Alksndr55/mesh-repeater-2.0/v2/design/MeshRepeater2_Shield/README_RU.md

# Mesh Repeater v2.08 — средний экран

Локальная редакция от 30.10.2026; выпуск v2.08 ещё не опубликован на GitHub.

Текущее исполнение описано в [механике](../../docs/MECHANICS_RU.md) и [инструкции сборки](../../docs/ASSEMBLY_RU.md).

Проект KiCad: `MeshRepeater2_Shield.kicad_pro`; плата:
`MeshRepeater2_Shield.kicad_pcb`. Размер 90 × 60 мм. Экран устанавливается
медью к нижней плате POWER; верхняя плата LOGIC находится компонентами вниз.
Стойки и четыре крепления M3 сохранены.

На обеих сторонах находится краткая русская памятка: состав узла,
характеристики, распиновки, варианты комплектации и предупреждение J11.
Обратная памятка ориентирована для чтения сверху после сборочного
переворота X180. Читаемый вид собранного экрана:
`../../output/current/SHIELD/SHIELD_front.svg`.

## Проход разъёма

В A3 двенадцать отдельных отверстий заменены одним физическим
фрезерованным окном **17,2 × 6,8 мм, углы R0,6**. Через него при сборке
проходит общая пластиковая планка длинного штекера J101. Окно выполнено
линиями и дугами `Edge.Cuts` в локальной механической посадке HS1
`Shield_Interconnect_Window17p2x6p8_R0p6`; HS1 не является закупаемой деталью.

Координаты окна SHIELD: X 61,90…79,10; Y 46,87…53,67 мм.
Физический центр после X180: X 70,50; Y 9,73 мм.
Положение J101/J201 и высоты стоек не меняются. Номинальные штыри L35
и розетка H8,5 дают вхождение 4,48 мм при расстоянии рабочих поверхностей
POWER–LOGIC 36,02 мм. В собранном узле верхний пластик находится на
3,48 мм выше экрана; расширенное окно требуется для надевания экрана
через этот пластик.

Универсальный штекер не имеет документированного максимального габарита
пластика и полного допуска сопряжения. Окно рассчитано с запасом относительно
имеющейся модели 15,64 × 5 мм. До изготовления проверить выбранный образец:
пластик должен проходить свободно при штатном совмещении плат.

## Медь и крепления

Изготовление одностороннее: **только F.Cu**. В файле KiCad сохранён
минимальный двухслойный контейнер; B.Cu не содержит изготавливаемой меди.
Физический стек: маска 0,010 мм, медь 0,035 мм, FR4 1,475 мм;
общая номинальная толщина 1,52 мм. STEP содержит сердцевину и фольгу
толщиной 1,51 мм; маска не представлена отдельным твёрдым телом.

Фольга GND остаётся одной связной областью. Отступ от окна не менее
0,50 мм; от наружного края и стенок крепёжных отверстий — 0,30 мм.
Четыре NPTH Ø3,20 мм имеют открытые контактные области маски Ø6 мм
для металлических шайб. Центры: (3,5;3,5), (86,5;3,5), (3,5;56,5),
(86,5;56,5) мм. Скрытый GF1 — технический якорь присвоения GND,
не электронный компонент. Межплатные контакты не касаются фольги.

## Межплатная распиновка

| Контакты J101/J201 | Назначение |
|---|---|
| 1, 3 | SYS_3V3 — Nice!Nano и периферия |
| 5, 7 | RADIO_3V3 — модем |
| 2, 4, 6 | GND |
| 8 | NC |
| 9 | BAT — линия измерения батареи |
| 10 | SDA |
| 11 | MODE |
| 12 | SCL |

Для Na-ion 1S используется J8; блок COLD — опция. Для LTO 2S используется
J12 и устанавливаются BAL1/BAL2. J8 и J12 одновременно не подключать.
**До подключения USB снять перемычку J11 на POWER; вернуть только после
отключения USB.**

## Проверки и экспорт

Свежая проверка: `../../audit/current/SHIELD/drc.json`.
Виды: `../../output/current/SHIELD/SHIELD_front.svg` и `SHIELD_back.svg`.
Экран проверяется без сопоставления с электросхемой, поскольку электронных
компонентов у него нет. Процесс выпуска описан в корневом `docs/WORKFLOW_RU.md`.
Схема и платы остаются нативными исходниками; исторические генераторы не используются.
