Alksndr55/mesh-repeater-2.0/v2/docs/MECHANICS_RU.md

# Механика v2.08

Локальная редакция от 30.10.2026.

POWER/LOGIC/SHIELD: 90×60 мм; толщина в CAD 1,52 мм. SHIELD имеет только
медь F.Cu к POWER, B.Cu пустой. Двухслойный контейнер KiCad не означает
второй изготавливаемый слой экрана.

J101 — E-SIMPO L35mm A3C6 2×6P; J201 — MTJ H8.5 2×6P, шаг 2,54 мм.
Штырь 35 мм, хвост пайки 3 мм, кончик над POWER 32 мм. Между рабочими
поверхностями номинально 36,02 мм, ввод в розетку 4,48 мм. Проверить купленную пару.

Стойки 18/15 мм с металлическими шайбами. Внутренние промежутки 18,5/16,0 мм.
Окно SHIELD под пластиковую планку 17,2×6,8 мм, радиусы 0,6 мм.
Отверстия и контактные кольца GND заданы текущим CAD.

EEEFK1E471P: номинальная высота 10,2 мм; с допуском и местом над клапаном
требуется 12,8 мм от PCB. До SHIELD предусмотрено 18,5 мм, запас 5,7 мм.
Актуальные модели компонентов доступны в KiCad. Прежние сборочные экспорты A3/A4
не являются геометрией текущего фильтра.
