Alksndr55/mesh-repeater-2.0/audit/V2_ENGINEERING_AUDIT_A3_2026_10_13/MECHANICAL_RF_REPORT_RU.md

# Независимая механическая и RF-проверка V2.0-A3

Проверено 13 октября 2026, только текущий `v2`. Это приложение к основному аудиту; ID M/R ниже предварительные и предназначены для включения в общий реестр. Исходные CAD, библиотеки, правила, BOM и производственные файлы не изменялись.

Наиболее существенный пробел — выбранная универсальная пара J101/J201 ещё не имеет подтверждённого окна сопряжения, гарантированных максимальных габаритов пластика и полного расчёта допусков. Номинальная сборка соответствует геометрии A3, но этим нельзя разрешить изготовление комплектов без проверки приобретаемой пары. Также остаются реальные глубины резьбы и габариты NiceNano/USB, RF-параметры и действие экрана на BLE. Подтверждённых ошибок зеркальности, номинальных межплатных столкновений или разрывов земли в проверенном участке не обнаружено.

## Объект и независимые проверки

Путь: `C:/Users/Alksndr/Desktop/codex/Meshcore/v2`, `main`, HEAD `d1206d1cf134ac7ee1fb50b80c9488904241908c` с локальными изменениями A3, включёнными в общий снимок `source_state_before.json`. Прочитаны `AGENTS.md`, исходное ТЗ, актуальные A3-инструкция/ограничения, mechanical/vertical selection, реальные PCB/footprints/3D, BOM. Позднее согласованное требование родительского задания: один J11 на POWER; SYS/RADIO через NT2, 2+2 питающих и 3 GND контакта; pin8 NC; все компоненты POWER на F; окно SHIELD 17,2×6,8/R0,6; J10 обслуживается после разборки. Старые IDC/12 отдельных отверстий не применялись к A3.

| Текущая PCB | SHA-256 |
|---|---|
| POWER | `be0c865aff7f217989bab9ab264dd0a0c2cda1ecd81906dd05bbb1ab731a2f44` |
| LOGIC | `ea936c8edc2d1d19b65868ca1c8f1fd98aeee777667ff6ef7b1d5d688f4b944b` |
| SHIELD | `fd02b80ebdb509977bdfcd35df0430205db56f994914720b82cdbae6d73e3bec` |

Выполнено заново, без refill/SaveBoard: `MECHANICAL_RF_native.py` и `MECHANICAL_RF_checks.py`, Python KiCad 10.0.6 `C:/Program Files/KiCad/10.0/bin/python.exe -B`, с `configure_headless()` до pcbnew; `via.GetWidth(F_Cu)` задан явно. Прочитаны сохранённые наполнения, площадки, дорожки и переходы. Получено POWER 123 footprints/1367 tracks+vias; LOGIC 56/1135; SHIELD 6/0. Исходные хеши после native чтения те же.

Независимый FreeCAD BRep `MECHANICAL_RF_brep.py` прочитал текущие сжатые STEP, вычислил преобразования POWER F вверх, LOGIC/SHIELD X180 и временно распаковал только внутри текущей папки аудита, удалив временные STEP. Объём пересечений POWER–SHIELD/SHIELD–LOGIC/POWER–LOGIC: **0/0/0 мм³**; рассмотрено 24/0/12 потенциально пересекающихся пар тел. Число тел 832/2/947. Это новая проверка сохранённой номинальной геометрии, не использование старого PASS как заключения.

## M01 — высокая; непроверенный вопрос: гарантированное сопряжение J101/J201 и допуски окна

**Где:** POWER J101 (64,15;11,00), 90°; LOGIC J201 (64,15;49,00), 90°; SHIELD окно X61,90…79,10/Y46,87…53,67. Точный выбор: E-SIMPO L35mm A3C6/2x6P, товар `1005011978353933`, SKU `12000057202232448`; MTJ/JinSheng H8.5/2X6P, товар `1005008954873458`, SKU `12000047353417475`.

**Факт:** документации изготовителя этой точной пары с допустимым сечением ответного штыря, минимальным/максимальным вводом, допусками высоты и прямолинейности нет. Сохранённый проект прямо имеет `SAMPLE_MATING_UNQUALIFIED`. Модель вилки использует условные 0,64×0,64 мм и 15,64×5,00 мм пластика, а максимальный размер верхней пластиковой планки выбранной вилки не нормирован. Карточки продавцов подтверждают идентификацию, но не квалифицируют сопряжение двух брендов.

**Расчёт номинала:** рабочий промежуток G = 18+15+1,52+3×0,50 = 36,02 мм; конец штыря L−PC = 35−3 = 32 мм; вход розетки G−Hf = 36,02−8,50 = 27,52 мм; ввод D = L−PC−G+Hf = **4,48 мм**. До верхней планки розетки 1,52 мм; от дальней поверхности SHIELD до верхней планки 3,48 мм. Номинальный проход 17,2−15,64 = 1,56 мм и 6,8−5,0 = 1,80 мм, то есть 0,78/0,90 мм с каждой стороны. Это только номинал. Даже ±0,30 мм длины корпуса розетки оставляет 0,63 мм на сторону при идеальном совмещении; этот допуск нельзя переносить на неизвестный корпус вилки.

**Границы расчёта:** для независимых допусков худшее отклонение ввода `TD = TL + TPC + T18 + T15 + Tshield + 3×Twasher + THf`. Их чисел для всего приобретённого комплекта нет. Требуемое отверстие для квадратного штыря должно учитывать его диагональ и позиционные допуски: `d_finished_min ≥ sqrt(ax_max²+ay_max²) + allowance`. Если условно a=0,64 мм, диагональ 0,905 мм против native drill 1,02 мм; 0,115 мм диаметрального запаса — не гарантированная посадка при неизвестных допусках.

**Условия/последствия:** неполный контакт при полном затягивании плат, изгиб длинных штырей, невозможность надеть экран через пластик, касание фольги, нестабильное питание. Тяжесть потенциально высокая, но наличие этих отказов в образце не установлено. Два силовых контакта не дают права считать ток автоматически разделённым пополам; каждый контакт проверяется на полный ток соответствующей ветви и на случай неравного сопротивления.

**Доказательства:** native JSON; `docs/vertical_interconnect_selection.json` (male/female/decision/limits), `docs/mechanical_selection.json` (точные SKU и sample qualification), текущие STEP `MECHANICAL_RF_brep.json`. Идентификация продавцов: [вилка](https://aliexpress.ru/item/1005011978353933.html?sku_id=12000057202232448), [розетка](https://aliexpress.ru/item/1005008954873458.html?sku_id=12000047353417475). Размеры карточки не приняты за паспорт изготовителя.

**Минимальное предложение без изменения:** до выпуска заказа проверить приобретённую пару в размерном макете/купонном окне, зафиксировать измеренные предельные размеры и окно гарантированного контакта; затем подтвердить либо скорректировать только длину/высоту, drill и окно. Если изготовитель не гарантирует совместимость, признать квалификацию относящейся к конкретной проверенной партии.

**Приёмка:** экран надевается и снимается через верхнюю планку без усилия и контакта с медью; LOGIC садится на крепёж без притягивания несовпавших контактов винтами; измеренный ввод во всех углах допусков внутри окна изготовителя либо установленного испытанием партии. До подачи питания — все 12 контактов 1:1, pin8 не соединён с GND/соседними цепями; затем испытать SYS и RADIO при полном токе каждой ветви с максимальным переходным током, измерить падение на каждой паре контактов и сопротивление GND после повторных циклов разборки. Численную норму контакта и число циклов должен дать паспорт/протокол квалификации; 3 А и ≤20 мОм из карточки розетки не являются подтверждённой нормой всей пары.

## M02 — средняя; непроверенный вопрос: реальное резьбовое зацепление

**Где:** четыре RUICHI PCHSN-18; четыре Connfly H-L1500-2100-5-03-1N1W; пять DIN433 шайб 0,5 мм на угол; верхние M3×6 и нижние DIN934 M3. Nominal stack в `docs/mechanical_selection.json:871…910`.

Номинальный ввод верхней шпильки и верхнего винта: `6−1,52−2×0,50 = 3,48 мм`; доступная нижней гайке резьба: `5−1,52−0,50 = 2,98 мм`. Принятый проектом критерий верхних соединений ≥3,0 мм имеет запас всего 0,48 мм. У верхней шпильки указан допуск 6±0,2 мм; после него остаётся **0,28 мм** на суммарное увеличение толщины PCB/двух шайб и потерю длины полных витков. Полезная глубина верхней внутренней резьбы не задана; длина нижней шпильки/глубина нижней резьбы приближённые. Полный worst-case вычислить нельзя. Номинального доказанного упора/срыва нет.

Результат возможного отклонения — недожатая плата/экран, недостаточное зацепление, потеря экранного контакта. Не доказано повреждение или невозможность сборки; это пробел допуска/входного контроля. Первичный чертёж семейства: сохранённые `docs/mechanical_sources/188548.pdf` и `110251.pdf`; зеркала [Connfly](https://www.danomsk.ru/upload/iblock/1b1/188548_e44317379783c17effab280d052a68cb.pdf), [RUICHI](https://www.danomsk.ru/upload/iblock/a02/110251_1e32ecf705accb191cd05713b8059f9d.pdf). Карточка ДАН использована только для точного артикула, не доказательства недостающей глубины.

Минимальное предложение — измерить полезные глубины до последнего полного витка, длины шпилек/винтов, фактические PCB/шайбы и зафиксировать расчёт зажима. Изменение длины крепежа требуется только если расчёт не проходит. Приёмка: ≥3,0 мм полного зацепления верхних соединений, полное зацепление нижней гайки, отсутствие упора до зажима; после заданного для выбранного крепежа момента платы и шайбы прижаты без прогиба. Значение момента пока не документировано.

## R01 — средняя; обоснованный риск: RF/BLE и экранирование не квалифицированы

**Где:** LOGIC M2 (48;18), M2.1 ANT (40;11), FL1/NT1 (40,7;4,25), J13 (34,5;4,25); M1 NiceNano и BLE keepout X12…24/Y30,5…45,5; сплошной SHIELD на 16 мм от рабочей поверхности LOGIC.

Свежий copper union показал один физически связанный GND компонент на каждой плате. На основных RF-отрезках шириной 1,3/0,8 мм расстояние до F.Cu GND в середине **0,250499 мм**, противоположная B.Cu GND есть под всеми серединами. На ANT_RF цифрового разреза противоположной земли при шаге 0,05 мм не обнаружено; у собственного SMA сигнального THT-launch есть около 1,25 мм, где осевая точка занимает сигнальную площадку/её clearance. Это не подтверждённый разрыв возврата: вокруг launch есть GND и четыре платированных SMA анкера. C24.1 в (37,6;15) находится в 2,4 мм от M2.3 (40;15), C24.2 и M2.2 связаны с общей землёй; FB1/C23/C24 обслуживают локальную RADIO ветвь.

Такая топология не доказывает ровно 50 Ом: изменяются ширина, площадки и NT1/FL1 launch, не квалифицированы диэлектрическая проницаемость, технологические допуски и RF-модель трассы. Официальная reference design Heltec и Abracon matching circuit используют 50-омные источник/нагрузку; это основание проверить согласование, но не объявить ошибкой произвольную ширину. В проекте M2 `band variant TBD`; для 868/869 МГц нужна именно HF, LF нельзя считать взаимозаменяемой. Документированы модульные R1/ANT и R2/IPEX; их фактическая комплектация входным контролем не подтверждена.

Средний экран без вертикальных стенок — открытая пластина, не закрытый кожух. Нижняя зарядная импульсная цепь имеет длинный switching путь D1/D2→L1 (13,76 мм медных сегментов net D1-K); U2→L2 короче, LX1/LX2 по 2,18 мм, включая по 1,066 мм шириной 0,20 мм. Это фактическая геометрия, не расчёт перегрева и не доказанный EMI-отказ. TI TPS63802 §12.1 p28 требует коротких широких цепей конденсаторов и размещения FB вдали от LX; местная разводка имеет соседние C12/C14 и непрерывную B.GND. Сплошная медь экрана под BLE-антенной конкретного клона может изменить согласование/диаграмму, хотя CAD-keepout LOGIC пуст. На образце ни помехи, ни чувствительность, ни нагрев не измерялись.

Источники: `MECHANICAL_RF_checks.json`, `MECHANICAL_RF_native.json` и построенные из них `MECHANICAL_RF_Logic_copper.png`, `MECHANICAL_RF_Power_copper.png`; [Heltec HT-RA62 Rev1.1 p4–9](https://resource.heltec.cn/download/HT-RA62/HT-RA62%28Rev1.1%29.pdf), [официальная reference design p1](https://resource.heltec.cn/download/HT-RA62/HT-RA62_Reference_design.pdf), [внутренняя схема модуля p1](https://resource.heltec.cn/download/HT-RA62/HT-RA62_Schematic_diagram.pdf), [TI TPS63802 RevD §12 p28](https://www.ti.com/lit/ds/symlink/tps63802.pdf). Не использованы правила другой RF-платы как обязательные требования этого модуля.

Минимальное предложение — выбрать/записать точную HF-ревизию M2 и фактический M1; получить stackup выбранного изготовителя и проверить RF-модель/купон. Корректировать RF или экран только по установленному отклонению. Приёмка на первом образце: 50-омная нагрузка на SMA, измеренная мощность и спектр на всех назначенных каналах; приёмная чувствительность при одинаковой LoRa BW/SF/PER с TPS в PFM/PWM, зарядкой off/max, экраном fitted/removed; BLE RSSI/PER на фиксированной дистанции/ориентациях. Паспорт Heltec p7 задаёт чувствительность -139/-130/-124 dBm для BW125/SF12/10/7, но условий PER там недостаточно для строгой производственной нормы — сначала определить протокол и допустимый бюджет ухудшения. Проектного численного критерия EMI/BLE/return loss нет, произвольный порог PASS не назначен.

## R02 — средняя только для устанавливаемой опции; непроверенный вопрос/подтверждённые паспортные ограничения FL1

FL1 штатно DNP и NT1 замкнут: базовая сборка не нарушает ограничения неустановленного фильтра. При fitting S869M000S003 официальный Abracon RevA printed p2 (PDF page1) ограничивает Source Power 13 dBm и рабочую температуру **−10…+65°C**, характеристику IL задаёт в 868…870 МГц. Документация проекта предупреждает о 13 dBm, но полный температурный предел опции не приведён. Хранение −40…+85°C не является рабочим диапазоном. HT-RA62 способен дать до22 dBm, поэтому мощность должна ограничиваться до fitting, а фактическая конфигурация и холодная эксплуатация этой опции должны быть отдельно утверждены.

Printed p3 (PDF page2) имеет противоречивый чертёж рекомендованных lands: у верхнего ряда указано 0,4 мм, у среднего 0,8 мм, общая высота 3,2 мм и пропорции не согласуются с верхней цифрой. Локальный footprint прямо документирует выбор 0,8 мм. Нельзя выдавать этот инженерный выбор за однозначный паспортный land pattern; нумерация 2=input,5=output,1/3/4/6=GND и корпус3×3×1,3 совпадают. Actual local STEP имеет те же внешние размеры.

Источник [Abracon S869M000S003 RevA printed p2–3](https://abracon.com/datasheets/AEL-Crystals/PN/S869M000S003.pdf), сохранённый PDF и размерная PNG; local SAW footprint descr и native FL1. Минимальное предложение — записать ограничения частоты/температуры/мощности именно опции, согласовать неоднозначный land pattern с изготовителем либо квалифицировать партию/монтаж. Приёмка: после резки NT1 сопротивление ANT_RF–ANT_SMA при снятом FL1 показывает разрыв; после монтажа VNA в50Ω измеряет IL≤2,5 dB/амплитудную неравномерность≤1 dB в868…870MHz при допустимой температуре и мощности; пайка всех шести lands осмотрена. Это не тест всей антенны или устройства на морозе.

## Что фактически прошло и что осталось ограничением

| Область | Проверено / метод | Результат | Ограничение |
|---|---|---|---|
| Размеры и этажи | Реальные PCB edges, толщины, текущие STEP BRep | Три платы 90×60 мм; native толщина 1,52 мм; POWER все F; LOGIC все F, затем X180; номинальных столкновений нет | Производственный допуск PCB, фактическая высота модулей |
| J101↔J201 | Все 12 native pads после physical Y=60−nativeY | Координаты и сети совпадают 1:1; 1/3 SYS, 5/7 RADIO, 2/4/6 GND, 8 NC, 9 BAT, 10 SDA, 11 MODE, 12 SCL | Реальное сопряжение M01 |
| Монтаж M3 | Центры PCB, окно Edge.Cuts, маска и GND | Четыре центра X3,5/86,5 и Y3,5/56,5; drill 3,2; плоскости совпадают после поворота | Резьбовая цепочка M02; реальная затяжка/момент |
| Экран | Saved copper union / native stackup / STEP | F.Cu один связный GND полигон; B.Cu пусто; STEP core 1,475 + foil 0,035; окно 17,2×6,8/R0,6 вместо 12 drill; буквы не вырезают медь | Сопротивление контакта/EMI не измерены; маска 0,01 не включена в STEP |
| Земля без проводимости стоек | F/B copper union; связь через платированные pads/vias | На каждой плате одна физическая GND группа; J101/J201 2/4/6 и потребители в ней; металлических стоек в модели связности нет | Реальное сопротивление межплатных контактов неизвестно |
| Производитель SMA | KLS exact drawing V0 2025-07-28 p1 ↔ native ↔ fresh STEP | Квадрат анкеров 5,08 мм, 4×drill 1,70, RF drill 1,30 совпадают; STEP над PCB 9,5 + хвост 3,5 = 13,0 мм; горизонтальная длина 14,46 соответствует чертежу | Представительный корпус и антенный SMA plug не доказывают фактическую посадку |
| HT-RA62 land/model | Heltec Rev1.1, visual p9 / native / STEP | Корпус 16×17 мм, сетка 2 мм; 16 площадок и назначения верны; высота модели 2,7 мм | Таблица p6 противоречиво пишет 1,27 spacing; 0,8 мм — толщина PCB, не высота собранного модуля; ревизия/частота TBD |
| Кнопки | TE mechanical selection и native; fresh STEP | Шаг контактов 4,50 мм, креплений 7,01 мм; STEP полная скоба 8,41 мм; прежняя укороченная модель 7,66 мм исправлена | Физическое нажатие и USB кабель не проверены |
| NTC | Native TH1 и fresh formed STEP | Формованная модель 12,5 мм против промежутка 18,5 мм: номинальный запас 6,0 мм | Гибка/реальный образец; местная температура POWER отличается от температуры ячейки |
| USB/кнопки/GPS/I²C/UART/SMA/J11 | Native координаты/направления и текущий STEP | J11 POWER (86;23) вправо; SW (29;58,2)/(41;58,2) на общий край; J3 X86 вправо, J5 X2,5 влево; GPS/SMA к краю | Реальный NiceNano, Type-C plug и оболочки доступа отсутствуют; снятие шунта не квалифицировано |
| J10 ISP / CR2032 | Native J10 и инструкция с разборкой; BT1 native/MPN | J10 сохранён (35,7;31,3), 0°; снятие R37 для ISP предусмотрено; BT1 Keystone 1060 SMT, шаг площадок 29,3 мм; батарею заменяют после открытия этажей | Пайка/программатор/извлечение ячейки не выполнялись |
| D3/D4 | Native POWER и боковая геометрия | Обычные 0805 на общем крае (67;2,4)/(73;2,4), цепи POWER; header дальше от края | Световая диаграмма и яркость сбоку после сборки не измерены |
| Кабельные ответные части | Текущий BOM | J3/J5 имеют Connfly SCB01x4 + 8 SC600 контактов; J11 shunt, J7/J8 XHP2, J12 KLS 4 pole + 3 contacts и крепёж перечислены | Старое замечание об отсутствии J3/J5 mates к текущей A3 неприменимо; сопряжение разных брендов не квалифицировалось |

По держателю CR2032 первичный [Keystone catalog M55 p3](https://www.keyelco.com/pdfs/M55-prod03.pdf) задаёт SMT 1060 и рекомендуемый шаг площадок 29,3 мм; native 29,30 совпадает. Быстрая смена без разборки не требуется актуальным порядком обслуживания. Геометрия контакта экрана допускает металлическую шайбу OD6; это проектный путь заземления экрана через крепёж, тогда как рабочий возврат питания существует по отдельным трём GND контактам. При испытании с электрически изолированными стойками требуется отдельно подключить экран к GND для сравнения EMI; основной возврат должен оставаться работоспособен независимо от этого.

## Приоритет и готовность данного участка

1. До заказа комплекта плат: M01 — образцы точной пары, окно и допуски сопряжения; уточнить изготовление PCB, сверловку и окно. Связность/номинальная геометрия уже проверены и не требуют повторения без изменений.
2. До сборки: M02; реальная высота M1/M2 и полные USB/SMA/cable/shunt оболочки; контакт экрана и видимость LED. Подбор другой детали без установленной причины не предлагается.
3. До оценки устойчивой работы: R01 — точный HF модем и путь ANT, RF/BLE/помехи/тепловое испытание в крайних рабочих режимах. R02 обязателен только если устанавливают FL1.

**К изготовлению:** топология и номинальная геометрия данного участка согласованы; полный производственный выпуск нельзя подтвердить из-за M01 и отсутствующего гарантированного tolerance stack. Для ограниченного опытного изготовления решение принимает владелец после квалификации пары/купонного прохода и согласования правил выбранного производства.

**К сборке:** номинальная последовательность осуществима: POWER → нижние стойки → экран через окно → верхние стойки → перевёрнутая LOGIC на J201 → винты; разборка обратная. Реальную сборку не подтверждаю до закрытия M01/M02 и проверки реального модуля с кабелями.

**К первому включению:** механика и полная GND связность не выявили самостоятельного доказанного препятствия в CAD; подтверждать безопасное первое включение всей электроники этим приложением нельзя. До подачи питания требуются прозвонка купленных разъёмов, отсутствие контакта с фольгой, правильный аккумуляторный вариант/J11 и разрешение электрических замечаний основного аудита. RF/EMI/BLE/нагрев не выдаются за выполненные измерения.

Фактические результаты находятся в flat attachments `MECHANICAL_RF_native.json`, `MECHANICAL_RF_checks.json`, `MECHANICAL_RF_brep.json`, source PDF/PNG/hash manifest. Основные исходные PCB после чтения сохранили хеши; общую проверку исходников/индекса выполняет основной аудитор.
