Alksndr55/mesh-repeater-2.0/v2/THIRD_PARTY_NOTICES.md

# Mesh Repeater 2.0 — уведомления о происхождении материалов

Обновлено 22.10.2026. Исторические описания Mesh Repeater ver 1.0 и S4.16
ниже сохранены как сведения о происхождении унаследованных материалов.

Собственные оригинальные материалы Mesh Repeater и принадлежащие автору
оригинальные дополнения распространяются под CC BY-NC-SA 4.0 в пределах
прав Alksndr55 / @Alksndritm. Область лицензии и дополнительное разрешение
на заказ изготовления плат для личных некоммерческих нужд приведены в
`LICENSE.md` и `docs/LICENSING_RU_EN.md`; полный текст CC находится в
`LICENSES/CC-BY-NC-SA-4.0.txt`. Коммерческое использование собственных
материалов требует отдельного письменного разрешения правообладателя.

Эти условия не заменяют сторонние лицензии, не ограничивают права,
предоставленные сторонними правообладателями, и не отзывают ранее выданные
разрешения. В частности, коллекция библиотек KiCad и её производные
сохраняют CC-BY-SA-4.0 с исключением KiCad. Указанные ниже условия относятся
к соответствующим сторонним материалам и их производным.

FakeTec V6
В качестве исходного примера и основы совместимости использован FakeTec V6
Rev C. Автор V6 — shimonomihs (ShimonHoranek); исходный проект FakeTec связан
с gargomoma и участниками проекта. Автор V6 прямо указывает CERN-OHL-P-2.0
для своих исходных файлов в описании issue #26:
https://github.com/gargomoma/fakeTec_pcb/issues/26
Общий проект: https://github.com/gargomoma/fakeTec_pcb

Заимствованные материалы V6 сохраняют уведомление CERN-OHL-P-2.0.
Изменено в Mesh Repeater, 11.10.2026: самостоятельная двухслойная плата
90 x 100 мм, зарядник CN3722, TPS63802, двухкаскадный LC-фильтр,
RTC/CR2032, внешний watchdog ATtiny13A, GPS-интерфейс, опциональный
балансир LTO, SMA с опциональным SAW, узел снижения тока COLD и новые
трассировка, размещение и маркировка. GPIO и интерфейс
FakeTec / ProMicro сохранены. Эта работа не является официальным релизом
FakeTec; упоминание авторов не означает их участия или одобрения.

В пакет включён полный неизменённый текст:
LICENSES/CERN-OHL-P-2.0.txt
Первичный текст лицензии, ссылка с официальной страницы OHWR:
https://gitlab.com/ohwr/project/cernohl/-/wikis/uploads/3eff4154d05e7a0459f3ddbf0674cae4/cern_ohl_p_v2.txt
Страница лицензий: https://ohwr.org/licences/
Сохранить имеющиеся авторские уведомления и описание изменений.
Отказ от гарантий и ответственность определены полным текстом лицензии.

Библиотеки KiCad
Часть локальной библиотеки Meshcore.pretty скопирована или адаптирована из
официальных библиотек KiCad. Авторы — участники проекта KiCad Libraries.
Эти библиотечные материалы распространяются под CC-BY-SA-4.0 с исключением
KiCad для электронных проектов и полученных из них файлов. Исключение не
отменяет условия при распространении библиотеки или её частей как коллекции.
Исторический список конкретных файлов и изменений относится к S4.16,
а не к текущим хешам версии 2.0. Он сохранён в теге v2.0-a3:
https://github.com/Alksndr55/mesh-repeater-2.0/blob/v2.0-a3/archive/v1_S4_16/design/Meshcore_NaIon/asset_manifest.json
Старого пути `design/Meshcore_NaIon/asset_manifest.json` в текущем срезе нет.
Текущие используемые локальные библиотеки размещены в
`design/MeshRepeater2_Power/Meshcore.pretty/` и
`design/MeshRepeater2_Logic/Meshcore.pretty/`; связанные модели — в соседних
каталогах `3dmodels/`. Связь конкретной платы с посадочным местом и моделью
определяется её сохранённым `.kicad_pcb` и `fp-lib-table`, а не старым manifest.

FB1_BLM21_0805.step — копия стандартной модели KiCad
Inductor_SMD.3dshapes/L_0805_2012Metric.step, переименованная для FB1.
Это типовой корпус 0805, а не точная заводская модель Murata BLM21PG.
TI_DCT0008A.kicad_mod создан адаптацией стандартного SOT-23-8 KiCad:
изменены медные площадки и контуры по чертежу TI DCT0008A.
CP_Elec_Panasonic_FK_D_6.3x5.8.kicad_mod — адаптация стандартного
CP_Elec_6.3x5.8 KiCad с изменёнными размерами и положением площадок.
В стандартных локальных footprints могут быть изменены ссылки на 3D-модели
и отображение полей; они не объявляются оригинальными работами Mesh Repeater.

В пакет включены:
LICENSES/CC-BY-SA-4.0.txt — полный неизменённый текст CC;
LICENSES/KiCad-Libraries-LICENSE.md — исходное уведомление KiCad вместе
с полным текстом исключения; сохранить ссылки и авторство в manifest.
Первичные источники:
https://creativecommons.org/licenses/by-sa/4.0/legalcode.txt
https://raw.githubusercontent.com/KiCad/kicad-footprints/master/LICENSE.md
https://www.kicad.org/libraries/license/
https://github.com/KiCad/kicad-footprints
https://gitlab.com/kicad/libraries/kicad-packages3D
Остальные стандартные 3D-модели, на которые ссылается проект через
KICAD10_3DMODEL_DIR, берутся из установленной библиотеки KiCad 10.

Модели, созданные для проекта — унаследованный перечень S4.16
16 из 17 используемых локальных STEP созданы для этого проекта как
упрощённая геометрия по чертежам деталей и инженерным допущениям.
Они не являются скачанными STEP производителей. Источники геометрии,
хеши и ограничения указаны отдельно для каждого файла в manifest.
Модели Nice!Nano-клона и HT-RA62 приблизительные; мелкие детали и высоты
не заменяют проверку реальных модулей. Рама и крышка экрана — проектная
геометрия, не подтверждённая модель доступного изделия поставщика.
Модель CR2032 — типовой габарит. Чертежи производителей использовались
как источники размеров; их PDF и изображения не включаются в публикацию.
Названия и марки деталей принадлежат соответствующим правообладателям.

Добавления S4.13–S4.16
SMA_KLS1_SMA002_B_Horizontal.kicad_mod и SMA_KLS1_SMA002_B_Approx.step
созданы для проекта по официальному чертежу KLS L-KLS1-SMA002-B V0,
28.07.2025. Размеры площадок и технологические допуски — решения проекта:
https://img.klsele.com/admin/product_upload/20250828165703L-KLS1-SMA002-B%26KLS1-SMA002-B-1.27.pdf
SAW_AEL_DCC6C_S869M000S003.kicad_mod и S869M000S003_Approx.step
созданы по чертежу Abracon/AEL S869M000S003, DCC6C. Разрешение неоднозначного
размера посадочного рисунка отмечено в описании footprint:
https://abracon.com/datasheets/AEL-Crystals/PN/S869M000S003.pdf
NTC_TDK_B57861S_Onboard_or_Remote_P2.54mm.kicad_mod и
TDK_B57861S_Vertical_Approx.step — проектная посадка и упрощённый габарит
TDK B57861S; шаг формованных выводов является выбором сборки:
https://www.tdk-electronics.tdk.com/inf/50/db/ntc/NTC_Mini_sensors_S861.pdf
RF_Cut_Link_0p6.kicad_mod — проектная медная перемычка, не покупной компонент.
TO-92_Inline.kicad_mod происходит из библиотеки KiCad; к нему применяются
те же условия KiCad Libraries и исключение, что к остальным её производным.
Стандартная модель TO-92 берётся из установленной коллекции KiCad 10.
Графика локального SOT-23-5 в S4.16 адаптирована для маркировки pin1;
контактные площадки и геометрия корпуса сохранены.

Эти сведения сохраняют исходные лицензии и авторство сторонних материалов.
Условия собственных оригинальных дополнений указаны в `LICENSE.md` и
`docs/LICENSING_RU_EN.md`; они не распространяют ограничение NC на материалы,
для которых действуют сторонние лицензии.
Сторонние PDF/изображения не включаются; ссылки указывают происхождение.
Исторические хеши находятся в manifest тега v2.0-a3, указанного выше;
они не выдаются за проверку текущих файлов. Для механических дополнений
версии 2.0 имеются отдельные записи `docs/mechanical_library_checks.json`
и `docs/mechanical_model_checks.json` с датами соответствующих проверок.

Эти уведомления не меняют схему, плату, прошивку или выбранные номиналы.
