Alksndr55/mesh-repeater-2.0/docs/V2_A5_RELEASE_RU.md

# Mesh Repeater 2.0 A5

22.10.2026 · Designed by @Alksndritm

Этот выпуск объединяет актуальные проекты POWER, LOGIC и SHIELD, правки
маркировки под Резонит, исправления трассировки и новую лицензию собственных
материалов. Электрическая схема, номиналы, GPIO, размещение компонентов и
механика сохранены. Обозначение FAB2 в полях исходных CAD — базовая ревизия;
состав A5 однозначно задают Git-тег и SHA256 в манифесте архива.

## Изменения трассировки

- Устранены 13 частичных перекрытий и 25 лишних земляных связей поверх заливки.
- Перенесён 21 мешавший переход GND, удалены два избыточных.
- POWER: 803→757 сегментов; LOGIC: 603→575.
- Дорожки без GND сокращены суммарно на 25,58 мм.
- Сохранены подвод питания через C33, Kelvin-подключения INA219, RF-участок
  и возвратная земля. Ширины дорожек не уменьшены.

Повторные native DRC трёх плат: 0 нарушений и 0 неразведённых цепей;
ERC POWER/LOGIC: 0; расхождения со схемой: 0. Исправления отдельно приняты
независимым проверяющим и проверены визуально по экспортам KiCad.

[Виды и сравнение](../output/V2_OVERVIEW_RU.html) ·
[протокол](../audit/routing_cleanup_2026_10_22/FINAL_AUDIT.json).

## Лицензия

Оригинальные материалы и собственные вклады автора, в пределах его прав, —
**CC BY-NC-SA 4.0**. Личный некоммерческий заказ изготовления и монтажа плат,
включая оплату услуги изготовителя, разрешён отдельным дополнительным
разрешением. Коммерческий выпуск и продажа требуют предварительного
письменного разрешения автора. Сторонние материалы сохраняют свои лицензии.

[Условия RU/EN](LICENSING_RU_EN.md) · [область лицензии](../LICENSE.md) ·
[уведомления о происхождении](../THIRD_PARTY_NOTICES.md).

## Состав архива

Только три актуальных проекта KiCad с необходимыми локальными библиотеками
и моделями, актуальные электрические схемы PDF, BOM, инструкции, проверки,
лицензии и манифест. Исторические CAD, промежуточные кандидаты, резервные
копии, RAR и прежние производственные ZIP исключены. Сборочные STEP с прежней
медью не выдаются за текущую трассировку; текущий 3D получают из проектов KiCad.

Производственный пакет A5 не переиздан. Перед заказом необходимо создать
новые Gerber/Excellon из текущих плат. Прежние локальные FAB2-пакеты относятся
к геометрии от 16.10.2026.

Релиз остаётся инженерным прототипом: стендовые EMI/RF, нагрев, устойчивость
LC, реальные межплатные разъёмы и доработка Nice!Nano требуют проверки образца.
Согласованные ограничения LTO и снятие J11 перед USB сохраняются;
см. [ограничения](V2_LIMITATIONS_RU.md).
