Alksndr55/mesh-repeater-2.0/docs/V2_A4_RELEASE_RU.md

# Mesh Repeater 2.0 — V2.0-A4

Выпуск от 14 октября 2026 года: текущий инженерный прототип в самостоятельном
репозитории `Alksndr55/mesh-repeater-2.0`, ветка `main`, тег `v2.0-a4`.
[Страница выпуска](https://github.com/Alksndr55/mesh-repeater-2.0/releases/tag/v2.0-a4)
и [архив проекта](https://github.com/Alksndr55/mesh-repeater-2.0/releases/download/v2.0-a4/Mesh-Repeater-2.0-A4-project.zip).
Предыдущие A2 и A3 сохранены как отдельные релизы.

## Изменения A4

- POWER и LOGIC приведены к общему стилю маркировки. Дубли удалены;
  подписи следуют ориентации корпусов, крупные детали подписаны под корпусами.
- Подписи разъёмов выровнены в одном стиле, распиновки сохранены.
  Надпись U2 TPS63802 на POWER размещена в одну строку.
- Двадцать конденсаторов фильтра на POWER подписаны двумя группами
  по 10×100 мкФ: C15, C34–C42 и C16, C43–C51. R56 использует обозначения
  N1R8 / L0R; исключение R56=0 Ом без COLD описано на плате и в инструкции.
- Контуры BAL1/BAL2/COLD на POWER и RF-опции на LOGIC усилены до 0,30 мм
  с обеих сторон. Положение опциональных узлов читается в масштабе 1:1.
- Обновлены изображения обеих сторон, обзор и инструкция по маркировке.

Электрическая схема, номиналы, GPIO, медь, защитная маска, посадочные места
и положения компонентов не менялись. SHIELD сохранён. Рамки опций являются
шелкографией; открытая медь и окно разрезания NT1 не изменялись.

## Состав архива

`Mesh-Repeater-2.0-A4-project.zip` содержит только текущие редактируемые проекты
POWER, LOGIC и SHIELD с локальными библиотеками и моделями, необходимые
исходники watchdog, актуальные документы, спецификации, схемы и виды плат.
Исторические исходники, прежние схемы и платы, резервные копии, старые
экспорты и временные рабочие каталоги исключены. История остаётся в Git
и отдельных релизах A2/A3.

Старые CAD исключены и из Git-среза A4: автоматические архивы GitHub
**Source code** содержат только актуальные схемы и платы. Локальные базы
сравнения сохранены; для воспроизведения исторических аудитов из нового
клона получите отдельную копию тега `v2.0-a3`.

В репозитории текущие PDF схем `MeshRepeater2_Power_A3_schematic.pdf` и
`MeshRepeater2_Logic_A3_schematic.pdf`, а также `V2_A3_COMPONENT_BOM.csv`
сохраняют свои имена: их электрическое содержание актуально для A4.
В ZIP эти же файлы представлены один раз с суффиксом A4; исходные пути
и хеши указаны в манифесте. Это переименование для архива,
электрические изменения не вносились.

Сборочные STEP и изображения сборки сохраняют геометрию A3, которая
не менялась в A4. Актуальную шелкографию A4 показывают новые SVG/PNG POWER
и LOGIC в обзоре плат.

После распаковки откройте `.kicad_pro` нужной платы. Используется KiCad 10.0.6
с обычными библиотеками KiCad; нестандартные зависимости включены.
`RELEASE_MANIFEST.json` фиксирует состав архива и SHA256 файлов,
отдельный файл `.sha256.txt` — контрольную сумму ZIP.

## Проверки текущих плат

Свежий native DRC от 14.10.2026 для POWER, LOGIC и SHIELD: 0 нарушений,
0 неразведённых цепей, 0 исключённых проверок. POWER и LOGIC также имеют
0 расхождений со схемой; для механического SHIELD эта проверка неприменима.
[Проверки выпуска A4](../audit/a4_2026_10_14/A4_RELEASE_CHECKS.json)
фиксируют сохранённые файлы и результаты повторного DRC всех трёх плат.
Сравнение с опубликованной A3 подтверждает сохранность всех структур
за пределами F.SilkS/B.SilkS. Текущие экспорты связаны с хешами плат.

Маркировка покрывает все 179 позиций: 103 индивидуальные подписи POWER,
20 конденсаторов в двух группах и 56 индивидуальных подписей LOGIC.
Дубли владельцев отсутствуют.

| Текущая плата | SHA256 |
|---|---|
| POWER | `9a93c96d54e5286c47f6bac69b689c5958cd51ad0548119f8fd24ae560e4ffc7` |
| LOGIC | `12e74df30e5508e47b3c43e9dec60c0b6ef69deecccf31e52be580582903b156` |
| SHIELD, без изменений | `fd02b80ebdb509977bdfcd35df0430205db56f994914720b82cdbae6d73e3bec` |

Доказательства: [POWER](../audit/a3_2026_10_13/marking_cleanup/POWER_marking_cleanup.json),
[LOGIC](../audit/a3_2026_10_13/marking_cleanup/LOGIC_marking_cleanup.json).
Полный [инженерный аудит A3 от 13.10.2026](https://github.com/Alksndr55/mesh-repeater-2.0/blob/v2.0-a3/docs/V2_ENGINEERING_AUDIT_A3_2026_10_13_RU.html)
и его прежние ERC, проверки схемного графа и механики относятся к своим
сохранённым снимкам. Их повторное выполнение для A4 не заявляется.

## Сборка и ограничения

Перед подключением USB снять J11 на POWER; вернуть после отключения USB.
Перемычка, две ветви SYS_3V3/RADIO_3V3, межплатная распиновка, питание
Nice!Nano-клона и его необходимая доработка сохраняются.
[Инструкция сборки](V2_ASSEMBLY_INSTRUCTIONS_RU.md) описывает маркировку N/L,
группы конденсаторов и выбор опциональных блоков.

Это инженерный прототип. Аппаратные проверки питания, LC, USB, разъёмов,
GPS и RF/EMI по прежним критериям остаются необходимыми. Сохранены принятые
ограничения LTO: резисторы балансира 2 Ом не гарантируют допустимый ток LMV431,
а при снятой батарее зарядник может вывести вход TPS63802 за рабочие 5,5 В.
[Остальные ограничения](V2_LIMITATIONS_RU.md) остаются в силе.
Производственный пакет ранее отложен владельцем; готовность к изготовлению
комплектов и эксплуатации этим выпуском не подтверждается.

Воспроизводимая упаковка: `tools/build_v2_a4_release.py --commit <SHA> --out <папка>`.
