Alksndr55/mesh-repeater-2.0/docs/cad_workflow_RU.md

# Mesh Repeater 2.0 — CAD-процесс A3

Рабочая редакция — V2.0-A3, KiCad 10.0.6. Изменения выполняют внутри самостоятельного репозитория `Meshcore/v2`. Версия 1.0 и опубликованный архив A2 сохраняют свою историю. Производственный пакет и публикация A3 в этой задаче не выполняются.

## Исходники и контракты

Редактируемые проекты находятся в `design/MeshRepeater2_Power`, `design/MeshRepeater2_Logic` и `design/MeshRepeater2_Shield`. Для каждого проекта сохраняют `.kicad_pro`, `.kicad_sch`, `.kicad_pcb`, `model.json`, локальные библиотеки и 3D-модели вместе. Точка входа — [обзор A3](../output/V2_OVERVIEW_RU.html).

Неизменная база S4.16 — `baseline/S4_16` и `audit/source_s4_16`. Её контракт: [v2_electrical_contract.json](../design/v2_electrical_contract.json), исходный опубликованный коммит `cf54f9970e716272d477afdb252b4e195d595cb6`. Добавление INA219 описано [feature_ina219_vertical.json](../design/feature_ina219_vertical.json); разрешённые изменения A3 — [feature_a3_single_face_split_power.json](../design/feature_a3_single_face_split_power.json). Эти записи дополняют базу и не заменяют её.

В A3 все 123 позиции POWER расположены на F.Cu. На LOGIC — 56 позиций; её целиком поворачивают на 180° вокруг X при сборке. J10/ISP сохраняет прежнюю посадку и доступ после разборки. J11 находится на POWER: одна съёмная перемычка, затем медная звезда NT2 и две отдельные ветви SYS_3V3/RADIO_3V3. **J11 снимают до подключения USB.**

Для R1/R40/R41/R55 выбраны 2512 Vishay WSL с площадками 1,65×3,68 мм и межцентровым расстоянием 5,71 мм по [рекомендации производителя, стр. 2](https://www.vishay.com/docs/30100/wsl.pdf). R56/R71 используют свои стандартные посадки 2512 Yageo. Package и MPN хранятся отдельными полями модели и не выводятся из имени графического варианта библиотеки.

## Изменение схем

Схемы A3 формирует `tools/cad/build_v2_a3_schematics.py`. Команды находятся в [инструкции проверок](NATIVE_BOARD_CHECK_RU.md). При работе одновременно с владельцем размещения используют `--preserve-model`: экспорт схем не должен перезаписывать координаты и углы деталей в `model.json`. После изменения состава/листов владелец модели объединяет актуальные `schematic_uuid` и `sheet_path`.

После генерации настоящий KiCad CLI обновляет синтаксис листов и библиотеки. Затем получают PDF, native XML и ERC окончательно сохранённых схем. Номера формата вручную не подменяют. Native XML/ERC A3 находятся в `audit/a3_2026_10_13/schematic/POWER` и `LOGIC`; PDF — в `output/pdf` с суффиксом `A3`.

Схемные графы сопоставляют и с текущими моделями, и с базой S4.16. Только в копии графа сравнения объединяют измерительный R71 и физическую медную звезду NT2; перенос J11 учитывают явно. В сохранённом CAD сети BAT/BAT_SYS и SYS/RADIO различаются. GPIO FakeTec, RTC/GPS/watchdog, специально неподключённые выводы и варианты монтажа проверяют отдельно.

## Изменение плат и маркировки

Перед правкой сохраняют исходный PCB и отчёт, затем назначают одного владельца каждого файла. Не запускают старые генераторы S4/A1/A2 поверх A3: они содержат прежние размеры, размещение, межплатные цепи и оформление. Одноразовые скрипты в каталоге аудита документируют выполненные шаги, а не заменяют текущую редактируемую плату.

В pcbnew предварительно вызывают `kicad_headless.configure_headless()`. Ширину via читают с явным слоем, например `PCB_VIA.GetWidth(pcbnew.F_Cu)`, чтобы избежать предупреждения wxWidgets KiCad 10. После изменения меди заново заполняют зоны и выполняют native DRC с парностью схемы.

Силовые пути и Kelvin-отводы проверяют по фактической меди. SYS и RADIO разделены трассировкой после NT2; FB1 и локальные C23/C24 остаются у модема на RADIO_LOCAL_3V3. Межплатная карта J101/J201 содержит два SYS, два RADIO, три GND, BAT/SDA/MODE/SCL и один NC. TP6/TP9/TP1 находятся в верхнем ряду с шагом 11 мм в свободных промежутках между разъёмами.

Подпись каждой детали ориентируют по её корпусу. На F.SilkS её ставят рядом, на B.SilkS — под собственным корпусом в тех же native XY, с зеркальным отображением обратной стороны. Шрифт номиналов/позиций — не менее 0,8 мм. Масштабированные группы Gxx удалены. Обводки BAL1/BAL2/COLD на POWER имеют одинаковые координаты на обеих сторонах. Разрывы линий обводок допускаются ради зазора до окна маски; это изменение шелкографии.

После оформления точный экземпляр каждой посадки сохраняют в местной библиотеке; текущий ID должен совпадать в PCB, модели и скрытом поле Footprint схемы. Нормализованная проверка сравнивает площадки, Fab, courtyard, silk и 3D-ссылки. `source_footprint_before_v2_graphic_variant` сохраняет выбранное физическое посадочное место. Расхождения не скрывают отключением правил или DRC-исключениями.

## Экран, экспорт и сборка

SHIELD имеет одну связную плоскость F.Cu, обращённую к POWER, четыре крепёжных отверстия и единое фрезерованное окно 17,2×6,8 мм, R0,6 для общей пластиковой планки J101. Двенадцати отдельных проходных отверстий для пинов нет. У окна предусмотрен отступ меди не менее 0,50 мм. Памятка на экране содержит состав, характеристики, распиновки, опции и предупреждение J11/USB.

Редактируемый KiCad-контейнер SHIELD двухслойный с пустым B.Cu; физически изготавливают только F.Cu. Подробности — в [README экрана](../design/MeshRepeater2_Shield/README_RU.md). Старый `build_v2_shield.py` относится к прежнему экрану и не воспроизводит геометрию A3.

`tools/cad/export_v2_board.py` экспортирует сохранённый PCB в native SVG, DRC и STEP; `render_native_svg_png.cjs` растеризует именно этот SVG. Пример из каталога v2:

```powershell
& 'C:/Program Files/KiCad/10.0/bin/python.exe' tools/cad/export_v2_board.py --pcb design/MeshRepeater2_Power/MeshRepeater2_Power.kicad_pcb --out output/POWER --drc --step
```

Свежий экспорт выполняют для всех изменённых плат. Манифест связывает SHA256 исходного PCB и каждого результата. Верхний вид LOGIC после сборочного поворота — `output/LOGIC/MeshRepeater2_Logic_operator_top.png`: зеркальный native B-вид с дополнительным поворотом изображения на 180°. Нумерация электрических контактов не меняется.

Сборку создают из этих STEP и текущего `docs/mechanical_selection.json` через `tools/cad/build_v2_assembly.py` под Python FreeCAD. Отчёт [assembly_geometry_report.json](mechanics/assembly_geometry_report.json) фиксирует входные хеши, номинальную геометрию и исключённые из модели условия. Модели разъёмов и крепежа не подтверждают реальные допуски, глубину контакта или резьбы; их проверяют на приобретённом образце. STEP для хранения передают с помощью `tools/prepare_v2_step_transport.py`, см. [STEP_TRANSPORT_RU.md](STEP_TRANSPORT_RU.md).

## Финальный контроль

Для сохранённой A3 получены 81/81 схемных проверок, 57/57 проверок PCB/model/XML и 110/110 независимого аудита. Native DRC трёх плат и ERC двух схем — 0. Итоговая приёмка сверила хеши отчётов, BOM, STEP/gzip, сборочной геометрии и изображений. Эти результаты не распространяются на последующие изменения файлов.

После фиксации CAD заново получают native XML/ERC, DRC, схемный граф, парность PCB/model/XML и BOM. Независимый аудит читает эти окончательные файлы и проверяет собственные хеши до/после; он не правит платы. Итоговая сводка — [A3_FINAL_CHECKS.json](../audit/a3_2026_10_13/A3_FINAL_CHECKS.json), независимый отчёт — [independent_final.json](../audit/a3_2026_10_13/independent/independent_final.json).

`tools/build_v2_a3_overview.py` обновляет обзор только после успешных проверок и совпадения хешей. После любой последующей правки CAD прежний результат недействителен до нового прогона. Старые проверки A2 и число 499/499 относятся к снимку A2.

CAD-контроль не заменяет испытания EMI, устойчивости LC, импульсной нагрузки, температурных режимов, USB клона и принятых ограничений LTO. Их перечень сохранён в [V2_LIMITATIONS_RU.md](V2_LIMITATIONS_RU.md).
