Alksndr55/mesh-repeater-2.0/docs/ELECTRICAL_PARTITION_RU.md

# Mesh Repeater 2.0: разделение электрической схемы

> Исторический материал исходного разбиения A1. Текущая A3, перенос J11 на POWER, карта SYS/RADIO и окно экрана описаны в [инструкции A3](V2_ASSEMBLY_INSTRUCTIONS_RU.md) и [проверках A3](NATIVE_BOARD_CHECK_RU.md). Старые кабельные/питающие решения ниже не являются инструкцией для новой платы.

Основа — опубликованная S4.16 изделия Mesh Repeater 1.0, коммит `cf54f9970e716272d477afdb252b4e195d595cb6`. Контрольная сумма исходной платы: `742ae27bb1d13893f6dc368e5c67f5c41b35a3e6765331fc7e9871297d23dec6`.

Это контракт для последующей разработки двух плат. Он фиксирует исходные компоненты, связи и варианты сборки. Проверка новых сохранённых плат и их электрической эквивалентности выполняется после трассировки.

## Распределение

Все 167 исходных позиций учтены однократно. Исходное распределение в `component_partition.csv` содержит 115 позиций POWER и 52 LOGIC с точными выводами, сетями и вариантами. После независимой размерной проверки единственная механическая позиция SH1 удалена явным решением C из `audit/v2_frame_mount_review.json`: в текущей POWER сохранены 114 исходных позиций, в LOGIC — 52. Исходная таблица остаётся доказательством первоначального распределения, актуальный учёт — `bom/V2_COMPONENT_BOM.csv` и `audit/v2_component_bom.json`. Новые межплатные разъёмы и крепёжные контакты добавляются отдельно; функциональные номиналы и связи не меняются.

POWER содержит CN3722 и его цепи, TPS63802 и его цепи, оба LC-каскада с банками ёмкости и резисторами демпфирования, балансиры LTO, весь опциональный узел снижения тока на холоде, разъёмы солнца и аккумулятора. D3/D4 вместе с R10/R11 остаются здесь; управляющие сети CHRG/DONE через кабель не проходят.

LOGIC содержит Nice!Nano, HT-RA62, антенный тракт, RTC и CR2032, watchdog, GPS, I²C/UART/ISP, кнопки и J11. FB1, C23 и C24 остаются рядом с модемом. C21/C22, C27 и C33 остаются у соответствующих потребителей. R21 переносится к модему на верхнюю плату; R17 остаётся у TPS63802 снизу.

Исходные H1–H4 закреплены за POWER. Верхняя плата и экран получают дополнительный согласованный комплект отверстий. Рамка SH1 и прежняя крышка в 2.0 отсутствуют. Средний непрерывный экран, GND-контакты крепления и полноценный кабельный возврат сохранены. Удаление вертикальных стенок не является доказательством прежнего уровня EMI; требуется измерение собранного образца.

## Межплатные связи

Реальные исходные связи дают ровно четыре пересекающие сети: FILTER_OUT, GND, BAT и MODE. Актуальные разъёмы — J101 на POWER, J201 на LOGIC, поляризованный кабель на 12 контактов из `design/interboard_cable.json`. Он заменяет раннее десятиконтактное предложение J14/J15:

| Контакт J101 → контакт J201 | Сеть | Назначение |
|---|---|---|
| 1 → 1, 3 → 3, 5 → 5, 7 → 7 | FILTER_OUT | 3,3 В после обоих LC-каскадов, к J11.1 |
| 2 → 2, 4 → 4, 6 → 6, 8 → 8 | GND | Основной возврат питания |
| 9 → 9 | BAT | Отдельный провод измерения батареи к R27.1 |
| 10 → 10 | GND | Земля рядом с BAT |
| 11 → 11 | MODE | Сигнал управления TPS63802 после R21 |
| 12 → 12 | GND | Земля рядом с MODE |

Номера сверяются по выбранным чертежам, ориентации половин и готовому кабелю. Механический выбор записан в `docs/mechanical_selection.json`; таблица не заменяет физическую проверку. Полные исходные точки обеих плат указаны в `design/v2_electrical_contract.json`. `interboard_nets_proposal.csv` хранит раннее предложение, которое заменено актуальным 12-контактным JSON.

Расчётная непрерывная нагрузка FILTER_OUT — 0,5 А из бюджета S4.16; это проектный предел, а не результат измерения. Каждый отдельный питающий контакт и каждый основной контакт GND выбираются на полный этот ток. Четыре параллельных питающих контакта уменьшают сопротивление соединения и дают резерв; автоматическое учетверение допустимого тока не принимается. Старт, пиковые токи и падение на готовом кабеле проверяются отдельно.

Рабочий ток и его возврат идут через кабель. Экран и металлические стойки соединяются с GND для экранирования, но не являются обязательными проводниками питания. Функции устройства должны сохраняться при отсутствии проводимости крепежа.

## J11 и USB

J11 полностью находится на верхней плате. Контакт 1 получает FILTER_OUT по кабелю. Контакт 2 создаёт локальную сеть SYS_3V3 для всех верхних потребителей. SYS_3V3 в межплатный кабель не выводится; нижняя плата не имеет её нагрузки. Такое разделение сохраняет исходную функцию единственного съёмного соединения.

При работе от аккумулятора или солнца шунт установлен. Перед USB его снимают и устанавливают обратно после отключения USB. Не допускаются медь, второй контакт разъёма или иной добавленный путь, соединяющие FILTER_OUT и SYS_3V3 в обход J11. Унаследованная проверка питания конкретного Nice!Nano-клона от USB и отключения его штатной зарядки остаётся обязательной проверкой образца.

## Измерение батареи

R27/R28 по 2,2 МОм и C25=100 нФ остаются на верхней плате возле M1.8. Сохраняются отношение 1:2 и постоянная времени 0,11 с. По кабелю передаётся BAT до делителя, а короткая высокоомная сеть BAT_ADC остаётся рядом с MCU. Это уменьшает восприимчивость высокоомного узла к наводкам по сравнению с передачей BAT_ADC между этажами.

На нижней плате отдельная измерительная дорожка BAT начинается непосредственно у J8.1 либо J12.1; она не должна использовать падение напряжения силового участка BAT. Измерительный провод не питает нагрузку верхней платы. Ток делителя при 5,5 В составляет 1,25 мкА. Общая GND по кабелю остаётся источником погрешности от падения напряжения возвратного тока, поэтому размещение точек земли и калибровка проверяются на образце.

## Управление TPS и watchdog

Реальный источник RADIO_TXEN — выводы 5 и 7 M2, соединённые в S4.16. Через существующий R21=1 кОм сигнал формирует MODE. R21 размещается у источника сверху; кабель передаёт MODE. R17=100 кОм остаётся снизу возле U2.2 и задаёт LOW при разъединённых платах. Полярность и номиналы не меняются.

Watchdog получает RADIO_TXEN через R38=1 кОм на U6.2. Эта цепь полностью остаётся на LOGIC, как и reset/ISP. Передача MODE между этажами не меняет цепь контроля модема.

## Варианты и источники номиналов

Сохранены три варианта S4.16: Na-ion с холодным режимом, Na-ion без холодного режима и LTO 2S. В контракте каждой позиции сохранена полная неизменённая строка `assembly_variants_S4_16.csv`, включая Fit и MPN для всех вариантов. Нативное DNP не является источником выбора монтажа: в S4.16 зачёркивания убраны по указанию пользователя.

В исходном `model.json` есть старые сводные поля `assembly_variants` с прежними делителями. Они не совпадают с актуальными позициями, схемой и CSV и не используются при переносе. Актуальные R3/R4: Na-ion 61,9 кОм / 100 кОм; LTO 121 кОм / 100 кОм. R15: Na-ion 40,2 кОм, LTO 130 кОм; R16 для обоих 49,9 кОм. C30: Na-ion 12 пФ, LTO 6,8 пФ. R56: Na-ion cold 1,8 Ом, Na-ion no cold и LTO — перемычка 0 Ом. Номиналы самих узлов не изменяются.

## Проверенная основа и оставшиеся проверки

Проверены совпадение 167 позиций модели, исходного XML-netlist и CSV, 86 функциональных сетей по точному составу выводов и 16 специально неподключённых выводов. Номиналы по умолчанию в нативной схеме совпадают с позициями модели и CSV. Проверена контрольная сумма принятой платы S4.16.

Окончательные ERC/DRC, соответствие схем новым платам, электрическая эквивалентность через разъёмы, корректность кабеля и механическая совместимость относятся к следующим стадиям. Старые результаты S4.16 не являются подтверждением новых плат 2.0.

Унаследованы ограничения S4.16:

- 2 Ом в балансире не гарантируют рекомендованные/предельные токи LMV431A во всех допусках.
- Независимая защита перенапряжения не установлена по согласованному решению; переходные процессы при снятии аккумулятора не гарантированы ниже 5,5 В.
- Порог EN по общему напряжению LTO не является независимой защитой каждой ячейки.
- Эффективная ёмкость каждого LC-банка ≥330 мкФ при 3,3 В, переходные процессы нагрузки и запуск требуют квалификации образца.
- Питание конкретного Nice!Nano-клона от USB с вынутым J11 и отключённой зарядкой требует проверки образца.
- Точные данные панели, аккумуляторов, часть MPN прецизионных деталей и совместимость кабеля GPS ещё требуют подтверждения.
- CAD-аудит не подтверждает фактический уровень излучаемых и проводимых помех; нужны измерения.

Проверка разбиения не разрешает эти ограничения и сохраняет их статус.
