Alksndr55/mesh-repeater-2.0/docs/INITIAL_CAD_WORKFLOW_RU.md

# Mesh Repeater 2.0: начальные модели и ориентация CAD

> Исторический материал исходного разбиения A1. Текущая A3, перенос J11 на POWER, карта SYS/RADIO и окно экрана описаны в [инструкции A3](V2_ASSEMBLY_INSTRUCTIONS_RU.md) и [проверках A3](NATIVE_BOARD_CHECK_RU.md). Старые кабельные/питающие решения ниже не являются инструкцией для новой платы.

Созданы независимые каталоги `design/MeshRepeater2_Power` и `design/MeshRepeater2_Logic`. Их `model.json` получены из замороженного `baseline/S4_16/model.json` с разбиением по электрическому контракту. После независимой размерной проверки POWER содержит 114 исходных позиций и J101; LOGIC — 52 исходные позиции, J201 и четыре новых крепёжных контакта H201–H204. Единственная удалённая исходная позиция — механическая рамка SH1. Исходные функциональные номиналы и выводы не изменены.

Это начальные модели для компоновки. Они не являются окончательной разводкой. Генераторы схем, платы, её локальная корректировка и последующие проверки работают только внутри каталога версии 2.0.

## Ориентация

В нативной плате KiCad основные компоненты ОБЕИХ рабочих плат остаются на F.Cu. Нижняя POWER устанавливается компонентами вверх. Верхняя LOGIC поворачивается целиком на 180° вокруг оси X при построении сборки; её компоненты оказываются направлены вниз к экрану. Наружные операторские подписи верхней платы располагаются на B.SilkS.

Переворачивать одновременно отдельные footprints на B.Cu и всю верхнюю плату при сборке нельзя: такой двойной переворот направит компоненты в неверную сторону. Для платы 90×60 мм поворот верхнего этажа относительно центра означает физическое соответствие `X = native X`, `Y = 60 − native Y`. Разъёмы и кнопки проверяются в собранном виде, а не только по плоскому изображению отдельных плат.

По уточнению пользователя J10 ISP сохраняет исходные координаты `(35,7; 31,3)` мм, поворот 0° и первоначальное посадочное место S4.16. Доступ к ISP предусмотрен после разборки; это выбранный порядок обслуживания.

## Межплатное соединение

Актуальная электрическая карта: `design/interboard_cable.json`. Она заменяет раннее предложение десятиконтактных J14/J15 из первой версии контракта.

J101 на POWER и J201 на LOGIC соединяются кабелем 1:1 на 12 контактов. Контакты 1/3/5/7 — FILTER_OUT; все чётные — GND; контакт 9 — BAT sense, контакт 11 — MODE. SYS_3V3 в кабеле отсутствует. Это сохраняет четыре исходные пересекающие сети; число параллельных силовых контактов меняется только по механическому выбору соединителя.

Каждый питающий контакт должен самостоятельно выдерживать полный проектный непрерывный ток 0,5 А. Четыре параллельных контакта не используются как основание автоматически увеличить паспортный допустимый ток. Ориентация ключей, маркировка первого контакта, номера обоих концов и способ обжима кабеля проверяются по выбранным реальным деталям.

## Начальные механические замены

- J7/J8 — горизонтальное двухконтактное исполнение XH; исходный порядок 1/2 сохраняется.
- J12 — отдельный четырёхконтактный корпус XH. Контакты 1 BAT, 2 LTO_MID, 3 GND сохраняются; новый контакт 4 намеренно не подключён.
- J11 — угловая гребёнка 1×2 со съёмным шунтом, исходные FILTER_OUT/SYS_3V3.
- SW1/SW2 — TE 1825027-2 с боковым нажатием и той же электрической парой нормально разомкнутого контакта.
- H1–H4 на POWER и H201–H204 на LOGIC — открытые контактные площадки GND с отверстиями M3, согласованные XY `(3,5;3,5)`, `(86,5;3,5)`, `(3,5;56,5)`, `(86,5;56,5)` мм.
- SH1 — рамка и прежняя крышка удалены явным механическим решением C из `audit/v2_frame_mount_review.json`. Оставлены непрерывный средний экран и соединённые с GND крепления. Контуры courtyard не сужаются для обхода проверок; измеренная эквивалентность EMI без боковых стенок не заявляется.

Стартовые generic footprints XH/IDC/J11 заменены локальными посадочными местами выбранных деталей; карточки ДАН, артикулы и первичные размерные источники записаны в `docs/mechanical_selection.json`. Фактическое сопряжение заказанных деталей и сборки остаётся проверкой образца. Монтажные отверстия TE имеют шаг 7,01 мм, а электрическая пара — 4,50 мм; ширина корпуса 7,11 мм не является шагом отверстий.

Ранний исходный `model.json` содержит старые сводки, поэтому текущие варианты в начальных моделях явно синхронизированы с CSV S4.16. Полные исходные строки сохранены в `assembly_variants_authoritative`, а прежняя сводка — в `assembly_variants_original_summary` только как история.

Повторный запуск `tools/seed_two_models.py` отказывается перезаписывать уже созданные `model.json`, чтобы сохранить последующие изменения компоновки и схем.
