Alksndr55/mesh-repeater-2.0/docs/V2_A3_RELEASE_RU.md

# Mesh Repeater 2.0 — V2.0-A3

Публикация 13 октября 2026 года: текущий инженерный прототип в самостоятельном
репозитории `Alksndr55/mesh-repeater-2.0`, ветка `main`, тег `v2.0-a3`.
Архив A2 и его тег сохраняются как предыдущая редакция.

## Что входит в выпуск

- Редактируемые KiCad-проекты POWER, LOGIC и SHIELD, локальные символы,
  посадочные места и 3D-модели; исходники watchdog.
- Две рабочие платы 90×60 мм и промежуточный экран того же размера.
- POWER: все компоненты на стороне F, INA219 с R71=0,1 Ом, J11 у края,
  две ветви питания SYS_3V3/RADIO_3V3 после одного съёмного шунта,
  шесть согласованных силовых резисторов в корпусах 2512.
- Вертикальные J101/J201 и окно экрана 17,2×6,8 мм, R0,6.
- PDF схем A3, BOM трёх вариантов, распиновки, инструкция, виды плат,
  сборочные модели и материалы проверок.
- [Независимый инженерный аудит](V2_ENGINEERING_AUDIT_A3_2026_10_13_RU.html)
  с расчётами, источниками и критериями испытаний.

Полный архив `Mesh-Repeater-2.0-A3-project.zip` содержит точный Git-снимок
тега, четыре восстановленных из `.step.gz` сборочных STEP и
`RELEASE_MANIFEST.json` с SHA-256 файлов. Отдельный checksum прилагается к релизу.
После распаковки откройте `.kicad_pro` нужной платы. Требуются KiCad 10
и его обычные библиотеки; нестандартные библиотеки и модели включены.

## Проверки и открытые ограничения

Свежие ERC обеих схем и DRC трёх плат на копиях, включая новые заливки,
не обнаружили нарушений. Проверены сохранение функциональных связей и GPIO,
отсутствие силового обхода снятой J11, межплатная распиновка 1:1 и связность GND
без зависимости рабочего возврата от проводимости стоек.
Номинальные попарные пересечения трёх этажей в STEP — 0 мм³.

Это результаты CAD. Реальные разъёмы, допуски сборки, питание, USB,
LC и восстановление после разряда, GPS, температура и RF/EMI требуют
испытаний. Watchdog пересобран с совпадением HEX. Сборка основного MeshCore
выполнялась, но остановилась на ограничении длинных путей Windows;
успешный MCU-бинарник этим выпуском не заявляется.

Сохранены прежние риски LTO:

- Балансиры с резисторами 2 Ом не гарантируют допустимый ток LMV431.
- При снятой батарее зарядник может вывести вход TPS63802 за рабочие 5,5 В.

Принятие этих ограничений не означает устранение рисков. Перед USB снимите
J11 на POWER; верните шунт после отключения USB. Подключение конкретного
GPS требует проверки питания контактов 6/7. SAW-опция FL1 имеет собственные
ограничения мощности и температуры; по умолчанию она не устанавливается.

Производственный пакет ранее отложен владельцем. Это выпуск для изучения
и подготовки контролируемого прототипа; готовность к изготовлению комплектов
и эксплуатации не подтверждена.

## Что изменено именно при публикации

Схемы, PCB, корпуса, номиналы, библиотеки и разводка не менялись.
Обновлены ссылки README/BOM и обозначено историческое содержание прежнего
описания изменений. Заголовки A2 внутри двух PCB и остальные замечания
аудита остаются открытыми; переименование native файлов ради выпуска не выполнялось.

Отчёт аудита фиксирует состояние до публикационного коммита: прежний HEAD
`d1206d1cf134ac7ee1fb50b80c9488904241908c` и локальную A3, описанную контрольными
суммами. Его доказательство сохранности относится к завершённому аудиту,
а не к последующим разрешённым изменениям документации и Git при публикации.
Содержательные выводы отчёта сохранены; ссылка на большой worktree diff
переведена на его точную gzip-копию. Временные CAD_CHECK и среды PlatformIO/SDK
остались локальными; небольшие логи сборки включены как доказательства.

Воспроизводимая упаковка: `tools/build_v2_a3_release.py --commit <SHA> --out <папка>`.
