Alksndr55/mesh-repeater-2.0/v2/docs/LICENSING_RU_EN.md

# Использование материалов / Use of project materials

22.10.2026 · Mesh Repeater 2.0

Copyright © 2026 Alksndritm (GitHub: [Alksndr55](https://github.com/Alksndr55)).
Designed by @Alksndritm.

## Русский

### Лицензия и её область

Собственные материалы [Mesh Repeater 2.0](https://github.com/Alksndr55/mesh-repeater-2.0)
распространяются по **Creative Commons Attribution–NonCommercial–ShareAlike
4.0 International (CC BY-NC-SA 4.0)**, в пределах принадлежащих автору прав
и если для конкретного материала прямо не указана другая лицензия.

Это относится к собственным вкладам автора в схемы и печатные платы,
документации, иллюстрациям, созданным для проекта моделям, собственному коду
и исходным материалам. Наличие файла в репозитории само по себе не означает,
что автору принадлежат все права на него. Заимствованные материалы и их
производные сохраняют условия, указанные в
[THIRD_PARTY_NOTICES.md](../THIRD_PARTY_NOTICES.md), соответствующих файлах
и [LICENSES/](../LICENSES/).

Официальный полный текст CC BY-NC-SA 4.0 хранится без изменений в
[LICENSE](../LICENSE) и [LICENSES/CC-BY-NC-SA-4.0.txt](../LICENSES/CC-BY-NC-SA-4.0.txt).
Это пояснение не заменяет и не дополняет ограничениями стандартную лицензию.

### Распространение и переработки

При распространении материалов и переработок выполняйте условия CC BY-NC-SA
4.0: указывайте **@Alksndritm / Mesh Repeater**, сохраняйте применимые
уведомления, давайте ссылку на
[проект](https://github.com/Alksndr55/mesh-repeater-2.0) и
[лицензию](https://creativecommons.org/licenses/by-nc-sa/4.0/), отмечайте
внесённые изменения. Переработки распространяйте под той же лицензией
CC BY-NC-SA 4.0 в соответствии с её условиями. Упоминание автора не означает
его одобрения переработки или участия в ней.

### Дополнительное разрешение на личный заказ плат

В дополнение к стандартной лицензии автор разрешает физическому лицу
передать необходимые производственные файлы изготовителю и заказать
изготовление и, при необходимости, монтаж плат исключительно для
собственного личного некоммерческого использования.

Изготовителю разрешено использовать наши материалы в объёме, необходимом
для выполнения такого заказа, изготовить, смонтировать и передать платы
этому заказчику и получить оплату за соответствующую услугу. Отдельное
письменное разрешение автора для такого личного заказа не требуется.

Это дополнительное разрешение не даёт изготовителю или заказчику права
выпускать платы или устройства на склад, предлагать их как самостоятельный
товар, организовывать розничную продажу или перепродажу. Оно относится только
к правам автора на собственные материалы; сторонние лицензии продолжают
действовать.

### Коммерческое использование

За исключением описанного дополнительного разрешения на личный заказ,
коммерческое использование наших материалов, в том числе коммерческий
выпуск и продажа плат, комплектов, собранных устройств и использование
материалов в коммерческих или монетизируемых проектах, допускается только
по **предварительному письменному разрешению Alksndritm**.

Для согласования обратитесь к автору через профиль
[Alksndr55](https://github.com/Alksndr55). Публичная доступность файлов,
скачивание архива или указание авторства не заменяют такого разрешения.

### Сторонние права и прежние разрешения

Материалы FakeTec V6 сохраняют CERN-OHL-P-2.0, авторство и уведомления об
изменениях. Материалы библиотек KiCad, включая их модификации, распространяемые
в составе коллекции библиотек, сохраняют CC-BY-SA-4.0 и исключение KiCad.
Исключение KiCad позволяет выбирать лицензию электронного проекта и
полученных из него файлов; оно не отменяет лицензию самой библиотеки.

Ни CC BY-NC-SA 4.0, ни дополнительное разрешение не заменяют эти сторонние
лицензии, не ограничивают отдельно предоставленные сторонними авторами права
и не заявляют права на чужие патенты, товарные знаки или независимые разработки.
Законные исключения и ограничения авторского права сохраняются. Ранее
действительно предоставленные права по иной лицензии не отзываются.

## English

### License and scope

Original materials of [Mesh Repeater 2.0](https://github.com/Alksndr55/mesh-repeater-2.0)
are licensed under **Creative Commons Attribution–NonCommercial–ShareAlike
4.0 International (CC BY-NC-SA 4.0)**, to the extent of the author's rights
and unless a particular material expressly states another license.

This covers the author's original contributions to schematics and PCB
designs, documentation, illustrations, project-created models, original
code and source materials. Inclusion in this repository does not by itself
mean that the author owns all rights in a file. Third-party materials and
their derivatives retain the terms identified in
[THIRD_PARTY_NOTICES.md](../THIRD_PARTY_NOTICES.md), the relevant files and
[LICENSES/](../LICENSES/).

The unmodified official CC BY-NC-SA 4.0 legal code is provided in
[LICENSE](../LICENSE) and [LICENSES/CC-BY-NC-SA-4.0.txt](../LICENSES/CC-BY-NC-SA-4.0.txt).
This explanation does not replace the standard license or add restrictions
to it.

### Sharing and adaptations

When sharing the materials or adaptations, follow CC BY-NC-SA 4.0: credit
**@Alksndritm / Mesh Repeater**, retain applicable notices, link to the
[project](https://github.com/Alksndr55/mesh-repeater-2.0) and
[license](https://creativecommons.org/licenses/by-nc-sa/4.0/), and indicate
your changes. Share adaptations under the same CC BY-NC-SA 4.0 license in
accordance with its terms. Attribution does not imply the author's
endorsement of or participation in an adaptation.

### Additional permission for personal PCB orders

In addition to the standard license, the author permits an individual to
provide necessary production files to a manufacturer and order PCB
fabrication and, if needed, assembly solely for that individual's own
personal, noncommercial use.

The manufacturer may use the author's materials to the extent necessary
to fulfil that order, fabricate, assemble and deliver the PCBs to that
customer, and charge for the corresponding service. No separate written
permission from the author is needed for such a personal order.

This additional permission does not authorize either the manufacturer or
the customer to manufacture PCBs or devices for stock, offer them as
standalone products, organize retail sale or resale. It covers only the
author's rights in the original materials; third-party licenses continue
to apply.

### Commercial use

Except for the additional personal-order permission above, commercial use
of the author's materials, including commercial manufacture and sale of
PCBs, kits or assembled devices and use of the materials in commercial or
monetized projects, requires **prior written permission from Alksndritm**.

Contact the author through [Alksndr55](https://github.com/Alksndr55) to agree
on permission. Public availability, downloading an archive or providing
attribution does not replace that permission.

### Third-party rights and earlier permissions

FakeTec V6 materials retain CERN-OHL-P-2.0, attribution and modification
notices. KiCad library materials, including modifications distributed as
a library collection, retain CC-BY-SA-4.0 and the KiCad exception. The
exception permits choosing a license for an electronic design and its
generated files; it does not remove the library's own license.

Neither CC BY-NC-SA 4.0 nor the additional permission replaces these
third-party licenses, restricts rights granted separately by third-party
authors, or claims rights in their patents, trademarks or independent
implementations. Statutory exceptions and limitations remain unaffected.
Rights validly granted earlier under another license are not revoked.
