Alksndr55/mesh-repeater-2.0/audit/V2_ENGINEERING_AUDIT_A3_2026_10_13/ELECTRICAL_FINDINGS_RU.md

# POWER / межплатное питание: независимый аудит A3

Проверены актуальные `design/MeshRepeater2_Power` и `design/MeshRepeater2_Logic` в рабочей v2 на HEAD d1206d1cf134ac7ee1fb50b80c9488904241908c с локальными A3. Входы — реальные `.kicad_sch`, `.kicad_pcb`, `model.json` и свежие native XML, экспортированные родительским аудитором на проверочной копии. Старые отчёты не использованы как доказательство исправности. Ничего в исходниках не менялось. Идентификаторы E01…E05 предварительные; окончательные V2-AUD назначает основной отчёт.

Полные позиции, номера строк схем, координаты и нативные сети площадок находятся в `ELECTRICAL_native_evidence.json`. В `ELECTRICAL_calculations.json` — воспроизводимые DC-расчёты. Отдельный `ELECTRICAL_LC_PASSIVE.json` содержит линейный частотный расчёт пассивного фильтра. Измерений на образце, SPICE-моделирования зарядника, TPS63802 или батареи не было.

## E01 — LMV431 нельзя считать защищённым балансиром LTO

**Критичность: критическая по возможному повреждению; статус: обоснованный риск, с подтверждённым отсутствием гарантии допустимого тока.** Унаследовано, явно оставлено пользователем 12.10.2026; это история решения, а не доказательство безопасности.

Схема `LTO_Balancer.kicad_sch`: U8 строка10043 / (96,52;96,52), U9 строка10540 / (259,08;96,52); R47 строка11041 / R51 строка10295 — **2Ω±1%**. На PCB U8 (30,5;15,6), U9 (12,8;49), R47 (18,2;15), R51 (12,8;45). R48+R49 и R52+R53: 122,49kΩ сверху; R50/R54: 100kΩ снизу. Нативные площадки: U8.3=K, U8.4=REF, U8.2/.5=LTO_MID; U9.3=K, U9.4=REF, U9.2/.5=GND. Это прямая шунтирующая схема без отдельного силового ключа или ограничителя тока.

Для выбранного **TI LMV431AIM5/NOPB**, [SNVS041G](https://www.ti.com/lit/ds/symlink/lmv431.pdf), p4 §7.1/7.3: рекомендуемый Ik≤15mA, абсолютный непрерывный Ik≤30mA; p8 §7.8 задаёт Vref=1,24V, полный температурный минимум1,215V, Iref тип0,15µA / максимум0,5µA. Формула `Vz=Vref×(1+Rt/Rb)+Iref×Rt` даёт **2,77725V типично**, а не 2,75888V при отброшенном Iref. Следовательно, значение 2,759V не является точным гарантированным порогом такого высокоомного делителя.

Иллюстративный угол с Vcell=2,75V, Vref=1,215V, Rt−0,1%, Rb+0,1%, Iref=0 (минимум не нормирован), Rs−1% даёт Vz≈2,70028V и `Ik≈(2,75−2,70028)/1,98−Idivider≈25,10mA`: рекомендованный предел превышен. При Vcell=2,85V и типичных параметрах расчёт36,36mA превышает30mA. **2,85V не объявляется допустимым режимом неизвестной LTO-ячейки**: этот пример показывает отсутствие самостоятельной токовой защиты. При дисбалансе двух ячеек верхняя ячейка может иметь больше половины общего напряжения; измерение только пакета не исключает этого.

C58/C59=47nF не признаны отдельным дефектом: визуально проверенная Figure19, p14 помещает47nF справа от типичной неустойчивой области для2/3V. График25°C с другой внешней обвязкой не квалифицирует все углы фактического узла.

**Минимальное предложение:** после выбора ячеек рассчитать безопасный балласт/ограничение Ik≤15mA на всех допустимых углах; если требуемый ток балансировки выше, добавить внешний силовой шунт либо независимую защиту отдельных ячеек. Увеличение только балласта меняет эффективность балансировки и требует нового расчёта. **Приёмка:** сначала два изолированных эмулятора ячеек; раздельные напряжения и токи R47/R51, холод/тепло и разброс деталей; Ik≤15mA, соблюдение паспортных пределов обеих ячеек и отсутствие генерации; оценить балансировку при максимальном токе зарядника. Проверку разрушительных углов выполнять ограниченным током, не настоящим аккумулятором.

## E02 — режим LTO без батареи не ограничивает вход TPS63802 до5,5V

**Критичность: критическая по возможному повреждению; статус: обоснованный риск, подтверждена несовместимость гарантированных диапазонов.** Независимая OVP отсутствует; сохранение ограничения ранее принято пользователем.

`MeshRepeater2_Power.kicad_sch`: U1 строка16811, R3 строка13233, R4 строка14692. `Converter.kicad_sch`: U2 строка21620. Нативная общая сеть **BAT_SYS** содержит U1.14, R3.1, C4.1, C12/C52.1, U2.10 и R71.1. R3_LTO=121kΩ / R4=100kΩ, оба0,1% и≤25ppm/°C. `BatteryMonitor.kicad_sch` R71 строка10681 связывает BAT_SYS с BAT через0,1Ω. Снятие J11 разрывает выход питания LOGIC, **но не отсоединяет U2.10 от зарядника**.

Официальный [CN3722 Rev1.2](https://consonance-elec.com/static/upload/file/20231218/1702867496726953.pdf), p4 электрические характеристики / p5 описание / p6 установка CV: FB2,392…2,44V, IFB≤300nA; внутренний порог OVP1,06…1,10×Vreg. Изготовитель прямо допускает достижение этого порога при отсутствии/внезапном снятии батареи. Формула `Vreg=VFB×(1+R3/R4)+IFB×R3`; сопротивление ошибается на `0,1%+25ppm×65°C=0,2625%` при−40…85°C относительно25°C. Расчёт LTO: тип5,34541V, верхний CV5,44434V; внутренний OVP тип5,77304V и верхний5,98877V. Это **расчёт диапазона, не измеренный выброс**. У TPS63802DLAR [SLVSEU9D](https://www.ti.com/lit/ds/symlink/tps63802.pdf), p5 §8.3 рекомендован VIN≤5,5V; абсолютные6V не заменяют рабочий предел.

**Балансиры учтены:** без батареи остаётся серия BAT_SYS→R71→BAT→R47→U8→MID→R51→U9→GND. Типовая сумма напряжений включения двух LMV≈5,5545V уже выше5,5V. При5,773V простая статическая оценка `I≈(5,773−5,5545)/(2+2+0,1)≈53mA` для каждого LMV превышает абсолютный предел. Она не предсказывает реальный переходный процесс или предел после отказа. Нельзя объявлять эти LMV идеальным безопасным ограничителем входа TPS.

**Минимальное предложение:** независимая отсечка/ограничитель, гарантированно удерживающая U2.10≤5,5V с допусками и выбросами, либо преобразователь с достаточным входным рабочим диапазоном; пересчитать балансир вместе с E01. **Приёмка:** эмулятор LTO-пакета, SOLAR7,5…подтверждённый холодный Voc, лёгкая/максимальная нагрузка, подключение и отключение батареи; осциллограф непосредственно U2.10–U2.8 и раздельно токи балансира. У2.10≤5,5V во всех заявленных режимах. Пока этот режим не квалифицирован, ограниченное лабораторное питание допустимо лишь с отдельным контролем BAT_SYS, а солнечное включение без LTO-батареи не подтверждено безопасным.

## E03 — паспорт ячеек и батарейные ограничения ещё не определены

**Критичность: высокая; статус: непроверенный вопрос из-за отсутствия данных.** Не утверждается, что выбранная химия сама по себе запрещена. На схеме предусмотрены Na-ion1S, Na-ion без COLD и LTO2S, но точных ячеек/пакета, защиты, разрешённых токов и температур нет.

Фактический зарядный путь: U1.13 CS_P→R56 (1,8Ω в COLD или0Ω без COLD/LTO) и его байпас Q4/Q6/Q7→R1=0,28Ω→BAT_SYS; U2 и аккумулятор черезR71 являются общей нагрузкой зарядника. Расчёт без COLD `I=0,200/0,28=714mA`, край по VCS215mV и R1−1% **775,6mA** без добавления неподтверждённого ТКС. Холодный ток тип`0,2/(1,8+0,28)=96,15mA`; верхний угол VCS/R±1% **104,4mA**. Указанные токи относятся к выходу зарядника: часть потребляет устройство, это не всегда ток в ячейку. При недостаточной инсоляции он ниже.

Na CV: тип3,91460V, верхний3,97693V по указанным выше допускам — ниже согласованного4,0V в установившемся режиме. Это не подтверждает токи, температурный режим или допустимость длительного CV конкретной Na-ячейки. EN R15/R16=40,2k/49,9k: тип OFF1,80561V; на порогах TI и допусках R0,1% расчёт OFF1,74988…1,86949V. История требования: пользователь согласовал приблизительно1,74V; диапазон **не объявляется нарушением прежнего1,8V**. LTO130k/49,9k: OFF3,4920…3,7448V для всего пакета; защиты каждой ячейки здесь нет. Полный температурный угол LTO_EN не завершён: точный MPN130k не выбран.

TEMP U1.6 связан с R9=10kΩ наGND, поэтому собственный температурный контроль зарядника отключён. В `Thermal.kicad_sch` TH1 строка10970 (PCB45;53) чувствует местную температуру платы; удалённый датчик допускается вместо него. U10 (LM393XK) имеет два согласованно соединённых открытых выхода, U11.2 является катодом LM285Z-2.5G, U11.3 анодомGND — распиновки производителей совпадают с CAD. NTCopen и NTCshort направляют схему к ограниченному току; **COLD уменьшает заряд, а не полностью отключает его**, и не задаёт верхнюю температуру ячейки. В тёплом подэкранном пространстве холодная внешняя ячейка может получать тёплый ток.

**Минимальное предложение:** выбрать точные аккумуляторы/защищённый пакет и датчик на ячейке, зафиксировать их разрешённые CV, токи, разряд и температуру; по необходимости изменить защиту/токи, отдельно согласовав изменение сохранённой схемы. **Приёмка:** эмулятор батареи, контроль каждой ячейки, токи и OFF/ON, температурные переходы настоящего датчика относительно ячейки, его обрыв/КЗ, одновременная TX/GPS-нагрузка; все критерии по выбранному паспорту. До его появления безопасное первое включение с настоящей батареей нельзя подтвердить.

## E04 — J11 электрически разделяет LC, но USB-источник клона не квалифицирован

**Критичность: высокая; статус: непроверенный вопрос / обоснованный риск.** Прямого медного обхода J11 не найдено. `Interconnect.kicad_sch` POWER J11 строка11035 (PCB86;23): FILTER_OUT→SYS_3V3; NT2 строка10129 (82,5;25,54) соединяет SYS и RADIO после шунта. J101/J201:1/3 SYS,5/7 RADIO,2/4/6 GND,8NC,9BAT,10SDA,11MODE,12SCL. SYS_3V3 отсутствует до J11 на POWER.

USB M1 (LOGIC строка17305 / PCB18;18,5) питает SYS→межплатные1/3→NT2→межплатные5/7→FB1→M2, а также INA219 U12.5, RTC, watchdog и GPS. Следовательно, источник USB на модифицированном клоне должен питать **полную нагрузку**, включая модем. Точная плата клона, LDO, проверка отключённой штатной зарядки и допустимая мощность неизвестны; надпись NiceNano_CLONE_MODIFIED не подтверждает это. Установка J11 при USB соединяет два источника и допускает обратный поток через TPS — порядок снятия шунта обязателен.

Сигналы тоже учтены: RADIO_TXEN M2.5/.7→R21=1kΩ (LOGIC строка12487)→MODE→U2.2, R17=100kΩ кGND. У TI предел MODE6V относительноGND не зависит в таблице отVIN, поэтому USB3,3V приBAT0 **не признаны доказанным превышением absolute rating**. Явной гарантии Ioff для отключённого MODE не найдено: остаточную инжекцию следует измерить. BAT→R27=2,2MΩ→BAT_ADC→M1.8 также остаётся приSYSoff; верхняя оценка ограниченного входного тока отBAT4V менее1,82µA. Это не силовой медный обход LC, но нулевое обратное питание всей системы не доказано.

**Минимальное предложение:** идентифицировать и квалифицировать реальный модифицированный клон/USB-LDO; если бюджет не проходит, отдельный рассчитанный USB-источник/разделение источников. **Приёмка:** J11open, USB приBAT/solar present/absent; VCC M1.9 и M2.3 под TX+GPS, ток USB, температура LDO; BAT_SYS/FILTER_OUT и MODE при выключенном BAT; обратный ток вUSB при батарейном питании. Приёмочные пределы по выбранному LDO/модулям, не по неизвестному аналогу NiceNano.

## E05 — переходные процессы и эффективная ёмкость фильтра не квалифицированы

**Критичность: высокая по возможному сбою основной функции; статус: обоснованный риск, не доказанная неустойчивость TPS.** `Converter.kicad_sch`: U2.6 SYS_PRE, C14 строка19830 до фильтра, R55=47mΩ→L3 строка13362→FILTER_MID→L4 строка21887→FILTER_OUT. Каждая банка десять TDK100µF; ветви R40/R41=22mΩ последовательно с банками, а не со всей нагрузкой. FB U2.4 снимается с SYS_PRE: удалённая просадка LC/разъёмов не компенсируется обратной связью.

Для [TDK C4532X5R1A107M280KC](https://product.tdk.com/en/search/capacitor/ceramic/mlcc/info?part_no=C4532X5R1A107M280KC) подтверждены100µF±20%,10V,X5R,−55…85°C; производитель помечает характеристические кривые как справочные. CAD-требование≥330µF эффективной ёмкости банка при3,3V не подтверждается одним номиналом1000µF. При Ceff330…1000µF и L2,4µH одиночная частота `1/(2π√LC)` ≈5,66…3,25kHz. Для C14 нужно≥7µF, для локальных C12+C52≥4µF по TI; C52 реально установлен, это не DNP-резерв. Резервные C53/54/55 ничего не гарантируют до подбора MPN и монтажа.

Выполнен **линейный пассивный AC-расчёт**, 18 углов L3/L4±30%, C каждого банка330/1000µF, R55=47mΩ,R40/R41=22mΩ,DCR L=10,5mΩ,2001 частота10Hz…100kHz. Идеальный источник SYS_PRE; исключены TPS-loop, контакты/возврат, ESR/ESL и профиль нагрузки. На рассмотренных углах максимальный коэффициент передачи1,392 около2,606kHz и |Zout|0,150Ω около2,897kHz. Это показывает остаточный резонанс; не является предсказанием самовозбуждения преобразователя. DC-падение только заданных R55+двухDCR при0,5A —34mV; остальные проводники добавляются отдельно.

Рейтинги не выявили очевидного недопустимого номинального тока: [Coilcraft XGL4020-471MEC](https://www.coilcraft.com/getmedia/76c9c081-4945-4c85-9129-9356e1ad6734/xgl4020.pdf) имеет DCRmax5,1mΩ и10%-Isat6,1A; [Sumida CDRH127/LD](https://products.sumida.com/products/pdf/CDRH127LD_Ver2.0_E.pdf) уL3/L4 допускает2,4µH±30%, DCRmax10,5mΩ, уL1=100µH DCRmax151mΩ/Isat2,1A. При зарядном максимуме775,6mA, VIN24V, Vout≈4V, L1−20%,f240kHz грубая buck-оценка пульсаций174mApp даёт peak≈0,863A, ниже указанного Isat. Неизвестные Voc панели/выбросы и нагрев ограничивают итог: Q1 AOS AO3401A имеет |VDS|30V/|VGS|12V, CN вход≤28V, C8=35V; условие Voc≤24V вCAD не заменяет паспорт панели. X5R-банки нельзя эксплуатировать выше85°C температуры детали.

**Минимальное предложение:** подтвердить Ceff и реальный бюджет источника/модема; при провале подобрать ёмкости/демпфирование либо сократить импеданс, с повторной проверкой. **Приёмка:** BAT min/max каждого варианта, SOLAR off/on, MODE PFM/PWM, TX+GPS и ступени0…0,5A; одновременные осциллограммы SYS_PRE, FILTER_OUT, M1.9, M2.3 относительно местногоGND; запуск, снятие нагрузки, восстановление разряда; Ceff банка≥330µF при3,3V с требуемыми температурой/старением; Cin≥4µF,Cout≥7µF. Напряжения потребителей остаются в рекомендованных диапазонах, отсутствует устойчивое колебание/reset, температуры деталей в их пределах.

**Дополнение E05: восстановление после разряда и R71.** Нативный XML и площадки повторно проверены: R15.1 видит **BAT до R71**, а U2.10 получает **BAT_SYS после R71**. Поэтому шунт не создаёт прямой положительной обратной связи через EN. Его падение снижает VIN и увеличивает ток батареи; ESR ячейки/проводов до BAT непосредственно влияет на EN. Сам по себе R71 не доказывает циклический запуск.

В TI SLVSEU9D p6 §8.5 нет отдельной строки гарантированного EN-hysteresis: есть rising1,07/1,10/1,13V и falling0,97/1,00/1,03V. Номинальная разница0,10V даёт на BAT180,56mV дляNa и360,52mV дляLTO. Консервативная арифметика независимых границ `(1,07−1,03)×(1+Rt/Rb)` даёт72,16mV/144,00mV приR±0,1%; это производный диапазон, с одинаковой утечкой EN в обеих точках, без температурного рассогласования. Он не является отдельной строкой измеренного/нормированного TI-гистерезиса. При изменении входного тока EN добавляется `ΔI_EN×Rt` (до8mVNa/26mVLTO для изменения0,2µA).

При SYS-нагрузке0,5A выходная мощность1,65W. **Допущение**, не измеренный КПД:η=0,90. Простая оценка приBAT1,8V: `I≈1,65/(0,90×1,8)=1,0185A`, падениеR71≈102mV. Самосогласованный расчёт `I×(VBAT−I×0,1)=1,65/η` даёт1,0838A иVIN1,6916V; это относится к уже запущенному устройству с достаточно низким фактическим OFF, а не к обещанию запуска от1,8V. ПоTI p5 VIN должен быть **выше1,8V доPG**; p6 внутренние UVLO falling1,20…1,29V действуют после запуска приVOUT≥1,8V. Следовательно, штатное установившееся падениеR71 в этой оценке не достигает внутреннегоUVLO, но уменьшает пусковой запас.

Обоснованный сценарий повторного запуска: открытое напряжение Na-ячейки2,0V выше типовогоON1,9862V, её **условный** ESR0,2Ω, R71=0,1Ω, нагрузка1,65W/η. Из `I×[2,0−I×(0,2+0,1)]=1,8333W` получаетсяI1,0973A; BAT1,7805V ниже типовогоOFF1,8056V, VIN1,6708V. После выключения ток исчезает иBAT возвращается вышеON. Эти входы образуют возможный цикл EN; ESR0,2Ω не выдан за измерение или паспорт неизвестной ячейки. Для LTO приON≈3,9657V инулевомESR расчёт0,4678A/46,8mV падения шунта оставляет значительно больший запас; влияние разбаланса и холодногоESR остаётся отдельным условием.

Две банки суммарно≥660µF при3,3V требуют минимум `Q=CV=2,178mC`, `E=CV²/2=3,594mJ`, плюс локальные ёмкости. Например, попытка зарядить только эти банки за2ms приBAT≈1,986V/η0,9 требует около **1,01A дополнительного среднего** входного тока. Это условная энергетическая оценка, не фактический inrush: TI soft-start и LC могут удлинить заряд, а224µs изTI получены при другомVIN/нагрузке и не перенесены на эту схему. Колебательный запуск требует подтверждения настоящим профилем нагрузки и сопротивлением батареи.

Дополнить минимальное предложение E05: задать максимальный ESR ячейки/проводов и пусковой ток; если восстановление не проходит, уменьшить сопротивление входа/изменить шунт с новой калибровкой INA либо увеличить запас стартового порога/гистерезиса или вводить нагрузку позже. **Дополнительная приёмка:** эмулятор батареи с паспортным максимальнымESR, заряженными и разряженнымиLC-банками, J11 установлен; медленный подъём послеOFF, горячее подключение иTX/GPS-нагрузка. Одновременно измерять BAT наR15.1, BAT_SYS наU2.10, EN_UV наU2.1 иSYS_PRE. При квалифицированном напряжении восстановления устройство однократно запускается, VIN>1,8V доPG, затем удерживает напряжения модулей и не повторяет циклыEN/UVLO/reset; после выхода изразряда восстанавливается безUSB или ручной перестановкиJ11. До определения допустимогоESR и реального профиля это риск, а не подтверждённый hiccup. Полные входы/результаты: `ELECTRICAL_RECOVERY.json`.

## Проверенное без отдельного замечания

INA219AIDR соответствует SOIC-8 распиновке:1/2 адресGND(0x40),3SDA,4SCL,5SYS,6GND,7IN−(BAT),8IN+(BAT_SYS); R72/R73=10Ω иC64=100nF дифференциально. Заряд положительный, разряд отрицательный; токи балансира проходят **мимо** R71. [TI INA219 SBOS448G](https://www.ti.com/lit/ds/symlink/ina219.pdf), p3/5/17–18 подтверждает распиновку, диапазоны и необходимость калибровки после старта. R71 [RL2512FK-070R1L](https://www.yageogroup.com/component-documentation/download/specsheet/RL2512FK-070R1L) —0,1Ω±1%,1W,±600ppm/°C: при1,25A125mV/156mW; при4A1,6W уже выше1W. Без собственной температурной калибровки вклад шунта в ошибку до~4,9% приΔT65°C, без ошибки INA/пайки. Поэтому2% точности нельзя предполагать; требования точности вТЗ нет.

BAT_ADC R27/R28 по2,2MΩ, C25=100nF: Rth=1,1MΩ,τ110ms, установление1%≈507ms,0,1%≈760ms. Статическая ошибка от утечки `ΔVADC=Ileak×1,1MΩ`, на пересчитанномBAT вдвое больше. C25 помогает выборке ADC, но не устраняет DC-утечку. Конкретный клон/ADC/калибровка не проверены; это включить в программно-аппаратную квалификацию, не объявлять доказанным отказом ADC.

Только CR2032 сохраняетRTC; при отсутствии USB и основного источника SYS не питается от неё. Главный ток питания иGND проходят электрические межплатные контакты, стойки не обязательны для замыкания цепи.

## Статус готовности в пределах этого участка

Внутренняя нативная связность и критические распиновки подтверждены; явного медного обходаJ11 нет. Электрически пригодность **к изготовлению опытных плат** не равна готовности изделия: необходимо закрыть выбранные ячейки/панель и ограниченияE01/E02, либо явно ограничить лабораторную программу. Сборку с реальными батареями и неизвестным модифицированным клоном безE03/E04 нельзя подтвердить безопасной. Для первого включения пригоден поэтапный стенд с ограниченным источником/эмулятором батареи и предварительным контролем полярности; безусловная готовность к первому включению от LTO/солнца не подтверждена.

Источник истории принятого ограничения: `audit/fixes_2026_10_12/user_decision.json`. Сам факт ограничения заново проверен по нынешним CAD и первичным данным выше.
