Alksndr55/mesh-repeater-2.0/audit/a3_2026_10_13/independent/INDEPENDENT_PLAN_RU.md

# Независимая проверка A3

Проверка проводится после сообщения ALL_CAD_FROZEN. Черновые отчёты авторов разводки не являются основанием для PASS.

- Нативные POWER / LOGIC / SHIELD, схемы, модели и проектные правила фиксируются SHA-256 до и после проверки.
- Свежие KiCad DRC со всеми предупреждениями, исключениями, refill и schematic parity; без сохранения платы. Свежие ERC и XML netlist обеих схем.
- Сопоставление групп соединённых выводов XML с фактическими net codes площадок. Отдельно проверяются J11, NT2, ветви SYS/RADIO, два контакта каждой линии питания, три GND, NC8 и питание только модема за FB1.
- Исходный электрический контракт S4.16 и разрешённая вставка INA219 сохраняют GPIO Nice!Nano, ISP J10, номиналы и варианты сборки; шесть силовых резисторов действительно имеют площадки 2512.
- Все компоненты POWER находятся на F.Cu, LED расположены между краем и J101, TP1 / TP6 / TP9 находятся в одном ряду у края. Длины их медных подключений измеряются по реальной трассе.
- Фактическая маркировка рядом со своим компонентом / точно в центре его корпуса на обратной стороне; ось текста совпадает с осью корпуса, отсутствуют Gxx x1.5. Геометрия рамок опций одинакова на F/B.
- Окно экрана проверяется непосредственно по Edge.Cuts футпринта, отверстия для 12 отдельных штырей отсутствуют; реальные центры и пластмассовый габарит разъёма проходят через окно. Единственная область фольги не разрывается.
- Размеры экрана, материал, предупреждение J11/USB и распиновки читаются непосредственно из нативной шелкографии; документированная высота стоек не меняется.

Вывод касается согласованных изменений A3 и нативной конструкции. Проверка номинального габарита пластика не подменяет примерку конкретных разъёмов; измерение EMI/просадки питания и принятые ограничения LTO остаются отдельными условиями проекта.
