Alksndr55/mesh-repeater-2.0/output/V2_OVERVIEW_RU.html

# Mesh Repeater 2.0 A5 · исправление трассировки

22 октября 2026 · основные проекты POWER и LOGIC · платы 90×60 мм

Исправления внесены в исходные файлы KiCad. Убраны перекрывающиеся сегменты и лишние земляные связи поверх заливки; мешавшие трассам переходы GND перенесены или удалены. Маршруты выпрямлены. Схема, номиналы, положения компонентов, GPIO, межплатные соединения и ISP J10 сохранены.

Повторные native DRC после перезаливки: 0 нарушений, 0 неразведённых цепей, 0 расхождений со схемой. ERC обеих схем: 0 нарушений. Независимая геометрическая проверка не нашла дублирующихся и частично перекрывающихся сегментов. Земля каждой платы остаётся единой связной сетью через оба слоя; ширины дорожек не уменьшены.

Производственные архивы A4-FAB2 от 16.10.2026 относятся к прежней разводке. После этих изменений их нужно пересоздать перед новым заказом. Они сохранены как предыдущий снимок. Перед USB по-прежнему необходимо снять J11 на POWER.

## Измеренное сравнение

Плата | Параметр | До | После
POWER | Сегменты дорожек | 803 | 757
POWER | Длина дорожек без GND, мм | 1487.52 | 1464.28
POWER | Длина явных дорожек GND, мм | 209.95 | 144.36
POWER | Все переходные отверстия | 508 | 506
POWER | Перекрывающиеся пары сегментов | 9 | 0
POWER | Повороты 90° без GND (узлы с двумя сегментами) | 15 | 11
LOGIC | Сегменты дорожек | 603 | 575
LOGIC | Длина дорожек без GND, мм | 1804.19 | 1801.86
LOGIC | Длина явных дорожек GND, мм | 43.91 | 30.36
LOGIC | Все переходные отверстия | 520 | 520
LOGIC | Перекрывающиеся пары сегментов | 4 | 0
LOGIC | Повороты 90° без GND (узлы с двумя сегментами) | 21 | 19

Длина без GND приведена отдельно: удаление дорожек поверх земляной заливки не выдается за сокращение сигнальных маршрутов. Повороты подсчитаны в узлах с двумя сегментами одной цепи и слоя; площадки и ответвления не входят в этот счёт.

## Дорожки до и после

Переключатели показывают экспорт KiCad из копий с отключённой заливкой, чтобы были видны сами дорожки и переходы. Эти иллюстрации не предназначены для изготовления. По ссылке под каждым видом доступна фактическая медь с заливкой.

POWER — лицевая сторона

ДоПослеПосле

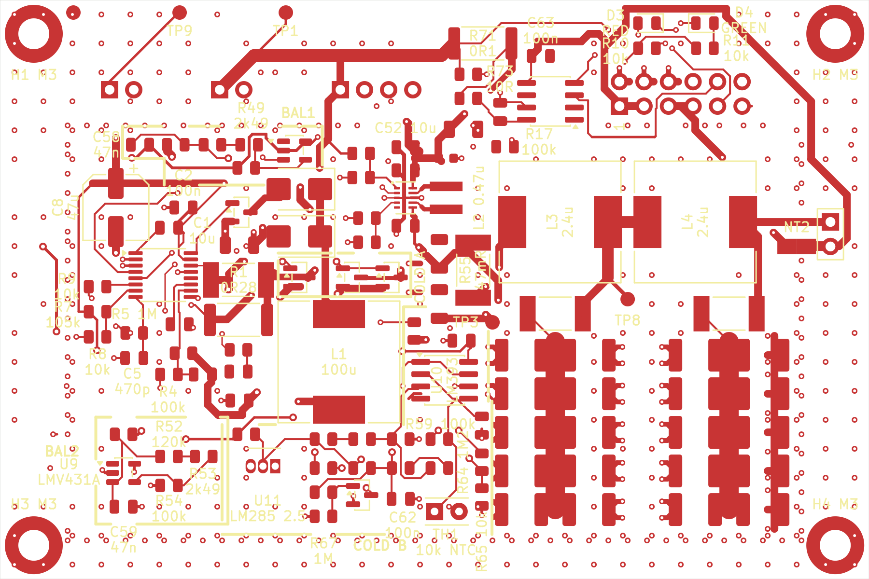
[picture p7: audit/routing_cleanup_2026_10_22/views/after/POWER/POWER_routes_front.png]
POWER: дорожки лицевая сторона


Фактическая медь с заливкой

POWER — обратная сторона

ДоПослеПосле

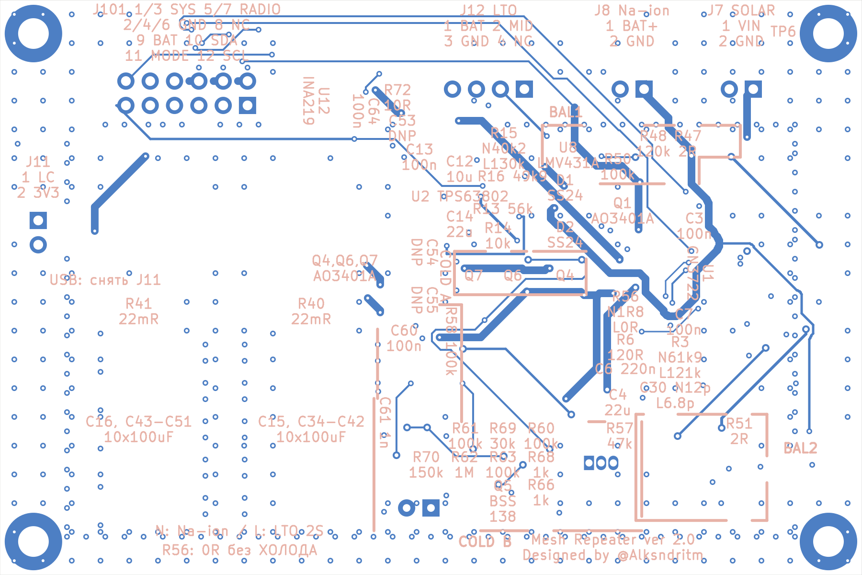
[picture p8: audit/routing_cleanup_2026_10_22/views/after/POWER/POWER_routes_back.png]
POWER: дорожки обратная сторона


Фактическая медь с заливкой

LOGIC — лицевая сторона

ДоПослеПосле

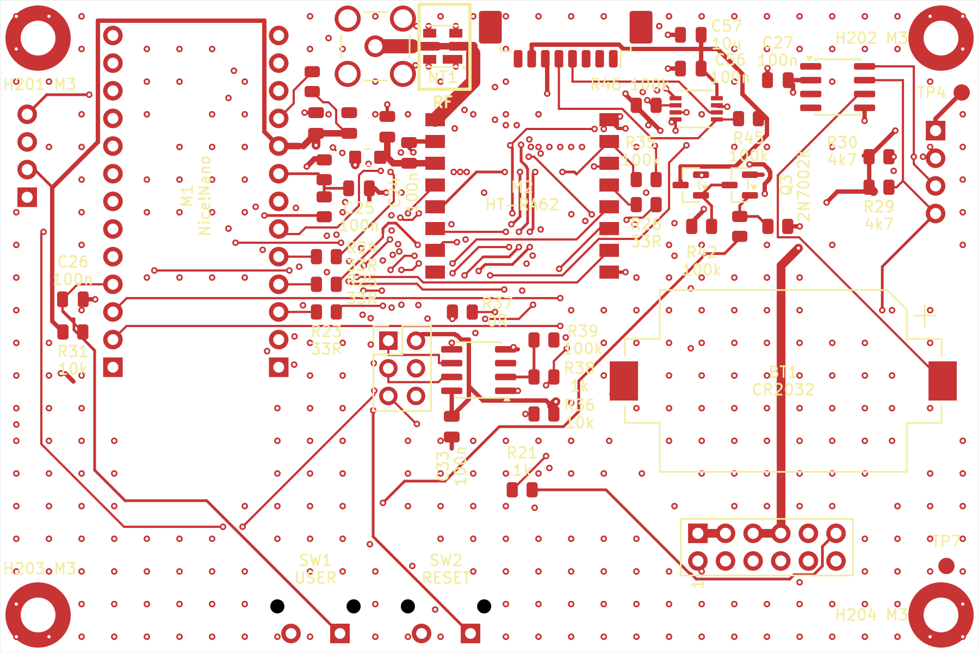
[picture p9: audit/routing_cleanup_2026_10_22/views/after/LOGIC/LOGIC_routes_front.png]
LOGIC: дорожки лицевая сторона


Фактическая медь с заливкой

LOGIC — обратная сторона

ДоПослеПосле

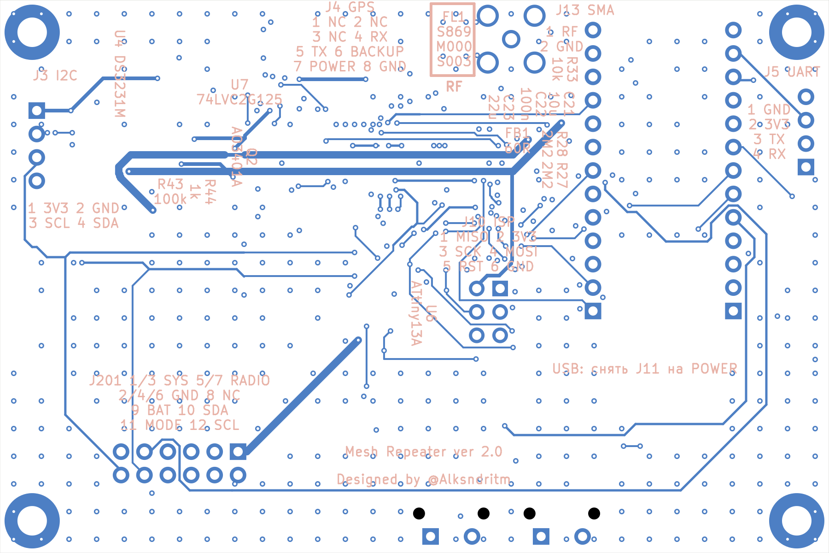
[picture p10: audit/routing_cleanup_2026_10_22/views/after/LOGIC/LOGIC_routes_back.png]
LOGIC: дорожки обратная сторона


Фактическая медь с заливкой

## Границы проверки

Проверена геометрия сохранённых файлов, электрическая связность и соответствие схеме. Короткие локальные земляные возвраты у преобразователей и развязывающих конденсаторов, Kelvin-подводы INA219 и RF-участок сохранены. Измерение помех, нагрева и стабильности на собранной плате в эту проверку не входит.

SHA256 текущих плат

POWER
458a411eb25d42cc0b6395fb01c80aefa79b1fcdedcfea174da56f8f893665a2

LOGIC
c3cea91efff79b5f737a00ea3b0976ceff944b20178516770259ff7276353d8a

Designed by @Alksndritm. Собственные материалы — CC BY-NC-SA 4.0. Личный заказ плат у изготовителя разрешён; коммерческий выпуск и продажа требуют письменного разрешения автора. Сторонние лицензии сохранены.
