Alksndr55/mesh-repeater-2.0/design/MeshRepeater2_Power/3dmodels/README_RU.txt

Mesh Repeater 2.0 — локальные 3D-модели

Модели подключены относительными путями из сохранённой платы KiCad.
Стандартные модели используют KICAD10_3DMODEL_DIR. Источники унаследованных
моделей: ../../../THIRD_PARTY_NOTICES.md; прежний asset_manifest относится
к историческому снимку, ссылка на него приведена в этих уведомлениях.
Собственные модели — CC BY-NC-SA 4.0 в пределах прав автора;
модели KiCad и другие сторонние материалы сохраняют свои лицензии.
Полные условия: ../../../LICENSE.md и ../../../docs/LICENSING_RU_EN.md.
Документированные новые разъёмы и кнопки проверены в
 docs/mechanical_library_checks.json и docs/mechanical_model_checks.json.

NiceNano_Clone_Approx, Heltec_HT_RA62_Approx, SMA и некоторые другие
унаследованные модели приближённые. Они показывают компоновку; точную
посадку конкретных закупленных модулей проверяют по образцу.

POWER обращена компонентами вверх. LOGIC повёрнута на 180 градусов
вокруг X, компонентами вниз. Средний экран отдельный, 90×60 мм.
Рамка SH1 и старая крышка сняты. Унаследованные Shield_Frame и Shield_Lid
STEP могут оставаться в каталоге, но не установлены в V2 и не закупаются.
TH1 формуют по текущей инструкции, без привязки к прежней крышке.

C12/C52 устанавливаются; C53/C54/C55 — резерв, штатно пустой.
Видимость в 3D не определяет комплектность. Используйте Fit_NaIon,
Fit_NaIon_NoCold или Fit_LTO_2S и Value_*/MPN_* в таблице вариантов.
FL1 штатно не устанавливается; перед монтажом SAW разрезать NT1.
J11 показан для батареи/солнца; снять ДО USB.

Актуальные сборочные виды: docs/mechanics. Размеры и ограничения:
docs/mechanical_selection.json, docs/V2_LIMITATIONS_RU.md.
Модели не являются заводскими чертежами для заказа или результатом
механической, тепловой либо электрической квалификации.
