Alksndr55/mesh-repeater-2.0/docs/mechanics_findings_RU.md

# Механика и новые детали Mesh Repeater 2.0

> Исторический материал исходного разбиения A1. Текущая A3, перенос J11 на POWER, карта SYS/RADIO и окно экрана описаны в [инструкции A3](V2_ASSEMBLY_INSTRUCTIONS_RU.md) и [проверках A3](NATIVE_BOARD_CHECK_RU.md). Старые кабельные/питающие решения ниже не являются инструкцией для новой платы.

Основной подбор выполнен 11 октября 2026 года. После независимого аудита 12 октября добавлены кабельные части J3/J5 и исправлен наружный размер скобы SW1/SW2. Это перечень выбранных деталей и размерная основа для компоновки. Посадочные места проверены загрузкой в KiCad 10, STEP — FreeCAD. Проверка посадки реальных закупленных деталей пока не выполнена.

Размер всех трёх плат — 90×60 мм. Функциональные платы двухслойные, номинальная толщина FR4 — 1,5 мм; расчёт сборки использует текущую толщину модели 1,52 мм. Нижняя POWER обращена компонентами вверх. Верхняя LOGIC при сборке поворачивается на 180° вокруг оси X и обращена компонентами вниз. Внешняя сторона LOGIC соответствует её B.SilkS. Медь промежуточного экрана направлена вниз. Фольга остаётся сплошной, надписи выполняются краской/шелкографией.

Для экрана согласован явный стек: F.Mask 0,010 мм, F.Cu 0,035 мм, FR4 core 1,475 мм, B.Cu и B.Mask 0 мм. На обороте памятка печатается по стеклотекстолиту. KiCad сохраняет контейнер двух медных слоёв, однако физическое производство экрана одностороннее. Номинальный итог 1,52 мм; STEP не содержит маску и показывает core+foil 1,51 мм. В сборочной геометрии нижний контакт экрана привязан к наружной F.Cu. Отсутствующие в STEP 0,01 мм маски и реальные толщины в местах зажима учитываются входным контролем, а номинальная размерная цепочка не выдается за измерение реального зажима.

## Выбранные детали из ДАН

Остатки ниже получены из прямых карточек магазина. Они не резервируют товар и могут измениться. Полный список с URL, количеством на одну сборку, документацией и деталями для другого магазина находится в [DAN_NEW_PARTS.csv](../bom/DAN_NEW_PARTS.csv).

| Узел | Деталь | Код ДАН | Остаток при проверке | Основание посадки |
|---|---|---:|---:|---|
| J7 SOLAR, J8 BAT | JST S2B-XH-A(LF)(SN), угловой 2-контактный | 167075 | 47 шт. | Чертёж JST, шаг 2,50 мм |
| J12 LTO | KLS L-KLS1-2.50-04-R, угловой 4-контактный | 38160 | 70 шт. | Чертёж KLS, страница 6 |
| J101/J201 между платами | Connfly DS1013-12RSIB-B-0, угловой IDC 2×6 | 134861 | 21 шт. | Чертёж Connfly DS1013 |
| Два конца кабеля | Connfly DS1016-12MA2BB, IDC с ключом и фиксацией шлейфа | 195394 | 230 шт. | Чертёж Connfly DS1016 |
| Шлейф | Connfly DS1057-16A282R-30.5, 16 жил, AWG28 | 200351 | 72 м | Чертёж Connfly DS1057; отделить 12 жил |
| J11, J3, J5 | Connfly DS1022-1x40RUF11-B | 202688 | 470 шт. | Один ряд разрезать на 2+4+4 контакта |
| Кабельные корпуса J3/J5, 2 шт. | Connfly I-DS1071-SCB01x4, без контактов | 208362 | 170 шт., 12.10.2026 | Официальный DS1071 указывает совместимые вилки DS1021/DS1022 |
| Гнездовые контакты J3/J5, 8 шт. | Connfly T-DS1071-SC600 | 201995 | 6746 шт., 12.10.2026 | Родные контакты DS1071; AWG28–22, изоляция Ø1,2–1,6 мм |
| Съёмная перемычка J11 | Connfly DS1027-2BBN1, 6,5 мм | 128935 | 724 шт. | Семейство DS1027, шаг 2,54 мм |
| SW1/SW2 | TE 1825027-2 / FSMRA1JH04 | 199312 | 127 шт. | Чертёж TE и карточка производителя |
| Нижние стойки | RUICHI PCHSN-18, M3, латунь | 206757 | 52 шт. | Семейный чертёж с отдельной строкой PCHSN-18 |
| Верхние стойки | Connfly H-L1500-2100-5-03-1N1W, M3, 15 мм | 188548 | 168 шт. | Чертёж Connfly: медный сплав, никелевое покрытие |
| Корпус штекера J12 | KLS L-KLS1-2.50-04-H | 205451 | 413 шт. | Та же серия KLS |
| Контакты J12 | KLS KLS1-2.50-T | 203367 | 5490 шт. | Та же серия KLS |
| Контакты J7/J8 | JST SXH-001T-P0.6 | 204874 | 150 шт. | Родные контакты JST, AWG28…22 |

J12 становится четырёхконтактным: позиции 1…3 сохраняют прежние PACK+, MID, GND, позиция 4 остаётся NC и не заполняется в кабеле. Это механическая замена корпуса с соответствующим новым кабельным штекером. Существующий трёхконтактный штекер нельзя считать правильной ответной частью.

Для SW нужно заказывать именно TE 1825027-2. В карточке магазина приведены также альтернативные наименования KAN; одинаковое название функции не доказывает совпадение всех размеров.

После M-02 обе локальные модели кнопки имеют наружную ширину скобы **8,41 мм** по TE, вместо 7,66 мм. Courtyard, электрические и крепёжные отверстия сохранены. Свежие отчёты моделей и посадок включают пути, SHA256 и дату проверки; прежние отчёты сохранены в `audit/fixes_2026_10_12/`.

Корпуса J3/J5 применяются ко всем трём вариантам. Разъёмы без ключа и имеют различный порядок питания: J3 — 3V3, GND, SCL, SDA; J5 — GND, 3V3, TX, RX. Для каждого кабеля первый контакт помечают и проверяют по плате. Размерная оценка корпуса с допусками и зазорами до стоек находится в `audit/fixes_2026_10_12/mechanics.models.json`; глубину реального сопряжения и удержание кабеля проверяют на образце.

## Что покупать в другом месте

Родные корпуса JST XHP-2 для J7/J8 найдены у [TMElectronics](https://tmelectronics.ru/product/XHP-2/) и [LCSC, C144401](https://lcsc.com/product-detail/Rectangular-Connectors-Housings_JST-Sales-America_XHP-2_JST-Sales-America-XHP-2_C144401.html). Доступность по поисковому индексу есть, но прямую карточку TMElectronics прочитать не удалось из-за 403. Поэтому живой остаток в BOM не заявлен. ДАН продаёт двухконтактные корпуса Connfly, но межфирменное сопряжение с JST не подтверждено производителем; такой вариант потребует проверки образца.

Необходимы 20 металлических уменьшенных шайб DIN433 3,2×6×0,5 мм. Их [карточка производителя — Завод Купцова](https://www.kuptsov-zavod.ru/catalog/shayby-umenshennye/shayba-umenshennaya-otsinkovannaya-m3-din-433/) подтверждает эти размеры и показывает наличие. ДАН предлагает металлические DIN125A M3 с наружным диаметром 7 мм; замена выбранных Ø6-мм шайб требует новой проверки места крепежа и резьбовой размерной цепочки. Пластиковые шайбы в цепи подключения экрана не используются.

Нужны четыре нижние [гайки M3 DIN934](https://darxton.ru/catalog_item/gayka-m3-a2-din-934/) и четыре верхние [стальные винта M3×6 DIN7985](https://www.vseinstrumenti.ru/product/vint-strojmetiz-m3h6-din-7985-polukruglaya-golovka-tsink-up-40-sht-3100821-1527042/). Верхний винт выбирается по фактической доступной глубине внутренней резьбы стойки. Длинный M3×25 из ДАН вместо него ставить нельзя.

## Монтажная цепочка и высота

Отверстия на всех платах: (3,5;3,5), (86,5;3,5), (3,5;56,5), (86,5;56,5), диаметр 3,2 мм. Открытая контактная площадка GND вокруг отверстия — Ø6 мм с обеих сторон функциональных плат и на медной стороне экрана. Другие сети в области металлического крепежа недопустимы.

На каждом углу сборка снизу вверх:

1. Гайка M3, металлическая шайба 0,5 мм, POWER 1,52 мм.
2. Нижняя стойка 18 мм непосредственно на открытой GND-площадке POWER. Дополнительная шайба здесь не ставится: нижняя шпилька RUICHI имеет в семейном чертеже приблизительно 5 мм длины.
3. Металлическая шайба 0,5 мм, экран 1,52 мм, металлическая шайба 0,5 мм.
4. Верхняя стойка 15 мм. Её шпилька 6 мм проходит сквозь экран и входит во внутреннюю резьбу нижней стойки.
5. Металлическая шайба 0,5 мм, LOGIC 1,52 мм, металлическая шайба 0,5 мм, винт M3×6.

Получаются **номинальные зазоры 18,5 мм POWER–экран и 16 мм экран–LOGIC**. Расстояние между внешними поверхностями самих PCB — **39,06 мм**. Цепочка от нижней поверхности гайки 2,4 мм до верха головки винта 2,52 мм равна 44,98 мм. Полный габарит текущей STEP-сборки — **45,56 мм по высоте**: нижняя шпилька выступает ещё на 0,58 мм ниже гайки. Эти числа относятся к номинальной CAD-геометрии, а не к измеренному собранному устройству.

Номинальное зацепление верхней шпильки и верхнего винта — 3,48 мм; под нижнюю гайку остаётся 2,98 мм резьбы. По фактическим размерам необходимо подтвердить зацепление не менее 3 мм в верхних резьбовых соединениях, полное зацепление нижней гайки и отсутствие упора винта/шпильки в дно отверстия. Глубина пригодной внутренней резьбы верхней Connfly в чертеже не указана. У RUICHI размеры шпильки, отверстия и шестигранника отмечены знаком ≈. Эти поля честно остаются входным контролем; готовность резьбового соединения не доказана.

У ДАН обнаружены неправильные вложения: карточки стоек 18 мм Connfly **211930 и 209575** названы M3, но их приложенные PDF показывают M4. Эти PDF не использовались как доказательство геометрии M3.

Рамка SH1 удалена по результатам независимого аудита крепежа. Сохраняется непрерывный средний экран 90×60 мм, стойки 18/15 мм и металлические контакты его заземления. Это устраняет конфликт старой рамки с механическими местами стоек. Шестигранники имеют размер 5,5 мм между гранями и окружность по углам около 6,35 мм; четыре отверстия и места контакта остаются без изменений.

## Межплатный кабель

| Контакты | Сеть |
|---|---|
| 1, 3, 5, 7 | FILTER_OUT |
| 2, 4, 6, 8, 10, 12 | GND |
| 9 | BAT, только измерительный вход верхнего делителя |
| 11 | MODE от верхней части к TPS63802 |

SYS_3V3 в кабель не выводится: её перенос обошёл бы съёмную перемычку J11.

Оба разъёма в физической сборке смотрят наружу к северной стороне. После переворота LOGIC контакт 1 оказывается на противоположной стороне ряда по X. Для кабеля с одинаковой нумерацией **1→1…12→12** нужен правильный поворот ответных частей и полуоборот ленты либо отдельная сборка проводов. Совпадение ключей само по себе не доказывает правильность распиновки. Перед первым включением прозванивается каждая жила и отсутствие замыкания BAT с FILTER_OUT/MODE/GND.

После проверки крепежа IDC смещены влево: первый контакт J101 POWER — (64,15;11,00), угол 90°; J201 LOGIC — (76,85;49,00), угол 270° в native KiCad. Физический центр обоих корпусов по X — 70,50 мм, границы корпуса в собранном виде X=59,08…81,92, Y=−2,80…6,00 мм. До ближайшей Ø6-мм шайбы получается 1,58 мм по X; до окружности углов M3 шестигранника — около 1,405 мм. Поэтому сборка больше не зависит от выставления определённого угла стойки.

Шлейф проходит за северной кромкой экрана, проектная внешняя петля — ориентировочно Y≤−23 мм, с запасом длины около 120 мм и целевым радиусом изгиба не менее 5 мм. Радиус и длина — проектные параметры обслуживания, а не гарантированный производителем минимальный радиус. Размер 13,3 мм в чертеже DS1016 относится к отдельной детали Top cover; окончательный размер собранной ответной розетки и глубина её вставки не обозначены. Поэтому ни наружный габарит кабеля, ни отсутствие натяжения не выдаются за законченную механическую проверку.

Полный габарит текущих плат и крепежа в STEP **без кабеля — 98,00×70,01×45,56 мм**. Он больше PCB 90×60 мм из-за выступающих боковых разъёмов и нижней шпильки. Проектная петля Y≤−23 мм вместе с южным разъёмом до physical Y=67,21 мм увеличивает предполагаемый размер вдоль Y минимум примерно до **90,21 мм**. Оценка 83 мм учитывала бы только длину самой PCB и скрыла выступ южного разъёма. Это оценка для предварительного размещения, без гарантии габарита ответных IDC, полуоборота, запаса и фиксации настоящего кабеля.

У выбранного [Connfly DS1057](https://en.connfly.com/static/upload/file/pdf/DS1057.pdf) AWG28, 7×0,127 мм, максимальное сопротивление жилы 0,237 Ом/м при 20°C. Для 120 мм и равномерного распределения 0,5 А между четырьмя питающими и шестью возвратными жилами падение только в проводах составляет около 5,9 мВ. Контактное сопротивление, неравномерность распределения и пусковые импульсы в этот расчёт не входят. ДАН указывает для выбранных IDC 1 А на контакт; количество параллельных контактов не является самостоятельным доказательством тока всей сборки.

Паспортный диапазон шлейфа — **−20…+70°C**. Эксплуатация ниже −20°C требует другого кабеля с подтверждённым температурным диапазоном. Наличие опции снижения зарядного тока на морозе не расширяет паспорт самого кабеля.

## Что остаётся проверить

Окончательная механическая проверка использует реальные STEP экспортированных PCB и фактические закупленные детали. Размеры Nice!Nano-клона и его Type-C по ссылке не документированы: иллюстративная прежняя модель не подтверждает посадку настоящего модуля. Нужно измерить его ножки, высоту корпуса, Type-C и доступ для кабеля. Отдельно проверяются антенная зона, промежуточный экран, доступ к J11 и всем боковым разъёмам. ISP остаётся в исходном месте и обслуживается после разборки.

Размерная основа выше перенесена в [mechanical_selection.json](mechanical_selection.json). Скрипт [build_v2_mechanical_library.py](../tools/cad/build_v2_mechanical_library.py) воспроизводит новые посадки и упрощённые размерные модели; старые платы и схемы он не изменяет. Проверки библиотеки сохранены в mechanical_library_checks.json и mechanical_model_checks.json. [Размерный сборочный чертёж](mechanics/MeshRepeater2_stack_dimensions.svg) показывает номинальную цепочку крепежа и ориентацию всех трёх плат.

## Проверка окончательной CAD-сборки

В [assembly_geometry_report.json](mechanics/assembly_geometry_report.json) записаны SHA исходных STEP и соответствующих native PCB. Экспортные manifests сверены с файлами платы. После привязки к наружным плоскостям платы и фольге экрана измеренные по моделям минимальные вертикальные зазоры составляют **5,960 мм POWER–экран** и **5,270 мм LOGIC–экран**. Взаимных пересечений трёх плат нет. До описанной окружности M3 шестигранника в худшей ориентации от корпуса IDC остаётся не менее **1,4046 мм**. Это проверка номинальных моделей; контактные плоскости и внутренняя резьба в этот тест не входят.

Сохранены [собранный STEP в gzip](mechanics/MeshRepeater2_assembly.step.gz), [разнесённый STEP в gzip](mechanics/MeshRepeater2_exploded.step.gz), [собранный вид](mechanics/MeshRepeater2_assembly_native_3D.png), [разнесённый вид](mechanics/MeshRepeater2_exploded_native_3D.png) и [вид снизу](mechanics/MeshRepeater2_exploded_below_native_3D.png). STEP.gz распаковывается в исходный STEP; оригиналы оставлены локально. PNG построены из тесселяции этих CAD-моделей, цвета условные. STEP не содержит маску и шелкографию; наружные подписи проверяются по отдельным operator-view проекциям native PCB. Ответные IDC, внешний кабель и профиль резьбы намеренно не выданы за точную модель. Размерный PDF находится в [output/pdf/MeshRepeater2_assembly_dimensions.pdf](../output/pdf/MeshRepeater2_assembly_dimensions.pdf).
