Alksndr55/mesh-repeater-2.0/audit/a3_2026_10_13/mechanics/RESEARCH_RU.md

# Экран A3: проход межплатного разъёма

Проверено 13 октября 2026. На этом этапе изменения CAD не вносились.

У выбранных штырей E-SIMPO L35/A3C6 общая верхняя пластиковая планка находится на высоте 23,5–26 мм над лицевой поверхностью POWER. Экран расположен на 18,5–20,02 мм. В окончательно собранном узле пластик и экран не пересекаются: номинальный осевой зазор 3,48 мм. Проблема возникает именно при сборке: экран, опускаемый сверху, должен пройти через общую пластиковую планку, а двенадцать отдельных отверстий позволяют пройти лишь отдельным штырям.

Предложение — одно замкнутое фрезерованное окно с углами R0,6. Не требуется менять высоту стоек, розетку или положение ISP.

| Величина | Значение, мм |
|---|---:|
| Центр окна SHIELD, native | X 70,50; Y 50,27 |
| Центр в физических координатах POWER | X 70,50; Y 9,73 |
| Размер окна | 17,20 × 6,80 |
| Границы SHIELD, native | X 61,90…79,10; Y 46,87…53,67 |
| Углы | R 0,60 |
| Минимальный отступ меди от стенки | 0,50 |
| Номинальный существующий корпус | 15,64 × 5,00 |
| Номинальный запас по ширине/высоте | 0,78 / 0,90 на сторону |

Фрезерованное окно сохраняет непрерывную область фольги вокруг разъёма и не затрагивает четыре крепления M3. Отдельные NPTH и прежние перемычки FR4 между ними удаляются.

Размер 15,64 × 5,00 мм взят из имеющейся модели разъёма и номинального габарита розетки. На чертеже выбранного универсального штекера максимальные размеры пластикового корпуса не нормированы. Поэтому окно рассчитано с запасом, но до изготовления необходима проверка фактического образца: пластиковая планка должна свободно проходить через окно при штатном совмещении плат. Допуск фрезеровки и совмещения плат не является известным паспортным допуском разъёма.

Нативные исходники и предыдущие размеры зафиксированы в `prechange_geometry.json`. Рекомендуемые координаты сохраняются, если POWER J101 не переносится. Если он будет сдвинут при компоновке, центр окна определяется по среднему центру двенадцати площадок J101 и преобразованию Yshield = 60 − Ypower.

Исходники: `docs/vertical_interconnect_selection.json`, `docs/mechanics/assembly_geometry_report.json`, `audit/vertical_interconnect_2026_10_12/ali_pair_geometry.json`, сохранённые изображения чертежей продавцов и локальные STEP-модели.
