Alksndr55/mesh-repeater-2.0/docs/V2_LIMITATIONS_RU.md

# Mesh Repeater 2.0 — ограничения и статус проверки

Редакция документа: **V2.0-A5, 22 октября 2026 года**. Исправления трассировки POWER/LOGIC внесены в основной CAD после независимого аудита; схема и принятые аппаратные ограничения сохранены. Свежие [проверки основных файлов](../audit/routing_cleanup_2026_10_22/after/native_summary.json): DRC всех трёх плат — 0 нарушений/неразведённых/исключённых; ERC обеих схем — 0; POWER/LOGIC — 0 расхождений со схемой. [Отчёт трассировки](../output/V2_ROUTING_CLEANUP_2026_10_22_RU.html) отделяет исправленные геометрические недостатки от будущих испытаний образца. [Условия использования материалов](LICENSING_RU_EN.md).

Сохранённые результаты снимка A3: схемный граф 81/81, парность PCB/model/XML 57/57, независимый аудит 110/110, ERC обеих схем — 0. Эти прежние результаты и геометрия сборки относятся к входным SHA256 A3 и не заменяют новые проверки A5, перечисленные выше. База — опубликованная S4.16: SHA `cf54f9970e716272d477afdb252b4e195d595cb6`, [тег v1.0](https://github.com/Alksndr55/mesh-repeater/tree/v1.0), [релиз v1.0](https://github.com/Alksndr55/mesh-repeater/releases/tag/v1.0). Версия 2.0 находится в самостоятельном репозитории `Alksndr55/mesh-repeater-2.0`, ветка `main`.

Этот документ сохраняет ограничения исходного устройства и отделяет их от новых CAD-проверок. Сохранение схемотехники при разделении на два этажа не подтверждает автоматически сопряжение новых разъёмов, зазоры, нагрев, EMI или работу конкретных модулей.

## Проверенная исходная основа

Контракт исходного разбиения сопоставлен с S4.16: 167 позиций модели/нативной схемы/CSV, 86 функциональных сетей, 16 намеренно неподключённых выводов. По принятой исходной плате проверены 443 физических площадки, включая 439 уникальных пар reference/pin. Расхождений не выявлено. Источник этих чисел — `audit/v2_electrical_contract_baseline.json`; это проверка базы и предлагаемого распределения, не финальная проверка разводки 2.0.

Исходная плата имеет SHA256 `742ae27bb1d13893f6dc368e5c67f5c41b35a3e6765331fc7e9871297d23dec6`. Замороженные файлы сохранены локально в `baseline/S4_16` и в теге Git `v2.0-a3`; их старые ERC/DRC и изображения подтверждают только 1.0/S4.16. Результаты новых схем и плат должны ссылаться на собственные сохранённые файлы и контрольные суммы.

Одна исходная механическая позиция SH1 намеренно удалена в 2.0 по независимой размерной проверке. Поэтому итоговый состав должен учитывать 166 сохранённых исходных позиций и отдельно одну документированную удалённую рамку. Это не основание менять функциональные сети или номиналы; эквивалентность функциональных выводов проверяют отдельно. Решение C и отклонённые варианты описаны в `audit/v2_frame_mount_review.json`.

## Принятые условия, которые сохраняются

- Nice!Nano остаётся выбранным клоном с аппаратной доработкой для прямого питания 3V3/VCC и отключения штатной USB-зарядки. Автоматическое переключение источников не добавлено.
- J11 — единственное съёмное соединение FILTER_OUT–SYS_3V3. Шунт снимают до USB и возвращают после его отключения. В A3 J11 находится на POWER; SYS возвращается при USB по контактам 1/3 к INA219/C63 и звезде NT2, которая также питает RADIO по контактам 5/7. Обхода J11 или питания TPS63802 этой сетью нет.
- По уточнению пользователя J10 сохраняет исходную посадку S4.16. Доступ к ISP — после разборки; это выбранный порядок обслуживания.
- R47/R51 балансира остаются 2 Ом. Независимая защита перенапряжения или отдельных LTO-ячеек в сохранённую схему не добавляется.
- Контакт с экраном и стойками используется для GND/экранирования. Рабочие токи питания и возврата имеют полноценные контакты J101/J201.
- Медь среднего экрана остаётся одной связной GND-плоскостью вокруг единого фрезерованного окна 17,2×6,8 мм / R0,6 для пластиковой планки J101. Двенадцать отдельных NPTH удалены по заданию A3. Надписи выполняются поверхностью/маской; буквы в стеклотекстолите не вырезаются.
- Рамка SH1 и прежняя крышка отсутствуют. Средний сплошной экран сохраняется; измеренная эквивалентность EMI после удаления вертикальных стенок не заявляется.

## Унаследованные ограничения электроники

| Вопрос | Сохранённое состояние | Что требуется для фактического подтверждения |
|---|---|---|
| Балансир LTO, R47/R51=2 Ом | Рекомендованный и абсолютный ток LMV431A не гарантирован при всех углах допусков; исходный номинал оставлен пользователем | Токи, мощности и температуры при крайних напряжениях двух ячеек и допусках деталей |
| LTO и верхний предел 5,5 В | Делитель FB рассчитан с запасом по допускам; независимой OVP нет | Переходные процессы запуска, снятие нагрузки/аккумулятора; расчёт делителя не заменяет эти измерения |
| LTO без батареи | Не квалифицировано; внутренний режим CN3722 может превышать рабочие 5,5 В TPS63802 | Отдельная проверка; не заявлять гарантированную работу без аккумулятора или при его горячем отключении |
| Разряд LTO | EN измеряет напряжение всего пакета, типовое отключение около 3,605 В | Проверка каждой ячейки; общий порог не является независимой защитой двух ячеек |
| EN Na-ion/LTO | Типовые пороги перенесены; учитываются допуски EN, резисторов и входного тока | Измерение включения/отключения и гистерезиса на конкретной сборке |
| LC-банки | По десять TDK 100 мкФ на каскад; требование ≥330 мкФ эффективной ёмкости при 3,3 В ещё не подтверждено гарантированным пределом DC bias | Ёмкость при рабочем напряжении, температуре, допусках и старении; пуск и нагрузочные ступени |
| USB конкретного Nice!Nano-клона | Ручное разделение J11; прямое питание 3V3 принято как исходная конструкция | Отключённая штатная зарядка, обратные токи, нагрев и способность штатного LDO питать все верхние потребители |
| BAT_ADC | R27/R28=2,2 МОм, C25=100 нФ, отношение 1:2, τ≈0,11 с | Время установления, утечки/погрешность ADC конкретного клона, калибровка; влияние падения GND межплатных контактов |
| Модем и MCU | SYS_3V3 и RADIO_3V3 расходятся от NT2 после J11; FB1 и C23/C24 находятся у модема на RADIO_LOCAL_3V3, земля общая | Одновременные осциллограммы VCC модема и MCU при передаче, GPS и USB; раздельные ветви и феррит не гарантируют отсутствие общей просадки |
| COLD | Номиналы, схема и алгоритм снижения тока сохранены; NTC на плате измеряет местную температуру | Реальные температурные пороги, токи, разрешённые аккумулятором условия заряда и отличие температуры датчика от ячейки |
| Watchdog | Сохранён ATtiny13A, TXEN и исходный код; номинально около 3 ч молчания и 1 с reset | Реальные короткие TXEN, интервал WDT, штатные периоды молчания, восстановление MCU/модема, запуск и ток сна |
| Самовосстановление U6 | WDT используется в режиме прерываний; восстановление зависшего ATtiny не гарантируется | Проверка отказных сценариев; новый алгоритм не добавлен |
| Солнечная панель и ячейки | Панель класса 12 В; конкретные Vmp/Voc и паспорта ячеек не выбраны окончательно | Холодный Voc и рабочий диапазон панели, пределы заряда/разряда и температуры аккумуляторов |
| Прецизионные детали | Часть MPN вариантов LTO и отдельных деталей помечена невыбранной в исходной CSV | Точные поставочные MPN с заданными сопротивлением, допуском, ТКС и мощностью |
| GPS | Электрический порядок Heltec T114 V2.1 сохранён; PicoBlade горизонтальный | Реальная нумерация кабеля, корпус ответной части, питание и запуск выбранного GPS |
| FL1 | Опциональный S869M000S003; штатно NT1 не разрезан | Покупка, установка, полоса 868–870 МГц, мощность ≤+13 dBm и фактические потери антенного тракта |
| EMI/EMC | Сохранение GND, коротких силовых петель и экран — проектные меры | Проводимые/излучаемые помехи и устойчивость на собранном устройстве; CAD-аудит не является сертификацией |

## Особенности конструкции A3

Текущая карта A3 J101/J201: SYS_3V3 (1/3), RADIO_3V3 (5/7), три GND (2/4/6), NC (8), BAT sense (9), SDA (10), MODE (11), SCL (12). J11 находится на POWER и остаётся единственной съёмной связью FILTER_OUT с выходной медной звездой NT2. SYS питает Nice!Nano, всю периферию и INA219; RADIO через FB1 питает только модем и C23/C24. При USB со снятой J11 питание возвращается по SYS к NT2 и далее по RADIO к модему; выход TPS63802 изолирован. SDA/SCL используют прежние M1.15/M1.16, GPIO модема и watchdog сохраняются. BAT_ADC измеряет BAT до R71.

Все 123 позиции POWER находятся на F.Cu. R1/R40/R41/R55 используют площадки производителя Vishay WSL2512 (1,65×3,68 мм, шаг 5,71 мм); R56/R71 — стандартные посадки 2512 выбранных Yageo. Для новых MPN 2512 текущие цены и наличие не подтверждены. D3/D4 размещены за J101; верхний ряд TP6/TP9/TP1 имеет шаг 11 мм. Эти компоновочные изменения не заменяют измерений помех или квалификацию закупленных деталей.

Выбрана прямостоящая пара Ali: E-SIMPO L35mm A3C6 / 2x6P и MTJ H8.5 / 2X6P, шаг 2,54 мм. Бюджет источника 0,5 А является расчётным, а не измеренным профилем. Каждый отдельный основной питающий контакт должен выдерживать этот ток; параллельные контакты не доказывают увеличенную допустимую нагрузку. Указанный в чертеже розетки рейтинг 3 А не квалифицирует неизвестное сечение/покрытие вилки и соединение целиком. Требуются образцы, проверка контакта, пиков и падения напряжения.

Два рабочих этажа и экран имеют 90×60 мм. В сохранённом `docs/mechanical_selection.json` выбраны тела стоек 18 мм и 15 мм, медная сторона экрана направлена вниз и задан стек металлических шайб DIN 433 размером 3,2×6×0,5 мм: 20 штук. Номинальные внутренние промежутки составляют 18,5 мм и 16,0 мм; сформованный TH1 высотой не более 12,5 мм оставляет нижний запас 6,0 мм. Между наружными поверхностями рабочих плат номинально 39,06 мм без головки винта и нижней гайки.

Новую сборку с длинными штырями, двумя пластиковыми разделителями и единым окном экрана оценивают по окончательному STEP текущей редакции; прежние экспорты IDC/A2 и их SHA не подтверждают геометрию A3. Номинальная межплатная размерная цепочка сохраняется; полный габарит, зазоры и входные хеши находятся в [assembly_geometry_report.json](mechanics/assembly_geometry_report.json).

Сборочный отчёт A3 использует текущие STEP POWER, LOGIC и SHIELD: три проверки попарных пересечений дали объём 0 мм³, проверки восьми зазоров до крепежа пройдены. Эти результаты относятся к сохранённым размерным моделям. Они не квалифицируют реальные допуски Али-разъёмов, зацепление пружинных контактов, резьбу или изготовленный комплект.

Наружная петля шлейфа отсутствует; прежняя оценка габарита Y≥90,21 мм к текущему варианту не относится. При расстоянии рабочих поверхностей 36,02 мм, кончике штыря на 32 мм над POWER и розетке высотой 8,5 мм номинальный ввод составляет 4,48 мм. Допуски высоты розетки, допустимое сечение ответного штыря и окно глубины сопряжения этой общей серии не опубликованы. Поэтому размерная проверка CAD остаётся номинальной, требуется входной контроль приобретённой пары.

Эти размеры рассчитаны по номиналам, физическая сборка ещё не подтверждена. Глубина используемой внутренней резьбы верхней Connfly не задана производителем, часть размеров нижней RUICHI приблизительная — необходим входной контроль. Проверьте фактическое зацепление верхних соединений ≥3 мм, полное зацепление нижней гайки и отсутствие упора крепежа в дно резьбы. Удаление SH1 не подтверждает само по себе доступ к межплатной паре, охлаждение или запас EMI.

После поворота LOGIC на 180° вокруг X зеркальная локальная сетка J201 обеспечивает физическое совпадение 1:1 с J101. Обычная незеркальная посадка розетки не взаимозаменяема с ней. Экран A3 надевается через единое окно 17,2×6,8 мм, углы R0,6: в него проходит общий пластик J101 вместе со штырями. Минимальный отступ меди от окна — 0,50 мм. Максимальный габарит реального пластика универсального штекера не документирован; свободный проход проверяют до заказа изготовления. Сечение и прямолинейность штырей, совмещение плат и действительный зазор до фольги проверяют на образце; плату не притягивают винтами при несовпадении контактов.

Ширина компонента, его 3D-модель и шаг отверстий — разные исходные данные. Размерные приближённые модели модулей и новых деталей нужны для предварительного CAD, но реальная посадка Nice!Nano-клона, HT-RA62, ответных разъёмов и держателя CR2032 требует проверки по чертежам и образцу.

STEP-экспорт KiCad сообщает о self-interference медной геометрии: одно предупреждение POWER и четыре LOGIC. Они сохранены в логах, см. [STEP_TRANSPORT_RU.md](STEP_TRANSPORT_RU.md). Нулевой DRC native-плат не означает отсутствие этих особенностей STEP; экспорт не используют как самостоятельное доказательство корректности электрических соединений или всех 3D-пересечений.

## Ограничения добавленного INA219

U12 — INA219AIDR SOIC-8, адрес 0x40. Питание приходит от SYS_3V3 после POWER J11; при USB возвращается по контактам 1/3 с LOGIC; во время USB-обслуживания со снятой перемычкой J11 этот измеритель остаётся питаемым. При отключённых обоих основных источниках и без USB резервная CR2032 питает только RTC.

В сохранённом непрерывном режиме INA219 потребляет около **0,7 мА типично, до 1 мА** по паспорту. Это дополнительная постоянная нагрузка, а не ток сна. Программное выключение измерений и управление питанием INA219 в данной редакции не добавлены. Потребление конкретной сборки и коэффициент пересчёта со стороны аккумулятора зависят от КПД TPS63802 и напряжения батареи.

**R71=0,1 Ом ±1%, 1 Вт, 2512** выбран для штатной калибровки MeshCore. При 0,8 А расчётное падение составляет **80 мВ**, мощность — **64 мВт**; при принятом расчётном токе батарейной линии 1,25 А — **125 мВ и 156 мВт**. Допуск сопротивления, ТКС выбранного Yageo **±600 ppm/°C**, пайка и Kelvin-отводы влияют на точность. При диапазоне INA219 ±320 мВ предел тока приблизительно ±3,2 А; длительные 4 А означали бы 1,6 Вт и не квалифицированы для установленного 1-ваттного шунта.

IN+ подключён через R72 к BAT_SYS, IN− через R73 к BAT. Поэтому заряд имеет положительный знак, разряд — отрицательный. Показания регистра мощности не являются подписанной мощностью заряда/разряда; отображение и калибровку штатной прошивки проверяют на образце.

**Токи балансиров LTO обходят главный шунт** через батарейные и среднюю точки J12. Делитель EN и отвод BAT_ADC также остаются до R71. INA219 измеряет основной обмен между зарядником/преобразователем и аккумулятором, а не полный расход отдельных ячеек и не все малые утечки. Балансир с R47/R51=2 Ом и ранее принятые ограничения LMV431/отсутствия независимой OVP сохраняются без изменения.

## Проверки окончательных файлов A3

Окончательные статусы и входные хеши находятся в [A3_FINAL_CHECKS.json](../audit/a3_2026_10_13/A3_FINAL_CHECKS.json) и [независимом аудите](../audit/a3_2026_10_13/independent/independent_final.json). Проверка охватывает:

1. ERC обеих схем и соответствие схем своим платам. Унаследованные исключения перечисляются отдельно; исходное предупреждение о четырёхстороннем соединении FB не приравнивается к новому успешному ERC.
2. Электрическая эквивалентность исходных выводов после прямого межплатного соединения; для сравнения с S4.16 в отдельном графе виртуально объединяются измерительный R71 и реальная медная звезда NT2; J11 сопоставляется с исходной идентичностью после переноса на POWER. Физические BAT и BAT_SYS обязаны оставаться раздельными; прочие Fit/Value/MPN сохраняются, шесть согласованных 2512 и новые позиции сверяются с явным allowlist A3. R56 имеет прежний номинал 1,8 Ом / 0 Ом; отображение мощности соответствует выбранному 2512 / 1 Вт.
3. Отсутствие обхода J11, сохранение GPIO, RTC/GPS/watchdog и специально неподключённых выводов.
4. DRC обеих рабочих плат и экрана, отсутствие неразведённых цепей, проверка реального состава слоёв и габаритов.
5. Совпадение крепёжных центров, контакт экрана с GND, токовые пути без необходимости проводимости крепежа.
6. Геометрия окончательной сборки: зазоры, резьбовое зацепление, сопряжение соединителей, штыри и изоляция экрана, USB, кнопки, шунт J11, антенна, RTC и видимость D3/D4.
7. Читаемость маркировки с обеих сторон, верхних проекций и кратких инструкций экрана при сохранении сплошной меди.

Только отчёты с хешами соответствующих окончательных файлов являются результатами CAD 2.0. Все перечисленные электрические измерения, температурные проверки и проверка доступа на физическом образце остаются предстоящими, пока для них не сохранён отдельный протокол измерений.
