Alksndr55/mesh-repeater-2.0/audit/a3_2026_10_13/independent/WSL_2512_DFM_REVIEW_RU.md

# Посадочное место WSL2512

Проверен первичный источник Vishay 30100, страница 2: https://www.vishay.com/docs/30100/wsl.pdf .

Для WSL2512 с сопротивлением не менее 7 мОм рекомендованный land pattern: длина каждой площадки 1,65 мм, ширина 3,68 мм, зазор между площадками 4,06 мм (межцентровое расстояние 5,71 мм).

Исходная применённая библиотечная посадка KiCad R_2512_6332Metric имеет площадки 1,225 × 3,35 мм с шагом 5,925 мм. Номинальные выводы WSL перекрываются, поэтому отличие само по себе не означает обрыв или невозможность пайки. Рекомендованный производителем профиль отличается; при сохранении типовой посадки необходима оценка совместимости выбранных компонентов и сборки. По этому наблюдению платы не изменялись.

Это предварительное DFM наблюдение для владельца проекта, а не итоговый PASS/FAIL A3. Решение об изменении посадки фиксирует владелец CAD; конечный независимый отчёт относится к реально сохранённым файлам.
