Alksndr55/mesh-repeater-2.0/audit/a3_2026_10_13/power/routing_owner/HANDOFF_RU.md

# POWER A3: завершение меди

Финальный снимок меди перед возвратом маркировщику: `handoff_wide_snapshot.kicad_pcb`.
SHA256: `4fde0d03000f7ec29ba5448b2247fd4e963a3a7771d993e50405e9e2583bce19`.
Модель: `handoff_wide_model.json`. Позиции сохранены; в последнем проходе изменялась только медь.

Проверка KiCad 10, все severity и schematic parity: `final_wide_pickups_drc.json`.
Функциональных нарушений 0; неподключённых элементов 0; расхождений со схемой 0.
В момент передачи остаются 10 предупреждений silk_overlap между новыми компонентными подписями и прежними рамками опций: маркировщик завершает рамки и легенды после передачи. Они не исключались из DRC.

`handoff_wide_copper_proof.json`: все 123 посадочных места на F.Cu; дорожек с углами, отличными от 45/90 градусов, нет. Медные участки LX1/LX2 TPS63802 побайтно по геометрии совпадают с исходным снимком: каждый 2,184 мм, без переходных отверстий. Зарядный переключаемый узел D1–D2–L1 имеет 4 прямых/диагональных сегмента, 13,758 мм, ширину 0,8 мм и 0 переходных отверстий.

`handoff_wide_path_proof.json` подтверждает 11 непрерывных силовых путей шириной не менее 0,8 мм. В частности, устранён узкий участок подключения BAT-площадки R1: добавлен собственный горизонтальный мост 0,8 мм. Участок BAT_SYS у входного конденсатора преобразователя расширен с 0,5 до 0,8 мм. Пин RADIO_3V3 №7 межплатного разъёма получил прямое подключение к центру площадки. Ствол J11–NT2 имеет ширину 1,0 мм; после NT2 обе ветви к межплатному разъёму имеют ширину 0,8 мм.

Отдельные Kelvin-подключения R71 к R72/R73 сняты непосредственно с соответствующих площадок шунта, имеют ширину 0,2 мм и идут по F.Cu без переходных отверстий. Геометрические пути с учётом захода внутрь площадок составляют около 9,05 и 3,43 мм; равенство их длин не заявляется.

`handoff_wide_filter_proof.json` подтверждает силовые пути R55–L3 (0,8 мм), L3–L4 (1,2 мм), L4–J11 (0,8 мм). Существующие короткие участки у выводов TPS63802 и ближайших конденсаторов остаются уже общего ствола: на выходном пути 0,25×0,80 мм; 0,60×0,90 мм; 0,30×1,85 мм; 0,30×0,566 мм. Их суммарное геометрическое сопротивление при номинальных 35 мкм меди и 20 °C около 6,28 мОм, то есть 6,28 мВ/А. На входном пути узкие участки суммарно дают около 4,30 мОм. Это расчёт падения на меди, без переходов, температурного роста, допусков травления и без заявления о сертифицированной токовой нагрузке.

Графовые проверки являются свидетельствами выбранных физических путей. Полная связность, зазоры, сверловка, courtyard и соответствие схеме проверены штатным DRC. Они не подменяют испытания собранной платы на пульсации, температуру и радиопомехи.

После `LABELS_RESUME` владелец этой области POWER больше не изменяет native PCB, модель или библиотеку.
