Alksndr55/mesh-repeater-2.0/audit/a3_2026_10_13/logic/views/LOGIC_back_labels_projected.png

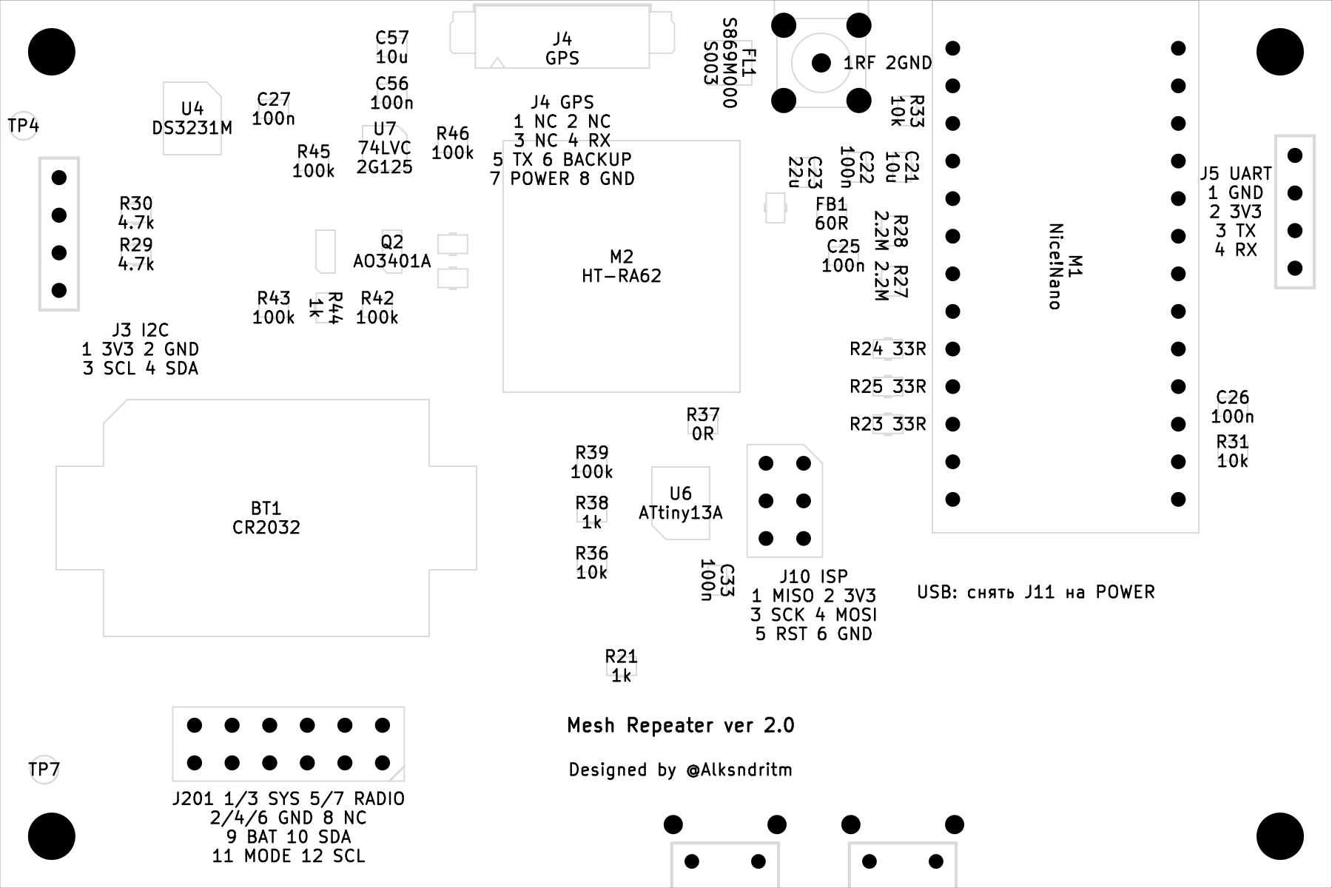
audit/a3_2026_10_13/logic/views/LOGIC_back_labels_projected.png
