Alksndr55/mesh-repeater-2.0/audit/a3_2026_10_13/logic/views/MeshRepeater2_Logic_back.png

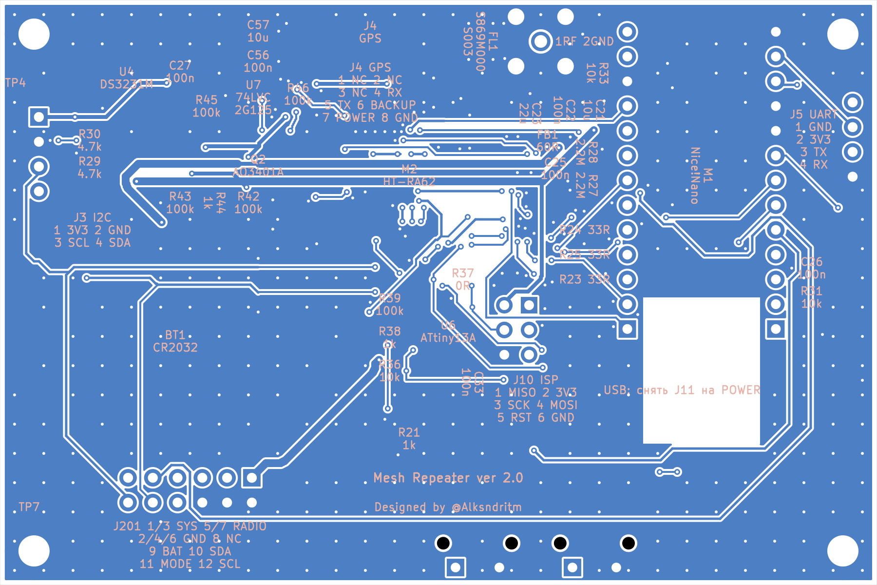
audit/a3_2026_10_13/logic/views/MeshRepeater2_Logic_back.png
