Alksndr55/mesh-repeater-2.0/audit/a3_2026_10_13/power/routing_owner/POWER_copper_before_labels.png

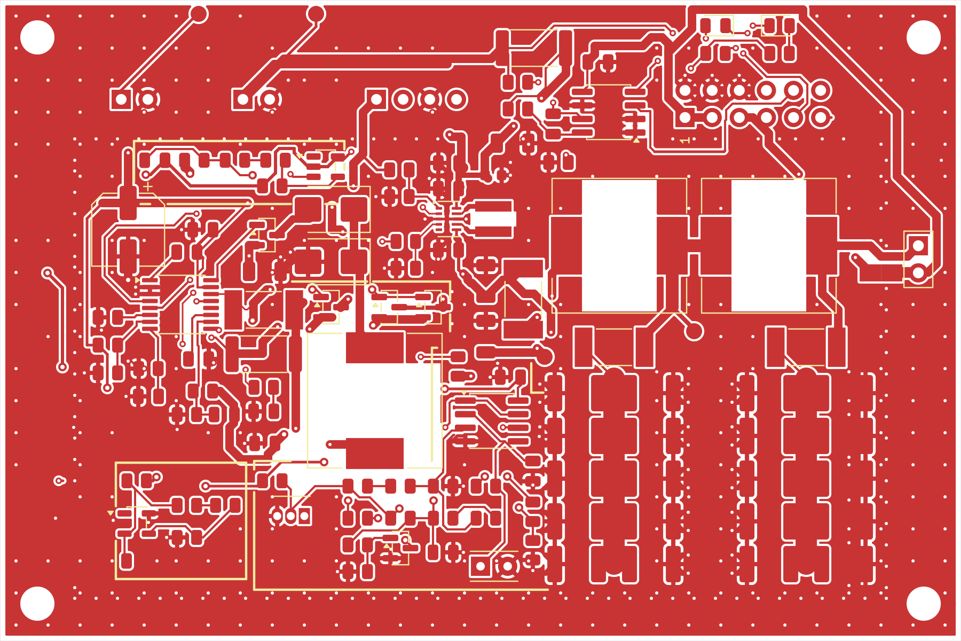
audit/a3_2026_10_13/power/routing_owner/POWER_copper_before_labels.png
