Alksndr55/mesh-repeater-2.0/audit/a3_2026_10_13/power_labels/views/POWER_back_labels_projected.png

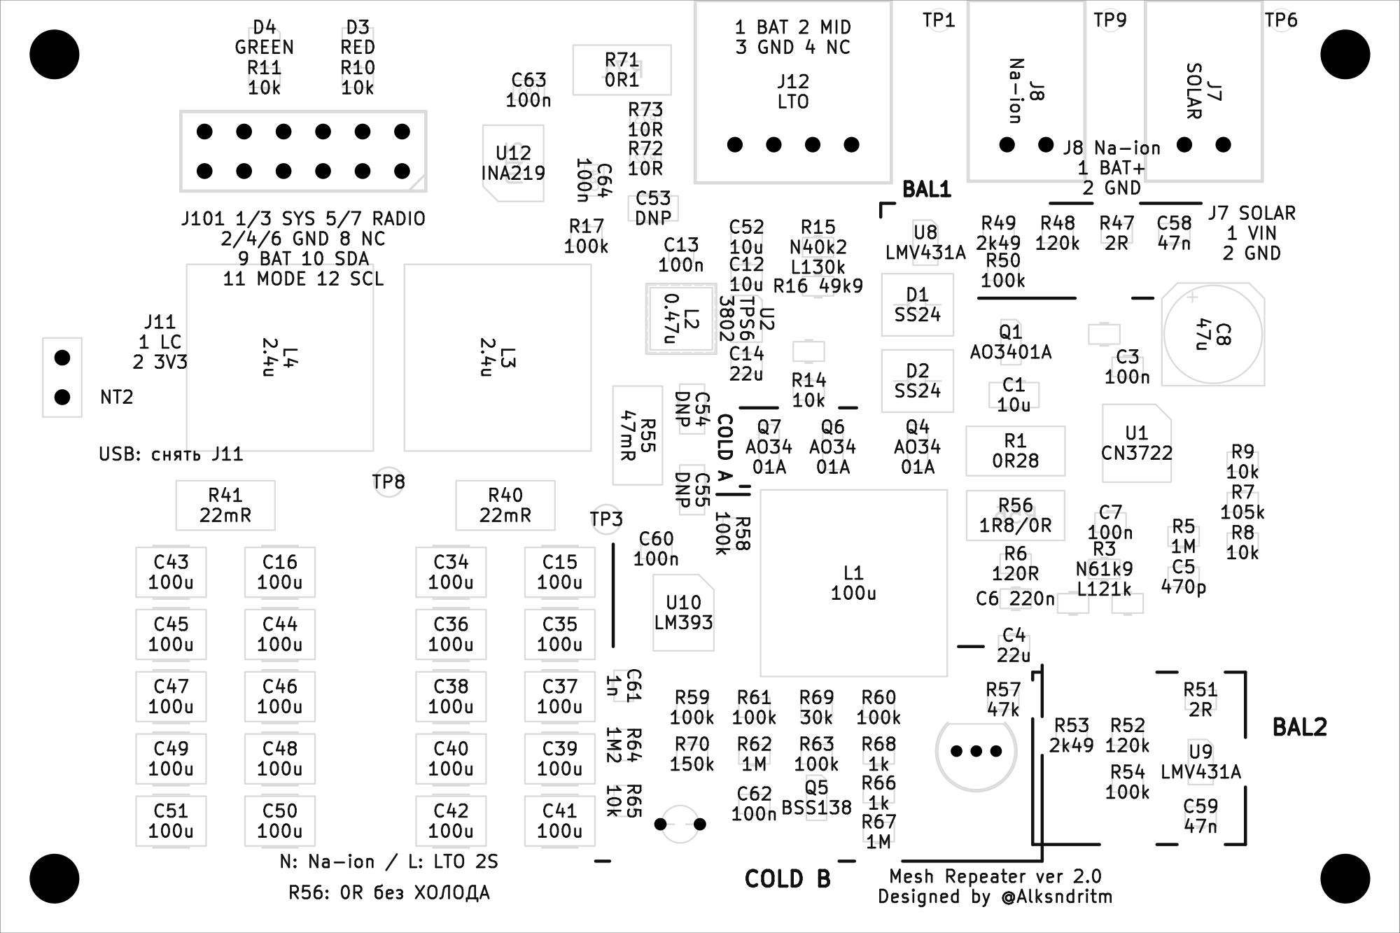
audit/a3_2026_10_13/power_labels/views/POWER_back_labels_projected.png
