Alksndr55/mesh-repeater-2.0/audit/a3_2026_10_13/schematic/LOGIC/visual-2.png

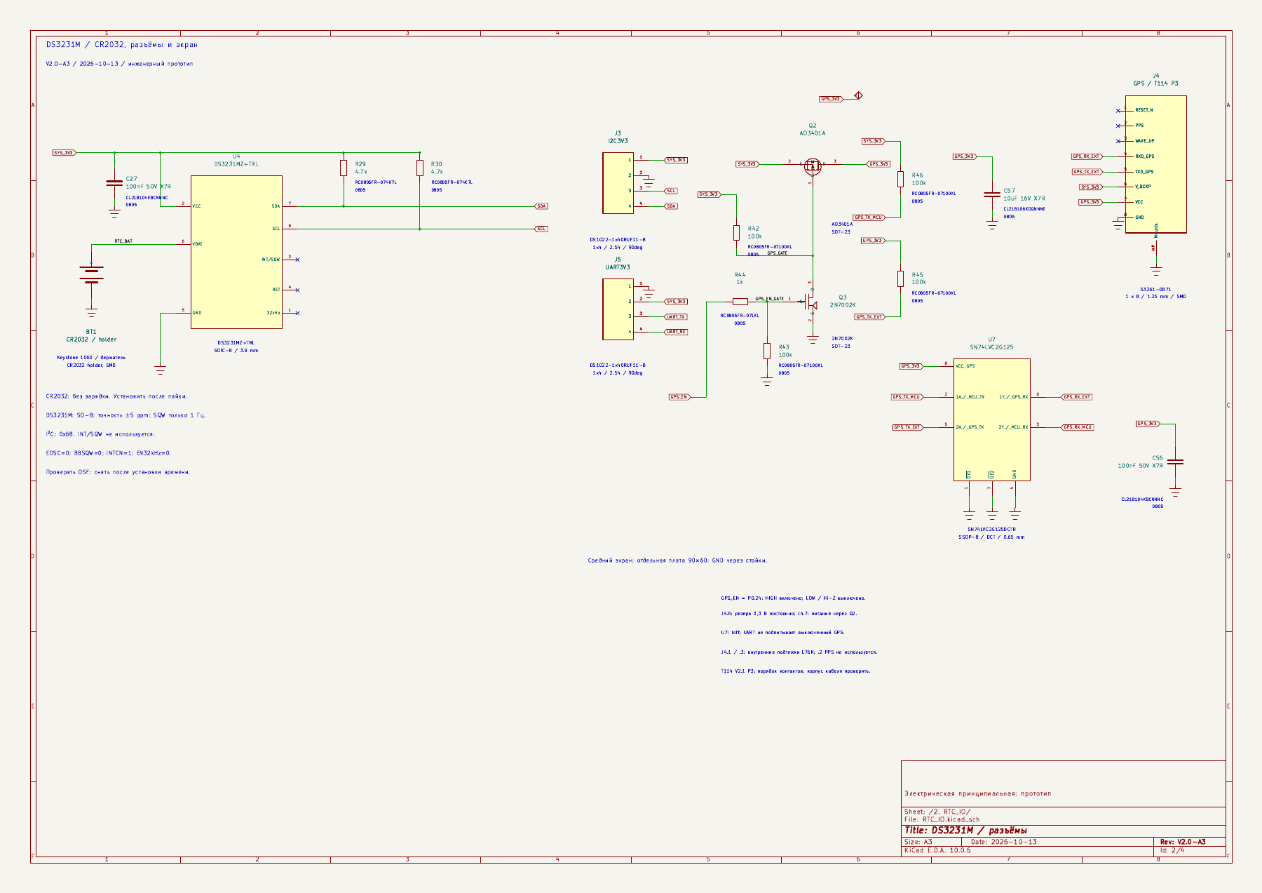
audit/a3_2026_10_13/schematic/LOGIC/visual-2.png
