Alksndr55/mesh-repeater-2.0/audit/routing_cleanup_2026_10_22/views/after/POWER/POWER_copper_back.png

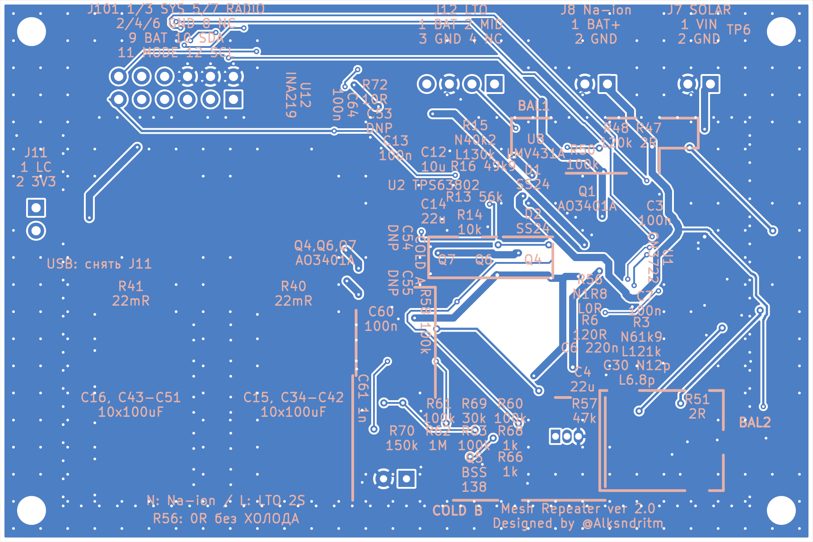
audit/routing_cleanup_2026_10_22/views/after/POWER/POWER_copper_back.png
