Alksndr55/mesh-repeater-2.0/audit/routing_cleanup_2026_10_22/views/before/POWER/POWER_routes_back.png

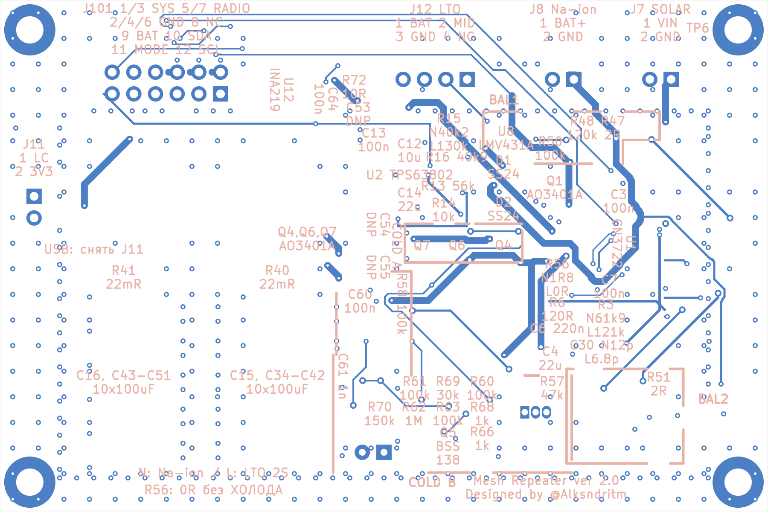
audit/routing_cleanup_2026_10_22/views/before/POWER/POWER_routes_back.png
