Alksndr55/mesh-repeater-2.0/audit/V2_ENGINEERING_AUDIT_A3_2026_10_13/ELECTRICAL_LMV431_P14.png

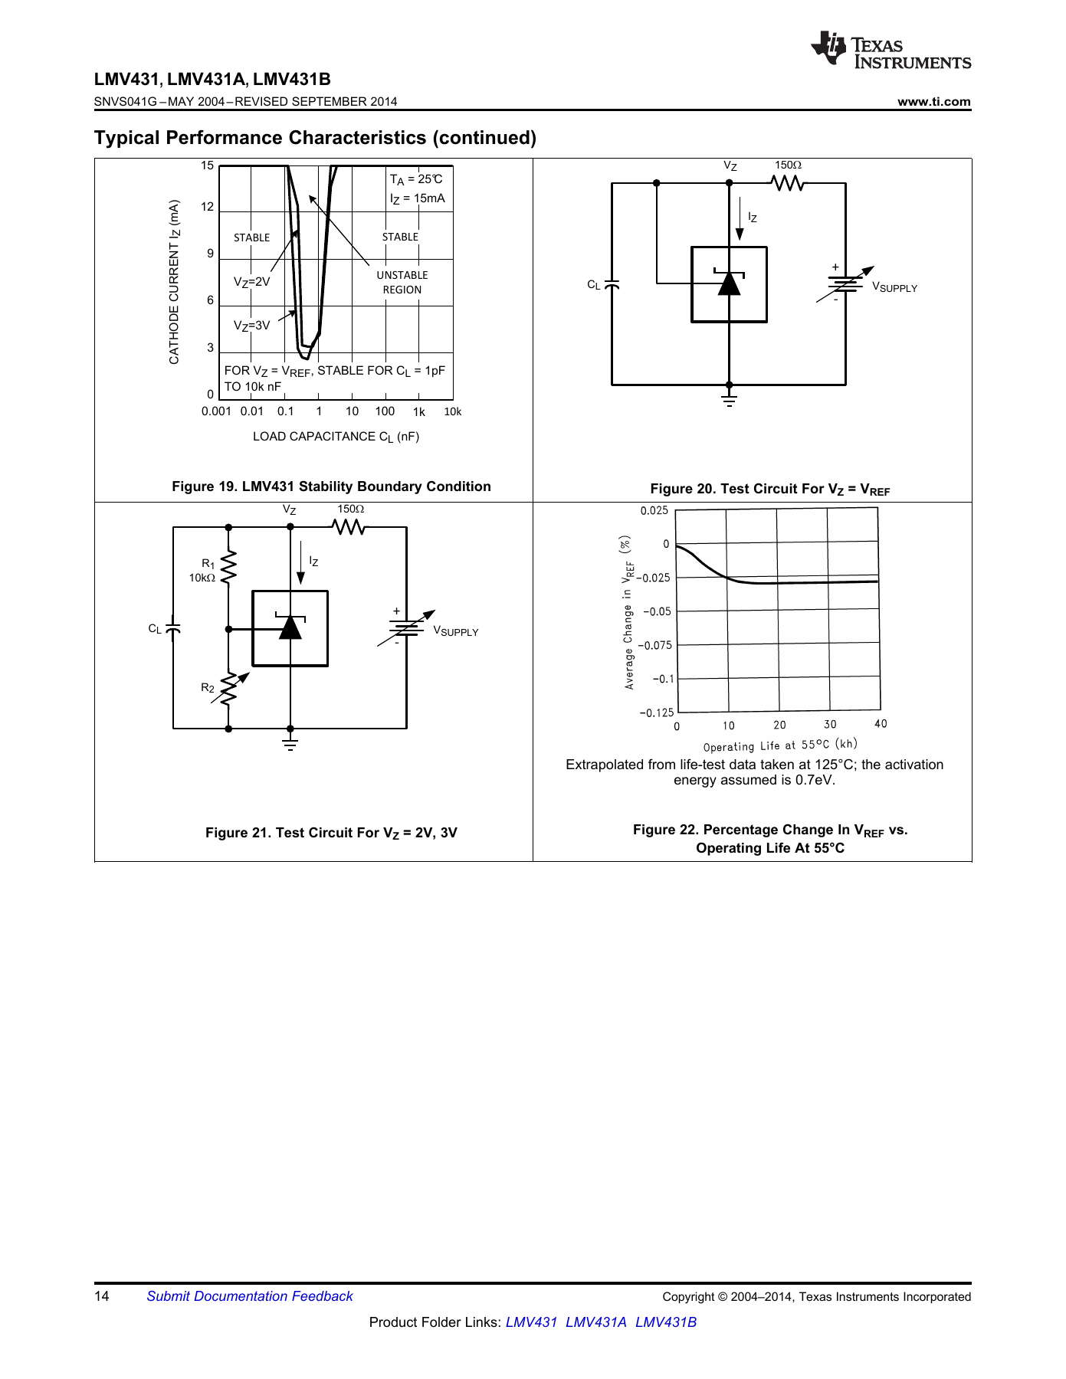
audit/V2_ENGINEERING_AUDIT_A3_2026_10_13/ELECTRICAL_LMV431_P14.png
