Alksndr55/mesh-repeater-2.0/audit/V2_ENGINEERING_AUDIT_A3_2026_10_13/MECHANICAL_RF_Heltec_RA62_dimensions.png

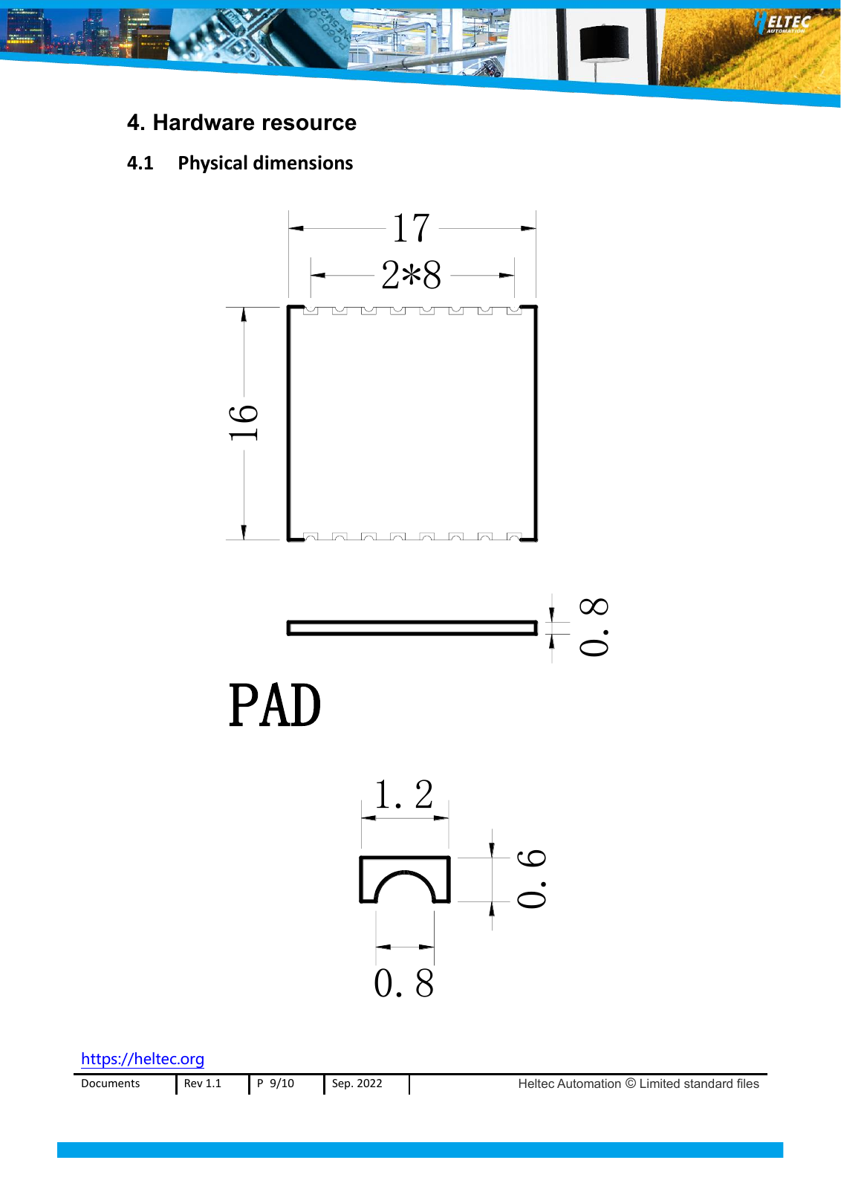
audit/V2_ENGINEERING_AUDIT_A3_2026_10_13/MECHANICAL_RF_Heltec_RA62_dimensions.png
