Alksndr55/mesh-repeater-2.0/docs/mechanics/MeshRepeater2_exploded_below_native_3D.png

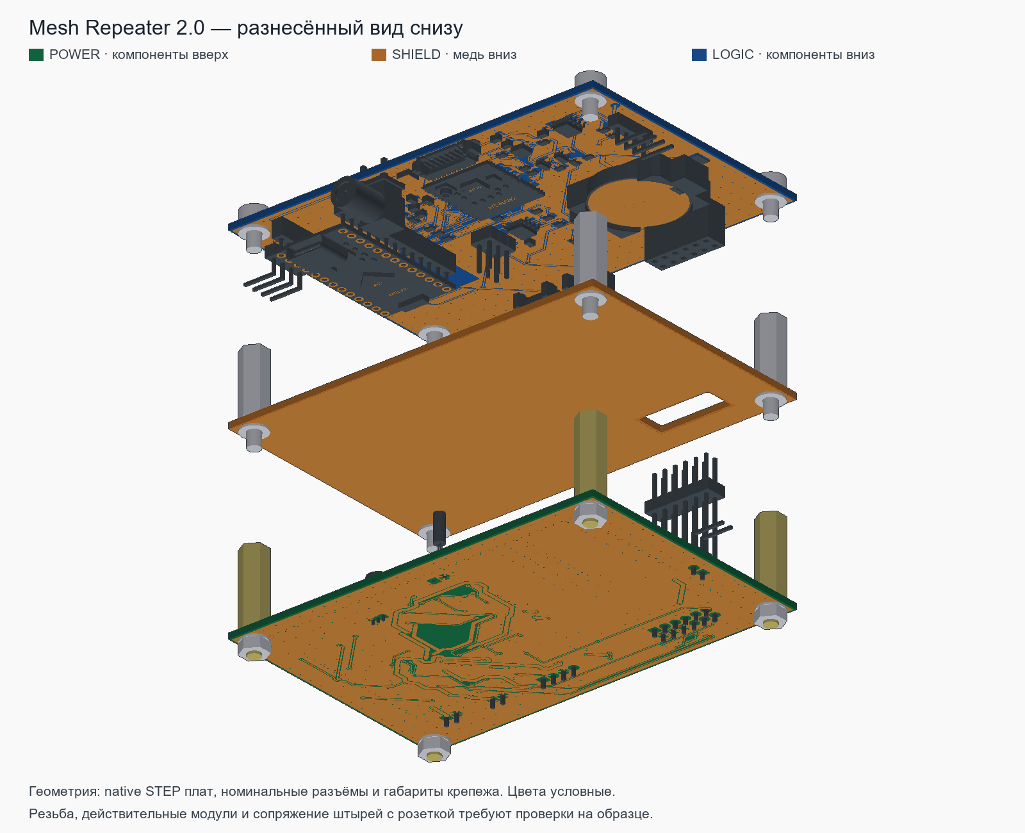
docs/mechanics/MeshRepeater2_exploded_below_native_3D.png
