Alksndr55/mesh-repeater-2.0/output/LOGIC_MARKING/MeshRepeater2_Logic_back_labels.png

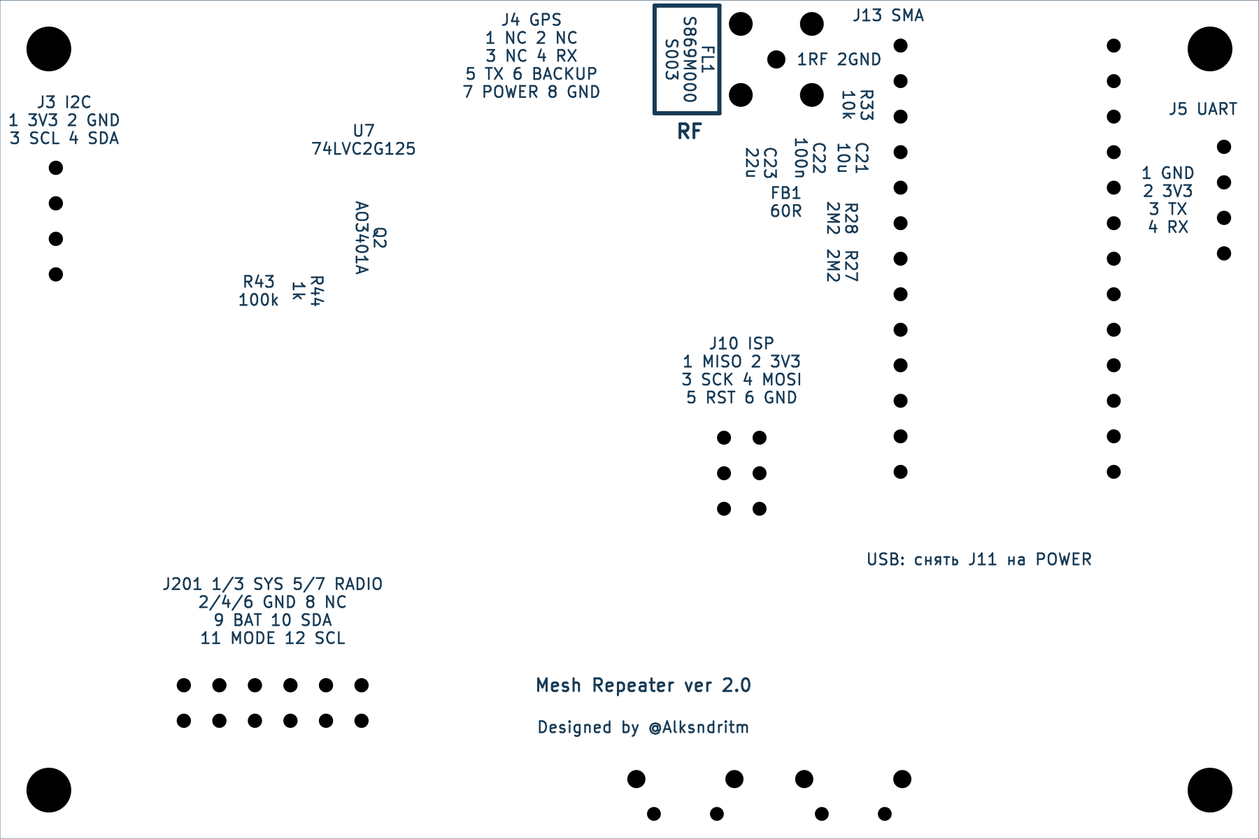
output/LOGIC_MARKING/MeshRepeater2_Logic_back_labels.png
