Alksndr55/mesh-repeater-2.0/output/POWER_MARKING/MeshRepeater2_Power_back_labels.png

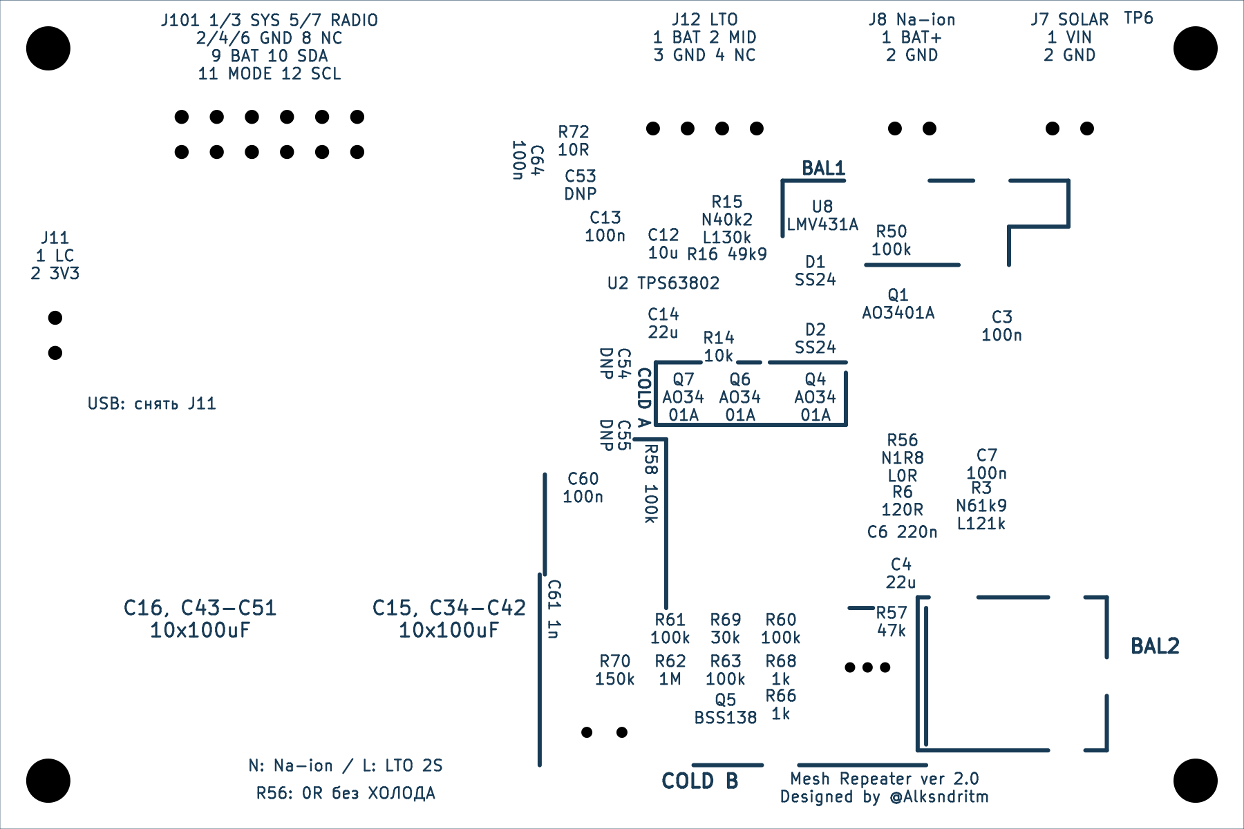
output/POWER_MARKING/MeshRepeater2_Power_back_labels.png
