Alksndr55/mesh-repeater-2.0/output/SHIELD/MeshRepeater2_Shield_back.png

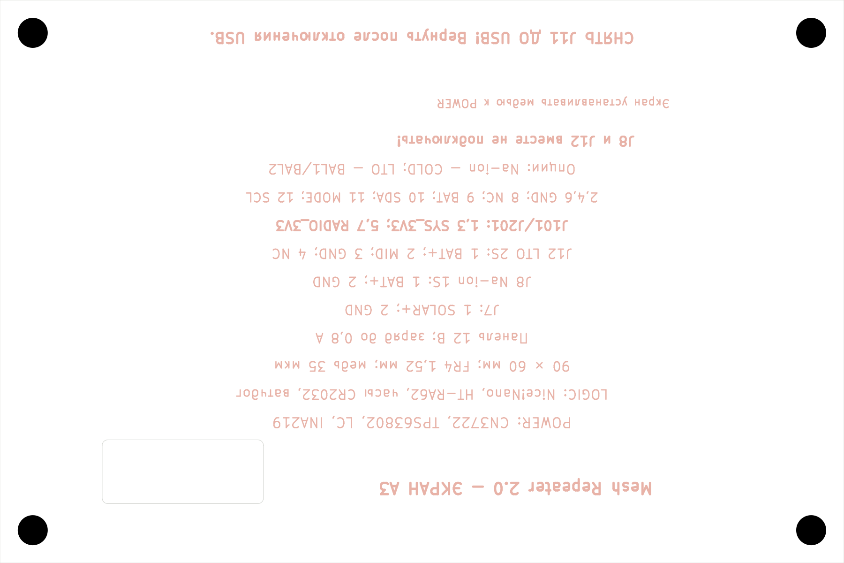
output/SHIELD/MeshRepeater2_Shield_back.png
