Alksndr55/mesh-repeater-2.0/audit/V2_ENGINEERING_AUDIT_A3_2026_10_13/SOFTWARE_BOM_BUILD_COMMAND.txt

Experimental audit build only; no flash and no assertion that this is the user-selected release binary.

Host: Windows, PowerShell. Bundled Python 3.12 executable:
C:/Users/Alksndr/.cache/codex-runtimes/codex-primary-runtime/dependencies/python/python.exe

Install isolated PlatformIO:
python -m pip install --disable-pip-version-check --target <audit>/SOFTWARE_BOM_BUILD_TMP/pydeps platformio
Result: PlatformIO Core 6.2.0.

Extract the exact source archive SOFTWARE_BOM_MeshCore_source.zip to SOFTWARE_BOM_BUILD_TMP.
Archive/source SHA: MeshCore a366955cb2f67b8e6842d4f00d2b6a554dddd88a, source version v1.17.1.
All archive destinations were checked to remain inside this audit temporary directory.

Process-only environment:
GIT_OPTIONAL_LOCKS=0
PYTHONIOENCODING=utf-8
PYTHONPATH=<audit>/SOFTWARE_BOM_BUILD_TMP/pydeps
PLATFORMIO_CORE_DIR=<audit>/SOFTWARE_BOM_BUILD_TMP/core
PIP_CACHE_DIR=<audit>/SOFTWARE_BOM_BUILD_TMP/pipcache

Actual build command:
python -m platformio run -d <audit>/SOFTWARE_BOM_BUILD_TMP/MeshCore-a366955cb2f67b8e6842d4f00d2b6a554dddd88a -e ProMicro_repeater -v

Full stdout/stderr: SOFTWARE_BOM_BUILD_TMP/platformio_build.log
Actual exit code: SOFTWARE_BOM_BUILD_TMP/platformio_build_exit.txt (only after command completion)

Unedited upstream board definition: boards/promicro_nrf52840.json.
MCU nRF52840, 64 MHz, Arduino nRF5, S140 6.1.1, FWID0x00B6, softdevice SD flags S140.
Linker script nrf52840_s140_v6.ld, flash maximum815104, RAM maximum235520.
Framework dependency explicitly pinned by upstream to meshcore-dev/Adafruit_nRF52_Arduino#d541301.
RadioLib dependency explicitly pinned by upstream to6d8934836678d8894e3d556550475b37dce3e2b6.
Full resolved build flags are printed at the start of the verbose log.

No edits to current v2 source, firmware, BOM, rules, or binary; no programmer connected.

Actual environment remedies, without any global configuration:
1. SDK checkout retry: GIT_CONFIG_COUNT=1, GIT_CONFIG_KEY_0=core.longpaths, GIT_CONFIG_VALUE_0=true.
   Log platformio_build_longpaths.log. Exit1: bits/c++config.h not found by GCC's noncanonical multilib path.
2. Canonical header probe: set process-only CPLUS_INCLUDE_PATH to
   <audit>/SOFTWARE_BOM_BUILD_TMP/core/packages/toolchain-gccarmnoneeabi/arm-none-eabi/include/c++/7.2.1/arm-none-eabi/thumb/v7e-m/fpv4-sp/hard.
   Pipe '#include <cstdlib>' to arm-none-eabi-g++ -mcpu=cortex-m4 -mthumb -mfloat-abi=hard -mfpu=fpv4-sp-d16 -E -x c++ -v -.
   Probe passed exit0. The same original PlatformIO command with this process variable ran again.
   Log platformio_build_canonical.log. Exit1 after12.993s: ARM assembler cannot create TinyUSB ports/*.cpp.o
   (absolute object paths262-268characters, all parent directories exist).
No short-path mapping was created. No successful firmware binary produced. Stopped at this new blocker.
