Alksndr55/mesh-repeater-2.0/audit/V2_ENGINEERING_AUDIT_A3_2026_10_13/SOFTWARE_BOM_Heltec_T114_V2_1.txt

PAGE 1
1
1
2
2
3
3
4
4
5
5
6
6
7
7
8
8
D D
C C
B B
A A
R13 22R/5%
R6 22R/5%
D_N
D_P
GND
GND
VUSB
GND
GND
A_DP
A_DN
R11 5.1K/5%
R7 5.1K/5%
VUSB
GND 1
VBUS 2
SBU2 3
CC1 4
DN2 5
DP1 6
DN1 7
DP2 8
SBU1 9
CC2 10
VBUS 11
GND 12
USB1Type-C USB-16Pin
DEC1C1
VDDW1
VSS_PA F23ANT H23DEC6 E24DEC3 D23XC1 B24XC2 A23
VDD A22P1.10 A20
P0.00/XL1D2
P0.01/XL2F2
P0.28/AIN4 B11
DEC4 B5
VSS B7
VDD B1
DCC B3
SWDCLK AA24SWDIO AC24P1.01 Y23
D-AD4
P0.19AC15
nRF52840
VDDHY2 DCCHAB2
VBUSAD2
DECUSBAC5
D+AD6
P0.20AD16
P0.21AC17
P0.22AD18
P0.23AC19
P0.24AD20
VDD AD23
P0.09/NFC1 L24
P1.09R1
P0.25AC21
P1.00AD22
P0.26G1
P0.27H2
P0.04/AIN2J1
P0.05/AIN3K2
P0.06L1
P0.07M2
P0.08N1
P1.08P2
P0.13AD8
P0.14AC9
P0.15AD10
P0.16AC11
P0.11T2
P0.12U1
P0.17AD12
P0.18/RESETAC13
DEC5 N24
P0.10/NFC2 J24
P0.03/AIN1 B13P0.02/AIN0 A12
P0.29/AIN5 A10P0.30/AIN6 B9P0.31/AIN7 A8
VDDAD14
P1.02 W24P1.03 V23P1.04 U24P1.05 T23P1.06 R24P1.07 P23
P1.11 B19
P1.12 B17P1.13 A16P1.14 B15P1.15 A14
DEC2 A18
GND 74
U7
nRF52840-QIAA
DEC1
C12
0.1uF/10V
GND
1 2
X132.768KHz
C13 15pF/10V
C19 15pF/10V
GND
GND
I2C_SDA
I2C_SCL
BAT_ADC
P0.05_HOLD
P0.07_WP
P0.08
L4
600R@500mA
L5 10uH
VDD_3V3
VDD_nRF
C23
4.7uF/10V
GND
C21
4.7uF/10V
C22
4.7uF/10V
GNDGND
C24
4.7uF/10V
GND
GND
P0.13
P0.14
LORA_BUSY
REST
VDD_nRF C27 0.1uF/10V GND
LOAR_SCK
DIO1
LOAR_MOSI
LOAR_MISO
LOAR_NSS
LOAR_NRSET
SWO
VDD_nRF
C25
0.1uF/10V
GND
SWDCLK
SWDIO
P1.01
P1.03_Green
C20
820pF/10V
P0.09
P0.10
C17
0.8pF/10V
GND L3
3.3nHC18
0.5pF/10V
GND
C15 0.1uF/10V
L1
15nH
C1
1uF/10V
C2
47nF/10V
GND
VDD_nRF
C48
0.1uF/10V
GND
TFT_EN
F_SPI_CS
F_SPI_CLK
F_SPI_MISO
F_SPI_MOSI
C3 NC
GND
Button
VDD_nRF
C10
0.1uF/10V
GND
1 3 4
2
U1
32MHz
C14 22pF/10V
C11 22pF/10V GND
D_N
D_P
VUSB
E1
RFANT3216120A5T
TFT_RST
TFT_LED_EN
P0.16
ADC_Ctrl
P0.28
P0.29
P0.30
P0.31
P1.11
TFT_SCL
TFT_SDA
TFT_CS
TFT_RS
PPS
Vext_Ctrl
RST_GPS
WAKE_UP
RX_GPS
TX_GPS
D1
RSB6.8S
GND
R4
10K/5%
GND
R5
1K/5%
3
1
2
Q2 AO3401
D
G
S
D2
1N5817WS
GND
1
2
JP1
1.25X2P-LiPo
VBAT
C5
10uF/10V
C6
10uF/10V
GND
VDD_3V3
C7
1uF/10V
GND
VUSB
Vext_Ctrl
R12
100K/5%
IN1
GND2
EN3
NC 4
OUT 5
U5
CE6260B33M
C32
10uF/10V
GND
C33
1uF/10V
GND
GND
IN1
GND2
EN3
NC 4
OUT 5
U2
CE6260B33M
R8
100K/5%
C59
1uF/10V
GND
F1
6V 2A
VDD_5V
TEMP 1
CE 8
DONE 6
CHRG 7GND3
PROG2
BAT5
VCC4
GND9
U3 LGS4056H
3
1
2
Q4AO3400D
G
S
GND
R24
1K/5%
GND
CHRG
VDD_5V
C9
10uF/10VGND
C8
1uF/10V
GND
GND
LED3
Orange
R26
1K/5%
D3
1N5817WS
Solar
1
2
JP2
1.25X2P-Solar
GND
R31
1K/5%
ADC_Ctrl
R30
10M/5%
3
1
2
Q8
S9013
VBAT
GND
VBAT
GND
R32
390K/1%
R33
100K/1% 3
1
2
Q7
AO3401
D
G
S
BAT_ADC
LEDA1
GND2
RESET3
RS4
SDA5
SCL6
VDD7
CS8
U4
1.14TFT
C4
0.1uF/10V
GND
GND
TFT_RST
TFT_RS
TFT_SDA
TFT_SCL
TFT_CS
R15
1K/5%
3
1
2
Q1
AO3401
D
G
SR17
10K/5%
VDD_3V3
TFT_EN
R28
1K/5%
3
1
2
Q3
AO3401G
SR27
10K/5%
VDD_3V3
D
TFT_LED_EN
1
2
3
4
5
6
7
8
9
10
11
12
13
P1
Header 13
1
2
3
4
5
6
7
8
9
10
11
12
13
P2
Header 13
P0.28
P0.29
P0.30
P0.31
P0.09
P0.10
P0.05_HOLD
P0.07_WP
P0.08 GND
Ve_3V3
F_SPI_CS
F_SPI_CLK
F_SPI_MISO
F_SPI_MOSI
VDD_3V3VDD_5V
GND
GND
SWO
SWDCLK
SWDIO
P1.01
P0.16
P0.13
S1
RESET_SW
R1
10K/5%
C16
0.1uF/10V
GND
GND REST
S2
USER_SW
R2
10K/5%
C29
0.1uF/10V
GND
GND Button
VDD_3V3 VDD_3V3
VDD_IN 1GND 2XTA 3XTB 4GND 5DIO3 6
VREG7
GND8
DCC_SW9
VBAT10
VBAT_IO11
DIO212
DIO113
BUSY14
NRESET15
MISO16
MOSI17
SCK18
NSS 19GND 20RFI_P 21RFI_N 22RFO 23VR_PA 24
U6
SX1262
VDD_3V3
VDD_3V3
GND
L7
10R@100MHz
C28 0.1uF/10VGND
C46
0.1uF/10V
C47
0.1uF/10V
GNDL11
15uH
GND
R22 10K/5%VDD_3V3
C45
C42
C44
OUT11
GND2
OUT23 Vcont2 4IN 5Vcont1 6
U8
UPG2179
L12
C37
L9
C49 C50
GND
C36
L8
C34
GND
GND
C35
1nF/10V
GND
GND
GND
3
1
2
Q5
2SC3356
R18 100R/5%
R21
1K/5%
ANT_SW_CTRL
R19 1M/5%
GND
C30
47nF/10V
C31
82pF/10V
L6
E3
IPEX
GND
C43
1nF/10V
Vcont1
GNDGND
GND
GND
C39
470nF/10V
GND
GND1 GND 2OUT 3VDD4
X2 32MHz
R20
10K/5%
VDD_3V3
LORA_BUSY
LOAR_SCKDIO1
LOAR_MOSI
LOAR_MISO
LOAR_NSS
LOAR_NRSET
DIO3
ANT_SW_CTRL
Vcont1
D5
1N5817WS
DOUT 1
VSS 2DIN3
VDD4
LED1
SK6812
GND
DOUT 1
VSS 2DIN3
VDD4
LED2
SK6812
Ve_3V3
Ve_3V3
C51
0.1uF/10V
GND
GND
P0.14
R3
4.7K/5%
R14
330R/5%
LED4
Green
P1.03_Green
1
2
3
P4
Shield_Clip
GND
1
2
3
P5
Shield_Clip
GND
1
2
3
P6
Shield_Clip
GND
C52
0.1uF/10V
GND
Ve_3V3
VDD_3V3
L2
10uH
R9
10M/5%
R23
56R/5%
R25
10M/5%
Ve_3V3
PPS
WAKE_UP
GND
RST_GPS
RX_GPS
TX_GPS
1
2
3
4
5
6
7
8
P3
Header 8
C26
4.7uF/10V
REST
RLF
NC
RHF
0R/5%
C38
NC
L13
0R/5%C53
NC
GND
Solar
VDD_nRF
GND
C61
0.1uF/10V
C62
0.1uF/10V
VDD_3V3
R34
220R/5%
C63 10pF/10V L14
10R@100MHz
GND
GND
C41
L10
C40
C64 100pF/10V
VDD_nRF
GND GND
C60
0.1uF/10V
GND
R10
1K/5%
T1
TestPad
T2
TestPad
CS1
SO(D1)2
WP(D2)3
GND4 SI(D0) 5SCK 6HOLD(D3) 7VCC 8
U9
MX25R1635FZUIL0
VDD_3V3
F_SPI_CS
F_SPI_MISO
P0.07_WP
GND
P0.05_HOLD
F_SPI_CLK
F_SPI_MOSI
C54
0.1uF/10V
GND
OSCI1
OSCO2
INT3
VSS4 SDA 5
SCL 6
CLKOUT 7
VDD 8
U10
PCF8563TS
I2C_SDA
I2C_SCL
0.08F
C56
D4
SS14
VDD_3V3
GND
C55
0.1uF/10V
1 2
X3
32.768KHz
C57
22pF
C58
22pF
GND
R29
100K/5%
VDD_3V3
P0.08
GND
Optional
Optional
