Alksndr55/mesh-repeater-2.0/audit/V2_ENGINEERING_AUDIT_A3_2026_10_13/SOFTWARE_BOM_Microchip_ATtiny13A.txt

PAGE 1
 2021 Microchip Technology Inc.                     Data Sheet Complete DS40002307A-page 1
Features
• High Performance, Low Power AVR® 8-Bit Microcontroller
• Advanced RISC Architecture
– 120 Powerful Instructions – Most Single Clock Cycle Execution
– 32 x 8 General Purpose Working Registers
– Fully Static Operation
– Up to 20 MIPS Througput at 20 MHz
• High Endurance Non-volatile Memory segments
– 1K Bytes of In-System Self-programmable Flash program memory
– 64 Bytes EEPROM
– 64 Bytes Internal SRAM
– Write/Erase Cycles: 10,000 Flash/100,000 EEPROM
– Data retention: 20 Years at 85C/100 Years at 25C (see page 12)
– Programming Lock for Self-Programming Flash & EEPROM Data Security
• Peripheral Features
– One 8-bit Timer/Counter with Prescaler and Two PWM Channels
– 4-channel, 10-bit ADC with Internal Voltage Reference
– Programmable Watchdog Timer with Separate On-chip Oscillator
– On-chip Analog Comparator
• Special Microcontroller Features
– debugWIRE On-chip Debug System
– In-System Programmable via SPI Port
– External and Internal Interrupt Sources
– Low Power Idle, ADC Noise Reduction, and Power-down Modes
– Enhanced Power-on Reset Circuit
– Programmable Brown-out Detection Circuit with Software Disable Function
ATtiny13A
tinyA VR® Data Sheet
Introduction
The ATtiny13A is a low-power CMOS 8-bit microcontroller based on the AVR ® enhanced RISC architec-
ture. By executing powerful instructions in a si ngle clock cycle, the ATti ny13A achieves throughputs
approaching 1 MIPS per MHz allowing the system des igner to optimize power consumption versus pro-
cessing speed.
PAGE 2
 2021 Microchip Technology Inc.                                                  Data Sheet Complete DS40002307A-page 2
ATtiny13A
– Internal Calibrated Oscillator
• I/O and Packages
– 8-pin PDIP/SOIC/SOIJ: Six Programmable I/O Lines
– 10-pad VDFN: Six Programmable I/O Lines
– 20-pad WQFN: Six Programmable I/O Lines
• Operating Voltage:
– 1.8 – 5.5V
• Speed Grade:
– 0 – 4 MHz @ 1.8 – 5.5V
– 0 – 10 MHz @ 2.7 – 5.5V
– 0 – 20 MHz @ 4.5 – 5.5V
• Industrial Temperature Range
• Low Power Consumption
– Active Mode:
• 190 µA at 1.8 V and 1 MHz
– Idle Mode:
•2 4  µA at 1.8 V and 1 MHz
PAGE 3
ATtiny13A
 2021 Microchip Technology Inc.       Data Sheet Complete       DS40002307A-page 3 
Table of Contents
1 Pin Configurations ............ ....................................................................... 1
1.1 Pin Description .................................................................................................. 2
2 Overview ............ ....................................................................................... 3
2.1 Block Diagram ................................................................................................... 3
3 About ............... .......................................................................................... 5
3.1 Resources ......................................................................................................... 5
3.2 Code Examples ................................................................................................. 5
3.3 Data Retention................................................................................................... 5
4 CPU Core ............... ................................................................................... 6
4.1 Architectural Overview....................................................................................... 6
4.2 ALU – Arithmetic Logic Unit............................................................................... 7
4.3 Status Register .................................................................................................. 7
4.4 General Purpose Register File .......................................................................... 9
4.5 Stack Pointer ................................................................................................... 10
4.6 Instruction Execution Timing ........................................................................... 11
4.7 Reset and Interrupt Handling........................................................................... 11
5 Memories ............... ................................................................................. 14
5.1 In-System Reprogrammable Flash Program Memory ..................................... 14
5.2 SRAM Data Memory........................................................................................ 14
5.3 EEPROM Data Memo ry .................................................................................. 15
5.4 I/O Memory...................................................................................................... 19
5.5 Register Description ........................................................................................ 19
6 System Clock and Clock Opti ons ......................................................... 22
6.1 Clock Systems and their Distribution...... ......................................................... 22
6.2 Clock Sources ................................................................................................. 23
6.3 System Clock Prescaler .................................................................................. 25
6.4 Register Description ........................................................................................ 26
7 Power Management and Sleep Modes ...... ........................................... 29
7.1 Sleep Modes.................................................................................................... 29
7.2 Software BOD Disable..................................................................................... 30
7.3 Power Reduction Register............................................................................... 30
7.4 Minimizing Power Consumption ...................................................................... 31
PAGE 4
ATtiny13A
 2021 Microchip Technology Inc.       Data Sheet Complete       DS40002307A-page 4 
7.5 Register Description ........................................................................................ 32
8 System Control and Reset .... ................................................................ 34
8.1 Resetting the AVR ........................................................................................... 34
8.2 Reset Sources ................................................................................................. 35
8.3 Internal Voltage Reference.............................................................................. 37
8.4 Watchdog Timer .............................................................................................. 37
8.5 Register Description ........................................................................................ 41
9 Interrupts ........ ........................................................................................ 44
9.1 Interrupt Vectors .............................................................................................. 44
9.2 External Interrupts ........ ................................................................................... 45
9.3 Register Description ........................................................................................ 46
10 I/O Ports ............... ................................................................................... 48
10.1 Overview.......................................................................................................... 48
10.2 Ports as General Digital I/O............................................................................. 49
10.3 Alternate Port Functions .................................................................................. 53
10.4 Register Description ........................................................................................ 56
11 8-bit Timer/Counter0 with PW M ............................................................ 58
11.1 Features .......................................................................................................... 58
11.2 Overview.......................................................................................................... 58
11.3 Timer/Counter Clock Sour ces ......................................................................... 59
11.4 Counter Unit ................. ................................................................................... 59
11.5 Output Compare Unit....................................................................................... 60
11.6 Compare Match Output Unit............................................................................ 62
11.7 Modes of Operation ......................................................................................... 63
11.8 Timer/Counter Timing Dia grams ..................................................................... 67
11.9 Register Description ........................................................................................ 69
12 Timer/Counter Prescaler ....... ................................................................ 76
12.1 Overview.......................................................................................................... 76
12.2 Prescaler Reset ............................................................................................... 76
12.3 External Clock Source ..................................................................................... 76
12.4 Register Description. ....................................................................................... 77
13 Analog Comparator ............. ................................................................... 78
13.1 Analog Comparator Mult iplexed Input ............................................................. 78
13.2 Register Description ........................................................................................ 79
PAGE 5
ATtiny13A
 2021 Microchip Technology Inc.       Data Sheet Complete       DS40002307A-page 5 
14 Analog to Digital Converter ................................................................... 81
14.1 Features .......................................................................................................... 81
14.2 Overview.......................................................................................................... 81
14.3 Operation......................................................................................................... 82
14.4 Starting a Conversion ...................................................................................... 82
14.5 Prescaling and Conversion Timing......... ......................................................... 83
14.6 Changing Channel or Reference Select ion ..................................................... 86
14.7 ADC Noise Canceler ....................................................................................... 87
14.8 Analog Input Circuitry ... ................................................................................... 87
14.9 Analog Noise Canceling Techniques............................................................... 88
14.10 ADC Accuracy Definitions ................... ............................................................ 88
14.11 ADC Conversion Result................................................................................... 91
14.12 Register Description ........................................................................................ 91
15 debugWIRE On-chip Debug Syst em ........... ......................................... 95
15.1 Features .......................................................................................................... 95
15.2 Overview.......................................................................................................... 95
15.3 Physical Interface ............................................................................................ 95
15.4 Software Break Points ..................................................................................... 96
15.5 Limitations of debugWIRE ............................................................................... 96
15.6 Register Description ........................................................................................ 96
16 Self-Programming the Flash ................................................................. 97
16.1 Performing Page Erase by SPM...................................................................... 97
16.2 Filling the Temporary Buff er (Page Loading)................................................... 97
16.3 Performing a Page Write ................................................................................. 98
16.4 Addressing the Flash During Self-Pro gramming ............................................. 98
16.5 EEPROM Write Prevents Writing to SP MCSR................................................ 99
16.6 Reading Fuse and Lock Bi ts from Firmware ................................................... 99
16.7 Preventing Flash Corruption.......................................................................... 100
16.8 Programming Time for Flash when Using SPM ............................................ 100
16.9 Register Description ...................................................................................... 101
17 Memory Programming ........... .............................................................. 102
17.1 Program And Data Memory Lock Bits ........................................................... 102
17.2 Fuse Bytes..................................................................................................... 103
17.3 Calibration Bytes ........................................................................................... 104
17.4 Signature Bytes ............................................................................................. 104
PAGE 6
ATtiny13A
 2021 Microchip Technology Inc.       Data Sheet Complete       DS40002307A-page 6 
17.5 Page Size ...................................................................................................... 104
17.6 Serial Programming....................................................................................... 105
17.7 High-Voltage Serial Prog ramming ................................................................. 108
17.8 Considerations for Effi cient Programming ..................................................... 112
18 Electrical Characteristics .. .................................................................. 116
18.1 Absolute Maximum Rating s* ......................................................................... 116
18.2 DC Characteristics............................... .......................................................... 116
18.3 Speed ............................................................................................................ 117
18.4 Clock Characteristics..................................................................................... 118
18.5 System and Reset Characteristics ...... .......................................................... 119
18.6 Analog Comparator Characteristics............................................................... 120
18.7 ADC Characteristics ............................ .......................................................... 120
18.8 Serial Programming Characteristics ....... ....................................................... 121
18.9 High-voltage Serial Prog ramming Characteristics......................................... 122
19 Typical Characteristics ..... ................................................................... 123
19.1 Supply Current of I/O Modules ...................................................................... 123
19.2 Current Consumption in Active Mode............................................................ 124
19.3 Current Consumption in Idle Mode................................................................ 127
19.4 Current Consumption in Power-down Mode.................................................. 130
19.5 Current Consumption in Reset ...................................................................... 131
19.6 Current Consumption of Pe ripheral Units...................................................... 132
19.7 Pull-up Resistors ........................................................................................... 134
19.8 Output Driver Strength (Low Power Pi ns) ..................................................... 137
19.9 Output Driver Strength (Regular Pins)........................................................... 140
19.10 Input Thresholds and Hysteresis (for I/O Ports) ............................................ 146
19.11 BOD, Bandgap and Reset ...................... ....................................................... 149
19.12 Internal Oscillator Speed ............................................................................... 153
20 Register Summary ............ ................................................................... 157
21 Instruction Set Summary .... ................................................................. 159
22 Ordering Information ........ ................................................................... 161
23 Packaging Information ....... ................................................................. 162
23.1 8P3 ................................................................................................................ 162
23.2 8S2 ................................................................................................................ 163
23.3 8S1 ................................................................................................................ 164
PAGE 7
ATtiny13A
 2021 Microchip Technology Inc.       Data Sheet Complete       DS40002307A-page 7 
23.4 20M1.............................................................................................................. 165
23.5 10M1.............................................................................................................. 166
24 Errata ........... .......................................................................................... 167
24.1 ATtiny13A Rev. G – H ................................................................................... 167
24.2 ATtiny13A Rev. E – F .................................................................................... 167
24.3 ATtiny13 Rev. A – D ...................................................................................... 167
25 Datasheet Revision History ... .............................................................. 168
25.1 Rev. 8126F – 05/12 ....................................................................................... 168
25.2 Rev. 8126E – 07/10....................................................................................... 168
25.3 Rev. 8126D – 11/0 9....................................................................................... 168
25.4 Rev. 8126C – 09/0 9....................................................................................... 168
25.5 Rev. 8126B – 11/08....................................................................................... 168
25.6 Rev. 8126A – 05/08....................................................................................... 168
PAGE 8
ATtiny13A
 2021 Microchip Technology Inc.       Data Sheet Complete       DS40002307A-page 8 
1. Pin Configurations
Figure 1-1. Pinout of ATtiny13A
1
2
3
4
8
7
6
5
(PCINT5/RESET/ADC0/dW) PB5
(PCINT3/CLKI/ADC3) PB3
(PCINT4/ADC2) PB4
GND
VCC
PB2 (SCK/ADC1/T0/PCINT2)
PB1 (MISO/AIN1/OC0B/INT0/PCINT1)
PB0 (MOSI/AIN0/OC0A/PCINT0)
8-PDIP/SOIJ/SOIC
1
2
3
4
5
20-WQFN
15
14
13
12
11
20
19
18
17
16
6
7
8
9
10
(PCINT5/RESET/ADC0/dW) PB5
(PCINT3/CLKI/ADC3) PB3
DNC
DNC
(PCINT4/ADC2) PB4
DNC
DNC
GND
DNC
DNC
VCC
PB2 (SCK/ADC1/T0/PCINT2)
DNC
PB1 (MISO/AIN1/OC0B/INT0/PCINT1)
PB0 (MOSI/AIN0/OC0A/PCINT0)
DNC
DNC
DNC
DNC
DNC
NOTE: Bottom pad should be soldered to ground.
DNC: Do Not Connect
1
2
3
4
5
10-VDFN
10
  9
  8
  7
  6
(PCINT5/RESET/ADC0/dW) PB5
(PCINT3/CLKI/ADC3) PB3
DNC
(PCINT4/ADC2) PB4
GND
VCC
PB2 (SCK/ADC1/T0/PCINT2)
DNC
PB1 (MISO/AIN1/OC0B/INT0/PCINT1)
PB0 (MOSI/AIN0/OC0A/PCINT0)
NOTE: Bottom pad should be soldered to ground.
DNC: Do Not Connect
PAGE 9
ATtiny13A
 2021 Microchip Technology Inc.       Data Sheet Complete       DS40002307A-page 9 
1.1 Pin Description
1.1.1 VCC
Supply voltage.
1.1.2 GND
Ground.
1.1.3 Port B (PB5:PB0)
Port B is a 6-bit bi-directional I/O port with inter nal pull-up resistors (selected for each bit). The
Port B output buffers have symmetrical drive c haracteristics with both high sink and source
capability. As inputs, Port B pins  that are externally pulled low will source current if the pull-up
resistors are activated. The Port B pins are tri-stated when a reset condition becomes active,
even if the clock is not running.
Port B also serves the functions of various special features of the ATtiny13A as listed on page
61.
1.1.4 RESET
Reset input. A low level on this pin for longer than the minimum pulse length will generate a
reset, even if the clock is not running and provided the reset pin has not been disabled. The min-
imum pulse length is given in Table 18-4 on page 126 . Shorter pulses are not ensured to
generate a reset.
The reset pin can also be used as a (weak) I/O pin.
PAGE 10
ATtiny13A
 2021 Microchip Technology Inc.       Data Sheet Complete       DS40002307A-page 10 
2. Overview
The ATtiny13A is a low-power CMOS 8-bit microcontroller based on the AVR enhanced RISC
architecture. By executing powerful instructions in a single clock cycle,  the ATtiny13A achieves
throughputs approaching 1 MIPS per MHz allowing  the system designer to optimize power con-
sumption versus processing speed.
2.1 Block Diagram
Figure 2-1. Block Diagram
PROGRAM
COUNTER
INTERNAL
OSCILLATOR
WATCHDOG
TIMER
STACK
POINTER
PROGRAM
FLASH
SRAM
MCU CONTROL
REGISTER
GENERAL
PURPOSE
REGISTERS
INSTRUCTION
REGISTER
TIMER/
COUNTER0
INSTRUCTION
DECODER
DATA DIR.
REG.PORT B
DATA REGISTER
PORT B
PROGRAMMING
LOGIC
TIMING AND
CONTROL
MCU STATUS
REGISTER
STATUS
REGISTER
ALU
PORT B DRIVERS
PB[0:5]
VCC
GND
CONTROL
LINES
8-BIT DATABUS
Z
              ADC / 
ANALOG COMPARATOR
INTERRUPT
UNIT
CALIBRATED
Y
X
RESET
CLKI
WATCHDOG
OSCILLATOR
DATA
EEPROM
PAGE 11
ATtiny13A
 2021 Microchip Technology Inc.       Data Sheet Complete       DS40002307A-page 11 
The AVR core combines a rich instruction set with 32 general purpose working registers. All 32
registers are directly connected to the Arit hmetic Logic Unit (ALU), allowing two independent
registers to be accessed in one single instruction executed in one clock cycle. The resulting
architecture is more code effici ent while achieving throughputs up to ten times faster than con-
ventional CISC microcontrollers.
The ATtiny13A provides the following features: 1K byte of In-System Programmable Flash, 64
bytes EEPROM, 64 bytes SRAM, 6 general purpose I/O lines, 32 general purpose working reg-
isters, one 8-bit Timer/Counter with compare modes, Internal and External Interrupts, a 4-
channel, 10-bit ADC, a programmable Watchdog Ti mer with internal Oscillator, and three soft-
ware selectable power saving modes. The Idle mode stops the CPU while allowing the SRAM,
Timer/Counter, ADC, Analog Comparator, and Interrupt system to cont inue functioning. The
Power-down mode saves the register  contents, disabling all chip functions until the next Inter-
rupt or Hardware Reset. The ADC Noise Reduction mode stops the CPU and all I/O modules
except ADC, to minimize switching noise during ADC conversions.
The device is manufactured using Microchip’s high density non-volatile memory technology. The
On-chip ISP Flash allows the Program memory to be re-programmed In-System through an SPI
serial interface, by a conventional non-volatile memory programmer or by an On-chip boot code
running on the AVR core.
The ATtiny13A AVR is supported with a full su ite of program and syst em development tools
including: C Compilers, Macro Assemblers, Program Debugger/Simulators, and Evaluation kits.
PAGE 12
ATtiny13A
 2021 Microchip Technology Inc.       Data Sheet Complete       DS40002307A-page 12 
3. About
3.1 Resources
A comprehensive set of drivers, application notes, data sheets and descriptions on development
tools are available for download at http://www.microchip.com.
3.2 Code Examples 
This documentation contains simple code examples that briefly show how to use various parts of
the device. These code examples assume that the part specific header file is included before
compilation. Be aware that not all C compiler vendors include bit definitions in the header files
and interrupt handling in C is compiler dependent. Please confirm with the C compiler documen-
tation for more details.
3.3 Data Retention
Reliability Qualification results show that the projected data retention failure rate is much less
than 1 PPM over 20 years at 85C or 100 years at 25C.
PAGE 13
ATtiny13A
 2021 Microchip Technology Inc.       Data Sheet Complete       DS40002307A-page 13 
4. CPU Core
This section discusses the AVR core architecture in general. The main function of the CPU core
is to ensure correct program execution. The CPU must therefore be able to access memories,
perform calculations, control peripherals, and handle interrupts.
4.1 Architectural Overview
Figure 4-1. Block Diagram of the AVR® Architecture 
In order to maximize performance and parallelism,  the AVR uses a Harvard architecture – with
separate memories and buses for program and data. Instructions in the Program memory are
executed with a single level pipelining. While one instruction is being executed, the next instruc-
tion is pre-fetched from the Program memory. Th is concept enables instructions to be executed
in every clock cycle. The Program memory is In-System Reprogrammable Flash memory.
Flash
Program
Memory
Instruction
Register
Instruction
Decoder
Program
Counter
Control Lines
32 x 8
General
Purpose
Registrers
ALU
Status
and Control
I/O Lines
EEPROM
Data Bus 8-bit
 
Data
SRAM
Direct AddressingIndirect Addressing
Interrupt
Unit
Watchdog
Timer
Analog
Comparator
I/O Module 2

I/O Module1
I/O Module n

PAGE 14
ATtiny13A
 2021 Microchip Technology Inc.       Data Sheet Complete       DS40002307A-page 14 
The fast-access Register File contains 32 x 8-bit general purpose working registers with a single
clock cycle access time. This allows single-cycle Arithmetic Logic Unit (ALU) operation. In a typ-
ical ALU operation, two operands are output from  the Register File, the operation is executed,
and the result is stored back in the Register File – in one clock cycle.
Six of the 32 registers can be used as three 16 -bit indirect address register pointers for Data
Space addressing – enabling efficient address calculations. One of the these address pointers
can also be used as an address pointer for look up tables in Flash Program memory. These
added function registers are the 16-bit X-, Y-, and Z-register, described later in this section.
The ALU supports arithmetic and logic operations  between registers or between a constant and
a register. Single register operations can also be executed in the ALU. After an arithmetic opera-
tion, the Status Register is updated to reflect information about the result of the operation.
Program flow is provided by c onditional and unconditional jump and call instructions, able to
directly address the whole address space. Most AVR  instructions have a si ngle 16-bit word for-
mat. Every Program memory address contains a 16- or 32-bit instruction.
During interrupts and subroutine calls, the return address Program Counter (PC) is stored on the
Stack. The Stack is effectively allocated in the general data SRAM, and consequently the Stack
size is only limited by the total SRAM size an d the usage of the SRAM. All user programs must
initialize the SP in the Reset routine (before subroutines or interrupts are executed). The Stack
Pointer (SP) is read/write accessible in the I/O space. The data SRAM can easily be accessed
through the five different addressing modes supported in the AVR architecture.
The memory spaces in the AVR architecture are all linear and regular memory maps.
A flexible interrupt module has its control r egisters in the I/O space with an additional Global
Interrupt Enable bit in the Status  Register. All interrupts have a s eparate Interrupt Vector in the
Interrupt Vector table. The interrupts have priority in accordance with their Interrupt Vector posi-
tion. The lower the Interrupt Vector address, the higher the priority.
The I/O memory space c ontains 64 addresses for CPU peri pheral functions as Control Regis-
ters, SPI, and other I/O functions. The I/O memo ry can be accessed directly, or as the Data
Space locations following those of the Register File, 0x20 - 0x5F.
4.2 ALU – Arithmetic Logic Unit
The high-performance AVR ALU operates in dire ct connection with all the 32 general purpose
working registers. Within a single clock cycle, arithmetic operations between general purpose
registers or between a register and an immediate are executed. The ALU operations are divided
into three main categories – arithmetic, logica l, and bit-functions. Some implementations of the
architecture also provide a powerful multip lier supporting both sig ned/unsigned multiplication
and fractional format. See the “Instruction Set” section for a detailed description.
4.3 Status Register
The Status Register contains information about the result of the most recently executed arithme-
tic instruction. This information can be used for altering program flow in order to perform
conditional operations. Note that the Status Re gister is updated after all ALU operations, as
specified in the Instruction Set Reference. This will in many cases remove the need for using the
dedicated compare instructions, resulting in faster and more compact code.
The Status Register is not aut omatically stored when entering an interrupt routine and restored
when returning from an interrupt. This must be handled by software.
PAGE 15
ATtiny13A
 2021 Microchip Technology Inc.       Data Sheet Complete       DS40002307A-page 15 
4.3.1 SREG – Status Register
• Bit 7 – I: Global Interrupt Enable
The Global Interrupt Enable bit must be set for the interrupts to be enabled. The individual inter-
rupt enable control is then performed in separate control registers. If the Global Interrupt Enable
Register is cleared, none of the interrupts are enabled independent of t he individual interrupt
enable settings. The I-bit is cleared by hardware after an interrupt has occurred, and is set by
the RETI instruction to enable subsequent interr upts. The I-bit can also be set and cleared by
the application with the SEI and CLI instructions, as described in the instruction set reference.
• Bit 6 – T: Bit Copy Storage
The Bit Copy instructions BLD (B it LoaD) and BST (Bit STore) use the T-bit as source or desti-
nation for the operated bit. A bit from a register in the Regist er File can be copied into T by the
BST instruction, and a bit in T can be copied into a bit in a register in the Register File by the
BLD instruction.
• Bit 5 – H: Half Carry Flag 
The Half Carry Flag H indicates a Half Carry in some arithmetic operations. Half Carry is useful
in BCD arithmetic. See the “Instruction Set Description” for detailed information.
• Bit 4 – S: Sign Bit, S = N  V
The S-bit is always an exclusive or between the Negative Flag N and the Two’s Complement
Overflow Flag V. See the “Instruction Set Description” for detailed information.
• Bit 3 – V: Two’s Complement Overflow Flag
The Two’s Complement Overflow Flag V suppor ts two’s complement arithmetics. See the
“Instruction Set Description” for detailed information.
• Bit 2 – N: Negative Flag
The Negative Flag N indicates a negative result in an arithmetic or logic operation. See the
“Instruction Set Description” for detailed information.
• Bit 1 – Z: Zero Flag
The Zero Flag Z indicates a zero result in an arithmetic or logic operation. See the “Instruction
Set Description” for detailed information.
• Bit 0 – C: Carry Flag
The Carry Flag C indicates a carry in an arithmetic  or logic operation. See the “Instruction Set
Description” for detailed information.
B i t 76543210
0x3F I T H S V N Z C SREG
Read/Write R/W R/W R/W R/W R/W R/W R/W R/W
Initial Value 0 0 0 0 0 0 0 0
PAGE 16
ATtiny13A
 2021 Microchip Technology Inc.       Data Sheet Complete       DS40002307A-page 16 
4.4 General Purpose Register File
The Register File is optimized for the AVR Enhan ced RISC instruction set. In order to achieve
the required performance and flexibility, the following input/output schemes are supported by the
Register File:
• One 8-bit output operand and one 8-bit result input
• Two 8-bit output operands and one 8-bit result input
• Two 8-bit output operands and one 16-bit result input
• One 16-bit output operand and one 16-bit result input
Figure 4-2 shows the structure of the 32 general purpose working registers in the CPU.
Figure 4-2. AVR
® CPU General Purpose Working Registers
Most of the instructions operating on the Register  File have direct access to all registers, and
most of them are single cycle instructions.
As shown in Figure 4-2 on page 16 , each register is also assigned a Data memory address,
mapping them directly into t he first 32 locations of the user  Data Space. Although not being
physically implemented as SRAM locations, this memory organization provides great flexibility in
access of the registers, as t he X-, Y- and Z-pointer registers c an be set to index any register in
the file.
4.4.1 The X-register, Y-register, and Z-register
The registers R26..R31 have some added functi ons to their general purpose usage. These reg-
isters are 16-bit address pointers for indirect addressing of the data space. The three indirect
address registers X, Y, and Z are defined as described in Figure 4-3 on page 17.
70 A d d r .
R0 0x00
R1 0x01
R2 0x02
…
R13 0x0D
General R14 0x0E
Purpose R15 0x0F
Working R16 0x10
Registers R17 0x11
…
R26 0x1A X-register Low Byte
R27 0x1B X-register High Byte
R28 0x1C Y-register Low Byte
R29 0x1D Y-register High Byte
R30 0x1E Z-register Low Byte
R31 0x1F Z-register High Byte
PAGE 17
ATtiny13A
 2021 Microchip Technology Inc.       Data Sheet Complete       DS40002307A-page 17 
Figure 4-3. The X-, Y-, and Z-registers
In the different addressing modes these address registers have functions as fixed displacement,
automatic increment, and automatic decrement (see the instruction set reference for details).
4.5 Stack Pointer
The Stack is mainly used for storing temporary data, for storing local variables and for storing
return addresses after interrupts and subroutine calls. The Stack Pointer Register always points
to the top of the Stack. Note that the Stack is implemented as growing from higher memory loca-
tions to lower memory locations. This implies that a Stack PUSH command decreases the Stack
Pointer.
The Stack Pointer points to the data SRAM Stack area where the Subroutine and Interrupt
Stacks are located. This Stack space in the data SRAM is aut omaticall defined to the last
address in SRAM during power on reset. The Stack Pointer must be set to point above 0x60.
The Stack Pointer is decremented by one when data is pushed onto the Stack with the PUSH
instruction, and it is decremented by two when the return address is pushed onto the Stack with
subroutine call or interrupt. The Stack Pointer is incremented by one when data is popped from
the Stack with the POP instruction, and it is incremented by two when data is popped from the
Stack with return from subroutine RET or return from interrupt RETI.
The AVR Stack Pointer is implemented as two 8- bit registers in the I/O space. The number of
bits actually used is implementation dependent. No te that the data space in some implementa-
tions of the AVR architecture is so small that only SPL is needed. In this case, the SPH Register
will not be present.
4.5.1 SPL – Stack Pointer Low
15 XH XL 0
X-register 70 7 0
R27 (0x1B) R26 (0x1A)
15 YH YL 0
Y-register 70 7 0
R29 (0x1D) R28 (0x1C)
15 ZH ZL 0
Z-register 7 070
R31 (0x1F) R30 (0x1E)
B i t 76543210
0x3D SP7 SP6 SP5 SP4 SP3 SP2 SP1 SP0 SPL
Read/Write R/W R/W R/W R/W R/W R/W R/W R/W
I n i t i a l  V a l u e 10011111
PAGE 18
ATtiny13A
 2021 Microchip Technology Inc.       Data Sheet Complete       DS40002307A-page 18 
4.6 Instruction Execution Timing
This section describes the general access timing concepts for instruction execution. The AVR
CPU is driven by the CPU clock clkCPU, directly generated from the selected clock source for the
chip. No internal clock division is used.
Figure 4-4 on page 18 shows the parallel instruction fetches and instruction executions enabled
by the Harvard architecture and the fast access Regi ster File concept. This is the basic pipelin-
ing concept to obtain up to 1 MIPS per MHz with the corresponding unique results for functions
per cost, functions per clocks, and functions per power-unit.
Figure 4-4. The Parallel Instruction Fetches and Instruction Executions
Figure 4-5 on page 18  shows the internal timing concept fo r the Register File. In a single clock
cycle an ALU operation using two register operands is executed, and the result is stored back to
the destination register.
Figure 4-5. Single Cycle ALU Operation
4.7 Reset and Interrupt Handling
The AVR provides several different interrupt sources. These interrupts and the separate Reset
Vector each have a separate Program Vector in the Program memory space. All interrupts are
assigned individual enable bits which must be written logic one together with the Global Interrupt
Enable bit in the Status Register in order to enable the interrupt.
The lowest addresses in the Program memory space are by default defined as the Reset and
Interrupt Vectors. The complete list of vectors is shown in “Interrupts” on page 51 . The list also
determines the priority levels of the different interrupts. The lower the address the higher is the
clk
1st Instruction Fetch
1st Instruction Execute
2nd Instruction Fetch
2nd Instruction Execute
3rd Instruction Fetch
3rd Instruction Execute
4th Instruction Fetch
T1 T2 T3 T4
CPU
Total Execution Time
Register Operands Fetch
ALU Operation Execute
Result Write Back
T1 T2 T3 T4
clkCPU
PAGE 19
ATtiny13A
 2021 Microchip Technology Inc.       Data Sheet Complete       DS40002307A-page 19 
priority level. RESET has the highest priority, and next is INT0 – the External Interrupt Request
0.
When an interrupt occurs, the Global Interrupt Enable I-bit is cleared and all interrupts are dis-
abled. The user software can write logic one to the I-bit to enable nested interrupts. All enabled
interrupts can then interrupt the current interrupt  routine. The I-bit is automatically set when a
Return from Interrupt instruction – RETI – is executed. 
There are basically two types of interrupts. The fi rst type is triggered by an event that sets the
Interrupt Flag. For these interrupts, the Program Counter is vectored to the actual Interrupt Vec-
tor in order to execute the interrupt handli ng routine, and hardware clears the corresponding
Interrupt Flag. Interrupt Flags can also be cleared by writing a logic one to the flag bit position(s)
to be cleared. If an interrupt  condition occurs while the co rresponding interrupt enable bit is
cleared, the Interrupt Flag will be set and remembered until the interrupt is enabled, or the flag is
cleared by software. Similarly, if one or more interrupt conditions occur while the Global Interrupt
Enable bit is cleared, the corresponding Interr upt Flag(s) will be set and remembered until the
Global Interrupt Enable bit is set, and will then be executed by order of priority. 
The second type of interrupts will  trigger as long as the interru pt condition is present. These
interrupts do not necessarily have Interrupt Flags. If the interrupt condition disappears before the
interrupt is enabled, the interrupt will not be triggered.
When the AVR exits from an interrupt, it will always return to the main program and execute one
more instruction before any pending interrupt is served.
Note that the Status R egister is not automatically stored when entering an interrupt routine, nor
restored when returning from an interrupt routine. This must be handled by software.
When using the CLI instruction to disable interr upts, the interrupts will be immediately disabled.
No interrupt will be executed after the CLI instruction, even if it occurs simultaneously with the
CLI instruction. The following example shows how this can be used to avoid interrupts during the
timed EEPROM write sequence.
Note: See “Code Examples” on page 12.
Assembly Code Example
in r16, SREG ; store SREG value
cli ; disable interrupts during timed sequence
sbiEECR, EEMPE ; start EEPROM write
sbiEECR, EEPE
outSREG, r16 ; restore SREG value (I-bit)
C Code Example
char cSREG;
cSREG = SREG;/* store SREG value */
/* disable interrupts during timed sequence */
__disable_interrupt(); 
EECR |= (1<<EEMPE); /* start EEPROM write */
EECR |= (1<<EEPE);
SREG = cSREG; /* restore SREG value (I-bit) */
PAGE 20
ATtiny13A
 2021 Microchip Technology Inc.       Data Sheet Complete       DS40002307A-page 20 
When using the SEI instruction to enable interrupt s, the instruction following SEI will be exe-
cuted before any pending interrupts, as shown in this example.
Note: See “Code Examples” on page 12.
4.7.1 Interrupt Response Time
The interrupt execution response for all the enabled AVR interrupts is four clock cycles mini-
mum. After four clock cycles the Program Vector address for the actual interrupt handling routine
is executed. During this four clock cycle period,  the Program Counter is pushed onto the Stack.
The vector is normally a jump to the interrupt routine, and this jump takes three clock cycles. If
an interrupt occurs during execution of a multi- cycle instruction, this instruction is completed
before the interrupt is served. If an interrupt occurs when the MCU is in sleep mode, the interrupt
execution response time is increased by four clock cycles. This increase comes in addition to the
start-up time from the selected sleep mode.
A return from an interrupt handling routine take s four clock cycles. Du ring these four clock
cycles, the Program Counter (two bytes) is p opped back from the Stack, the Stack Pointer is
incremented by two, and the I-bit in SREG is set.
Assembly Code Example
sei ; set Global Interrupt Enable
sleep; enter sleep, waiting for interrupt
; note: will enter sleep before any pending 
; interrupt(s)
C Code Example
__enable_interrupt(); /* set Global Interrupt Enable */
__sleep(); /* enter sleep, waiting for interrupt */
/* note: will enter sleep before any pending interrupt(s) */
PAGE 21
ATtiny13A
 2021 Microchip Technology Inc.       Data Sheet Complete       DS40002307A-page 21 
5. Memories
This section describes the different memories in the ATtiny13A. The AVR architecture has two
main memory spaces, the Data memory and th e Program memory space. In addition, the
ATtiny13A features an EEPROM Memory for data storage. All three memory spaces are linear
and regular.
5.1 In-System Reprogrammabl e Flash Program Memory 
The ATtiny13A contains 1K byte On-chip In -System Reprogrammable Flash memory for pro-
gram storage. Since all AVR instructions are 16 or 32 bits wide, the Flash is organized as 512 x
16.
The Flash memory has an endurance of at leas t 10,000 write/erase cycles. The ATtiny13A Pro-
gram Counter (PC) is nine bits wide, thus addressing the 512 Program memory locations.
“Memory Programming” on page 109 contains a detailed description on Flash data serial down-
loading using the SPI pins.
Constant tables can be allocated within the entire Program memory address space (see the
LPM – Load Program memory instruction description).
Timing diagrams for instruction fetch and execution are presented in “Instruction Execution Tim-
ing” on page 18.
Figure 5-1. Program Memory Map
5.2 SRAM Data Memory
Figure 5-2 on page 22 shows how the ATtiny13A SRAM Memory is organized.
The lower 160 Data memo ry locations address bot h the Register File, the I/O memory and the
internal data SRAM. The first 32 locations address  the Register File, t he next 64 locations the
standard I/O memory, and the last 64 locations address the internal data SRAM.
The five different addressing modes for the Data  memory cover: Direct, Indirect with Displace-
ment, Indirect, Indirect with Pre-decrement, and Indirect with Post-increment. In the Register
File, registers R26 to R31 feature the indirect addressing pointer registers.
The direct addressing reaches the entire data space.
The Indirect with Displacement mode reaches 63 address locations from the base address given
by the Y- or Z-register.
0x0000
0x01FF
Program Memory
PAGE 22
ATtiny13A
 2021 Microchip Technology Inc.       Data Sheet Complete       DS40002307A-page 22 
When using register indirect addressing modes with automatic pre-decrement and post-incre-
ment, the address registers X, Y, and Z are decremented or incremented.
The 32 general purpose working registers, 64 I/O R egisters, and the 64 bytes of internal data
SRAM in the ATtiny13A are all accessible through all these addressing modes. The Register
File is described in “General Purpose Register File” on page 16.
Figure 5-2. Data Memory Map
5.2.1 Data Memory Access Times
This section describes the general access timi ng concepts for internal memory access. The
internal data SRAM access is performed in two clkCPU cycles as described in Figure 5-3.
Figure 5-3. On-chip Data SRAM Access Cycles
5.3 EEPROM Data Memory
The ATtiny13A contains 64 byte s of data EEPROM memory. It is  organized as a separate data
space, in which single bytes can be read and written. The EEPROM has an endurance of at
least 100,000 write/erase cycles. The acce ss between the EEPROM and the CPU is described
in the following, specifying the EEPROM Address Registers, the EEPROM Data Register, and
the EEPROM Control Register. For a detailed description of Serial data downloading to the
EEPROM, see page 112.
32 Registers
64 I/O Registers
Internal SRAM
(64 x 8)
0x0000 - 0x001F
0x0020 - 0x005F
0x009F
0x0060
Data Memory
clk
WR
RD
Data
Data
Address Address valid
T1 T2 T3
Compute Address
Read
Write
CPU
Memory Access Instruction

Next Instruction
PAGE 23
ATtiny13A
 2021 Microchip Technology Inc.       Data Sheet Complete       DS40002307A-page 23 
5.3.1 EEPROM Read/Write Access
The EEPROM Access Registers are accessible in the I/O space.
The write access times for the EEPROM are given in Table 5-1 on page 27 . A self-timing func-
tion, however, lets the user software detect w hen the next byte can be written. If the user code
contains instructions that write the EEPROM, so me precautions must be taken. In heavily fil-
tered power supplies, V CC is likely to rise or fall slowly on Power-up/down. This causes the
device for some period of time to run at a volt age lower than specified as minimum for the clock
frequency used. See “Preventing EEPROM Corruption” on page 25  for details on how to avoid
problems in these situations. 
In order to prevent unintentional EEPROM writes , a specific write procedure must be followed.
Refer to “Atomic Byte Programming” on page 23  and “Split Byte Programming” on page 23  for
details on this. 
When the EEPROM is read, the CPU is halted for four clock cycles before the next instruction is
executed. When the EEPROM is written, the CPU is halted fo r two clock cycles before the next
instruction is executed.
5.3.2 Atomic Byte Programming
Using Atomic Byte Programming is the simplest mode. When writing a byte to the EEPROM, the
user must write the address into the EEARL Register and data into EEDR Register. If the
EEPMn bits are zero, writing EEPE (within four cycles after EEMPE is wr itten) will trigger the
erase/write operation. Both the erase and writ e cycle are done in one operation and the total
programming time is given in Table 5-1 on page 27 . The EEPE bit remains set until the erase
and write operations are completed. While the devi ce is busy with programming, it is not possi-
ble to do any other EEPROM operations.
5.3.3 Split Byte Programming
It is possible to split the erase and write cycle in two different operations. This may be useful if
the system requires short access time for some limited period of time (typically if the power sup-
ply voltage falls). In order to take advantage of this method, it is required that the locations to be
written have been erased before the write operat ion. But since the er ase and write operations
are split, it is possible to do  the erase operations when the system allows doing time-critical
operations (typically after Power-up).
5.3.4 Erase
To erase a byte, the address must be written to EEARL. If the EEPMn bits are 0b01, writing the
EEPE (within four cycles after EEMPE is written) will trigger the er ase operation only (program-
ming time is given in Table 5-1 on page 27). The EEPE bit remains set until the erase operation
completes. While the device is busy programming , it is not possible to do any other EEPROM
operations.
5.3.5 Write
To write a location, the user must write the address into EEARL and the data into EEDR. If the
EEPMn bits are 0b10, writing the EE PE (within four cycles after EEMPE is written) will trigger
the write operation only (programming time is given in Table 5-1 on page 27 ). The EEPE bit
remains set until the write operation completes. If the location to be written has not been erased
before write, the data that is stored must be considered as lost. While the device is busy with
programming, it is not possible to do any other EEPROM operations.
PAGE 24
ATtiny13A
 2021 Microchip Technology Inc.       Data Sheet Complete       DS40002307A-page 24 
The calibrated Oscillator is used to time the EEPROM accesses. Make sure the Oscillator fre-
quency is within the requirements described in “OSCCAL – Oscillator Calibration Register” on
page 33. 
The following code examples show one assembly an d one C function for erase, write, or atomic
write of the EEPROM. The examples assume that interrupts are controlled  (e.g., by disabling
interrupts globally) so that no interrupts will occur during execution of these functions.
Note: See “Code Examples” on page 12.
Assembly Code Example
EEPROM_write:
; Wait for completion of previous write
sbic EECR,EEPE
rjmp EEPROM_write 
; Set Programming mode
ldi r16, (0<<EEPM1)|(0<<EEPM0)
out EECR, r16
; Set up address (r17) in address register
out EEARL, r17
; Write data (r16) to data register
out EEDR,r16
; Write logical one to EEMPE
sbi EECR,EEMPE
; Start eeprom write by setting EEPE
sbi EECR,EEPE
ret
C Code Example
void EEPROM_write(unsigned char ucAddress, unsigned char ucData)
{
/* Wait for completion of previous write */
while(EECR & (1<<EEPE))
;
/* Set Programming mode */
EECR = (0<<EEPM1)|(0>>EEPM0)
/* Set up address and data registers */
EEARL = ucAddress;
EEDR = ucData;
/* Write logical one to EEMPE */
EECR |= (1<<EEMPE);
/* Start eeprom write by setting EEPE */
EECR |= (1<<EEPE);
}
PAGE 25
ATtiny13A
 2021 Microchip Technology Inc.       Data Sheet Complete       DS40002307A-page 25 
The next code examples show assembly and C functions for reading the EEPROM. The exam-
ples assume that interrupts are controlled so that no interrupts will occur during execution of
these functions.
Note: See “Code Examples” on page 12.
5.3.6 Preventing EEPROM Corruption
During periods of low V CC, the EEPROM data can be corrupted because the supply voltage is
too low for the CPU and the EEPROM to operate properly. These issues are the same as for
board level systems using EEPROM, and the same design solutions should be applied.
An EEPROM data corruption can be caused by two situations when the voltage is too low. First,
a regular write sequence to the EEPROM requires a minimum voltage to operate correctly. Sec-
ondly, the CPU itself can execute instructions incorrectly, if the supply voltage is too low.
EEPROM data corruption can easily be avoided by following this design recommendation:
Keep the AVR RESET active (low) during periods of  insufficient power supply voltage. This can
be done by enabling the internal Brown-out Detect or (BOD). If the detection level of the internal
BOD does not match the needed detection level, an external low VCC reset protection circuit can
be used. If a reset occurs while a write operation is in progress, the write operation will be com-
pleted provided that the power supply voltage is sufficient.
Assembly Code Example
EEPROM_read:
; Wait for completion of previous write
sbic EECR,EEPE
rjmp EEPROM_read
; Set up address (r17) in address register
out EEARL, r17
; Start eeprom read by writing EERE
sbi EECR,EERE
; Read data from data register
in  r16,EEDR
ret
C Code Example
unsigned char EEPROM_read(unsigned char ucAddress)
{
/* Wait for completion of previous write */
while(EECR & (1<<EEPE))
;
/* Set up address register */
EEARL = ucAddress;
/* Start eeprom read by writing EERE */
EECR |= (1<<EERE);
/* Return data from data register */
return EEDR;
}
PAGE 26
ATtiny13A
 2021 Microchip Technology Inc.       Data Sheet Complete       DS40002307A-page 26 
5.4 I/O Memory
The I/O space definition of the ATtiny13A is shown in “Register Summary” on page 164.
All ATtiny13A I/Os and peripheral s are placed in the I/O spac e. All I/O locations may be
accessed by the LD/LDS/LDD and ST/STS/STD in structions, transferring data between the 32
general purpose working registers and the I/O space. I/O Registers wit hin the address range
0x00 - 0x1F are directly bit-accessible using the SBI and CBI instructions. In these registers, the
value of single bits can be checked by using the SBIS and SBIC instructions. Refer to the
instruction set section for more details. When using the I/O specific commands IN and OUT, the
I/O addresses 0x00 - 0x3F must be used. When ad dressing I/O Registers as data space using
LD and ST instructions, 0x20 must be added to these addresses. 
For compatibility with future devices, reserved bits should be written to zero if accessed.
Reserved I/O memory addresses should never be written.
Some of the Status Flags are cleared by writing a logical one to them. Note that, unlike most
other AVRs, the CBI and SBI instructions will only operate on the specified bit, and can therefore
be used on registers containing such Status Flags. The CBI and SBI instructions work with reg-
isters 0x00 to 0x1F only.
The I/O and Peripherals Control Registers are explained in later sections.
5.5 Register Description
5.5.1 EEARL – EEPROM  Address Register
• Bits 7:6 – Res: Reserved Bits
These bits are reserved bits in the ATtiny13A and will always read as zero.
• Bits 5:0 – EEAR[5: 0]: EEPROM Address
The EEPROM Address Register – EEARL – spec ifies the EEPROM address in the 64 bytes
EEPROM space. The EEPROM data bytes are addressed linearly between 0 and 63. The initial
value of EEARL is undefined. A proper val ue must be written before the EEPROM may be
accessed.
5.5.2 EEDR – EEPROM Data Register
• Bits 7:0 – EEDR[7:0]: EEPROM Data
For the EEPROM write operation the EEDR Regist er contains the data to be written to the
EEPROM in the address given by the EEARL Register. For the EEPROM read operation, the
EEDR contains the data read out from the EEPROM at the address given by EEARL.
B i t 76543210
0x1E – – EEAR5 EEAR4 EEAR3 EEAR2 EEAR1 EEAR0 EEARL
Read/Write R R R/W R/W R/W R/W R/W R/W
Initial Value 0 0 X X X X X X
B i t 76543210
0x1D EEDR7 EEDR6 EEDR5 EEDR4 EEDR3 EEDR2 EEDR1 EEDR0 EEDR
Read/Write R/W R/W R/W R/W R/W R/W R/W R/W
Initial Value X X X X X X X X
PAGE 27
ATtiny13A
 2021 Microchip Technology Inc.       Data Sheet Complete       DS40002307A-page 27 
5.5.3 EECR – EEPROM Control Register
• Bit 7 – Res: Reserved Bit
This bit is reserved for future use and will always  read as 0 in ATtiny13A. For compatibility with
future AVR devices, always write this bit to zero. After reading, mask out this bit.
• Bit 6 – Res: Reserved Bit
This bit is reserved in the ATtiny13A and will always read as zero.
• Bits 5:4 – EEPM[1:0]: EEPROM Programming Mode Bits
The EEPROM Programming mode bits setting def ines which programming action that will be
triggered when writing EEPE. It is possible to program data in one atomic operation (erase the
old value and program the new value) or to split the Erase and Write operations in two different
operations. The Programming times for the different modes are shown in Table 5-1 on page 27.
While EEPE is set, any write to EEPMn will be ignored. During reset, the EEPMn bits will be
reset to 0b00 unless the EEPROM is busy programming.
• Bit 3 – EERIE: EEPROM Ready Interrupt Enable
Writing EERIE to one enables the EEPROM Ready In terrupt if the I-bit in SREG is set. Writing
EERIE to zero disables the interrupt. The EEPROM Ready Interrupt generates a constant inter-
rupt when Non-volatile memory is ready for programming.
• Bit 2 – EEMPE: EEPROM Host Program Enable
The EEMPE bit determines whether writing EEPE to one will have effect or not.
When EEMPE is set, sett ing EEPE within four clock cycles will program the EEPROM at the
selected address. If EEMPE is zero, setti ng EEPE will have no effect. When EEMPE has been
written to one by software, hardware clears the bit to zero after four clock cycles.
• Bit 1 – EEPE: EEPROM Program Enable
The EEPROM Program Enable Signal EEPE is the programming enable signal to the EEPROM.
When EEPE is written, the EEPR OM will be programmed accordi ng to the EEPMn bits setting.
The EEMPE bit must be written to one before a logical one is written to EEPE, otherwise no
EEPROM write takes place. When the write access time has elapsed, the EEPE bit is cleared by
hardware. When EEPE has been set, the CPU is halted for two cycles before the next instruction
is executed.
B i t 7 6 5 4 321 0
0x1C – – EEPM1 EEPM0 EERIE EEMPE EEPE EERE EECR
Read/Write R R R/W R/W R/W R/W R/W R/W
Initial Value 0 0 X X 0 0 X 0
Table 5-1. EEPROM Mode Bits
EEPM1 EEPM0
Programming 
Time Operation
0 0 3.4 ms Erase and Write in one operation (Atomic Operation)
0 1 1.8 ms Erase Only
1 0 1.8 ms Write Only
1 1 – Reserved for future use
PAGE 28
ATtiny13A
 2021 Microchip Technology Inc.       Data Sheet Complete       DS40002307A-page 28 
• Bit 0 – EERE: EEPROM Read Enable
The EEPROM Read Enable Signal – EERE – is the read strobe to the EEPROM. When the cor-
rect address is set up in the EEARL Register, t he EERE bit must be written to one to trigger the
EEPROM read. The EEPROM read access takes one instruction,  and the requested data is
available immediately. When the EEPROM is read , the CPU is halted fo r four cycles before the
next instruction is executed. Th e user should poll the EEPE bit be fore starting the read opera-
tion. If a write operation is in progress, it is neither possible to read the EEPROM, nor to change
the EEARL Register.
PAGE 29
ATtiny13A
 2021 Microchip Technology Inc.       Data Sheet Complete       DS40002307A-page 29 
6. System Clock and Clock Options
6.1 Clock Systems and their Distribution
Figure 6-1 presents the principal clock systems in the AVR and their distribution. All of the clocks
need not be active at a given time. In order to reduce power consumption, the clocks to modules
not being used can be halted by using different sleep modes, as described in “Power Manage-
ment and Sleep Modes” on page 36. The clock systems are detailed below.
Figure 6-1. Clock Distribution
6.1.1 CPU Clock – clk CPU
The CPU clock is routed to part s of the system concerned with  operation of the AVR core.
Examples of such modules are the General Pur pose Register File, the Status Register and the
Data memory holding the Stack Pointer. Halting the CPU clock inhibits the core from performing
general operations and calculations.
6.1.2 I/O Clock – clk I/O
The I/O clock is used by the majority of the I/O modules, like Timer/Counter. The I/O clock is
also used by the External Interrupt module, but  note that some external interrupts are detected
by asynchronous logic, allowing such interrupts to be detected even if the I/O clock is halted.
6.1.3 Flash Clock – clk FLASH
The Flash clock controls operation of the Flash interface. The Flash clock is usually active simul-
taneously with the CPU clock.
General I/O
Modules CPU Core RAM
clkI/O AVR® Clock
Control Unit
clkCPU
Flash and
EEPROM
clkFLASH
Source clock
Watchdog Timer
Watchdog
Oscillator
Reset Logic
Clock
Multiplexer
Watchdog clock
Calibrated RC
OscillatorExternal Clock
ADC
clkADC
PAGE 30
ATtiny13A
 2021 Microchip Technology Inc.       Data Sheet Complete       DS40002307A-page 30 
6.1.4 ADC Clock – clk ADC
The ADC is provided with a dedicated clock domain. This allows halting the CPU and I/O clocks
in order to reduce noise generated by digital circuitry. This gives more accurate ADC conversion
results.
6.2 Clock Sources
The device has the following clock source optio ns, selectable by Flash fuse bits as shown
below. The clock from the selected source is input to the AVR clock generator, and routed to the
appropriate modules.
Note: 1. For all fuses “1” means unpr ogrammed while “0” means programmed.
The various choices for each clocking option is given in the following sections. When the CPU
wakes up from Power-down or Power-save, the sele cted clock source is us ed to time the start-
up, ensuring stable Oscillator operation before instruction execution starts. When the CPU starts
from reset, there is an additional  delay allowing the power to reach a stable level before com-
mencing normal operation. The Watchdog Oscillator is used for timing this real-time part of the
start-up time. The number of WDT Oscillator cycl es used for each time-out is shown in Table 6-
2.
6.2.1 External Clock
To drive the device from an external clock source, CLKI should be driven as shown in Figure 6-
2. To run the device on an external clock, the CKSEL fuses must be programmed to “00”.
Figure 6-2. External Clock Drive Configuration
Table 6-1. Device Clocking Options Select
Device Clocking Option  CKSEL[1:0] (1)
External Clock (see page 30)0 0
Calibrated Internal 4.8/9.6 MHz Oscillator (see page 31)0 1 ,  1 0
Internal 128 kHz Oscillator (see page 32)1 1
Table 6-2. Number of Watchdog Oscillator Cycles
Typ Time-out Number of Cycles
4 ms 512
64 ms 8K (8,192)
EXTERNAL
CLOCK
SIGNAL
CLKI
GND
PAGE 31
ATtiny13A
 2021 Microchip Technology Inc.       Data Sheet Complete       DS40002307A-page 31 
When this clock source is selected, start-up times are determined by the SUT fuses as shown in
Table 6-3.
When applying an external clock, it is required to avoid sudden changes in the applied clock fre-
quency to ensure stable operation  of the MCU. A variation in frequency of more than 2% from
one clock cycle to the next can le ad to unpredictable be havior. It is required to ensure that the
MCU is kept in Reset during such changes in the clock frequency.
Note that the System Clock Prescaler can be used to implement run-time changes of the internal
clock frequency while still ensuring stable operation. Refer to “System Clock Prescaler” on page
32 for details.
6.2.2 Calibrated Internal 4.8/9.6 MHz Oscillator
The calibrated internal oscillator provides a 4.8 or 9.6 MHz clock source. The frequency is nomi-
nal at 3V and 25 C. If the frequency exceeds the spec ification of the device (depends on V CC),
the CKDIV8 fuse must be programmed so that the in ternal clock is divided by 8 during start-up.
See “System Clock Prescaler” on page 32. for more details.
The internal oscillator is selected as the sy stem clock by programming the CKSEL fuses as
shown in Table 6-4. If selected, it will operate with no external components. 
Note: 1. The device is shipped with this option selected.
During reset, hardware loads the calibration data into the OSCCAL r egister and thereby auto-
matically calibrates the oscillator. There are separate calibration bytes for 4.8 and 9.6 MHz
operation but only one is automatically loaded during reset (see section “Calibration Bytes” on
page 111). This is because the only difference between 4.8 MHz and 9.6 MHz mode is an inter-
nal clock divider.
By changing the OSCCAL register from SW, see “OSCCAL – Oscillator Calibration Register” on
page 33, it is possible to get a higher calibration ac curacy than by using t he factory calibration.
See “Calibrated Internal RC Oscillator Accuracy” on page 125. 
When this oscillator is used as the chip clock, the Wa tchdog Oscillator will still be used for the
Watchdog Timer and for the Reset Time-out. For more information on the pre-programmed cali-
bration value, see the section “Calibration Bytes” on page 111.
Table 6-3. Start-up Times for the External Clock Selection
SUT[1:0]
Start-up Time from
Power-down and Power-save
Additional Delay
from Reset
Recommended
Usage
00 6 CK 14CK BOD enabled
01 6 CK 14CK + 4 ms Fast rising power
10 6 CK 14CK + 64 ms Slowly rising power
11 Reserved
Table 6-4. Internal Calibrated RC Oscillator Operating Modes
CKSEL[1:0]  Nominal Frequency
10(1) 9.6 MHz
01 4.8 MHz
PAGE 32
ATtiny13A
 2021 Microchip Technology Inc.       Data Sheet Complete       DS40002307A-page 32 
When this Oscillator is selected, start-up times are determined by the SUT fuses as shown in
Table 6-5.
Notes: 1. The device is shipped with this option selected.
2. If the RSTDISBL fuse is programmed, this start- up time will be increased to 14CK + 4 ms to 
ensure programming mode can be entered.
6.2.3 Internal 128 kHz Oscillator
The 128 kHz internal Oscillator is a low power O scillator providing a clock of 128 kHz. The fre-
quency depends on supply voltage, temperature and batch variations. This clock may be select
as the system clock by programming the CKSEL fuses to “11”.
When this clock source is selected, start-up times are determined by the SUT fuses as shown in
Table 6-6.
Note: 1. If the RSTDISBL fuse is programmed, this st art-up time will be increased to 14CK + 4 ms to 
ensure programming mode can be entered.
6.2.4 Default Clock Source
The device is shipped with CKSEL = “10”, SU T = “10”, and CKDIV8 programmed. The default
clock source setting is therefore the Internal RC Oscillator running at 9.6 MHz with longest start-
up time and an initial system clock prescaling of 8. This default setting ensures that all users can
make their desired clock source setting using an In-System or High-voltage Programmer.
6.3 System Clock Prescaler
The ATtiny13A system clock can be divided by setting the “CLKPR – Clock Prescale Register”
on page 34. This feature can be used to decrease power consumption when the requirement for
processing power is low. This can be used with all clock source options, and it will affect the
clock frequency of the CPU and al l synchronous peripherals. clk I/O, clkADC, clkCPU, and clkFLASH
are divided by a factor as shown in Table 6-8 on page 34.
Table 6-5. Start-up Times for the Internal Calibrated RC Oscillator Clock Selection
SUT[1:0]
Start-up Time 
from Power-down
Additional Delay from 
Reset (VCC = 5.0V) Recommended Usage
00 6 CK 14CK (2) BOD enabled
01 6 CK 14CK + 4 ms Fast rising power
10(1) 6 CK 14CK + 64 ms Slowly rising power
11 Reserved
Table 6-6. Start-up Times for the 128 kHz Internal Oscillator
SUT[1:0]
Start-up Time from
Power-down and Power-save
Additional Delay
from Reset
Recommended
Usage
00 6 CK 14CK (1) BOD enabled
01 6 CK 14CK + 4 ms Fast rising power
10 6 CK 14CK + 64 ms Slowly rising power
11 Reserved
PAGE 33
ATtiny13A
 2021 Microchip Technology Inc.       Data Sheet Complete       DS40002307A-page 33 
6.3.1 Switching Time
When switching between prescaler settings, the System Clock Prescaler ensures that no
glitches occur in the clock syst em and that no intermediate freque ncy is higher than neither the
clock frequency corresponding to the previous setting, nor the clock frequency corresponding to
the new setting.
The ripple counter that implem ents the prescaler runs at th e frequency of the undivided clock,
which may be faster than the CPU’s clock frequency.  Hence, it is not pos sible to determine the
state of the prescaler – even if it were readable, and the exact time it takes to switch from one
clock division to another cannot be exactly predicted.
From the time the CLKPS values are written, it takes between T1 + T2 and T1 + 2*T2 before the
new clock frequency is active. In this interval, 2 active clock edges are produced. Here, T1 is the
previous clock period, and T2 is the period corresponding to the new prescaler setting.
6.4 Register Description
6.4.1 OSCCAL – Oscillato r Calibration Register
• Bit 7 – Res: Reserved Bit
This bit is reserved bit in ATtiny13A and it will always read zero.
• Bits 6:0 – CAL[6:0]: Oscillator Calibration Value
Writing the calibration byte to this address will trim the internal Oscillator to remove process vari-
ations from the Oscillator frequency. This is done automatically during Chip Reset. When
OSCCAL is zero, the lowest available frequency is chosen. Writing non-zero values to this regis-
ter will increase the frequency of the internal Oscillator. Writing 0x7F to the register gives the
highest available frequency.
The calibrated Oscillator is used to time EEPR OM and Flash access. If EEPROM or Flash is
written, do not calibrate to more than 10%  above the nominal frequency. Otherwise, the
EEPROM or Flash write may fail. Note that the Oscillator is intended for calibration to 9.6 MHz or
4.8 MHz. Tuning to other values is not ensured, as indicated in Table 6-7 below.
To ensure stable operation of the MCU the calibration value should be changed in small steps. A
variation in frequency of more than 2% from one cycle to the next ca n lead to unpredicatble
behavior. Changes in OSCCAL should not exceed 0x20 for each calibration. It is required to
ensure that the MCU is kept in Reset during such changes in the clock frequency
B i t 76543210
0x31 – CAL6 CAL5 CAL4 CAL3 CAL2 CAL1 CAL0 OSCCAL
Read/Write R R/W R/W R/W R/W R/W R/W R/W
Initial Value 0 Device Specific Calibration Value
Table 6-7. Internal RC Oscillator Frequency Range
OSCCAL Value
Typical Lowest Frequency
with Respect to Nominal Frequency
Typical Highest Frequency
with Respect to Nominal Frequency
0x00 50% 100%
0x3F 75% 150%
0x7F 100% 200%
PAGE 34
ATtiny13A
 2021 Microchip Technology Inc.       Data Sheet Complete       DS40002307A-page 34 
6.4.2 CLKPR – Clock Prescale Register
• Bit 7 – CLKPCE: Clock Prescaler Change Enable
The CLKPCE bit must be written to logic one to enable change of the CLKPS bits. The CLKPCE
bit is only updated when the other bits in CLKP R are simultaneously written to zero. CLKPCE is
cleared by hardware four cycles af ter it is written or when the CL KPS bits are written. Rewriting
the CLKPCE bit within this time-out period does neither extend the time-out period, nor clear the
CLKPCE bit.
• Bits 6:4 – Res: Reserved Bits
These bits are reserved bits in the ATtiny13A and will always read as zero.
• Bits 3:0 – CLKPS[3:0]: Clock Prescaler Select Bits 3 - 0
These bits define the division fa ctor between the selected clock source and the internal system
clock. These bits can be written run-time to va ry the clock frequency to suit the application
requirements. As the divider divides the host clock input to the MCU, the speed of all synchro-
nous peripherals is reduced when a division fact or is used. The division factors are given in
Table 6-8 on page 34.
To avoid unintentional changes of clock frequency,  a special write procedure must be followed
to change the CLKPS bits:
1. Write the Clock Prescaler Change Enable (CLKPCE) bit to one and all other bits in 
CLKPR to zero.
2. Within four cycles , write the desired value to CLKPS while writing a zero to CLKPCE. 
Interrupts must be disabled when changing prescaler setting to make sure the write procedure is
not interrupted.
The CKDIV8 Fuse determines the initial value of the CLKPS bits. If CKDIV8 is unprogrammed,
the CLKPS bits will be reset to “0000”. If CK DIV8 is programmed, CL KPS bits are reset to
“0011”, giving a division factor of eight at start up. This feature should be used if the selected
clock source has a higher frequency than the maximum frequency of the device at the present
operating conditions. Note that any value can be written to the CLKPS bits regardless of the
CKDIV8 Fuse setting. The Application software must ensure that a sufficient division factor is
chosen if the selcted clock source has a higher frequency than the maximum frequency of the
device at the present operating conditions . The device is shipped with the CKDIV8 Fuse
programmed.
B i t 76543210
0x26 CLKPCE – – – CLKPS3 CLKPS2 CLKPS1 CLKPS0 CLKPR
Read/Write R/W R R R R/W R/W R/W R/W
Initial Value 0 0 0 0 See Bit Description
Table 6-8. Clock Prescaler Select
CLKPS3 CLKPS2 CLKPS1 CLKPS0 Clock Division Factor
0000 1
0001 2
0010 4
0011 8
PAGE 35
ATtiny13A
 2021 Microchip Technology Inc.       Data Sheet Complete       DS40002307A-page 35 
0100 1 6
0101 3 2
0110 6 4
0111 1 2 8
1000 2 5 6
1001 R e s e r v e d
1010 R e s e r v e d
1011 R e s e r v e d
1100 R e s e r v e d
1101 R e s e r v e d
1110 R e s e r v e d
1111 R e s e r v e d
Table 6-8. Clock Prescaler Select (Continued)
CLKPS3 CLKPS2 CLKPS1 CLKPS0 Clock Division Factor
PAGE 36
ATtiny13A
 2021 Microchip Technology Inc.       Data Sheet Complete       DS40002307A-page 36 
7. Power Management and Sleep Modes
The high performance and industry leading code ef ficiency makes the AV R microcontrollers an
ideal choise for low power app lications. In addition, sleep modes  enable the application to shut
down unused modules in the MCU, thereby sa ving power. The AVR provides various sleep
modes allowing the user to tailor the power consumption to the application’s requirements.
7.1 Sleep Modes
Figure 6-1 on page 29  presents the different clock systems in the ATtiny13A, and their distribu-
tion. The figure is helpful in selecting an appropriate sleep mode. Table 7-1 shows the different
sleep modes and their wake up sources.
Note: 1. For INT0, only level interrupt.
To enter any of the three sleep modes, the SE bit in MCUCR must be written to logic one and a
SLEEP instruction must be exec uted. The SM[1:0] bits in th e MCUCR Register select which
sleep mode (Idle, ADC Noise Reduction, or Power-down) will be activated by the SLEEP instruc-
tion. See Table 7-2 on page 40 for a summary. 
If an enabled interrupt occurs while the MCU is in a sleep mode, the MCU wakes up. The MCU
is then halted for four cycles in addition to the st art-up time, executes the interrupt routine, and
resumes execution from the instru ction following SLEEP. The contents of the Register File and
SRAM are unaltered when the device wakes up from sleep. If a reset occurs during sleep mode,
the MCU wakes up and executes from the Reset Vector.
Note that if a level triggered interrupt is used for wake-up from Power-down mode, the changed
level must be held for some time to wake up the MCU. Refer to “External Interrupts” on page 52
for details.
7.1.1 Idle Mode
When the SM[1:0] bits are written to 00, the SLEEP instruction makes the MCU enter Idle mode,
stopping the CPU but allowing Analog Comparator , ADC, Timer/Counter, Watchdog, and the
interrupt system to continue operating. This sleep mode basically halts clkCPU and clkFLASH, while
allowing the other clocks to run.
Idle mode enables the MCU to wake up from external triggered interrupts as well as internal
ones like the Timer Overflow. If wake-up from the Analog Comparator interrupt is not required,
the Analog Comparator can be powered down by setting the ACD bit in the Analog Comparator
Table 7-1. Active Clock Domains and Wake-up Sources in the Different Sleep Modes
Active Clock Domains Osci llators Wake-up Sources
Sleep Mode
clkCPU
clkFLASH
clkIO
clkADC
Main Clock 
Source Enabled
INT0 and 
Pin Change
SPM/
EEPROM
Ready
ADC
Other I/O
Watchdog 
Interrupt
Idle X X X X X X X X
ADC Noise
Reduction XX X (1) XX X
Power-down X (1) X
PAGE 37
ATtiny13A
 2021 Microchip Technology Inc.       Data Sheet Complete       DS40002307A-page 37 
Control and Status Register – ACSR. This will reduce power consumption in Idle mode. If the
ADC is enabled, a conversion starts automatically when this mode is entered.
7.1.2 ADC Noise Reduction Mode
When the SM[1:0] bits are written to 01, the SLEEP instruction ma kes the MCU enter ADC
Noise Reduction mode, stopping the CPU but allowing the ADC, the external interrupts, and the
Watchdog to continue operating (if enabled). This sleep mode halts clk I/O, clkCPU, and clkFLASH,
while allowing the other clocks to run.
This improves the noise envir onment for the ADC, enabling higher resolution measurements. If
the ADC is enabled, a conversion starts automatically when this mode is entered. Apart form the
ADC Conversion Complete interrupt, only an External Reset, a Watchdog Reset, a Brown-out
Reset, an SPM/EEPROM ready interrupt, an external level interrupt on INT0 or a pin change
interrupt can wake up the MCU from ADC Noise Reduction mode.
7.1.3 Power-down Mode
When the SM[1:0] bits are written to 10, th e SLEEP instruction make s the MCU enter Power-
down mode. In this mode, the Oscillator is stopped, while the external interrupts, and the Watch-
dog continue operating (if enabled). Only an External Reset, a Watchdog Reset, a Brown-out
Reset, an external level interrupt on INT0, or a pin change interrupt can wake up the MCU. This
sleep mode halts all generated clocks, allowing operation of asynchronous modules only.
7.2 Software BOD Disable
When the Brown-out Detector (BOD) is enabled by BODLEVEL fuses (see Table 17-3 on page
110), the BOD is actively moni toring the supply voltage during a sleep period. It is possible to
save power by disabling the BOD by software in Power-Down sleep mode. The sleep mode
power consumption will then be at the same level as when BOD is globally disabled by fuses.
If BOD is disabled by software, the BOD functi on is turned off immediately after entering the
sleep mode. Upon wake-up from sleep, BOD is automatically enabled again. This ensures safe
operation in case the VCC level has dropped during the sleep period.
When the BOD has been disabled, the wake-up time from sleep mode will be approximately
60µs to ensure that the BOD is working correctly before the MCU continues executing code.
BOD disable is controlled by the BODS (BOD  Sleep) bit of BOD Control Register, see “BODCR
– Brown-Out Detector Control Register” on page 39 . Writing this bit to one turns off BOD in
Power-Down and Stand-By, while writing a zero keeps the BOD active. The default setting is
zero, i.e. BOD active.
Writing to the BODS bit is controlled by a timed sequence and an enable bit, see “BODCR –
Brown-Out Detector Control Register” on page 39.
7.3 Power Reduction Register
The Power Reduction Register (see “PRR – Power Reduction Register” on page 40 ) provides a
method to reduce power consumption by stopping  the clock to individual peripherals. The cur-
rent state of the peripheral is frozen and the I/O registers can not be read or written. When
stopping the clock resources used by the peripheral will remain occupied, hence the peripheral
should in most cases be disabl ed before stopping the cl ock. Waking up a module (by clearing
the bit in PRR) puts the module in the same state as before shutdown.
PAGE 38
ATtiny13A
 2021 Microchip Technology Inc.       Data Sheet Complete       DS40002307A-page 38 
Modules can be shut down in Idle and Active modes , significantly helping to reduce the overall
power consumption. In all other sleep modes, the clock is already stopped. See “Supply Current
of I/O Modules” on page 130 for examples.
7.4 Minimizing Power Consumption
There are several issues to consider when trying to minimize the power consumption in an AVR
controlled system. In general, sleep modes shoul d be used as much as possible, and the sleep
mode should be selected so that as few as possib le of the device’s functions are operating. All
functions not needed should be disabled. In part icular, the following modules may need special
consideration when trying to achieve the lowest possible power consumption.
7.4.1 Analog to Digital Converter
If enabled, the ADC will be enabled in all sleep modes. To save power, the ADC should be dis-
abled before entering any sleep mode. When the ADC is turned off and on again, the next
conversion will be an extended conversion. Refer to “Analog to Digital Converter” on page 88 for
details on ADC operation.
7.4.2 Analog Comparator
When entering Idle mode, the Analog Comparator should be disabled if not used. When entering
ADC Noise Reduction mode, the Analog Comparat or should be disabled. In the other sleep
modes, the Analog Comparator is automatically di sabled. However, if the Analog Comparator is
set up to use the Internal Voltage Reference as input, the Analog Comparator should be dis-
abled in all sleep modes. Otherwise, the Internal Voltage Refe rence will be enabled,
independent of sleep mode. Refer to “Analog Comparator” on page 85 for details on how to con-
figure the Analog Comparator.
7.4.3 Brown-out Detector
If the Brown-out Detector is not needed in the application, this module should be turned off. If the
Brown-out Detector is enabled by the BODLEVEL fuses, it will be enabled in all sleep modes,
and hence, always consume power.  In the deeper sleep  modes, this will contribute significantly
to the total current consumption. See “Brown-out Detection” on page 43 and “Software BOD Dis-
able” on page 37 for details on how to configure the Brown-out Detector.
7.4.4 Internal Voltage Reference
The Internal Voltage Referenc e will be enabled when needed by the Brown- out Detection, the
Analog Comparator or the ADC. If these modul es are disabled as described in the sections
above, the internal voltage reference will be di sabled and it will not be consuming power. When
turned on again, the user must allow the referenc e to start up before the output is used. If the
reference is kept on in sleep mode, the output can be used immediately. Refer to “Internal Volt-
age Reference” on page 44 for details on the start-up time.
7.4.5 Watchdog Timer
If the Watchdog Timer is not needed in the application, this module should be turned off. If the
Watchdog Timer is enabled, it will be enabled in all sleep modes, and hence, always consume
power. In the deeper sleep modes,  this will contribute significantly to the total current consump-
tion. Refer to “Interrupts” on page 51 for details on how to configure the Watchdog Timer.
PAGE 39
ATtiny13A
 2021 Microchip Technology Inc.       Data Sheet Complete       DS40002307A-page 39 
7.4.6 Port Pins
When entering a sleep mode, all port pins shoul d be configured to use minimum power. The
most important thing is then to ensure that no pins drive resistive loads. In sleep modes where
both the I/O clock (clkI/O) and the ADC clock (clkADC) are stopped, the input buffers of the device
will be disabled. This ensures that no power is consumed by the input logic when not needed. In
some cases, the input logic is needed for detec ting wake-up conditions, and it will then be
enabled. Refer to the section “Digital Input Enable and Sleep Modes” on page 59  for details on
which pins are enabled. If the input buffer is enabled and the input signal is left floating or has an
analog signal level close to VCC/2, the input buffer will use excessive power. 
For analog input pins, the digita l input buffer should be disabled at all times. An analog signal
level close to V CC/2 on an input pin can cause significant current even in active mode. Digital
input buffers can be disabled by writing to the Digital Input Disable Register (DIDR0). Refer to
“DIDR0 – Digital Input Disable Register 0” on page 87 for details.
7.5 Register Description
7.5.1 BODCR – Brown-Out De tector Control Register
The BOD Control Register contains control bits for disabling the BOD by software.
• Bit 1 – BODS: BOD Sleep
In order to disable BOD during sleep the BODS bit must be written to logic one. This is controlled
by a timed sequence and the enable bit, BODSE.  First, both BODS and BODSE must be set to
one. Second, within four clock cycles, BODS must be set to one and BODSE must be set to
zero. The BODS bit is active three clock cycles after it is set. A slee p instruction must be exe-
cuted while BODS is active in order to turn off the BOD for the actual sleep mode. The BODS bit
is automatically cleared after three clock cycles.
• Bit 0 – BODSE: BOD Sleep Enable
The BODSE bit enables setting of BODS control bit, as explained on BODS bit description. BOD
disable is controlled by a timed sequence.
7.5.2 MCUCR – MCU Control Register
The MCU Control Register contains control bits for power management.
• Bit 5 – SE: Sleep Enable
The SE bit must be written to logic one to make the MCU enter the sleep mode when the SLEEP
instruction is executed. To avoid the MCU entering the sleep mode unless it is the programmer’s
purpose, it is recommended to write the Sleep Enable (SE) bit to one just before the execution of
the SLEEP instruction and to clear it immediately after waking up.
B i t 76543210
0x30 – – – – – – BODS BODSE BODCR
R e a d / W r i t eRRRRRR R / W R / W
Initial Value 0 0 0 0 0 0 0 0
B i t 76543210
0x35
– PUD SE SM1 SM0 – ISC01 ISC00 MCUCR
Read/Write R R/W R/W R/W R/W R R/W R/W
Initial Value 0 0 0 0 0 0 0 0
PAGE 40
ATtiny13A
 2021 Microchip Technology Inc.       Data Sheet Complete       DS40002307A-page 40 
• Bits 4:3 – SM[1:0]: Sleep Mode Select Bits 1:0
These bits select between the three available sleep modes as shown in Table 7-2 on page 40.
7.5.3 PRR – Power Reduction Register
The Power Reduction Register provides a met hod to reduce power consumption by allowing
peripheral clock signals to be disabled.
• Bits 7:2 – Res: Reserved Bits
These bits are reserved and will always read as zero.
• Bit 1 – PRTIM0: Power Reduction Timer/Counter0
Writing a logic one to this bit shuts down the Timer/Counter0 module. When the Timer/Counter0
is enabled, operation will continue like before the shutdown.
• Bit 0 – PRADC: Power Reduction ADC
Writing a logic one to this bit shuts down the ADC. The ADC must be disabled before shut down.
The analog comparator cannot be used when the ADC is shut down.
Table 7-2. Sleep Mode Select
SM1 SM0 Sleep Mode
00 I d l e
0 1 ADC Noise Reduction
1 0 Power-down
11 R e s e r v e d
B i t 76543 2 10
0x25 – – – – – – PRTIM0 PRADC PRR
R e a d / W r i t eRRRRR R R / W R / W
Initial Value 0 0 0 0 0 0 0 0
PAGE 41
ATtiny13A
 2021 Microchip Technology Inc.       Data Sheet Complete       DS40002307A-page 41 
8. System Control and Reset
8.1 Resetting the AVR ®
During reset, all I/O Registers are set to their initial values, and the pr ogram starts execution
from the Reset Vector. The instruction placed at  the Reset Vector must be a RJMP – Relative
Jump – instruction to the reset handling routine. If the program never enables an interrupt
source, the Interrupt Vectors are not used, and regular program code can be placed at these
locations. The circuit diagram in Figure 8-1 on page 41  shows the reset logic. “System and
Reset Characteristics” on page 126 defines the electrical parameters of the reset circuitry.
Figure 8-1. Reset Logic
The I/O ports of the AVR are immediately reset to their initial state when a reset source goes
active. This does not require any clock source to be running.
After all reset sources have gone inactive, a delay counter is invoked, stretching the internal
reset. This allows the power to reach a stable level before normal operation starts. The time-out
period of the delay counter is defined by the user through the SUT and CKSEL fuses. The differ-
ent selections for the delay period are presented in “Clock Sources” on page 30. 
MCU Status
Register (MCUSR)
Brown-out
Reset CircuitBODLEVEL[1:0]
Delay Counters
CKSEL[1:0]
CK
TIMEOUT
WDRF
BORF
EXTRF
PORF
DATA BUS
Clock
Generator
SPIKE
FILTER
Pull-up Resistor
Watchdog
Oscillator
SUT[1:0]
Power-on Reset
Circuit
PAGE 42
ATtiny13A
 2021 Microchip Technology Inc.       Data Sheet Complete       DS40002307A-page 42 
8.2 Reset Sources
The ATtiny13A has four sources of reset:
• Power-on Reset. The MCU is reset when the s upply voltage is below the Power-on Reset 
threshold (VPOT).
• External Reset. The MCU is reset when  a low level is present on the RESET pin for longer 
than the minimum pulse length.
• Watchdog Reset. The MCU is reset when the Watchdog Timer period expires and the 
Watchdog is enabled.
• Brown-out Reset. The MCU is reset when the supply voltage V CC is below the Brown-out 
Reset threshold (VBOT) and the Brown-out Detector is enabled.
8.2.1 Power-on Reset
A Power-on Reset (POR) pulse is generated by an On-chip detection circuit. The detection level
is defined in “System and Reset Characteristics” on page 126 . The POR is activated whenever
VCC is below the detection level. The POR circuit can be used to trigger the Start-up Reset, as
well as to detect a failure in supply voltage.
A Power-on Reset (POR) circuit ensures that the device is reset from Power-on. Reaching the
Power-on Reset threshold voltage invokes the delay counter, which determines how long the
device is kept in RESET after V
CC rise. The RESET signal is activated again, without any delay,
when VCC decreases below the detection level.
Figure 8-2. MCU Start-up, RESET Tied to VCC
Figure 8-3. MCU Start-up, RESET Extended Externally
V
RESET
TIME-OUT
INTERNAL
RESET
tTOUT
VPOT
VRST
CC
RESET
TIME-OUT
INTERNAL
RESET
tTOUT
VPOT
VRST
VCC
PAGE 43
ATtiny13A
 2021 Microchip Technology Inc.       Data Sheet Complete       DS40002307A-page 43 
8.2.2 External Reset
An External Reset is generated by a low level on the RESET pin if enabled. Reset pulses longer
than the minimum pulse width ( See “System and Reset Characteristics” on page 126. ) will gen-
erate a reset, even if the clock is not runni ng. Shorter pulses are not ensured to generate a
reset. When the applied signal reaches the Reset Threshold Voltage – V RST – on its positive
edge, the delay counter starts the MCU after the Time-out period – tTOUT – has expired.
Figure 8-4. External Reset During Operation
8.2.3 Brown-out Detection
ATtiny13A has an On-chip Brown-out Detection (BOD) circuit for monitoring the VCC level during
operation by comparing it to a fixed trigger level. The trigger level for the BOD can be selected
by the BODLEVEL fuses. The trigger level has a hysteresis to ensure spike free Brown-out
Detection. The hysteresis on the detection level should be interpreted as V
BOT+ = VBOT + VHYST/2
and VBOT- = VBOT - VHYST/2.
When the BOD is enabled, and VCC decreases to a value below the trigger level (VBOT- in Figure
8-5 on page 43), the Brown-out Reset is immediately activated. When V CC increases above the
trigger level (VBOT+ in Figure 8-5 on page 43 ), the delay counter starts  the MCU after the Time-
out period tTOUT has expired.
The BOD circuit will only detect a drop in V CC if the voltage stays below the trigger level for lon-
ger than tBOD given in “System and Reset Characteristics” on page 126.
Figure 8-5. Brown-out Reset During Operation
CC
VCC
RESET
TIME-OUT
INTERNAL
RESET
VBOT -
VBOT+
tTOUT
PAGE 44
ATtiny13A
 2021 Microchip Technology Inc.       Data Sheet Complete       DS40002307A-page 44 
8.2.4 Watchdog Reset
When the Watchdog times out, it will generate a short reset puls e of one CK cycle duration. On
the falling edge of this pulse, the delay ti mer starts counting the Time-out period tTOUT. Refer to
“Interrupts” on page 51 for details on operation of the Watchdog Timer.
Figure 8-6. Watchdog Reset During Operation
8.3 Internal Voltage Reference
ATtiny13A features an internal bandgap reference. This reference is used for Brown-out Detec-
tion, and it can be used as an input to the Analog Comparator or the ADC.
8.3.1 Voltage Reference Enable Signals and Start-up Time
The voltage reference has a start-up time that may influence the way it should be used. The
start-up time is given in “System and Reset Characteristics” on page 126 . To save power, the
reference is not always turned on. The reference is on during the following situations:
• When the BOD is enabled (by pr ogramming the BODLEVEL[1:0] fuse).
• When the bandgap reference is connected to the Analog Comparator (by setting the ACBG 
bit in ACSR).
• When the ADC is enabled.
Thus, when the BOD is not enabled, after settin g the ACBG bit or enabling the ADC, the user
must always allow the reference to start up before the output from the Analog Comparator or
ADC is used. To reduce power consumption in Power-down mode, the user can avoid the three
conditions above to ensure that the reference is turned off before entering Power-down mode.
8.4 Watchdog Timer
ATtiny13A has an Enhanced Watchdog Timer (WDT). The WDT is a timer counting cycles of a
separate on-chip 128 kHz oscillator. The WDT gives an interr upt or a system reset when the
counter reaches a given time-out value. In normal operation mode, it is required that the system
uses the WDR - Watchdog Timer Reset - instructi on to restart the counter before the time-out
CK
CC
PAGE 45
ATtiny13A
 2021 Microchip Technology Inc.       Data Sheet Complete       DS40002307A-page 45 
value is reached. If the system doesn't restart th e counter, an interrupt or  system reset will be
issued.
Figure 8-7. Watchdog Timer
In Interrupt mode, the WDT gives an interrupt when the timer expires. This interrupt can be used
to wake the device from sleep-modes, and also as a general system timer. One example is to
limit the maximum time allowed for certain oper ations, giving an interrupt when the operation
has run longer than expected. In System Rese t mode, the WDT gives a reset when the timer
expires. This is typically used to prevent sy stem hang-up in case of runaway code. The third
mode, Interrupt and System Reset mode, combines the other two modes by first giving an inter-
rupt and then switch to System  Reset mode. This mode will for instance allow a safe shutdown
by saving critical parameters before a system reset. 
The Watchdog always on (WDTON) fuse, if programmed, will force the Watchdog Timer to Sys-
tem Reset mode. With the fuse programmed the System Reset mode bit (WDE) and Interrupt
mode bit (WDTIE) are locked to 1 and 0 respectively. To further ensure program security, alter-
ations to the Watchdog set-up must follow timed sequences. The sequence for clearing WDE
and changing time-out configuration is as follows:
1. In the same operation, write a logic one to the Watchdog change enable bit (WDCE) 
and WDE. A logic one must be written to WDE regardless of the previous value of the 
WDE bit.
2. Within the next four clock cycles, write th e WDE and Watchdog prescaler bits (WDP) as 
desired, but with the WDCE bit cleared. This must be done in one operation.
128kHz
OSCILLATOR
OSC/2K
OSC/4K
OSC/8K
OSC/16K
OSC/32K
OSC/64K
OSC/128K
OSC/256K
OSC/512K
OSC/1024K
WDP0 
WDP1
WDP2
WDP3
WATCHDOG
RESET
WDE
WDTIF
WDTIE
MCU RESET
INTERRUPT
PAGE 46
ATtiny13A
 2021 Microchip Technology Inc.       Data Sheet Complete       DS40002307A-page 46 
The following code example shows one assembly  and one C function for turning off the Watch-
dog Timer. The example assumes that interrupts  are controlled (e.g. by disabling interrupts
globally) so that no interrupts will occur during the execution of these functions.
Note: See “Code Examples” on page 12.
If the Watchdog is accidentally enabled, for example by a runaway pointer or brown-out condi-
tion, the device will be reset an d the Watchdog Timer will stay enab led. If the code is not set up
to handle the Watchdog, this might lead to an eternal loop of time-out resets. To avoid this situa-
Assembly Code Example
WDT_off:
; Turn off global interrupt
cli
; Reset Watchdog Timer
wdr
; Clear WDRF in MCUSR
in    r16, MCUSR
andi  r16, (0xff - (1<<WDRF))
out   MCUSR, r16
; Write logical one to WDCE and WDE
; Keep old prescaler setting to prevent unintentional time-out
in    r16, WDTCR
ori   r16, (1<<WDCE) | (1<<WDE)
out   WDTCR, r16
; Turn off WDT
ldi   r16, (0<<WDE)
out   WDTCR, r16
; Turn on global interrupt
sei
ret
C Code Example
void WDT_off(void)
{
__disable_interrupt();
__watchdog_reset();
/* Clear WDRF in MCUSR */
MCUSR &= ~(1<<WDRF);
/* Write logical one to WDCE and WDE */
/* Keep old prescaler setting to prevent unintentional time-out */
WDTCR |= (1<<WDCE) | (1<<WDE);
/* Turn off WDT */
WDTCR = 0x00;
__enable_interrupt();
}
PAGE 47
ATtiny13A
 2021 Microchip Technology Inc.       Data Sheet Complete       DS40002307A-page 47 
tion, the application software should always clear the Watchdog System Reset Flag (WDRF)
and the WDE control bit in the initialisation routine, even if the Watchdog is not in use.
The following code example shows one assembly and one C function for changing the time-out
value of the Watchdog Timer.
Note: See “Code Examples” on page 12.
The Watchdog Timer should be reset before any change of the WDP bits, since a change in the
WDP bits can result in a time-out when switching to a shorter time-out period.
Assembly Code Example
WDT_Prescaler_Change:
; Turn off global interrupt
cli
; Reset Watchdog Timer
wdr
; Start timed sequence
in    r16, WDTCR
ori   r16, (1<<WDCE) | (1<<WDE)
out   WDTCR, r16
; --  Got four cycles to set the new values from here -
; Set new prescaler(time-out) value = 64K cycles (~0.5 s)
ldi   r16, (1<<WDE) | (1<<WDP2) | (1<<WDP0)
out   WDTCR, r16
; --  Finished setting new values, used 2 cycles -
; Turn on global interrupt
sei
ret
C Code Example
void WDT_Prescaler_Change(void)
{
__disable_interrupt();
__watchdog_reset();
/* Start timed sequence */
WDTCR |= (1<<WDCE) | (1<<WDE);
/* Set new prescaler(time-out) value = 64K cycles (~0.5 s) */
WDTCR = (1<<WDE) | (1<<WDP2) | (1<<WDP0);
__enable_interrupt();
}
PAGE 48
ATtiny13A
 2021 Microchip Technology Inc.       Data Sheet Complete       DS40002307A-page 48 
8.5 Register Description
8.5.1 MCUSR – MCU Status Register
The MCU Status Register provides information on which reset source caused an MCU Reset.
• Bits 7:4 – Res: Reserved Bits
These bits are reserved bits in the ATtiny13A and will always read as zero.
• Bit 3 – WDRF: Watchdog Reset Flag
This bit is set if a Watchdog Reset occurs. The bit is reset by a Power- on Reset, or by writing a
logic zero to the flag.
• Bit 2 – BORF: Brown-out Reset Flag
This bit is set if a Brown-out Reset occurs. The bi t is reset by a Power-on Reset, or by writing a
logic zero to the flag.
• Bit 1 – EXTRF: External Reset Flag
This bit is set if an External Reset occurs. The bi t is reset by a Power-on Reset, or by writing a
logic zero to the flag.
• Bit 0 – PORF: Power-on Reset Flag
This bit is set if a Power-on Reset occurs. The bit is reset only by writing a logic zero to the flag.
To make use of the Reset Flags to identify a reset condition, the user should read and then reset
the MCUSR as early as possible in the program. If the register is cleared before another reset
occurs, the source of the reset can be found by examining the Reset Flags.
8.5.2 WDTCR – Watchdog Timer Control Register
• Bit 7 – WDTIF: Watchdog Timer Interrupt Flag
This bit is set when a time-out occurs in the Watchdog Timer and the Watchdog Timer is config-
ured for interrupt. WDTIF is cleared by hardwa re when executing the corresponding interrupt
handling vector. Alternatively, WDTIF is cleared by writing a logic one to the flag. When the I-bit
in SREG and WDTIE are set, the Watchdog Time-out Interrupt is executed.
• Bit 6 – WDTIE: Watchdog Timer Interrupt Enable
When this bit is written to one and the I-bit in the Status Register is set, the Watchdog Interrupt is
enabled. If WDE is cleared in combination with th is setting, the Watchdog Timer is in Interrupt
Mode, and the corresponding interrupt is executed if time-out in the Watchdog Timer occurs.
If WDE is set, the Watchdog Timer is in Interrupt  and System Reset Mode.  The first time-out in
the Watchdog Timer will set WDTIF. Executing the corresponding interrupt vector will clear
WDTIE and WDTIF automatically by hardware (the Watchdog goes to System Reset Mode).
B i t 76543210
0 x 3 4 –––– W D R F B O R F E X T R F P O R F M C U S R
R e a d / W r i t e RRRR R / W R / W R / W R / W
I n i t i a l  V a l u e 0000 S e e  B i t  D escription
B i t 76543210
0x21 WDTIF WDTIE WDP3 WDCE WDE WDP2 WDP1 WDP0 WDTCR
Read/Write R/W R/W R/W R/W R/W R/W R/W R/W
Initial Value 0 0 0 0 X 0 0 0
PAGE 49
ATtiny13A
 2021 Microchip Technology Inc.       Data Sheet Complete       DS40002307A-page 49 
This is useful for keeping the Watchdog Timer security while using the interrupt. To stay in Inter-
rupt and System Reset Mode, WDTIE must be set after each interrupt. This should however not
be done within the interrupt service routine itself, as this might compromise the safety-function of
the Watchdog System Reset mode. If the interrupt is not exec uted before the next time-out, a
System Reset will be applied.
Note: 1. WDTON fuse set to “0“ means programmed and “1“ means unprogrammed.
• Bit 4 – WDCE: Watchdog Change Enable
This bit is used in timed sequences for changing WDE and prescaler bits. To clear the WDE bit,
and/or change the prescaler bits, WDCE must be set.
Once written to one, hardware will clear WDCE after four clock cycles.
• Bit 3 – WDE: Watchdog System Reset Enable
WDE is overridden by WDRF in MCUSR. This means that WDE is always set when WDRF is
set. To clear WDE, WDRF must be cleared first. This feature ensures multiple resets during con-
ditions causing failure, and a safe start-up after the failure.
• Bit 5, 2:0 – WDP[3:0]: Watchdog Timer Prescaler 3, 2, 1 and 0
The WDP[3:0] bits determine the Watchdog Timer prescaling when the Watchdog Timer is run-
ning. The different pr escaling values and their correspondi ng time-out periods are shown in
Table 8-2 on page 49.
Table 8-1. Watchdog Timer Configuration
WDTON(1) WDE WDTIE Mode Action on Time-out
1 0 0 Stopped None
1 0 1 Interrupt Mode Interrupt
1 1 0 System Reset Mode Reset
111 Interrupt and System Reset 
Mode
Interrupt, then go to System 
Reset Mode
0 x x System Reset Mode Reset
Table 8-2. Watchdog Timer Prescale Select
WDP3 WDP2 WDP1 WDP0
Number of WDT Oscillator 
Cycles
Typical Time-out at 
VCC = 5.0V
0000 2 K  ( 2 0 4 8 )  c y c l e s 1 6  m s
0001 4 K  ( 4 0 9 6 )  c y c l e s 3 2  m s
0010 8 K  ( 8 1 9 2 )  c y c l e s 6 4  m s
0011 1 6 K  ( 1 6 384) cycles 0.125 s
0100 3 2 K  ( 3 2 768) cycles 0.25 s
0101 6 4 K  ( 6 5 536) cycles 0.5 s
0110 1 2 8 K  ( 1 3 1072) cycles 1.0 s
0111 2 5 6 K  ( 2 6 2144) cycles 2.0 s
1000 5 1 2 K  ( 5 2 4288) cycles 4.0 s
10011 0 2 4 K  ( 1 0 48576) cycles 8.0 s
PAGE 50
ATtiny13A
 2021 Microchip Technology Inc.       Data Sheet Complete       DS40002307A-page 50 
1010
Reserved
1011
1100
1101
1110
1111
Table 8-2. Watchdog Timer Prescale Select (Continued)
WDP3 WDP2 WDP1 WDP0
Number of WDT Oscillator 
Cycles
Typical Time-out at 
VCC = 5.0V
PAGE 51
ATtiny13A
 2021 Microchip Technology Inc.       Data Sheet Complete       DS40002307A-page 51 
9. Interrupts
This section describes the specifics of the interrupt handling as performed in ATtiny13A. For a
general explanation of the AVR in terrupt handling, refer to “Reset and Interrupt Handling” on
page 18.
9.1 Interrupt Vectors
The interrupt vectors of ATtiny13A are described in Table 9-1 below.
If the program never enables an interrupt source, the Interrupt Vectors are not used, and regular
program code can be placed at these locations.
The most typical and general program setup for the Reset and Interrupt Vector Addresses in
ATtiny13A is:
Address Labels Code Comments
0x0000 rjmp RESET ; Reset Handler
0x0001 rjmp EXT_INT0 ; IRQ0 Handler
0x0002 rjmp PCINT0 ; PCINT0 Handler
0x0003 rjmp TIM0_OVF ; Timer0 Overflow Handler
0x0004 rjmp EE_RDY ; EEPROM Ready Handler
0x0005 rjmp ANA_COMP ; Analog Comparator Handler
0x0006 rjmp TIM0_COMPA ; Timer0 CompareA Handler
0x0007 rjmp TIM0_COMPB ; Timer0 CompareB Handler
0x0008 rjmp WATCHDOG ; Watchdog Interrupt Handler
0x0009 rjmp ADC ; ADC Conversion Handler
;
0x000A RESET: ldi r16, low(RAMEND); Main program start
0x000B out SPL,r16 ; Set Stack Pointer to top of RAM
0x000C sei ; Enable interrupts
0x000D <instr>  xxx
  ...  ...    ...  ... 
Table 9-1. Reset and Interrupt Vectors
Vector No. Program Address Source Interrupt Definition
1 0x0000 RESET External Pin, Power-on Reset,
Brown-out Reset, Watchdog Reset
2 0x0001 INT0 External Interrupt Request 0
3 0x0002 PCINT0 Pin Change Interrupt Request 0
4 0x0003 TIM0_OVF Timer/Counter Overflow
5 0x0004 EE_RDY EEPROM Ready
6 0x0005 ANA_COMP Analog Comparator
7 0x0006 TIM0_COMPA Timer/Counter Compare Match A
8 0x0007 TIM0_COMPB Timer/Counter Compare Match B
9 0x0008 WDT Watchdog Time-out
10 0x0009 ADC ADC Conversion Complete
PAGE 52
ATtiny13A
 2021 Microchip Technology Inc.       Data Sheet Complete       DS40002307A-page 52 
9.2 External Interrupts
The External Interrupts are triggered by the INT0  pin or any of the PC INT[5:0] pins. Observe
that, if enabled, the interrupts will trigger even if  the INT0 or PCINT[5:0] pins are configured as
outputs. This feature provides a way of generating a software interrupt. Pin change interrupts
PCI will trigger if any enabled PCINT[5:0] pin t oggles. The PCMSK Register control which pins
contribute to the pin change interrupts. Pin cha nge interrupts on PCINT[5:0] are detected asyn-
chronously. This implies that these interrupts can be used for waking the part also from sleep
modes other than Idle mode.
The INT0 interrupts can be triggered by a falling or rising edge or a low level. This is set up as
indicated in the specification for the MCU Control Register – MCUCR. When the INT0 interrupt is
enabled and is configured as leve l triggered, the interr upt will trigger as long as the pin is held
low. Note that recognition of falling or rising edge interrupts on INT0 requires the presence of an
I/O clock, described in “Clock Systems and their Distribution” on page 29.
9.2.1 Low Level Interrupt
A low level interrupt on INT0 is detected asynchr onously. This implies that this interrupt can be
used for waking the part also from sleep modes other than Idle mode. The I/O clock is halted in
all sleep modes except Idle mode.
Note that if a level triggered interrupt is used for wake-up from Power-do wn, the required level
must be held long enough for the MCU to complete the wake-up to trigger the level interrupt. If
the level disappears before the end of the Start-up Time, the MCU will still wake up, but no inter-
rupt will be generated. The start-up time is defined by the SUT and CKSEL fuses as described in
“System Clock and Clock Options” on page 29.
If the low level on the interrupt pin is removed before the device has woken up then program
execution will not be diverted to the interrupt service routine but continue from the instruction fol-
lowing the SLEEP command.
9.2.2 Pin Change Interrupt Timing
An example of timing of a pin change interrupt is shown in Figure 9-1 below.
Figure 9-1. Timing of pin change interrupts
clk
PCINT(n)
pin_lat
pin_sync
pcint_in_(n)
pcint_syn
pcint_setflag
PCIF
PCINT(0)
pin_sync
pcint_syn
pin_lat
D     Q
LE
pcint_setflag
PCIF
clk
clk
PCINT(0) in PCMSK(x)
pcint_in_(0) 0
x
PAGE 53
ATtiny13A
 2021 Microchip Technology Inc.       Data Sheet Complete       DS40002307A-page 53 
9.3 Register Description
9.3.1 MCUCR – MCU Control Register
The External Interrupt Control Register A contains control bits for interrupt sense control.
• Bits 1:0 – ISC0[1:0]: Interrupt Sense Control 0 Bit 1 and Bit 0
The External Interrupt 0 is activated by the exte rnal pin INT0 if the SREG I-flag and the corre-
sponding interrupt mask are set. The level and ed ges on the external INT0  pin that activate the
interrupt are defined in Table 9-2 on page 53 . The value on the INT0 pin is sampled before
detecting edges. If edge or toggle  interrupt is selected, pulses that last longer than one clock
period will generate an interrupt. Shorter pulses are not ensured to generat e an interrupt. If low
level interrupt is selected, the low level must be held until the completion of the currently execut-
ing instruction to generate an interrupt.
9.3.2 GIMSK – General Interrupt Mask Register
• Bits 7, 4:0 – Res: Reserved Bits
These bits are reserved bits in the ATtiny13A and will always read as zero.
• Bit 6 – INT0: External Interrupt Request 0 Enable
When the INT0 bit is set (one) and the I-bit in the Status Register (SREG) is set (one), the exter-
nal pin interrupt is enabled. The Interrupt Sense Control0 bits 1/0 (ISC01 and ISC00) in the MCU
Control Register (MCUCR) define whether the external interrupt is activated on rising and/or fall-
ing edge of the INT0 pin or le vel sensed. Activity on the pin will cause an interrupt request even
if INT0 is configured as an output. The corresponding interrupt of External Interrupt Request 0 is
executed from the INT0 Interrupt Vector.
• Bit 5 – PCIE: Pin Change Interrupt Enable
When the PCIE bit is set (one) and the I-bit in the Status Register (SREG) is set (one), pin
change interrupt is enabled. Any change on any enabled PCINT[ 5:0] pin will cause an interrupt.
The corresponding interrupt of Pin Change Interr upt Request is executed from the PCI Interrupt
Vector. PCINT[5:0] pins are enabled individually by the PCMSK Register.
B i t 76543210
0x35 – PUD SE SM1 SM0 – ISC01 ISC00 MCUCR
Read/Write R R/W R/W R/W R/W R R/W R/W
I n i t i a l  V a l u e 00000000
Table 9-2. Interrupt 0 Sense Control
ISC01 ISC00 Description
0 0 The low level of INT0 generates an interrupt request.
0 1 Any logical change on INT0 generates an interrupt request.
1 0 The falling edge of INT0 generates an interrupt request.
1 1 The rising edge of INT0 generates an interrupt request.
B i t 76543210
0x3B – INT0 PCIE – – – – – GIMSK
R e a d / W r i t eR R / W R / W RRRRR
I n i t i a l  V a l u e 00000000
PAGE 54
ATtiny13A
 2021 Microchip Technology Inc.       Data Sheet Complete       DS40002307A-page 54 
9.3.3 GIFR – General Interrupt Flag Register
• Bits 7, 4:0 – Res: Reserved Bits
These bits are reserved bits in the ATtiny13A and will always read as zero.
• Bit 6 – INTF0: External Interrupt Flag 0
When an edge or logic change on the INT0 pin triggers an interrupt request, INTF0 becomes set
(one). If the I-bit in SREG and the INT0 bit in GIMSK are set (one), the MCU will jump to the cor-
responding Interrupt Vector. The flag is cleared when the interrupt routine is executed.
Alternatively, the flag can be cleared by writing a logical one to it. This flag is always cleared
when INT0 is configured as a level interrupt.
• Bit 5 – PCIF: Pin Change Interrupt Flag
When a logic change on any PCINT[ 5:0] pin triggers an interrupt request, PCIF becomes set
(one). If the I-bit in SREG and the PCIE bit in GIMSK are set (one), the MCU will jump to the cor-
responding Interrupt Vector. The flag is cleared when the interrupt routine is executed.
Alternatively, the flag can be cleared by writing a logical one to it.
9.3.4 PCMSK – Pin Change Mask Register
• Bits 7:6 – Res: Reserved Bits
These bits are reserved bits in the ATtiny13A and will always read as zero.
• Bits 5:0 – PCINT[5:0]: Pin Change Enable Mask 5:0
Each PCINT[5:0] bit selects whether pin c hange interrupt is enabled on the corresponding I/O
pin. If PCINT[5:0] is set and the PCIE bit in GIMSK is set, pin change interrupt is enabled on the
corresponding I/O pin. If PCINT[5:0] is cleared, pin change interrupt on the corresponding I/O
pin is disabled.
B i t 76543210
0 x 3 A – I N T F 0 P C I F ––––– G I F R
R e a d / W r i t eR R / W R / W RRRRR
I n i t i a l  V a l u e 00000000
B i t 76543210
0x15 – – PCINT5 PCINT4 PCINT3 PCINT2 PCINT1 PCINT0 PCMSK
Read/Write R R R/W R/W R/W R/W R/W R/W
I n i t i a l  V a l u e 00000000
PAGE 55
ATtiny13A
 2021 Microchip Technology Inc.       Data Sheet Complete       DS40002307A-page 55 
10. I/O Ports
10.1 Overview
All AVR ports have true Read-Modify-Write functi onality when used as general digital I/O ports.
This means that the direction of one port pin can be changed without unintentionally changing
the direction of any other pin with the SBI and CBI instructions. The same applies when chang-
ing drive value (if configured as output) or enabling/disabling of pull-up resistors (if configured as
input). Each output buffer has symmetrical drive characteristics with both high sink and source
capability. The pin driver is stro ng enough to drive LED displays di rectly. All port pins have indi-
vidually selectable pull-up resistors with a supply-voltage invariant resistance. All I/O pins have
protection diodes to both V
CC and Ground as indicated in Figure 10-1. Refer to “Electrical Char-
acteristics” on page 123 for a complete list of parameters.
Figure 10-1. I/O Pin Equivalent Schematic
All registers and bit references in this section are written in general form. A lower case “x” rep-
resents the numbering letter for the port, and a lower case “n” represents the bit number.
However, when using the register or bit defines in a program, the precise form must be used. For
example, PORTB3 for bit no. 3 in Port B, here documented generally as PORTxn. The physical
I/O Registers and bit locations are listed in “Register Description” on page 63.
Three I/O memory address locations are allocated for each port, one each for the Data Register
– PORTx, Data Direction Register  – DDRx, and the Port Input Pins – PINx. The Port Input Pins
I/O location is read only, while the Data Register and the Data Direction Register are read/write.
However, writing a logic one to a bit in the PINx Register, will result in a toggle in the correspond-
ing bit in the Data Regi ster. In addition, the Pull-up Disabl e – PUD bit in MCUCR disables the
pull-up function for all pins in all ports when set.
Using the I/O port as General Digital I/O is described in “Ports as General Digital I/O” on page
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
