Alksndr55/mesh-repeater-2.0/audit/V2_ENGINEERING_AUDIT_A3_2026_10_13/SOFTWARE_BOM_pdf_MeshRepeater2_assembly_dimensions.txt

PAGE 1
Сборка - настоящая геометрия экспортов KiCad
Mesh Repeater 2.0 | native STEP + номинальная цепочка крепежа | 12.10.2026
1/4
Габариты и зазоры модели
POWER над платой
12.540 мм
POWER до экрана
5.960 мм
LOGIC под платой
10.740 мм
LOGIC до экрана
5.270 мм
Стойка до компонентов, ≥
1.405 мм
Полная высота модели
45.560 мм
Номинальная размерная цепь
Зазор POWER - экран
18.500 мм
Зазор экран - LOGIC
16.000 мм
Внешние поверхности PCB
39.060 мм
Все три PCB: 90 × 60 мм.
Полный CAD: 98,00 × 70,01 × 45,56 мм.
Размеры выше не включают внешний кабель.
С петлёй Y≤−23: по Y ориентировочно
не менее 90,21 мм; проверить на образце.
Стойки M3: 18 мм снизу, 15 мм сверху.
Отверстия Ø3,2; контакты GND Ø6 мм.
Центры: (3,5;3,5), (86,5;3,5),
(3,5;56,5), (86,5;56,5) мм.
Маска отсутствует в STEP.
Экран: 1,475 FR4 + 0,035 Cu = 1,510 мм.
Зазоры вычислены из native STEP. Модели Nice!Nano, модема и SMA остаются приближенными.
Нулевые пересечения плат подтверждены геометрией моделей; реальные модули и сопряжения требуют образца.
В STEP LOGIC возможен пропуск двух мелких контуров меди; нативная плата проходит DRC. См. отчёт экспорта.

PAGE 2
Размерная цепь крепежа - номинальные значения
Mesh Repeater 2.0 | native STEP + номинальная цепочка крепежа | 12.10.2026
2/4

PAGE 3
Разнесённая сборка - вид со стороны компонентов LOGIC
Mesh Repeater 2.0 | native STEP + номинальная цепочка крепежа | 12.10.2026
3/4
Состояние проверки
POWER, SHIELD, LOGIC: объём
взаимных пересечений равен нулю.
Стойки проверены окружностью
описанного шестигранника 5,5 мм.
Это исключает зависимость от угла
его поворота около оси винта.
Сопряжение резьбы не моделируется.
Кабель и ответные IDC не показаны.
J10 / ISP обслуживается при разборке.
Исходные STEP, SHA-256
POWER
2d9c918ee043136dfaef1e14b60d5290a0680b530e72f640735c68fcc2529180
SHIELD
8c23e9ee3fb08ea45e552653249f9a4261b22061e22852d5904f20af8a7991f3
LOGIC
ef4dcec5bde1ae790ecb1ea946c77f794a2e094711ad20e696f5d3c87b4663c3
Полные native PCB SHA и результаты
зазоров: assembly_geometry_report.json.
PDF и PNG связаны с теми же исходниками.
Замена этих исходников требует
повторного экспорта и пересборки.
Физический контроль: размеры Type-C/модулей, глубина резьбы, зацепление,
зажим металлических шайб, посадка IDC и свободная прокладка кабеля.

PAGE 4
Межплатный кабель - размерное предложение
Mesh Repeater 2.0 | native STEP + номинальная цепочка крепежа | 12.10.2026
4/4
