Alksndr55/mesh-repeater-2.0/audit/V2_ENGINEERING_AUDIT_A3_2026_10_13/SOFTWARE_BOM_pdf_MeshRepeater2_Logic_A3_schematic.txt

PAGE 1
1
2 3 4 5 6 7 8 1
2 3 4 5 6 7 8 A
BCDEFA
BCDEFDate: 2026-10-13KiCad E.D.A. 10.0.6Rev: V2.0-A3Size: A3Id: 1/4Title: Nice!Nano / HT-RA62File: MeshRepeater2_Logic.kicad_schSheet: /Электрическая принципиальная; прототип2. RTC_IOФайл: RTC_IO.kicad_sch3. WatchdogФайл: Watchdog.kicad_sch4. InterconnectФайл: Interconnect.kicad_schC2110uF 16V X7RC24100nF 50V X7RR3110kSW1USERANT 1GND23V33RST4TXEN_=_DIO25DIO16DIO2_=_TXEN7DIO38GND9BUSY10RXEN11SCK12MISO13MOSI14NSS15GND16M2HT-RA62C22100nF 50V X7R1 2NT1Cu link / cut for FL1FB160R@100MHz / 3AGND1IN2GND3GND4OUT5GND6FL1S869M000S003RF1SHIELD2J13SMA 50OhmR2433RR2333RP0.09_/_RADIO_RST1 P0.10_/_DIO12 P1.11_/_SCK3P1.13_/_NSS4P1.15_/_MOSI5 P0.02_/_MISO6 P0.29_/_BUSY7 P0.31_/_BAT_ADC8VCC_/_MOD_3V39RESET10GND11RAW_-_NC12BAT_-_NC13P1.06_/_spare 14 P1.04_/_SDA15P0.11_/_SCL16P1.00_/_USER_BTN17P0.24_/_GPS_EN_/_DIGITAL_OUT18P0.22_/_GPS_RX19P0.20_/_GPS_TX20P0.17_/_RXEN 21 GND22GND23P0.08_/_UART_RX24P0.06_/_UART_TX25GND26M1NiceNano_CLONE_MODIFIEDC25100nF 50V X7RC23 22uF 25V X5RR272.2M 0.1%SW2RESETR282.2M 0.1%R25 33RR35100kC26100nF 50V X7RR2633RUART_TXMCU_RESETUSER_BTN RADIO_3V3
BAT_ADCSYS_3V3 BAT_ADCSYS_3V3USER_BTNUART_RXSYS_3V3GPS_RX_MCUMCU_RESETSYS_3V3 GPS_TX_MCURADIO_TXEN GPS_ENSCLSDABATUSER_BTNRADIO_BUSY
RADIO_RSTRADIO_DIO1ANT_RF ANT_SMARADIO_LOCAL_3V3RADIO_RXEN0805 3V3 через J11 на POWER; RAW/BAT: NC. USB-зарядник отключить.Снять шунт J11 ДО подключения USB.Вернуть J11 только после отключения USB.BLM21PG600SN1D
POWER: 
J11 → NT2-звезда → две ветви. Модем: RADIO_3V3 → FB1 → RADIO_LOCAL_3V3.0805RG2012P-225-B-T5FB1: DCR ≤20 мОм; около 3 мВ при 150 мА. Проверить броски питания при TX осциллографом.SPI: 33 Ом у драйверов.ANT: J13 / SMA, 50 Ом.TXEN → MODE и watchdog.P1.06 свободен.BUSY=P0.29; GPS_EN=P0.24.GPS_EN=HIGH: питание GPS включено.Nice!Nano, HT-RA62, управление и измерение батареиL-KLS1-SMA002-B
S869M000S003 / опция0805RC0805FR-0733RL / 0805CL21B104KBCNNNC module16x17 mm, P2.0HT-RA62 / диапазон выбратьRC0805FR-0733RL / 0805CL21B104KBCNNNC 0805RC0805FR-07100KLCL21A226MAQNNNE THT 
7.11x7.01 / side0805
RC0805FR-0710KLTHT 7.11x7.01 / sideDCC6C / 3 x 3 x 1.3 mm08050805CL21B104KBCNNNCV2.0-A3 / 2026-10-13 / инженерный прототипFL1 
— опция 868–870 МГц, TX ≤ +13 dBm.До установки разрезать медь NT1 под FL1.Без FL1 оставить NT1 целой.SMA / угловой / PTH1825027-2 / FSMRA1JH04ADC: BAT/2; τ ≈ 110 мс. Калибровка ADC.08050805 RC0805FR-0733RL / 0805RC0805FR-0733RL / 0805ProMicro / доработкаNice!Nano / клонHT-RA62: R1 = 0 Ом (ANT); R2 снять (IPEX).R1/R2 здесь — резисторы внутри модуля.Подключать антенну только к J13.CL21B104KBCNNNC0805 
/ 2 x 1.25 mmRG2012P-225-B-T50805 CL21B106KOQNNNE1825027-2 / FSMRA1JH04FL1 S869M000S003GND1IN2GND3GND4OUT5GND6NT1Cu link / cut for FL112
PAGE 2
1
2 3 4 5 6 7 8 1
2 3 4 5 6 7 8 A
BCDEFA
BCDEFDate: 2026-10-13KiCad E.D.A. 10.0.6Rev: V2.0-A3Size: A3Id: 2/4Title: DS3231M / разъёмыFile: RTC_IO.kicad_schSheet: /2. RTC_IO/Электрическая принципиальная; прототипR30
4.7k32kHz1VCC2INT/SQW3RST4GND5VBAT6SDA7SCL8U4DS3231MZ+TRLG
1S2D3Q2AO3401A11223344J5UART3V3R42100kR441k+
-BT1CR2032 / holderR46 100kG1S2D3Q32N7002KC27100nF 50V X7RR43 100kR294.7kOE1
11A_/_MCU_TX22Y_/_MCU_RX3 GND42A_/_GPS_TX51Y_/_GPS_RX6OE27VCC_GPS8U7SN74LVC2G125RESET_N1PPS2WAKE_UP3RXD_GPS4TXD_GPS5V_BCKP6VCC7GND8MountsMPJ4GPS / T114 P3R45100kC56 100nF 50V X7R1 C5710uF 16V X7R11223344J3I2C3V3SCLSYS_3V3 GPS_3V3GPS_3V3SYS_3V3UART_TXUART_RXGPS_3V3 SYS_3V3SDAGPS_ENGPS_3V3 SYS_3V3GPS_3V3GPS_3V3GPS_3V3 GPS_TX_MCUGPS_TX_EXT GPS_RX_EXTGPS_TX_MCUGPS_TX_EXTGPS_RX_EXTSYS_3V3SCLSDAGPS_TX_EXT SYS_3V3SYS_3V3GPS_RX_MCU GPS_GATERTC_BATGPS_EN_GATE V2.0-A3 / 2026-10-13 / инженерный прототипDS3231M / CR2032, разъёмы и экранJ4.1 
/ .3: внутренние подтяжки L76K; .2 PPS не используется.0805
CL21B106KOQNNNE J4.6: 
резерв 3,3 В постоянно; J4.7: питание через Q2.SN74LVC2G125DCTRRC0805FR-07100KLCL21B104KBCNNNC 0805SOT-230805RC0805FR-074K7LCL21B104KBCNNNC0805 2N7002K 08050805RC0805FR-07100KL 08051 x 8 / 1.25 mm / SMD08050805RC0805FR-074K7LDS3231M: SO-8; точность ±5 ppm; SQW только 1 Гц.1x4 / 2.54 / 90degRC0805FR-07100KL 0805I²C: 0x68. INT/SQW не используется.CR2032: без зарядки. Установить после пайки.SOIC-8 / 3.9 mmDS3231MZ+TRLAO3401A SOT-23RC0805FR-071KLGPS_EN = P0.24: HIGH включено; LOW / Hi-Z выключено.DS1022-1x40RUF11-B
DS1022-1x40RUF11-BKeystone 1060 / держательCR2032 holder, SMDRC0805FR-07100KL 1x4 / 2.54 / 90degСредний экран: отдельная плата 90×60; GND через стойки.T114 V2.1 P3: порядок контактов; корпус кабеля проверить.53261-0871
SSOP-8 / DCT / 0.65 mmU7: Ioff; UART не подпитывает выключенный GPS.EOSC=0; BBSQW=0; INTCN=1; EN32kHz=0.Проверять OSF; снять после установки времени.J4 GPS / T114 P3RESET_N1PPS2WAKE_UP3RXD_GPS4TXD_GPS5V_BCKP6VCC7GND8MountsMPBT1CR2032 / holder+-J5 UART3V311223344J3I2C3V311223344
PAGE 3
1
2 3 4 5 6 7 8 1
2 3 4 5 6 7 8 A
BCDEFA
BCDEFDate: 2026-10-13KiCad E.D.A. 10.0.6Rev: V2.0-A3Size: A3Id: 3/4Title: ATtiny13A / watchdogFile: Watchdog.kicad_schSheet: /3. Watchdog/Электрическая принципиальная; прототипR37
0RR3610kR39100k1 12233445566J10AVR ISP 3V3PB5_/_RESET1PB3_/_TXEN_IN2PB43GND4PB0_/_RESET_OD_/_MOSI5 PB1_/_MISO6PB2_/_SCK7VCC8U6ATtiny13A-SSUR381kR33 10kC33100nF 50V X7RRADIO_TXENWDT_RESETWDT_MOSI_RESET WDT_MOSI_RESET WDT_SCKWDT_MISOWDT_RESETMCU_RESETSYS_3V3WDT_MISOSYS_3V3SYS_3V3 WDT_SCKTXEN HT-RA62 → R38 → PB3 (вывод 2). Контроль появления передач.Плата питается сама: питание цели от программатора отключить. Для ISP снять R37.0805RC0805FR-071KL0805J10: стандартный AVR ISP, уровни 3,3 В; SCK ≤ 10 кГц после установки fuse.CL21B104KBCNNNCATtiny13A — внешний watchdog из пользовательского проекта2 x 3 / 2.54 mm0805RC0805FR-07100KLRC0805FR-0710KL 0805DS1021-2X5SF11-B0805Нет импульсов TXEN: 1350 тактов WDT по 8 с ≈ 3 ч; затем RESET ≈ 1 с.V2.0-A3 / 2026-10-13 / инженерный прототипПрошивка: 
watchdog/main.c. Штатное молчание радио более ≈3 ч также вызовет сброс.BOD следит за SYS_3V3; порог EN батареи не меняется. Проверить восстановление и ток сна.PB0 (вывод 5): только LOW или Hi-Z. RESET ATtiny (вывод 1) — отдельная цепь.ATTINY13A-SSUSOIC-8 / 3.9 mmСначала FLASH, затем LFUSE=0x7B / HFUSE=0xFB: 128 кГц, SUT ≈64 мс, BOD 2,7 В.RC0805FR-0710KL0805 RC0805FR-070RLJ10 AVR ISP 3V3112233445566
PAGE 4
1
2 3 4 5 6 7 8 1
2 3 4 5 6 7 8 A
BCDEFA
BCDEFDate: 2026-10-13KiCad E.D.A. 10.0.6Rev: V2.0-A3Size: A3Id: 4/4Title: Межплатное соединение / POWER ↔ LOGICFile: Interconnect.kicad_schSheet: /4. Interconnect/Электрическая принципиальная; прототипGND
1H201M3 GND contactTP4R211kGND
1H202M3 GND contactTP711GND
1H204M3 GND contactGND1H203M3 GND contactSYS_3V3
1GND2SYS_3V33GND4RADIO_3V35GND6RADIO_3V37NC8BAT9SDA10MODE11SCL12J201INTERBOARD 2x6 VERTICALRADIO_TXENSCL RADIO_3V3RADIO_3V3BATSYS_3V3MODESYS_3V3SYS_3V3SYS_3V3 SDAMODEMTJ H8.5 2X6P 10PCS0805J11 перенесена на POWER: один съёмный шунт для АКБ/солнца.R21 оставлен 1 кОм: RADIO_TXEN → R21 → MODE через штыри.Mesh Repeater 2.0 — LOGIC / межплатные соединенияРаспиновка 
прямого соединения — interboard_connections.csv.V2.0-A3 
/ 2026-10-13 / инженерный прототипДо USB снять J11; вернуть только после отключения USB.RC0805FR-071KLЭкран/стойки: только GND/EMI; не обязательный силовой возврат.THT 2x6 / 2.54 / verticalJ201INTERBOARD 2x6 VERTICALSYS_3V31GND2SYS_3V33GND4RADIO_3V35GND6RADIO_3V37NC8BAT9SDA10MODE11SCL12
