Alksndr55/mesh-repeater-2.0/audit/V2_ENGINEERING_AUDIT_A3_2026_10_13/SOFTWARE_BOM_pdf_MeshRepeater2_Logic_schematic.txt

PAGE 1
1
2 3 4 5 6 7 8 1
2 3 4 5 6 7 8 A
BCDEFA
BCDEFDate: 2026-10-11KiCad E.D.A. 10.0.6Rev: V2.0-A1Size: A3Id: 1/4Title: Nice!Nano / HT-RA62File: MeshRepeater2_Logic.kicad_schSheet: /Электрическая принципиальная; прототип4. InterconnectФайл: Interconnect.kicad_sch2. RTC_IOФайл: RTC_IO.kicad_sch3. WatchdogФайл: Watchdog.kicad_schSW1USERR35 100kP0.09_/_RADIO_RST1 P0.10_/_DIO12 P1.11_/_SCK3P1.13_/_NSS4P1.15_/_MOSI5 P0.02_/_MISO6 P0.29_/_BUSY7 P0.31_/_BAT_ADC8VCC_/_MOD_3V39RESET10GND11RAW_-_NC12BAT_-_NC13P1.06_/_spare 14 P1.04_/_SDA15P0.11_/_SCL16P1.00_/_USER_BTN17P0.24_/_GPS_EN_/_DIGITAL_OUT18P0.22_/_GPS_RX19P0.20_/_GPS_TX20P0.17_/_RXEN 21 GND22GND23P0.08_/_UART_RX24P0.06_/_UART_TX25GND26M1NiceNano_CLONE_MODIFIEDR23 33RR2533RGND
1IN2GND3GND4OUT5GND6FL1S869M000S003R2433RFB1 60R@100MHz / 3AR282.2M 0.1%SW2RESET1 2NT1Cu link / cut for FL1C26100nF 50V X7RC23 22uF 25V X5RRF1SHIELD2J13SMA 50OhmC2110uF 16V X7RANT1GND23V33RST4TXEN_=_DIO25DIO16DIO2_=_TXEN7DIO38GND9BUSY10RXEN11SCK12MISO13MOSI14NSS15GND16M2HT-RA62R272.2M 0.1%C25100nF 50V X7RC22 100nF 50V X7RC24100nF 50V X7RR3110kR26 33RSYS_3V3SCLUSER_BTNSDARADIO_TXEN SYS_3V3BATSYS_3V3 MCU_RESETUSER_BTNBAT_ADCGPS_TX_MCUMCU_RESETUSER_BTN SYS_3V3UART_TXUART_RXGPS_RX_MCUBAT_ADCGPS_ENSYS_3V3 ANT_RFANT_SMARADIO_RXENRADIO_3V3 RADIO_RSTRADIO_DIO1RADIO_BUSY1825027-2 
/ FSMRA1JH04ADC: BAT/2; τ ≈ 110 мс. Калибровка ADC.Nice!Nano, HT-RA62, управление и измерение батареиV2.0-A1 / 2026-10-11 / инженерный прототипRG2012P-225-B-T5
0805Nice!Nano / клонProMicro / доработка1825027-2 / FSMRA1JH04L-KLS1-SMA002-B HT-RA62: R1 = 0 Ом (ANT); R2 снять (IPEX).R1/R2 здесь — резисторы внутри модуля.Подключать антенну только к J13.SMA / угловой / PTHFL1 — опция 868–870 МГц, TX ≤ +13 dBm.До установки разрезать медь NT1 под FL1.Без FL1 оставить NT1 целой.0805DCC6C / 3 x 3 x 1.3 mmCL21B104KBCNNNC0805RC0805FR-0710KLCL21B104KBCNNNC SPI: 33 Ом у драйверов.ANT: J13 / SMA, 50 Ом.TXEN → MODE и watchdog.P1.06 свободен.BUSY=P0.29; GPS_EN=P0.24.GPS_EN=HIGH: питание GPS включено.S869M000S003 / опция08050805 
/ 2 x 1.25 mmBLM21PG600SN1D0805CL21B106KOQNNNE CL21B104KBCNNNC0805RG2012P-225-B-T53V3 через J11; RAW/BAT: NC. USB-зарядник отключить.Снять шунт J11 ДО подключения USB.Вернуть J11 только после отключения USB.Модем: отдельная ветвь J11 → FB1 → RADIO_3V3. GPS/RTC питаются до FB1.CL21B104KBCNNNCFB1: DCR ≤20 мОм; около 3 мВ при 150 мА. Проверить броски питания при TX осциллографом.module16x17 mm, P2.008050805 CL21A226MAQNNNEHT-RA62 / диапазон выбрать0805RC0805FR-0733RL / 0805RC0805FR-0733RL / 0805RC0805FR-0733RL / 0805RC0805FR-0733RL / 0805RC0805FR-07100KLTHT 7.11x7.01 / side0805 THT 7.11x7.01 / sideFL1 S869M000S003GND1IN2GND3GND4OUT5GND6NT1Cu link / cut for FL112
PAGE 2
1
2 3 4 5 6 7 8 1
2 3 4 5 6 7 8 A
BCDEFA
BCDEFDate: 2026-10-11KiCad E.D.A. 10.0.6Rev: V2.0-A1Size: A3Id: 2/4Title: DS3231M / разъёмыFile: RTC_IO.kicad_schSheet: /2. RTC_IO/Электрическая принципиальная; прототипR46
100kR45100kRESET_N 1PPS2WAKE_UP3RXD_GPS4TXD_GPS5V_BCKP6VCC7GND8MountsMPJ4GPS / T114 P332kHz1VCC2INT/SQW3RST4GND5VBAT6SDA7SCL8U4DS3231MZ+TRLR29 4.7kR304.7kR43 100kC56 100nF 50V X7RR42100k11223344J5UART3V3G1S2D3Q2AO3401AR441k11223344J3I2C3V3+
-BT1CR2032 / holderC57 10uF 16V X7ROE111A_/_MCU_TX22Y_/_MCU_RX3 GND42A_/_GPS_TX51Y_/_GPS_RX6OE27VCC_GPS8U7SN74LVC2G125G1S2D3Q32N7002KC27100nF 50V X7R1
SYS_3V3SYS_3V3SCLSYS_3V3UART_TXUART_RXGPS_3V3 SYS_3V3SDASCLGPS_ENSDAGPS_3V3 GPS_3V3GPS_TX_MCUGPS_3V3GPS_3V3GPS_TX_EXTGPS_TX_MCUGPS_3V3GPS_3V3SYS_3V3SYS_3V3 GPS_RX_MCU GPS_RX_EXTGPS_TX_EXTGPS_RX_EXTGPS_TX_EXTSYS_3V3 GPS_GATEGPS_EN_GATERTC_BAT0805 SOT-230805RC0805FR-07100KL2N7002KEOSC=0; BBSQW=0; INTCN=1; EN32kHz=0.I²C: 0x68. INT/SQW не используется.Проверять OSF; снять после установки времени.CR2032: без зарядки. Установить после пайки.DS3231M: SO-8; точность ±5 ppm; SQW только 1 Гц.CR2032 holder, SMDKeystone 1060 / держательCL21B106KOQNNNE DS3231M / CR2032, разъёмы и экранV2.0-A1 / 2026-10-11 / инженерный прототипCL21B104KBCNNNC0805J4.1 
/ .3: внутренние подтяжки L76K; .2 PPS не используется.DS1022-1x40RUF11-BU7: Ioff; UART не подпитывает выключенный GPS.0805
T114 
V2.1 P3: порядок контактов; корпус кабеля проверить.Средний экран: отдельная плата 90×60; GND через стойки.1 x 8 / 1.25 mm / SMDAO3401ASSOP-8 / DCT / 0.65 mmDS1022-1x40RUF11-BRC0805FR-07100KL1x4 / 2.54 / 90degRC0805FR-071KLSN74LVC2G125DCTR SOT-230805GPS_EN = P0.24: HIGH включено; LOW / Hi-Z выключено.RC0805FR-07100KL0805SOIC-8 / 3.9 mmDS3231MZ+TRL0805 53261-0871CL21B104KBCNNNCJ4.6: резерв 3,3 В постоянно; J4.7: питание через Q2.RC0805FR-074K7L
08051x4 / 2.54 / 90degRC0805FR-074K7L0805RC0805FR-07100KL 0805BT1CR2032 / holder+-J5 UART3V311223344J4 GPS / T114 P3RESET_N1PPS2WAKE_UP3RXD_GPS4TXD_GPS5V_BCKP6VCC7GND8MountsMPJ3I2C3V311223344
PAGE 3
1
2 3 4 5 6 7 8 1
2 3 4 5 6 7 8 A
BCDEFA
BCDEFDate: 2026-10-11KiCad E.D.A. 10.0.6Rev: V2.0-A1Size: A3Id: 3/4Title: ATtiny13A / watchdogFile: Watchdog.kicad_schSheet: /3. Watchdog/Электрическая принципиальная; прототипR38
1kC33100nF 50V X7RR39100kR37 0RR3310kPB5_/_RESET1PB3_/_TXEN_IN2PB43GND4PB0_/_RESET_OD_/_MOSI5 PB1_/_MISO6PB2_/_SCK7VCC8U6ATtiny13A-SSU1 12233445566J10AVR ISP 3V3R3610kWDT_MISO WDT_RESETWDT_SCK WDT_MISOWDT_MOSI_RESETWDT_MOSI_RESETSYS_3V3 WDT_RESETMCU_RESETSYS_3V3SYS_3V3WDT_SCK RADIO_TXEN0805RC0805FR-07100KLCL21B104KBCNNNCRC0805FR-0710KLRC0805FR-071KL08050805DS1021-2X5SF11-B V2.0-A1 / 2026-10-11 / инженерный прототипATtiny13A — внешний watchdog из пользовательского проекта0805 RC0805FR-0710KL2 x 3 / 2.54 mmTXEN HT-RA62 → R38 → PB3 (вывод 2). Контроль появления передач.SOIC-8 / 3.9 mmATTINY13A-SSUПлата питается сама: питание цели от программатора отключить. Для ISP снять R37.Сначала FLASH, затем LFUSE=0x7B / HFUSE=0xFB: 128 кГц, SUT ≈64 мс, BOD 2,7 В.Нет импульсов TXEN: 1350 тактов WDT по 8 с ≈ 3 ч; затем RESET ≈ 1 с.PB0 (вывод 5): только LOW или Hi-Z. RESET ATtiny (вывод 1) — отдельная цепь.BOD следит за SYS_3V3; порог EN батареи не меняется. Проверить восстановление и ток сна.J10: стандартный AVR ISP, уровни 3,3 В; SCK ≤ 10 кГц после установки fuse.Прошивка: watchdog/main.c. Штатное молчание радио более ≈3 ч также вызовет сброс.0805
RC0805FR-070RL 0805J10 AVR ISP 3V3112233445566
PAGE 4
1
2 3 4 5 6 7 8 1
2 3 4 5 6 7 8 A
BCDEFA
BCDEFDate: 2026-10-11KiCad E.D.A. 10.0.6Rev: V2.0-A1Size: A3Id: 4/4Title: Межплатное соединение / POWER ↔ LOGICFile: Interconnect.kicad_schSheet: /4. Interconnect/Электрическая принципиальная; прототип1
2J11LC OUT - SYS 3V3GND1H201M3 GND contact1 1GND1H202M3 GND contactR211kTP7TP4GND
1H204M3 GND contactGND1H203M3 GND contactFILTER_OUT
1GND2FILTER_OUT3GND4FILTER_OUT5GND6FILTER_OUT7GND8BAT9GND10MODE11GND12J201INTERBOARD 12PSYS_3V3FILTER_OUT FILTER_OUTBATFILTER_OUTMODEFILTER_OUT RADIO_TXENSYS_3V3SYS_3V3MODE FILTER_OUTЭкран/стойки: 
только GND/EMI; не обязательный силовой возврат.V2.0-A1 
/ 2026-10-11 / инженерный прототипMesh Repeater 2.0 — LOGIC / межплатные соединенияДо USB снять J11; вернуть только после отключения USB.Полная распиновка и маршрут кабеля — interboard_connections.csv.DS1022-1x40RUF11-B
IDC 2x6 / 2.54 / 90degR21 оставлен 1 кОм: RADIO_TXEN → R21 → MODE через кабель.J11: шунт установлен для АКБ/солнца.0805DS1013-12RSIB-B-0 RC0805FR-071KL1x2 / 2.54 / 90degJ201 INTERBOARD 12PFILTER_OUT1GND2FILTER_OUT3GND4FILTER_OUT5GND6FILTER_OUT7GND8BAT9GND10MODE11GND12
