Alksndr55/mesh-repeater-2.0/audit/V2_ENGINEERING_AUDIT_A3_2026_10_13/SOFTWARE_BOM_pdf_MeshRepeater2_Logic_V2_A2_schematic.txt

PAGE 1
1
2 3 4 5 6 7 8 1
2 3 4 5 6 7 8 A
BCDEFA
BCDEFDate: 2026-10-12KiCad E.D.A. 10.0.6Rev: V2.0-A2Size: A3Id: 1/4Title: Nice!Nano / HT-RA62File: MeshRepeater2_Logic.kicad_schSheet: /Электрическая принципиальная; прототип4. InterconnectФайл: Interconnect.kicad_sch2. RTC_IOФайл: RTC_IO.kicad_sch3. WatchdogФайл: Watchdog.kicad_schR282.2M 0.1%C21 10uF 16V X7RSW1USERRF 1SHIELD2J13SMA 50OhmP0.09_/_RADIO_RST1 P0.10_/_DIO12 P1.11_/_SCK3P1.13_/_NSS4P1.15_/_MOSI5 P0.02_/_MISO6 P0.29_/_BUSY7 P0.31_/_BAT_ADC8VCC_/_MOD_3V39RESET10GND11RAW_-_NC12BAT_-_NC13P1.06_/_spare14 P1.04_/_SDA15P0.11_/_SCL16P1.00_/_USER_BTN17P0.24_/_GPS_EN_/_DIGITAL_OUT18P0.22_/_GPS_RX19P0.20_/_GPS_TX20P0.17_/_RXEN21 GND22GND23P0.08_/_UART_RX24P0.06_/_UART_TX25GND26M1NiceNano_CLONE_MODIFIEDR26 33RR2533RR2433RR3110kANT 1GND23V33RST4TXEN_=_DIO25DIO16DIO2_=_TXEN7DIO38GND9BUSY10RXEN11SCK12MISO13MOSI14NSS15GND16M2HT-RA62R2333RR35100k1 2NT1Cu link / cut for FL1GND1IN2GND3GND4OUT5GND6FL1S869M000S003C26100nF 50V X7RSW2RESETC24 100nF 50V X7RR272.2M 0.1%FB1 60R@100MHz / 3AC2322uF 25V X5RC25100nF 50V X7RC22 100nF 50V X7RSYS_3V3
SYS_3V3USER_BTNGPS_TX_MCUGPS_RX_MCUGPS_ENSYS_3V3 SDABAT_ADCMCU_RESETBATSCLUSER_BTN SYS_3V3UART_TXUART_RXUSER_BTNBAT_ADCSYS_3V3 RADIO_TXENMCU_RESETANT_SMA ANT_RFRADIO_DIO1RADIO_BUSYRADIO_RSTRADIO_RXENRADIO_3V3 module16x17 mm, P2.0CL21B106KOQNNNENice!Nano, HT-RA62, управление и измерение батареиRG2012P-225-B-T5
0805HT-RA62: R1 = 0 Ом (ANT); R2 снять (IPEX).R1/R2 здесь — резисторы внутри модуля.Подключать антенну только к J13.SMA / угловой / PTHFL1 — опция 868–870 МГц, TX ≤ +13 dBm.До установки разрезать медь NT1 под FL1.Без FL1 оставить NT1 целой.L-KLS1-SMA002-BV2.0-A2 / 2026-10-12 / инженерный прототипRC0805FR-0733RL / 08050805 S869M000S003 / опция08051825027-2 / FSMRA1JH04THT 7.11x7.01 / sideCL21B104KBCNNNCProMicro / доработкаNice!Nano / клон1825027-2 / FSMRA1JH040805 0805CL21A226MAQNNNE CL21B104KBCNNNCADC: BAT/2; τ ≈ 110 мс. Калибровка ADC.RG2012P-225-B-T5CL21B104KBCNNNC RC0805FR-0733RL / 0805DCC6C / 3 x 3 x 1.3 mmSPI: 33 Ом у драйверов.ANT: J13 / SMA, 50 Ом.TXEN → MODE и watchdog.P1.06 свободен.BUSY=P0.29; GPS_EN=P0.24.GPS_EN=HIGH: питание GPS включено.HT-RA62 / диапазон выбрать08050805Модем: отдельная ветвь J11 → FB1 → RADIO_3V3. GPS/RTC питаются до FB1.3V3 через J11; RAW/BAT: NC. USB-зарядник отключить.Снять шунт J11 ДО подключения USB.Вернуть J11 только после отключения USB.RC0805FR-0733RL 
/ 0805RC0805FR-0733RL / 08050805 / 2 x 1.25 mmBLM21PG600SN1DFB1: 
DCR ≤20 мОм; около 3 мВ при 150 мА. Проверить броски питания при TX осциллографом.RC0805FR-0710KLCL21B104KBCNNNC0805THT 7.11x7.01 / side0805
0805RC0805FR-07100KLFL1 S869M000S003GND1IN2GND3GND4OUT5GND6NT1Cu link / cut for FL112
PAGE 2
1
2 3 4 5 6 7 8 1
2 3 4 5 6 7 8 A
BCDEFA
BCDEFDate: 2026-10-12KiCad E.D.A. 10.0.6Rev: V2.0-A2Size: A3Id: 2/4Title: DS3231M / разъёмыFile: RTC_IO.kicad_schSheet: /2. RTC_IO/Электрическая принципиальная; прототип+
-BT1CR2032 / holderR42 100kR45100kR441kR294.7kC57 10uF 16V X7R1 G1S2D3Q2AO3401A32kHz1VCC2INT/SQW3RST4GND5VBAT6SDA7SCL8U4DS3231MZ+TRL1 1223344J5UART3V3G1S2D3Q32N7002K11223344J3I2C3V3R304.7kC56 100nF 50V X7RR43100kR46100kC27100nF 50V X7RRESET_N 1PPS2WAKE_UP3RXD_GPS4TXD_GPS5V_BCKP6VCC7GND8MountsMPJ4GPS / T114 P3OE111A_/_MCU_TX22Y_/_MCU_RX3 GND42A_/_GPS_TX51Y_/_GPS_RX6OE27VCC_GPS8U7SN74LVC2G125GPS_3V3GPS_TX_EXTSYS_3V3GPS_EN GPS_RX_EXT GPS_3V3GPS_3V3UART_RXSYS_3V3SCLGPS_3V3 GPS_TX_MCUSDAGPS_RX_EXT GPS_RX_MCUSYS_3V3GPS_3V3GPS_3V3SDASCLSYS_3V3 GPS_TX_EXTGPS_TX_MCUSYS_3V3SYS_3V3 GPS_TX_EXTGPS_3V3SYS_3V3UART_TXRTC_BATGPS_EN_GATE GPS_GATE2N7002KSOT-23RC0805FR-07100KLCR2032 holder, SMDСредний экран: отдельная плата 90×60; GND через стойки.0805T114 V2.1 P3: порядок контактов; корпус кабеля проверить.J4.6: резерв 3,3 В постоянно; J4.7: питание через Q2.RC0805FR-07100KL
0805RC0805FR-071KLU7: Ioff; UART не подпитывает выключенный GPS.0805
J4.1 
/ .3: внутренние подтяжки L76K; .2 PPS не используется.GPS_EN = P0.24: HIGH включено; LOW / Hi-Z выключено.0805
0805CL21B104KBCNNNCSOIC-8 / 3.9 mmDS3231MZ+TRL0805RC0805FR-07100KL 0805DS3231M: SO-8; точность ±5 ppm; SQW только 1 Гц.Проверять OSF; снять после установки времени.DS3231M / CR2032, разъёмы и экранRC0805FR-074K7LSOT-23 AO3401A0805 CL21B104KBCNNNC0805RC0805FR-074K7L53261-0871 1 x 8 / 1.25 mm / SMDRC0805FR-07100KLCL21B106KOQNNNECR2032: без зарядки. Установить после пайки.EOSC=0; BBSQW=0; INTCN=1; EN32kHz=0.DS1022-1x40RUF11-B 1x4 / 2.54 / 90degDS1022-1x40RUF11-BI²C: 0x68. INT/SQW не используется.V2.0-A2 / 2026-10-12 / инженерный прототипKeystone 1060 / держатель1x4 / 2.54 / 90degSN74LVC2G125DCTR SSOP-8 / DCT / 0.65 mm0805
J3 I2C3V311223344J5UART3V311223344BT1CR2032 / holder+-J4 GPS / T114 P3RESET_N1PPS2WAKE_UP3RXD_GPS4TXD_GPS5V_BCKP6VCC7GND8MountsMP
PAGE 3
1
2 3 4 5 6 7 8 1
2 3 4 5 6 7 8 A
BCDEFA
BCDEFDate: 2026-10-12KiCad E.D.A. 10.0.6Rev: V2.0-A2Size: A3Id: 3/4Title: ATtiny13A / watchdogFile: Watchdog.kicad_schSheet: /3. Watchdog/Электрическая принципиальная; прототипR33
10k112233445566J10AVR ISP 3V3PB5_/_RESET1PB3_/_TXEN_IN2PB43GND4PB0_/_RESET_OD_/_MOSI5 PB1_/_MISO6PB2_/_SCK7VCC8U6ATtiny13A-SSUR370RR39100kR3610kR381kC33100nF 50V X7RSYS_3V3RADIO_TXENWDT_MOSI_RESET WDT_MOSI_RESETSYS_3V3WDT_SCKWDT_MISOMCU_RESETWDT_RESETWDT_SCKWDT_RESETWDT_MISO SYS_3V3J10: стандартный AVR ISP, уровни 3,3 В; SCK ≤ 10 кГц после установки fuse.ATTINY13A-SSUSOIC-8 / 3.9 mmRC0805FR-0710KLCL21B104KBCNNNC0805RC0805FR-071KL0805Прошивка: watchdog/main.c. Штатное молчание радио более ≈3 ч также вызовет сброс.BOD следит за SYS_3V3; порог EN батареи не меняется. Проверить восстановление и ток сна.0805
RC0805FR-070RLСначала FLASH, затем LFUSE=0x7B / HFUSE=0xFB: 128 кГц, SUT ≈64 мс, BOD 2,7 В.TXEN HT-RA62 → R38 → PB3 (вывод 2). Контроль появления передач.Нет импульсов TXEN: 1350 тактов WDT по 8 с ≈ 3 ч; затем RESET ≈ 1 с.RC0805FR-0710KL 2 x 3 / 2.54 mmПлата питается сама: питание цели от программатора отключить. Для ISP снять R37.PB0 (вывод 5): только LOW или Hi-Z. RESET ATtiny (вывод 1) — отдельная цепь.RC0805FR-07100KL080508050805V2.0-A2 / 2026-10-12 / инженерный прототипATtiny13A — внешний watchdog из пользовательского проектаDS1021-2X5SF11-B J10AVR ISP 3V3112233445566
PAGE 4
1
2 3 4 5 6 7 8 1
2 3 4 5 6 7 8 A
BCDEFA
BCDEFDate: 2026-10-12KiCad E.D.A. 10.0.6Rev: V2.0-A2Size: A3Id: 4/4Title: Межплатное соединение / POWER ↔ LOGICFile: Interconnect.kicad_schSheet: /4. Interconnect/Электрическая принципиальная; прототип1
2J11LC OUT - SYS 3V3GND
1H202M3 GND contactTP7FILTER_OUT 1GND2FILTER_OUT3GND4FILTER_OUT5GND6SYS_3V37GND8BAT9SDA10MODE11SCL12J201INTERBOARD 2x6 VERTICALGND1H203M3 GND contactTP4GND1H201M3 GND contactGND1H204M3 GND contact1
R211k1BAT SYS_3V3SDA FILTER_OUTFILTER_OUT SYS_3V3SCLSYS_3V3MODEFILTER_OUT FILTER_OUTMODESYS_3V3RADIO_TXENRC0805FR-071KLРаспиновка прямого соединения — interboard_connections.csv.DS1022-1x40RUF11-B
THT 2x6 / 2.54 / verticalЭкран/стойки: только GND/EMI; не обязательный силовой возврат.J11: шунт установлен для АКБ/солнца.R21 оставлен 1 кОм: RADIO_TXEN → R21 → MODE через штыри.До USB снять J11; вернуть только после отключения USB.0805Mesh Repeater 2.0 — LOGIC / межплатные соединенияV2.0-A2 / 2026-10-12 / инженерный прототип1x2 / 2.54 / 90degMTJ H8.5 2X6P 10PCSJ201INTERBOARD 2x6 VERTICALFILTER_OUT1GND2FILTER_OUT3GND4FILTER_OUT5GND6SYS_3V37GND8BAT9SDA10MODE11SCL12
