Alksndr55/mesh-repeater-2.0/audit/V2_ENGINEERING_AUDIT_A3_2026_10_13/SOFTWARE_BOM_pdf_MeshRepeater2_Power_A3_schematic.txt

PAGE 1
1
23456781
2345678A
BCDEFA
BCDEFDate: 2026-10-13KiCad E.D.A. 10.0.6Rev: V2.0-A3Size: A3Id: 1/6Title: CN3722 / зарядка Na-ion и LTOFile: MeshRepeater2_Power.kicad_schSheet: /Электрическая принципиальная; прототип5. BatteryMonitorФайл: BatteryMonitor.kicad_sch2. ConverterФайл: Converter.kicad_sch4. ThermalФайл: Thermal.kicad_sch3. LTO_BalancerФайл: LTO_Balancer.kicad_sch6. InterconnectФайл: Interconnect.kicad_schR3
61.9k 0.1%R1110kC6220nF 50V X7R1R10 10kK
AD2SS24L1100uHC110uF 50V X7RR4 100k 0.1%R10.28R 1%C4 22uF 25V X5RVG1PGND2GND3CHRG4DONE5TEMP6MPPT7COM18COM29FB10COM311NC12CSP13BAT14VCC15DRV16U1CN37221
R6 120RK
AD3REDC7100nF 50V X7RR910kKAD1SS24K
AD4GREENR7105k 0.1%C847uF 35VC3100nF 50V X7RC2100nF 50VX7RR810k 0.1%C30 12pF 50V C0G1122J7SOLAR 12VTP9R51M 0.1%1C5470pF 50VC0GG 1S2D3Q1AO3401AR56 1.8R 1% 1WBAT_SYS SOLAR CHRGDONECS_PSOLARCHRG DONESOLARBAT_SYSCHG_CS_M
SOLARSOLAR SOLARGATE CDRH127/LDNP-101MC SMB / DO-214AA2512 / 6.3 x 3.2 mmWSL2512R2800FEAKelvin:CSP до R56;BAT после R1SMB / DO-214AASS24SOLARAO3401A SOT-231206CL31B106KBHNNNES2B-XH-A(LF)(SN)XH 1x2 / 2.50 / 90degAT0805BRD07105KLRT0805BRE0710KL0805BAT senseV2.0-A3 / 2026-10-13 / инженерный прототип0805 CL21B104KBCNNNCNa-ion: R3 61,9k / R4 100k; C30 12pF; CV ≈ 3,915 ВLTO 2S: R3 121k / R4 100k; C30 6,8pF; CV ≈ 5,345 ВДелитель: 0,1%; ТКС ≤25 ppm/°C. LTO: запаять балансир.CL21A226MAQNNNE01. Солнечная зарядка CN3722 / аккумулятор Na-ion 1S0805CC0805JRNPO9BN120 EEEFK1V470PПанель 12 В.Холодный Voc ≤ 24 В.CL21B104KBCNNNC CL21B104KBCNNNC0805 (2012)FYLS-0805BUGCRC0805FR-0710KLTSSOP-16, 4.4x5 mmTEMP: защитаотключена по заданию.FYLS-0805BURC MPPT: Vmp ≈ 11,96 В.R7/R8 = 105/10 кОм.Vmp ≈ 18 В: изменить R7.0805RC0805FR-0710KL 0805 (2012)0805CC0805JRNPO908050805BN4710805 RT0805BRD07100KL0805Na-ion / опция: R56 = 1,8 Ом; холод ≈ 96 мА; тепло ≈ 665 мА. Управление: лист 4.LTO / без опции: R56 = 0 Ом; узел Thermal не ставить. R1 = 0,28 Ом: ток ≈ 714 мА, максимум ≈ 784 мА.CC0805KKX7R9BB2240805 0805080508050805RT0805BRD071MLRC0805FR-0710KL 0805SS24
CN37222512 / 6.3 x 3.2 mmSMD / D6.3 x 5.8 mmRC2512FK-071R8L 0805
RC0805FR-07120RL RT0805BRD0761K9L 12.3 x 12.3 x 8 mmU1CN3722VG1PGND2GND3CHRG4DONE5TEMP6MPPT7COM18COM29FB10COM311NC12CSP13BAT14VCC15DRV16
PAGE 2
1
23456781
2345678A
BCDEFA
BCDEFDate: 2026-10-13KiCad E.D.A. 10.0.6Rev: V2.0-A3Size: A3Id: 2/6Title: TPS63802 / питание и фильтрFile: Converter.kicad_schSheet: /2. Converter/Электрическая принципиальная; прототипR40
22mR 1%C34100uFC40100uFR1356k 0.1%L32.4uHC1422uF 25VX5RC35 100uFTP8C39100uFC38100uFC36100uFC43 100uFC44100uFC45100uFC16100uFC37100uFC15100uFTP6C51 100uFC13100nF 50V X7RC49 100uFC46100uFC50100uFR4122mR 1%R1410k 0.1%EN1MODE2AGND3FB4PG5VOUT6L27PGND8L1 9VIN10U2TPS63802DLARR1649.9k 0.1%R1540.2k 0.1%C55 DNPC42 100uF1R17100kC47 100uFC48100uFR5547mR 1%C54DNPC1210uF 16V X7RTP3 TP1L20.47uHC41 100uFL42.4uHC53DNPC5210uF 16V X7RFILTER_OUT MODEBATBAT_SYSFILTER_OUT
BATFILTER_MID SYS_PREFB_SYSSYS_LC_IN LX1LX2EN_UV1A107M280KC C4532X5RC4532X5R1812C4532X5RC4532X5RC4532X5R1A107M280KC18121A107M280KC C4532X5R18121812C4532X5R1A107M280KC1A107M280KC1812Каскад 2: Cэфф ≥ 330 мкФ при 3,3 В18121A107M280KC1812 C4532X5R1812CL21B106KOQNNNERT0805BRD0740K2L0805C4532X5R EN / Na: R15=40,2 кОм; R16=49,9 кОм; выкл.≈1,806 В; вкл.≈1,986 В.1A107M280KC C4532X5RCL10B104KB8NNNCSYS_PRE: 3,300 В; FB до L3. C14 — локальная ёмкость TPS63802.TXEN=0: PFM; TXEN=1: forced PWM.1A107M280KC C4532X5REN / LTO: R15=130 кОм; R16=49,9 кОм; выкл.≈3,605 В; вкл.≈3,966 В (тип.).0805RT0805BRD0749K9L1812 CDRH127/LDNP-2R4NC12.3 x 12.3 x 8 mmWSL2512R0470FEA2512 / 6.3 x 3.2 mm1812 RNCF0805BKE56K008051A107M280KC C4532X5R 1812 1A107M280KCVSON-HR-10 / DLA, 2x3 mmTPS63802DLAR1A107M280KC C4532X5R1A107M280KC06031A107M280KC FILTER_MID1A107M280KC WSL2512R0220FEA2512 / 6.3 x 3.2 mmRT0805BRE0710KL0805WSL2512R0220FEA 0805RC0805FR-07100KL1812 1812 2512 / 6.3 x 3.2 mm1A107M280KCDNP; MPN не выбранCL21B106KOQNNNE1A107M280KC
C4532X5R 1812FILTER_OUT → J11 → NT2-звезда на листе Interconnect (POWER).H max 2.1 mm1812 08051812 C4532X5R 12.3 x 12.3 x 8 mmTPS63802 — питание и двухкаскадный LC-фильтрV2.0-A3 / 2026-10-13 / инженерный прототипПроверить 
минимумы/максимумы 3V3 при подключении USB, PFM/PWM и скачке нагрузки.CDRH127/LDNP-2R4NC
4 x 4 mm1A107M280KC
R55: 47 мОм последовательно перед L3; падение 47 мВ/А. FB и C14 до R55.1812 1A107M280KC1206L3, 
L4: CDRH127/LDNP-2R4NC, 2,4 мкГн каждый. R40/R41: 22 мОм только в ветвях C.C4532X5R C4532X5RDNP; 
MPN не выбран1206C12 
+ C52: два локальных 10 мкФ / 16 В / 0805. C53, C54, C55: резерв 1206 / DNP.J11 соединяет выход LC с SYS_3V3 всех нагрузок. Снять ДО USB; вернуть после отключения USB.Каскад 1: Cэфф ≥ 330 мкФ при 3,3 ВC4532X5R 1812 0805Cэфф ≥330 мкФ — требование приёмки; типовые кривые не дают гарантии. Проверить банк и запуск.Каждый банк: 10 × 100 мкФ TDK C4532X5R1A107M280KC / 10 В / X5R / 1812. Номинально 1000 мкФ.1A107M280KC 1812 C4532X5RCL21A22608051812 C4532X5R 1A107M280KCDNP; MPN не выбранMAQNNNE1206XGL4020-471MECC13100nF 50V X7RU2TPS63802DLAREN1MODE2AGND3FB4PG5VOUT6L27PGND8L1 9VIN10
PAGE 3
1
23456781
2345678A
BCDEFA
BCDEFDate: 2026-10-13KiCad E.D.A. 10.0.6Rev: V2.0-A3Size: A3Id: 3/6Title: LMV431A / LTO 2S опцияFile: LTO_Balancer.kicad_schSheet: /3. LTO_Balancer/Электрическая принципиальная; прототипR54
100k 0.1%R472R 1%R52 120k 0.1%C59 47nF 16V X7RR532.49k 0.1%R492.49k 0.1%NC 1A2K3REF4A5U8LMV431AR50100k 0.1%NC 1A2K3REF4A5U9LMV431AC5847nF 16V X7RR51 2R 1%R48120k 0.1%PACK+1MID2PACK-3NC4J12LTOBAT
LTO_MID LTO_MID
BATLTO_MID Нижняя ячейка0805LMV431AIM5/NOPB SOT-23-50805MPN TBD / 120k 0.1% / LTO onlyMPN TBD / 47nF X7R 16V / LTO onlyRC0805FR-072RL / LTO only0805POWER: 
балансир под средним экраном. J12: 1 PACK+ / 2 MID / 3 PACK-.MPN 
TBD / 47nF X7R 16V / LTO onlyL-KLS1-2.50-04-R / LTO onlyXH 1x4 / 2.50 / 90deg08050805 MPN TBD / 100k 0.1% / LTO only08050805 SOT-23-5MPN TBD / 100k 0.1% / LTO only0805Балансир: 2R, 120k+2,49k / 100k (0,1%), LMV431A, 47nF.0805
RC0805FR-072RL / LTO onlyMPN TBD / 2.49k 0.1% / LTO onlyMPN TBD / 2.49k 0.1% / LTO onlyV2.0-A3: отдельной защиты ячеек и защиты от перенапряжения нет.Na-ion: R3=61,9k / R4=100k / C30=12pF. LTO: 121k / 100k / 6,8pF. Допуск R: 0,1%.Верхняя ячейкаБалансир 2S LTO / опциональная сборка POWERV2.0-A3 / 2026-10-13 / инженерный прототипNa-ion: 
этот лист не запаивать. LTO 2S: запаять все компоненты этого листа.MPN TBD / 120k 0.1% / LTO onlyLTO: номинал 5,345 В; максимум 5,445 В при ТКС ≤25 ppm/°C, -40…85°C. Выбросы не учтены.Балласт R47/R51 = 2R по выбору пользователя; ток LMV431 на углах допусков не ограничен до 15 мА.LMV431AIM5/NOPB0805J12LTOPACK+1MID2PACK-3NC4
PAGE 4
1
23456781
2345678A
BCDEFA
BCDEFDate: 2026-10-13KiCad E.D.A. 10.0.6Rev: V2.0-A3Size: A3Id: 4/6Title: LM393XK / холодный заряд Na-ionFile: Thermal.kicad_schSheet: /4. Thermal/Электрическая принципиальная; прототипC62100nF 100V X7RR6510k 1%OUT_A 1-_A2+_A3GND4+_B5-_B6OUT_B 7VCC 8U10LM393XKR6930k 1%R67 1M 1%G1S2D3Q5BSS138R59100k 1%12TH110k NTC 1% B3988R68 1k 1%C60100nF 100V X7RR661k 1%G
1S2D3Q7AO3401AG1S2D3Q4AO3401AR63 100k 1%R621M 1%R70150k 1%R641.2M 1%G1S2D3Q6AO3401AR60 100k 1%R58
100k 1%NC
1K2A3U11LM285Z-2.5GR61 100k 1%R5747k 1% 0.125WC61 1nF 100V C0GSOLAR CHG_G_SHUNTCS_P
CS_P CHG_G_SHUNTCHG_G_SHUNTCHG_CS_MSOLAR
CHG_VTH CHG_PULLDOWN CHG_HYST_MIDCHG_VREFCHG_VTH_UP CHG_TSENSECHG_WARM CHG_VSHORTCHG_G_ENABLE RC0805FR-0730KLRC0805FR-07100KLRC0805FR-07100KL CC0805JRNPO0BN102RC0805FR-071KL Q4 
/ Q6 / Q7: S = до R56; D = после R56.R58 закрывает ключи при выключенном управлении.0805 CC0805KKX7R0BB104LM393XKAO3401A0805 SOT-23AO3401ARC0805FR-07100KL R60 + R69 = 130k; R62 + R70 = 1,15M.Номинальные пороги: холод −17,4 °C; тепло −14,5 °C.OUT A и OUT B — соединённые открытые коллекторы.CHG_WARM высокий: Q5 включён, R56 обойдён.CHG_WARM низкий: Q5 выключен, R58 закрывает Q4/Q6/Q7.TH1: B57861S0103F040; 10k, B25/100 = 3988 K, R/T 8016.Один NTC: на плате либо на проводах у аккумулятора.На плате измеряется температура под экраном.Обрыв или КЗ NTC → холодный ток.Снижение тока на холоде / Na-ion / опция POWERV2.0-A3 / 2026-10-13 / инженерный прототипRC0805FR-0747KLRC0805FR-071ML BSS138SOIC-8 / 3.9 mmNa-ion с опцией: установить весь узел, R56 = 1,8 Ом.LTO / без опции: R56 = 0 Ом, остальные 24 позиции не ставить.Основной R1 = 0,28 Ом остаётся во всех вариантах.Холод ≈ 96 мА; тепло ≈ 665 мА (зависит от RDS(on)).0805
0805 0805AO3401ASOT-23 TO-92 / шаг 1.27 mmLM285Z-2.5G0805 RC0805FR-07150KLB57861S0103F0400805 RC0805FR-07100KL08050805 0805 CC0805KKX7R0BB104RC0805FR-071KL08050805RC0805FR-0710KLRC0805FR-071M2L0805NTC ø2.41 / P2.54RC0805FR-07100KL -t°SOT-230805
SOT-23
0805
RC0805FR-071ML08050805
PAGE 5
1
23456781
2345678A
BCDEFA
BCDEFDate: 2026-10-13KiCad E.D.A. 10.0.6Rev: V2.0-A3Size: A3Id: 5/6Title: INA219 / батарея и токFile: BatteryMonitor.kicad_schSheet: /5. BatteryMonitor/Электрическая принципиальная; прототипR71
0.1R 1% 1W1
C63100nF 50V X7RC64100nF 50V X7R1
A1
1A02SDA3SCL4VS5GND6IN-7IN+8U12INA219AIDR+ 1GND2J8Na-ionR7210R 1%R7310R 1%SYS_3V3 BAT SYS_3V3SCLSDABATBAT_SYSBATCN3722 FB/BAT sense остаются до R71 на BAT_SYS; EN и BAT_ADC — от BAT.0805S2B-XH-A(LF)(SN) Батарея Na-ion 1S; LTO — J12RL2512FK-070R1L0805CC0805KRX7R9BB104От зарядника / к TPS638022512 / 6.3 x 3.2 mmINA219AIDRINA219 — напряжение и основной ток батареиV2.0-A3 / 2026-10-13 / инженерный прототип0805 CC0805KRX7R9BB104SOIC-8 / 3.9x4.9 / P1.27R71=0,1 Ом: штатная калибровка MeshCore. Ток заряда +, разряда −.RC0805FR-0710RLKelvin от внутренних краёв площадок R710805RC0805FR-0710RLПитание VS: SYS_3V3 после J11 на POWER; USB через J101.1/3 при снятой J11.A1=A0=GND: адрес 0x40. SDA/SCL — существующий I2C NiceNano.Балансиры подключены к ячейкам напрямую: их токи не входят в основной ток INA219.XH 
1x2 / 2.50 / 90degU12INA219AIDRA11A02SDA3SCL4VS5GND6IN-7IN+8C64100nF 50V X7R
PAGE 6
1
23456781
2345678A
BCDEFA
BCDEFDate: 2026-10-13KiCad E.D.A. 10.0.6Rev: V2.0-A3Size: A3Id: 6/6Title: Межплатное соединение / POWER ↔ LOGICFile: Interconnect.kicad_schSheet: /6. Interconnect/Электрическая принципиальная; прототипGND 1H4M3 GND contactSYS_3V3
1GND2SYS_3V33GND4RADIO_3V35GND6RADIO_3V37NC8BAT9SDA10MODE11SCL12J101INTERBOARD 2x6 VERTICALGND1H3M3 GND contactGND1H1M3 GND contactGND1H2M3 GND contact1
2NT23V3 STAR12J11LC OUT - 3V3SYS_3V3 FILTER_OUTSYS_3V3SDA MODESCLBATSYS_3V3RADIO_3V3RADIO_3V3RADIO_3V3INA219 питается от SYS_3V3; при снятой J11 его питает USB через штыри.D3 CHARGE / D4 DONE находятся только на POWER.Экран/стойки: только GND/EMI; не обязательный силовой возврат.MODE: R21 на LOGIC у источника; R17 pull-down на POWER.Распиновка прямого соединения — interboard_connections.csv.SYS_3V3 → NiceNano и периферия; RADIO_3V3 → только модем через FB1.DS1022-1x40RUF11-BV2.0-A3 / 2026-10-13 / инженерный прототипTHT 2x6 / 2.54 / verticalОдин шунт J11: снять ДО USB; вернуть после отключения USB.NT2 — медная звезда, не устанавливаемая деталь. Не разрезать.E-SIMPO L35mm A3C6 2x6P1x2 / 2.54 / 90degMesh Repeater 2.0 — POWER / межплатные соединенияBAT: отвод измерения прямо от разъёма батареи, до R71.J101 INTERBOARD 2x6 VERTICALSYS_3V31GND2SYS_3V33GND4RADIO_3V35GND6RADIO_3V37NC8BAT9SDA10MODE11SCL12
