Alksndr55/mesh-repeater-2.0/audit/V2_ENGINEERING_AUDIT_A3_2026_10_13/SOFTWARE_BOM_pdf_MeshRepeater2_Power_schematic.txt

PAGE 1
1
23456781
2345678A
BCDEFA
BCDEFDate: 2026-10-11KiCad E.D.A. 10.0.6Rev: V2.0-A1Size: A3Id: 1/5Title: CN3722 / зарядка Na-ion и LTOFile: MeshRepeater2_Power.kicad_schSheet: /Электрическая принципиальная; прототип5. InterconnectФайл: Interconnect.kicad_sch3. LTO_BalancerФайл: LTO_Balancer.kicad_sch2. ConverterФайл: Converter.kicad_sch4. ThermalФайл: Thermal.kicad_schK
AD4GREENR10.28R 1%R1110kR51M 0.1%VG1PGND2GND3CHRG4DONE5TEMP6MPPT7COM18COM29FB10COM311NC12CSP13BAT14VCC15DRV16U1CN3722C110uF 50V X7RL1 100uHR3 61.9k 0.1%1
G 1S2D3Q1AO3401AKAD1SS24C5470pF 50VC0GR4 100k 0.1%C7100nF 50V X7RC30 12pF 50V C0G1
1K AD2SS24R7105k 0.1%R810k 0.1%C847uF 35VC3100nF 50V X7RTP9R10 10kKAD3REDR910kC4 22uF 25V X5R1122J8Na-ion 1SC6220nF 50V X7R1
122J7SOLAR 12VR56 1.8 ohm 1% 0.125WC2100nF 50VX7RR6120RSOLARCHG_CS_M SOLARSOLARCHRG SOLARSOLAR DONEBATCHRG SOLAR
CS_P DONEBAT GATERT0805BRD071MLCN3722TSSOP-16, 4.4x5 mm1206 08050805Na-ion / опция: R56 = 1,8 Ом; холод ≈ 96 мА; тепло ≈ 665 мА. Управление: лист 4.LTO / без опции: R56 = 0 Ом; узел Thermal не ставить. R1 = 0,28 Ом: ток ≈ 714 мА, максимум ≈ 784 мА.CC0805JRNPO9RC0805FR-0710KL 08050805 RC0805FR-0710KL CL31B106KBHNNNEBN471 PT1206FR-
Na-ion: R3 61,9k / R4 100k; C30 12pF; CV ≈ 3,915 ВLTO 2S: R3 121k / R4 100k; C30 6,8pF; CV ≈ 5,345 ВДелитель: 0,1%; ТКС ≤25 ppm/°C. LTO: запаять балансир.0805RT0805BRD0761K9L0805XH 1x2 / 2.50 / 90degS2B-XH-A(LF)(SN)SMB / DO-214AA12.3 x 12.3 x 8 mm0805 FYLS-0805BUGCSOLAR
0805
CC0805KKX7R9BB224RC0805FR-07120RLCL21B104KBCNNNC0805CL21A226MAQNNNE RC0805FR-0710KL080501. Солнечная зарядка CN3722 / аккумулятор Na-ion 1SCDRH127/LDNP-101MC 0805
0805 (2012)V2.0-A1 
/ 2026-10-11 / инженерный прототипKelvin: CSP до R56;BAT после R10805FYLS-0805BURC 08050805 (2012)RT0805BRD07100KLCL21B104KBCNNNCRT0805BRE0710KLSMB / DO-214AASS24TEMP: защитаотключена по заданию.CL21B104KBCNNNC0805SMD / D6.3 x 5.8 mmAT0805BRD07105KL0805 XH 1x2 / 2.50 / 90degMPPT: Vmp ≈ 11,96 В.R7/R8 = 105/10 кОм.Vmp ≈ 18 В: изменить R7.SOT-23 AO3401ABAT senseRC0805FR-071R8LEEEFK1V470PS2B-XH-A(LF)(SN) Панель 12 В.Холодный Voc ≤ 24 В.CC0805JRNPO9BN120 080508057W0R28L
SS241206U1 CN3722VG1PGND2GND3CHRG4DONE5TEMP6MPPT7COM18COM29FB10COM311NC12CSP13BAT14VCC15DRV16
PAGE 2
1
23456781
2345678A
BCDEFA
BCDEFDate: 2026-10-11KiCad E.D.A. 10.0.6Rev: V2.0-A1Size: A3Id: 2/5Title: TPS63802 / питание и фильтрFile: Converter.kicad_schSheet: /2. Converter/Электрическая принципиальная; прототипC15
100uFC16 100uFC35100uFC34100uFC41100uFC50 100uFC51100uFC43100uFC37100uFC36100uFC47100uFC44100uFC42100uFC45 100uFC49100uFC48100uFL42.4uHC39100uFC38100uFC46 100uF1R4022mR 1%C40100uFC54DNPR41 22mR 1%TP1C1422uF 25VX5RR1356k 0.1%TP3C55DNPEN1MODE2AGND3FB4PG5VOUT6L27PGND8L19VIN10U2TPS63802DLARR1410k 0.1%R1649.9k 0.1%R17100kR55 47mR 1%TP6L32.4uHTP8C1210uF 16V X7RC13100nF 50V X7RR1540.2k 0.1%L20.47uHC53DNPC5210uF 16V X7RFILTER_OUT BATMODE
FILTER_OUT FB_SYSLX2LX1FILTER_MID EN_UVSYS_PRE SYS_LC_IN 1A107M280KC
WSL1206, 1206 (3216)FILTER_OUT → межплатный кабель → J11.1 (LOGIC).4 x 4 mmCDRH127/LDNP-2R4NC C4532X5R1A107M280KCКаскад 1: Cэфф ≥ 330 мкФ при 3,3 В1812C4532X5RC4532X5R1A107M280KC1812EN / LTO: R15=130 кОм; R16=49,9 кОм; выкл.≈3,605 В; вкл.≈3,966 В (тип.).TXEN=0: PFM; TXEN=1: forced PWM.EN / Na: R15=40,2 кОм; R16=49,9 кОм; выкл.≈1,806 В; вкл.≈1,986 В.SYS_PRE: 3,300 В; FB до L3. C14 — локальная ёмкость TPS63802.0805TPS63802DLAR0805RC0805FR-07100KLRT0805BRD0749K9LVSON-HR-10 / DLA, 2x3 mm1A107M280KC Каждый банк: 10 × 100 мкФ TDK C4532X5R1A107M280KC / 10 В / X5R / 1812. Номинально 1000 мкФ.L3, L4: CDRH127/LDNP-2R4NC, 2,4 мкГн каждый. R40/R41: 22 мОм только в ветвях C.Cэфф ≥330 мкФ — требование приёмки; типовые кривые не дают гарантии. Проверить банк и запуск.J11 соединяет выход LC с SYS_3V3 всех нагрузок. Снять ДО USB; вернуть после отключения USB.C12 + C52: два локальных 10 мкФ / 16 В / 0805. C53, C54, C55: резерв 1206 / DNP.Проверить минимумы/максимумы 3V3 при подключении USB, PFM/PWM и скачке нагрузки.1A107M280KC 1812R55: 47 мОм последовательно перед L3; падение 47 мВ/А. FB и C14 до R55.1A107M280KC1812C4532X5R1A107M280KCC4532X5RC4532X5R18121206 / 0.25 WR0470FEAWSL1206DNP; MPN не выбран1812
0805RT0805BRE0710KL08051A107M280KC C4532X5R1A107M280KCC4532X5R12.3 x 12.3 x 8 mmRNCF0805BKE56K01A107M280KC CL21A226C4532X5R C4532X5R CDRH127/LDNP-2R4NC1812 181218121A107M280KC1812FILTER_MIDC4532X5R 18121A107M280KC0805
1206Каскад 
2: Cэфф ≥ 330 мкФ при 3,3 В1A107M280KC1812 CL10B104KB8NNNC0603C4532X5R C4532X5R181218121812 C4532X5R1A107M280KC18121812WSL1206R0220FEAWSL1206, 1206 (3216)V2.0-A1 / 2026-10-11 / инженерный прототип1812
DNP; MPN не выбранTPS63802 — питание и двухкаскадный LC-фильтрCL21B106KOQNNNE1A107M280KC 1812C4532X5R12.3 x 12.3 x 8 mm1A107M280KCC4532X5RRT0805BRD0740K2L08051812 1A107M280KC C4532X5RXGL4020-471MECDNP; MPN не выбранCL21B106KOQNNNEH max 2.1 mm120612061A107M280KC C4532X5RC4532X5RC4532X5R1A107M280KCMAQNNNE080508051A107M280KC WSL1206R0220FEAU2TPS63802DLAREN1MODE2AGND3FB4PG5VOUT6L27PGND8L19VIN10C13100nF 50V X7R
PAGE 3
1
23456781
2345678A
BCDEFA
BCDEFDate: 2026-10-11KiCad E.D.A. 10.0.6Rev: V2.0-A1Size: A3Id: 3/5Title: LMV431A / LTO 2S опцияFile: LTO_Balancer.kicad_schSheet: /3. LTO_Balancer/Электрическая принципиальная; прототипR50
100k 0.1%NC1A2K3REF4A5U8LMV431ANC 1A2K3REF4A5U9LMV431AC5947nF 16V X7RC5847nF 16V X7RR472R 1%R48120k 0.1%R54 100k 0.1%R492.49k 0.1%R52 120k 0.1%PACK+1MID2PACK-3NC4J12LTO 2S + MID -R51 2R 1%R532.49k 0.1%BATLTO_MID
BATLTO_MID LTO_MID Балласт 
R47/R51 = 2R по выбору пользователя; ток LMV431 на углах допусков не ограничен до 15 мА.LMV431AIM5/NOPBSOT-23-5Верхняя ячейкаV2.0-A1 / 2026-10-11 / инженерный прототипБалансир 2S LTO / опциональная сборка POWERMPN TBD / 47nF X7R 16V / LTO only0805SOT-23-5LMV431AIM5/NOPB0805XH 1x4 / 2.50 / 90degMPN TBD / 100k 0.1% / LTO only0805MPN TBD / 47nF X7R 16V / LTO onlyMPN TBD / 2.49k 0.1% / LTO only08050805 MPN TBD / 120k 0.1% / LTO only08050805MPN TBD / 2.49k 0.1% / LTO only0805RC0805FR-072RL / LTO onlyMPN TBD / 100k 0.1% / LTO onlyБалансир: 2R, 120k+2,49k / 100k (0,1%), LMV431A, 47nF.V2.0-A1: отдельной защиты ячеек и защиты от перенапряжения нет.Нижняя 
ячейкаRC0805FR-072RL / LTO only0805POWER: 
балансир под средним экраном. J12: 1 PACK+ / 2 MID / 3 PACK-.MPN 
TBD / 120k 0.1% / LTO only0805Na-ion: R3=61,9k / R4=100k / C30=12pF. LTO: 121k / 100k / 6,8pF. Допуск R: 0,1%.Na-ion: этот лист не запаивать. LTO 2S: запаять все компоненты этого листа.LTO: номинал 5,345 В; максимум 5,445 В при ТКС ≤25 ppm/°C, -40…85°C. Выбросы не учтены.L-KLS1-2.50-04-R / LTO onlyJ12LTO 2S + MID -PACK+1MID2PACK-3NC4
PAGE 4
1
23456781
2345678A
BCDEFA
BCDEFDate: 2026-10-11KiCad E.D.A. 10.0.6Rev: V2.0-A1Size: A3Id: 4/5Title: LM393XK / холодный заряд Na-ionFile: Thermal.kicad_schSheet: /4. Thermal/Электрическая принципиальная; прототипR60
100k 1%R6930k 1%R6510k 1%R63 100k 1%R5747k 1% 0.125WG 1S2D3Q5BSS138C62100nF 100V X7RR661k 1%NC1K2A3U11LM285Z-2.5GR70 150k 1%R621M 1%C611nF 100V C0GC60 100nF 100V X7RR59100k 1%R68 1k 1%G
1S2D3Q6AO3401AG1S2D3Q4AO3401AOUT_A 1-_A2+_A3GND4+_B5-_B6OUT_B7VCC8U10LM393XK1
2TH110k NTC 1% B3988R61100k 1%R641.2M 1%R58 100k 1%R67 1M 1%G
1S2D3Q7AO3401ASOLAR
CHG_G_SHUNT
CHG_CS_MSOLAR
CS_P
CHG_G_SHUNT CHG_G_SHUNT
CS_P
CHG_G_ENABLE
CHG_VREFCHG_VTH_UP CHG_WARM CHG_HYST_MIDCHG_VTHCHG_TSENSECHG_VSHORTCHG_PULLDOWN Снижение тока на холоде / Na-ion / опция POWERV2.0-A1 / 2026-10-11 / инженерный прототипLM285Z-2.5GTO-92 / шаг 1.27 mmRC0805FR-071KL 080508050805RC0805FR-0710KLAO3401ARC0805FR-07100KL
SOT-23
CC0805JRNPO0BN1020805 0805RC0805FR-071ML 08050805 RC0805FR-071KLNTC ø2.41 / P2.54RC0805FR-071ML CC0805KKX7R0BB104080508050805 RC0805FR-0730KLRC0805FR-07150KLBSS138 SOT-23AO3401A0805
0805 RC0805FR-0747KL
Q4 
/ Q6 / Q7: S = до R56; D = после R56.R58 закрывает ключи при выключенном управлении.SOT-23RC0805FR-07100KL B57861S0103F0400805 CC0805KKX7R0BB104
-t°TH1: B57861S0103F040; 10k, B25/100 = 3988 K, R/T 8016.Один NTC: на плате либо на проводах у аккумулятора.На плате измеряется температура под экраном.Обрыв или КЗ NTC → холодный ток.RC0805FR-071M2LR60 + R69 = 130k; R62 + R70 = 1,15M.Номинальные пороги: холод −17,4 °C; тепло −14,5 °C.OUT A и OUT B — соединённые открытые коллекторы.CHG_WARM высокий: Q5 включён, R56 обойдён.CHG_WARM низкий: Q5 выключен, R58 закрывает Q4/Q6/Q7.0805
RC0805FR-07100KLNa-ion 
с опцией: установить весь узел, R56 = 1,8 Ом.LTO / без опции: R56 = 0 Ом, остальные 24 позиции не ставить.Основной R1 = 0,28 Ом остаётся во всех вариантах.Холод ≈ 96 мА; тепло ≈ 665 мА (зависит от RDS(on)).SOIC-8 / 3.9 mm0805LM393XK RC0805FR-07100KLRC0805FR-07100KLSOT-23
0805
0805AO3401A

PAGE 5
1
23456781
2345678A
BCDEFA
BCDEFDate: 2026-10-11KiCad E.D.A. 10.0.6Rev: V2.0-A1Size: A3Id: 5/5Title: Межплатное соединение / POWER ↔ LOGICFile: Interconnect.kicad_schSheet: /5. Interconnect/Электрическая принципиальная; прототипGND 1H3M3 GND contactGND1H2M3 GND contactGND1H1M3 GND contactGND1H4M3 GND contactFILTER_OUT
1GND2FILTER_OUT3GND4FILTER_OUT5GND6FILTER_OUT7GND8BAT9GND10MODE11GND12J101INTERBOARD 12PMODEFILTER_OUTFILTER_OUTFILTER_OUTFILTER_OUTBATЭкран/стойки: только GND/EMI; не обязательный силовой возврат.Полная распиновка и маршрут кабеля — interboard_connections.csv.DS1013-12RSIB-B-0 Основные токи FILTER_OUT и GND идут по кабелю.BAT: отдельный отвод измерения прямо от разъёма батареи.Mesh Repeater 2.0 — POWER / межплатные соединенияMODE: R21 на LOGIC у источника; R17 pull-down на POWER.IDC 2x6 / 2.54 / 90degV2.0-A1 / 2026-10-11 / инженерный прототипD3 CHARGE / D4 DONE находятся только на POWER.J101 INTERBOARD 12PFILTER_OUT1GND2FILTER_OUT3GND4FILTER_OUT5GND6FILTER_OUT7GND8BAT9GND10MODE11GND12
