Alksndr55/mesh-repeater-2.0/audit/V2_ENGINEERING_AUDIT_A3_2026_10_13/SOFTWARE_BOM_pdf_MeshRepeater2_Power_V2_A2_INA219_schematic.txt

PAGE 1
1
23456781
2345678A
BCDEFA
BCDEFDate: 2026-10-12KiCad E.D.A. 10.0.6Rev: V2.0-A2Size: A3Id: 1/6Title: CN3722 / зарядка Na-ion и LTOFile: MeshRepeater2_Power.kicad_schSheet: /Электрическая принципиальная; прототип6. InterconnectФайл: Interconnect.kicad_sch3. LTO_BalancerФайл: LTO_Balancer.kicad_sch4. ThermalФайл: Thermal.kicad_sch2. ConverterФайл: Converter.kicad_sch5. BatteryMonitorФайл: BatteryMonitor.kicad_schR51M 0.1%C6220nF 50V X7RR1 0.28R 1%1122J7SOLAR 12VR810k 0.1%R9 10kTP9K
AD3REDR1010kC7100nF 50V X7RC5470pF 50VC0GR561.8 ohm 1% 0.125WC110uF 50V X7RC2100nF 50VX7RC847uF 35VR7105k 0.1%K
AD4GREENR1110k1
1R6 120RVG1PGND2GND3CHRG4DONE5TEMP6MPPT7COM18COM29FB10COM311NC12CSP13BAT14VCC15DRV16U1CN3722R4 100k 0.1%L1100uHKAD2SS24C4 22uF 25V X5RKAD1SS24C30 12pF 50V C0G1
R3 61.9k 0.1%C3100nF 50V X7RG1S2D3Q1AO3401ACHRG
SOLAR
CS_P SOLARCHG_CS_M CHRGBAT_SYS SOLARDONESOLARBAT_SYSSOLARDONE SOLARGATE
SMB / DO-214AACC0805KKX7R9BB224
AO3401A
0805
CC0805JRNPO90805RC0805FR-071R8L Na-ion 
/ опция: R56 = 1,8 Ом; холод ≈ 96 мА; тепло ≈ 665 мА. Управление: лист 4.LTO / без опции: R56 = 0 Ом; узел Thermal не ставить. R1 = 0,28 Ом: ток ≈ 714 мА, максимум ≈ 784 мА.0805TEMP: защитаотключена по заданию.CL21B104KBCNNNC08050805AT0805BRD07105KLCL21B104KBCNNNCTSSOP-16, 4.4x5 mmKelvin:CSP до R56;BAT после R1RT0805BRE0710KLBN471 1206CL31B106KBHNNNE12.3 x 12.3 x 8 mm1206 BAT senseMPPT: Vmp ≈ 11,96 В.R7/R8 = 105/10 кОм.Vmp ≈ 18 В: изменить R7.Панель 12 В.Холодный Voc ≤ 24 В.SOT-23
0805080508050805 RT0805BRD071MLCL21B104KBCNNNC0805 RC0805FR-0710KL0805 7W0R28LCN3722RT0805BRD0761K9L EEEFK1V470P0805 RT0805BRD07100KLCL21A226MAQNNNERC0805FR-0710KLPT1206FR-0805CC0805JRNPO9BN120 0805Na-ion: R3 61,9k / R4 100k; C30 12pF; CV ≈ 3,915 ВLTO 2S: R3 121k / R4 100k; C30 6,8pF; CV ≈ 5,345 ВДелитель: 0,1%; ТКС ≤25 ppm/°C. LTO: запаять балансир.FYLS-0805BURCCDRH127/LDNP-101MC
SMB / DO-214AAS2B-XH-A(LF)(SN)XH 1x2 / 2.50 / 90degRC0805FR-0710KL 0805SS240805
V2.0-A2 / 2026-10-12 / инженерный прототип0805 
(2012)RC0805FR-07120RLSS2401. Солнечная зарядка CN3722 / аккумулятор Na-ion 1SSOLAR0805 
(2012)FYLS-0805BUGC0805SMD / D6.3 x 5.8 mmU1CN3722VG1PGND2GND3CHRG4DONE5TEMP6MPPT7COM18COM29FB10COM311NC12CSP13BAT14VCC15DRV16
PAGE 2
1
23456781
2345678A
BCDEFA
BCDEFDate: 2026-10-12KiCad E.D.A. 10.0.6Rev: V2.0-A2Size: A3Id: 2/6Title: TPS63802 / питание и фильтрFile: Converter.kicad_schSheet: /2. Converter/Электрическая принципиальная; прототипC14
22uF 25VX5RC41 100uFC40100uFC53DNPC51 100uFC15100uFC35100uFC38100uFC50 100uFC49100uFR4122mR 1%C47100uFC43100uFC48100uFR1540.2k 0.1%C42 100uFR17100kL20.47uHC1210uF 16V X7RC37 100uFC16100uFR1649.9k 0.1%C5210uF 16V X7RTP8 C46 100uFC45100uFR1356k 0.1%C54DNPC55DNPC36100uFTP6TP3R1410k 0.1%L32.4uHL4 2.4uHC13100nF 50V X7RR40 22mR 1%R5547mR 1%C44 100uF1C34100uFEN1MODE2AGND3FB4PG5VOUT6L27PGND8L19VIN10U2TPS63802DLARC39 100uFTP1BATBATMODEFILTER_OUT BAT_SYSFILTER_OUT
LX1
SYS_PREFILTER_MID LX2FB_SYSSYS_LC_INEN_UVJ11 соединяет выход LC с SYS_3V3 всех нагрузок. Снять ДО USB; вернуть после отключения USB.Каждый банк: 10 × 100 мкФ TDK C4532X5R1A107M280KC / 10 В / X5R / 1812. Номинально 1000 мкФ.L3, L4: CDRH127/LDNP-2R4NC, 2,4 мкГн каждый. R40/R41: 22 мОм только в ветвях C.Cэфф ≥330 мкФ — требование приёмки; типовые кривые не дают гарантии. Проверить банк и запуск.RC0805FR-07100KLTPS63802DLARVSON-HR-10 / DLA, 2x3 mmEN / LTO: R15=130 кОм; R16=49,9 кОм; выкл.≈3,605 В; вкл.≈3,966 В (тип.).SYS_PRE: 3,300 В; FB до L3. C14 — локальная ёмкость TPS63802.TXEN=0: PFM; TXEN=1: forced PWM.EN / Na: R15=40,2 кОм; R16=49,9 кОм; выкл.≈1,806 В; вкл.≈1,986 В.08050805RT0805BRD0749K9LFILTER_MID R0470FEARNCF0805BKE56K0WSL12061206 / 0.25 W1A107M280KCC4532X5R12.3 x 12.3 x 8 mmCDRH127/LDNP-2R4NC1A107M280KC C4532X5R1A107M280KC0805CL21A226CL21B106KOQNNNERT0805BRD0740K2L0805060308051A107M280KC C4532X5R18121812Каскад 2: Cэфф ≥ 330 мкФ при 3,3 В1812CL10B104KB8NNNC1A107M280KC 1A107M280KCC4532X5R1812C4532X5R1A107M280KC18121A107M280KCC4532X5R1812R55: 47 мОм последовательно перед L3; падение 47 мВ/А. FB и C14 до R55.Каскад 1: Cэфф ≥ 330 мкФ при 3,3 В18121206
4 x 4 mmH max 2.1 mmXGL4020-471MEC1A107M280KC
C4532X5R181208051812 18121A107M280KC18121A107M280KC12061A107M280KC
1812C4532X5RC4532X5RDNP; MPN не выбранC4532X5R
WSL1206R0220FEART0805BRE0710KL1812 1812 C4532X5RC12 + C52: два локальных 10 мкФ / 16 В / 0805. C53, C54, C55: резерв 1206 / DNP.1A107M280KC 0805MAQNNNEDNP; MPN не выбран1A107M280KC 1812C4532X5RC4532X5R1812CL21B106KOQNNNE08051812
1A107M280KC18121206V2.0-A2 / 2026-10-12 / инженерный прототип1A107M280KC
C4532X5R1A107M280KCTPS63802 — питание и двухкаскадный LC-фильтрC4532X5R
1A107M280KC12.3 x 12.3 x 8 mmCDRH127/LDNP-2R4NCFILTER_OUT → межплатные штыри → J11.1 (LOGIC).1812WSL1206, 1206 (3216)1A107M280KCC4532X5RWSL1206R0220FEAWSL1206, 1206 (3216)C4532X5R C4532X5RDNP; MPN не выбранC4532X5R 1A107M280KC1812Проверить минимумы/максимумы 3V3 при подключении USB, PFM/PWM и скачке нагрузки.C4532X5R C13100nF 50V X7RU2TPS63802DLAREN1MODE2AGND3FB4PG5VOUT6L27PGND8L19VIN10
PAGE 3
1
23456781
2345678A
BCDEFA
BCDEFDate: 2026-10-12KiCad E.D.A. 10.0.6Rev: V2.0-A2Size: A3Id: 3/6Title: LMV431A / LTO 2S опцияFile: LTO_Balancer.kicad_schSheet: /3. LTO_Balancer/Электрическая принципиальная; прототипPACK+1MID2PACK-3NC4J12LTO 2S + MID -C5847nF 16V X7RR532.49k 0.1%NC1A2K3REF4A5U9LMV431AR52120k 0.1%R492.49k 0.1%R48120k 0.1%C59 47nF 16V X7RR512R 1%R472R 1%R50100k 0.1%NC1A2K3REF4A5U8LMV431AR54 100k 0.1%BATLTO_MID
LTO_MID
LTO_MIDBAT0805 MPN TBD / 47nF X7R 16V / LTO onlyLMV431AIM5/NOPBSOT-23-50805MPN TBD / 100k 0.1% / LTO onlyRC0805FR-072RL / LTO onlyLMV431AIM5/NOPB0805LTO: номинал 5,345 В; максимум 5,445 В при ТКС ≤25 ppm/°C, -40…85°C. Выбросы не учтены.Балансир: 2R, 120k+2,49k / 100k (0,1%), LMV431A, 47nF.Балансир 2S LTO / опциональная сборка POWERВерхняя ячейкаV2.0-A2 / 2026-10-12 / инженерный прототипMPN TBD / 120k 0.1% / LTO onlyPOWER: 
балансир под средним экраном. J12: 1 PACK+ / 2 MID / 3 PACK-.SOT-23-5XH 1x4 / 2.50 / 90deg0805RC0805FR-072RL / LTO only0805L-KLS1-2.50-04-R 
/ LTO only0805 0805 Нижняя ячейкаMPN TBD / 2.49k 0.1% / LTO onlyMPN TBD / 2.49k 0.1% / LTO onlyNa-ion: R3=61,9k / R4=100k / C30=12pF. LTO: 121k / 100k / 6,8pF. Допуск R: 0,1%.MPN TBD / 120k 0.1% / LTO onlyMPN TBD / 47nF X7R 16V / LTO onlyБалласт R47/R51 = 2R по выбору пользователя; ток LMV431 на углах допусков не ограничен до 15 мА.0805
0805MPN TBD / 100k 0.1% / LTO onlyV2.0-A2: отдельной защиты ячеек и защиты от перенапряжения нет.Na-ion: этот лист не запаивать. LTO 2S: запаять все компоненты этого листа.0805J12LTO 2S + MID -PACK+1MID2PACK-3NC4
PAGE 4
1
23456781
2345678A
BCDEFA
BCDEFDate: 2026-10-12KiCad E.D.A. 10.0.6Rev: V2.0-A2Size: A3Id: 4/6Title: LM393XK / холодный заряд Na-ionFile: Thermal.kicad_schSheet: /4. Thermal/Электрическая принципиальная; прототипG
1S2D3Q4AO3401AR62
1M 1%R61100k 1%OUT_A 1-_A2+_A3GND4+_B5-_B6OUT_B7VCC8U10LM393XKR6930k 1%R66 1k 1%G1S2D3Q5BSS138G
1S2D3Q6AO3401AR57
47k 1% 0.125WR6510k 1%R60 100k 1%R641.2M 1%R58 100k 1%R63
100k 1%NC1K2A3U11LM285Z-2.5GC60 100nF 100V X7RR671M 1%R70150k 1%C62100nF 100V X7R1
2TH110k NTC 1% B3988C611nF 100V C0GR68 1k 1%R59100k 1%G1S2D3Q7AO3401ACHG_G_SHUNTSOLAR
CS_P
CS_P CHG_G_SHUNTCHG_G_SHUNT
SOLARCHG_CS_M
CHG_HYST_MID
CHG_VREFCHG_VTH CHG_WARM CHG_VTH_UPCHG_TSENSECHG_PULLDOWN CHG_VSHORTCHG_G_ENABLE RC0805FR-07100KLAO3401A
AO3401ALM393XK RC0805FR-071KL RC0805FR-0747KLСнижение тока на холоде / Na-ion / опция POWER0805 SOIC-8 / 3.9 mmV2.0-A2 
/ 2026-10-12 / инженерный прототип0805 0805
RC0805FR-07100KL
RC0805FR-07100KL
0805RC0805FR-071M2LRC0805FR-071KL 0805RC0805FR-07100KL0805TH1: B57861S0103F040; 10k, B25/100 = 3988 K, R/T 8016.Один NTC: на плате либо на проводах у аккумулятора.На плате измеряется температура под экраном.Обрыв или КЗ NTC → холодный ток.Na-ion с опцией: установить весь узел, R56 = 1,8 Ом.LTO / без опции: R56 = 0 Ом, остальные 24 позиции не ставить.Основной R1 = 0,28 Ом остаётся во всех вариантах.Холод ≈ 96 мА; тепло ≈ 665 мА (зависит от RDS(on)).CC0805JRNPO0BN102NTC ø2.41 / P2.54-t°SOT-230805
RC0805FR-0710KL08050805 RC0805FR-071MLSOT-230805AO3401A
R60 + R69 = 130k; R62 + R70 = 1,15M.Номинальные пороги: холод −17,4 °C; тепло −14,5 °C.OUT A и OUT B — соединённые открытые коллекторы.CHG_WARM высокий: Q5 включён, R56 обойдён.CHG_WARM низкий: Q5 выключен, R58 закрывает Q4/Q6/Q7.B57861S0103F040RC0805FR-07100KL CC0805KKX7R0BB104 CC0805KKX7R0BB104BSS13808050805LM285Z-2.5G0805 RC0805FR-071ML 0805RC0805FR-0730KLTO-92 / шаг 1.27 mmRC0805FR-07150KL 0805SOT-23
SOT-230805
0805Q4 
/ Q6 / Q7: S = до R56; D = после R56.R58 закрывает ключи при выключенном управлении.
PAGE 5
1
23456781
2345678A
BCDEFA
BCDEFDate: 2026-10-12KiCad E.D.A. 10.0.6Rev: V2.0-A2Size: A3Id: 5/6Title: INA219 / батарея и токFile: BatteryMonitor.kicad_schSheet: /5. BatteryMonitor/Электрическая принципиальная; прототипC64
100nF 50V X7RA11A02SDA3SCL4VS5GND6IN-7IN+8U12INA219AIDR1
1C63100nF 50V X7RR7210R 1%+ 1GND2J8Na-ion 1SR710.1R 1% 1WR7310R 1%SDA SYS_3V3 BATBATBAT_SYSBAT SCLSYS_3V3INA219 — напряжение и основной ток батареиV2.0-A2 / 2026-10-12 / инженерный прототипINA219AIDR
SOIC-8 / 3.9x4.9 / P1.27От зарядника / к TPS638022512 / 1W0805CC0805KRX7R9BB104RL2512FK-070R1L0805RC0805FR-0710RLБалансиры подключены к ячейкам напрямую: их токи не входят в основной ток INA219.CN3722 FB/BAT sense остаются до R71 на BAT_SYS; EN и BAT_ADC — от BAT.Питание VS: SYS_3V3 с LOGIC через J101.7; работает при USB и снятой J11.A1=A0=GND: адрес 0x40. SDA/SCL — существующий I2C NiceNano.Kelvin от внутренних краёв площадок R71XH 1x2 / 2.50 / 90degS2B-XH-A(LF)(SN)R71=0,1 Ом: штатная калибровка MeshCore. Ток заряда +, разряда −.RC0805FR-0710RL0805CC0805KRX7R9BB104 0805Батарея Na-ion 1S; LTO — J12C64100nF 50V X7RU12INA219AIDRA11A02SDA3SCL4VS5GND6IN-7IN+8
PAGE 6
1
23456781
2345678A
BCDEFA
BCDEFDate: 2026-10-12KiCad E.D.A. 10.0.6Rev: V2.0-A2Size: A3Id: 6/6Title: Межплатное соединение / POWER ↔ LOGICFile: Interconnect.kicad_schSheet: /6. Interconnect/Электрическая принципиальная; прототипGND
1H2M3 GND contactGND1H4M3 GND contactGND1H3M3 GND contactGND1H1M3 GND contactFILTER_OUT
1GND2FILTER_OUT3GND4FILTER_OUT5GND6SYS_3V37GND8BAT9SDA10MODE11SCL12J101INTERBOARD 2x6 VERTICALFILTER_OUTFILTER_OUTSCLBATMODESDASYS_3V3FILTER_OUTMesh Repeater 2.0 — POWER / межплатные соединенияBAT: отдельный отвод измерения прямо от разъёма батареи.Основные токи FILTER_OUT и GND идут через вертикальные штыри.SYS_3V3 возвращается с LOGIC только для питания INA219.E-SIMPO L35mm A3C6 2x6PMODE: R21 на LOGIC у источника; R17 pull-down на POWER.Экран/стойки: 
только GND/EMI; не обязательный силовой возврат.V2.0-A2 
/ 2026-10-12 / инженерный прототипD3 CHARGE / D4 DONE находятся только на POWER.THT 2x6 / 2.54 / verticalРаспиновка прямого соединения — interboard_connections.csv.J101
INTERBOARD 2x6 VERTICALFILTER_OUT1GND2FILTER_OUT3GND4FILTER_OUT5GND6SYS_3V37GND8BAT9SDA10MODE11SCL12
