Alksndr55/mesh-repeater-2.0/audit/V2_ENGINEERING_AUDIT_A3_2026_10_13/SOFTWARE_BOM_REPORT_RU.md

# Независимый участок аудита A3: прошивка, BOM, интерфейсы и выпуск

Дата: 13.10.2026. Объект: `C:/Users/Alksndr/Desktop/codex/Meshcore/v2`, `main`, исходный HEAD `d1206d1cf134ac7ee1fb50b80c9488904241908c` с текущими локальными изменениями A3. Изменения источников не вносились. Этот файл — приложение к основному отчёту; предварительные номера F01–F07 назначены только для объединения root-агентом.

## Существенные результаты

1. Совместимость питания GPS с точно указанным Heltec T114 V2.1 не доказана: два первичных документа Heltec расходятся по контактам 6/7. Это обоснованный риск, а не доказанный неверный проводник A3.
2. В A3-инструкции описания направлений UART J4.4/J4.5 перевёрнуты. Электрическая схема и проверенная прошивка по направлению UART совпадают.
3. `bom/NOTES_RU.txt` объявляет актуальной прежнюю BOM A2; она заказывает старые корпуса силовых резисторов. Сама `V2_A3_COMPONENT_BOM.csv` согласуется с моделями и свежими native XML по всем 179 позициям.
4. Watchdog реально пересобран: 406 байт Flash / 4 байта RAM, сохранённый HEX побайтно совпал. Полная изолированная попытка сборки MeshCore выполнена с подготовленными зависимостями. После обхода поиска системного C++ header она остановилась на создании длинных object-paths ассемблером Windows при компиляции SDK; firmware не получен. Дефект исходников A3 этим не доказан.
5. На 13.10.2026 кабельного корпуса ДАН 205451 для J12 нет в наличии. Незаполненные MPN LTO и неизвестные модуль/ответная часть GPS сохраняют незавершённость закупочного комплекта.

## Замечания

### F01 — несовместимые первичные сведения о питании GPS, высокая / обоснованный риск и недостающие данные

**Места:** LOGIC J4.6, J4.7; Q2/Q3/U7; `design/MeshRepeater2_Logic/model.json:821`; `docs/V2_ASSEMBLY_INSTRUCTIONS_RU.md:156`; `design/MeshRepeater2_Logic/RTC_IO.kicad_sch`; свежий `LOGIC_netlist.xml`, сети GPS_3V3 и SYS_3V3.

**Факт:** A3 подаёт постоянное SYS_3V3 на J4.6, переключаемое GPS_3V3 на J4.7. Однако [официальная схема MeshNode-T114_V2.1.pdf](https://resource.heltec.cn/download/Mesh_Node_T114/schematic/MeshNode-T114_V2.1.pdf), единственная страница, P3, показывает 6=Ve_3V3 от включаемого U5, 7=VDD_nRF. [Официальная карта аксессуара L76K](https://heltec.org/wp-content/uploads/2025/07/L76K-Pin-map-1024x733.png) показывает для восьмиконтактного разъёма 6=VDD_3V3, 7=Ve_3V3. Последняя совпадает с назначением A3. [Карта самого L76K](https://heltec.org/wp-content/uploads/2025/07/L76K_pinmap.png) различает вывод 6 V_BCKP и 8 VCC.

**Условия/последствия:** при кабеле, передающем несоответствующую карту питания, отключение GPS_EN может снять резервное питание при сохранённом основном либо основной GPS останется включённым. U7 тогда отключается независимо от реально питаемого GPS. Возможны отсутствие UART, потеря горячего старта и лишний ток. Повреждение от этих двух 3,3-В цепей не доказано. Нельзя уверенно назвать A3 неверной без выбранной аппаратной ревизии аксессуара и карты обоих концов кабеля.

**Минимальное предложение:** до включения аксессуара зафиксировать точный GPS-модуль/ревизию и прозвонку реального кабеля; выбрать правильную карту, затем по необходимости исправить J4.6/J4.7 или явно документировать перекрёстный кабель. Не менять расположение питания только по одному из противоречивых документов.

**Проверка:** без питания прозвонить J4.6 до L76K.6 V_BCKP, J4.7 до L76K.8 VCC и землю. При GPS_EN=LOW основной VCC выбранного GPS должен быть отключён, резервный должен сохраняться; при HIGH основной должен соответствовать рабочему диапазону изготовителя. Подтвердить NMEA 9600 бод и повторный запуск после LOW/HIGH. Критерий распиновки — фактический выбранный аксессуар, а не цвет провода. Документы и PNG сохранены с префиксом `SOFTWARE_BOM_Heltec_`.

### F02 — направления J4 UART перепутаны в инструкции, средняя / подтверждённый дефект документации

**Место:** `docs/V2_ASSEMBLY_INSTRUCTIONS_RU.md:154` и `:155`. J4.4 описан как «линия приёма MCU», J4.5 как «линия передачи MCU».

**Доказательство:** свежий XML: M1.20/P0.20 → U7.2 (1A) → U7.6 (1Y) → J4.4 RXD_GPS; J4.5 TXD_GPS → U7.5 (2A) → U7.3 (2Y) → M1.19/P0.22. Следовательно J4.4 передаёт **от MCU к GPS**, J4.5 **от GPS к MCU**. Это также соответствует именам GPS_RX_EXT/GPS_TX_EXT, заданным со стороны GPS. Нумерация и входы/выходы U7 подтверждаются [TI SN74LVC2G125, Rev. Q](https://www.ti.com/lit/ds/symlink/sn74lvc2g125.pdf), p.4 и pin-function table. Питание аксессуара — отдельный F01.

**Последствие:** изготовление собственного кабеля или проверка UART по одной таблице может перевернуть TX/RX и дать неработающий GPS; при прямом подключении без U7 возможно соединение выходов. С текущим штатным кабелем само описание не меняет проводников.

**Минимальное предложение:** заменить два описания на «вход RX GPS / выход TX MCU» и «выход TX GPS / вход RX MCU»; согласовать обозначения схемы, таблицы и тестового кабеля.

**Проверка:** снова сравнить таблицу с полной цепью обоих буферов, затем зарегистрировать NMEA на M1.19 и передачу команды на J4.4.

### F03 — текущие указатели и метаданные расходятся по редакции, средняя / подтверждённый дефект прослеживаемости

**Места:** `bom/NOTES_RU.txt:4`; POWER и LOGIC native PCB `title_block`, строки12/13; `output/pdf/SCHEMATIC_MANIFEST.json:2`; `docs/V2_CHANGES_FROM_S4_16_RU.md:5,7,13`. В списке «Актуальные файлы» памятки указан `V2_COMPONENT_BOM.csv`, а не `V2_A3_COMPONENT_BOM.csv`.

**Доказательство:** в прежней CSV R1 — PT1206FR-7W0R28L / 1206 (стр.7), R40/R41 — WSL1206R0220FEA (63/64), R55 — WSL1206R0470FEA (90), R56 — RC0805FR-071R8L / 0805 (91), J11 расположен на LOGIC (123). Текущая CSV даёт R1/R40/R41/R55/R56 в 2512 и J11 на POWER. Источники текущих плат используют эти A3-посадки; заказ по объявленной в памятке «актуальной» CSV закупит несколько физически неподходящих деталей. Памятка также говорит о межплатном кабеле и IDC.

В обоих текущих PCB POWER/LOGIC `title_block` сохраняет дату2026-10-12 и revV2.0-A2, хотя native компоненты/проводники соответствуютA3, title-block схем и SHIELD — A3. Общий PDF-manifest также обозначенA2 и указываетA2-netlist/PDF; он не доказывает соответствиеA3. ОсновнойREADME корректно указываетA3, поэтому это несогласованность нескольких входов, а не неопределённость выбранного объекта аудита. ИсторическиеPDF, которые README явно называет прежними, отдельно дефектом не считаются.

Ещё один текущий документ `V2_CHANGES_FROM_S4_16_RU.md` в начале, без пометки этих абзацев как архивных, описывает 12-контактный межплатный кабель и J11 на LOGIC (строка5), шесть земляных жил (7) и проверку IDC-розеток (13). Фактическая A3 использует прямую вертикальную пару, J11 на POWER и три GND-контакта. Этот документ нельзя использовать как актуальное описание подключения; он входит в ту же общую причину несогласованного обновления указателей/описаний редакции, отдельного дублирующего замечания не создаётся.

**Минимальное предложение:** исправить указатель памятки на A3, обновить rev/date настоящих PCB, а A2 CSV/PDF-manifest явно обозначить как исторические или сформировать новый manifestA3. Обновить вводные текущие абзацы `V2_CHANGES_FROM_S4_16_RU.md` до A3 либо явно назвать их историческим состоянием и дать рядом действующий A3-контракт. Сохранённые старые данные не удалять; не направлять к ним новый заказ.

**Проверка:** проверить все пользовательские ссылки на текущую BOM и сформировать контрольный заказ выбранного варианта с шестью согласованными позициями 2512 и J11 POWER.

### F04 — BAT_ADC имеет неподтверждённую калибровку штатного коэффициента, средняя / обоснованный риск, унаследован

**Места:** LOGIC R27/R28=2,2 МОм ±0,1%, C25=100 нФ, M1.8/P0.31; внешний `variants/promicro/PromicroBoard.h:8,18–29` (закреплённый SHA); `docs/V2_LIMITATIONS_RU.md:28`.

**Факт/расчёт:** штатный `ADC_MULTIPLIER=1.815f`, 12-битный ADC, восемь чтений. Ядро, указанное MeshCore как d541301, `cores/nRF5/wiring_analog_nRF52.c:31–33,62–100` по умолчанию использует внутренние 0,6 В с gain 1/6, диапазон 3,6 В. В полном архиве MeshCore не найдено `analogReference`/`analogSampleTime` для общего кода или ProMicro. Идеальный коэффициент для делителя 1:2: 3600 мВ × 2 / 4096 = **1,7578125 мВ/count**. Отношение 1,815/1,7578125 − 1 = **+3,2533%**; идеальные 3,915 В показались бы около **4,0424 В**. Это модель идеального SAADC: реальный клон, утечки, опорное напряжение и существующая пользовательская калибровка неизвестны, поэтому дефект фактического экземпляра не доказан. τ=(2,2 МОм || 2,2 МОм)×100 нФ=0,11 с.

**Последствия:** возможная систематическая ошибка телеметрии аккумулятора. Зарядный CV и аппаратный EN не зависят от этого программного коэффициента, поэтому электрическую опасность из данного расчёта не выводить.

**Минимальное предложение:** сохранить GPIO и отношение делителя, измерить реальную передаточную характеристику и записать поддерживаемый `setAdcMultiplier`; установить допустимую ошибку по требованию проекта. Снижение импеданса/изменение схемы не требуется без измерений.

**Проверка:** для Na-ion и LTO подать минимум, середину и максимум рабочих напряжений через ограниченный источник, выдержать ≥5τ=0,55 с, сравнить BAT у J8/J12 и M1.8 с эталонным DMM и телеметрией. Отдельно сравнить режимы без TX, с TX и USB; подтвердить ошибку в пределах согласованного бюджета SAADC/резисторов/утечек. Само испытание не выполнено.

### F05 — комплект закупки не закрыт для выбранного LTO и GPS, средняя / недостающие данные и риск закупки

**Места:** BOM A3 R15/C30 LTO, R48/R49/R50/R52/R53/R54/C58/C59, M2; `bom/DAN_NEW_PARTS.csv:8` (J12_HARNESS); J4 и M1.

**Факт:** десять устанавливаемых LTO-позиций имеют MPN `not selected`/`TBD`. M2 имеет `HT-RA62 band variant TBD`, хотя рассмотренная прошивка задаёт 869,618 МГц и +22 dBm. Для J4 не указаны точные GPS-модуль/ревизия, кабельный корпус/контакты и карта кабеля; для двух рядов сокетов M1 предусмотренная высота/точный комплект не выделены закупочными позициями. Собственная доработка и пользовательская проверка клона приняты как исходный контекст; отсутствие документации конкретного клона не объявляется автоматическим дефектом.

**ДАН 13.10:** основной товар [205451, KLS L-KLS1-2.50-04-H](https://www.danomsk.ru/shop/7-kommutatsiya/121-razemy/306-soediniteli-pryamougolnye/205451-chu-4-xh-04f-l-kls1-2-50-04-h-rozetka-kabelnaya-bez-kontaktov-kontakty-203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) отображает отсутствие товара. Исторический остаток 413 на 11.10 не является свежим наличием; число 413 в новой странице относится к рекомендованному товару и не использовано для вывода. Остальные 13 новых карточек ДАН прочитаны по основному товару; точные результаты и HTML находятся в `SOFTWARE_BOM_checks.json`/`SOFTWARE_BOM_DAN_*.html`. Верхние стойки 188548 теперь 166 шт.; остальные прочитанные остатки совпали с прежними. Карточка 199312 содержит несколько имён кнопки, поэтому комплектовать нужно именно TE 1825027-2, как уже требует текущий BOM.

**Минимальное предложение:** выбрать MPN LTO с соответствующими номиналами/допусками/ТКС/корпусами; закрепить диапазон HT-RA62, GPS-комплект и сокеты M1; найти тот же корпус J12 у другого поставщика либо квалифицировать согласованную замену. Наличие деталей проверять перед заказом, а не считать старые остатки ошибкой схемы.

**Проверка:** закупочный dry-run одного полного выбранного варианта, сопоставление маркировки упаковок, обжимных контактов и сопряжения с чертежами/образцом; последующие варианты квалифицировать отдельно.

### F06 — основной firmware release не определён достаточно для воспроизводимого включения, средняя / непроверенный вопрос

**Места:** `docs/V2_ASSEMBLY_INSTRUCTIONS_RU.md:178`, `design/MeshRepeater2_Logic/model.json:2462`, внешние `platformio.ini` и `variants/promicro/platformio.ini`.

**Факт:** аппаратный контракт закрепляет MeshCore SHA `a366955cb2f67b8e6842d4f00d2b6a554dddd88a` (30.09.2026), версия source `v1.17.1`. Для анализа выбран `ProMicro_repeater`, но проект A3 не хранит фактический собранный UF2/HEX MCU, его checksum, окончательные радио/ADC/админ-настройки и lock точных зависимостей. Внешний platform `nordicnrf52` и несколько библиотек имеют плавающие версии; framework закреплён d541301 и RadioLib закреплён SHA. Наличие согласованных назначений GPIO не подтверждает прошивку конкретного клона.

**Реальная сборка:** PlatformIO 6.2.0 установлен только в `SOFTWARE_BOM_BUILD_TMP/pydeps`; официальный неизменённый source SHA извлечён в этот разрешённый временный каталог, core/packages/cache также там. Первый этап SDK checkout остановился из-за Windows Filename-too-long; для Git только этого процесса включён core.longpaths через переменные окружения, без глобальной конфигурации. После этого platform 11.0.0, toolchain GCC 7.2.1 и SDK 1.10701.0+sha.d5413016 установились, реально началась компиляция. Build завершился exit 1 через 224,151 с на SDK TinyUSB: `fatal error: bits/c++config.h: No such file or directory`. Файл физически есть; отдельный preprocessing `#include <cstdlib>` с теми же cortex-m4/hard-float flags воспроизводит ошибку **без MeshCore**. GCC считает неканонический внутренний multilib-путь с `../` несуществующим, хотя canonical directory доступна. Это ограничение Windows/toolchain среды; ошибка исходников A3/MeshCore им не доказана. Полный firmware HEX/ELF не создан.

По дополнительному разрешению выполнен один ограниченный обход: canonical `CPLUS_INCLUDE_PATH` только в процессе. Независимый probe стал PASS exit0. Повтор полного environment после этого дошёл дальше и завершился exit1 через 12,993 с на новом блокере: ARM assembler `Fatal error: can't create .../arduino/ports/{ch32,esp32,rp2040,samd,nrf}/Adafruit_TinyUSB_*.cpp.o: No such file or directory`. Все пять родительских каталогов физически существуют; абсолютные пути файлов имеют 262–268 символов. Короткий SUBST/alias не создавался, глобальные настройки не изменялись. По условию остановки при новом блокере следующие попытки не выполнялись. Полный успешный build остаётся недоступен в данном временном Windows-пути, но проектный программный дефект этим не установлен.

Результат, 20 разрешённых версий библиотек, команда и полные журналы: `SOFTWARE_BOM_MAIN_BUILD_RESULT.json`, `SOFTWARE_BOM_BUILD_COMMAND.txt`, `SOFTWARE_BOM_BUILD_TMP/platformio_build.log`, `platformio_build_longpaths.log`, `platformio_build_canonical.log`; probes: `SOFTWARE_BOM_toolchain_header_probe.log` (FAIL), `SOFTWARE_BOM_toolchain_canonical_probe.log` (PASS). SDK board S140 6.1.1 и реальные flags записаны в log. Разрешённые версии библиотек, например RTClib 2.1.4 и SSD1306 2.5.17, отличаются от нижних границ `^`, что подтверждает необходимость lock. Минимальное продолжение в отдельной задаче — подготовленная среда с короткими путями для исходников, toolchain и build.

**Минимальное предложение:** зафиксировать выбранный environment, реальные версии toolchain/platform/libraries и файл прошивки с SHA256, записать радио-профиль, настройку ADC и способ первой настройки RTC; выполнить чистую сборку в подготовленной среде и тест на изделии.

**Проверка:** собрать именно указанный SHA/environment, сохранить build log и бинарный SHA; проверить загрузку, radio_init, RTC 0x68, INA219 0x40, GPS и питание/сброс на установленном модуле. Порт J5 в `ProMicro_repeater` не активируется как отдельный UART: Serial1 переназначается GPS. Для `ProMicro_repeater_bridge_rs232_serial1` GPS отключён; поэтому назначение J5 зависит от environment, одновременный GPS/J5 сервисный UART не доказан.

### F07 — ещё не квалифицированы реальные отказные сценарии watchdog, средняя / обоснованный риск, явно унаследован

**Факт:** собственная программа U6 отслеживает только TXEN, а не исполнение MCU; штатное молчание около трёх часов тоже приводит к сбросу. WDT в interrupt-only режиме не перезапускает зависший ATtiny. Это соответствует сохранённому заданию, не является доказательством ошибки A3 и уже открыто указано в ограничениях. Источник `main.c:90–106`; [Microchip ATtiny13A DS40002307A](https://ww1.microchip.com/downloads/aemDocuments/documents/MCU08/ProductDocuments/DataSheets/ATtiny13A-Data-Sheet-DS40002307A.pdf), §8.4/8.5; схема U6.2 ← R38 ← RADIO_TXEN, U6.5 → R37 → MCU_RESET. MODE и watchdog получают один сигнал TXEN через разные резисторы; независимого GPIO не появилось.

**Минимальное предложение:** сначала квалифицировать выбранный режим молчания и реальные импульсы; изменение алгоритма делать только отдельным согласованным изменением, если требования не выполняются.

**Проверка:** временная метка реального начала/конца RADIO_TXEN на M2.5/7 и WDT_INPUT U6.2; при штатных TX каждый импульс должен сбрасывать ожидание. При полном отсутствии TXEN измерить timeout и LOW длительность MCU_RESET, после него подтвердить старт MCU/радио. Провести питание, BOD-провал и намеренный отказ MCU; отдельный отказ U6 не объявлять покрытым. Без измеренной частоты WDT нельзя установить точное трёхчасовое время: 1350×8 с=10800 с только номинально.

## Выполненные положительные проверки

| Область | Метод и результат | Ограничение |
|---|---|---|
| BOM A3 | 179 уникальных позиций = 179 в моделях; Value/MPN/Footprint/Fit всех трёх вариантов без расхождений; свежий XML Value/Footprint также без расхождений | Совпадение выбранных записей не заменяет паспорт каждого из 179 компонентов |
| Варианты | Na-ion COLD: 162 fit / 145 закупаемых; NoCOLD: 138 / 121; LTO: 151 / 134 | Тестовые площадки/неттай/монтажные площадки не закупаются, количества не являются сборочной квалификацией |
| GPIO радио | NSS P1.13, SCK P1.11, MOSI P1.15, MISO P0.02, DIO1 P0.10, reset P0.09, BUSY P0.29, RXEN P0.17 соответствуют native XML и закреплённому variant map | Физическая распиновка именно поставленного клона/диапазон модема требуют входного контроля |
| I²C | SDA=Arduino8=P1.04, SCL=7=P0.11, RTC 0x68, INA219 0x40; RTC раздельные VCC/VBAT, alarm/RST/32kHz не используются | Скорость/ёмкость межплатной шины и реальные ACK ещё не измерены |
| GPS UART | `PIN_GPS_RX=3`, `PIN_GPS_TX=4`, но фактический `Serial1.setPins(PIN_GPS_TX,PIN_GPS_RX)` и ядро `setPins(rx,tx)` дают RX=P0.22/TX=P0.20 — правильно для CAD | Имена macros не интерпретировать без реального вызова; GPS питание/кабель — F01 |
| GPS buffer | DCT pinout U7 согласуется с native XML; локальная посадка: pads1,1×0,4 мм, span3,8 мм, pitch0,65 мм совпадает с TI p.22 land pattern | U7 Ioff относится к буферу; питание и собственная UART защита аксессуара должны быть проверены |
| Watchdog | Реальная AVR GCC 7.3.0 сборка, 406/1024 байт Flash, 4/64 байт RAM; HEX совпадает SHA256 `8d38a4213ea91b9ad8d99638ac21ccfd80c2d75d24d1545856dba421195e5790` | Запись U6 и стендовые интервалы не выполнялись |
| Дизассемблер U6 | WDTCR out0x21 на 0x3a, затем ori и out0x21 на0x3e: запись укладывается в 4 CPU cycles; reset только PORTB0=0 и DDRB0 output/input; периоды 0x21 и0x06 | Проверка полученной программы, не испытание brownout/прерываний на образце |
| ISP | J10:1 MISO,2 3V3,3 SCK,4 MOSI,5 RESET,6 GND; U6 PB0 общий MOSI/reset, R37 снятие явно документировано. Fuses LF7B/HFFB задают reset/ISP сохранены, 128kHz, BOD2,7V. -B100 даёт SCK≈10kHz <128kHz/4=32kHz | Реальные программатор/уровни3,3V и readback отсутствуют; не писать5V |
| RTC | [DS3231M](https://www.analog.com/media/en/technical-documentation/data-sheets/DS3231M.pdf) p.7: SO8 1=32k,2VCC,3INT,4RST,5GND,6VBAT,7SDA,8SCL; совпадает. RTClib DS3231 read/adjust использует общие календарные регистры | Начальная установка времени/OSF и резервное сохранение подлежат стендовой проверке |
| INA219 | source init вызывает Adafruit_INA219.begin, адрес0x40; штатная библиотечная калибровка32V2A ожидает0,1Ω, согласовано сR71. Заряд+,разряд− по IN+/IN−. LTO балансирные токи вне шунта явно документированы | Точность, signed current/unsigned power, потреблениеcontinuous и полный баланс ячеек не доказаны измерением |
| Дан новые части | 14 реальных главных карточек считаны13.10; совпадают артикулы/исполнения, исключениепоstock205451 | HTML/название магазина не паспорт и не квалификация полученной партии |
| Экспорты | POWER14,LOGIC17,SHIELD13 artifacts SHA совпадают, native PCB hashes совпадают с соответствующими manifests | Это binding сохранённых выгрузок; новый экспорт геометрии выполняет root, данные не дают утвержденияEMI |

Точные исходные данные/результаты: `SOFTWARE_BOM_checks.py`, `SOFTWARE_BOM_checks.json`, сохранённые pinned sources, firmware ZIP, disassembly/map/ELF/HEX и карточки ДАН. Проверка HEX выполняет сравнение байтов, а не заявления README.

## Точный объект внешней прошивки

Репозиторий [MeshCore](https://github.com/meshcore-dev/MeshCore/tree/a366955cb2f67b8e6842d4f00d2b6a554dddd88a), environment `ProMicro_repeater`, source version v1.17.1. [ProMicro config](https://raw.githubusercontent.com/meshcore-dev/MeshCore/a366955cb2f67b8e6842d4f00d2b6a554dddd88a/variants/promicro/platformio.ini) содержит GPS, INA219, SX1262. Карта физических nRF GPIO — `variants/promicro/variant.cpp`; init — `PromicroBoard.cpp`, `CustomSX1262.h`, `EnvironmentSensorManager.cpp`, `AutoDiscoverRTCClock.cpp`. Ядро d541301 [Uart.h](https://raw.githubusercontent.com/meshcore-dev/Adafruit_nRF52_Arduino/d541301/cores/nRF5/Uart.h):37 подтверждает порядок аргументов RX/TX. Эти файлы скачаны и hashed; полный build реально попытан, но остановился на отказе Windows/toolchain при компиляции SDK без получения firmware. Результат относится к официальному экспериментальному environment, не к выбранному пользователем бинарнику.

Команды watchdog выполнены на `SOFTWARE_BOM_watchdog_main.c`, копии оригинала: `avr-gcc -std=gnu11 -mmcu=attiny13a -DF_CPU=128000UL -Os -Wall -Wextra -ffunction-sections -fdata-sections -c`; link `-mmcu=attiny13a -Wl,--gc-sections -Wl,-Map=...`; `avr-objcopy -O ihex -R .eeprom`; `avr-size -C --mcu=attiny13a`; `avr-objdump -d -S`. Исполняемые файлы из `C:/Users/Alksndr/AppData/Local/Arduino15/packages/arduino/tools/avr-gcc/7.3.0-atmel3.6.1-arduino7/bin`. Оригинальный HEX не перезаписывался.

## Производственный статус и исторические материалы

В рабочей v2 до добавления приложений аудита не найдено Gerber/.drl/.gbrjob/.pos/.zip вне `archive`/`baseline`; это согласуется с явным отложенным владельцем производственным пакетом. Отсутствие release-пакета — незавершённый этап, не техническая ошибка схемы. Заказ по A2 release недопустим для A3.

A3 схемные PDF имеют RevV2.0-A3, соответствующий J11POWER и текущую карту SYS1/3,RADIO5/7,GND2/4/6,NC8. Их binding нужно брать из A3 audit manifests/свежего экспорта root. `output/pdf/SCHEMATIC_MANIFEST.json` относится кA2. Сборочные `MeshRepeater2_assembly_manual_RU.pdf` (9 страниц) и `assembly_dimensions.pdf` (4 страницы) содержат старыеIDC/кабельные сведения. README явно обозначает их историческими; само хранение не является дефектом. В существующем `tools/cad/render_v2_manual.py:53` footer всё ещё hardcoded V2.0-A2, а относительные hyperlinks:26 ведут к прежнему repo/branch. При будущем выпуске этот генератор требует обновления, иначе новый текст A3 получит неверное обозначение/ссылки. Старый генератор в аудите не запускался.

Из проверенного участка: **изготовление плат** требует отдельного нового производственного пакета и ограничений выбранного производства; **сборка** Na-ion условно возможна после закрытия комплектности/сокетов/ответных частей, LTO дополнительно требует выбранныхMPN и корпусаJ12; **первое включение безGPS** нельзя объявить полностью квалифицированным без полного firmware build и измерений питания root; **подключениеGPS** отложить до разрешенияF01. Эти выводы не заменяют аппаратные/механические замечания других участков аудита.

## Приоритет проверки образца

Сначала подтвердить точные компоненты и проводники GPS/cable, полярности/USB J11 и ограничения питания из общего отчёта. Затем загрузить MCU бинарник с сохранённым SHA и проверить I²C0x68/0x40; измерить ток при UART GPS on/off и реальные напряжения на J4.6/7 и U7.8. После этого сверить BAT_ADC с DMM, INA219 с контрольным током (заряд/разряд), длительное молчание/TXEN/U6RESET и повторный запуск модема. Испытания при реальнойTX нагрузке, одновременномGPS иUSB, а также LC/EMI/температурные режимы остаются обязательными по общему отчёту, но не выдаются здесь за выполненные.
