Alksndr55/mesh-repeater-2.0/audit/V2_ENGINEERING_AUDIT_A3_2026_10_13/SOFTWARE_BOM_TI_SN74LVC2G125.txt

PAGE 1
1A 1Y
1
2A
2
2Y
OE
OE
Copyright © 2017, Texas Instruments Incorporated
Product
Folder
Order
Now
T echnical
Documents
Tools &
Software
Support &
Community
An IMPORTANT NOTICE at the end of this data sheet addresses availability, warranty, changes, use in safety-critical applications,
intellectual property matters and other important disclaimers. PRODUCTION DATA.
SN74LVC2G125
SCES204Q – APRIL 1999 – REVISED MARCH 2017
SN74LVC2G125DualBusBufferGateWith3-StateOutputs
1
1 Features
1• ESD Protection Exceeds JESD 22
– 2000-V Human-Body Model
– 1000-V Charged-Device Model
• Available in the Texas Instruments
NanoFree™ Package
• Supports 5-V VCC Operation
• Inputs Accept Voltages to 5.5 V
• Max tpd of 4.3 ns at 3.3 V
• Low Power Consumption, 10-µA Max ICC
• ±24-mA Output Drive at 3.3 V
• Typical VOLP (Output Ground Bounce)
< 0.8 V at VCC = 3.3 V, TA = 25°C
• Typical VOHV (Output VOH Undershoot)
> 2 V at VCC = 3.3 V, TA = 25°C
• Ioff Supports Live Insertion, Partial-Power-Down
Mode, and Back-Drive Protection
• Can Be Used as a Down Translator to Translate
Inputs From a Max of 5.5 V Down
to the VCC Level
• Latch-Up Performance Exceeds 100 mA Per
JESD 78, Class II
2 Applications
• Cable Modem Termination Systems
• High-Speed Data Acquisition and Generation
• Military: Radars and Sonars
• Motor Controls: High-Voltage
• Power Line Communication Modems
• SSDs: Internal or External
• Video Broadcasting and Infrastructure: Scalable
Platforms
• Video Broadcasting: IP-Based Multi-Format
Transcoders
• Video Communications Systems
3 Description
The SN74LVC2G125 device is a dual bus buffer
gate, designed for 1.65-V to 5.5-V VCC operation.
This device features dual line drivers with 3-state
outputs. The outputs are disabled when the
associated output-enable (OE) input is high.
NanoFree™ package technology is a major
breakthrough in IC packaging concepts, using the die
as the package.
To ensure the high-impedance state during power up
or power down, OE should be tied to VCC through a
pullup resistor; the minimum value of the resistor is
determined by the current-sinking capability of the
driver.
This device is fully specified for partial-power-down
applications using Ioff. The Ioff circuitry disables the
outputs, preventing damaging current backflow
through the device when it is powered down.
Device Information(1)
PART NUMBER PACKAGE BODY SIZE
SN74LVC2G125DCTR SM8 (8) 2.95 mm × 2.80 mm
SN74LVC2G125DCUR VSSOP (8) 2.30 mm × 2.00 mm
SN74LVC2G125YZPR DSBGA (8) 1.91 mm × 0.91 mm
(1) For all available packages, see the orderable addendum at
the end of the data sheet.
Simplified Schematic
PAGE 2
2
SN74LVC2G125
SCES204Q – APRIL 1999 – REVISED MARCH 2017 www.ti.com
Product Folder Links: SN74LVC2G125
Submit Documentation Feedback Copyright © 1999–2017, Texas Instruments Incorporated
Table of Contents
1 Features .................................................................. 1
2 Applications ........................................................... 1
3 Description ............................................................. 1
4 Revision History..................................................... 2
5 Pin Configuration and Functions ......................... 4
6 Specifications......................................................... 5
6.1 Absolute Maximum Ratings ..................................... 5
6.2 ESD Ratings.............................................................. 5
6.3 Recommended Operating Conditions ...................... 6
6.4 Thermal Information .................................................. 6
6.5 Electrical Characteristics........................................... 7
6.6 Switching Characteristics: TA = –40°C to +85°C ...... 7
6.7 Switching Characteristics: TA = –40°C to +125°C .... 7
6.8 Operating Characteristics.......................................... 8
6.9 Typical Characteristics .............................................. 8
7 Parameter Measurement Information .................. 9
8 Detailed Description ............................................ 10
8.1 Overview ................................................................. 10
8.2 Functional Block Diagram ....................................... 10
8.3 Feature Description................................................. 10
8.4 Device Functional Modes........................................ 11
9 Application and Implementation ........................ 12
9.1 Application Information............................................ 12
9.2 Typical Application ................................................. 12
10 Power Supply Recommendations ..................... 13
11 Layout................................................................... 13
11.1 Layout Guidelines ................................................. 13
11.2 Layout Example .................................................... 14
12 Device and Documentation Support ................. 15
12.1 Documentation Support ........................................ 15
12.2 Receiving Notification of Documentation Updates 15
12.3 Community Resources.......................................... 15
12.4 Trademarks ........................................................... 15
12.5 Electrostatic Discharge Caution ............................ 15
12.6 Glossary ................................................................ 15
13 Mechanical, Packaging, and Orderable
Information ........................................................... 15
4 Revision History
NOTE: Page numbers for previous revisions may differ from page numbers in the current version.
Changes from Revision P (January 2016) to Revision Q Page
• Removed '200-V Machine Model' from Features for consistency with ESD ratings table. ................................................... 1
• Added orderable part numbers associated with each package. Changed US8 to VSSOP. .................................................. 1
• Updated YZP package drawing to match mechanical drawing pinout. ................................................................................. 4
• Added YZP pin identifiers to Pin Function table. Added 'buffer #' to Description for pins 2, 3, 5, and 6. Changed
'Power pin' to 'Positive supply'................................................................................................................................................ 4
• Added updated package thermal values based on new models. Changes: RθJA DCT 220 -> 199.0, DCU 227 ->
217.8, YZP 102 -> 99.8. Added: RθJCtop, RθJB, ψJT, ψJB........................................................................................................... 6
• Added 'Balanced Push-Pull Outputs,' 'CMOS Inputs,' 'Clamp Diodes,' 'Partial Power Down, 'Over-voltage Tolerant
Inputs.' Removed bullet list................................................................................................................................................... 10
• Added improved layout guidelines and trace example image. ............................................................................................ 13
• Added Documentation Support section, Receiving Notification of Documentation Updates section, and Community
Resources section ................................................................................................................................................................ 15
Changes from Revision O (January 2015) to Revision P Page
• Added overbar for active low to 1OE and 2OE to the Simplified Schematic.......................................................................... 1
• Added TJ Junction temperature to the Absolute Maximum Ratings ...................................................................................... 5
• Added overbar for active low to 1OE and 2OE to the Functional Block Diagram................................................................ 10
Changes from Revision N (November 2013) to Revision O Page
• Added Applications, Device Information table, Pin Functions table, ESD Ratings table, Thermal Information table,
Typical Characteristics, Feature Description section, Device Functional Modes, Application and Implementation
section, Power Supply Recommendations section, Layout section, Device and Documentation Support section, and
Mechanical, Packaging, and Orderable Information section. ................................................................................................. 1
PAGE 3
3
SN74LVC2G125
www.ti.com SCES204Q – APRIL 1999 – REVISED MARCH 2017
Product Folder Links: SN74LVC2G125
Submit Documentation FeedbackCopyright © 1999–2017, Texas Instruments Incorporated
Changes from Revision M (January 2007) to Revision N Page
• Updated Features. .................................................................................................................................................................. 1
• Updated document to new TI data sheet format. ................................................................................................................... 1
• Removed Ordering Information table. .................................................................................................................................... 1
• Changed MAX operating temperature to 125°C in Recommended Operating Conditions table. ......................................... 6
PAGE 4
1  2  
D  
C  
B  
A  
Not to scale
GND 2A
2Y 1Y
1A 2OE
1OE VCC 
See mechanical drawings for dimensions.
DCT PACKAGE
(TOP VIEW)
DCU PACKAGE
(TOP VIEW)
1 VCC81OE
2 71A 2OE
3 62Y 1Y
4 5GND 2A
3 6 1Y2Y
81 VCC1OE
5GND 4 2A
2 7 2OE1A
4
SN74LVC2G125
SCES204Q – APRIL 1999 – REVISED MARCH 2017 www.ti.com
Product Folder Links: SN74LVC2G125
Submit Documentation Feedback Copyright © 1999–2017, Texas Instruments Incorporated
5 Pin Configuration and Functions
YZP Package
8-Pin DSBGA
Bottom View
See mechanical drawings for dimensions.
Pin Functions
PIN
TYPE DESCRIPTION
NAME DCT, DCU YZP
1A 2 B1 I Input of buffer 1
2A 5 D2 I Input of buffer 2
1OE 1 A1 I Output Enable for buffer 1
2OE 7 B2 I Output Enable for buffer 2
1Y 6 C2 O Output of buffer 1
2Y 3 C1 O Output of buffer 2
GND 4 D1 — Ground
VCC 8 A2 — Positive supply
PAGE 5
5
SN74LVC2G125
www.ti.com SCES204Q – APRIL 1999 – REVISED MARCH 2017
Product Folder Links: SN74LVC2G125
Submit Documentation FeedbackCopyright © 1999–2017, Texas Instruments Incorporated
(1) Stresses beyond those listed under Absolute Maximum Ratings may cause permanent damage to the device. These are stress ratings
only, and functional operation of the device at these or any other conditions beyond those indicated under Recommended Operating
Conditions is not implied. Exposure to absolute-maximum-rated conditions for extended periods may affect device reliability.
(2) The input negative-voltage and output voltage ratings may be exceeded if the input and output clamp-current ratings are observed.
(3) The value of VCC is provided in the Recommended Operating Conditions table.
6 Specifications
6.1 Absolute Maximum Ratings
See (1)
MIN MAX UNIT
VCC Supply voltage –0.5 6.5 V
VI Input voltage (2) –0.5 6.5 V
VO Voltage range applied to any output in the high-impedance or power-off state (2) –0.5 6.5 V
VO Voltage range applied to any output in the high or low state (2) (3) –0.5 VCC + 0.5 V
IIK Input clamp current VI < 0 –50 mA
IOK Output clamp current VO < 0 –50 mA
IO Continuous output current ±50 mA
Continuous current through VCC or GND ±100 mA
TJ Junction temperature 150 °C
Tstg Storage temperature –65 150 °C
(1) JEDEC document JEP155 states that 500-V HBM allows safe manufacturing with a standard ESD control process.
(2) JEDEC document JEP157 states that 250-V CDM allows safe manufacturing with a standard ESD control process.
6.2 ESD Ratings
VALUE UNIT
V(ESD)
Electrostatic
discharge
Human body model (HBM), per ANSI/ESDA/JEDEC JS-001 (1) 2000
V
Charged device model (CDM), per JEDEC specification JESD22-C101 (2) 1000
PAGE 6
6
SN74LVC2G125
SCES204Q – APRIL 1999 – REVISED MARCH 2017 www.ti.com
Product Folder Links: SN74LVC2G125
Submit Documentation Feedback Copyright © 1999–2017, Texas Instruments Incorporated
(1) All unused inputs of the device must be held at VCC or GND to ensure proper device operation. See Implications of Slow or Floating
CMOS Inputs, SCBA004.
6.3 Recommended Operating Conditions
over recommended operating free-air temperature range (unless otherwise noted) (1)
MIN MAX UNIT
VCC Supply voltage
Operating 1.65 5.5
V
Data retention only 1.5
VIH High-level input voltage
VCC = 1.65 V to 1.95 V 0.65 × VCC
V
VCC = 2.3 V to 2.7 V 1.7
VCC = 3 V to 3.6 V 2
VCC = 4.5 V to 5.5 V 0.7 × VCC
VIL Low-level input voltage
VCC = 1.65 V to 1.95 V 0.35 × VCC
V
VCC = 2.3 V to 2.7 V 0.7
VCC = 3 V to 3.6 V 0.8
VCC = 4.5 V to 5.5 V 0.3 × VCC
VI Input voltage 0 5.5 V
VO Output voltage
High or low state 0 VCC
V
3-state 0 5.5
IOH High-level output current
VCC = 1.65 V –4
mA
VCC = 2.3 V –8
VCC = 3 V
–16
–24
VCC = 4.5 V –32
IOL Low-level output current
VCC = 1.65 V 4
mA
VCC = 2.3 V 8
VCC = 3 V
16
24
VCC = 4.5 V 32
Δt/Δv Input transition rise or fall rate
VCC = 1.8 V ± 0.15 V, 2.5 V ± 0.2 V 20
ns/VVCC = 3.3 V ± 0.3 V 10
VCC = 5 V ± 0.5 V 5
TA Operating free-air temperature –40 125 °C
(1) For more information about traditional and new thermal metrics, see the Semiconductor and IC Package Thermal Metrics application
report.
6.4 Thermal Information
THERMAL METRIC (1)
SN74LVC2G125
UNITDCT (SM8) DCU (VSSOP) YZP (DSBGA)
8 PINS 8 PINS 8 PINS
RθJA Junction-to-ambient thermal resistance 199.0 217.8 99.8 °C/W
RθJCtop Junction-to-case (top) thermal resistance 89.5 98.3 1.0 °C/W
RθJB Junction-to-board thermal resistance 118.7 138.7 29.6 °C/W
ψJT Junction-to-top characterization parameter 14.3 34.6 0.5 °C/W
ψJB Junction-to-board characterization parameter 117.4 138.2 29.8 °C/W
PAGE 7
7
SN74LVC2G125
www.ti.com SCES204Q – APRIL 1999 – REVISED MARCH 2017
Product Folder Links: SN74LVC2G125
Submit Documentation FeedbackCopyright © 1999–2017, Texas Instruments Incorporated
(1) All typical values are at VCC = 3.3 V, TA = 25°C.
6.5 Electrical Characteristics
over recommended operating free-air temperature range (unless otherwise noted)
PARAMETER TEST CONDITIONS VCC
TA = –40°C to +85°C TA = –40°C to +125°C
UNIT
MIN TYP (1) MAX MIN TYP (1) MAX
VOH
IOH = –100 µA 1.65 V to 5.5 V VCC – 0.1 VCC – 0.1
V
IOH = –4 mA 1.65 V 1.2 1.2
IOH = –8 mA
1.8 V 1.4
2.3 V 1.9 1.9
IOH = –16 mA
3 V
2.4 2.4
IOH = –24 mA 2.3 2.3
IOH = –32 mA 4.5 V 3.8 3.8
VOL
IOL = 100 µA 1.65 V to 5.5 V 0.1 0.1
V
IOL = 4 mA 1.65 V 0.45 0.45
IOL = 8 mA
1.8 V 0.45
2.3 V 0.3 0.3
IOL = 16 mA
3 V
0.4 0.4
IOL = 24 mA 0.55 0.55
IOL = 32 mA 4.5 V 0.55 0.75
II
A or OE
inputs VI = 5.5 V or GND 0 to 5.5 V ±5 ±5 µA
Ioff VI or VO = 5.5 V 0 ±10 ±10 µA
IOZ VO = 0 to 5.5 V 3.6 V 10 10 µA
ICC VI = 5.5 V or GND, IO = 0 1.65 V to 5.5 V 10 10 µA
ΔICC
One input at VCC – 0.6 V,
Other inputs at VCC or GND 3 V to 5.5 V 500 500 µA
Ci
Data inputs
VI = VCC or GND 3.3 V
3.5 3.5
pF
Control inputs 4 4
Co VO = VCC or GND 3.3 V 6.5 6.5 pF
6.6 Switching Characteristics: TA = –40°C to +85°C
over recommended operating free-air temperature range (unless otherwise noted) (see Figure 3)
PARAMETER FROM
(INPUT)
TO
(OUTPUT)
TA = –40°C to +85°C
UNITVCC = 1.8 V
± 0.15 V
VCC = 2.5 V
± 0.2 V
VCC = 3.3 V
± 0.3 V
VCC = 5 V
± 0.5 V
MIN MAX MIN MAX MIN MAX MIN MAX
tpd A Y 3.3 9.1 1.5 4.8 1.4 4.3 1 3.7 ns
ten OE Y 4 9.9 1.9 5.6 1.2 4.7 1.2 3.8 ns
tdis OE Y 1.5 11.6 1 5.8 1.4 4.6 1 3.4 ns
6.7 Switching Characteristics: TA = –40°C to +125°C
over recommended operating free-air temperature range (unless otherwise noted) (see Figure 3)
PARAMETER FROM
(INPUT)
TO
(OUTPUT)
TA = –40°C to +125°C
UNITVCC = 1.8 V
± 0.15 V
VCC = 2.5 V
± 0.2 V
VCC = 3.3 V
± 0.3 V
VCC = 5 V
± 0.5 V
MIN MAX MIN MAX MIN MAX MIN MAX
tpd A Y 3.3 10.1 1.5 5.8 1.4 5.3 1 4.2 ns
ten OE Y 4 10.9 1.9 6.6 1.2 5.7 1.2 4.3 ns
tdis OE Y 1.5 12.6 1 6.8 1.4 5.6 1 3.9 ns
PAGE 8
Temperature - ° C
TPD - ns
-100 -50 0 50 100 150
0
0.5
1
1.5
2
2.5
D001
TPD
Vcc - V
TPD - ns
0 1 2 3 4 5 6
0
1
2
3
4
5
D002
TPD
8
SN74LVC2G125
SCES204Q – APRIL 1999 – REVISED MARCH 2017 www.ti.com
Product Folder Links: SN74LVC2G125
Submit Documentation Feedback Copyright © 1999–2017, Texas Instruments Incorporated
6.8 Operating Characteristics
TA = 25°
PARAMETER TEST
CONDITIONS
VCC = 1.8 V VCC = 2.5 V VCC = 3.3 V VCC = 5 V
UNIT
TYP TYP TYP TYP
Cpd
Power dissipation
capacitance
Outputs enabled
f = 10 MHz
19 19 20 22
pF
Outputs disabled 2 2 2 3
6.9 Typical Characteristics
Figure 1. TPD Across Temperature at 3.3 V VCC Figure 2. TPD Across VCC at 25°C
PAGE 9
thtsu
From□Output
Under□Test
C
(see□Note A)
L
LOAD□CIRCUIT
S1
VLOAD
Open
GND
RL
Data□Input
Timing□Input
0□V
0□V
0□V
tW
Input
0□V
Input
Output
Waveform□1
S1□at□V
(see□Note□B)
LOAD
Output
Waveform□2
S1□at□GND
(see□Note□B)
VOL
VOH
0□V
/c1870□V
Output
Output
TEST S1
t /tPLH PHL Open
Output
Control
VM
VM VM
VM
VM
1.8□V 0.15□V/c177
2.5□V 0.2□V/c177
3.3□V 0.3□V/c177
5□V 0.5□V/c177
1□k/c87
500 /c87
500 /c87
500 /c87
VCC RL
2□× V CC
2□× V CC
6□V
2□× V CC
VLOAD CL
30□pF
30□pF
50□pF
50□pF
0.15□V
0.15□V
0.3□V
0.3□V
V/c68
3□V
VI
VCC/2
VCC/2
1.5□V
VCC/2
VM
/c1632□ns
/c1632□ns
/c1632.5□ns
/c1632.5□ns
INPUTS
RL
t /tr f
VCC
VCC
VCC
VLOADt /tPLZ PZL
GNDt /tPHZ PZH
VOLTAGE□WAVEFORMS
ENABLE AND□DISABLE□TIMES
LOW- AND□HIGH-LEVEL ENABLING
VOLTAGE□WAVEFORMS
PROPAGATION□DELAY TIMES
INVERTING AND□NONINVERTING□OUTPUTS
NOTES: A. C includes□probe□and□jig□capacitance.
B. Waveform□1□is□for□an□output□with□internal□conditions□such□that□the□output□is□low,□except□when□disabled□by□the□output□control.
Waveform□2□is□for□an□output□with□internal□conditions□such□that□the□output□is□high,□except□when□disabled□by□the□output□control.
C. All□input□pulses□are□supplied□by□generators□having□the□following□characteristics:□PRR 10□MHz,□Z =□50 .
D. The□outputs□are□measured□one□at□a□time,□with□one□transition□per□measurement.
E. t and□t are□the□same□as□t .
F . t and□t are□the□same□as□t .
G. t and□t are□the□same□as□t .
H. All□parameters□and□waveforms□are□not□applicable□to□all□devices.
L
O
PLZ PHZ dis
PZL PZH en
PLH PHL pd
/c163 /c87
VOLTAGE□WAVEFORMS
PULSE□DURATION
VOLTAGE□WAVEFORMS
SETUP AND□HOLD□TIMES
VI
VI
VI
VM
VM
V /2LOAD
tPZL tPLZ
tPHZtPZH
V – VOH /c68
V +□VOL /c68
VM
VM VM
VM
VOL
VOH
VI
VI
VOH
VOL
VM
VM
VM
VM
tPLH tPHL
tPLHtPHL
9
SN74LVC2G125
www.ti.com SCES204Q – APRIL 1999 – REVISED MARCH 2017
Product Folder Links: SN74LVC2G125
Submit Documentation FeedbackCopyright © 1999–2017, Texas Instruments Incorporated
7 Parameter Measurement Information
Figure 3. Load Circuit and Voltage Waveforms
PAGE 10
1A 1Y
1
2A
2
2Y
OE
OE
Copyright © 2017, Texas Instruments Incorporated
10
SN74LVC2G125
SCES204Q – APRIL 1999 – REVISED MARCH 2017 www.ti.com
Product Folder Links: SN74LVC2G125
Submit Documentation Feedback Copyright © 1999–2017, Texas Instruments Incorporated
8 Detailed Description
8.1 Overview
The SN74LVC2G125 device contains dual buffer gate device with output enable control and performs the
Boolean function Y = A. This device is fully specified for partial-power-down applications using Ioff. The Ioff
circuitry disables the outputs, preventing damaging current backflow through the device when it is powered
down. To ensure the high-impedance state during power up or power down, OE should be tied to VCC through a
pull-up resistor; the minimum value of the resistor is determined by the current-sinking capability of the driver.
8.2 Functional Block Diagram
8.3 Feature Description
8.3.1 Balanced High-Drive CMOS Push-Pull Outputs
A balanced output allows the device to sink and source similar currents. The high drive capability of this device
creates fast edges into light loads so routing and load conditions should be considered to prevent ringing.
Additionally, the outputs of this device are capable of driving larger currents than the device can sustain without
being damaged. It is important for the power output of the device to be limited to avoid thermal runaway and
damage due to over-current. The electrical and thermal limits defined the in the Absolute Maximum Ratings must
be followed at all times.
8.3.2 Standard CMOS Inputs
Standard CMOS inputs are high impedance and are typically modelled as a resistor in parallel with the input
capacitance given in the Electrical Characteristics. The worst case resistance is calculated with the maximum
input voltage, given in the Absolute Maximum Ratings , and the maximum input leakage current, given in the
Electrical Characteristics, using ohm's law (R = V ÷ I).
Signals applied to the inputs need to have fast edge rates, as defined by Δt/Δv in Recommended Operating
Conditions to avoid excessive currents and oscillations. If a slow or noisy input signal is required, a device with a
Schmitt-trigger input should be utilized to condition the input signal prior to the standard CMOS input.
8.3.3 Clamp Diodes
The inputs and outputs to this device have negative clamping diodes.
CAUTION
Voltages beyond the values specified in the Absolute Maximum Ratings table can
cause damage to the device. The input negative-voltage and output voltage ratings
may be exceeded if the input and output clamp-current ratings are observed.
PAGE 11
GND 
LogicInput Output
VCCDevice
-IIK -IOK
11
SN74LVC2G125
www.ti.com SCES204Q – APRIL 1999 – REVISED MARCH 2017
Product Folder Links: SN74LVC2G125
Submit Documentation FeedbackCopyright © 1999–2017, Texas Instruments Incorporated
Feature Description (continued)
Figure 4. Electrical Placement of Clamping Diodes for Each Input and Output
8.3.4 Partial Power Down (Ioff)
The inputs and outputs for this device enter a high impedance state when the supply voltage is 0 V. The
maximum leakage into or out of any input or output pin on the device is specified by Ioff in the Electrical
Characteristics.
8.3.5 Over-voltage Tolerant Inputs
Input signals to this device can be driven above the supply voltage so long as they remain below the maximum
input voltage value specified in the Absolute Maximum Ratings .
8.4 Device Functional Modes
Table 1 lists the functional modes of the SN74LVC2G125.
Table 1. Function Table
INPUTS OUTPUT
YOE A
L H H
L L L
H X Z
PAGE 12
1OE
1A
2Y
GND
VCC
2OE
1Y
2A
SN74LVC2G125
Input signal 1
from system
Output 2 to long
PCB trace or
high-Z logic input
Output 1 to long
PCB trace or
high-Z logic inputInput signal 2
from system
0.1 Fμ
1.65 V to 5 V
Copyright © 2017, Texas Instruments Incorporated
12
SN74LVC2G125
SCES204Q – APRIL 1999 – REVISED MARCH 2017 www.ti.com
Product Folder Links: SN74LVC2G125
Submit Documentation Feedback Copyright © 1999–2017, Texas Instruments Incorporated
9 Application and Implementation
NOTE
Information in the following applications sections is not part of the TI component
specification, and TI does not warrant its accuracy or completeness. TI’s customers are
responsible for determining suitability of components for their purposes. Customers should
validate and test their design implementation to confirm system functionality.
9.1 Application Information
The SN74LVC2G125 device is a high drive CMOS device that can be used as a output enabled buffer with a
high output drive, such as an LED application. It can produce 24 mA of drive current at 3.3 V making it Ideal for
driving multiple outputs and good for high speed applications up to 100 MHz. The inputs are 5.5-V tolerant
allowing it to translate down to VCC.
9.2 Typical Application
Figure 5. Typical Application Schematic
9.2.1 Design Requirements
This device uses CMOS technology and has balanced output drive. Take care to avoid bus contention because it
can drive currents that would exceed maximum limits. The high drive also creates fast edges into light loads so
routing and load conditions should be considered to prevent ringing.
9.2.2 Detailed Design Procedure
1. Recommended Input Conditions:
– For rise time and fall time specifications, see (Δt/ΔV) in the Recommended Operating Conditions table.
– For specified high and low levels, see (VIH and VIL) in the Recommended Operating Conditions table.
– Inputs are overvoltage tolerant allowing them to go as high as (VI max) in the Recommended Operating
Conditions table at any valid VCC.
2. Recommended Output Conditions:
– Load currents should not exceed (IO max) per output and should not exceed (Continuous current through
VCC or GND) total current for the part. These limits are located in the Absolute Maximum Ratings table.
– Outputs should not be pulled above VCC.
PAGE 13
Frequency (MHz)
I (mA)CC
0 20 40 60 80
0
1
2
3
4
5
6
7
8
9
10
D003
V 1.8 VCC
VCC 2.5 V
VCC 3.3 V
VCC 5 V
13
SN74LVC2G125
www.ti.com SCES204Q – APRIL 1999 – REVISED MARCH 2017
Product Folder Links: SN74LVC2G125
Submit Documentation FeedbackCopyright © 1999–2017, Texas Instruments Incorporated
Typical Application (continued)
9.2.3 Application Curve
Figure 6. ICC vs Frequency
10 Power Supply Recommendations
The power supply can be any voltage between the min and max supply voltage rating located in the
Recommended Operating Conditions table.
Each VCC pin should have a good bypass capacitor to prevent power disturbance. For devices with a single
supply a 0.1-μF capacitor is recommended and if there are multiple VCC pins then a 0.01-μF or 0.022-μF
capacitor is recommended for each power pin. It is ok to parallel multiple bypass caps to reject different
frequencies of noise. 0.1-μF and 1-μF capacitors are commonly used in parallel. The bypass capacitor should be
installed as close to the power pin as possible for best results.
11 Layout
11.1 Layout Guidelines
When using multiple bit logic devices, inputs should not float. In many cases, functions or parts of functions of
digital logic devices are unused. Some examples are when only two inputs of a triple-input AND gate are used,
or when only 3 of the 4-buffer gates are used. Such input pins should not be left unconnected because the
undefined voltages at the outside connections result in undefined operational states.
Specified in Figure 7 are rules that must be observed under all circumstances. All unused inputs of digital logic
devices must be connected to a high or low bias to prevent them from floating. The logic level that should be
applied to any particular unused input depends on the function of the device. Generally they will be tied to GND
or VCC, whichever makes more sense or is more convenient.
Even low data rate digital signals can have high frequency signal components due to fast edge rates. When a
PCB trace turns a corner at a 90° angle, a reflection can occur. A reflection occurs primarily because of the
change of width of the trace. At the apex of the turn, the trace width increases to 1.414 times the width. This
increase upsets the transmission-line characteristics, especially the distributed capacitance and self–inductance
of the trace which results in the reflection. Not all PCB traces can be straight and therefore some traces must
turn corners. Figure 8 shows progressively better techniques of rounding corners. Only the last example (BEST)
maintains constant trace width and minimizes reflections.
PAGE 14
WORST BETTER BEST
1W min.
W
2W
VCC
Unused Input
Input
Output Output
Input
Unused Input
14
SN74LVC2G125
SCES204Q – APRIL 1999 – REVISED MARCH 2017 www.ti.com
Product Folder Links: SN74LVC2G125
Submit Documentation Feedback Copyright © 1999–2017, Texas Instruments Incorporated
11.2 Layout Example
Figure 7. Proper multi-gate input termination diagram
Figure 8. Trace Example
PAGE 15
15
SN74LVC2G125
www.ti.com SCES204Q – APRIL 1999 – REVISED MARCH 2017
Product Folder Links: SN74LVC2G125
Submit Documentation FeedbackCopyright © 1999–2017, Texas Instruments Incorporated
12 Device and Documentation Support
12.1 Documentation Support
12.1.1 Related Documentation
For related documentation see the following:
Implications of Slow or Floating CMOS Inputs, SCBA004.
12.2 Receiving Notification of Documentation Updates
To receive notification of documentation updates, navigate to the device product folder on ti.com. In the upper
right corner, click on Alert me to register and receive a weekly digest of any product information that has
changed. For change details, review the revision history included in any revised document.
12.3 Community Resources
The following links connect to TI community resources. Linked contents are provided "AS IS" by the respective
contributors. They do not constitute TI specifications and do not necessarily reflect TI's views; see TI's Terms of
Use.
TI E2E™ Online Community TI's Engineer-to-Engineer (E2E) Community. Created to foster collaboration
among engineers. At e2e.ti.com, you can ask questions, share knowledge, explore ideas and help
solve problems with fellow engineers.
Design Support TI's Design Support Quickly find helpful E2E forums along with design support tools and
contact information for technical support.
12.4 Trademarks
NanoFree, E2E are trademarks of Texas Instruments.
12.5 Electrostatic Discharge Caution
This integrated circuit can be damaged by ESD. Texas Instruments recommends that all integrated circuits be handled with
appropriate precautions. Failure to observe proper handling and installation procedures can cause damage.
ESD damage can range from subtle performance degradation to complete device failure. Precision integrated circuits may be more
susceptible to damage because very small parametric changes could cause the device not to meet its published specifications.
12.6 Glossary
SLYZ022 — TI Glossary.
This glossary lists and explains terms, acronyms, and definitions.
13 Mechanical, Packaging, and Orderable Information
The following pages include mechanical, packaging, and orderable information. This information is the most
current data available for the designated devices. This data is subject to change without notice and revision of
this document. For browser-based versions of this data sheet, refer to the left-hand navigation.
PAGE 16
PACKAGE OPTION ADDENDUM
www.ti.com 28-Sep-2026
PACKAGING INFORMATION
Orderable part number Status
(1)
Material type
(2)
Package | Pins Package qty | Carrier RoHS
(3)
Lead finish/
Ball material
(4)
MSL rating/
Peak reflow
(5)
Op temp (°C) Part marking
(6)
74LVC2G125DCTRE4 Active Production SSOP (DCT) | 8 3000 | null Yes NIPDAU Level-1-260C-UNLIM -40 to 125 C25
(R, Z)
74LVC2G125DCTRE4.B Active Production SSOP (DCT) | 8 3000 | null Yes NIPDAU Level-1-260C-UNLIM -40 to 125 C25
(R, Z)
74LVC2G125DCTRE6 Obsolete Production SSOP (DCT) | 8 - - Call TI Call TI -40 to 125 C25
Z
74LVC2G125DCTRG4 Active Production SSOP (DCT) | 8 3000 | LARGE T&R Yes NIPDAU Level-1-260C-UNLIM -40 to 125 C25
(R, Z)
74LVC2G125DCTRG4.B Active Production SSOP (DCT) | 8 3000 | LARGE T&R Yes NIPDAU Level-1-260C-UNLIM -40 to 125 C25
(R, Z)
74LVC2G125DCURE4 Active Production VSSOP (DCU) | 8 3000 | LARGE T&R Yes NIPDAU Level-1-260C-UNLIM -40 to 125 C25R
74LVC2G125DCURG4 Active Production VSSOP (DCU) | 8 3000 | LARGE T&R Yes NIPDAU Level-1-260C-UNLIM -40 to 125 C25R
74LVC2G125DCURG4.B Active Production VSSOP (DCU) | 8 3000 | LARGE T&R Yes NIPDAU Level-1-260C-UNLIM -40 to 125 C25R
74LVC2G125DCUTG4 Active Production VSSOP (DCU) | 8 250 | SMALL T&R Yes NIPDAU Level-1-260C-UNLIM -40 to 125 C25R
74LVC2G125DCUTG4.B Active Production VSSOP (DCU) | 8 250 | SMALL T&R Yes NIPDAU Level-1-260C-UNLIM -40 to 125 C25R
SN74LVC2G125DCT3 Last
Time Buy
Production SSOP (DCT) | 8 3000 | LARGE T&R Yes SNBI Level-1-260C-UNLIM -40 to 125 C25
Z
SN74LVC2G125DCT3.B Last
Time Buy
Production SSOP (DCT) | 8 3000 | LARGE T&R Yes SNBI Level-1-260C-UNLIM -40 to 125 C25
Z
SN74LVC2G125DCTR Active Production SSOP (DCT) | 8 3000 | LARGE T&R Yes NIPDAU | SN Level-1-260C-UNLIM -40 to 125 (2WK5, C25)
(R, Z)
SN74LVC2G125DCTR.B Active Production SSOP (DCT) | 8 3000 | LARGE T&R Yes SN Level-1-260C-UNLIM -40 to 125 (2WK5, C25)
(R, Z)
SN74LVC2G125DCU3 Last
Time Buy
Production VSSOP (DCU) | 8 3000 | LARGE T&R Yes SNBI Level-1-260C-UNLIM -40 to 125 25
CZ
SN74LVC2G125DCU3.B Last
Time Buy
Production VSSOP (DCU) | 8 3000 | LARGE T&R Yes SNBI Level-1-260C-UNLIM -40 to 125 25
CZ
SN74LVC2G125DCUR Active Production VSSOP (DCU) | 8 3000 | LARGE T&R Yes NIPDAU | SN Level-1-260C-UNLIM -40 to 125 (25, C25J, C25Q, C
     25R)
CZ
SN74LVC2G125DCUR.B Active Production VSSOP (DCU) | 8 3000 | LARGE T&R Yes SN Level-1-260C-UNLIM -40 to 125 (25, C25J, C25Q, C
     25R)
CZ
Addendum-Page 1
PAGE 17
PACKAGE OPTION ADDENDUM
www.ti.com 28-Sep-2026
Orderable part number Status
(1)
Material type
(2)
Package | Pins Package qty | Carrier RoHS
(3)
Lead finish/
Ball material
(4)
MSL rating/
Peak reflow
(5)
Op temp (°C) Part marking
(6)
SN74LVC2G125DCUT Active Production VSSOP (DCU) | 8 250 | SMALL T&R Yes NIPDAU | SN Level-1-260C-UNLIM -40 to 125 (C25J, C25Q, C25R)
    
SN74LVC2G125DCUT.B Active Production VSSOP (DCU) | 8 250 | SMALL T&R Yes SN Level-1-260C-UNLIM -40 to 125 (C25J, C25Q, C25R)
    
SN74LVC2G125YZPR Active Production DSBGA (YZP) | 8 3000 | LARGE T&R Yes SNAGCU Level-1-260C-UNLIM -40 to 125 (CM7, CMN)
SN74LVC2G125YZPR.B Active Production DSBGA (YZP) | 8 3000 | LARGE T&R Yes SNAGCU Level-1-260C-UNLIM -40 to 125 (CM7, CMN)
 
(1) Status:  For more details on status, see our product life cycle.
 
(2) Material type:  When designated, preproduction parts are prototypes/experimental devices, and are not yet approved or released for full production. Testing and final process, including without limitation quality assurance,
reliability performance testing, and/or process qualification, may not yet be complete, and this item is subject to further changes or possible discontinuation. If available for ordering, purchases will be subject to an additional
waiver at checkout, and are intended for early internal evaluation purposes only. These items are sold without warranties of any kind.
 
(3) RoHS values:  Yes, No, RoHS Exempt. See the TI RoHS Statement for additional information and value definition.
 
(4) Lead finish/Ball material:  Parts may have multiple material finish options. Finish options are separated by a vertical ruled line. Lead finish/Ball material values may wrap to two lines if the finish value exceeds the maximum
column width.
 
(5) MSL rating/Peak reflow:  The moisture sensitivity level ratings and peak solder (reflow) temperatures. In the event that a part has multiple moisture sensitivity ratings, only the lowest level per JEDEC standards is shown.
Refer to the shipping label for the actual reflow temperature that will be used to mount the part to the printed circuit board.
 
(6) Part marking:  There may be an additional marking, which relates to the logo, the lot trace code information, or the environmental category of the part.
 
Multiple part markings will be inside parentheses. Only one part marking contained in parentheses and separated by a "~" will appear on a part. If a line is indented then it is a continuation of the previous line and the two
combined represent the entire part marking for that device.
 
Important Information and Disclaimer:The information provided on this page represents TI's knowledge and belief as of the date that it is provided. TI bases its knowledge and belief on information provided by third parties, and
makes no representation or warranty as to the accuracy of such information. Efforts are underway to better integrate information from third parties. TI has taken and continues to take reasonable steps to provide representative
and accurate information but may not have conducted destructive testing or chemical analysis on incoming materials and chemicals. TI and TI suppliers consider certain information to be proprietary, and thus CAS numbers
and other limited information may not be available for release.
 
In no event shall TI's liability arising out of such information exceed the total purchase price of the TI part(s) at issue in this document sold by TI to Customer on an annual basis.
 
 OTHER QUALIFIED VERSIONS OF SN74LVC2G125 :
Addendum-Page 2
PAGE 18
PACKAGE OPTION ADDENDUM
www.ti.com 28-Sep-2026
• Automotive : SN74LVC2G125-Q1
 NOTE: Qualified Version Definitions:
• Automotive - Q100 devices qualified for high-reliability automotive applications targeting zero defects
Addendum-Page 3
PAGE 19
PACKAGE MATERIALS INFORMATION
  
www.ti.com 15-Jul-2026
TAPE AND REEL INFORMATION
Reel Width (W1)
REEL DIMENSIONS
A0B0K0WDimension designed to accommodate the component lengthDimension designed to accommodate the component thicknessOverall width of the carrier tapePitch between successive cavity centersDimension designed to accommodate the component width
TAPE DIMENSIONSK0 P1B0WA0Cavity
QUADRANT ASSIGNMENTS FOR PIN 1 ORIENTATION IN TAPE
Pocket QuadrantsSprocket HolesQ1Q1Q2Q2Q3Q3Q4Q4User Direction of Feed
P1ReelDiameter
 
*All dimensions are nominal
Device Package
Type
Package
Drawing
Pins SPQ Reel
Diameter
(mm)
Reel
Width
W1 (mm)
A0
(mm)
B0
(mm)
K0
(mm)
P1
(mm)
W
(mm)
Pin1
Quadrant
74LVC2G125DCTRG4 SSOP DCT 8 3000 177.8 12.4 3.45 4.4 1.45 4.0 12.0 Q3
74LVC2G125DCURG4 VSSOP DCU 8 3000 180.0 8.4 2.25 3.35 1.05 4.0 8.0 Q3
74LVC2G125DCUTG4 VSSOP DCU 8 250 180.0 8.4 2.25 3.35 1.05 4.0 8.0 Q3
SN74LVC2G125DCT3 SSOP DCT 8 3000 180.0 13.0 3.35 4.5 1.55 4.0 12.0 Q3
SN74LVC2G125DCTR SSOP DCT 8 3000 180.0 12.4 3.15 4.35 1.55 4.0 12.0 Q3
SN74LVC2G125DCTR SSOP DCT 8 3000 177.8 12.4 3.45 4.4 1.45 4.0 12.0 Q3
SN74LVC2G125DCUR VSSOP DCU 8 3000 178.0 9.0 2.25 3.35 1.05 4.0 8.0 Q3
SN74LVC2G125DCUR VSSOP DCU 8 3000 180.0 8.4 2.25 3.35 1.05 4.0 8.0 Q3
SN74LVC2G125DCUT VSSOP DCU 8 250 178.0 9.5 2.25 3.35 1.05 4.0 8.0 Q3
SN74LVC2G125DCUT VSSOP DCU 8 250 178.0 9.0 2.25 3.35 1.05 4.0 8.0 Q3
SN74LVC2G125YZPR DSBGA YZP 8 3000 178.0 9.2 1.02 2.02 0.63 4.0 8.0 Q1
Pack Materials-Page 1
PAGE 20
PACKAGE MATERIALS INFORMATION
  
www.ti.com 15-Jul-2026
TAPE AND REEL BOX DIMENSIONS
Width (mm)
W LH
 
*All dimensions are nominal
Device Package Type Package Drawing Pins SPQ Length (mm) Width (mm) Height (mm)
74LVC2G125DCTRG4 SSOP DCT 8 3000 183.0 183.0 20.0
74LVC2G125DCURG4 VSSOP DCU 8 3000 202.0 201.0 28.0
74LVC2G125DCUTG4 VSSOP DCU 8 250 202.0 201.0 28.0
SN74LVC2G125DCT3 SSOP DCT 8 3000 182.0 182.0 20.0
SN74LVC2G125DCTR SSOP DCT 8 3000 190.0 190.0 30.0
SN74LVC2G125DCTR SSOP DCT 8 3000 183.0 183.0 20.0
SN74LVC2G125DCUR VSSOP DCU 8 3000 180.0 180.0 18.0
SN74LVC2G125DCUR VSSOP DCU 8 3000 202.0 201.0 28.0
SN74LVC2G125DCUT VSSOP DCU 8 250 202.0 201.0 28.0
SN74LVC2G125DCUT VSSOP DCU 8 250 180.0 180.0 18.0
SN74LVC2G125YZPR DSBGA YZP 8 3000 220.0 220.0 35.0
Pack Materials-Page 2
PAGE 21
www.ti.com
PACKAGE OUTLINE
C
4.25
3.95 TYP
1.3
1.0
6X 0.65
8X 0.30
0.15
2X
1.95
(0.15) TYP
0 - 8
0.2
0.0
0.25
GAGE PLANE
0.6
0.2
A
3.1
2.9
NOTE 3
B 3.1
2.9
NOTE 4
4220784/D   10/2025
SSOP - 1.3 mm max heightDCT0008A
SMALL OUTLINE PACKAGE
NOTES: 
 
1. All linear dimensions are in millimeters. Dimensions in parenthesis are for reference only. Dimensioning and tolerancing
    per ASME Y14.5M. 
2. This drawing is subject to change without notice. 
3. This dimension does not include mold flash, protrusions, or gate burrs. Mold flash, protrusions, or gate burrs shall not
    exceed 0.15 mm per side. 
4. This dimension does not include interlead flash. Interlead flash shall not exceed 0.25 mm per side.
1 8
0.13 C A B
5
4
PIN 1 ID
AREA
SEATING PLANE
0.1 C
 SEE DETAIL A
DETAIL A
TYPICAL
SCALE  3.500
PAGE 22
www.ti.com
EXAMPLE BOARD LAYOUT
(3.8)
0.07 MAX
ALL AROUND
0.07 MIN
ALL AROUND
8X (1.1)
8X (0.4)
6X (0.65)
(R0.05)
TYP
4220784/D   10/2025
SSOP - 1.3 mm max heightDCT0008A
SMALL OUTLINE PACKAGE
SYMM
SYMM
LAND PATTERN EXAMPLE
EXPOSED METAL SHOWN
SCALE:15X
1
4 5
8
NOTES: (continued)
 
5. Publication IPC-7351 may have alternate designs. 
6. Solder mask tolerances between and around signal pads can vary based on board fabrication site.
 
METALSOLDER MASK
OPENING
NON SOLDER MASK
DEFINED
SOLDER MASK DETAILS
EXPOSED METAL
SOLDER MASK
OPENING
METAL UNDER
SOLDER MASK
SOLDER MASK
DEFINED
EXPOSED METAL
PAGE 23
www.ti.com
EXAMPLE STENCIL DESIGN
(3.8)
6X (0.65)
8X (0.4)
8X (1.1)
4220784/D   10/2025
SSOP - 1.3 mm max heightDCT0008A
SMALL OUTLINE PACKAGE
NOTES: (continued)
 
7. Laser cutting apertures with trapezoidal walls and rounded corners may offer better paste release. IPC-7525 may have alternate
    design recommendations.   
8. Board assembly site may have different recommendations for stencil design.
 
SYMM
SYMM
1
4 5
8
SOLDER PASTE EXAMPLE
BASED ON 0.125 mm THICK STENCIL
SCALE:15X
PAGE 24
www.ti.com
PACKAGE OUTLINE
C
6X 0.5
2X
1.5
8X 0.25
0.17
3.2
3.0 TYP
SEATING
PLANE
0.1
0.0
0.12
GAGE PLANE
0 -6
0.9
0.6
B 2.4
2.2
NOTE 3
A
2.1
1.9
NOTE 3
0.35
0.20
(0.13) TYP
VSSOP - 0.9 mm max heightDCU0008A
SMALL OUTLINE PACKAGE
4225266/A   09/2014
1
4 5
8
0.08 C A B
PIN 1 INDEX AREA
SEE DETAIL  A
0.1 C
NOTES: 
 
1. All linear dimensions are in millimeters. Any dimensions in parenthesis are for reference only. Dimensioning and tolerancing
    per ASME Y14.5M. 
2. This drawing is subject to change without notice. 
3. This dimension does not include mold flash, protrusions, or gate burrs. Mold flash, protrusions, or gate burrs shall not
    exceed 0.15 mm per side. 
4. Reference JEDEC registration MO-187 variation CA.
 
A  30
DETAIL A
TYPICAL
SCALE  6.000
PAGE 25
www.ti.com
EXAMPLE BOARD LAYOUT
0.05 MAX
ALL AROUND
0.05 MIN
ALL AROUND
8X (0.85)
8X (0.3)
6X (0.5)
(3.1)
(R0.05) TYP
VSSOP - 0.9 mm max heightDCU0008A
SMALL OUTLINE PACKAGE
4225266/A   09/2014
NOTES: (continued)
 
5. Publication IPC-7351 may have alternate designs. 
6. Solder mask tolerances between and around signal pads can vary based on board fabrication site.
 
LAND PATTERN EXAMPLE
EXPOSED METAL SHOWN
SCALE: 25X
SYMM
SYMM
1
4 5
8
SEE SOLDER MASK
DETAILS
15.000
METALSOLDER MASK
OPENING
METAL UNDER
SOLDER MASK
SOLDER MASK
OPENING
EXPOSED METALEXPOSED METAL
SOLDER MASK DETAILS
NON-SOLDER MASK
DEFINED
(PREFERRED)
SOLDER MASK
DEFINED
PAGE 26
www.ti.com
EXAMPLE STENCIL DESIGN
8X (0.85)
8X (0.3)
6X (0.5)
(3.1)
(R0.05) TYP
VSSOP - 0.9 mm max heightDCU0008A
SMALL OUTLINE PACKAGE
4225266/A   09/2014
NOTES: (continued)
 
7. Laser cutting apertures with trapezoidal walls and rounded corners may offer better paste release. IPC-7525 may have alternate
    design recommendations.   
8. Board assembly site may have different recommendations for stencil design.
 
SOLDER PASTE EXAMPLE
BASED ON 0.125 mm THICK STENCIL
SCALE: 25X
SYMM
SYMM
1
4 5
8
PAGE 27
www.ti.com
PACKAGE OUTLINE
C
0.5 MAX
0.19
0.15
1.5
TYP
0.5  TYP
8X 0.25
0.21
0.5
TYP
B E A
D
4223082/A   07/2016
DSBGA - 0.5 mm max heightYZP0008
DIE SIZE BALL GRID ARRAY
NOTES: 
 
1. All linear dimensions are in millimeters. Any dimensions in parenthesis are for reference only. Dimensioning and tolerancing
    per ASME Y14.5M.
2. This drawing is subject to change without notice.
BALL A1
CORNER
SEATING PLANE
BALL TYP
0.05 C
B
1 2
0.015 C A B
SYMM
SYMM 
C
A
D
SCALE  8.000
D: Max = 
E: Max = 
1.918 mm, Min = 
0.918 mm, Min = 
1.858 mm
0.858 mm
PAGE 28
www.ti.com
EXAMPLE BOARD LAYOUT
8X ( 0.23)
(0.5) TYP
(0.5) TYP
( 0.23)
METAL
0.05 MAX ( 0.23)
SOLDER MASK
OPENING
0.05 MIN
4223082/A   07/2016
DSBGA - 0.5 mm max heightYZP0008
DIE SIZE BALL GRID ARRAY
NOTES: (continued)
 
3. Final dimensions may vary due to manufacturing tolerance considerations and also routing constraints.
    For more information, see Texas Instruments literature number SNVA009 (www.ti.com/lit/snva009).
 
SYMM
SYMM
LAND PATTERN EXAMPLE
SCALE:40X
1 2
A
B
C
D
NON-SOLDER MASK
DEFINED
(PREFERRED)
SOLDER MASK DETAILS
NOT TO SCALE
SOLDER MASK
OPENING
SOLDER MASK
DEFINED
METAL UNDER
SOLDER MASK
PAGE 29
www.ti.com
EXAMPLE STENCIL DESIGN
(0.5)
TYP
(0.5) TYP
8X ( 0.25) (R0.05) TYP
METAL
TYP
4223082/A   07/2016
DSBGA - 0.5 mm max heightYZP0008
DIE SIZE BALL GRID ARRAY
NOTES: (continued)
 
4. Laser cutting apertures with trapezoidal walls and rounded corners may offer better paste release.
SYMM
SYMM
SOLDER PASTE EXAMPLE
BASED ON 0.1 mm THICK STENCIL
SCALE:40X
1 2
A
B
C
D
PAGE 30
IMPORTANT NOTICE AND DISCLAIMER
TI PROVIDES TECHNICAL AND RELIABILITY DATA (INCLUDING DATASHEETS), DESIGN RESOURCES (INCLUDING REFERENCE 
DESIGNS), APPLICATION OR OTHER DESIGN ADVICE, WEB TOOLS, SAFETY INFORMATION, AND OTHER RESOURCES “AS IS” 
AND WITH ALL FAULTS, AND DISCLAIMS ALL WARRANTIES, EXPRESS AND IMPLIED, INCLUDING WITHOUT LIMITATION ANY 
IMPLIED WARRANTIES OF MERCHANTABILITY, FITNESS FOR A PARTICULAR PURPOSE OR NON-INFRINGEMENT OF THIRD 
PARTY INTELLECTUAL PROPERTY RIGHTS.
These resources are intended for skilled developers designing with TI products. You are solely responsible for (1) selecting the appropriate 
TI products for your application, (2) designing, validating and testing your application, and (3) ensuring your application meets applicable 
standards, and any other safety, security, regulatory or other requirements.
These resources are subject to change without notice. TI grants you permission to use these resources only for development of an 
application that uses the TI products described in the resource. Other reproduction and display of these resources is prohibited. No license 
is granted to any other TI intellectual property right or to any third party intellectual property right. TI disclaims responsibility for, and you fully 
indemnify TI and its representatives against any claims, damages, costs, losses, and liabilities arising out of your use of these resources.
TI’s products are provided subject to TI’s Terms of Sale, TI’s General Quality Guidelines, or other applicable terms available either on 
ti.com or provided in conjunction with such TI products. TI’s provision of these resources does not expand or otherwise alter TI’s applicable 
warranties or warranty disclaimers for TI products. Unless TI explicitly designates a product as custom or customer-specified, TI products 
are standard, catalog, general purpose devices.
TI objects to and rejects any additional or different terms you may propose.
IMPORTANT NOTICE
Copyright © 2026, Texas Instruments Incorporated
Last updated 10/2025
