Alksndr55/mesh-repeater-2.0/bom/V2_A3_COMPONENT_BOM.csv

Board | Reference | Kind | Quantity_Physical_Positions | Value_NaIon_COLD | Fit_NaIon_COLD | Value_NaIon_NoCOLD | Fit_NaIon_NoCOLD | Value_LTO_2S | Fit_LTO_2S | MPN_NaIon_COLD | MPN_NaIon_NoCOLD | MPN_LTO_2S | Saved_Model_Footprint | Physical_Package_Footprint | Buy_Component_NaIon_COLD | Buy_Component_NaIon_NoCOLD | Buy_Component_LTO_2S | Group | Original_S4_16_Reference | Vendor_URL_In_Model | Mechanical_Selection_MPN | Mechanical_Selection_Article | Mechanical_Selection_Footprint | Mechanical_Selection_URL | Mechanical_Selection_Stock | Mechanical_Selection_Checked | Procurement_Status | Current_Offer_URL | Current_Offer_Stock | Current_Offer_Checked | Current_Offer_Minimum_Order | Current_Offer_Price_RUB | Current_Offer_Price_Basis | Note
POWER | U1 | CN3722 | 1 | CN3722 | yes | CN3722 | yes | CN3722 | yes | CN3722 | CN3722 | CN3722 | Meshcore:TSSOP-16_4.4x5mm_P0.65mm__V2_U1 | Meshcore:TSSOP-16_4.4x5mm_P0.65mm | yes | yes | yes | charger | U1 |  |  |  |  |  |  |  | Inherited S4.16 procurement data; current stock not rechecked
POWER | Q1 | PMOS_GSD | 1 | AO3401A | yes | AO3401A | yes | AO3401A | yes | AO3401A | AO3401A | AO3401A | Meshcore:SOT-23__V2_Q1 | Meshcore:SOT-23 | yes | yes | yes | charger | Q1 | https://www.danomsk.ru/shop/4-tranzistory/126-tranzistory-importnye/168774-ao3401a-sot23-p-kanal-30v-4a-1-4vt-a-o/ |  |  |  |  |  |  | Inherited S4.16 procurement data; current stock not rechecked |  |  |  |  |  |  | Only AOS-qualified part, not an unreviewed same-name substitute. Cold panel Voc<=24V. Danomsk S4.6 approved substitution. Выбрана именно карточка AOS/A&O, соответствующая исходной детали.
POWER | D1 | Diode | 1 | SS24 | yes | SS24 | yes | SS24 | yes | SS24 | SS24 | SS24 | Meshcore:D_SMB__V2_D1 | Meshcore:D_SMB | yes | yes | yes | charger | D1 | https://www.danomsk.ru/shop/3-diody-i-tiristory/451-diody-shottki/113168-ss24-smb-do-214aa-diod-shottki-40v-2-a-0-7v-mic/ |  |  |  |  |  |  | Inherited S4.16 procurement data; current stock not rechecked |  |  |  |  |  |  | Series reverse blocking diode Danomsk S4.6 approved substitution. Доступный местный Schottky 40 В / 2 А. Отличие SMB от текущего SMA не препятствует будущей замене с переразводкой.
POWER | D2 | Diode | 1 | SS24 | yes | SS24 | yes | SS24 | yes | SS24 | SS24 | SS24 | Meshcore:D_SMB__V2_D2 | Meshcore:D_SMB | yes | yes | yes | charger | D2 | https://www.danomsk.ru/shop/3-diody-i-tiristory/451-diody-shottki/113168-ss24-smb-do-214aa-diod-shottki-40v-2-a-0-7v-mic/ |  |  |  |  |  |  | Inherited S4.16 procurement data; current stock not rechecked |  |  |  |  |  |  | Danomsk S4.6 approved substitution. Доступный местный Schottky 40 В / 2 А. Отличие SMB от текущего SMA не препятствует будущей замене с переразводкой.
POWER | L1 | Inductor | 1 | 100uH | yes | 100uH | yes | 100uH | yes | CDRH127/LDNP-101MC | CDRH127/LDNP-101MC | CDRH127/LDNP-101MC | Meshcore:L_Sumida_CDRH127_LDNP_101MC__V2_L1 | Meshcore:L_Sumida_CDRH127_LDNP_101MC | yes | yes | yes | charger | L1 | https://www.danomsk.ru/shop/8-ustanovochnye/97-induktivnye-komponenty/281-drosseli-induktivnosti/138307-cdrh127-ldnp-101mc-100-mkgn-20-2-1-a-sumida/ |  |  |  |  |  |  | Inherited S4.16 procurement data; current stock not rechecked |  |  |  |  |  |  | Sumida CDRH127/LDNP-101MC, shielded100uH +/-20%. Maximum body12.3x12.3x8mm. DCRmax151mohm; table Isat2.1A at25% inductance drop. Verify temperature rise under shield. Approved Danomsk S4.6 substitution.
POWER | R1 | R | 1 | 0.28R 1% | yes | 0.28R 1% | yes | 0.28R 1% | yes | WSL2512R2800FEA | WSL2512R2800FEA | WSL2512R2800FEA | Meshcore:R_Vishay_WSL2512_A3__A3_R1 | Meshcore:R_Vishay_WSL2512_A3 | yes | yes | yes | charger | R1 |  |  |  |  |  |  |  | A3 exact 2512 ordering code selected; local stock and price not rechecked |  |  |  |  |  |  | Base 0.28 ohm 1% 0.5W current shunt, unchanged for both batteries. Thermal option adds R56 upstream. CN3722 CSP senses upstream of R56, BAT downstream of R1; Kelvin connections. Cold ~96mA; warm ~665mA with three parallel AO3401A; bypass/no thermal nominal 714mA.
POWER | C1 | C | 1 | 10uF 50V X7R | yes | 10uF 50V X7R | yes | 10uF 50V X7R | yes | CL31B106KBHNNNE | CL31B106KBHNNNE | CL31B106KBHNNNE | Meshcore:C_1206_3216Metric__V2_C1 | Meshcore:C_1206_3216Metric | yes | yes | yes | charger | C1 | https://www.danomsk.ru/shop/5-kondensatory/89-kondensatory-keramicheskie/733-kondensatory-smd-1206/202927-chip-kond-1206-x7r-10uf-10-50v-cl31b106kbhnnne-cc120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 |  |  |  |  |  |  | Inherited S4.16 procurement data; current stock not rechecked |  |  |  |  |  |  | Danomsk S4.6 approved substitution. Точный текущий MPN найден в местном каталоге; входной керамический конденсатор SOLAR.
POWER | C2 | C | 1 | 100nF 50V X7R | yes | 100nF 50V X7R | yes | 100nF 50V X7R | yes | CL21B104KBCNNNC | CL21B104KBCNNNC | CL21B104KBCNNNC | Meshcore:C_0805_2012Metric__V2_C2 | Meshcore:C_0805_2012Metric | yes | yes | yes | charger | C2 | https://www.danomsk.ru/shop/5-kondensatory/89-kondensatory-keramicheskie/732-kondensatory-smd-0805/196705-chip-kond-0805-x7r-0-10uf-10-50v-cl21b104kbcnnnc-cc0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 |  |  |  |  |  |  | Inherited S4.16 procurement data; current stock not rechecked |  |  |  |  |  |  | Danomsk S4.6 approved substitution. Точный текущий MPN. C3 остаётся между SOLAR и VG; C25 остаётся в фильтре BAT_ADC.
POWER | C3 | C | 1 | 100nF 50V X7R | yes | 100nF 50V X7R | yes | 100nF 50V X7R | yes | CL21B104KBCNNNC | CL21B104KBCNNNC | CL21B104KBCNNNC | Meshcore:C_0805_2012Metric__V2_C3 | Meshcore:C_0805_2012Metric | yes | yes | yes | charger | C3 | https://www.danomsk.ru/shop/5-kondensatory/89-kondensatory-keramicheskie/732-kondensatory-smd-0805/196705-chip-kond-0805-x7r-0-10uf-10-50v-cl21b104kbcnnnc-cc0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 |  |  |  |  |  |  | Inherited S4.16 procurement data; current stock not rechecked |  |  |  |  |  |  | VG capacitor returns to VCC, not ground Danomsk S4.6 approved substitution. Точный текущий MPN. C3 остаётся между SOLAR и VG; C25 остаётся в фильтре BAT_ADC.
POWER | C4 | C | 1 | 22uF 25V X5R | yes | 22uF 25V X5R | yes | 22uF 25V X5R | yes | CL21A226MAQNNNE | CL21A226MAQNNNE | CL21A226MAQNNNE | Meshcore:C_0805_2012Metric__V2_C4 | Meshcore:C_0805_2012Metric | yes | yes | yes | charger | C4 | https://www.danomsk.ru/shop/5-kondensatory/89-kondensatory-keramicheskie/732-kondensatory-smd-0805/196759-chip-kond-0805-x5r-22uf-10-25v-cl21a226maqnnne-cc080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 |  |  |  |  |  |  | Inherited S4.16 procurement data; current stock not rechecked |  |  |  |  |  |  | Danomsk S4.6 approved substitution. Местный кандидат с достаточным типовым запасом: C14 при3,3V около14,90µF, инженерная оценка10,13µF против7µF минимума TPS63802. C4 при4,0V типично12,97µF, оценка8,82µF. Необходимы измерение и согласование снижения верхней температуры.
POWER | R3 | R | 1 | 61.9k 0.1% <=25ppm/C | yes | 61.9k 0.1% <=25ppm/C | yes | 121k 0.1% <=25ppm/C | yes | RT0805BRD0761K9L | RT0805BRD0761K9L | RT0805BRD07121KL | Meshcore:R_0805_2012Metric__V2_R3 | Meshcore:R_0805_2012Metric | yes | yes | yes | charger | R3 | https://www.digikey.com/en/products/detail/yageo/RT0805BRD0761K9L/1075991 |  |  |  |  |  |  | Inherited S4.16 procurement data; current stock not rechecked |  |  |  |  |  |  | High-impedance CN3722 CV divider. Na-ion: 61.9k; LTO 2S: 121k. Use 0.1%, <=25ppm/C.
POWER | R4 | R | 1 | 100k 0.1% <=25ppm/C | yes | 100k 0.1% <=25ppm/C | yes | 100k 0.1% <=25ppm/C | yes | RT0805BRD07100KL | RT0805BRD07100KL | RT0805BRD07100KL | Meshcore:R_0805_2012Metric__V2_R4 | Meshcore:R_0805_2012Metric | yes | yes | yes | charger | R4 | https://www.chipdip.ru/product/0.125vt-0805-100-kom-0.1-rt0805brd07100kl-chip-yageo-9000237585 |  |  |  |  |  |  | Inherited S4.16 procurement data; current stock not rechecked |  |  |  |  |  |  | 100k lower CN3722 CV resistor for both assembly variants, 0.1%, <=25ppm/C.
POWER | C5 | C | 1 | 470pF 50V C0G | yes | 470pF 50V C0G | yes | 470pF 50V C0G | yes | CC0805JRNPO9BN471 | CC0805JRNPO9BN471 | CC0805JRNPO9BN471 | Meshcore:C_0805_2012Metric__V2_C5 | Meshcore:C_0805_2012Metric | yes | yes | yes | charger | C5 | https://www.danomsk.ru/shop/5-kondensatory/89-kondensatory-keramicheskie/732-kondensatory-smd-0805/142082-chip-kond-0805-np0-470pf-5-50v-cc0805jrnpo9bn471-cc0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 |  |  |  |  |  |  | Inherited S4.16 procurement data; current stock not rechecked |  |  |  |  |  |  | Danomsk S4.6 approved substitution. Сохраняются ёмкость, допуск, стабильный диэлектрик и напряжение конденсатора компенсации CN3722.
POWER | R5 | R | 1 | 1M 0.1% | yes | 1M 0.1% | yes | 1M 0.1% | yes | RT0805BRD071ML | RT0805BRD071ML | RT0805BRD071ML | Meshcore:R_0805_2012Metric__V2_R5 | Meshcore:R_0805_2012Metric | yes | yes | yes | charger | R5 | https://www.danomsk.ru/shop/6-rezistory/86-rezistory-postoyannye/268-rezistory-chip-0805/211665-chip-0805-1-0m-0-1-rt0805brd071ml-yageo/ |  |  |  |  |  |  | Inherited S4.16 procurement data; current stock not rechecked |  |  |  |  |  |  | Danomsk S4.6 approved substitution. Точный RT0805BRD071ML для R27/R28: 1 МОм/0.1%/±25 ppm/°C. Такой же ставим в R5 вместо 1%: корпус/номинал сохраняются, отдельный лот обычных 1 МОм покупать не требуется. Из обязательного лота 10 шт. используется 3.
POWER | R6 | R | 1 | 120R | yes | 120R | yes | 120R | yes | RC0805FR-07120RL | RC0805FR-07120RL | RC0805FR-07120RL | Meshcore:R_0805_2012Metric__V2_R6 | Meshcore:R_0805_2012Metric | yes | yes | yes | charger | R6 | https://www.danomsk.ru/shop/6-rezistory/86-rezistory-postoyannye/268-rezistory-chip-0805/134728-chip-0805-120-1-rc0805fr-07120r-yageo/ |  |  |  |  |  |  | Inherited S4.16 procurement data; current stock not rechecked |  |  |  |  |  |  | Danomsk S4.6 approved substitution. 120Ω, 0805, 1%; Yageo вместо Uni-Ohm. Покупка кратно 10 шт.
POWER | C6 | C | 1 | 220nF 50V X7R | yes | 220nF 50V X7R | yes | 220nF 50V X7R | yes | CC0805KKX7R9BB224 | CC0805KKX7R9BB224 | CC0805KKX7R9BB224 | Meshcore:C_0805_2012Metric__V2_C6 | Meshcore:C_0805_2012Metric | yes | yes | yes | charger | C6 | https://www.danomsk.ru/shop/5-kondensatory/89-kondensatory-keramicheskie/732-kondensatory-smd-0805/119579-chip-kond-0805-x7r-0-22uf-10-50v-cc0805kkx7r9bb224-c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 |  |  |  |  |  |  | Inherited S4.16 procurement data; current stock not rechecked |  |  |  |  |  |  | Danomsk S4.6 approved substitution. Та же ёмкость и класс X7R, тот же корпус; замена по документу производителя в карточке.
POWER | C7 | C | 1 | 100nF 50V X7R | yes | 100nF 50V X7R | yes | 100nF 50V X7R | yes | CL21B104KBCNNNC | CL21B104KBCNNNC | CL21B104KBCNNNC | Meshcore:C_0805_2012Metric__V2_C7 | Meshcore:C_0805_2012Metric | yes | yes | yes | charger | C7 | https://www.danomsk.ru/shop/5-kondensatory/89-kondensatory-keramicheskie/732-kondensatory-smd-0805/196705-chip-kond-0805-x7r-0-10uf-10-50v-cl21b104kbcnnnc-cc0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 |  |  |  |  |  |  | Inherited S4.16 procurement data; current stock not rechecked |  |  |  |  |  |  | Danomsk S4.6 approved substitution. Точный текущий MPN. C3 остаётся между SOLAR и VG; C25 остаётся в фильтре BAT_ADC.
POWER | R7 | R | 1 | 105k 0.1% | yes | 105k 0.1% | yes | 105k 0.1% | yes | AT0805BRD07105KL | AT0805BRD07105KL | AT0805BRD07105KL | Meshcore:R_0805_2012Metric__V2_R7 | Meshcore:R_0805_2012Metric | yes | yes | yes | charger | R7 |  |  |  |  |  |  |  | Inherited S4.16 procurement data; current stock not rechecked |  |  |  |  |  |  | Provisional Vmp11.96V at25C; populated value must match measured panel Vmp
POWER | R8 | R | 1 | 10k 0.1% | yes | 10k 0.1% | yes | 10k 0.1% | yes | RT0805BRE0710KL | RT0805BRE0710KL | RT0805BRE0710KL | Meshcore:R_0805_2012Metric__V2_R8 | Meshcore:R_0805_2012Metric | yes | yes | yes | charger | R8 | https://www.danomsk.ru/shop/6-rezistory/86-rezistory-postoyannye/268-rezistory-chip-0805/145796-chip-0805-10-0k-0-1-50ppm-c-rt0805bre0710kl-tonkoplenochnyy-ya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 |  |  |  |  |  |  | Inherited S4.16 procurement data; current stock not rechecked |  |  |  |  |  |  | Danomsk S4.6 approved substitution. Предлагается только для R8 (MPPT) и R14 (обратная связь TPS). Те же 10 кОм/0.1%/0805, TCR ±50 вместо ±25 ppm/°C. При ΔT=65°C расчёт PWM-выхода 3.248…3.358 В вместо 3.252…3.354 В. Вклад допусков и TCR резисторов в MPPT при фиксированном Vref: 11.885…12.035 В; сам Vref/панель сюда не включены. R4 в зарядном делителе сохраняется ±25 ppm/°C: запас до 4.0 В мал.
POWER | R9 | R | 1 | 10k | yes | 10k | yes | 10k | yes | RC0805FR-0710KL | RC0805FR-0710KL | RC0805FR-0710KL | Meshcore:R_0805_2012Metric__V2_R9 | Meshcore:R_0805_2012Metric | yes | yes | yes | charger | R9 | https://www.danomsk.ru/shop/6-rezistory/86-rezistory-postoyannye/268-rezistory-chip-0805/140222-chip-0805-10k-1-rc0805fr-0710kl-yageo/ |  |  |  |  |  |  | Inherited S4.16 procurement data; current stock not rechecked |  |  |  |  |  |  | Battery temperature monitoring disabled at explicit user request Danomsk S4.6 approved substitution. 10kΩ, 0805, 1%; только непрецизионные позиции, не заменять этим R4/R8/R14. Покупка кратно 10 шт.
POWER | C8 | C | 1 | 47uF 35V | yes | 47uF 35V | yes | 47uF 35V | yes | EEEFK1V470P | EEEFK1V470P | EEEFK1V470P | Meshcore:CP_Elec_Panasonic_FK_D_6.3x5.8__V2_C8 | Meshcore:CP_Elec_Panasonic_FK_D_6.3x5.8 | yes | yes | yes |  | C8 | https://www.danomsk.ru/shop/5-kondensatory/88-kondensatory-elektroliticheskie/737-kondensatory-elektroliticheskie-smd/197287-chip-el-lit-eeefk1v470p-35v-47uf-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 |  |  |  |  |  |  | Inherited S4.16 procurement data; current stock not rechecked |  |  |  |  |  |  | Panasonic FK D, 47uF35V, diameter6.3mm, height5.8mm. Exact recommended pads3.2x1.6mm, gap1.8mm. 240mArms@100kHz105C, Zmax0.36ohm@100kHz20C. Maximum105C; verify C1+C8 ripple sharing and temperature under shield. Danomsk S4.6 approved substitution. Ближайшая качественная местная замена: 240mArms@100kHz/+105°C, Zmax0,36Ω@100kHz/+20°C. Сохраняются47µF/35V/диаметр6,3мм, но это не точный температурный аналог Nichicon.
POWER | R10 | R | 1 | 10k | yes | 10k | yes | 10k | yes | RC0805FR-0710KL | RC0805FR-0710KL | RC0805FR-0710KL | Meshcore:R_0805_2012Metric__V2_R10 | Meshcore:R_0805_2012Metric | yes | yes | yes |  | R10 | https://www.danomsk.ru/shop/6-rezistory/86-rezistory-postoyannye/268-rezistory-chip-0805/140222-chip-0805-10k-1-rc0805fr-0710kl-yageo/ |  |  |  |  |  |  | Inherited S4.16 procurement data; current stock not rechecked |  |  |  |  |  |  | Danomsk S4.6 approved substitution. 10kΩ, 0805, 1%; только непрецизионные позиции, не заменять этим R4/R8/R14. Покупка кратно 10 шт.
POWER | D3 | LED | 1 | RED | yes | RED | yes | RED | yes | FYLS-0805BURC | FYLS-0805BURC | FYLS-0805BURC | Meshcore:LED_0805_2012Metric__V2_D3 | Meshcore:LED_0805_2012Metric | yes | yes | yes |  | D3 | https://www.danomsk.ru/shop/20-svetodiodnye-izdeliya-optoelektronika/115-svetodiody/198855-fyls-0805burc-smd-2kh1-25mm-krasnyy-631nm-80mkd-prozrachnyy-130-for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 |  |  |  |  |  |  | Inherited S4.16 procurement data; current stock not rechecked |  |  |  |  |  |  | Danomsk S4.6 approved substitution. Функциональная замена индикатора: красный, тот же типоразмер. Равная яркость не гарантируется.
POWER | R11 | R | 1 | 10k | yes | 10k | yes | 10k | yes | RC0805FR-0710KL | RC0805FR-0710KL | RC0805FR-0710KL | Meshcore:R_0805_2012Metric__V2_R11 | Meshcore:R_0805_2012Metric | yes | yes | yes |  | R11 | https://www.danomsk.ru/shop/6-rezistory/86-rezistory-postoyannye/268-rezistory-chip-0805/140222-chip-0805-10k-1-rc0805fr-0710kl-yageo/ |  |  |  |  |  |  | Inherited S4.16 procurement data; current stock not rechecked |  |  |  |  |  |  | Danomsk S4.6 approved substitution. 10kΩ, 0805, 1%; только непрецизионные позиции, не заменять этим R4/R8/R14. Покупка кратно 10 шт.
POWER | D4 | LED | 1 | GREEN | yes | GREEN | yes | GREEN | yes | FYLS-0805BUGC | FYLS-0805BUGC | FYLS-0805BUGC | Meshcore:LED_0805_2012Metric__V2_D4 | Meshcore:LED_0805_2012Metric | yes | yes | yes |  | D4 | https://www.danomsk.ru/shop/20-svetodiodnye-izdeliya-optoelektronika/115-svetodiody/198856-fyls-0805bugc-smd-2kh1-25mm-zelenyy-570nm-40mkd-prozrachnyy-130-for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 |  |  |  |  |  |  | Inherited S4.16 procurement data; current stock not rechecked |  |  |  |  |  |  | Danomsk S4.6 approved substitution. Функциональная замена индикатора: зелёный, тот же типоразмер. Равная яркость не гарантируется.
POWER | U2 | TPS63802 | 1 | TPS63802DLAR | yes | TPS63802DLAR | yes | TPS63802DLAR | yes | TPS63802DLAR | TPS63802DLAR | TPS63802DLAR | Meshcore:TPS63802_DLA0010A__V2_U2 | Meshcore:TPS63802_DLA0010A | yes | yes | yes | converter | U2 |  |  |  |  |  |  |  | Inherited S4.16 procurement data; current stock not rechecked
POWER | L2 | Inductor | 1 | 0.47uH | yes | 0.47uH | yes | 0.47uH | yes | XGL4020-471MEC | XGL4020-471MEC | XGL4020-471MEC | Meshcore:L_Coilcraft_XGL4020_471MEC__V2_L2 | Meshcore:L_Coilcraft_XGL4020_471MEC | yes | yes | yes | converter | L2 |  |  |  |  |  |  |  | Inherited S4.16 procurement data; current stock not rechecked |  |  |  |  |  |  | Shielded 0.47uH power inductor; body 4.0+/-0.3mm square, maximum height 2.10mm. Official Coilcraft recommended copper lands; mask, paste and F.Cu under-coil keepout are engineering choices.
POWER | C12 | C | 1 | 10uF 16V X7R | yes | 10uF 16V X7R | yes | 10uF 16V X7R | yes | CL21B106KOQNNNE | CL21B106KOQNNNE | CL21B106KOQNNNE | Meshcore:C_0805_2012Metric__V2_C12 | Meshcore:C_0805_2012Metric | yes | yes | yes | converter | C12 | https://www.danomsk.ru/shop/5-kondensatory/89-kondensatory-keramicheskie/732-kondensatory-smd-0805/194763-chip-kond-0805-x7r-10uf-10-16v-cl21b106koqnnne-cc080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 |  |  |  |  |  |  | Inherited S4.16 procurement data; current stock not rechecked |  |  |  |  |  |  | Danomsk S4.6 approved substitution. Предлагается местный 16V Samsung, но Cin TPS63802 должен быть не менее 4µF эффективных при максимальном BAT=4,0V. Типовая кривая даёт около6,20µF; оценка с допуском/температурой около4,74µF. Это кандидат для квалификации, не гарантированное доказательство запаса.
POWER | C13 | C | 1 | 100nF 50V X7R | yes | 100nF 50V X7R | yes | 100nF 50V X7R | yes | CL10B104KB8NNNC | CL10B104KB8NNNC | CL10B104KB8NNNC | Meshcore:C_0603_1608Metric__V2_C13 | Meshcore:C_0603_1608Metric | yes | yes | yes | converter | C13 | https://www.danomsk.ru/shop/5-kondensatory/89-kondensatory-keramicheskie/731-kondensatory-smd-0603/142040-chip-kond-0603-x7r-0-1uf-10-50v-cl10b104kb8nnnc-cc06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 |  |  |  |  |  |  | Inherited S4.16 procurement data; current stock not rechecked |  |  |  |  |  |  | Danomsk S4.6 approved substitution. Точный MPN местного каталога; высокочастотная развязка TPS63802.
POWER | C14 | C | 1 | 22uF 25V X5R | yes | 22uF 25V X5R | yes | 22uF 25V X5R | yes | CL21A226MAQNNNE | CL21A226MAQNNNE | CL21A226MAQNNNE | Meshcore:C_0805_2012Metric__V2_C14 | Meshcore:C_0805_2012Metric | yes | yes | yes | converter | C14 | https://www.danomsk.ru/shop/5-kondensatory/89-kondensatory-keramicheskie/732-kondensatory-smd-0805/196759-chip-kond-0805-x5r-22uf-10-25v-cl21a226maqnnne-cc080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 |  |  |  |  |  |  | Inherited S4.16 procurement data; current stock not rechecked |  |  |  |  |  |  | Local COUT before additional LC filter Danomsk S4.6 approved substitution. Местный кандидат с достаточным типовым запасом: C14 при3,3V около14,90µF, инженерная оценка10,13µF против7µF минимума TPS63802. C4 при4,0V типично12,97µF, оценка8,82µF. Необходимы измерение и согласование снижения верхней температуры.
POWER | C52 | C | 1 | 10uF 16V X7R | yes | 10uF 16V X7R | yes | 10uF 16V X7R | yes | CL21B106KOQNNNE | CL21B106KOQNNNE | CL21B106KOQNNNE | Meshcore:C_0805_2012Metric__V2_C52 | Meshcore:C_0805_2012Metric | yes | yes | yes | converter | C52 | https://www.danomsk.ru/shop/5-kondensatory/89-kondensatory-keramicheskie/732-kondensatory-smd-0805/194763-chip-kond-0805-x7r-10uf-10-16v-cl21b106koqnnne-cc080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 |  |  |  |  |  |  | Inherited S4.16 procurement data; current stock not rechecked |  |  |  |  |  |  | Second populated10uF16V0805 local input bypass, exactsamepartasC12. C53 remains DNP reserve. DC-bias engineering budget; qualify actual capacitance.
POWER | C53 | C | 1 | DNP | no | DNP | no | DNP | no |  |  |  | Meshcore:C_1206_3216Metric__V2_C53 | Meshcore:C_1206_3216Metric | no | no | no | converter | C53 |  |  |  |  |  |  |  | Inherited S4.16 procurement data; current stock not rechecked |  |  |  |  |  |  | DNP reserve 1206 capacitor site directly in parallel with C12, BAT to GND. Capacitance and MPN are not selected; populate only after TPS63802 input transient qualification.
POWER | C54 | C | 1 | DNP | no | DNP | no | DNP | no |  |  |  | Meshcore:C_1206_3216Metric__V2_C54 | Meshcore:C_1206_3216Metric | no | no | no | converter | C54 |  |  |  |  |  |  |  | Inherited S4.16 procurement data; current stock not rechecked |  |  |  |  |  |  | DNP reserve 1206 capacitor site directly in parallel with C14, SYS_PRE to GND before L3. Capacitance and MPN are not selected; populate only after TPS63802 output stability qualification.
POWER | C55 | C | 1 | DNP | no | DNP | no | DNP | no |  |  |  | Meshcore:C_1206_3216Metric__V2_C55 | Meshcore:C_1206_3216Metric | no | no | no | converter | C55 |  |  |  |  |  |  |  | Inherited S4.16 procurement data; current stock not rechecked |  |  |  |  |  |  | DNP reserve 1206 capacitor site directly in parallel with C14, SYS_PRE to GND before L3. Capacitance and MPN are not selected; populate only after TPS63802 output stability qualification.
POWER | R13 | R | 1 | 56k 0.1% | yes | 56k 0.1% | yes | 56k 0.1% | yes | RNCF0805BKE56K0 | RNCF0805BKE56K0 | RNCF0805BKE56K0 | Meshcore:R_0805_2012Metric__V2_R13 | Meshcore:R_0805_2012Metric | yes | yes | yes | converter | R13 |  |  |  |  |  |  |  | Inherited S4.16 procurement data; current stock not rechecked
POWER | R14 | R | 1 | 10k 0.1% | yes | 10k 0.1% | yes | 10k 0.1% | yes | RT0805BRE0710KL | RT0805BRE0710KL | RT0805BRE0710KL | Meshcore:R_0805_2012Metric__V2_R14 | Meshcore:R_0805_2012Metric | yes | yes | yes | converter | R14 | https://www.danomsk.ru/shop/6-rezistory/86-rezistory-postoyannye/268-rezistory-chip-0805/145796-chip-0805-10-0k-0-1-50ppm-c-rt0805bre0710kl-tonkoplenochnyy-ya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 |  |  |  |  |  |  | Inherited S4.16 procurement data; current stock not rechecked |  |  |  |  |  |  | Danomsk S4.6 approved substitution. Предлагается только для R8 (MPPT) и R14 (обратная связь TPS). Те же 10 кОм/0.1%/0805, TCR ±50 вместо ±25 ppm/°C. При ΔT=65°C расчёт PWM-выхода 3.248…3.358 В вместо 3.252…3.354 В. Вклад допусков и TCR резисторов в MPPT при фиксированном Vref: 11.885…12.035 В; сам Vref/панель сюда не включены. R4 в зарядном делителе сохраняется ±25 ppm/°C: запас до 4.0 В мал.
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
