Alksndr55/mesh-repeater-2.0/audit/V2_ENGINEERING_AUDIT_A3_2026_10_13/SOFTWARE_BOM_Heltec_T114_page1.png

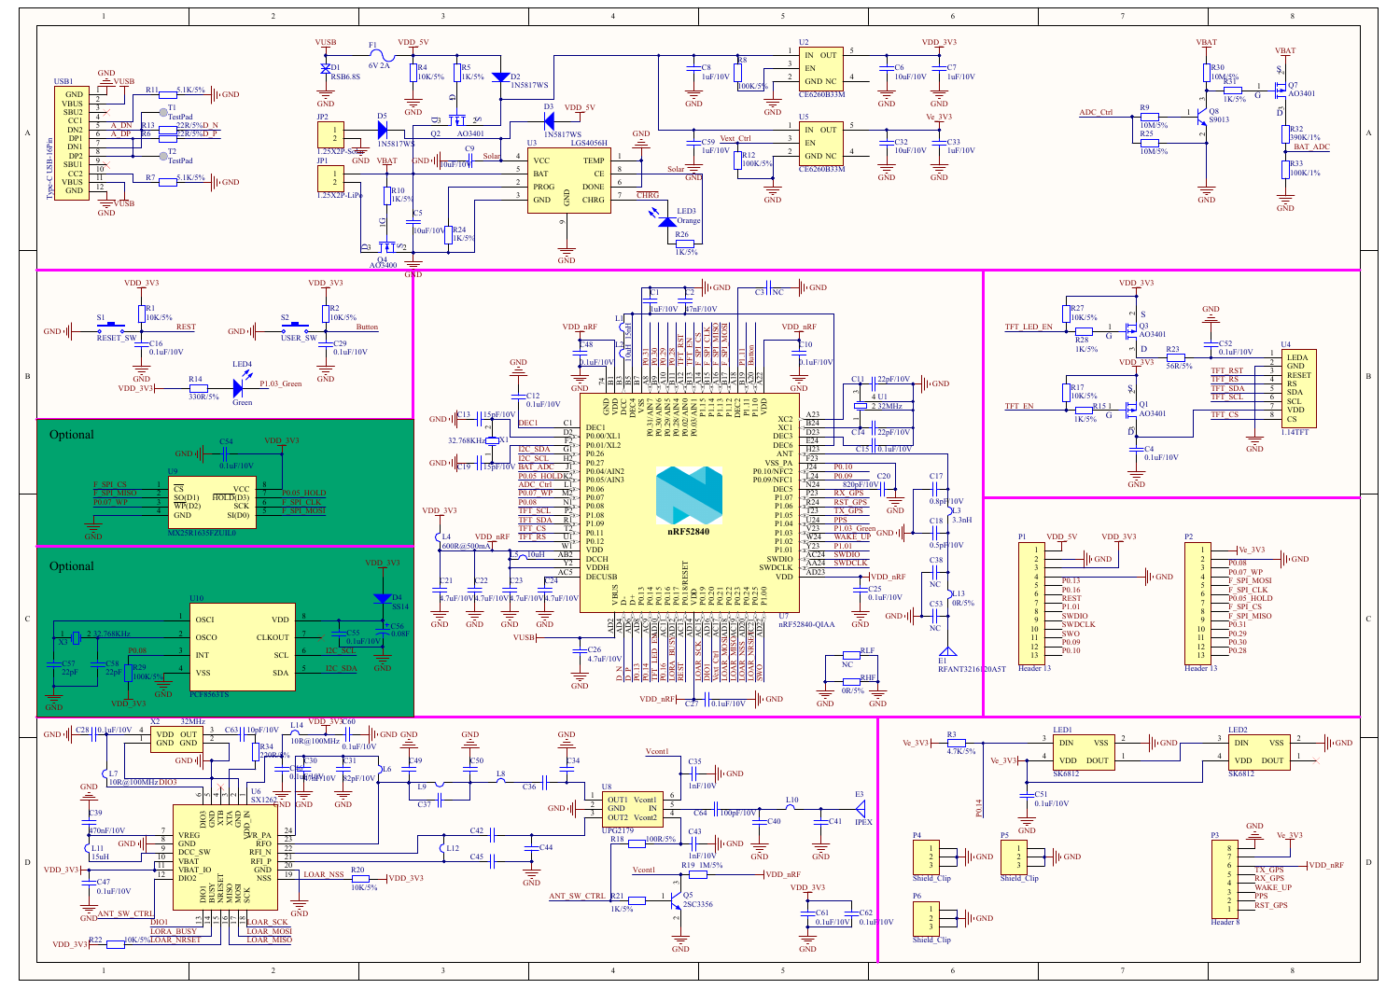
audit/V2_ENGINEERING_AUDIT_A3_2026_10_13/SOFTWARE_BOM_Heltec_T114_page1.png
