Alksndr55/mesh-repeater-2.0/docs/mechanics/MeshRepeater2_assembly.FCStd

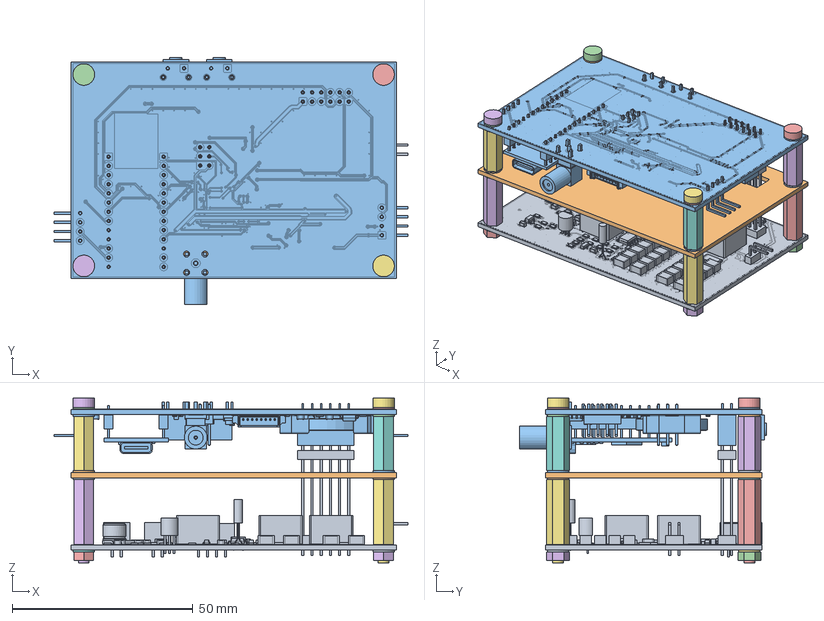
[picture p61: CAD file, 2026-10-13]
docs/mechanics/MeshRepeater2_assembly.FCStd
98.0 x 68.5 x 45.6 mm
POWER_native_PCB_export
SHIELD_native_PCB_export
LOGIC_native_PCB_export
Lower18mm_standoff_1_outer_envelope
Upper15mm_standoff_1_outer_envelope
Metal_DIN433_washer_1_1
Metal_DIN433_washer_1_2
Metal_DIN433_washer_1_3
Metal_DIN433_washer_1_4
Metal_DIN433_washer_1_5
M3_lower_nut_1
M3x6_top_screw_1_envelope
Lower18mm_standoff_2_outer_envelope
Upper15mm_standoff_2_outer_envelope
Metal_DIN433_washer_2_1
Metal_DIN433_washer_2_2
Metal_DIN433_washer_2_3
Metal_DIN433_washer_2_4
Metal_DIN433_washer_2_5
M3_lower_nut_2
M3x6_top_screw_2_envelope
Lower18mm_standoff_3_outer_envelope
Upper15mm_standoff_3_outer_envelope
Metal_DIN433_washer_3_1
Metal_DIN433_washer_3_2
Metal_DIN433_washer_3_3
Metal_DIN433_washer_3_4
Metal_DIN433_washer_3_5
M3_lower_nut_3
M3x6_top_screw_3_envelope
Lower18mm_standoff_4_outer_envelope
Upper15mm_standoff_4_outer_envelope
Metal_DIN433_washer_4_1
Metal_DIN433_washer_4_2
Metal_DIN433_washer_4_3
Metal_DIN433_washer_4_4
Metal_DIN433_washer_4_5
M3_lower_nut_4
M3x6_top_screw_4_envelope
