Alksndr55/mesh-repeater-2.0/output/SHIELD/MeshRepeater2_Shield.step

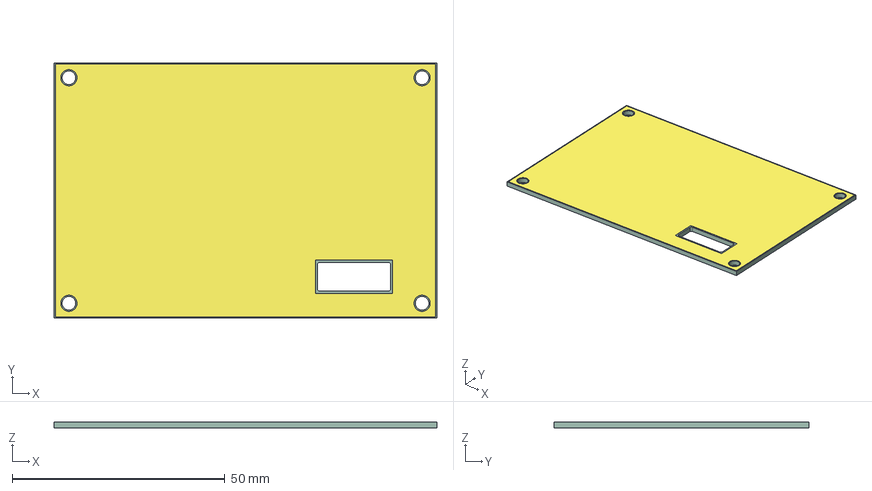
[picture p63: CAD file, 2026-10-13]
output/SHIELD/MeshRepeater2_Shield.step
90.0 x 60.0 x 1.51 mm
MeshRepeater2_Shield_copper
MeshRepeater2_Shield_PCB
