Alksndr55/mesh-repeater-2.0/docs/V2_ASSEMBLY_INSTRUCTIONS_RU.md

# Mesh Repeater 2.0 — сборка, подключение и обслуживание

Редакция: **V2.0-A5, 22 октября 2026 года**. Электрическое содержание сохранено относительно A4; исправлены дорожки и мешавшие им земляные переходы. Маркировка всех трёх плат сохраняет минимальный размер шрифта 1×1 мм и штрих 0,15 мм. [Изменения A5](V2_A5_RELEASE_RU.md), [актуальный обзор CAD](../output/V2_OVERVIEW_RU.html). Инструкция описывает сохранённые узлы S4.16, измеритель аккумуляторного тока, прямое вертикальное соединение двух плат и звезду SYS/RADIO после единственной J11 на POWER. Статус стендовых проверок указан в [V2_LIMITATIONS_RU.md](V2_LIMITATIONS_RU.md). Результаты CAD действуют только для сохранённых файлов соответствующей редакции и их контрольных сумм. [Лицензия и разрешение на личный заказ](LICENSING_RU_EN.md).

Опубликованный снимок A3 прошёл CAD-проверки: схемный граф 81/81, соответствие PCB/model/XML 57/57, независимая проверка CAD 110/110; DRC трёх плат и ERC двух схем — 0. [Итоговая сводка A3](https://github.com/Alksndr55/mesh-repeater-2.0/blob/v2.0-a3/audit/a3_2026_10_13/A3_FINAL_CHECKS.json) связывает эти проверки с исходниками именно того снимка. Текущие [проверки A5](../audit/routing_cleanup_2026_10_22/after/native_summary.json): DRC POWER, LOGIC и SHIELD — 0 нарушений и 0 неразведённых цепей; ERC POWER/LOGIC — 0; расхождения со схемой — 0. Для механического SHIELD соответствие электросхеме неприменимо. Производственные файлы A5 ещё не переизданы; стендовая проверка собранного устройства остаётся отдельным этапом.

## Исходная редакция и файлы

- База 1.0: [коммит S4.16](https://github.com/Alksndr55/mesh-repeater/commit/cf54f9970e716272d477afdb252b4e195d595cb6), SHA `cf54f9970e716272d477afdb252b4e195d595cb6`.
- Зафиксированный тег: [v1.0](https://github.com/Alksndr55/mesh-repeater/tree/v1.0); [релиз 1.0](https://github.com/Alksndr55/mesh-repeater/releases/tag/v1.0). Тег указывает на тот же исходный коммит.
- Самостоятельный репозиторий: [Alksndr55/mesh-repeater-2.0](https://github.com/Alksndr55/mesh-repeater-2.0), основная ветка `main`. Рабочие проекты: `design/MeshRepeater2_Power` и `design/MeshRepeater2_Logic`.
- Состав оригинальных компонентов и вариантов: `baseline/S4_16/assembly_variants_S4_16.csv`. Перенесённые связи: `design/v2_electrical_contract.json`; актуальное межплатное соединение: `design/interboard_cable.json`, карта контактов: `docs/interboard_connections.csv`, явные новые цепи A2: `design/feature_ina219_vertical.json`; изменения A3: `design/feature_a3_single_face_split_power.json`.

## Конструкция и ориентация

Все три элемента имеют внешние размеры 90×60 мм. Две рабочие платы — двухслойные, с сохранением материала и меди исходного проекта. Заказная толщина фольгированного материала — 1,5 мм; CAD-стек рабочих плат с маской — 1,52 мм. Средний экран — отдельный односторонний фольгированный стеклотекстолит с одной связной плоскостью GND и одним фрезерованным окном для штырей и общей пластиковой планки межплатного разъёма.

Порядок снизу вверх:

1. POWER, силовая плата: все компоненты находятся на F.Cu и направлены вверх к экрану.
2. Промежуточный экран: без функциональных электронных узлов. По сохранённому `docs/mechanical_selection.json` медная сторона направлена вниз к POWER.
3. LOGIC, процессор и модем: основные компоненты направлены вниз к экрану, наружная верхняя поверхность содержит операторские надписи.

В KiCad основные компоненты обеих плат находятся на F.Cu. В сборке верхнюю плату целиком поворачивают на 180° вокруг X. Отдельно переносить все её компоненты на B.Cu не требуется. Наружные верхние подписи LOGIC находятся на B.SilkS. Для проверки оператора и подключения разъёмов используют собранный и разнесённый виды, учитывающие этот поворот.

Крепёжные центры рабочих плат: `(3,5;3,5)`, `(86,5;3,5)`, `(3,5;56,5)`, `(86,5;56,5)` мм. Контактные площадки крепления соединены с GND и открыты для контакта со стойками/шайбами. Рабочее питание и возврат GND проходят по контактам J101/J201; проводимость винтов и стоек не требуется для работы электрических узлов.

Рамка SH1 и её прежняя крышка в 2.0 удалены по результату независимой размерной проверки. Это явное механическое изменение относительно S4.16: рамку не закупают и не устанавливают. Её консервативный контур нельзя было уменьшать до стенки, поскольку он должен учитывать настоящие паяльные площадки. Средний сплошной экран, контакты GND стоек и полноценный возврат через контакты J101/J201 сохранены; удаление боковых стенок не подтверждает прежний уровень EMI без измерений. Решение и размеры альтернатив записаны в `audit/v2_frame_mount_review.json`.

Сохранённые механические позиции на 11 октября 2026 года:

| Промежуток | Стойка | Номинальная длина тела | Количество |
|---|---|---|---|
| POWER ↔ экран | RUICHI PCHSN-18, ДАН 206757, латунь, M3, наружная/внутренняя резьба | 18 мм | 4 |
| Экран ↔ LOGIC | Connfly H-L1500-2100-5-03-1N1W / PCHSN-15, ДАН 188548, медный сплав с никелевым покрытием, M3, наружная/внутренняя резьба | 15 мм | 4 |

По сохранённому крепёжному стеку в `mechanical_selection.json` применяются металлические шайбы DIN 433 размером 3,2×6×0,5 мм: пять на угол, всего 20. Номинальный свободный промежуток от поверхности POWER до экрана — 18,5 мм, от экрана до поверхности компонентов LOGIC — 16,0 мм. Для TH1 с ограничением сформованной высоты 12,5 мм нижний запас составляет 6,0 мм. Между наружными поверхностями двух рабочих плат номинально 39,06 мм; головка верхнего винта и нижняя гайка в этот размер не входят.

Между рабочими поверхностями POWER и LOGIC номинально 36,02 мм. Розетка высотой 8,5 мм и штырь с кончиком на 32 мм над POWER дают номинальный ввод 4,48 мм. Длинная вилка содержит два пластиковых разделителя; её высота 32 мм не означает сплошной корпус такой высоты. Шлейф и ответные IDC отсутствуют. В сохранённой механической модели A3, используемой и в A4, три проверки попарных пересечений плат/экрана дали объём 0 мм³, все восемь проверок зазоров до крепежа пройдены. Окончательные габариты, входные хеши и границы модели находятся в [assembly_geometry_report.json](mechanics/assembly_geometry_report.json); прежние размерные PDF A1 и числа предыдущих экспортов относятся к истории.

Это размерная цепочка номиналов, а не измерение готового изделия. У верхней Connfly глубина используемой внутренней резьбы не указана; у RUICHI часть размеров семейного чертежа приблизительная. Перед затяжкой измеряют фактические стойки, винты и шайбы. Требуются фактическое зацепление верхних соединений не менее 3 мм, полное зацепление нижней гайки, прижим слоёв без упора шпильки или винта в дно резьбы.

## Выбор варианта сборки

Выбирайте один вариант и используйте целиком его колонки Fit/Value/MPN. Зачёркивания или нативный DNP схемы не заменяют таблицу монтажа: в исходном проекте зачёркивания убраны по указанию пользователя.

| Позиция или узел | Na-ion 1S + COLD | Na-ion 1S без COLD | LTO 2S |
|---|---|---|---|
| Аккумуляторный разъём | J8: 1 BAT+, 2 GND | J8: 1 BAT+, 2 GND | J12: 1 PACK+, 2 MID, 3 PACK−; 4 NC |
| R1, шунт тока зарядника | 0,28 Ом, 1% | 0,28 Ом, 1% | 0,28 Ом, 1% |
| R71, измерительный шунт INA219 | 0,1 Ом, 1%, 1 Вт | 0,1 Ом, 1%, 1 Вт | 0,1 Ом, 1%, 1 Вт |
| U12 / R72–R73 / C63–C64 | Установить | Установить | Установить |
| R3, верхнее плечо FB CN3722 | 61,9 кОм, 0,1%, ≤25 ppm/°C | 61,9 кОм, 0,1%, ≤25 ppm/°C | 121 кОм, 0,1%, ≤25 ppm/°C |
| R4, нижнее плечо FB CN3722 | 100 кОм, 0,1%, ≤25 ppm/°C | 100 кОм, 0,1%, ≤25 ppm/°C | 100 кОм, 0,1%, ≤25 ppm/°C |
| C30 | 12 пФ C0G, 50 В | 12 пФ C0G, 50 В | 6,8 пФ C0G, 50 В |
| R15, верхнее плечо EN TPS63802 | 40,2 кОм, 0,1% | 40,2 кОм, 0,1% | 130 кОм, 0,1% |
| R16, нижнее плечо EN | 49,9 кОм, 0,1% | 49,9 кОм, 0,1% | 49,9 кОм, 0,1% |
| R27/R28, измерение BAT | Оба 2,2 МОм, 0,1% | Оба 2,2 МОм, 0,1% | Оба 2,2 МОм, 0,1% |
| C25, RC ADC | 100 нФ | 100 нФ | 100 нФ |
| R56 | 1,8 Ом, 1%, 1 Вт, 2512 | 0 Ом, перемычка 2512 | 0 Ом, перемычка 2512 |
| Остальной COLD-узел | Установить | Не устанавливать | Не устанавливать |
| R47–R54, U8/U9, C58/C59, J12 | Не устанавливать | Не устанавливать | Установить |
| R47 и R51 в балансире | Не устанавливать | Не устанавливать | 2 Ом, 1%; не изменять номинал |
| Делитель каждого балансира | Не устанавливать | Не устанавливать | 120 кОм + 2,49 кОм / 100 кОм, 0,1% |

«Остальной COLD-узел» означает Q4/Q5/Q6/Q7, U10/U11, R57–R70, C60/C61/C62 и TH1. R56 устанавливается во всех трёх вариантах, но в двух вариантах обхода он имеет номинал 0 Ом. R1 остаётся 0,28 Ом. В A4 позиции R1, R56, R55, R71 и R40/R41 имеют корпус 2512; сопротивления сохранены. Для четырёх Vishay WSL2512 применены их рекомендованные площадки 1,65×3,68 мм с шагом 5,71 мм, для R56/R71 — стандартные посадки выбранных Yageo. R47/R51 балансира сохраняют 2 Ом / 0805. Резисторы, посадочные места или перемычки не заменяются медным коротким замыканием без отдельного изменения конструкции.

### Как читать маркировку компонентов

Подпись содержит позиционное обозначение компонента и его номинал. Если номинал зависит от химии аккумулятора, на плате приведены две строки:

- **N** — номинал для **Na-ion 1S**.
- **L** — номинал для **LTO 2S**.

На одну позицию устанавливают **один компонент** выбранного номинала. Две строки не означают установку двух компонентов или их параллельное соединение. Буква **L** не обозначает Na-ion без COLD: этот вариант выбирают по отдельной колонке таблицы сборки и BOM.

Примеры фактических подписей POWER:

| Позиция | Надпись на плате | Что установить |
|---|---|---|
| C30 | `N12p` / `L6.8p` | Na-ion: 12 пФ; LTO: 6,8 пФ |
| R3 | `N61k9` / `L121k` | Na-ion: 61,9 кОм; LTO: 121 кОм |
| R15 | `N40k2` / `L130k` | Na-ion: 40,2 кОм; LTO: 130 кОм |
| R55 | `47mR` | 47 мОм = 0,047 Ом во всех вариантах |
| R40 / R41 | `22mR` | 22 мОм = 0,022 Ом во всех вариантах |
| L3 / L4 | `2.4u` | Индуктивность 2,4 мкГн во всех вариантах |
| R56 | `N1R8` / `L0R` | 1,8 Ом для Na-ion с COLD; 0 Ом для Na-ion без COLD и для LTO |

Сокращения единиц:

| Компонент | Обозначение | Единица |
|---|---|---|
| Резистор | `R`, `k`, `M`, `mR` | Ом, кОм, МОм, мОм соответственно |
| Конденсатор | `p`, `n`, `u` | пФ, нФ, мкФ соответственно |
| Дроссель | `u` | мкГн |

Буква внутри числа заменяет десятичный разделитель: `61k9` означает 61,9 кОм, `1R8` — 1,8 Ом. Точка тоже является десятичным разделителем: `6.8p` — 6,8 пФ. Значение `0R` означает резистор-перемычку 0 Ом в предусмотренном корпусе.

У C30, R3 и R15 значения **N** одинаковы для Na-ion с COLD и без COLD. У **R56** строка **N1R8** относится к Na-ion **с COLD**: для Na-ion **без COLD** устанавливают **0 Ом**, несмотря на эту строку. Для остальных позиций проверяйте выбранную колонку таблицы: краткая маркировка не заменяет правила Fit/DNP, допустимое напряжение, мощность, точность и конкретный MPN из BOM. Блоки BAL1/BAL2 устанавливают только для LTO; блок COLD — только в варианте Na-ion с COLD.

У каждого компонента POWER оставлена одна подпись: на стороне компонентов, где есть место, либо на обратной стороне под корпусом. На лицевой стороне подписи L1/L3/L4, R1/R40/R41/R55/R71 и U1/U10/U12 находятся внутри контура собственного корпуса. Они видны до установки детали, после монтажа закрываются ею; это освобождает место для соседних подписей. У L2 площадки занимают доступную область, а полная трёхстрочная подпись R56 не помещается под корпусом: их обозначения сохранены рядом или сзади. Для J7/J8 обозначение объединено с распиновкой. Конденсаторы фильтра подписаны двумя группами: **C15, C34–C42 — 10×100 мкФ** и **C16, C43–C51 — 10×100 мкФ**. Это номинал каждого конденсатора, десять деталей в каждом банке; суммарная номинальная ёмкость банка — 1000 мкФ. Индивидуальные повторные подписи этих конденсаторов убраны. Точные позиции для монтажа и ремонта определяют по схеме и посадочным местам KiCad.

Подписи разъёмов POWER J7/J8/J12/J101/J11 объединены с распиновкой и размещены горизонтально над контактами на обратной стороне. У J7/J8/J12 верхняя строка выровнена в один ряд; разъёмы доходят до края платы, поэтому маркировка находится внутри проекции их корпусов. Все пять подписей имеют одинаковый шрифт 0,8 мм и толщину штриха 0,12 мм. Дублирование названия J12 на лицевой стороне убрано. Подпись `U2 TPS63802` повернута на 90° относительно прежнего текста и записана одной строкой; положение самой микросхемы сохранено.

На LOGIC все 56 компонентов имеют по одной подписи; 28 повторных подписей удалены. M1/M2 и держатель BT1 подписаны на стороне компонентов внутри собственных корпусов; эти надписи закрываются после монтажа. Текст Q2/Q3 и U4/U6 ориентирован по вертикальной оси корпуса, M2 и BT1 — горизонтально. Конденсаторы LOGIC сохраняют индивидуальные подписи: это отдельные развязывающие элементы. Все разъёмы подписаны горизонтально шрифтом 0,8 мм / 0,12 мм. Карты J3/J4/J10/J201 размещены над контактами; у UART и SMA цифровые карты сохранены отдельно рядом, поскольку полный блок над корпусом перекрывал бы сквозные площадки. Замкнутая рамка RF вокруг FL1/NT1 совпадает с двух сторон, имеет толщину 0,30 мм и жирный заголовок. Окно разрезания NT1, защитная маска и радиотракт сохранены.

Позиции и номиналы читают по ориентации собственной детали. Обратная маркировка находится под корпусом либо в области своего банка конденсаторов. Контуры BAL1/BAL2/COLD нанесены одинаково в физических координатах с двух сторон, линией 0,30 мм и с жирными заголовками. Уступ BAL1 обходит C8; узкая верхняя часть COLD B обходит L1 и не включает обязательный R56. Разрывы оставлены у площадок и соседних подписей; короткие остатки менее 0,75 мм удалены. Однострочные вертикальные подписи `R58 100k` и `C61 1n` освобождают длинные боковые границы COLD B. Масштабированных групп Gxx нет. Тестовые площадки сверху идут слева направо: TP6 — GND, TP9 — SOLAR, TP1 — BAT; шаг ряда 11 мм. На POWER светодиоды D3/D4 находятся за J101, INA219 — рядом с батарейной цепью.

Расчётные значения перенесены из S4.16: Na-ion CV около 3,915 В; LTO CV около 5,345 В. Для LTO расчётный верхний угол делителя около 5,444 В с исходными допусками REF, тока входа, резисторов и ТКС. Это расчёт установившегося режима, а не гарантия переходных процессов или защиты при отказе.

Типовые пороги EN: Na-ion отключение около 1,806 В и включение около 1,986 В; LTO отключение около 3,605 В и включение около 3,966 В. Допуски TPS63802, резисторов и ток входа меняют реальные пороги.

В вариантах без COLD расчётный основной ток заряда около 714 мА, верхний угол исходной оценки около 784 мА. Для установленного COLD исходная оценка: около 96 мА в холодном состоянии и около 665 мА при открытых параллельных MOSFET; фактические токи и температурные границы измеряются на образце.

TH1 допускает один NTC в посадочном месте либо один удалённый датчик на тех же электрических точках. Два датчика параллельно не устанавливают. Датчик на POWER у экрана измеряет местную температуру; она не равна автоматически температуре аккумулятора.

Общий фильтр не меняется между вариантами: TPS63802/SYS_PRE → R55=47 мОм → L3=2,4 мкГн → FILTER_MID → L4=2,4 мкГн → FILTER_OUT → J11 на POWER → медная звезда NT2. От неё SYS_3V3 идёт через контакты 1/3 к Nice!Nano и периферии, RADIO_3V3 — через контакты 5/7 к FB1 и модему. Выход FB1 / M2 / C23 / C24 называется RADIO_LOCAL_3V3. Каждый из двух банков содержит десять конденсаторов по 100 мкФ, подключённых к GND через свой R40/R41=22 мОм. Требование эффективной ёмкости каждого банка ≥330 мкФ при 3,3 В остаётся квалификацией образца. RTC питается от SYS_3V3 и резервной CR2032; сигнал RTC alarm не подключается.

## Межплатные разъёмы и INA219

На POWER устанавливается **E-SIMPO L35mm A3C6 / 2x6P**, на LOGIC — **MTJ H8.5 / 2X6P**, шаг 2,54 мм. Полная длина металлического штыря — 35 мм, хвост под пайку — 3 мм, кончик над POWER — 32 мм. При расстоянии между рабочими поверхностями 36,02 мм номинальный ввод в розетку составляет 4,48 мм; зазор между верхним пластиковым разделителем и розеткой — 1,52 мм. Штыри не подрезают. Допустимое сечение ответного штыря, его прямолинейность и предельная глубина сопряжения этой общей серии не документированы — проверьте приобретённую пару на образце.

Для J201 предусмотрена **зеркальная локальная сетка площадок**. После поворота всей LOGIC на 180° вокруг X контакты напрямую совпадают 1:1. Обычная незеркальная посадка розетки, разворот только одного разъёма или замена шлейфом по прежней карте меняют соединение. Ориентируйтесь по отметке первого контакта каждой платы.

| Контакты J101 ↔ J201 | Назначение |
|---|---|
| 1 / 3 | SYS_3V3, Nice!Nano, периферия и INA219 |
| 5 / 7 | RADIO_3V3, отдельная ветвь к FB1 и модему |
| 2 / 4 / 6 | GND, рабочие возвраты |
| 8 | NC, физический контакт без электрического подключения |
| 9 | BAT, измерительный отвод от аккумулятора до R71 |
| 10 | SDA, существующая шина M1.15 |
| 11 | MODE, прежнее управление TPS63802 от модема |
| 12 | SCL, существующая шина M1.16 |

U12 **INA219AIDR в SOIC-8** установлен на POWER. A0/A1 соединены с GND, адрес I²C — **0x40**. Для него сохраняются имеющиеся GPIO SDA/SCL; R72/R73 по 10 Ом и C64=100 нФ образуют дифференциальный входной фильтр, C63=100 нФ блокирует питание.

Шунт **R71=0,1 Ом** включён между **BAT** у аккумуляторных разъёмов и **BAT_SYS** зарядника/преобразователя. Kelvin-отводы берут с внутренних краёв его площадок. R71 отличается от зарядного R1=0,28 Ом; медной перемычки в обход R71 нет. IN+ измеряет сторону BAT_SYS, IN− — BAT: положительный ток означает заряд, отрицательный — разряд. При 0,8 А падение на R71 составляет 80 мВ, при 1,25 А — 125 мВ; фактическую калибровку и показания прошивки проверяют на образце. Балансир LTO, делитель EN и измерительный делитель напряжения остаются непосредственно на батарейной стороне; их токи не входят полностью в измерение главного шунта.

В A4 INA219 и C63 питаются от SYS_3V3 непосредственно после J11 на POWER. Контакты 1/3 при USB возвращают SYS_3V3 с LOGIC к INA219 и медной звезде NT2; от NT2 через контакты 5/7 питается модем. При снятой J11 FILTER_OUT изолирован от обоих именованных ответвлений. Поэтому INA219 и модем питаются и при обслуживании через USB; способность LDO клона питать весь состав нагрузок проверяют на образце. В штатном непрерывном режиме INA219 потребляет около 0,7 мА типично, до 1 мА по паспорту; режим сна и доработка прошивки в этой редакции не вводятся.

## Кабельные части J3 / I²C и J5 / UART

Для полного комплекта внешних кабелей закупите в ДАН **два корпуса Connfly I-DS1071-SCB01x4** (артикул 208362) и **восемь гнездовых контактов T-DS1071-SC600** (артикул 201995). На каждый разъём нужен один корпус и четыре контакта. Комплект применяется ко всем трём вариантам аккумулятора. Для пяти полных сборок нужны 10 корпусов и 40 контактов без технологического запаса. Кабельные детали перечислены отдельно в `bom/DAN_NEW_PARTS.csv`.

Официальный чертёж [Connfly DS1071](https://en.connfly.com/static/upload/file/pdf/DS1071.pdf) указывает DS1021/DS1022 как ответные вилки: это одна совместимая серия со штырём 0,64 мм и шагом 2,54 мм. Корпус 1×4 имеет номинальные размеры **10,16×2,54×14,00 мм**, с общим допуском ±0,25 мм. Провода для T-DS1071-SC600: медь AWG28–22 / 0,09–0,30 мм², диаметр изоляции 1,2–1,6 мм. Матрицу обжима подбирают для этих контактов; проверяют удержание каждого контакта в корпусе.

| Контакт платы и кабельного корпуса | J3 / I²C | J5 / UART |
|---|---|---|
| 1 | SYS_3V3 | GND |
| 2 | GND | SYS_3V3 |
| 3 | SCL | UART_TX, выход MCU |
| 4 | SDA | UART_RX, вход MCU |

Розетки без ключа: пометьте первый контакт обоих корпусов и проверьте нумерацию мультиметром относительно контактов платы до первого включения. J3 и J5 имеют различный порядок питания; одинаковый корпус не делает кабели взаимозаменяемыми. UART_TX платы подключают к RX внешнего устройства, UART_RX платы — к его TX.

Разъёмы входят горизонтально с внешних боковых краёв собранного LOGIC. Размерная модель `docs/mechanics/Connfly_DS1071_SCB01x4_Mated_Envelope.step` учитывает максимальный наружный габарит корпуса **10,41×2,79×14,25 мм** по допускам. Для прямого снятия предусмотрите по внешней стороне минимум **7 мм** свободного хода сверх установленного корпуса. Модель является оценкой наружного контура: точный упор, глубина посадки, инструмент обжима и удержание реального кабеля проверяются на образце.

## Проверка перед механической сборкой

1. Сверьте обе платы и экран по обозначению Mesh Repeater 2.0 и одной редакции. Не используйте комплект схемы одной редакции с платой другой.
2. Проверьте установленный вариант по таблице, особенно R3/R4/C30, R15/R16, R56 и детали балансира.
3. Подтвердите полярность CR2032 в BT1, электролитического C8, диодов и силовых разъёмов. CR2032 не заряжается схемой.
4. Проверьте Nice!Nano-клон: для этой конструкции предусмотрено прямое питание его 3V3/VCC и аппаратное отключение штатной аккумуляторной USB-зарядки. Основной аккумулятор не подключают к RAW/BAT модуля. У конкретного клона эти изменения и режим USB проверяют отдельно.
5. Подтвердите подключение ANT установленного HT-RA62 к площадке модуля для J13/SMA. Сведения S4.16 о внутреннем R1=0 Ом и снятом R2 ветви IPEX относятся к деталям модема, а не к одноимённым позициям основной платы.
6. Проверьте прямое соединение J101↔J201 по текущей карте всех 12 контактов, включая SYS_3V3, SDA и SCL. Проверьте ориентацию контакта 1 и отсутствие контакта любого штыря с медью экрана. У пары нет подтверждённой защиты от неправильного сопряжения.
7. Проверьте отсутствие обхода J11: при снятой перемычке FILTER_OUT и SYS_3V3 остаются разными сетями. Контакты 1/3 находятся на SYS_3V3 после J11, 5/7 — на RADIO_3V3 от медной звезды NT2. Эти две ветви соединены только в заданной звезде; FILTER_OUT не должен иметь обхода J11. Также проверьте отсутствие медной связи в обход R71 между BAT и BAT_SYS.
8. Подтвердите достаточные зазоры по итоговому размерному сборочному чертежу, особенно сформованного TH1, длинной вилки, розетки и пластиковой планки и штырей в окне экрана. Рамка и крышка SH1 отсутствуют; их прежние размеры 1.0 не используются как доказательство новых зазоров.

## Механическая сборка

1. Отключите солнечную панель, основной аккумулятор и USB. Платы не соединяют и не разъединяют при поданном питании.
2. Подготовьте нижнюю POWER, односторонний экран, LOGIC, четыре стойки PCHSN-18, четыре стойки Connfly 15 мм, четыре металлические гайки M3, четыре винта M3×6 и 20 металлических шайб DIN 433 размером 3,2×6×0,5 мм. Точный крепёжный стек и резьбовое зацепление принимаются по сохранённому файлу механического выбора и чертежу. SH1 не устанавливают.
3. Нижняя стойка непосредственно прижимается к открытой GND-площадке POWER; её шпилька проходит через POWER, одну нижнюю шайбу и удерживающую гайку M3. Проверьте контакт и полное зацепление гайки; рабочий возврат питания всё равно идёт через контакты GND межплатного разъёма.
4. Установите экран медной стороной вниз. Совместите единое фрезерованное окно 17,2×6,8 мм, R0,6, со штырями и пластиковой планкой J101. Пластик должен свободно пройти через окно; двенадцати отдельных отверстий в текущей редакции нет. От окна до меди предусмотрено не менее 0,50 мм. Не допускайте касания штырями кромки фольги; связная плоскость GND сохраняется вокруг окна.
5. Установите по одной металлической шайбе с каждой стороны экрана. Последовательно вкрутите верхние стойки через эти шайбы и экран в нижние стойки. Проверьте фактическую глубину резьбы и прижим; шпилька не должна упираться в дно до прижатия слоя.
6. Поверните LOGIC целиком компонентами вниз. Ровно совместите все штыри J101 с зеркальной розеткой J201 и аккуратно опустите плату; не стягивайте несовпавшие разъёмы винтами. Убедитесь, что верхний пластиковый разделитель не упирается в розетку. Закрепите LOGIC винтами M3×6, с металлической шайбой с каждой стороны. Проверьте зацепление резьбы, отсутствие упора в дно, доступ к боковым USB, GPS, I²C/UART, кнопкам, J11 и SMA.
7. Проверьте действительный ввод штырей в розетку, зазор до обоих пластиковых разделителей и отсутствие касания каждого штыря меди экрана при полностью закреплённых платах. Номинальный ввод 4,48 мм не заменяет проверку пределов сопряжения приобретённой пары. Межплатный шлейф, ответные IDC и полуповорот ленты не используются.
8. D3/D4 размещены за межплатным разъёмом J101 на POWER; их подписи должны соответствовать реальным позициям. LED и их электрические цепи на LOGIC не дублируются. Работу индикации проверяют до закрытия сборки.

Первое включение и измерения выполняются только после проверки монтажа и механики. Электрическая работоспособность должна сохраняться без проводимости крепежа; заземлённый экран влияет на экранирование, а не заменяет контакты рабочего возврата GND.

## Подключения

| Интерфейс | Контакт | Назначение |
|---|---|---|
| J7 SOLAR | 1 / 2 | SOLAR+ / GND |
| J8 Na-ion | 1 / 2 | BAT+ / GND |
| J12 LTO | 1 / 2 / 3 / 4 | PACK+ / середина двух ячеек / PACK− / NC |
| J3 I²C | 1 / 2 / 3 / 4 | SYS_3V3 / GND / SCL / SDA |
| J5 UART | 1 / 2 / 3 / 4 | GND / SYS_3V3 / UART_TX / UART_RX |
| J4 GPS | 1 / 2 / 3 | RESET_N / PPS / WAKE_UP — не подключены |
| J4 GPS | 4 | GPS_RX_EXT, линия приёма MCU через U7 |
| J4 GPS | 5 | GPS_TX_EXT, линия передачи MCU через U7 |
| J4 GPS | 6 | SYS_3V3, резервное питание GPS |
| J4 GPS | 7 | GPS_3V3, включаемое основное питание |
| J4 GPS | 8 и монтажные площадки | GND |
| J10 ISP | 1 / 2 / 3 / 4 / 5 / 6 | MISO / SYS_3V3 / SCK / MOSI / RESET / GND |
| J11 / POWER | 1 / 2 | LC FILTER_OUT / SYS_3V3 и медная звезда NT2 |

J4 сохраняет электрический порядок GPS Heltec T114 V2.1 и горизонтальный PicoBlade на восемь контактов с шагом 1,25 мм. P0.24 HIGH включает J4.7 через исходный ключ; LOW или неопределённый вход отключает основное питание. J4.6 остаётся связанным с SYS_3V3. Ответный кабель проверяют по реальной нумерации обоих концов.

Для панели сохранён вход класса 12 В. Конкретные Vmp/Voc и холодный Voc должны соответствовать принятой входной цепи; в исходном проекте рассматривалось ограничение Voc ≤24 В. Подключение по одной надписи «12 В» без данных панели не подтверждает её совместимость.

## J11 и USB

1. Для штатной работы от батареи/солнца установите шунт J11 при отключённом USB.
2. Перед подключением USB снимите единственный шунт J11 с бокового углового соединителя на POWER, напротив L4 фильтра.
3. Подключите USB для питания SYS_3V3 через доработанный Nice!Nano-клон и/или прошивки MCU. Модем также получает питание через звезду NT2 и отдельную RADIO-ветвь; выход TPS63802 изолирован снятой J11. Убедитесь, что кабель не блокирует кнопки или соседние разъёмы.
4. Отключите USB.
5. Только после отключения USB верните шунт J11 для питания от нижней силовой платы.

Это ручной порядок разделения источников. Автоматического переключателя питания в сохранённой схеме нет. Нагрузочную способность штатного LDO конкретного Nice!Nano-клона и одновременно подключённых верхних потребителей проверяют на образце.

## Прошивки и программирование watchdog

MCU использует MeshCore FakeTec / ProMicro с сохранёнными портами исходной S4.16. Исходный контракт проверялся относительно MeshCore commit `a366955cb2f67b8e6842d4f00d2b6a554dddd88a`; перенос компонентов между платами не вводит новую распиновку. RADIO_BUSY — P0.29, GPS_EN — P0.24, GPS RX/TX MCU — P0.22/P0.20.

Watchdog U6 получает RADIO_TXEN от модема через R38. При активности входа сбрасывает счётчик. После 1350 номинальных интервалов по 8 с без активности выдаёт примерно секундный LOW-сброс MCU. Номинальное ожидание — около трёх часов. MCU после сброса должен переинициализировать модем. Штатное длительное молчание тоже вызывает такой сброс; алгоритм не изменён.

По уточнению пользователя **J10 сохраняет посадку S4.16; доступ к ISP осуществляется после разборки**. Для записи U6:

1. Отключите внешние источники. Разберите верхний этаж и обеспечьте доступ к J10 и R37.
2. Снимите R37 перед ISP: PB0/MOSI watchdog связан через него со сбросом MCU. Эта операция требует пайки; обычное разъединение готовых этажей — нет.
3. Подключите программатор к J10 с уровнями 3,3 В и проверьте первый контакт. При собственном питании платы отключите питание target на программаторе.
4. Проверьте signature ATtiny13A `1E 90 07`. Запишите сохранённый `design/watchdog_reference/watchdog.hex`; затем установите исходный профиль LFUSE=`0x7B`, HFUSE=`0xFB` и прочитайте fuse обратно.
5. Используйте медленный ISP, соответствующий генератору 128 кГц. В исходном Makefile задан `-B 100` — период около 100 мкс; поддержку этой настройки конкретным программатором проверяют отдельно. RESET/ISP сохраняются, RSTDISBL не программируется.
6. Отключите питание и программатор, верните R37, восстановите сборку и проверьте работу watchdog.

Профиль BOD около 2,7 В относится к SYS_3V3, а не к напряжению основного аккумулятора. Фактические интервалы, короткие TXEN-импульсы, потребление, запись и запуск ещё требуют стендовой проверки.

## Антенный фильтр и обслуживание

Штатно FL1 S869M000S003 не установлен, а NT1 — непрерывная медная связь ANT_RF–ANT_SMA. Для установки фильтра отключите всё питание, разрежьте предусмотренную центральную медь NT1 под FL1, проверьте разделение цепей и установите фильтр. Это отдельная операция с инструментом и пайкой, а не обычное обслуживание межплатного соединения.

Предел сохранённого фильтра — входная мощность +13 dBm, полоса 868–870 МГц; установленный фильтр требует соответствующей настройки мощности передатчика. Доступность единичной покупки и характеристики антенного тракта проверяются отдельно.

| Операция | Доступ |
|---|---|
| USB, USER/RESET, боковые I²C/UART/GPS/SMA | Снаружи окончательной сборки; подтвердить по её чертежу и образцу |
| Снять/вернуть J11 | С края POWER напротив L4; подтвердить достаточное место для руки/инструмента |
| Наблюдать D3 CHARGE и D4 DONE | С бокового края нижней POWER |
| Записать ATtiny через J10 | Разборка верхнего этажа, снятие и возврат R37 |
| Заменить CR2032 | Держатель направлен внутрь; после отключения питания открыть/снять верхний этаж для гарантированного доступа |
| Изменить аккумуляторный вариант | Разборка, монтаж/замена деталей по полной таблице варианта |
| Установить FL1, заменить NTC или компоненты | Разборка и пайка |

При обслуживании сохраняйте выбранный вариант аккумулятора, полярность, ориентацию межплатной пары и порядок J11. Проверяйте локальную маркировку платы и полную таблицу, а не только краткую памятку на экране.
