Alksndr55/mesh-repeater-2.0/v2/docs/ASSEMBLY_RU.md

# Mesh Repeater v2.06 — двухплатное исполнение

POWER/LOGIC по 90×60 мм, между ними SHIELD. Прежняя локальная редакция — A6.
Электрическая часть соответствует ведущей v1.22. Собственная геометрия,
угловые разъёмы, боковые кнопки и крепёж сохраняются.

[Общая сборка](../../docs/ASSEMBLY_COMMON_RU.md) ·
[BOM](../bom/COMPONENT_BOM.csv) · [Механика](MECHANICS_RU.md).

POWER компонентами вверх; LOGIC компонентами вниз после поворота вокруг X
на 180°. Сетка J201 зеркальная; J101/J201 соединены 1:1. Сверять pin 1.

| Контакты J101/J201 | Цепь |
|---|---|
| 1, 3 | SYS_3V3 |
| 5, 7 | RADIO_3V3 |
| 2, 4, 6 | GND |
| 8 | NC |
| 9 | BAT до R71 |
| 10 | SDA |
| 11 | MODE |
| 12 | SCL |

J11 находится на POWER: снять перед USB, вернуть после отключения USB.
SYS/RADIO соединяются в NT2 после J11.
J7: 1 SOLAR/VIN, 2 GND. J8: 1 BAT+, 2 GND. J12: 1 BAT+, 2 MID,
3 GND, 4 NC. J3 I²C: 1 SYS_3V3, 2 GND, 3 SCL, 4 SDA. J5 UART:
1 GND, 2 SYS_3V3, 3 TX платы, 4 RX платы. J10 ISP: 1 MISO, 2 SYS_3V3,
3 SCK, 4 MOSI, 5 RESET, 6 GND. J4 GPS: 1/2/3 NC, 4 RX GPS, 5 TX GPS,
6 резервное SYS_3V3, 7 управляемое GPS_3V3, 8 GND. J13: 1 RF, 2 GND.

Разъёмы должны свободно сопрягаться; не сводить несовпадающие платы винтами.
ISP J10 обслуживается после разборки. Электронные компоненты POWER спереди.
C15/C16 полярные: площадка 1 — плюс, 2 — минус/GND.

Watchdog U6 на LOGIC использует ту же каноническую прошивку v1.00:
PB3/вывод 2 — TXEN через R38 с подтяжкой R39 к GND; PB0/вывод 5 —
MCU_RESET через R37. Для ISP после разборки снять R37 и вернуть после записи;
LFUSE=0x73, HFUSE=0xFB, SCK 100 мкс. C33 развязывает питание;
входной конденсатор 10 нФ на PB3 не установлен.
[Подключение, обновлённый алгоритм и программная проверка](../design/watchdog_reference/INTEGRATION_RU.txt).
