Alksndr55/mesh-repeater-2.0/output/LOGIC/MeshRepeater2_Logic_assembly_top.png

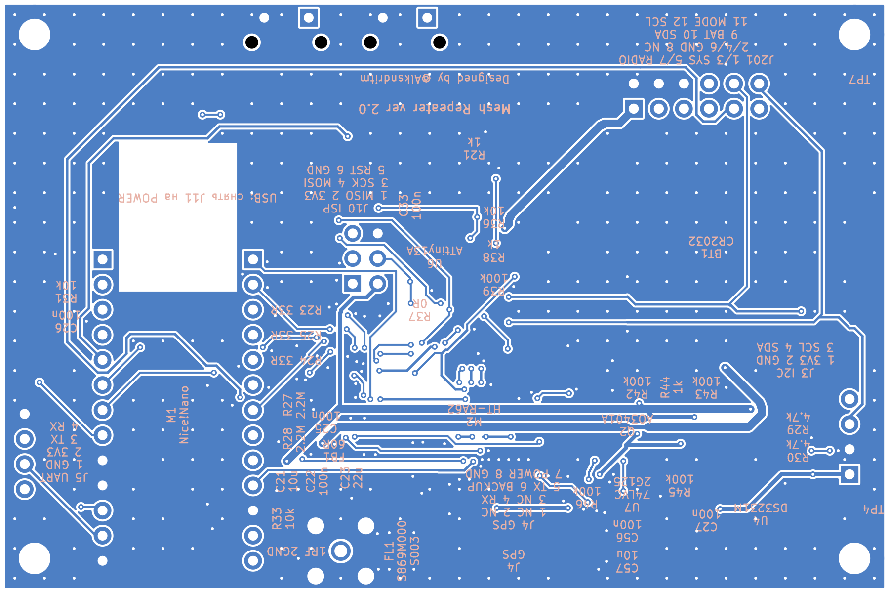
output/LOGIC/MeshRepeater2_Logic_assembly_top.png
