Alksndr55/mesh-repeater-2.0/output/POWER_MARKING/MeshRepeater2_Power_assembly_top.png

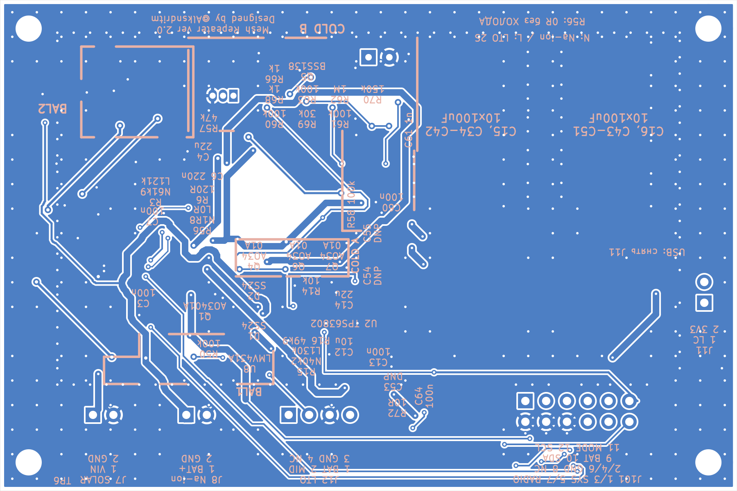
output/POWER_MARKING/MeshRepeater2_Power_assembly_top.png
