Alksndr55/mesh-repeater-2.0/output/SHIELD/MeshRepeater2_Shield_front_assembly.png

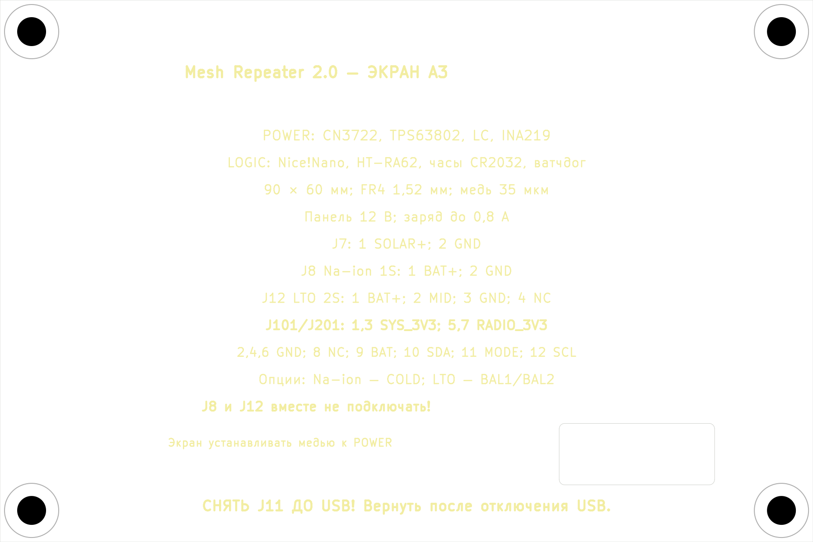
output/SHIELD/MeshRepeater2_Shield_front_assembly.png
