Alksndr55/mesh-repeater-2.0/docs/V2_CHANGES_FROM_S4_16_RU.md

# Изменения 2.0 относительно 1.0 / S4.16

**Текущая публикация — V2.0-A3.** Ниже сохранено историческое описание конструкции до A3 и её прежних проверок. В A3 используется прямая вертикальная пара J101/J201; J11 находится на POWER, а медная звезда NT2 соединяет две отдельные ветви SYS_3V3 и RADIO_3V3 после шунта. Контакты 1/3 — SYS, 5/7 — RADIO, 2/4/6 — GND, 8 — NC, 9 — BAT, 10/11/12 — SDA/MODE/SCL. Все компоненты POWER на F, шесть силовых резисторов в 2512; в экране одно окно под общую пластиковую планку. Актуальны [README](../README.md), [BOM A3](../bom/V2_A3_COMPONENT_BOM.csv), [состав выпуска](V2_A3_RELEASE_RU.md) и [инженерный аудит](V2_ENGINEERING_AUDIT_A3_2026_10_13_RU.html).

## Историческое описание до A3

Источник — публичный коммит cf54f9970e716272d477afdb252b4e195d595cb6, тег v1.0. Функциональные компоненты, номиналы трёх вариантов, GPIO Nice!Nano/HT-RA62, MeshCore FakeTec, RTC, GPS и TXEN-watchdog сохранены.

Вместо одной платы 90×100 мм подготовлены POWER и LOGIC по 90×60 мм и отдельный сплошной экран 90×60 мм. POWER обращена компонентами вверх; LOGIC повёрнута вокруг X на 180° компонентами вниз. Новые боковые разъёмы и кнопки выбраны по размерным чертежам из ДАН. Между платами только FILTER_OUT, GND, BATsense, MODE через 12-контактный кабель. Перемычка J11 находится на LOGIC и сохраняет единственную связь FILTER_OUT→SYS_3V3. ISP J10 остаётся на первоначальном месте; обслуживание после разборки.

Две ветви SYS_3V3 от J11 к MCU и входу FB1 модема разведены отдельно; локальные FB1, C23, C24 остались у модема. BAT для ADC отведён отдельно от контакта аккумулятора. Основная BAT-линия укорочена, C53 перенесён к входной группе TPS63802; подача приходит на его площадку перед локальной развязкой. Исправлен реальный зазор RF-полигона, новые SPI-отрезки выведены из области SMA/SAW. GND обеих рабочих плат связан через переходные отверстия и все шесть земляных жил кабеля, независимо от стоек.

Рамка SH1 удалена по отдельному размерному аудиту: её сохранение в новых габаритах приводило к пересечениям. Средний экран и открытые медные кольца под металлическим крепежом обеспечивают проектное экранирование; эффективность требует испытаний. COLD и оба балансира сохраняют собственную маркировку опций на POWER. Наружная поверхность LOGIC содержит проекции разъёмов, органов управления и D3/D4 нижнего этажа; на экране размещена памятка с обеих сторон без вырезания меди.

Местные варианты посадочных мест отражают фактическую графику шелкографии и сохраняют геометрию площадок, корпусов и моделей. Их технические суффиксы не выводятся в подписи корпусов на схеме. Шрифт маркировки не меньше 0,8 мм; номиналы и позиции остаются привязаны к деталям либо пространственной группе с сохранёнными ориентацией и расположением.

Унаследованные электрические ограничения 1.0 сохранены в V2_LIMITATIONS_RU.md. Сборка, резьбное сопряжение, реальные IDC-розетки, конкретный клон Nice!Nano, EMI и электрические режимы требуют проверки прототипа. CAD-проверки имеют собственные хеши окончательных файлов и не объявляются стендовыми испытаниями.

## Исправления независимого аудита — 12 октября 2026 года

Пять новых замечаний устранены и прошли [независимую проверку](../audit/fixes_2026_10_12/reviewer.md):

- Укорочены обходы MOSI, MISO и RESET; суммы сегментов уменьшены с 185,256 / 121,659 / 105,147 мм до 30,917 / 42,763 / 33,350 мм. Добавлены близкие земляные переходы и улучшены возвратные пути.
- RXEN выведен из области противоположной земли под ANT_RF. Устранён обнаруженный пробел 0,900 мм; новое нативное правило запрещает возвращение цифровых трасс в эту область и проверено контрольным нарушением в отдельной копии.
- Для J3/J5 выбраны ответные корпуса Connfly I-DS1071-SCB01x4 и контакты T-DS1071-SC600 из ДАН; добавлены количества, распиновка и инструкции сборки кабелей.
- Ширина скобы STEP-моделей кнопки TE изменена с 7,66 до 8,41 мм по чертежу. Геометрия её посадочных мест сохранена.
- Обозначения H1–H4 в трёх вариантах BOM, скрытых полях схемы, платы и локальных посадок приведены к фактическому исполнению M3 GND contact: металлизированное отверстие Ø3,2 мм, площадка GND Ø6 мм. Физическая геометрия отверстий не менялась.

Положение компонентов, функциональные цепи и GPIO сохранены. J10 остаётся (35,7; 31,3) мм, 0°. Положительные ветви питания MCU и модема от J11 по-прежнему не имеют общих сегментов; BAT sense остаётся отдельным. GND LOGIC физически связан в одну группу. На части цифровых трасс сохраняются короткие пробелы противоположного полигона, а у SMA — исходный локальный пробел около 1,25 мм. Эти остаточные особенности и пределы проверки приведены в [инженерном отчёте](V2_ROUTING_ENGINEERING_AUDIT_RU.md); соответствие EMI и качество RF требуют измерений.

Два прежних риска схемы LTO не изменены: ток LMV431 при резисторе 2 Ом и возможное превышение 5,5 В на входе TPS63802 при снятой батарее. 12 октября 2026 года пользователь выбрал «Сохранить прежнюю схему LTO и отмеченные ограничения». Усилитель балансира и отдельная отсечка перенапряжения не добавляются; резисторы 2 Ом и прежний делитель CN3722 сохраняются. Это принятие ограничений, а не устранение электрических рисков. Решение записано в [user_decision.json](../audit/fixes_2026_10_12/user_decision.json).
