Alksndr55/mesh-repeater-2.0/output/pdf/MeshRepeater2_Logic_A3_schematic.pdf

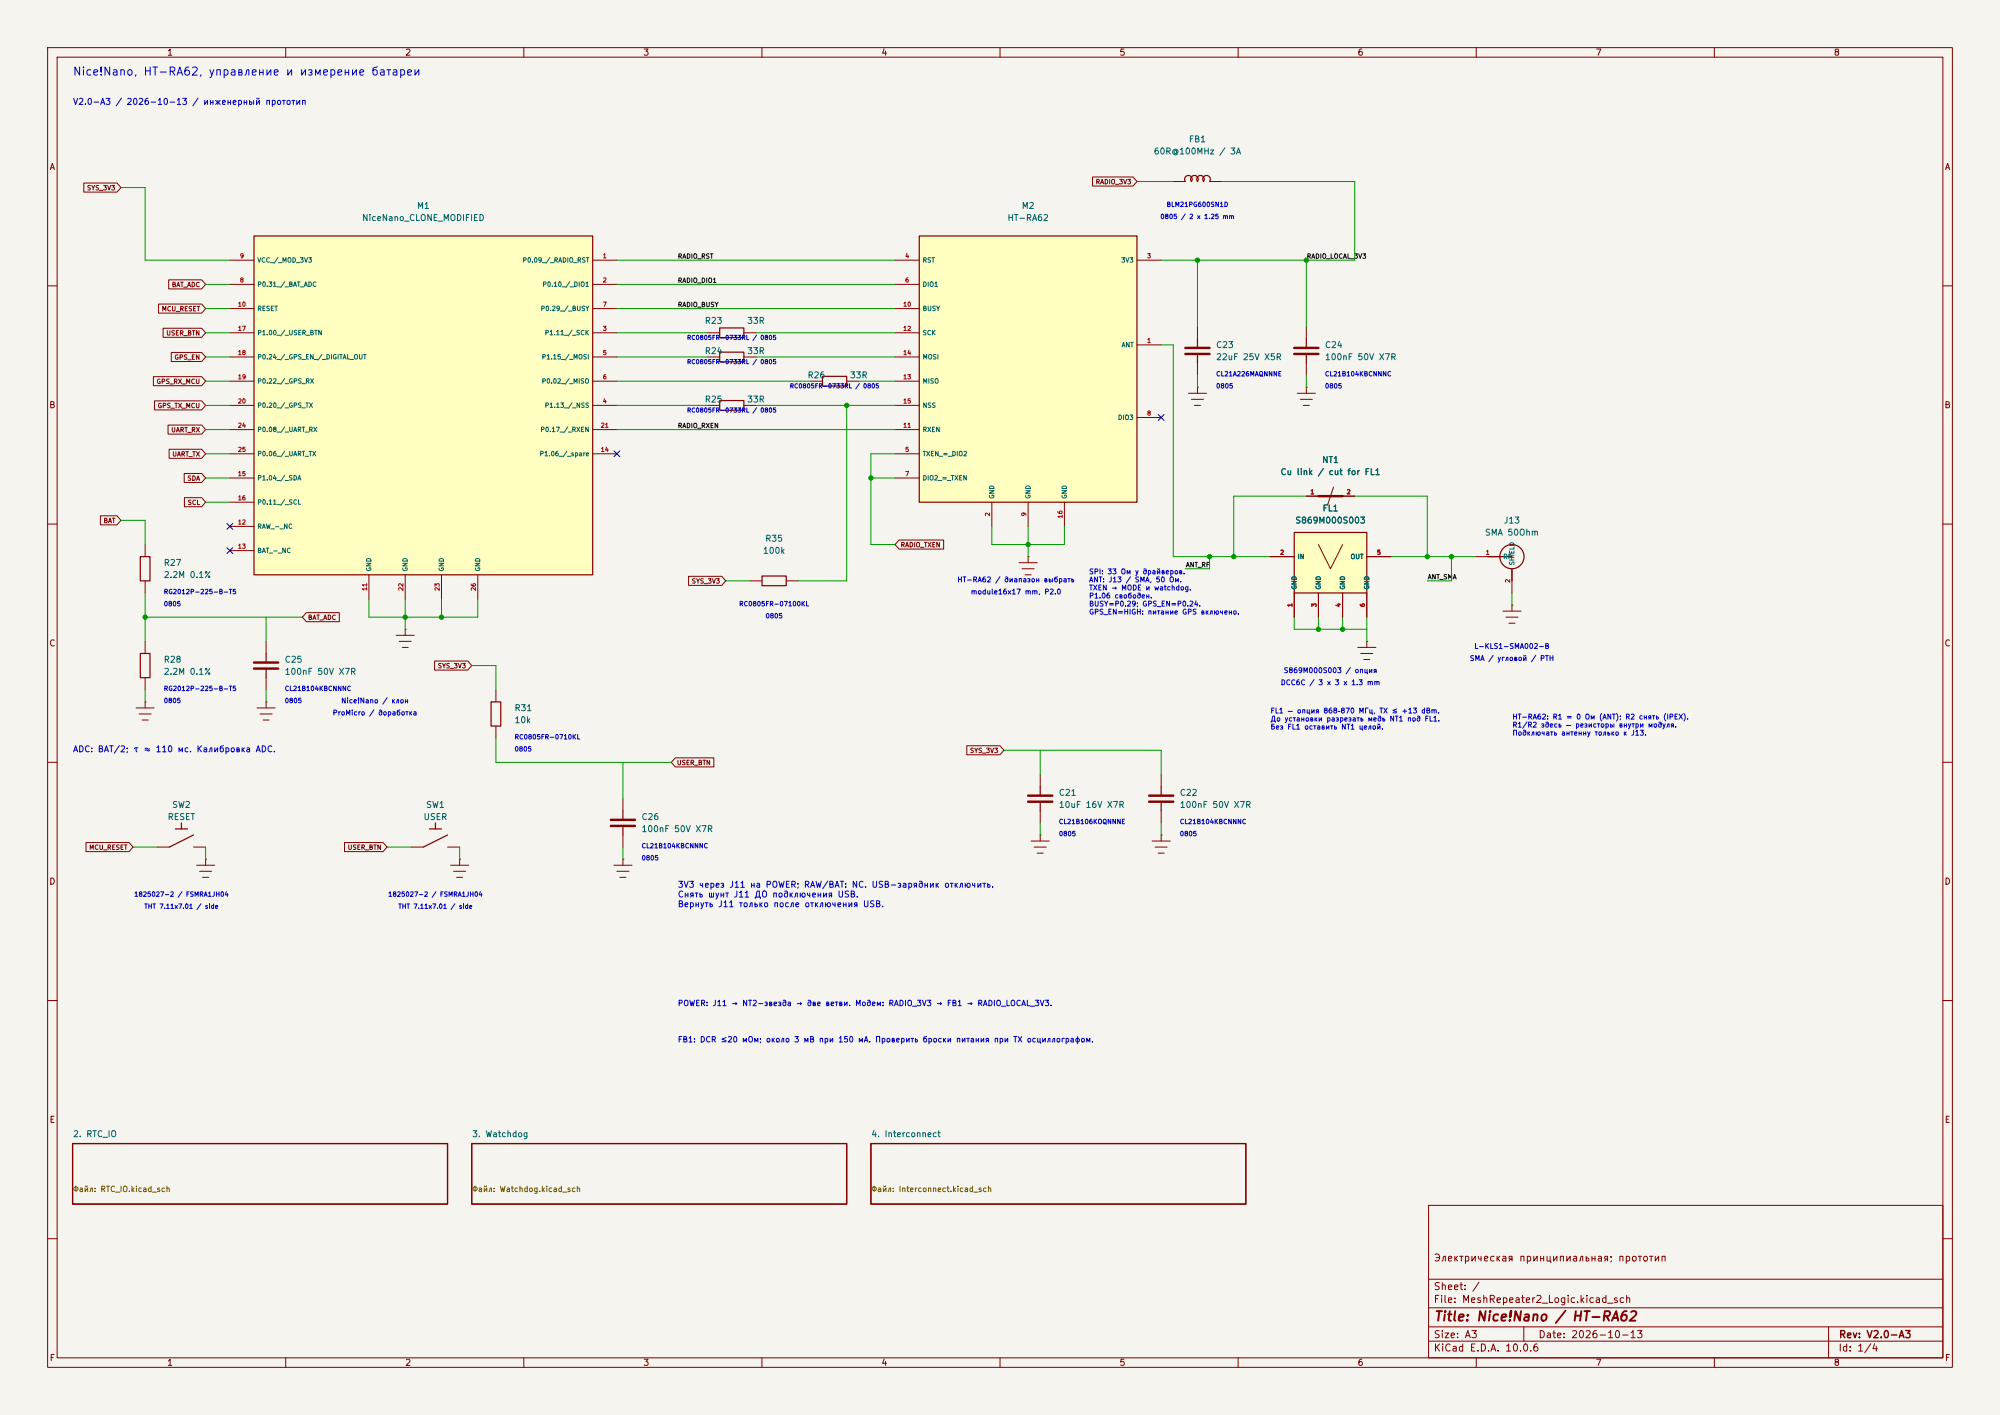
[picture p72: page 1]

SPI: 33 Ом у драйверов. ANT: J13 / SMA, 50 Ом. TXEN → MODE и watchdog. P1.06 свободен. BUSY=P0.29; GPS_EN=P0.24. GPS_EN=HIGH: питание GPS включено. Nice!Nano, HT-RA62, управление и измерение батареи

9 BUSY 10 RXEN 11 SCK 12 MISO 13 MOSI 14 NSS 15 GND 16 M2 HT-RA62 C22

0805 3V3 через J11 на POWER; RAW/BAT: NC. USB-зарядник отключить. Снять шунт J11 ДО подключения USB. Вернуть J11 только после отключения USB.

6 NT1 Cu link / cut for FL1

1825027-2 / FSMRA1JH04 ADC: BAT/2; τ ≈ 110 мс. Калибровка ADC. 0805

POWER: J11 → NT2-звезда → две ветви. Модем: RADIO_3V3 → FB1 → RADIO_LOCAL_3V3.

Sheet: /
File: MeshRepeater2_Logic.kicad_sch
Title: Nice!Nano / HT-RA62

Size: A3 | Rev: V2.0-A3 | F Date: 2026-10-13
KiCad E.D.A. 10.0.6 | Id: 1/4

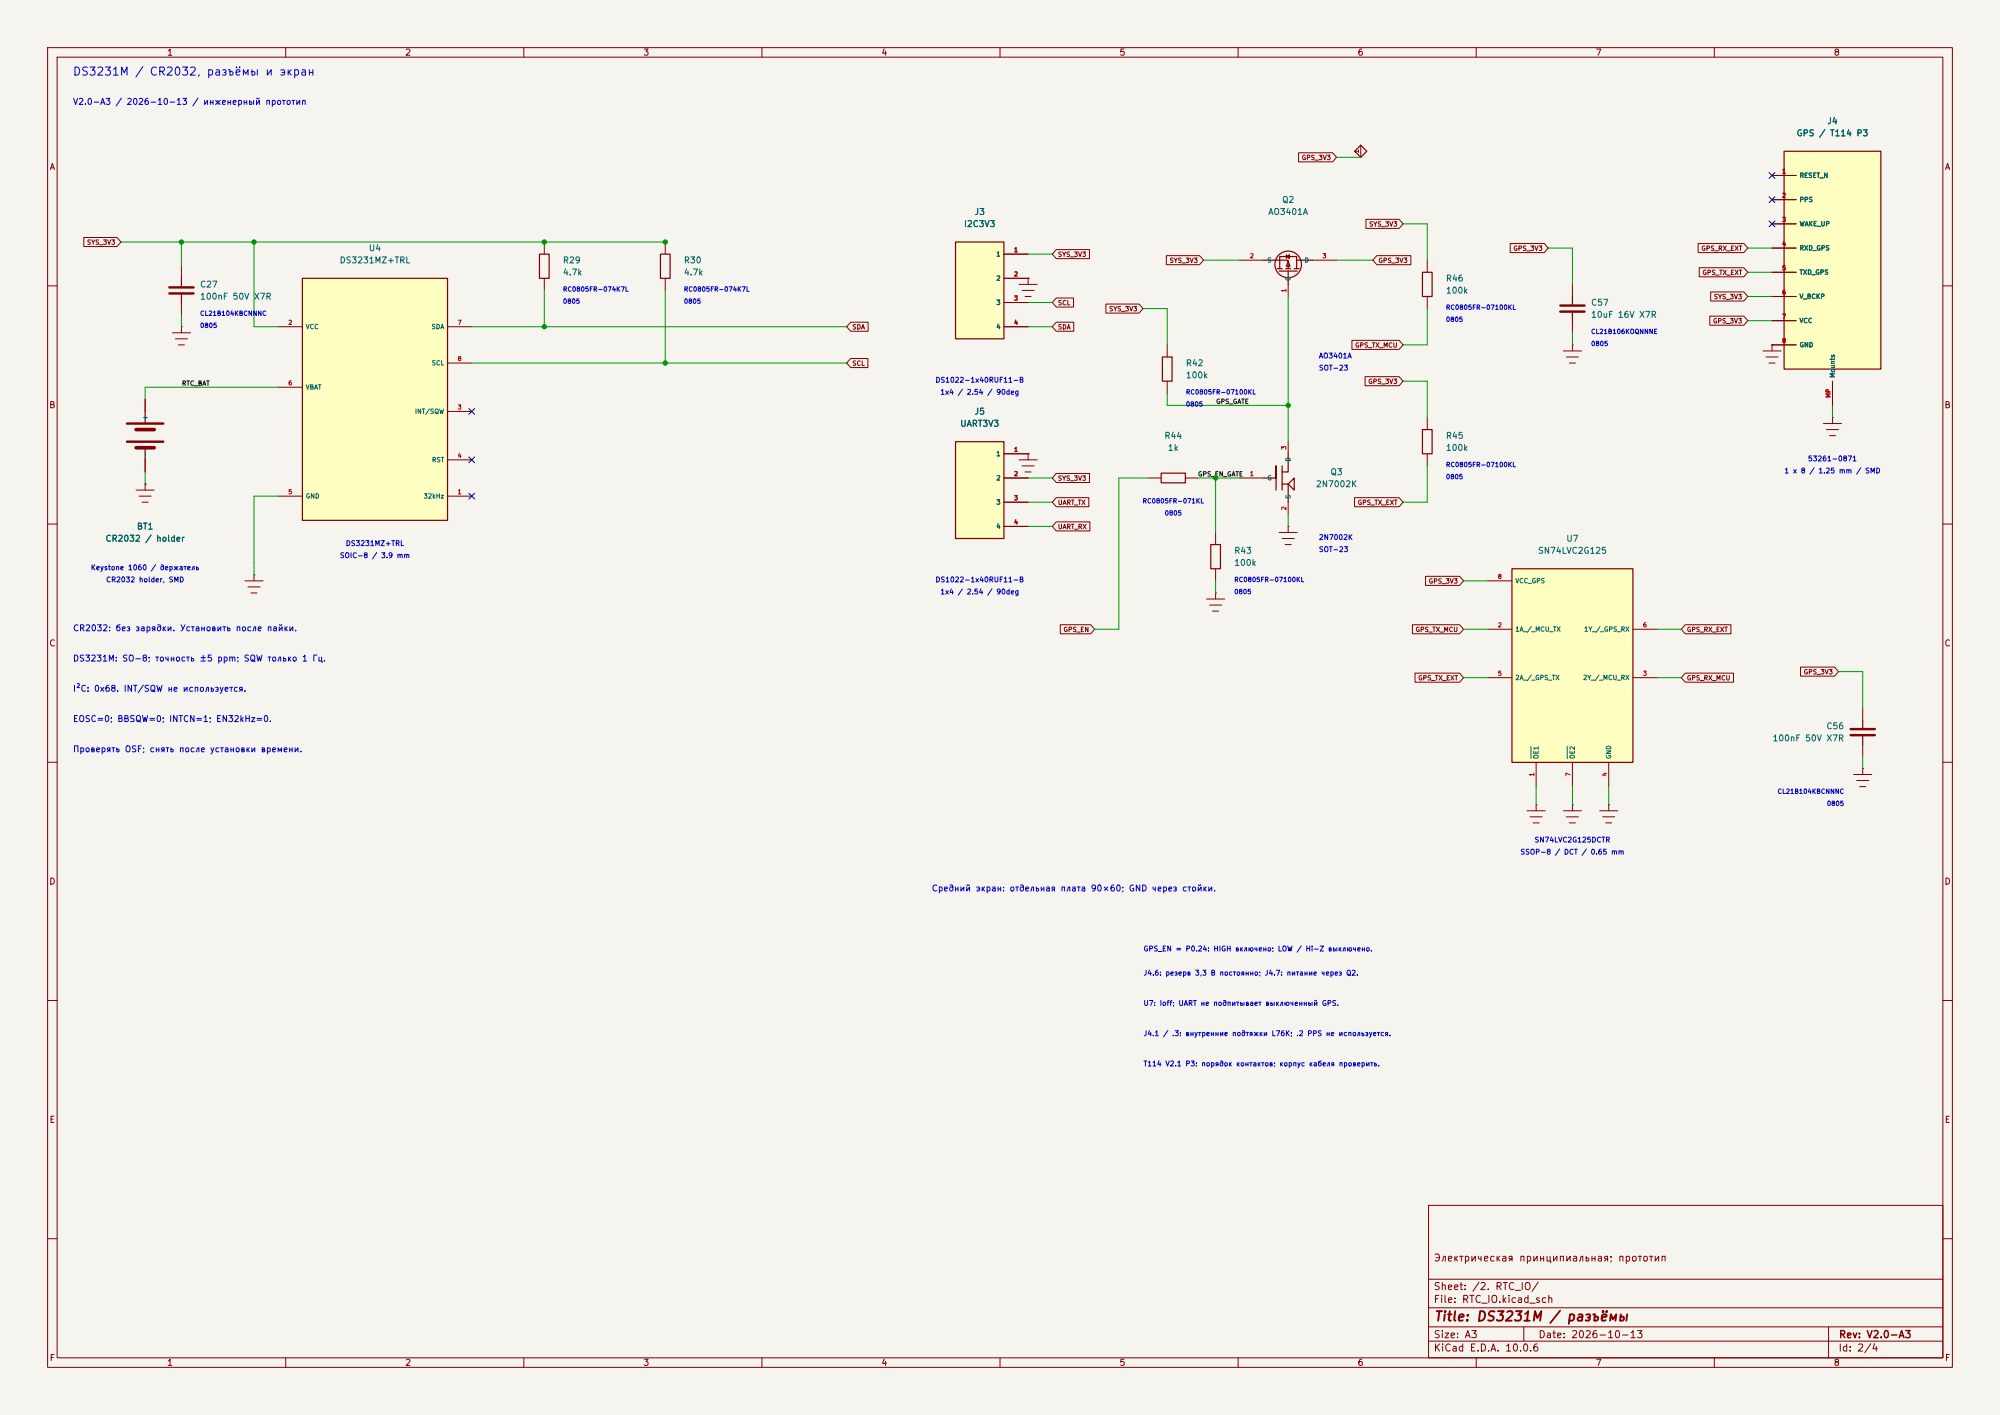
[picture p73: page 2]

V2.0-A3 / 2026-10-13 / инженерный прототип DS3231M / CR2032, разъёмы и экран

RC0805FR-07100KL 1x4 / 2.54 / 90deg Средний экран: отдельная плата 90×60; GND через стойки. T114 V2.1 P3: порядок контактов; корпус кабеля проверить.

RC0805FR-071KL GPS_EN = P0.24: HIGH включено; LOW / Hi-Z выключено.

Keystone 1060 / держатель CR2032 holder, SMD

U7: Ioff; UART не подпитывает выключенный GPS. EOSC=0; BBSQW=0; INTCN=1; EN32kHz=0. Проверять OSF; снять после установки времени.

J4.1 / .3: внутренние подтяжки L76K; .2 PPS не используется.

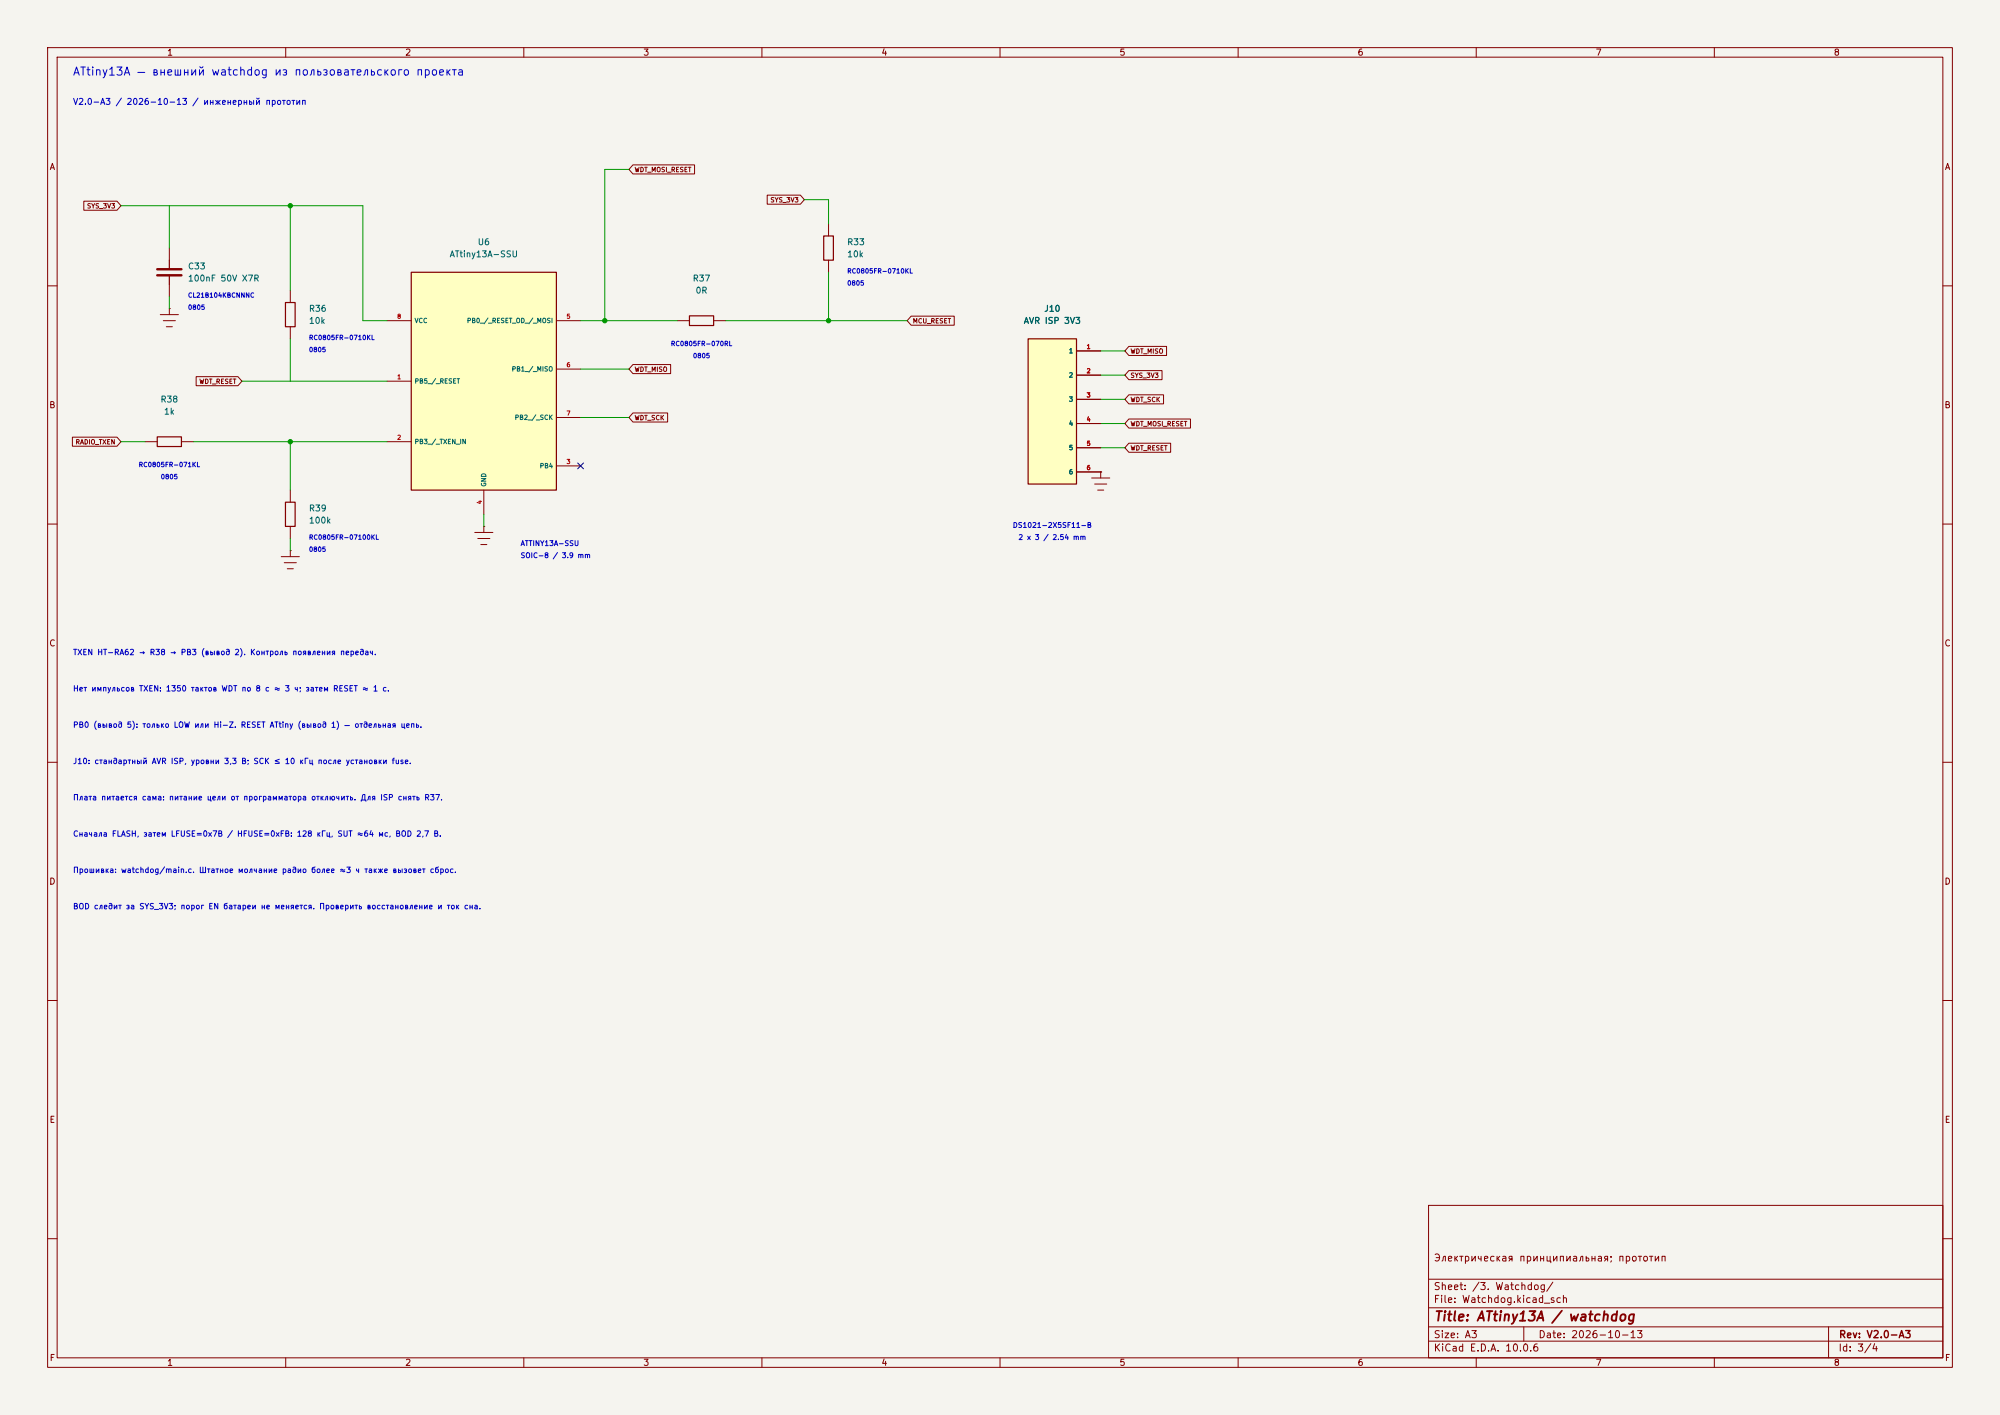
[picture p74: page 3]

CL21B104KBCNNNC ATtiny13A — внешний watchdog из пользовательского проекта

0805 Нет импульсов TXEN: 1350 тактов WDT по 8 с ≈ 3 ч; затем RESET ≈ 1 с.

TXEN HT-RA62 → R38 → PB3 (вывод 2). Контроль появления передач. Плата питается сама: питание цели от программатора отключить. Для ISP снять R37.

J10: стандартный AVR ISP, уровни 3,3 В; SCK ≤ 10 кГц после установки fuse.

Сначала FLASH, затем LFUSE=0x7B / HFUSE=0xFB: 128 кГц, SUT ≈64 мс, BOD 2,7 В.

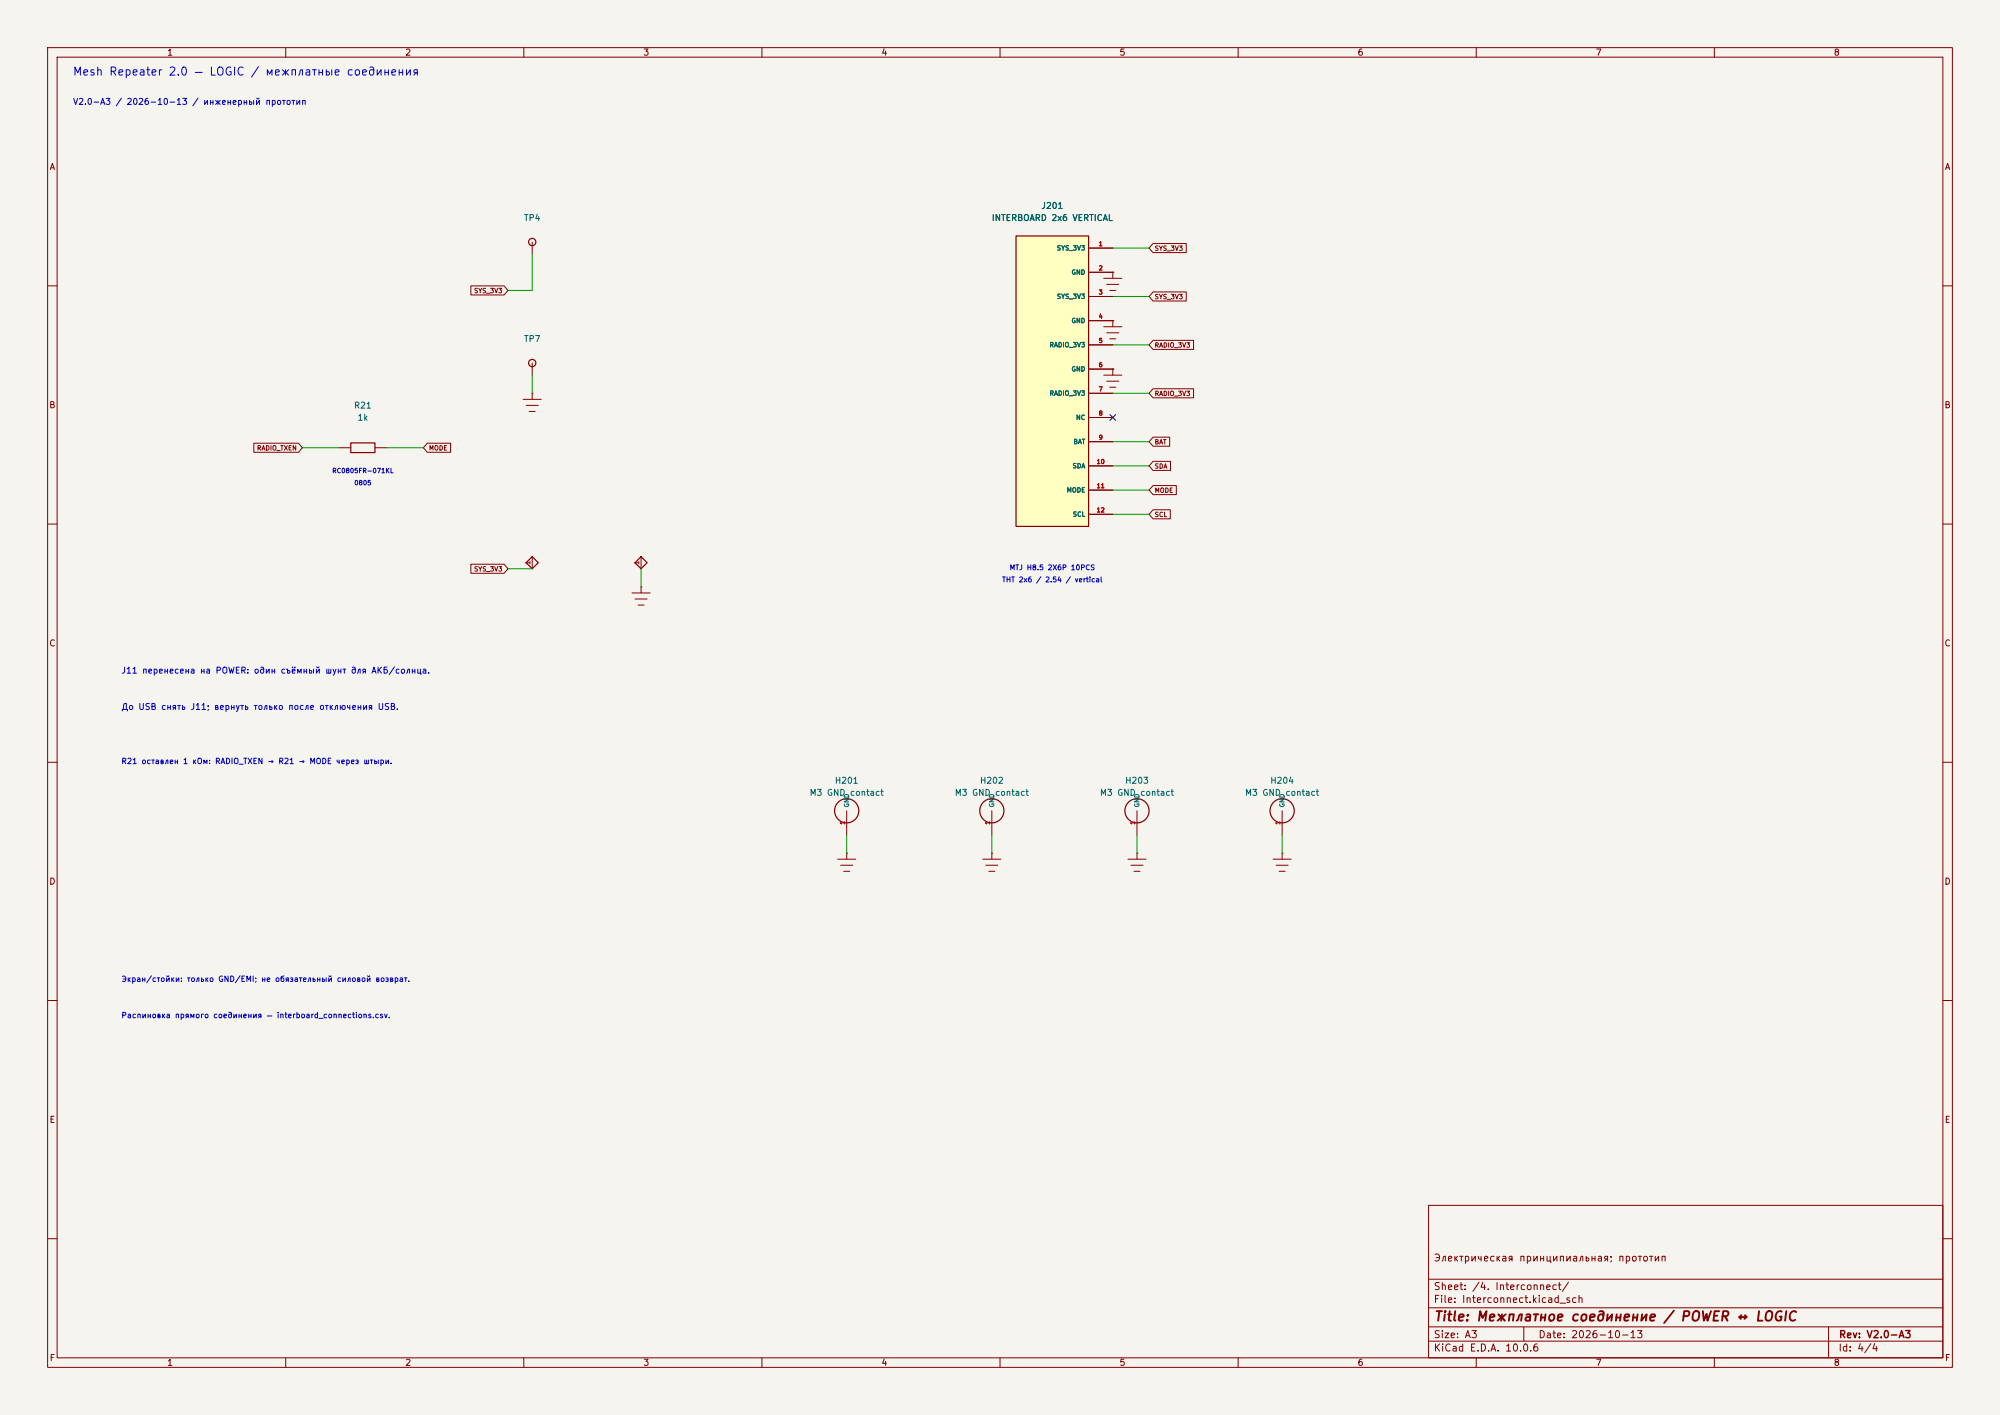
[picture p75: page 4]

Mesh Repeater 2.0 — LOGIC / межплатные соединения
V2.0-A3 / 2026-10-13 / инженерный прототип До USB снять J11; вернуть только после отключения USB. RC0805FR-071KL Экран/стойки: только GND/EMI; не обязательный силовой возврат.

0805 J11 перенесена на POWER: один съёмный шунт для АКБ/солнца. R21 оставлен 1 кОм: RADIO_TXEN → R21 → MODE через штыри.

Электрическая принципиальная; прототип GND

Распиновка прямого соединения — interboard_connections.csv.

Sheet: /4. Interconnect/
File: Interconnect.kicad_sch
Title: Межплатное соединение / POWER ↔ LOGIC
