Alksndr55/mesh-repeater-2.0/output/pdf/MeshRepeater2_Power_A3_schematic.pdf

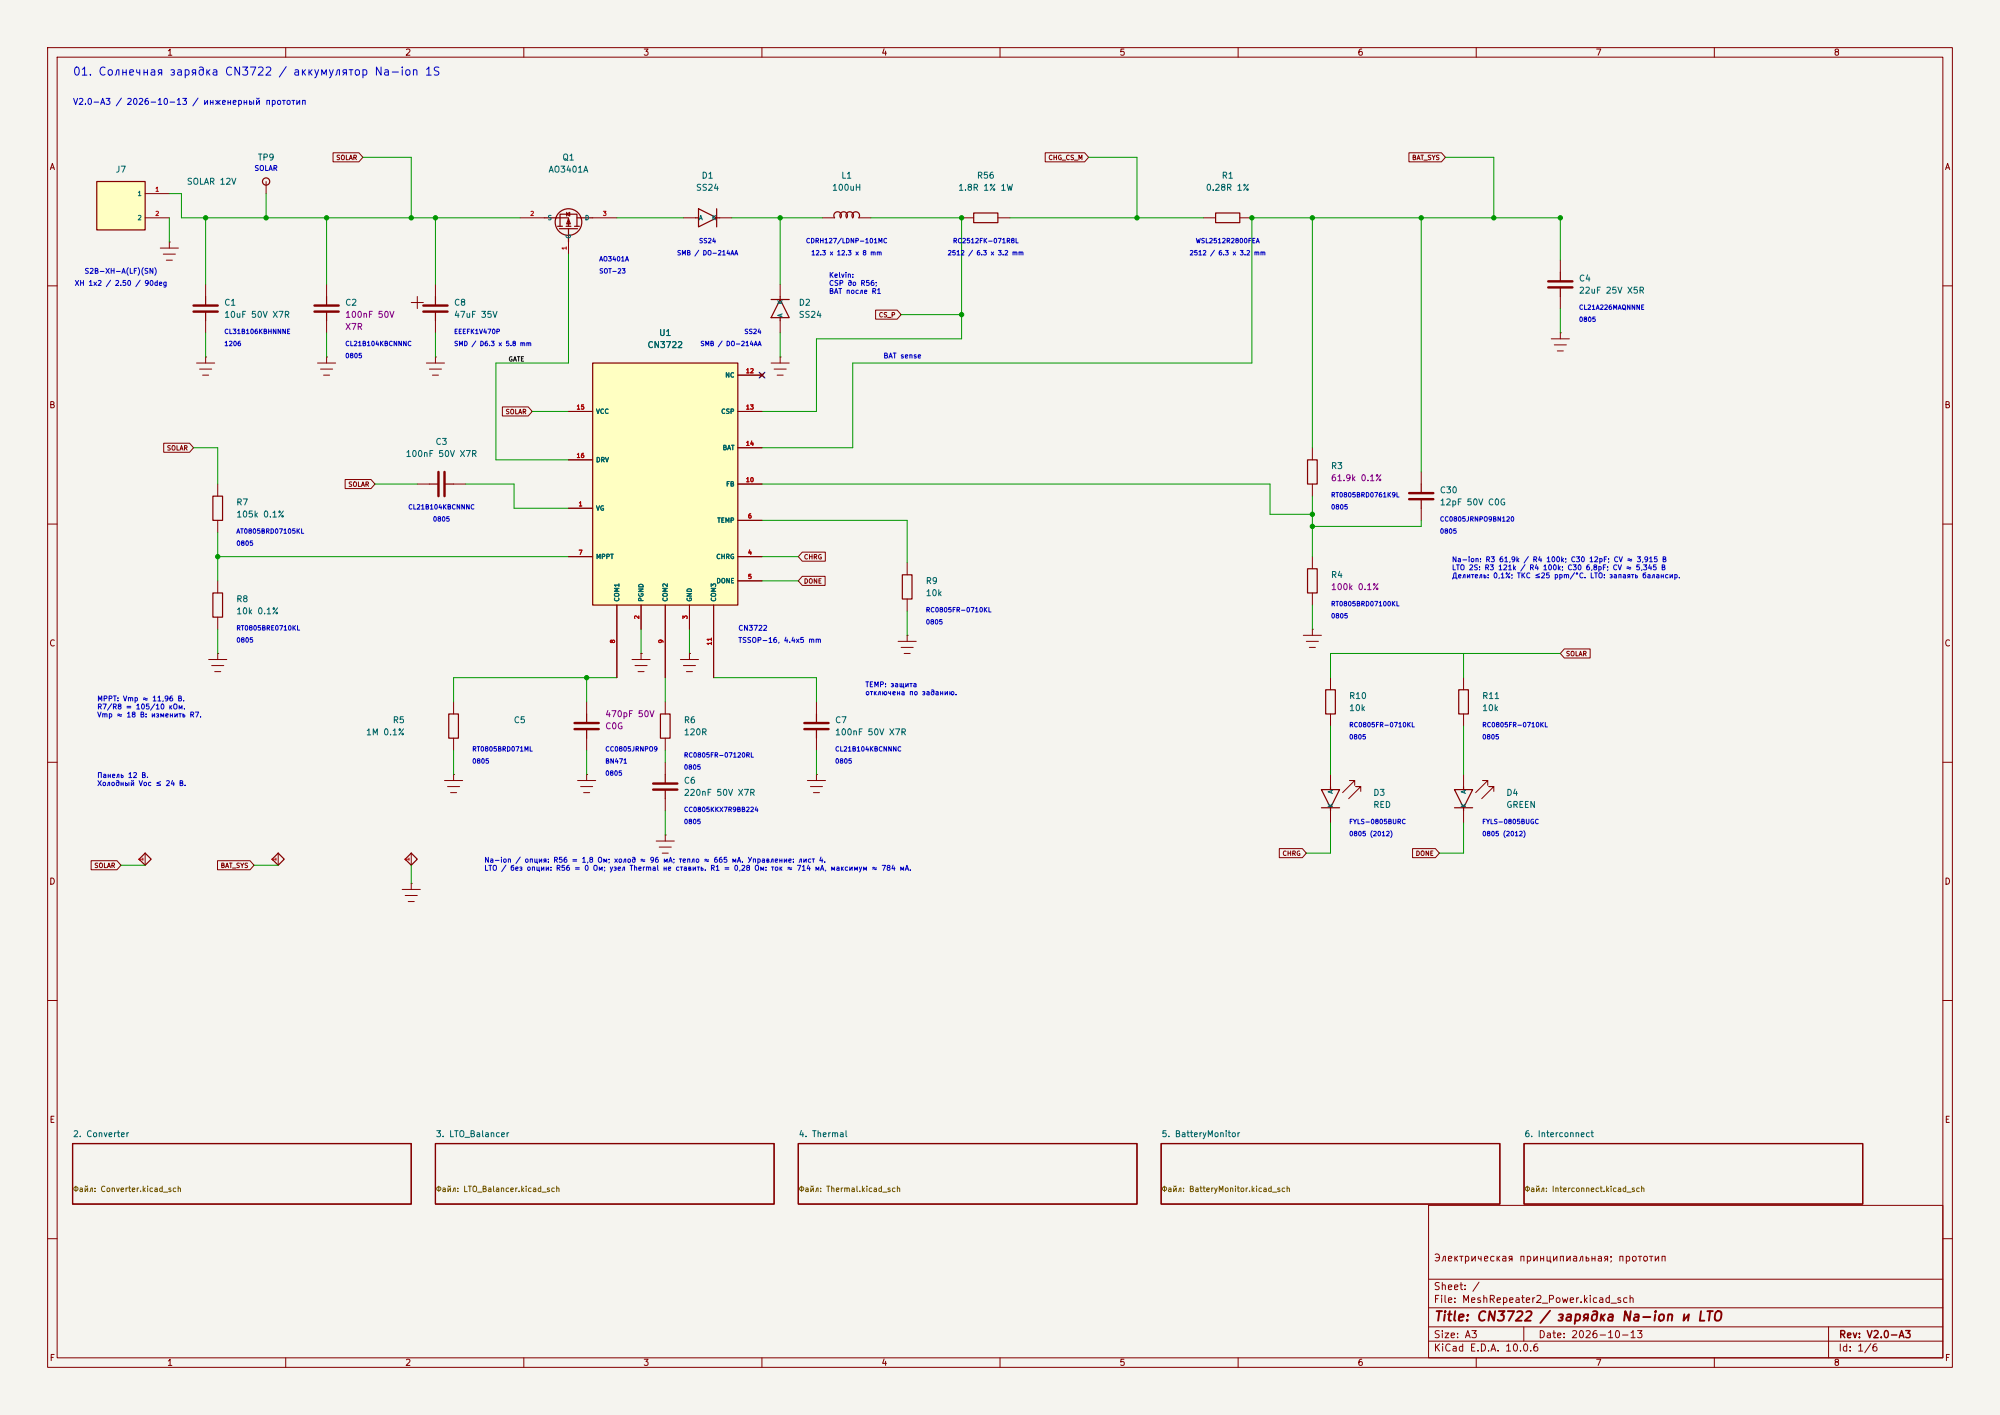
[picture p76: page 1]

LTO 2S: R3 121k / R4 100k; C30 6,8pF; CV ≈ 5,345 В Делитель: 0,1%; ТКС ≤25 ppm/°C. LTO: запаять балансир. CL21A226MAQNNNE 01. Солнечная зарядка CN3722 / аккумулятор Na-ion 1S

WSL2512R2800FEA Kelvin: CSP до R56; BAT после R1

1206 CL31B106KBHNNNE S2B-XH-A(LF)(SN) XH 1x2 / 2.50 / 90deg

0805 RT0805BRD07100KL 0805 Na-ion / опция: R56 = 1,8 Ом; холод ≈ 96 мА; тепло ≈ 665 мА. Управление: лист 4. LTO / без опции: R56 = 0 Ом; узел Thermal не ставить. R1 = 0,28 Ом: ток ≈ 714 мА, максимум ≈ 784 мА. CC0805KKX7R9BB224

Sheet: /
File: MeshRepeater2_Power.kicad_sch
Title: CN3722 / зарядка Na-ion и LTO

Size: A3 | Rev: V2.0-A3 | F Date: 2026-10-13
KiCad E.D.A. 10.0.6 | Id: 1/6

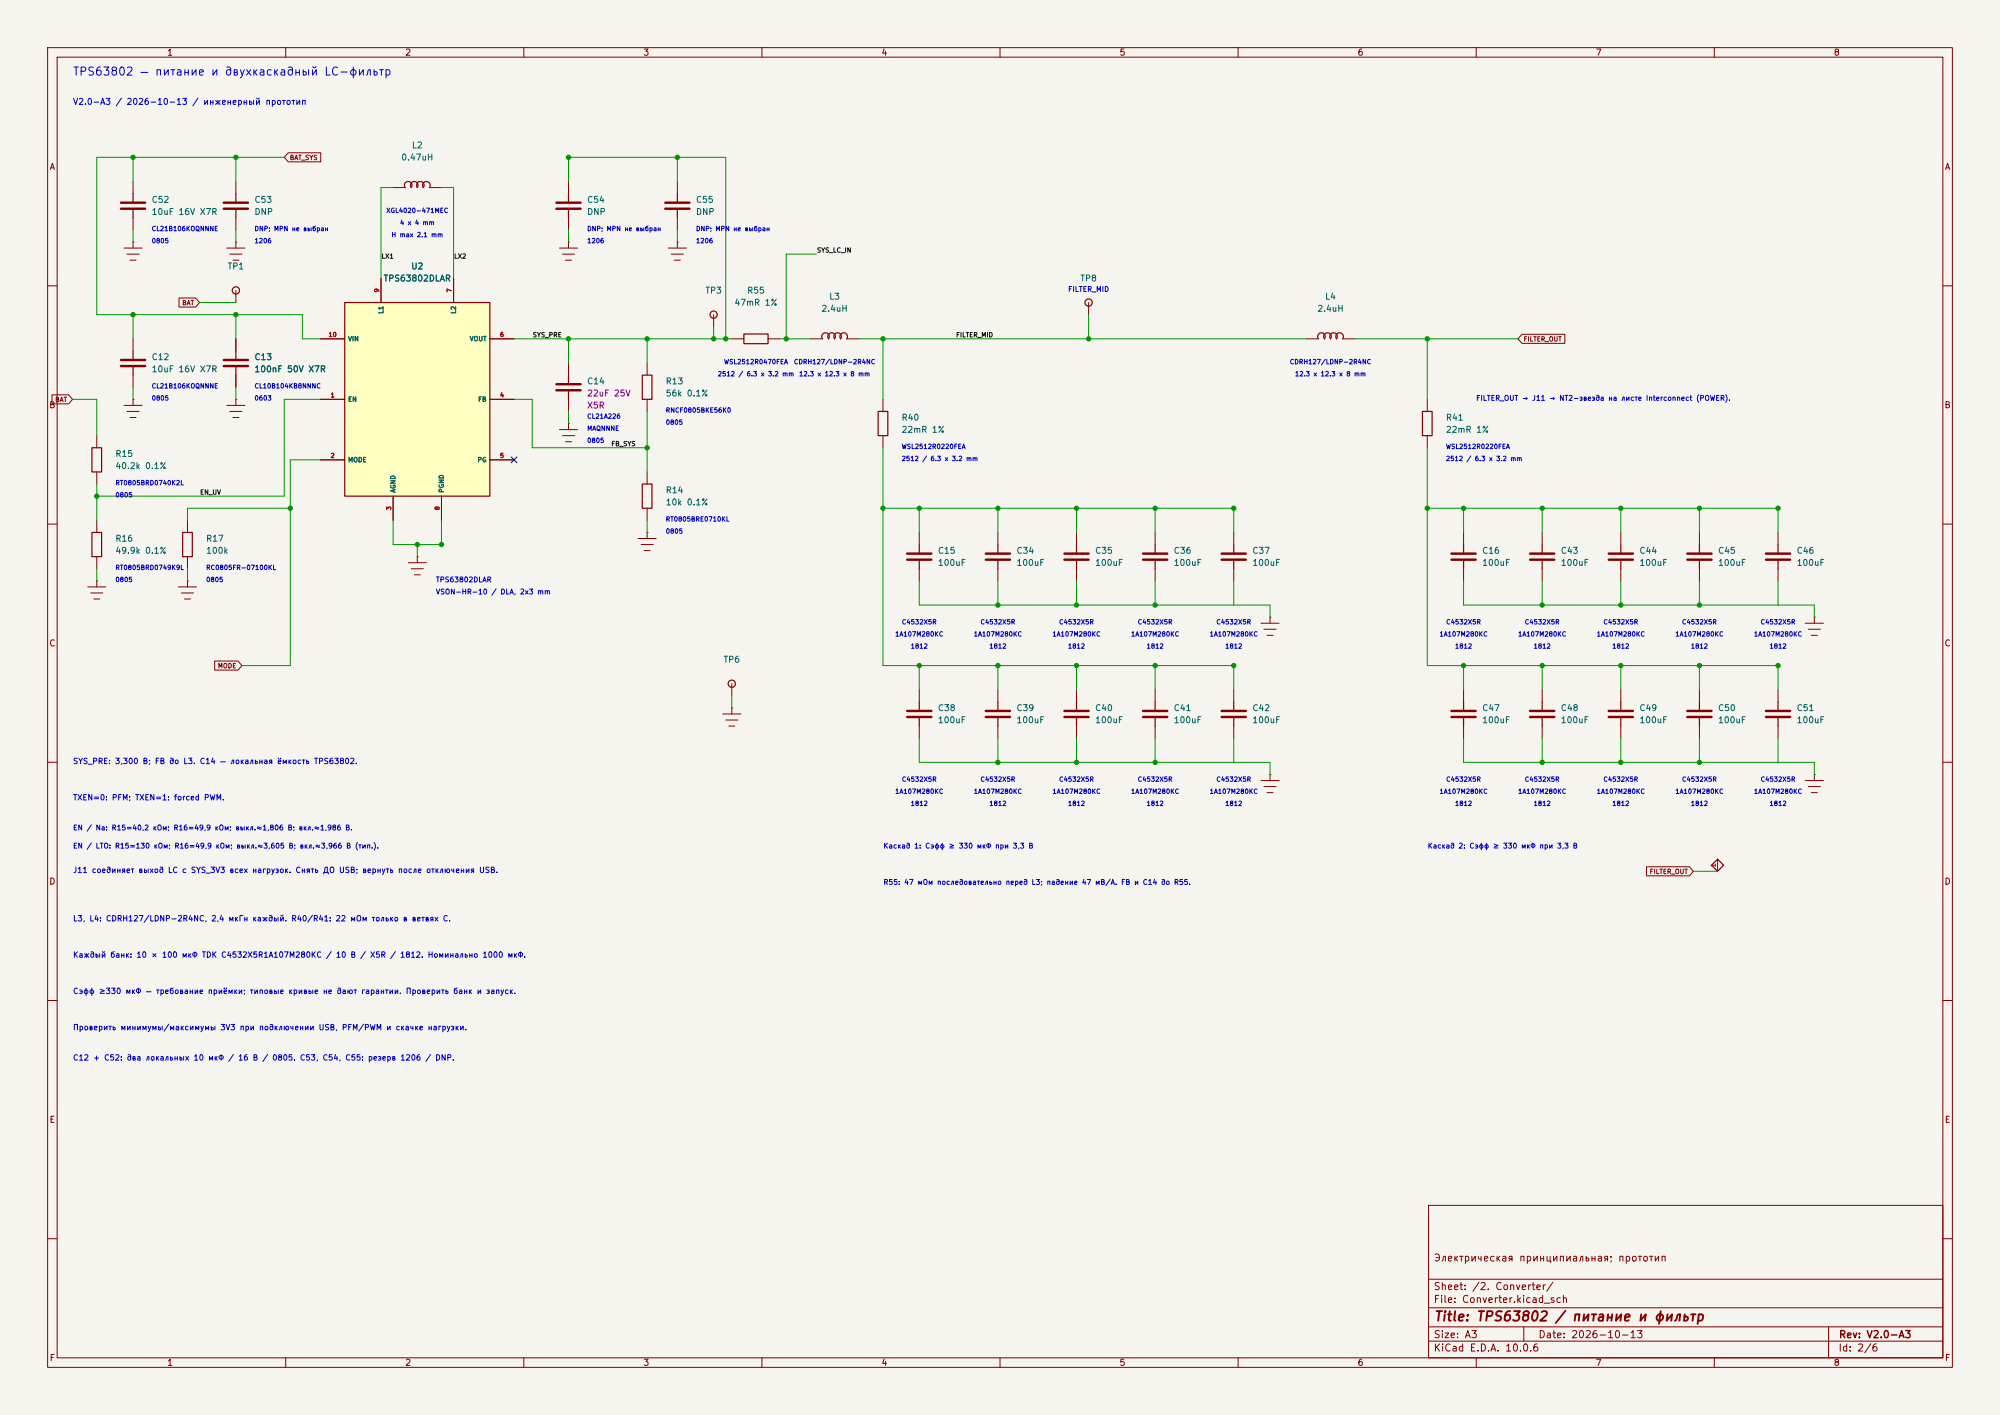
[picture p77: page 2]

12.3 x 12.3 x 8 mm TPS63802 — питание и двухкаскадный LC-фильтр

FILTER_OUT → J11 → NT2-звезда на листе Interconnect (POWER). H max 2.1 mm

DNP; MPN не выбран 1206

VSON-HR-10 / DLA, 2x3 mm

1812 Каскад 2: Cэфф ≥ 330 мкФ при 3,3 В

Cэфф ≥330 мкФ — требование приёмки; типовые кривые не дают гарантии. Проверить банк и запуск. Каждый банк: 10 × 100 мкФ TDK C4532X5R1A107M280KC / 10 В / X5R / 1812. Номинально 1000 мкФ.

Проверить минимумы/максимумы 3V3 при подключении USB, PFM/PWM и скачке нагрузки.

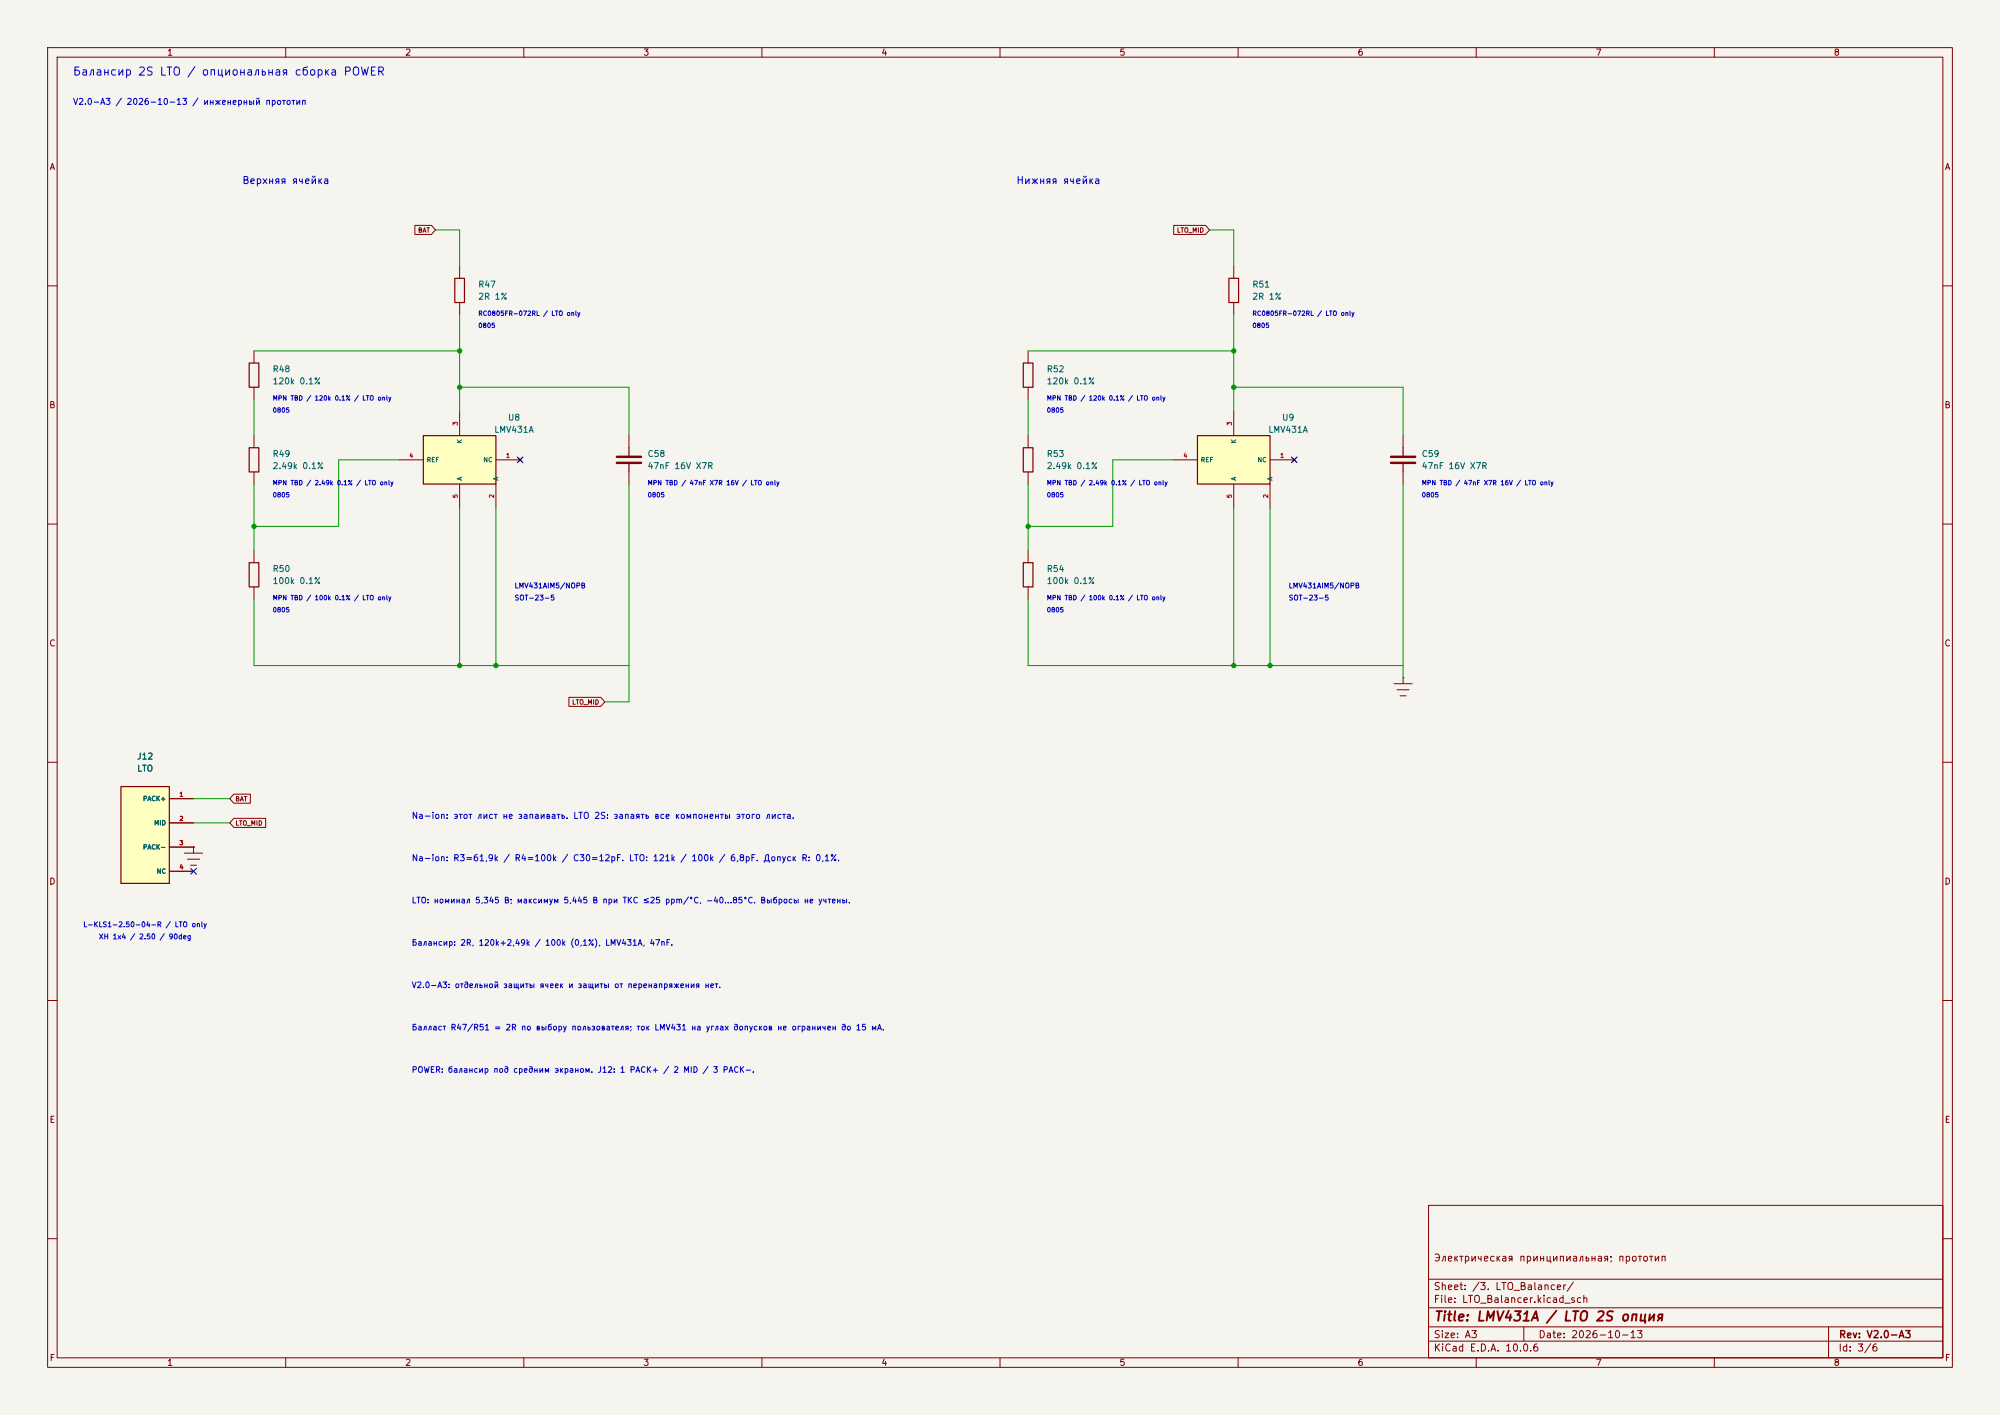
[picture p78: page 3]

Балансир 2S LTO / опциональная сборка POWER

MPN TBD / 120k 0.1% / LTO only

MPN TBD / 47nF X7R 16V / LTO only

Na-ion: этот лист не запаивать. LTO 2S: запаять все компоненты этого листа.

LTO: номинал 5,345 В; максимум 5,445 В при ТКС ≤25 ppm/°C, -40…85°C. Выбросы не учтены. Балласт R47/R51 = 2R по выбору пользователя; ток LMV431 на углах допусков не ограничен до 15 мА.

POWER: балансир под средним экраном. J12: 1 PACK+ / 2 MID / 3 PACK-.

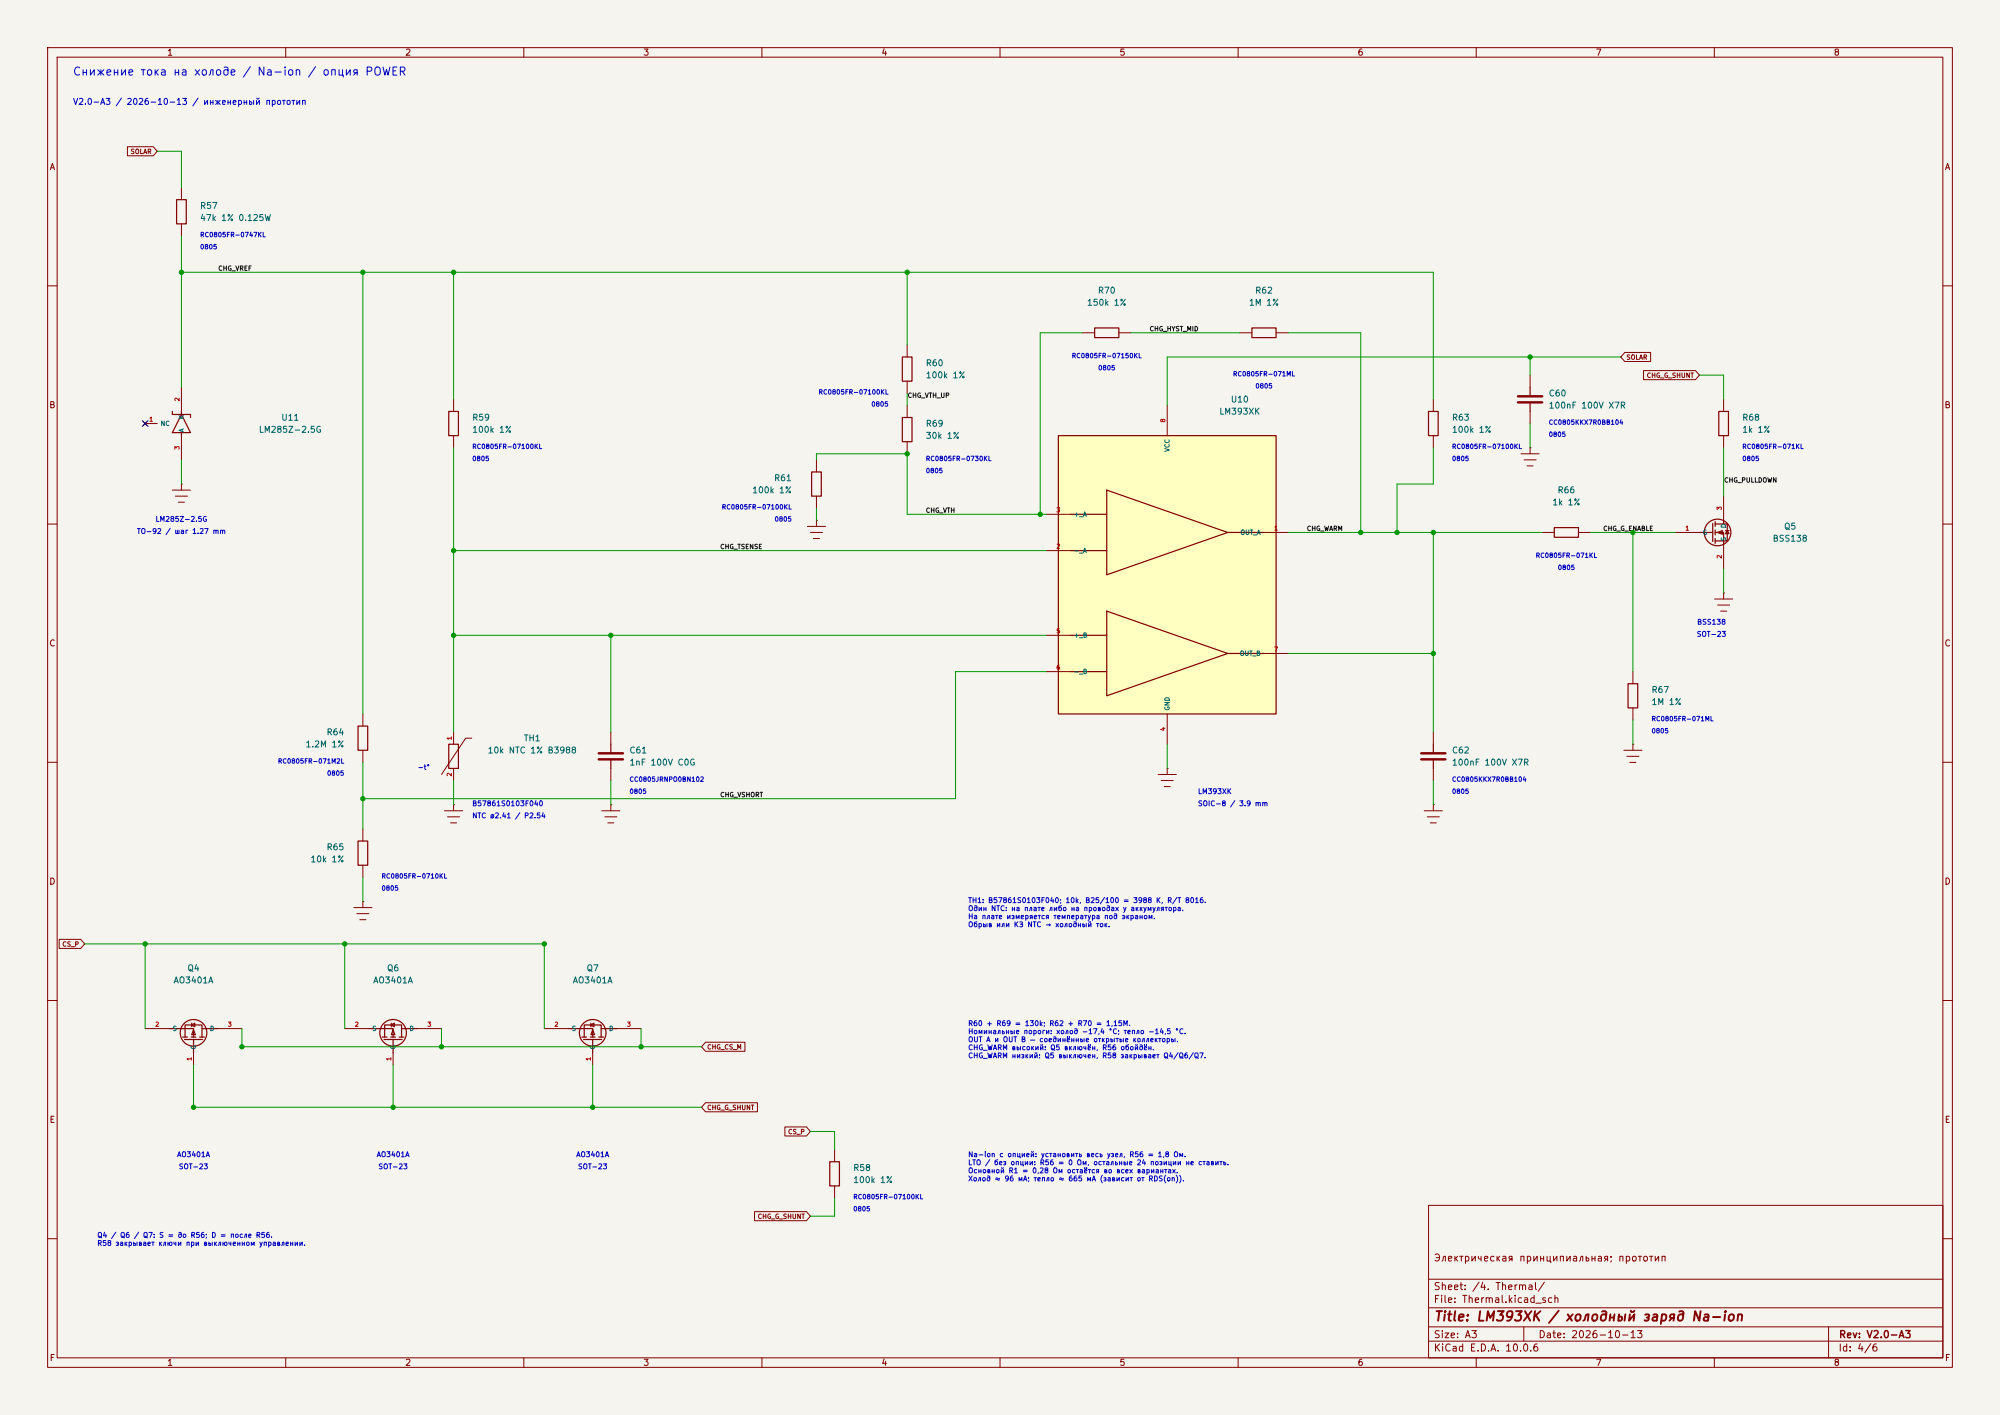
[picture p79: page 4]

Снижение тока на холоде / Na-ion / опция POWER

Na-ion с опцией: установить весь узел, R56 = 1,8 Ом. LTO / без опции: R56 = 0 Ом, остальные 24 позиции не ставить. Основной R1 = 0,28 Ом остаётся во всех вариантах. Холод ≈ 96 мА; тепло ≈ 665 мА (зависит от RDS(on)).

Q4 / Q6 / Q7: S = до R56; D = после R56. R58 закрывает ключи при выключенном управлении.

Sheet: /4. Thermal/
File: Thermal.kicad_sch
Title: LM393XK / холодный заряд Na-ion

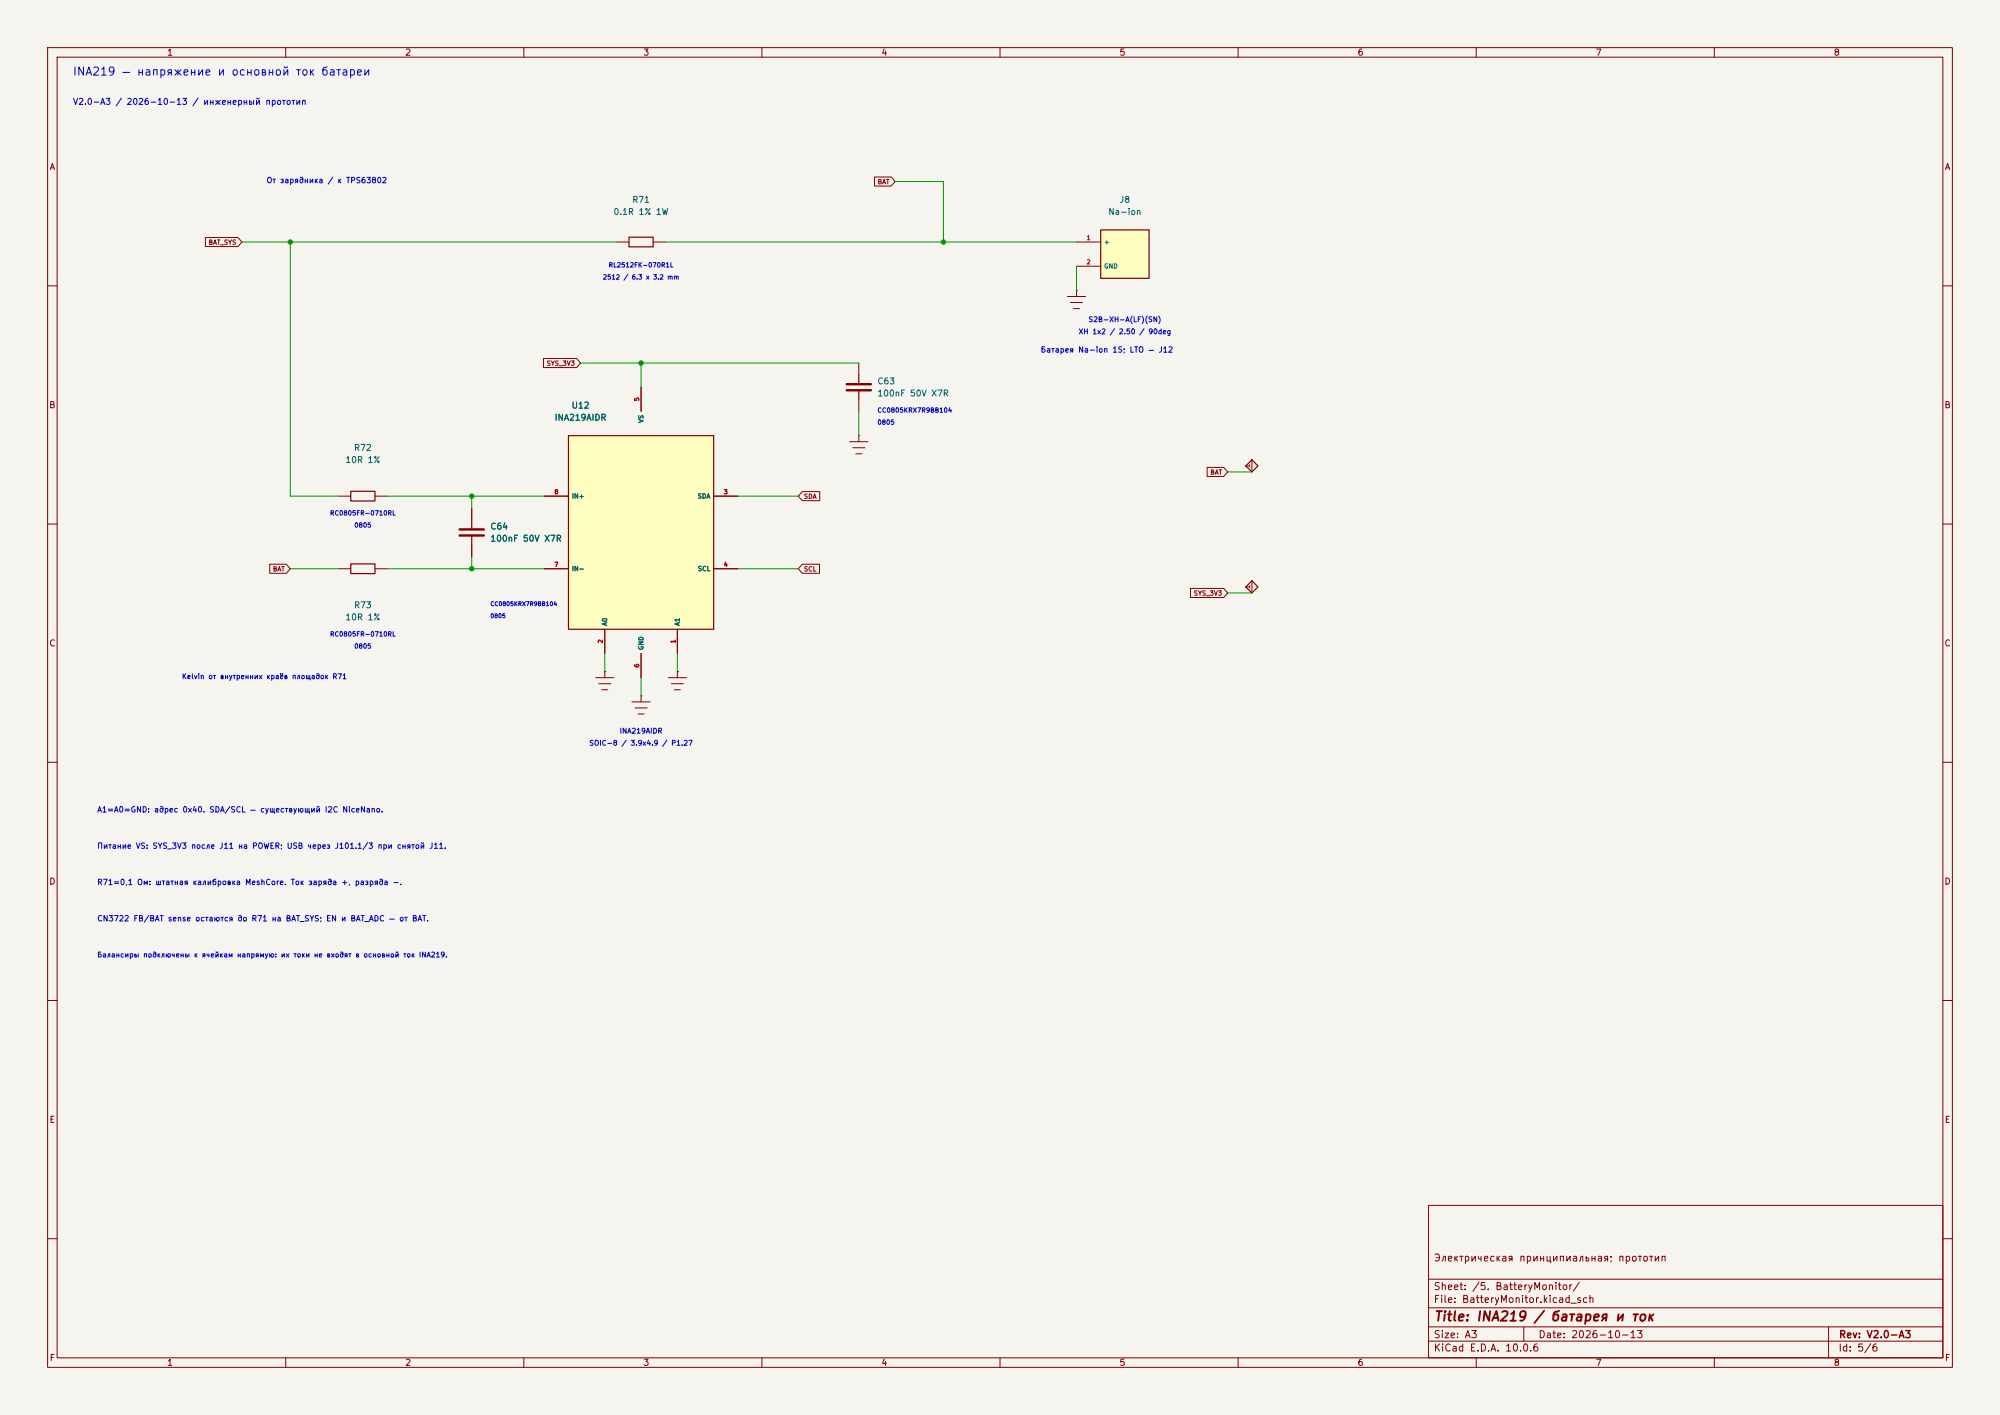
[picture p80: page 5]

INA219 — напряжение и основной ток батареи

Батарея Na-ion 1S; LTO — J12

0805 CC0805KRX7R9BB104 SOIC-8 / 3.9x4.9 / P1.27 R71=0,1 Ом: штатная калибровка MeshCore. Ток заряда +, разряда −. RC0805FR-0710RL Kelvin от внутренних краёв площадок R71

0805 RC0805FR-0710RL Питание VS: SYS_3V3 после J11 на POWER; USB через J101.1/3 при снятой J11. A1=A0=GND: адрес 0x40. SDA/SCL — существующий I2C NiceNano. Балансиры подключены к ячейкам напрямую: их токи не входят в основной ток INA219.

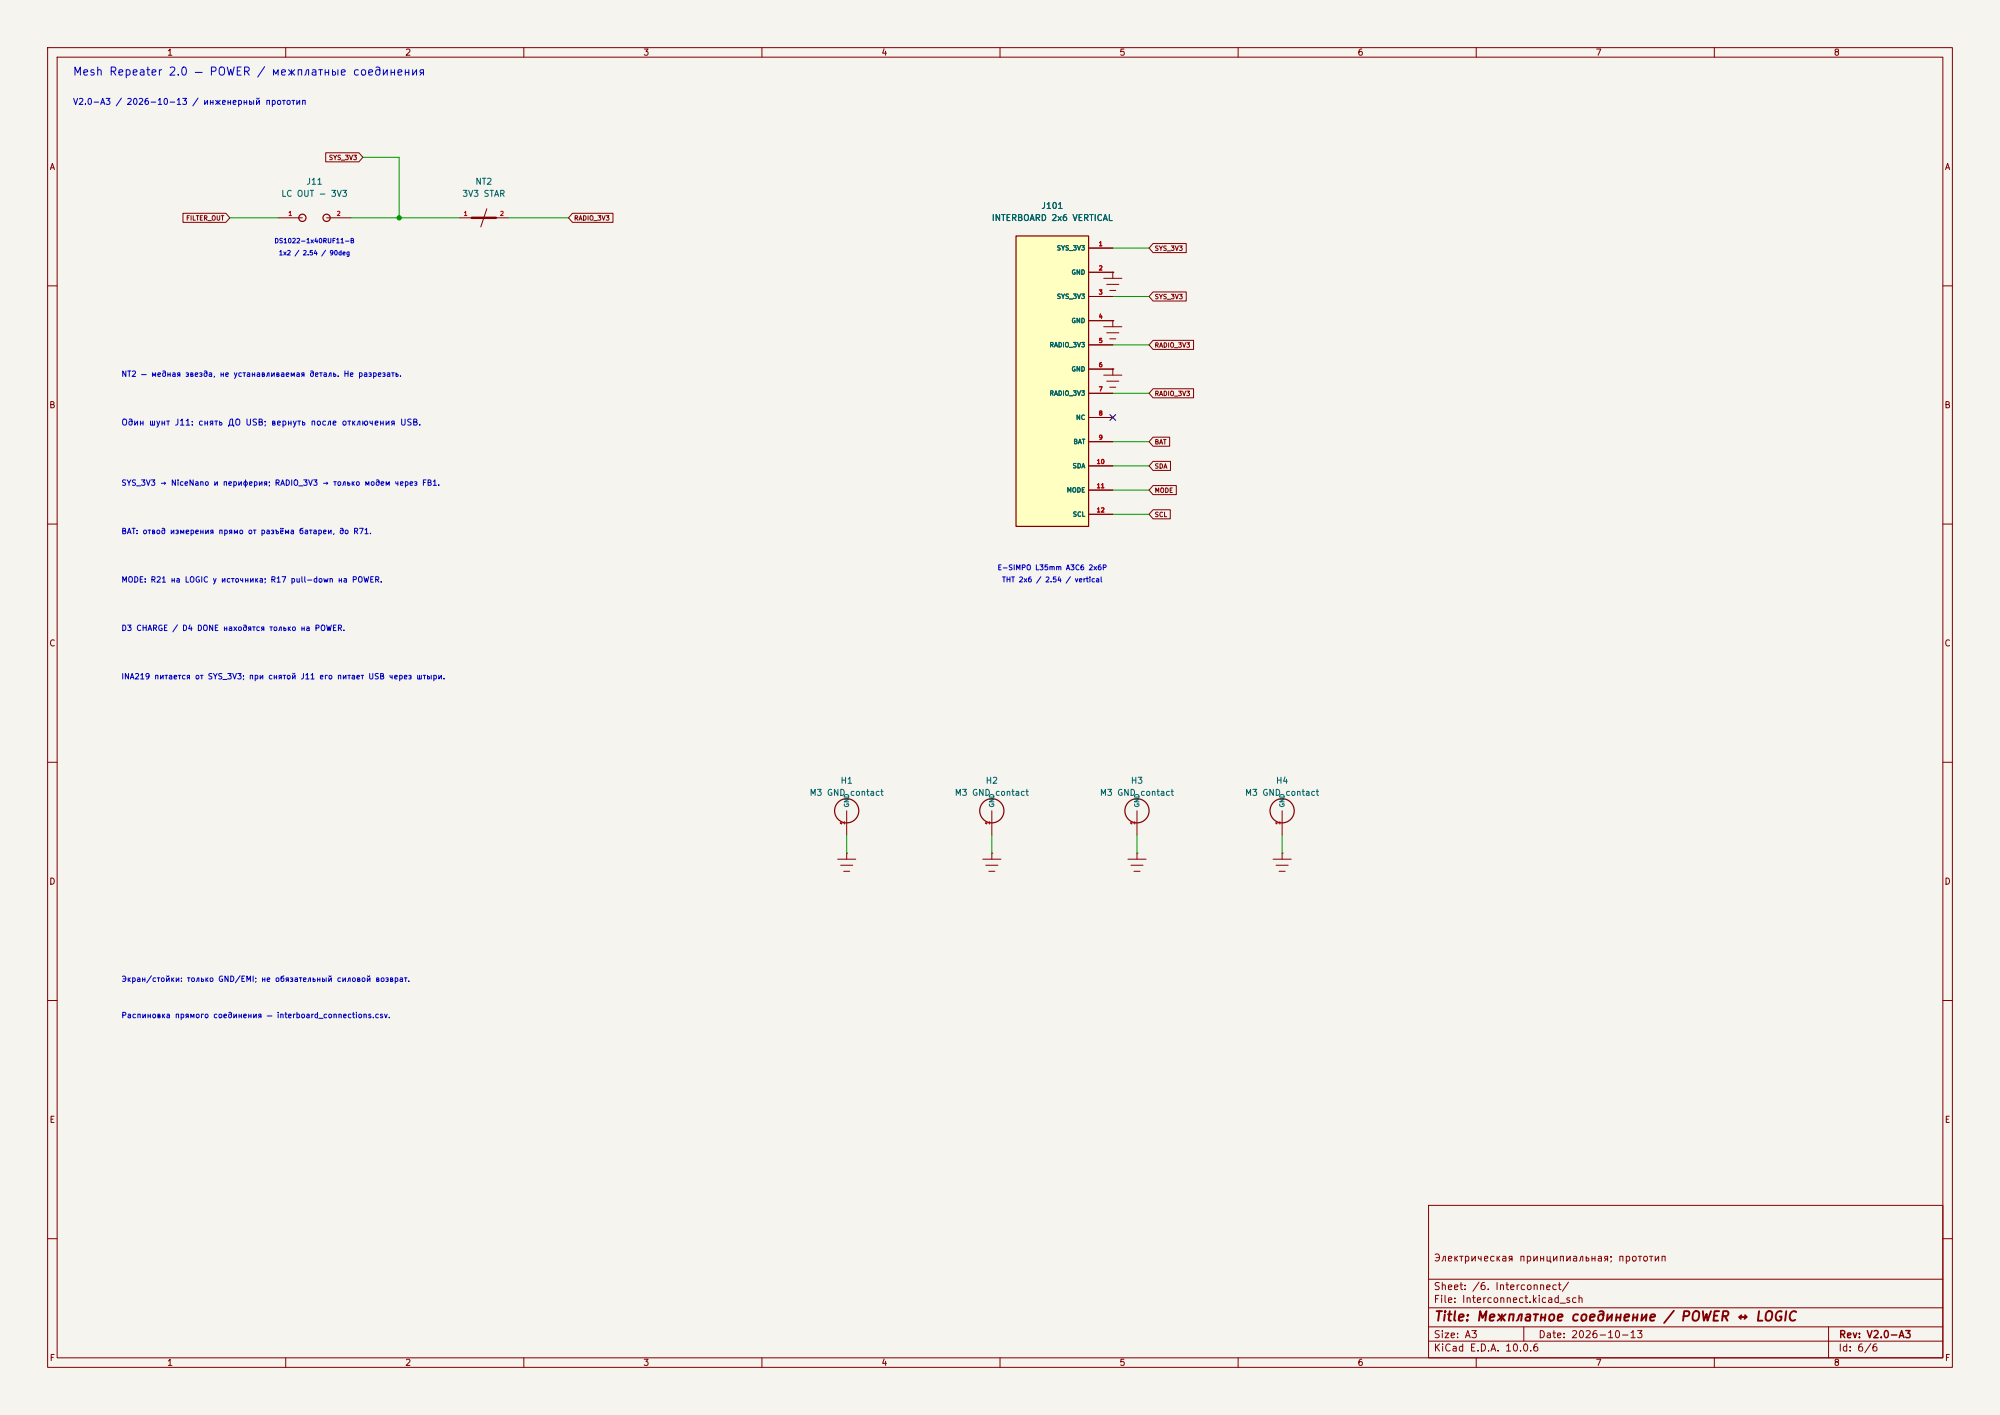
[picture p81: page 6]

1x2 / 2.54 / 90deg Mesh Repeater 2.0 — POWER / межплатные соединения

SYS_3V3 → NiceNano и периферия; RADIO_3V3 → только модем через FB1. DS1022-1x40RUF11-B V2.0-A3 / 2026-10-13 / инженерный прототип

SDA MODE SCL BAT SYS_3V3 RADIO_3V3 RADIO_3V3 RADIO_3V3

BAT: отвод измерения прямо от разъёма батареи, до R71.

INA219 питается от SYS_3V3; при снятой J11 его питает USB через штыри. D3 CHARGE / D4 DONE находятся только на POWER. Экран/стойки: только GND/EMI; не обязательный силовой возврат. MODE: R21 на LOGIC у источника; R17 pull-down на POWER. Распиновка прямого соединения — interboard_connections.csv.

Электрическая принципиальная; прототип GND

Sheet: /6. Interconnect/
File: Interconnect.kicad_sch
Title: Межплатное соединение / POWER ↔ LOGIC
