Alksndr55/mesh-repeater-2.0/v2/output/current/shared_schematic.pdf

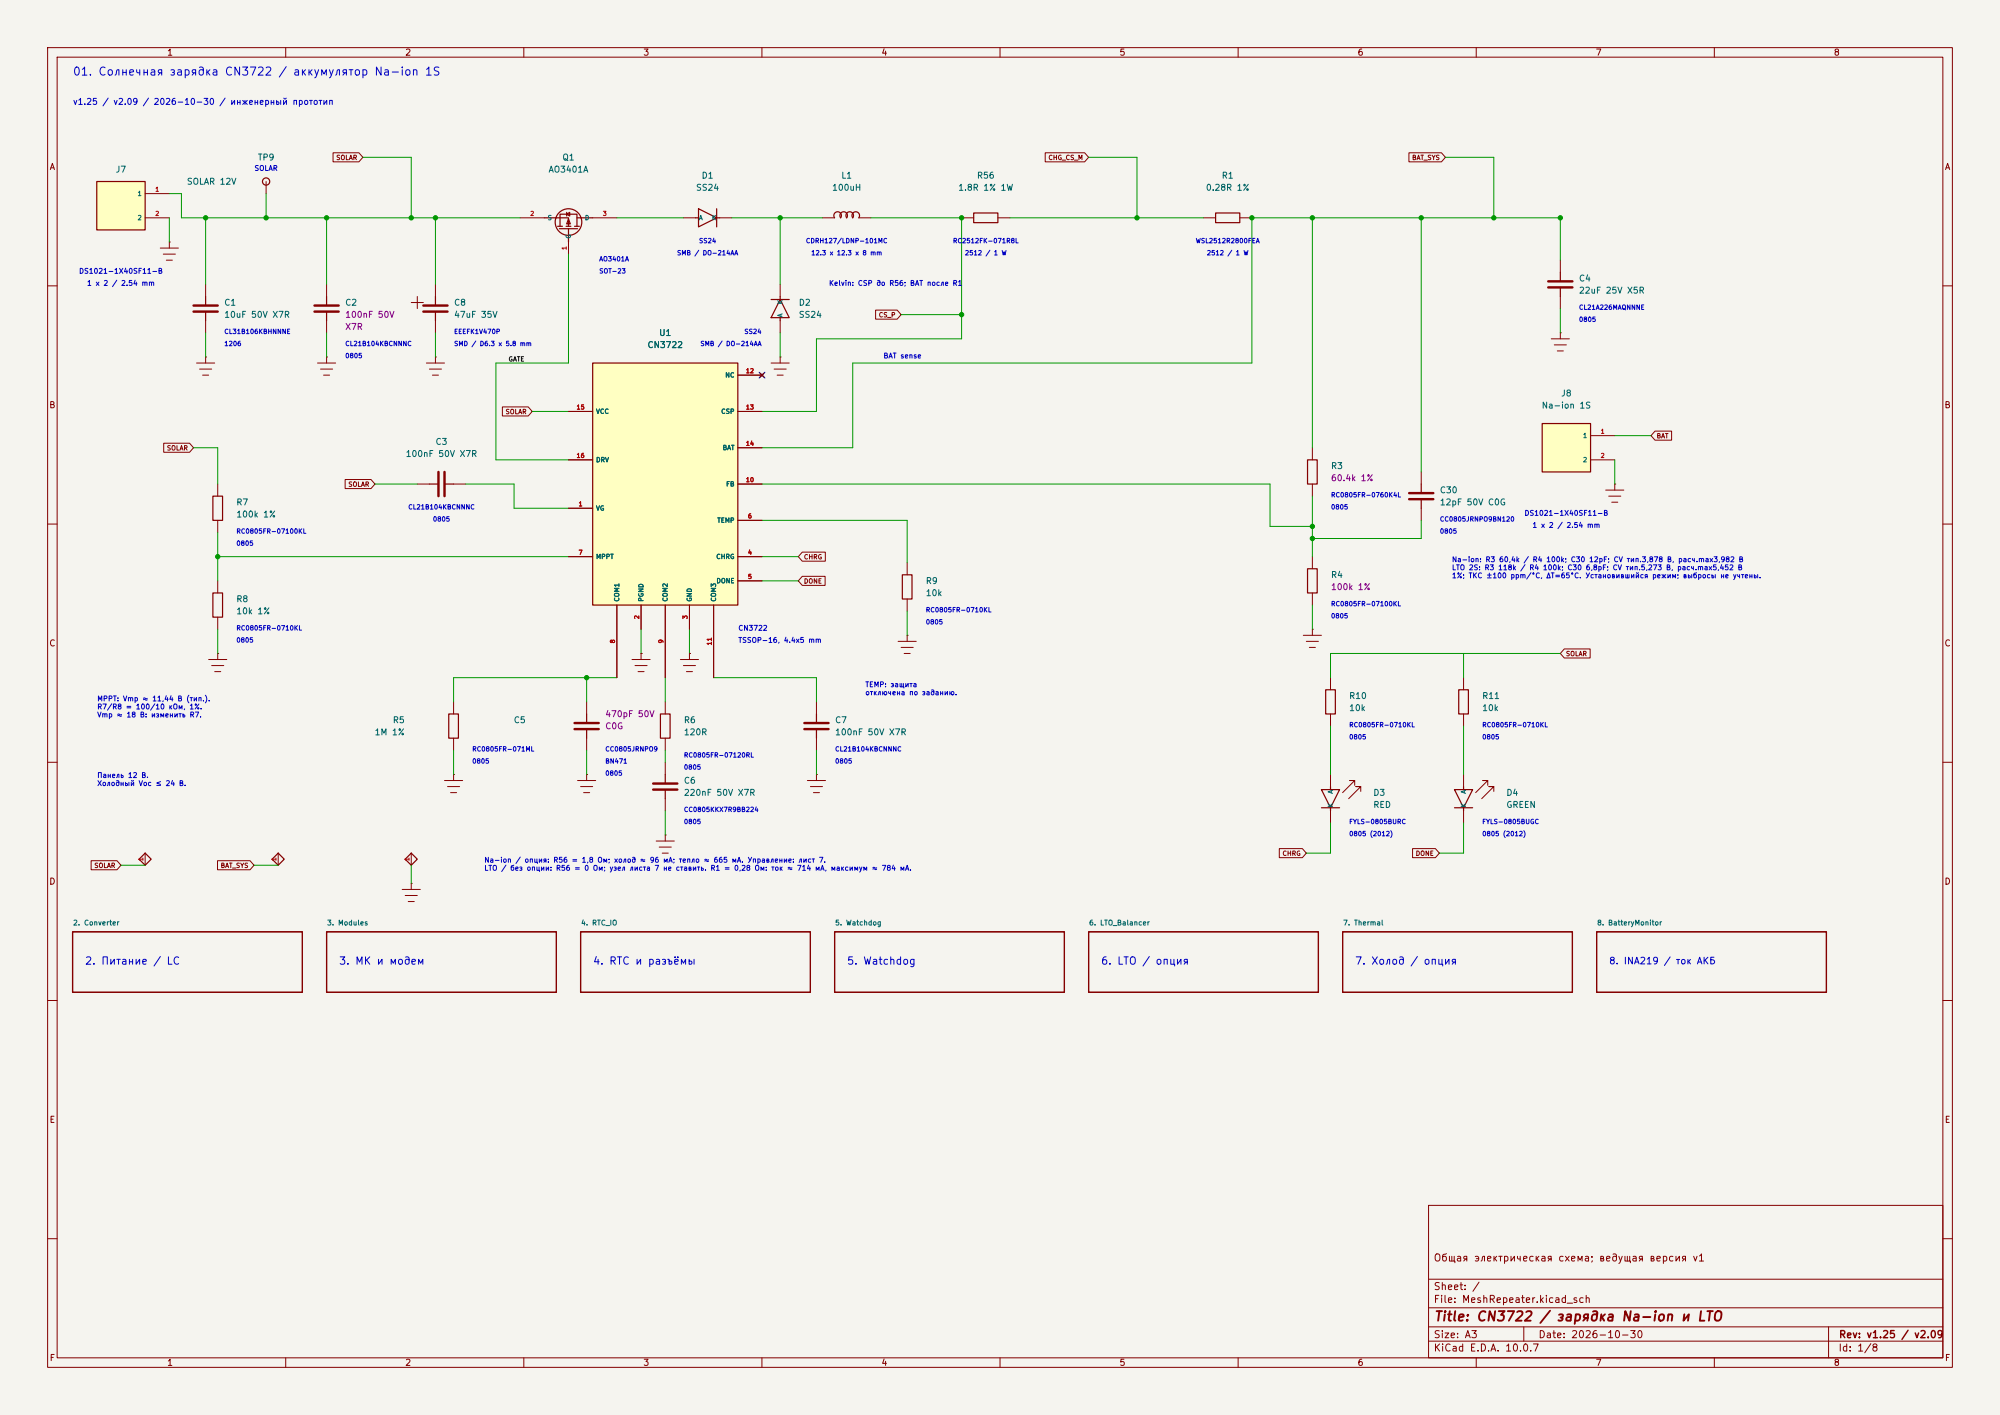
[picture p90: page 1]

0805 Kelvin: CSP до R56; BAT после R1

Na-ion: R3 60,4k / R4 100k; C30 12pF; CV тип.3,878 В, расч.max3,982 В
LTO 2S: R3 118k / R4 100k; C30 6,8pF; CV тип.5,273 В, расч.max5,452 В

1%; ТКС ±100 ppm/°C, ΔT=65°C. Установившийся режим; выбросы не учтены. 6. LTO / опция

отключена по заданию. 4. RTC и разъёмы

BN471 Na-ion / опция: R56 = 1,8 Ом; холод ≈ 96 мА; тепло ≈ 665 мА. Управление: лист 7. LTO / без опции: R56 = 0 Ом; узел листа 7 не ставить. R1 = 0,28 Ом: ток ≈ 714 мА, максимум ≈ 784 мА.

Общая электрическая схема; ведущая версия v1

Sheet: /
File: MeshRepeater.kicad_sch
Title: CN3722 / зарядка Na-ion и LTO

Size: A3 | Rev: v1.25 / v2.09 | F Date: 2026-10-30
KiCad E.D.A. 10.0.7 | Id: 1/8

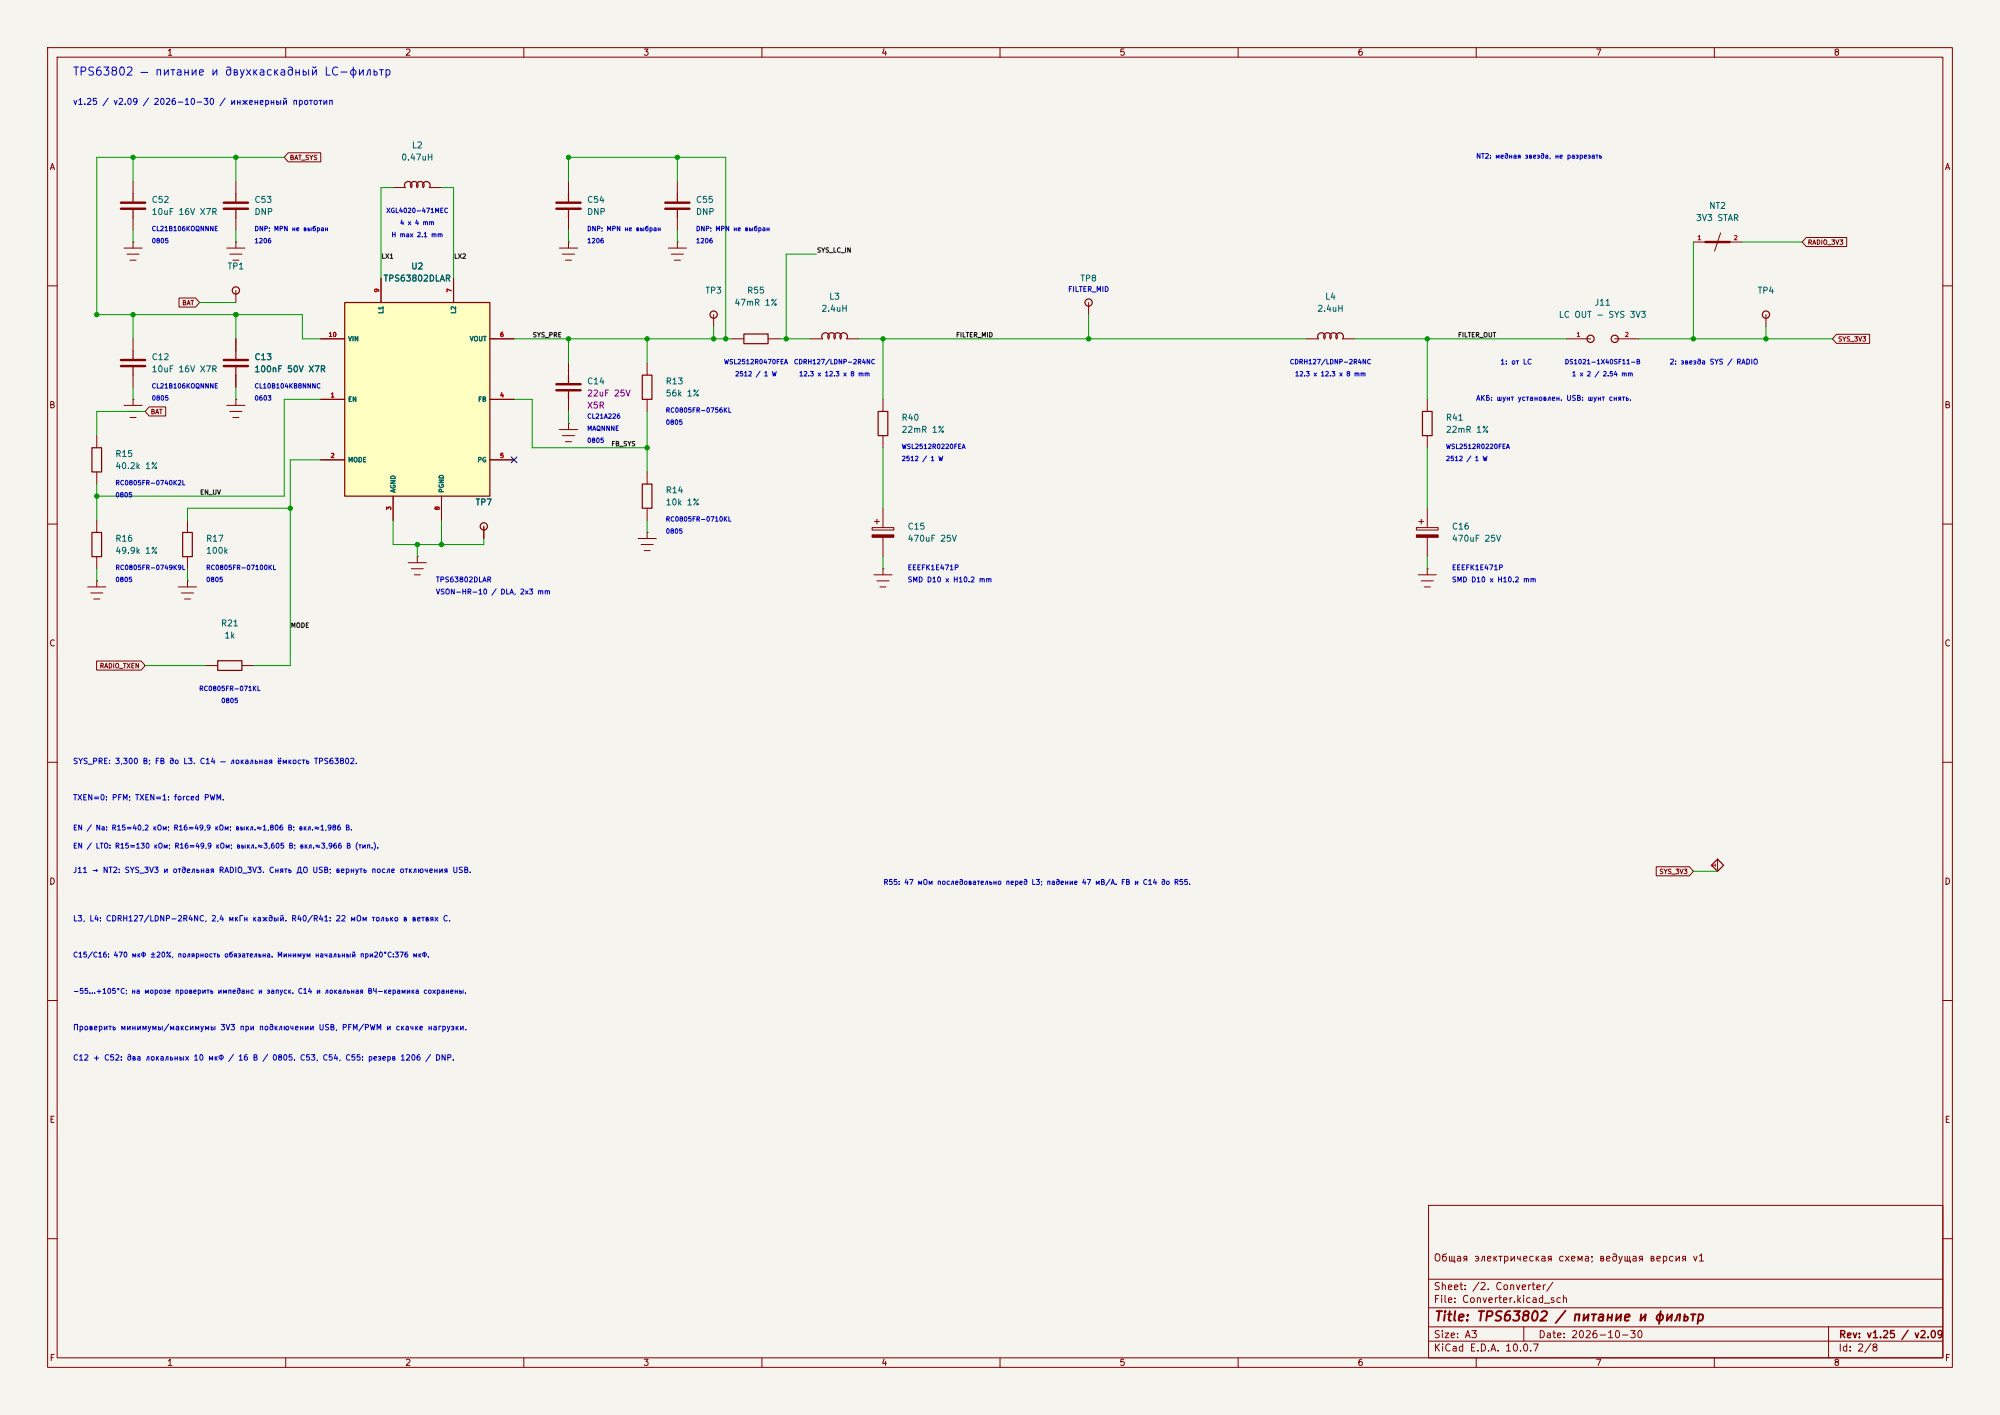
[picture p91: page 2]

АКБ: шунт установлен. USB: шунт снять. 1 x 2 / 2.54 mm

VSON-HR-10 / DLA, 2x3 mm

Проверить минимумы/максимумы 3V3 при подключении USB, PFM/PWM и скачке нагрузки. C12 + C52: два локальных 10 мкФ / 16 В / 0805. C53, C54, C55: резерв 1206 / DNP. J11 → NT2: SYS_3V3 и отдельная RADIO_3V3. Снять ДО USB; вернуть после отключения USB. L3, L4: CDRH127/LDNP-2R4NC, 2,4 мкГн каждый. R40/R41: 22 мОм только в ветвях C. C15/C16: 470 мкФ ±20%, полярность обязательна. Минимум начальный при20°C:376 мкФ. −55…+105°C; на морозе проверить импеданс и запуск. C14 и локальная ВЧ-керамика сохранены.

R55: 47 мОм последовательно перед L3; падение 47 мВ/А. FB и C14 до R55.

Общая электрическая схема; ведущая версия v1

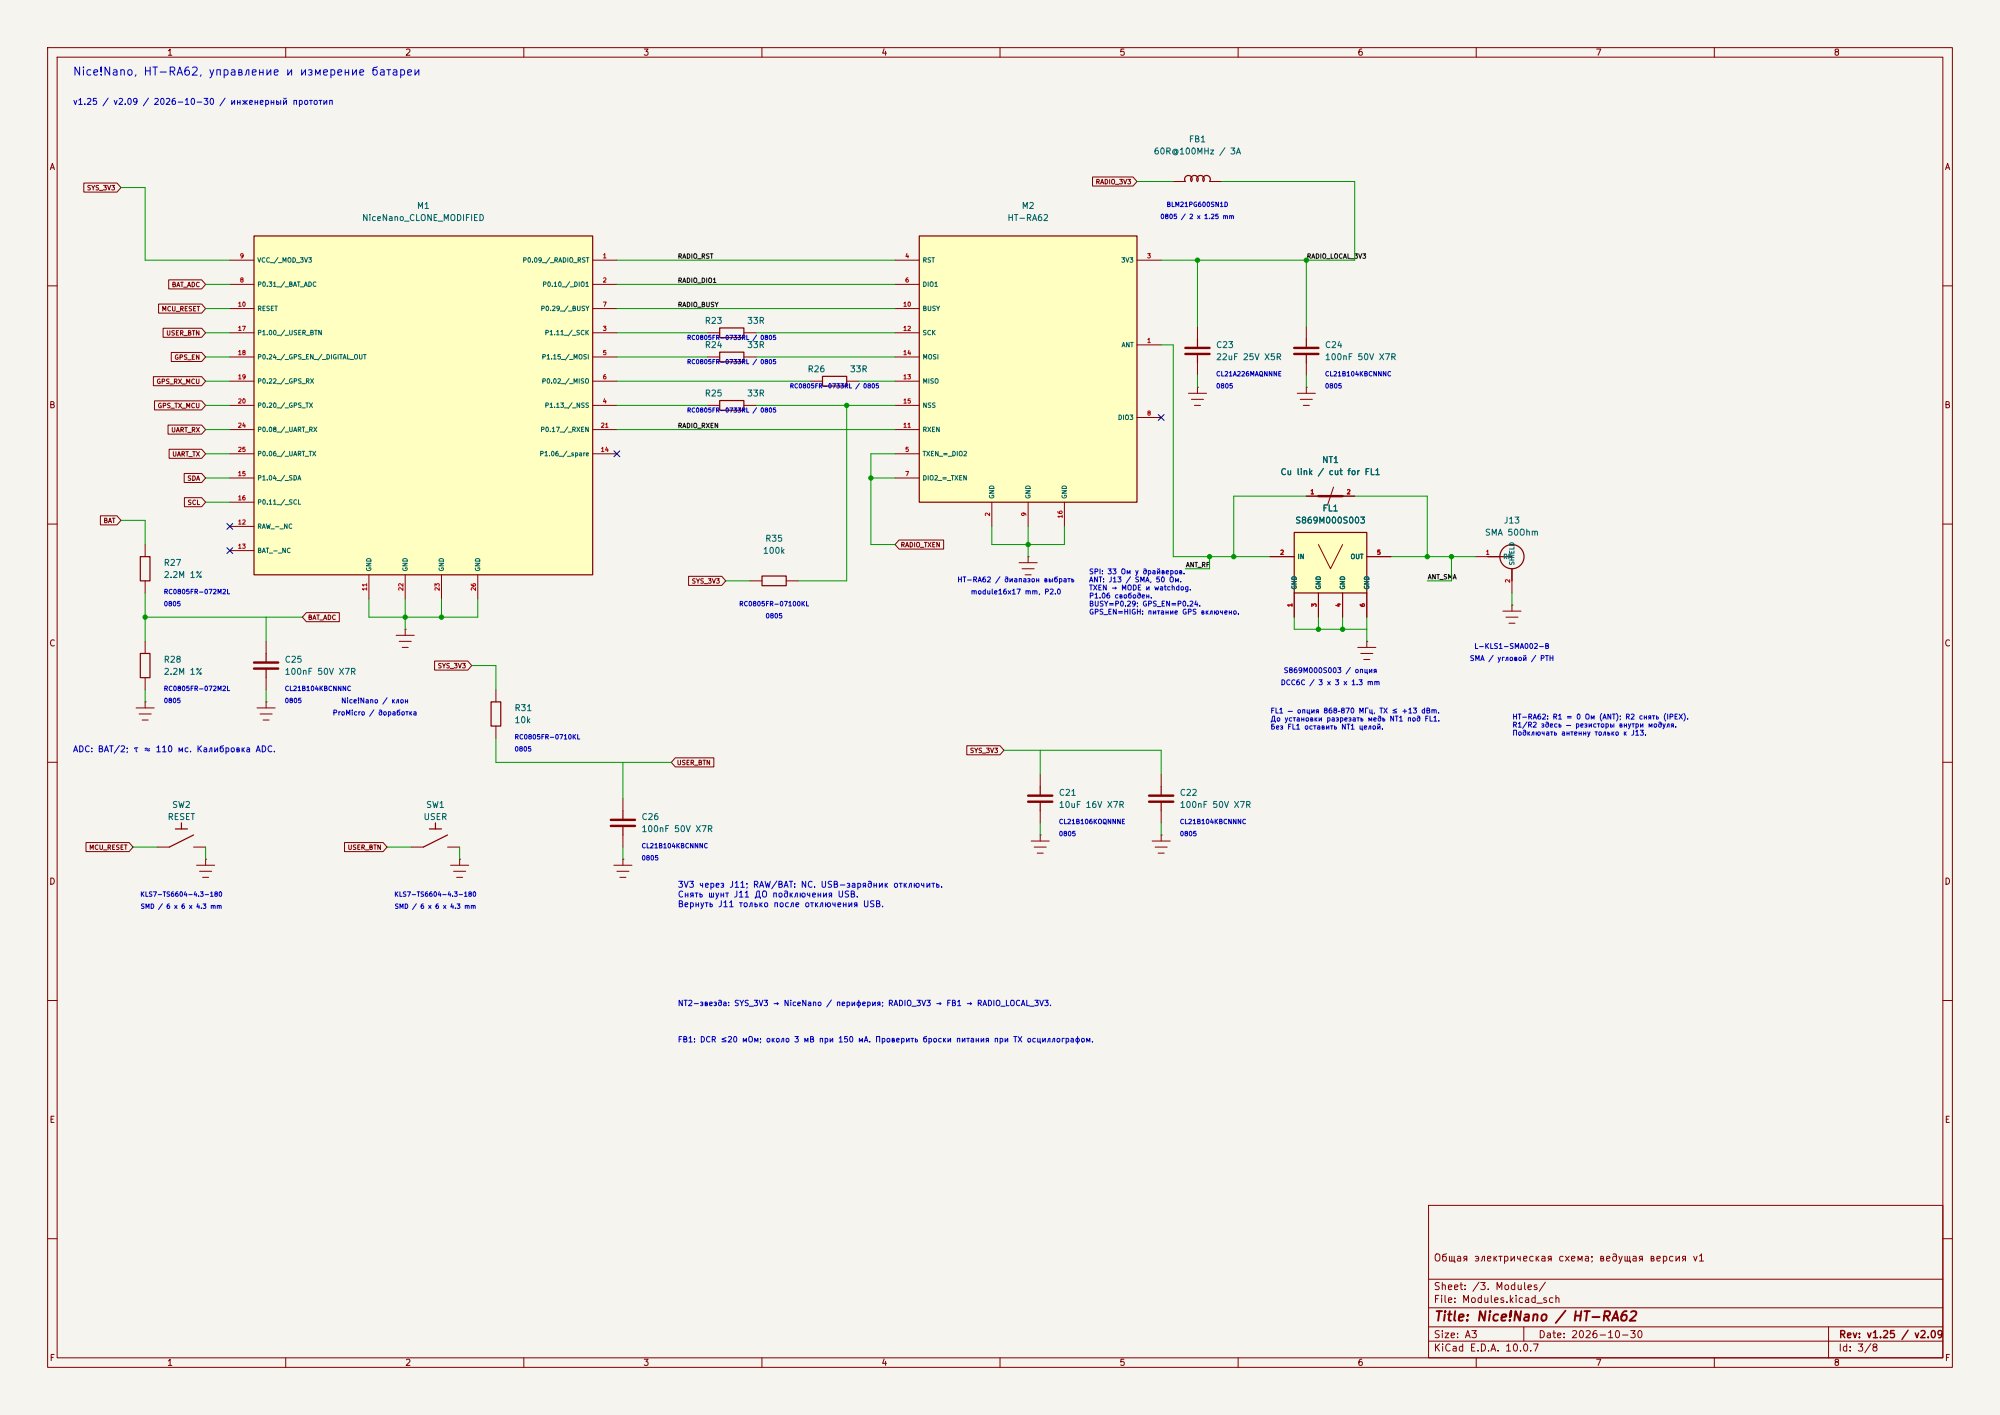
[picture p92: page 3]

9 BUSY 10 RXEN 11 SCK 12 MISO 13 MOSI 14 NSS 15 GND 16 M2 HT-RA62

CL21A226MAQNNNE FL1 — опция 868–870 МГц, TX ≤ +13 dBm. До установки разрезать медь NT1 под FL1. Без FL1 оставить NT1 целой. S869M000S003 / опция DCC6C / 3 x 3 x 1.3 mm

Общая электрическая схема; ведущая версия v1

Sheet: /3. Modules/
File: Modules.kicad_sch
Title: Nice!Nano / HT-RA62

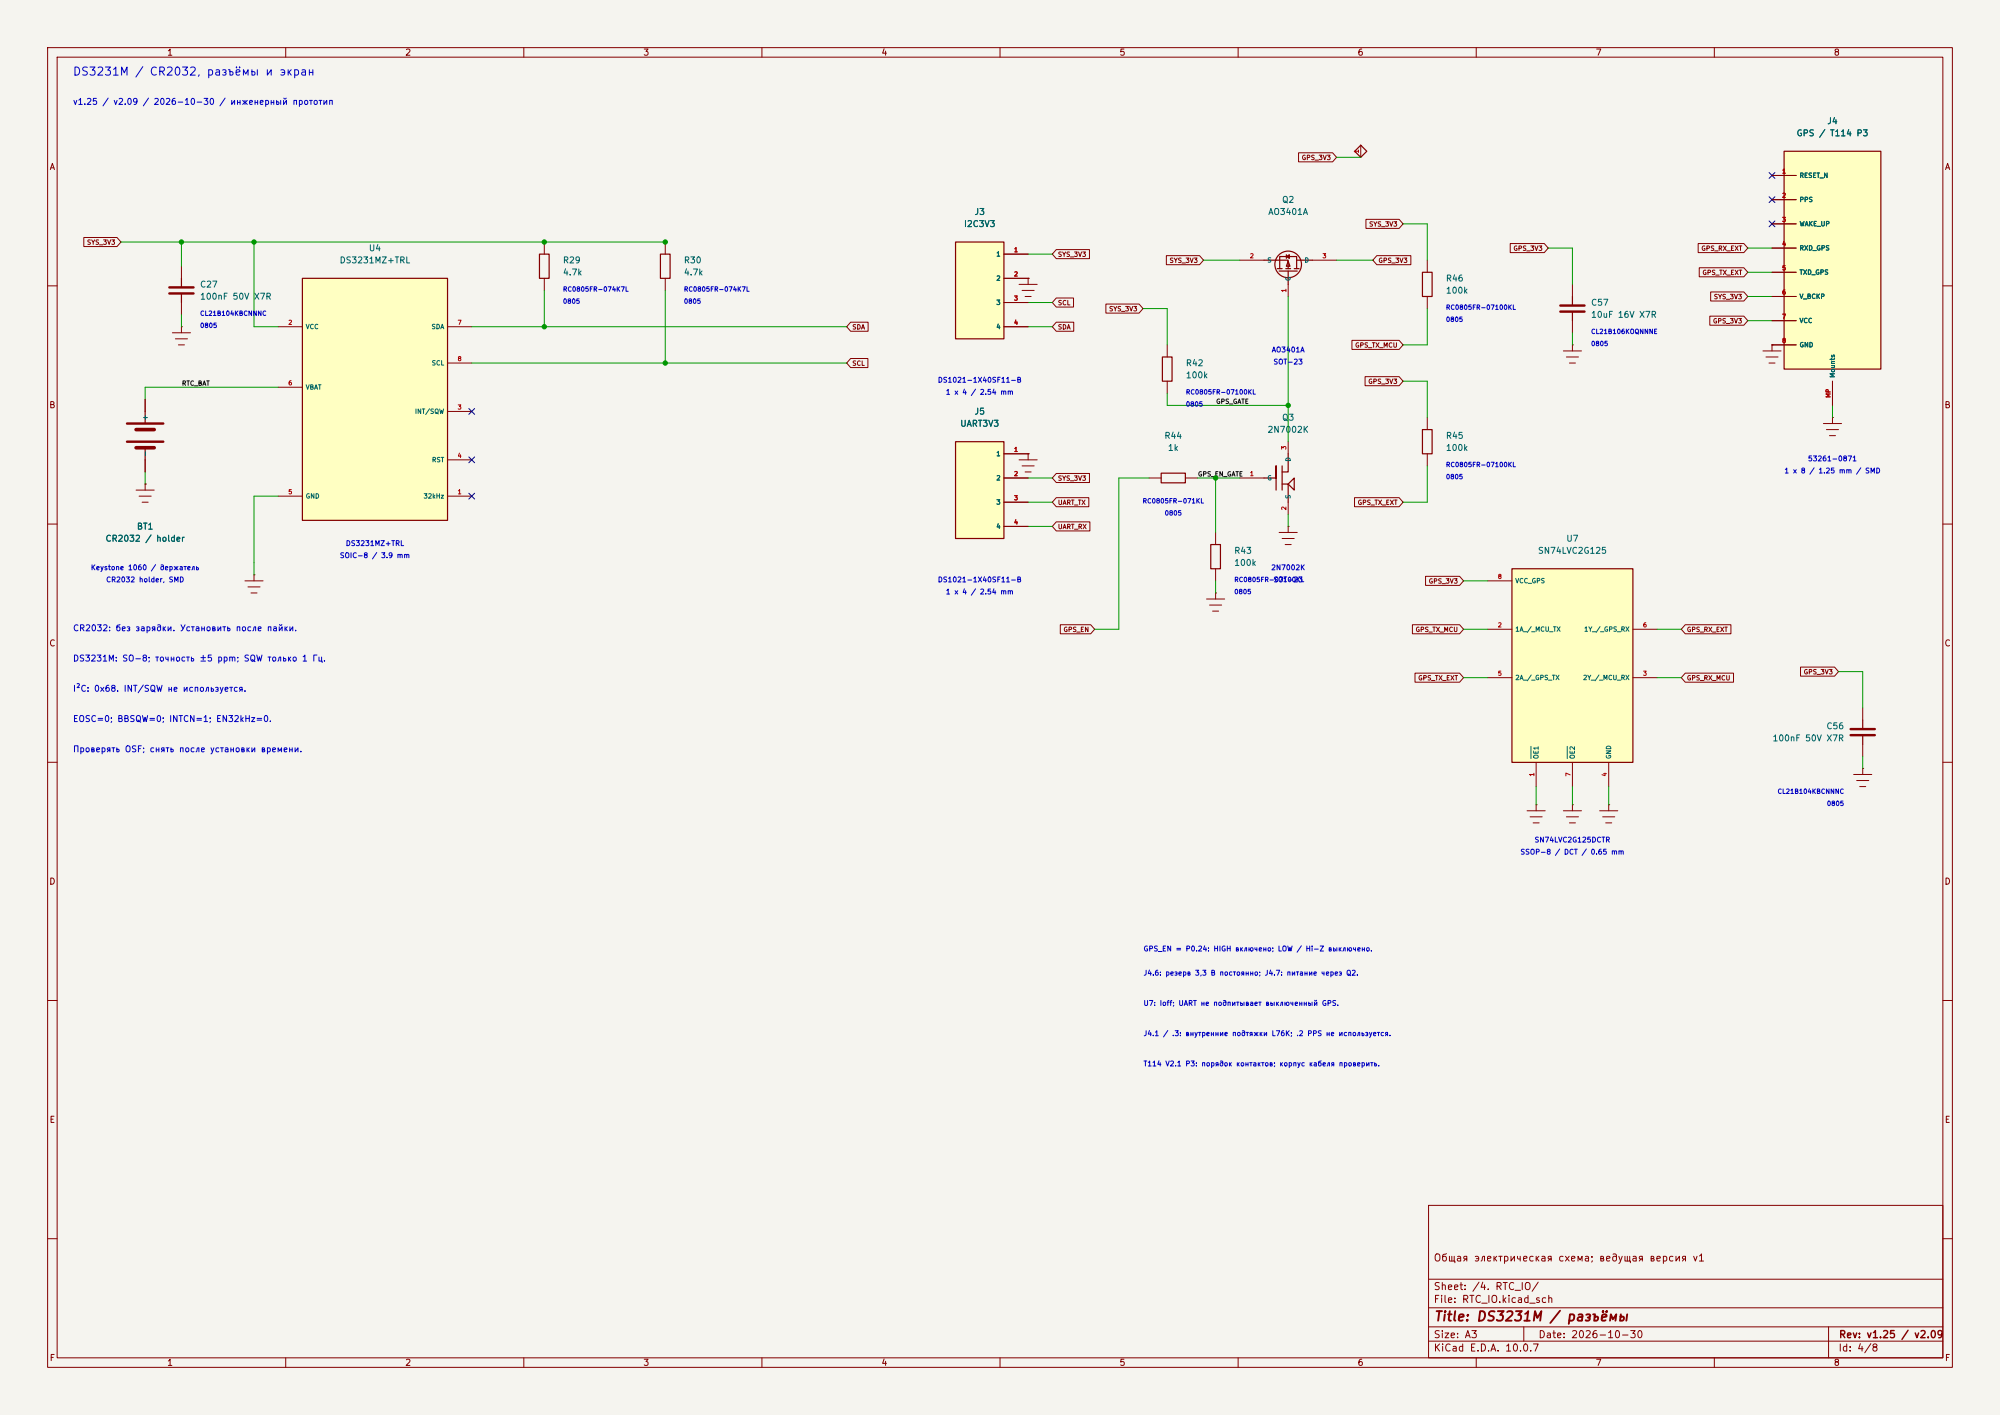
[picture p93: page 4]

DS1021-1X40SF11-B DS3231M: SO-8; точность ±5 ppm; SQW только 1 Гц.

I²C: 0x68. INT/SQW не используется.

J4.1 / .3: внутренние подтяжки L76K; .2 PPS не используется. GPS_EN = P0.24: HIGH включено; LOW / Hi-Z выключено.

J4.6: резерв 3,3 В постоянно; J4.7: питание через Q2.

T114 V2.1 P3: порядок контактов; корпус кабеля проверить. U7: Ioff; UART не подпитывает выключенный GPS.

Общая электрическая схема; ведущая версия v1

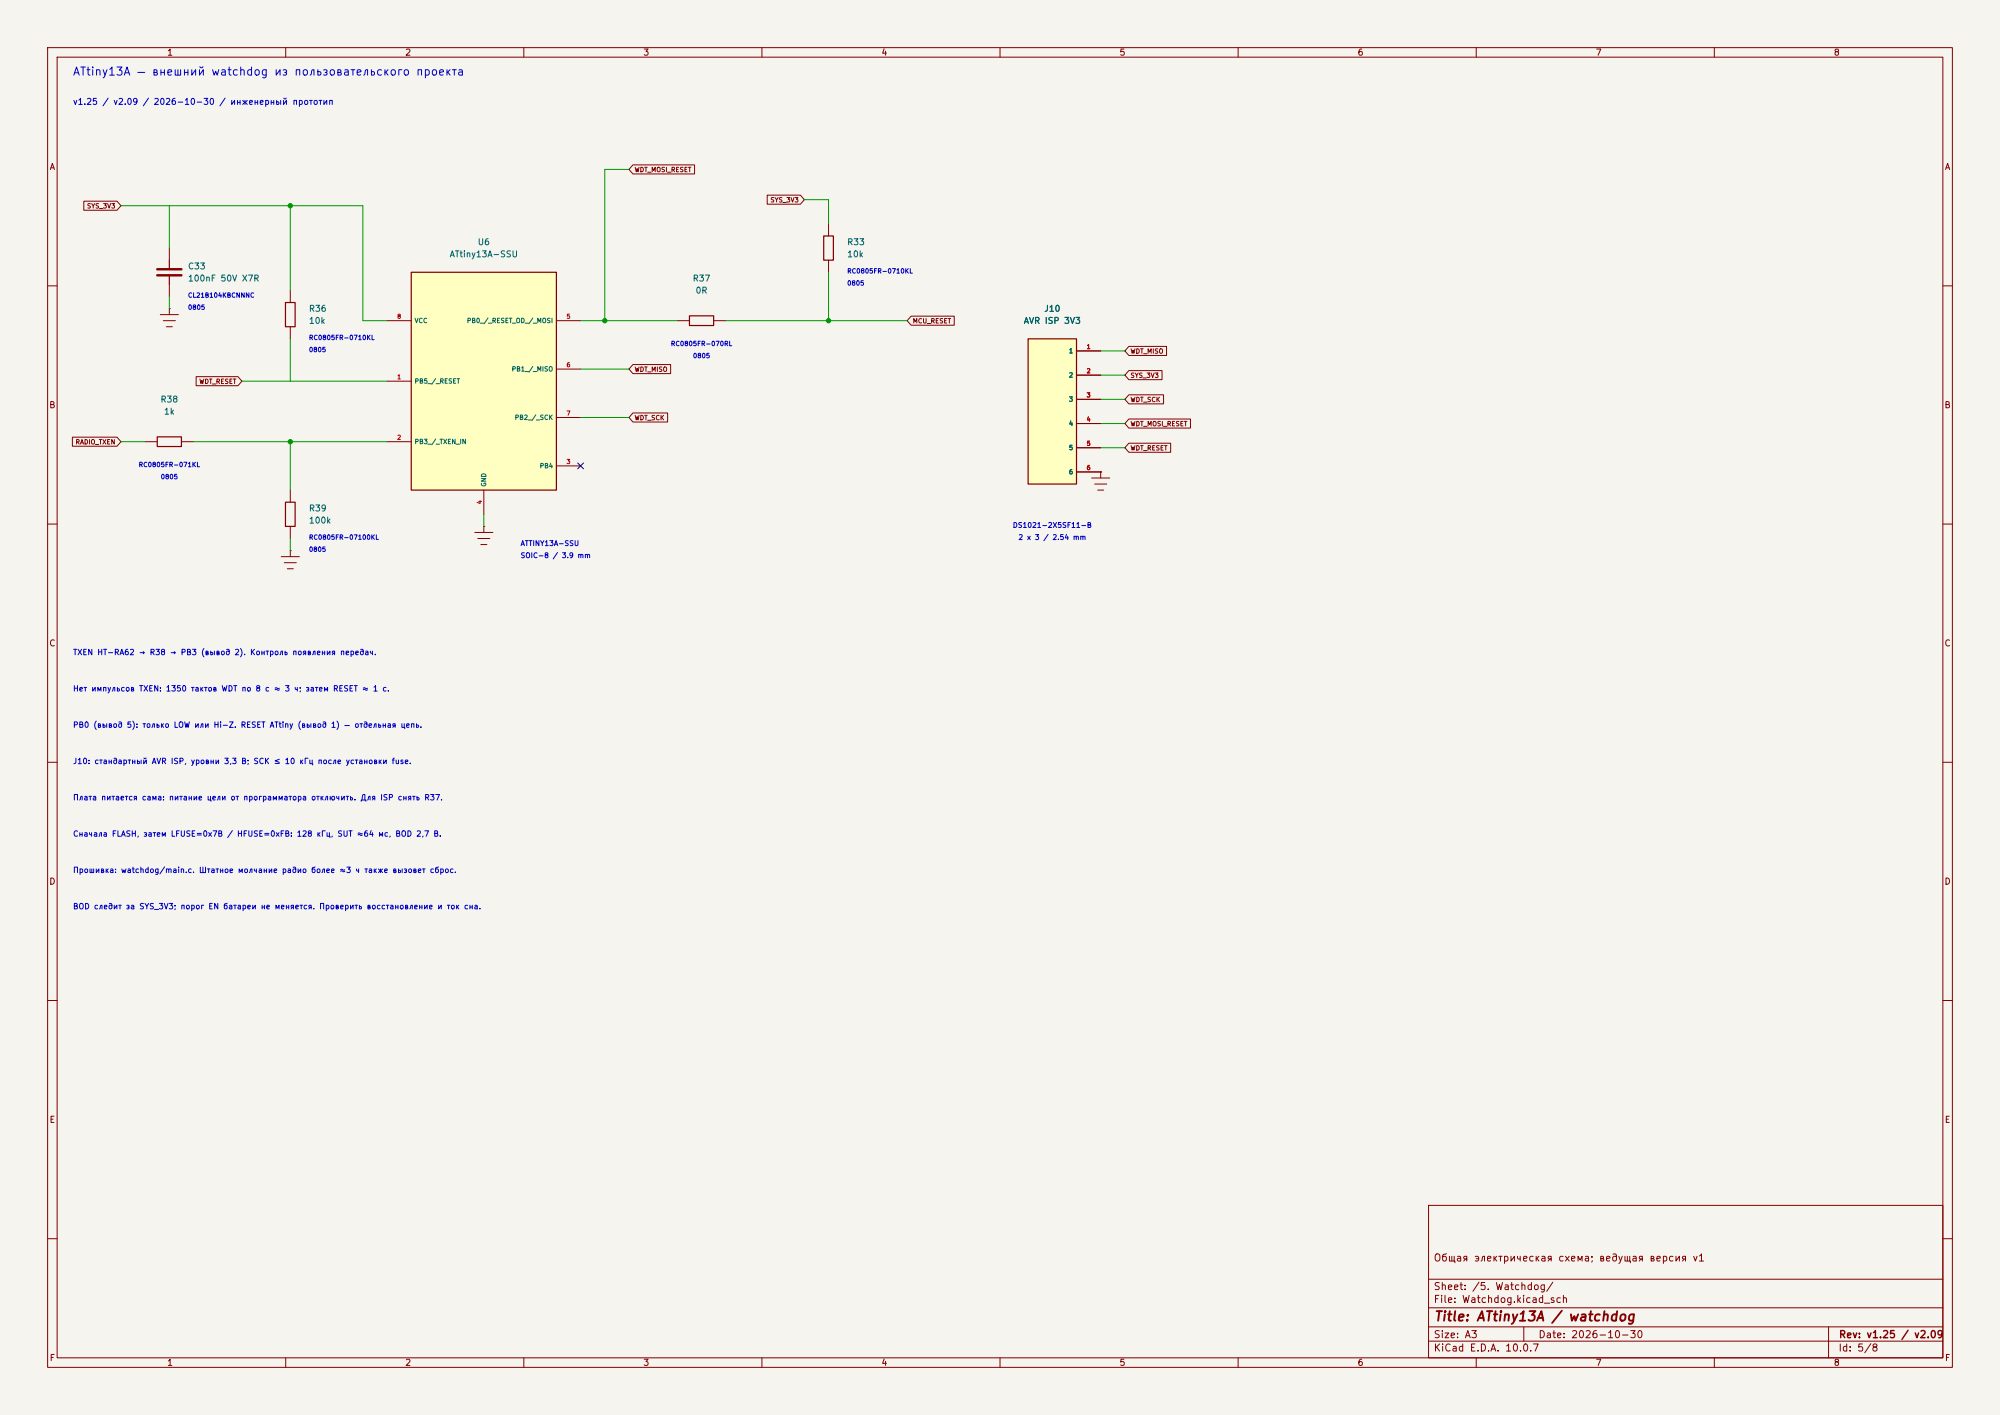
[picture p94: page 5]

RC0805FR-0710KL ATtiny13A — внешний watchdog из пользовательского проекта

RC0805FR-07100KL Нет импульсов TXEN: 1350 тактов WDT по 8 с ≈ 3 ч; затем RESET ≈ 1 с. Прошивка: watchdog/main.c. Штатное молчание радио более ≈3 ч также вызовет сброс. Сначала FLASH, затем LFUSE=0x7B / HFUSE=0xFB: 128 кГц, SUT ≈64 мс, BOD 2,7 В.

Общая электрическая схема; ведущая версия v1

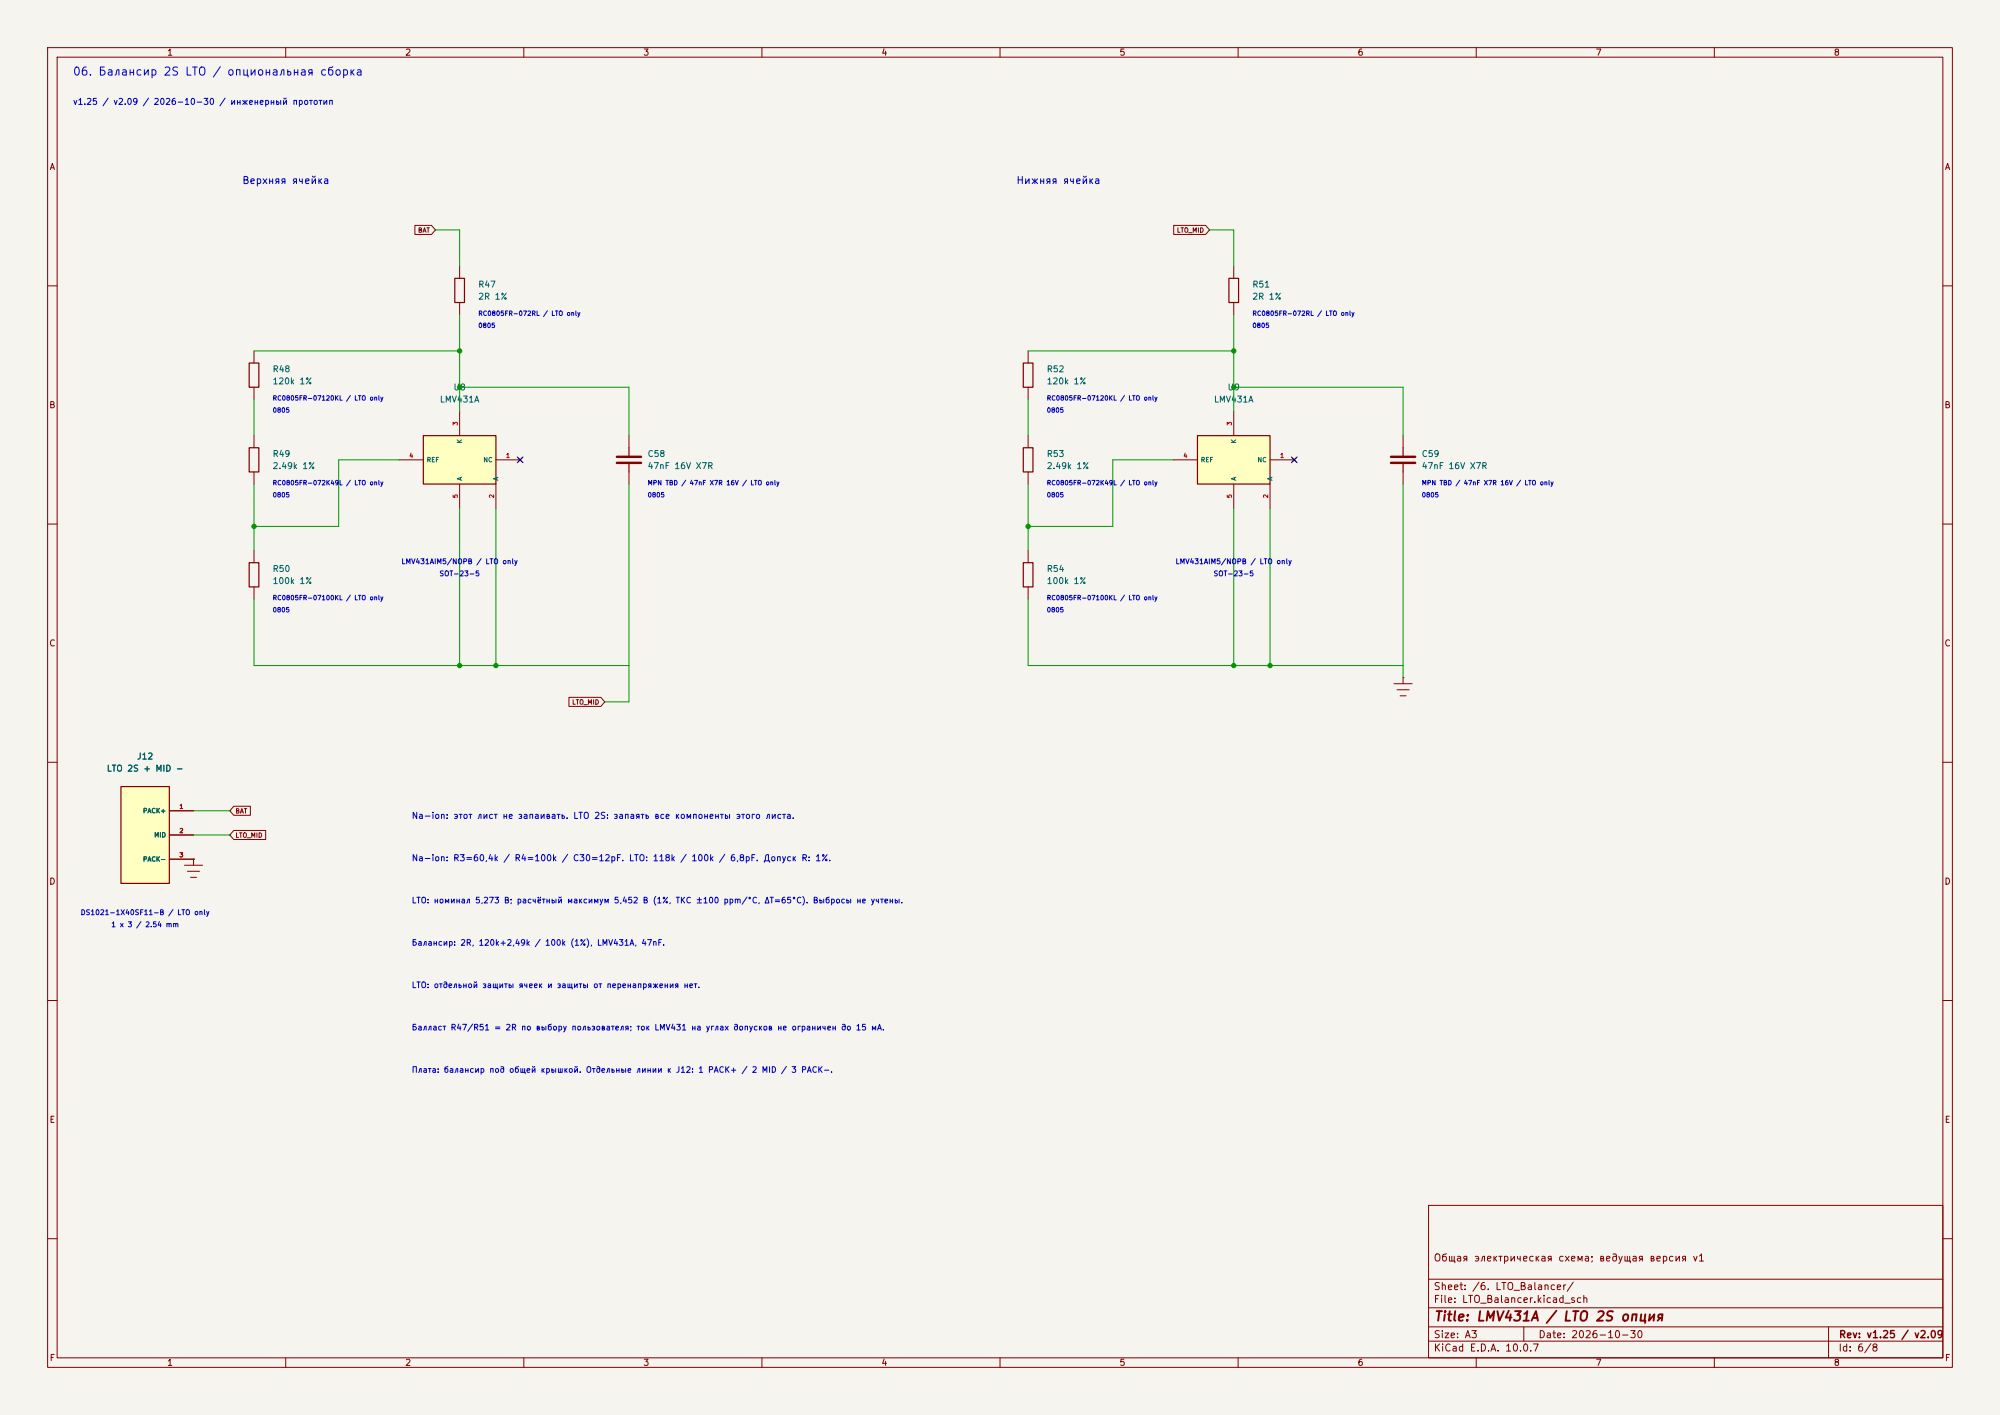
[picture p95: page 6]

v1.25 / v2.09 / 2026-10-30 / инженерный прототип 06. Балансир 2S LTO / опциональная сборка

LMV431AIM5/NOPB / LTO only 0805 RC0805FR-072RL / LTO only

LTO: отдельной защиты ячеек и защиты от перенапряжения нет. Плата: балансир под общей крышкой. Отдельные линии к J12: 1 PACK+ / 2 MID / 3 PACK-. LTO: номинал 5,273 В; расчётный максимум 5,452 В (1%, ТКС ±100 ppm/°C, ΔT=65°C). Выбросы не учтены. Балласт R47/R51 = 2R по выбору пользователя; ток LMV431 на углах допусков не ограничен до 15 мА. Балансир: 2R, 120k+2,49k / 100k (1%), LMV431A, 47nF.

Общая электрическая схема; ведущая версия v1

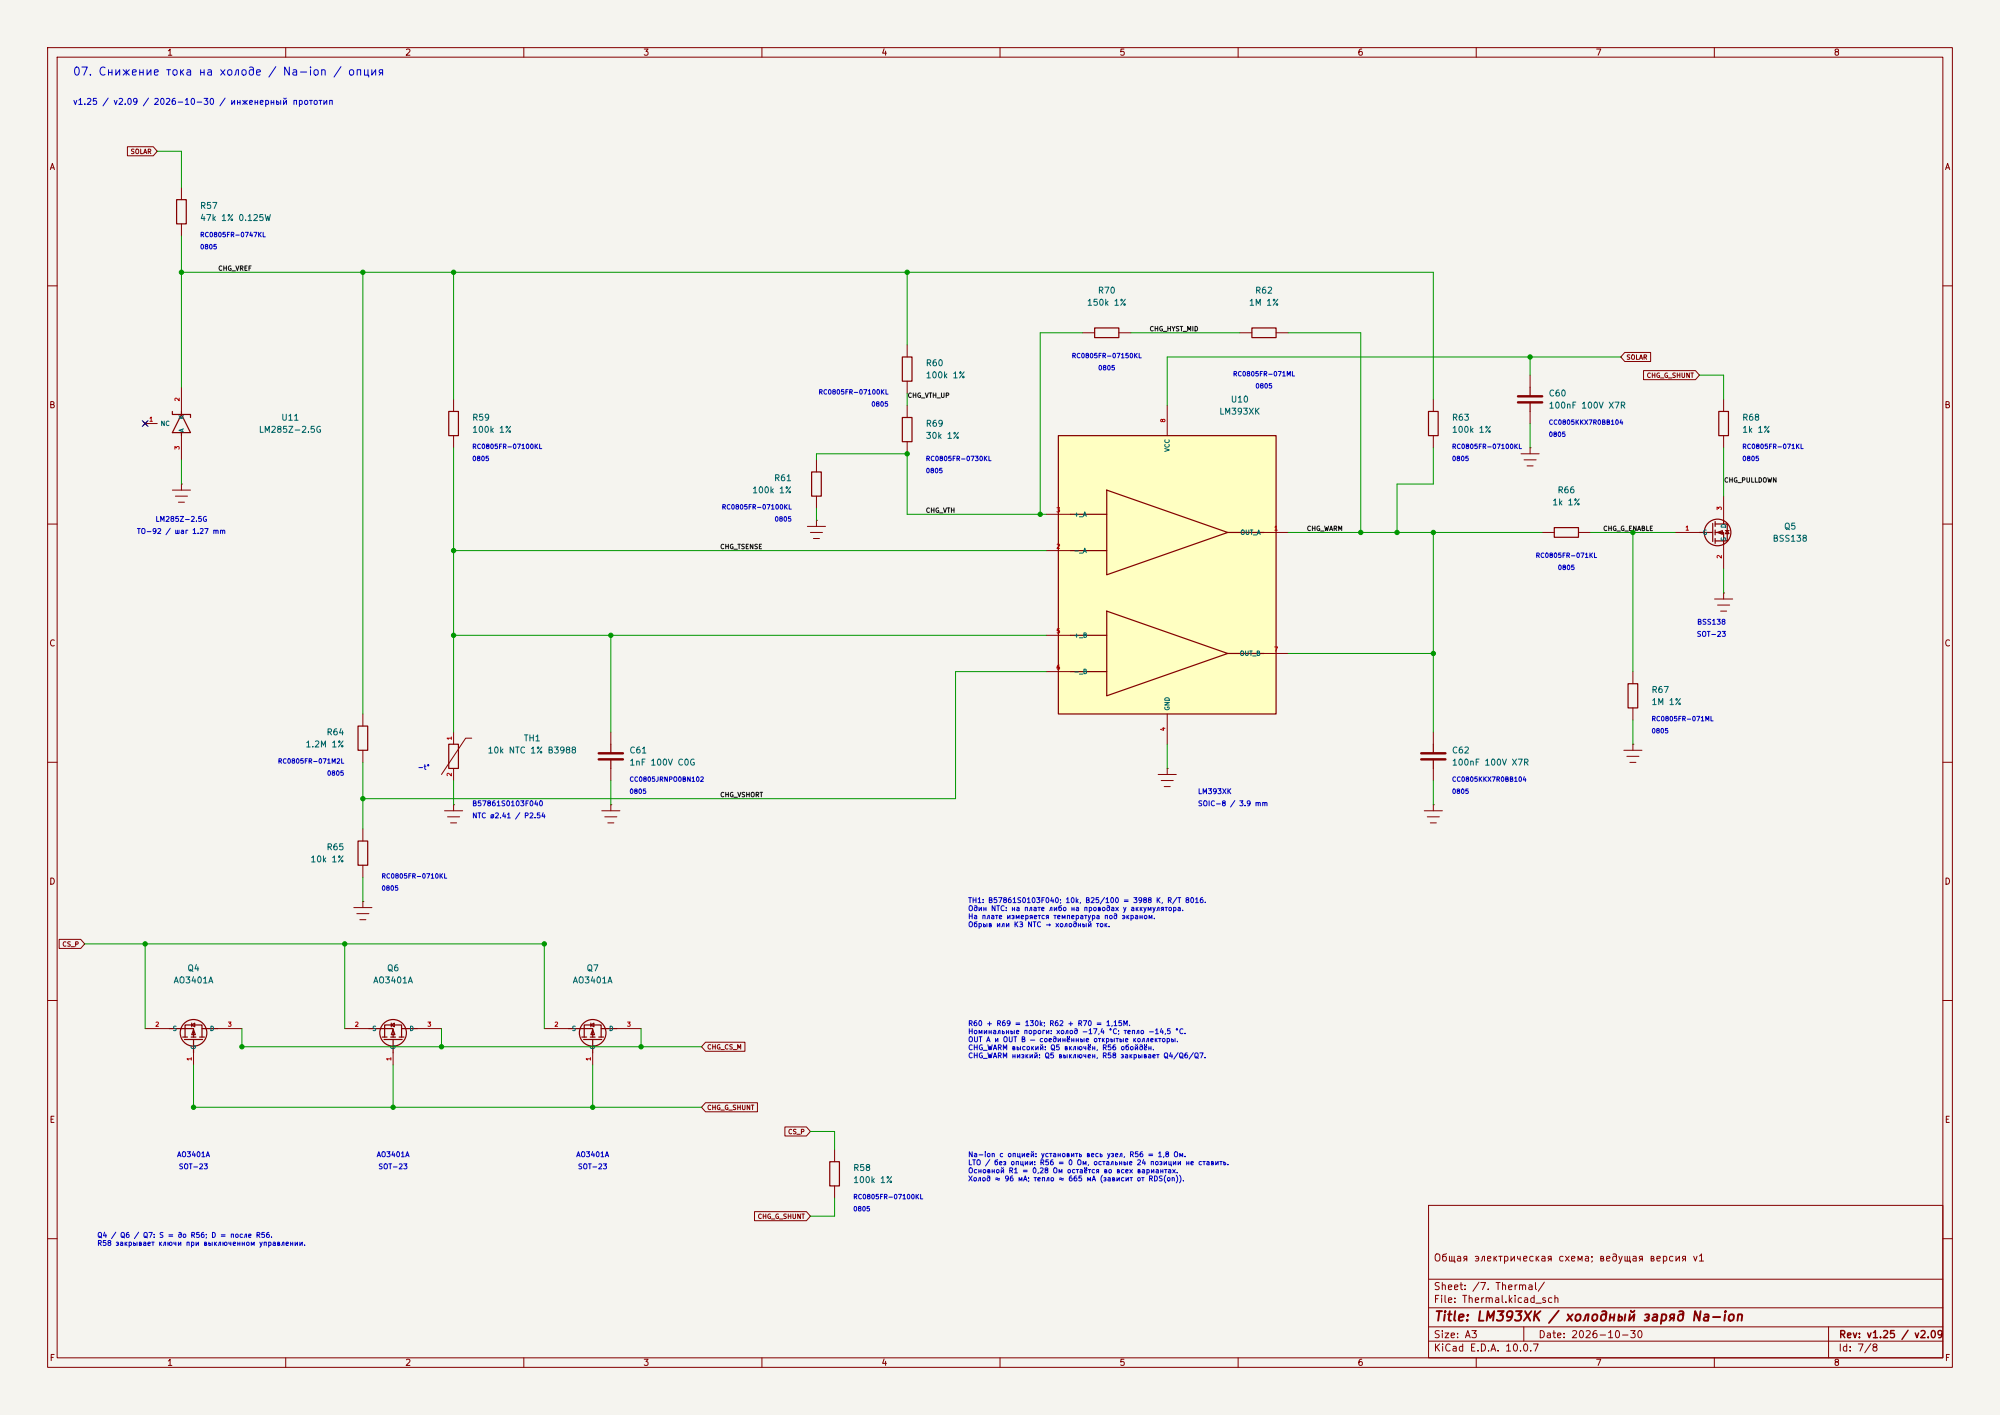
[picture p96: page 7]

07. Снижение тока на холоде / Na-ion / опция

0805 Q4 / Q6 / Q7: S = до R56; D = после R56. R58 закрывает ключи при выключенном управлении.

R60 + R69 = 130k; R62 + R70 = 1,15M. Номинальные пороги: холод −17,4 °C; тепло −14,5 °C. OUT A и OUT B — соединённые открытые коллекторы. CHG_WARM высокий: Q5 включён, R56 обойдён. CHG_WARM низкий: Q5 выключен, R58 закрывает Q4/Q6/Q7.

Общая электрическая схема; ведущая версия v1

Sheet: /7. Thermal/
File: Thermal.kicad_sch
Title: LM393XK / холодный заряд Na-ion

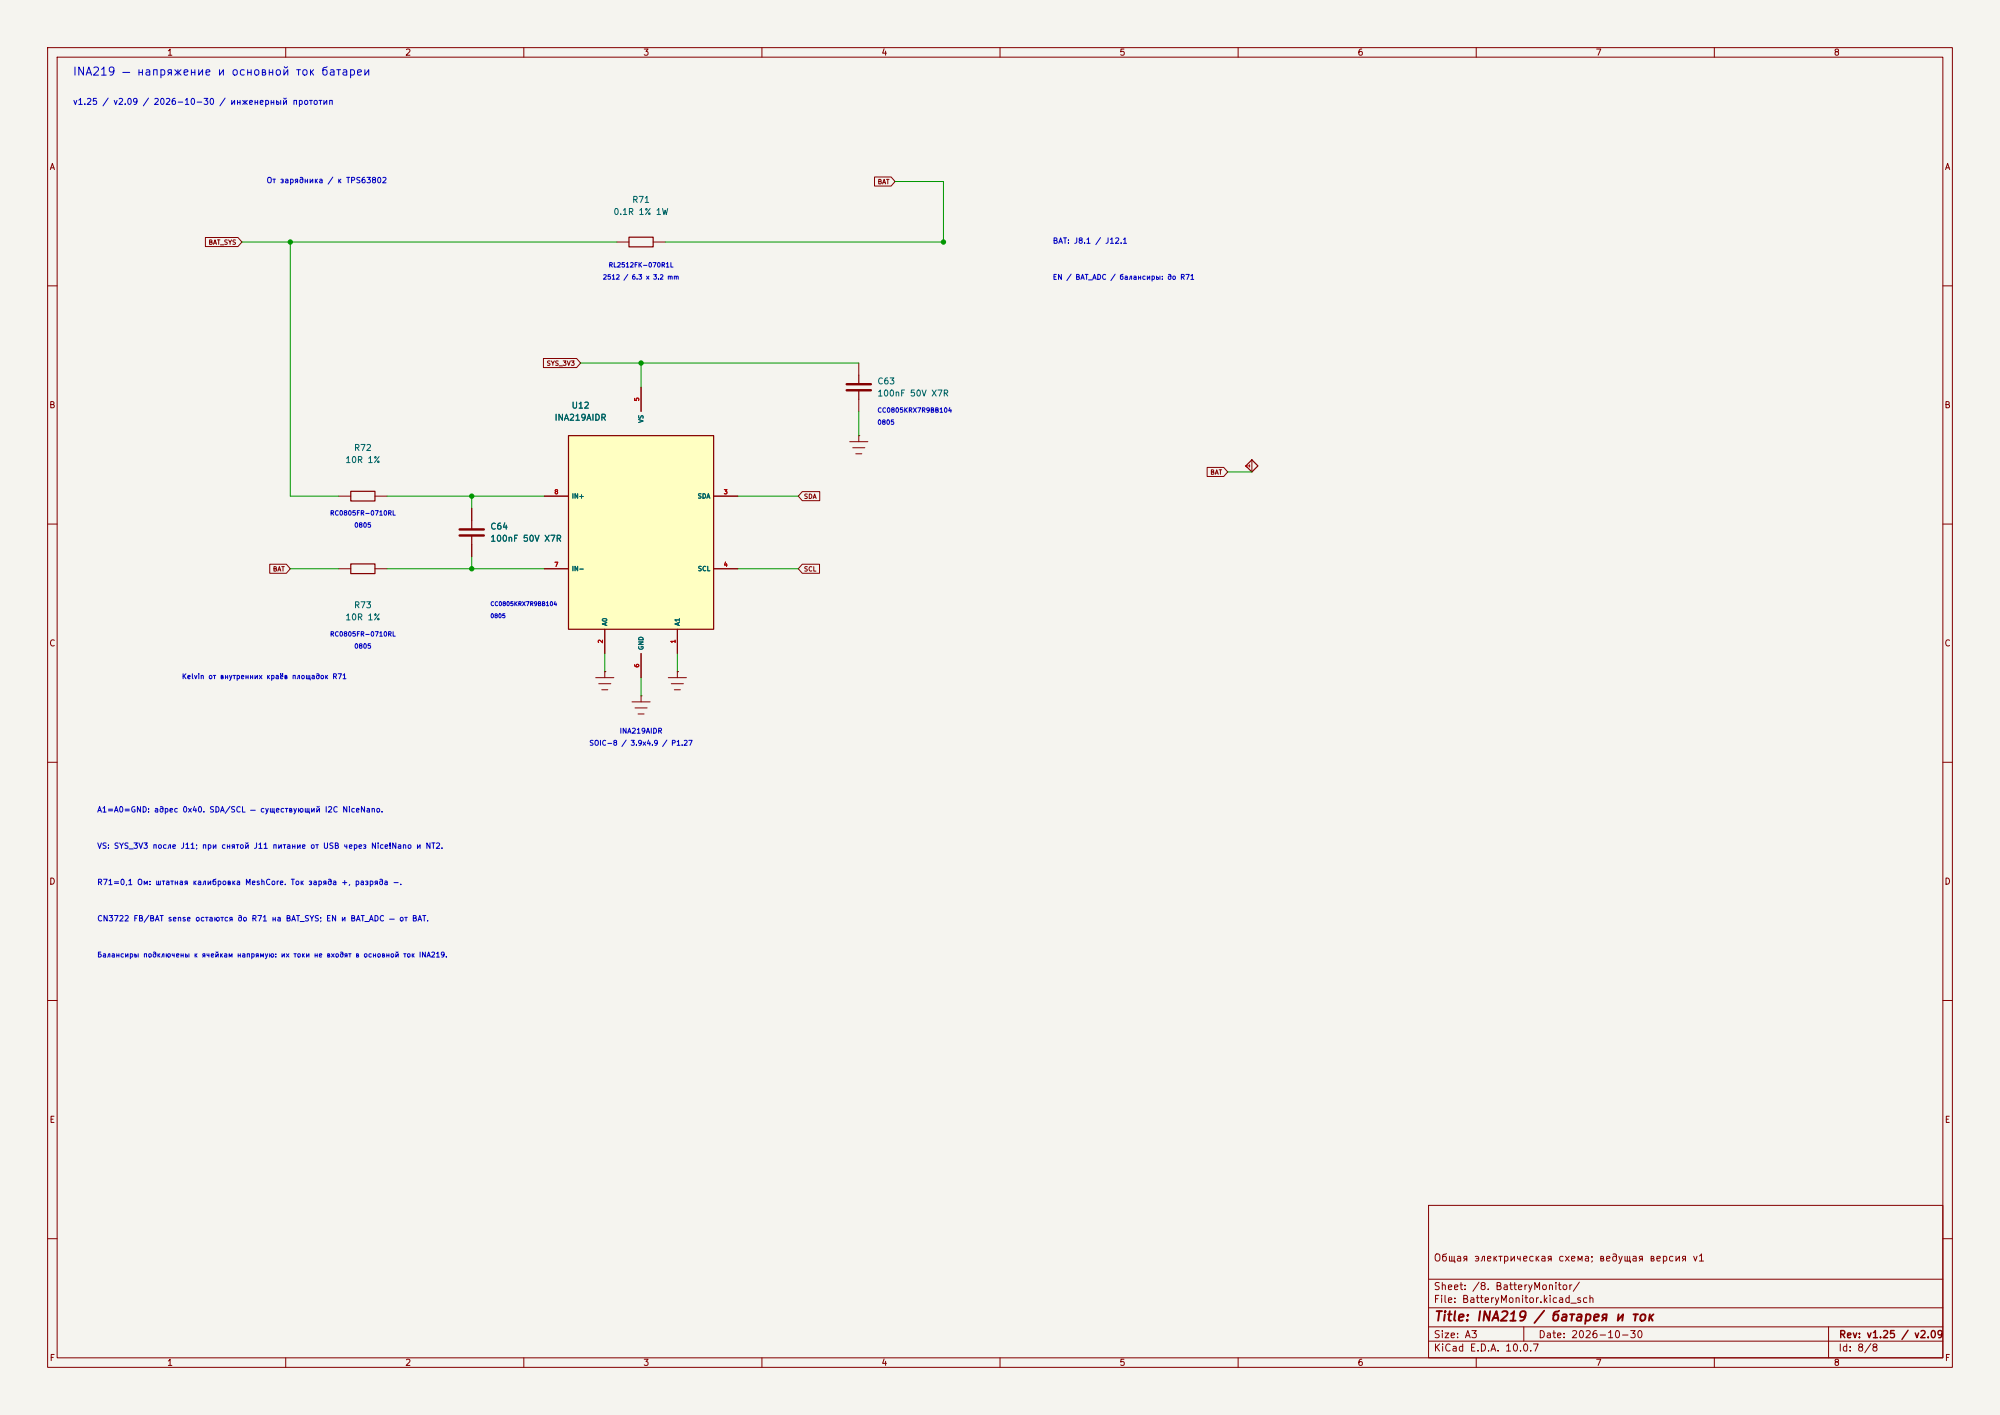
[picture p97: page 8]

INA219 — напряжение и основной ток батареи

0805 0805 RC0805FR-0710RL A1=A0=GND: адрес 0x40. SDA/SCL — существующий I2C NiceNano. Балансиры подключены к ячейкам напрямую: их токи не входят в основной ток INA219.

VS: SYS_3V3 после J11; при снятой J11 питание от USB через Nice!Nano и NT2.

Общая электрическая схема; ведущая версия v1
