Alksndr55/mesh-repeater-2.0/v2/output/current/POWER/POWER_schematic.pdf

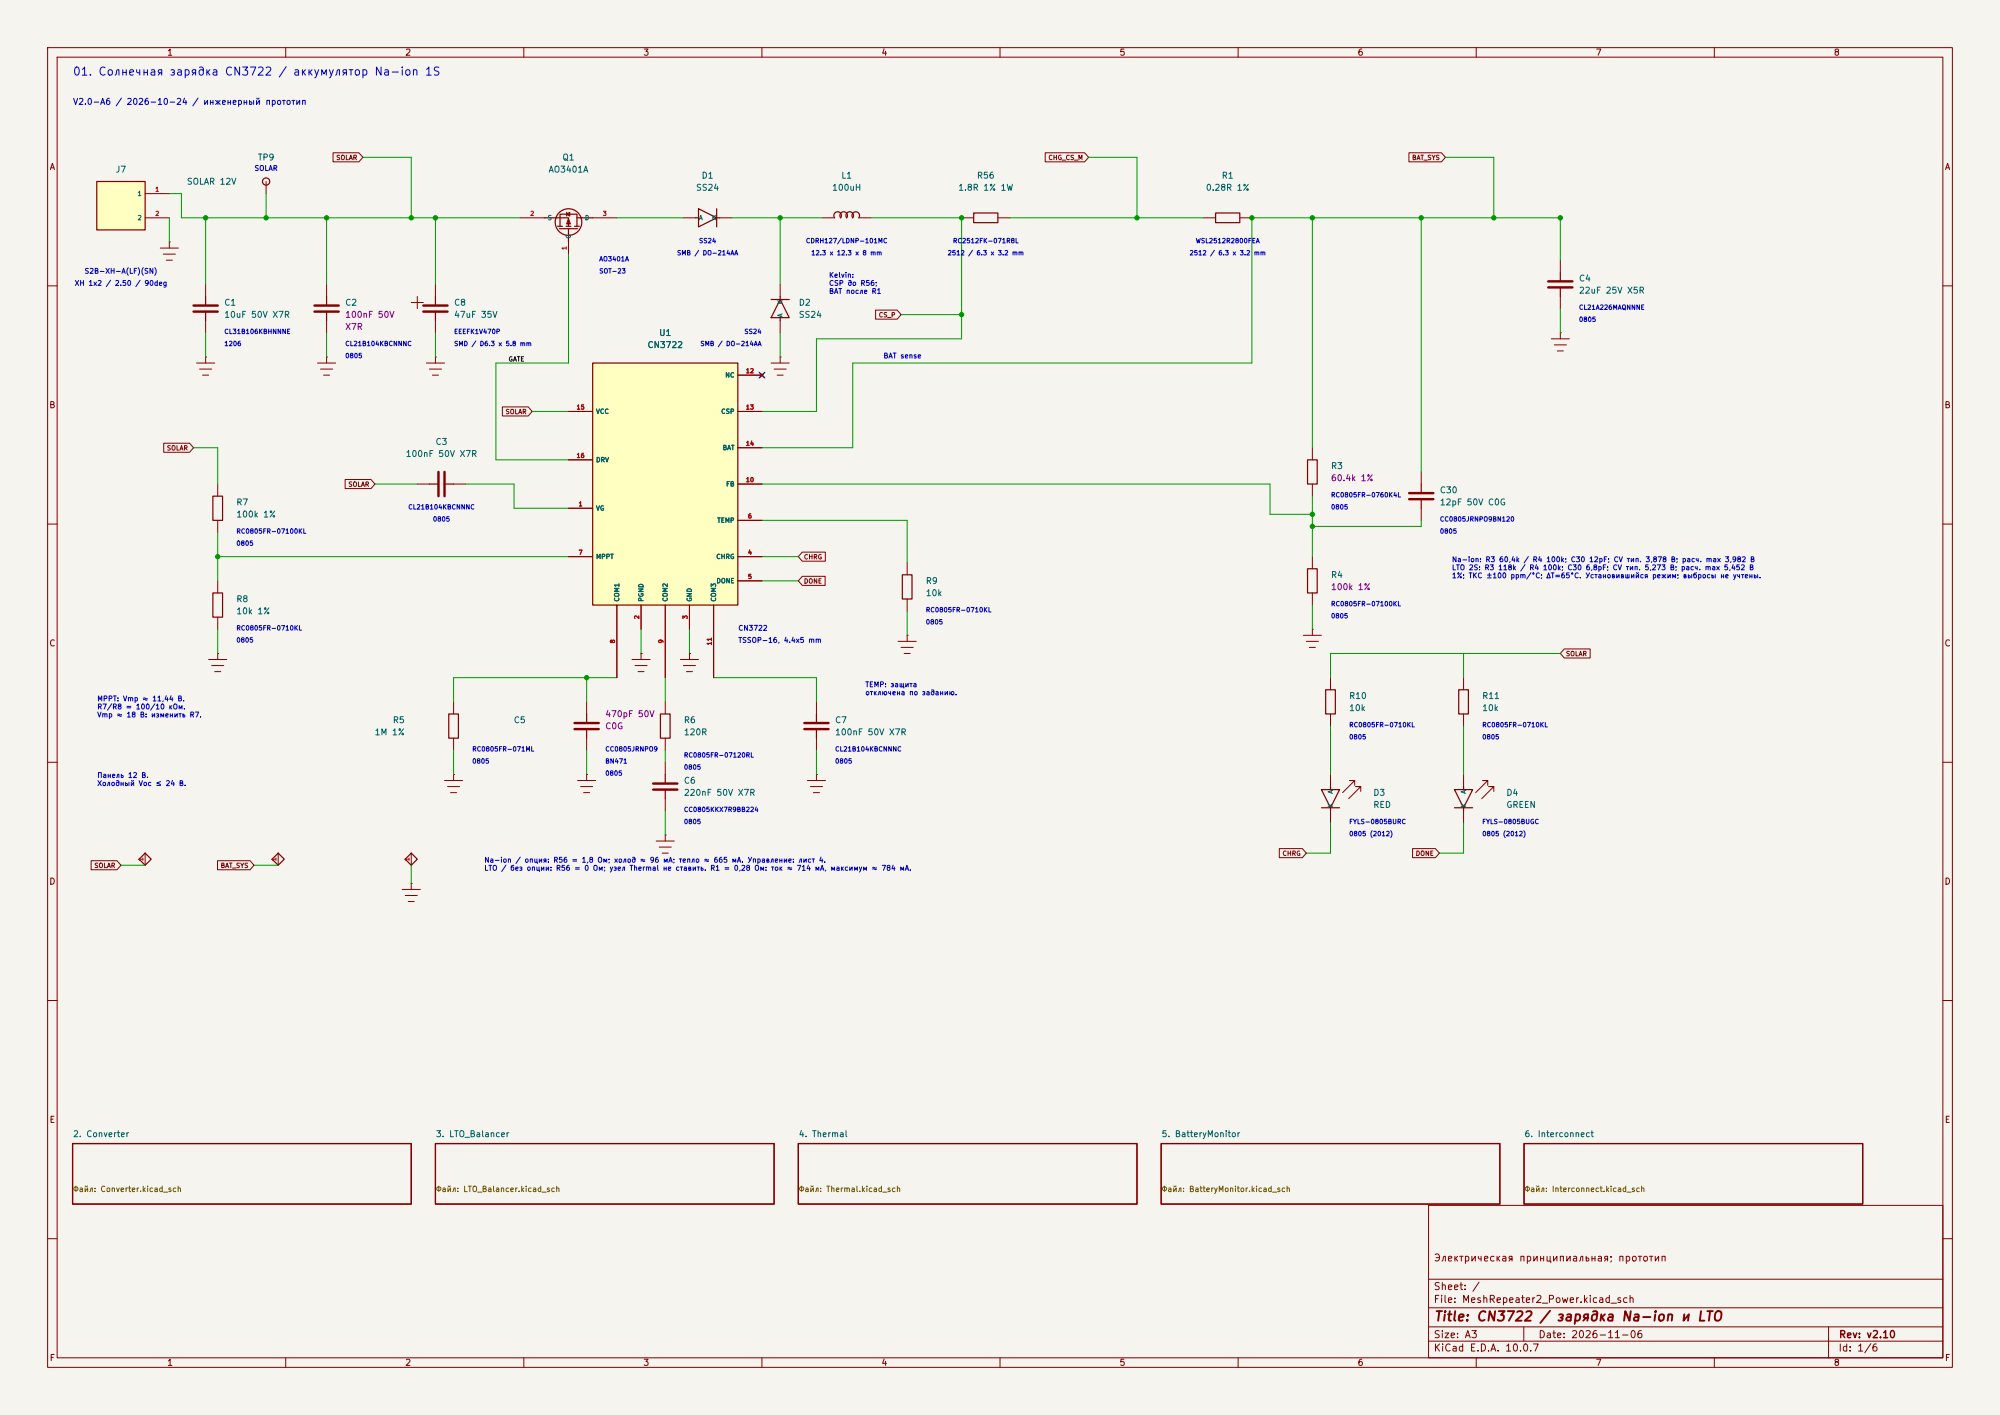
[picture p102: page 1]

XH 1x2 / 2.50 / 90deg V2.0-A6 / 2026-10-24 / инженерный прототип 01. Солнечная зарядка CN3722 / аккумулятор Na-ion 1S

LTO 2S: R3 118k / R4 100k; C30 6,8pF; CV тип. 5,273 В; расч. max 5,452 В

Na-ion / опция: R56 = 1,8 Ом; холод ≈ 96 мА; тепло ≈ 665 мА. Управление: лист 4. LTO / без опции: R56 = 0 Ом; узел Thermal не ставить. R1 = 0,28 Ом: ток ≈ 714 мА, максимум ≈ 784 мА. CC0805KKX7R9BB224

Sheet: /
File: MeshRepeater2_Power.kicad_sch
Title: CN3722 / зарядка Na-ion и LTO

Size: A3 | Rev: v2.10 | F Date: 2026-11-06
KiCad E.D.A. 10.0.7 | Id: 1/6

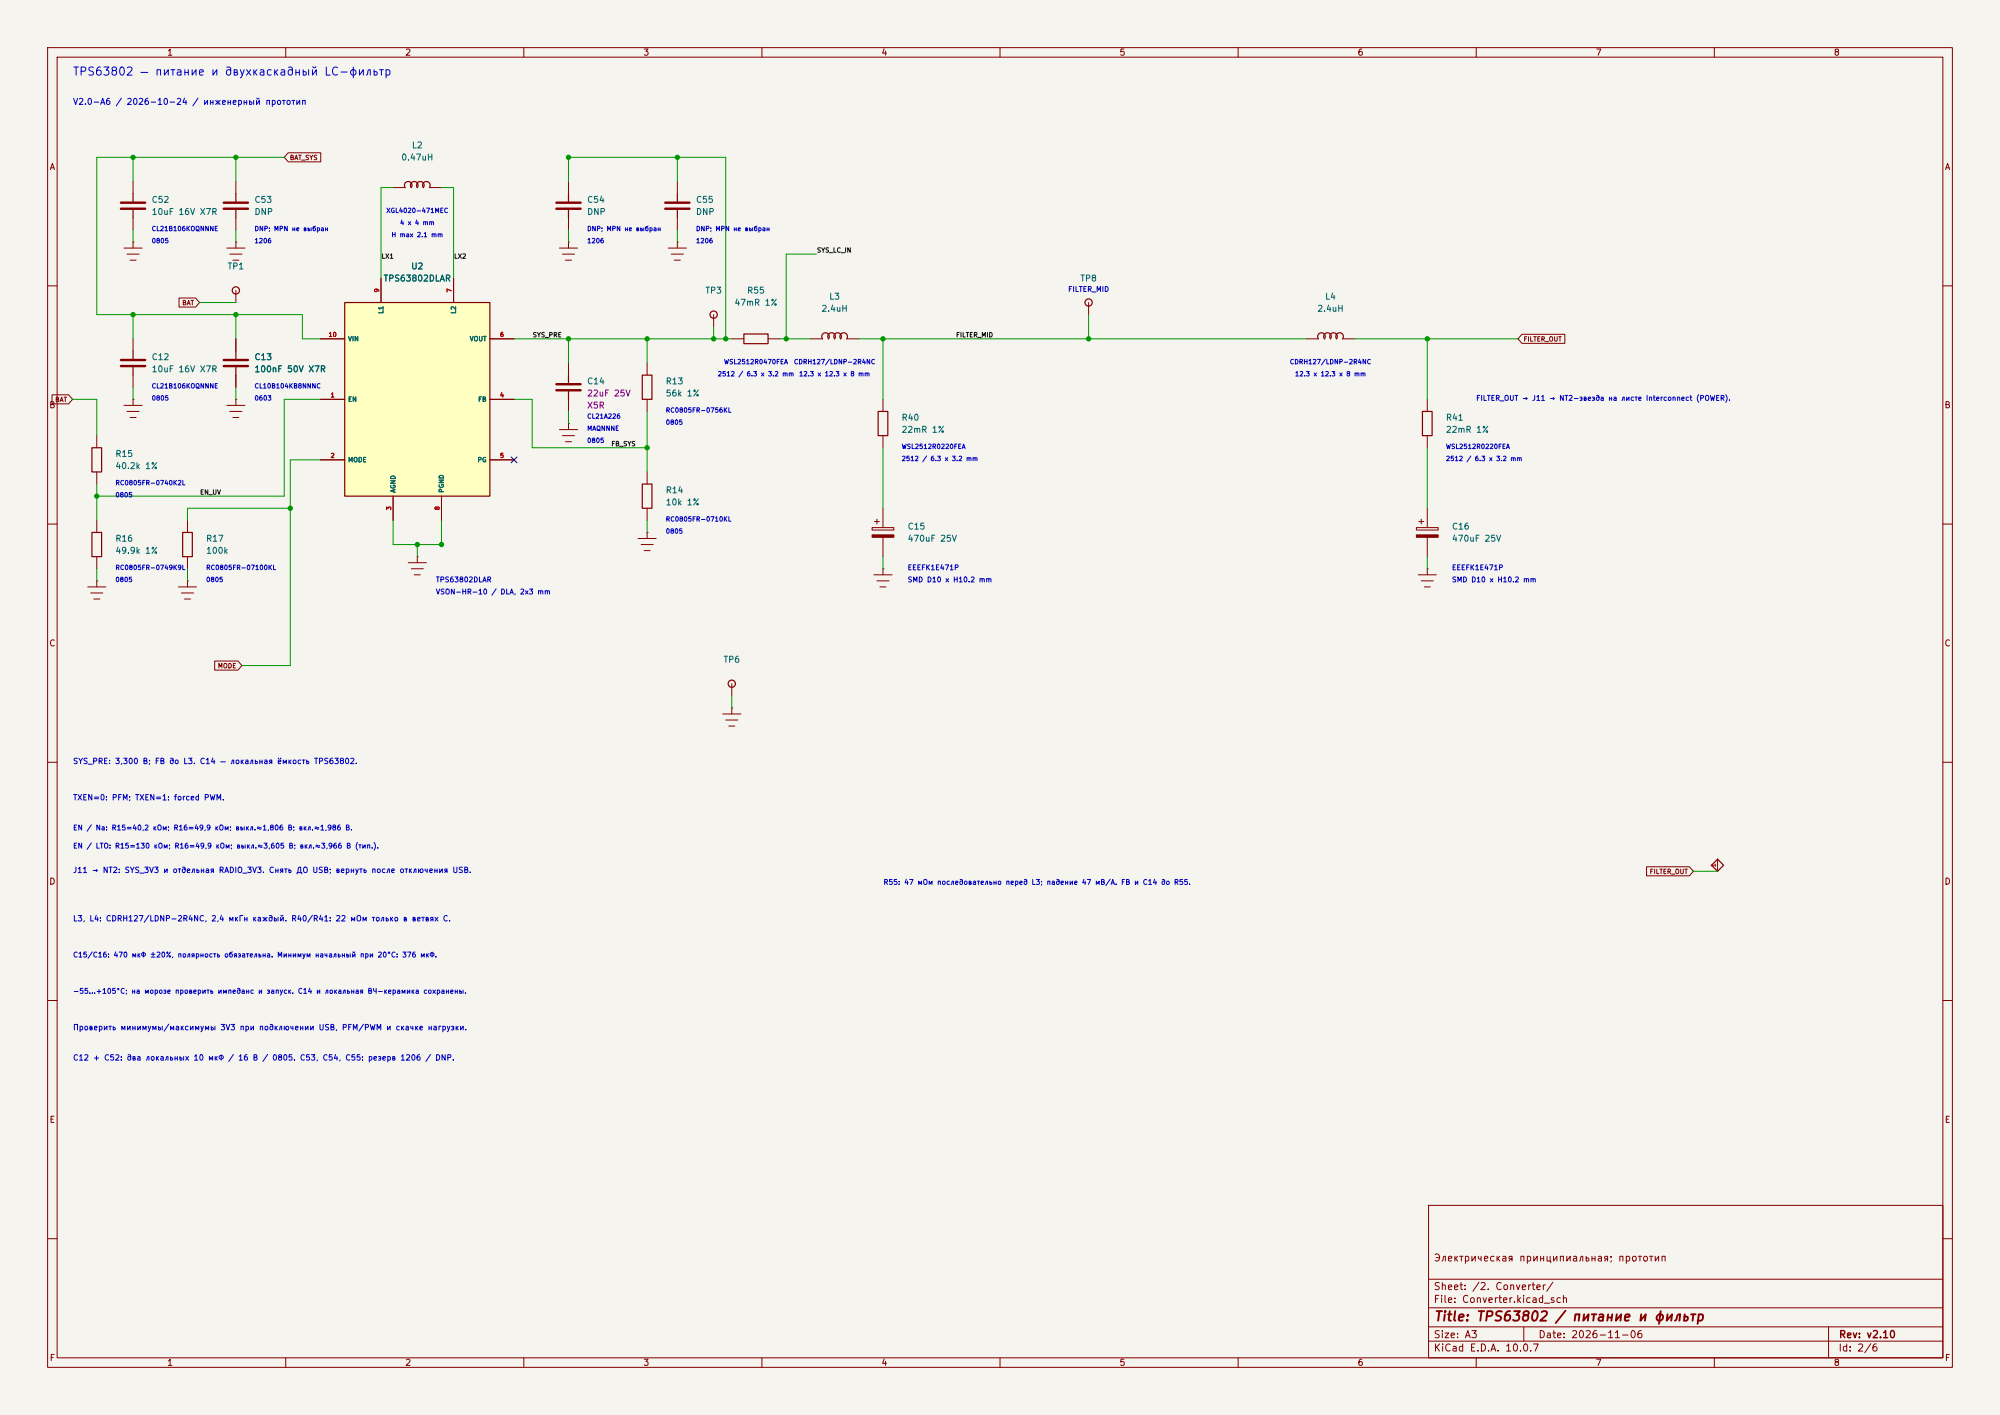
[picture p103: page 2]

12.3 x 12.3 x 8 mm TPS63802 — питание и двухкаскадный LC-фильтр

VSON-HR-10 / DLA, 2x3 mm

SYS_PRE: 3,300 В; FB до L3. C14 — локальная ёмкость TPS63802. EN / Na: R15=40,2 кОм; R16=49,9 кОм; выкл.≈1,806 В; вкл.≈1,986 В.

TXEN=0: PFM; TXEN=1: forced PWM.

C12 + C52: два локальных 10 мкФ / 16 В / 0805. C53, C54, C55: резерв 1206 / DNP. J11 → NT2: SYS_3V3 и отдельная RADIO_3V3. Снять ДО USB; вернуть после отключения USB. C15/C16: 470 мкФ ±20%, полярность обязательна. Минимум начальный при 20°C: 376 мкФ. −55…+105°C; на морозе проверить импеданс и запуск. C14 и локальная ВЧ-керамика сохранены.

L3, L4: CDRH127/LDNP-2R4NC, 2,4 мкГн каждый. R40/R41: 22 мОм только в ветвях C.

Проверить минимумы/максимумы 3V3 при подключении USB, PFM/PWM и скачке нагрузки.

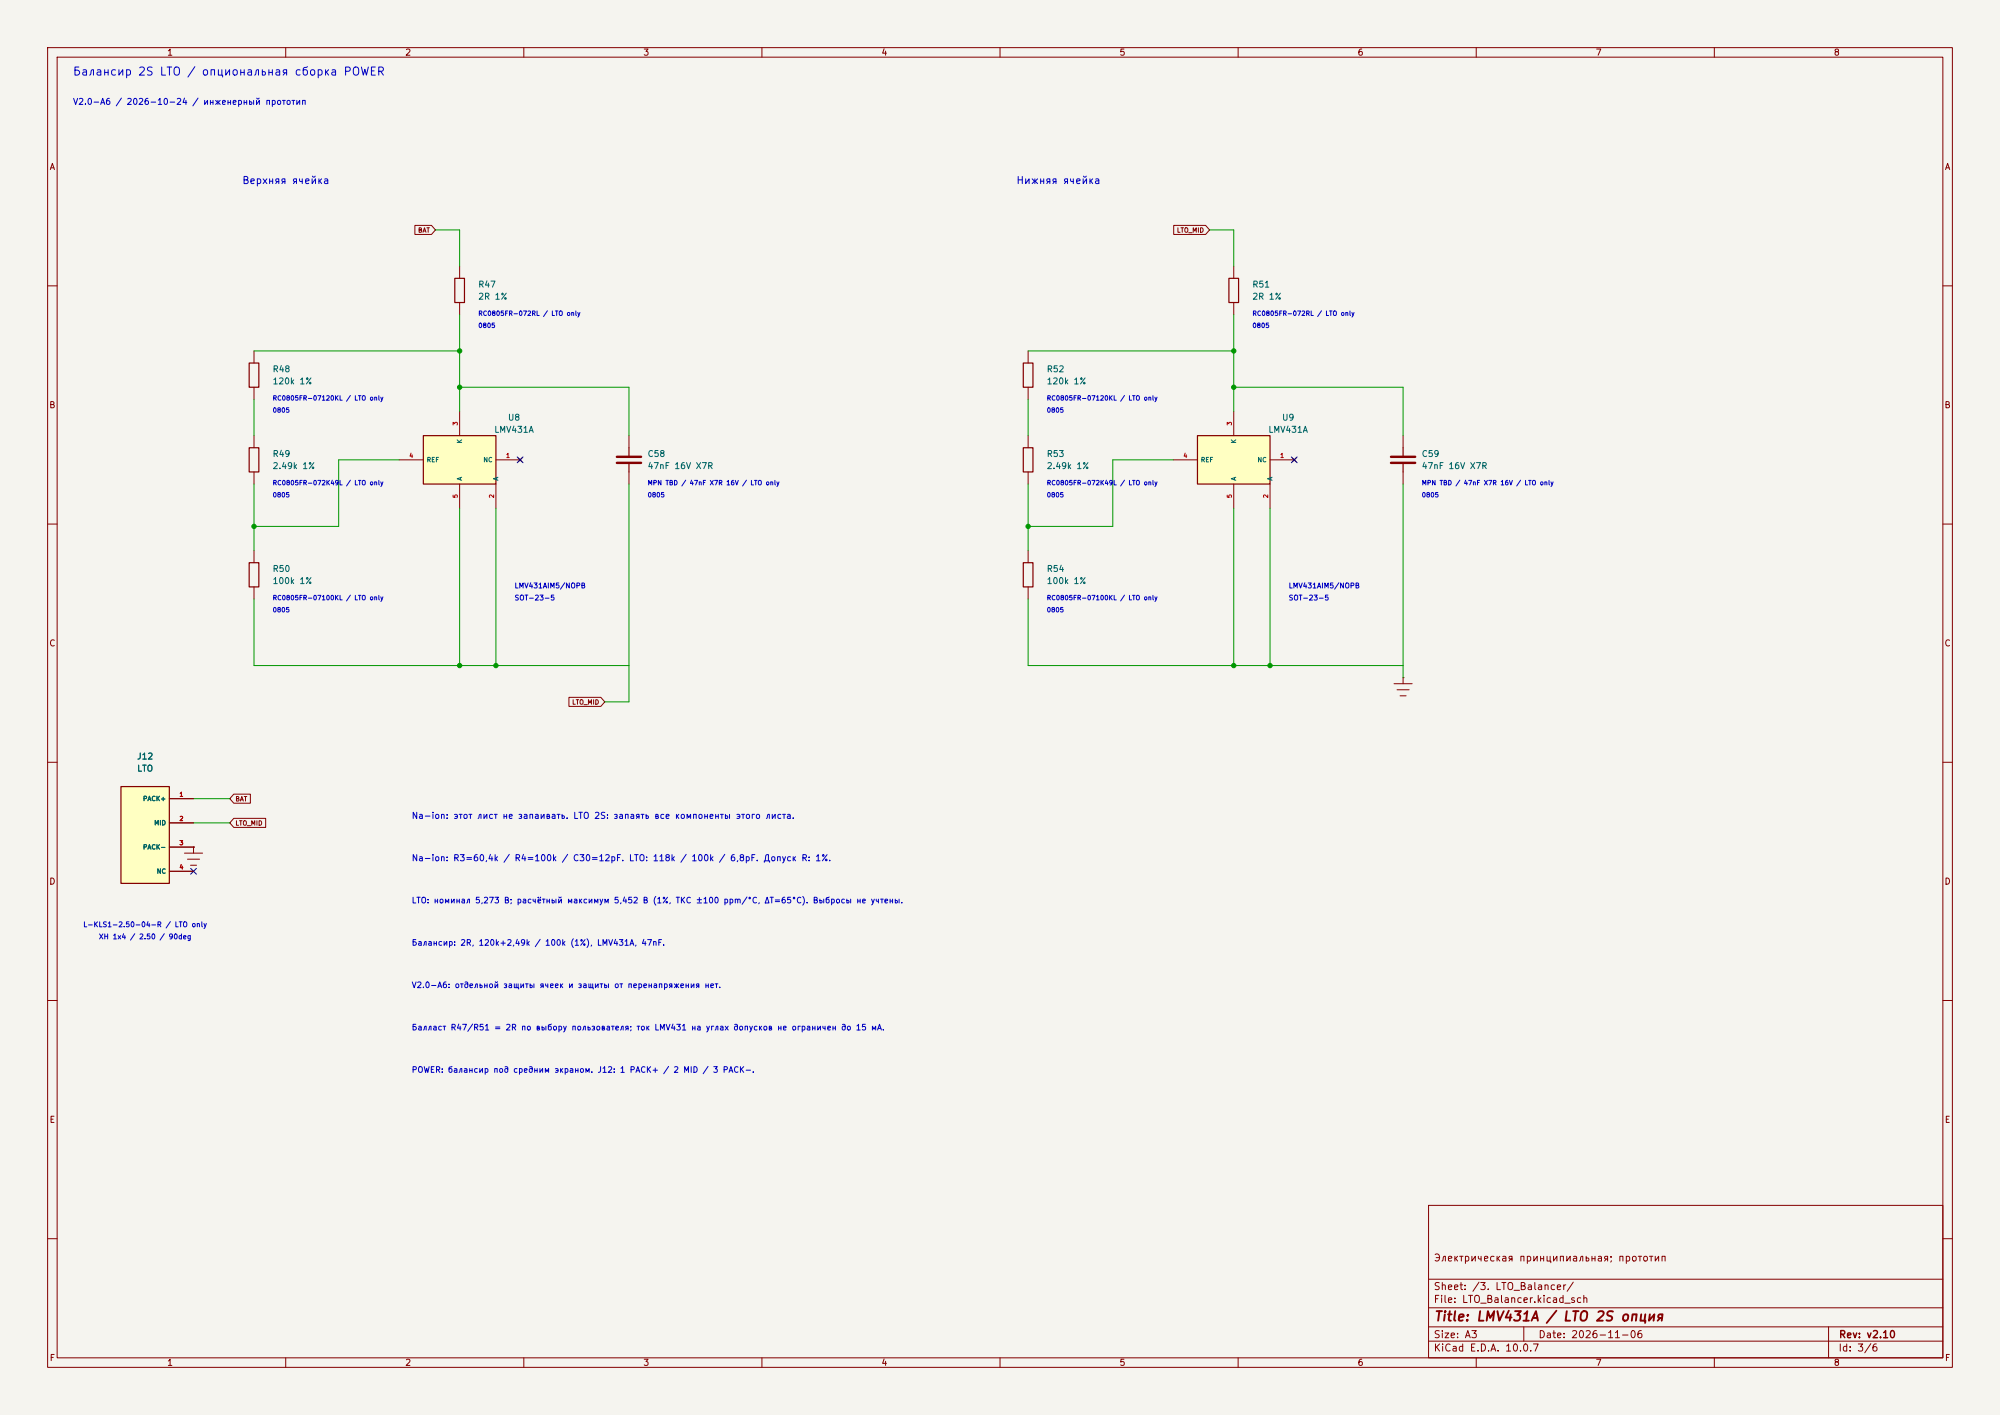
[picture p104: page 3]

Балансир 2S LTO / опциональная сборка POWER

MPN TBD / 47nF X7R 16V / LTO only 0805 V2.0-A6: отдельной защиты ячеек и защиты от перенапряжения нет.

Балансир: 2R, 120k+2,49k / 100k (1%), LMV431A, 47nF. POWER: балансир под средним экраном. J12: 1 PACK+ / 2 MID / 3 PACK-. Балласт R47/R51 = 2R по выбору пользователя; ток LMV431 на углах допусков не ограничен до 15 мА. Na-ion: этот лист не запаивать. LTO 2S: запаять все компоненты этого листа. Na-ion: R3=60,4k / R4=100k / C30=12pF. LTO: 118k / 100k / 6,8pF. Допуск R: 1%. LTO: номинал 5,273 В; расчётный максимум 5,452 В (1%, ТКС ±100 ppm/°C, ΔT=65°C). Выбросы не учтены. 0805 XH 1x4 / 2.50 / 90deg

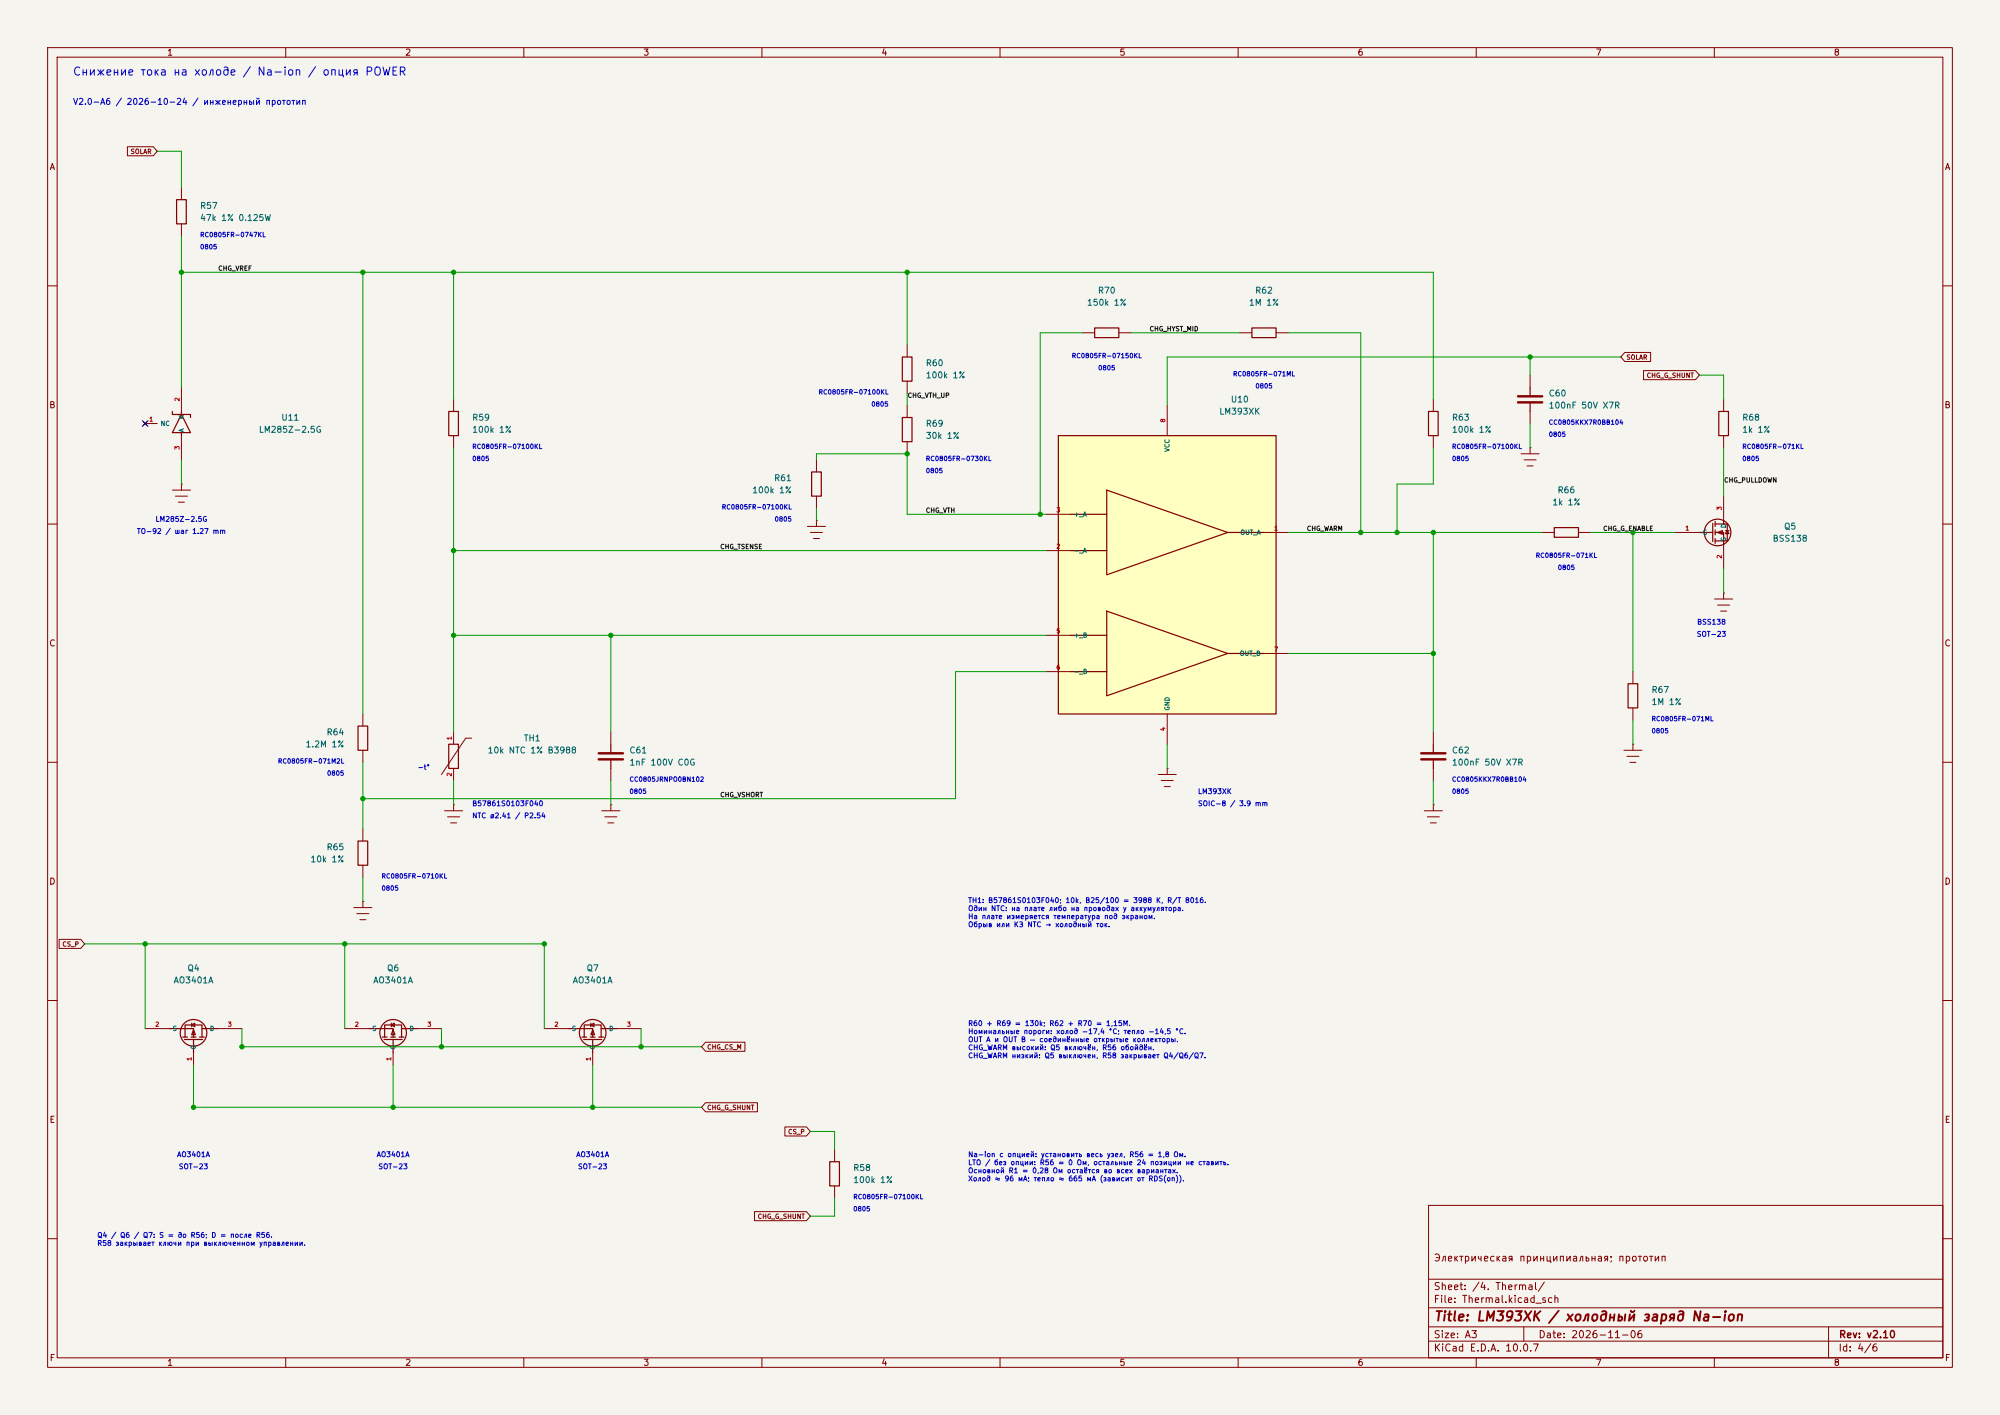
[picture p105: page 4]

Снижение тока на холоде / Na-ion / опция POWER

Na-ion с опцией: установить весь узел, R56 = 1,8 Ом. LTO / без опции: R56 = 0 Ом, остальные 24 позиции не ставить. Основной R1 = 0,28 Ом остаётся во всех вариантах. Холод ≈ 96 мА; тепло ≈ 665 мА (зависит от RDS(on)).

Q4 / Q6 / Q7: S = до R56; D = после R56. R58 закрывает ключи при выключенном управлении.

Sheet: /4. Thermal/
File: Thermal.kicad_sch
Title: LM393XK / холодный заряд Na-ion

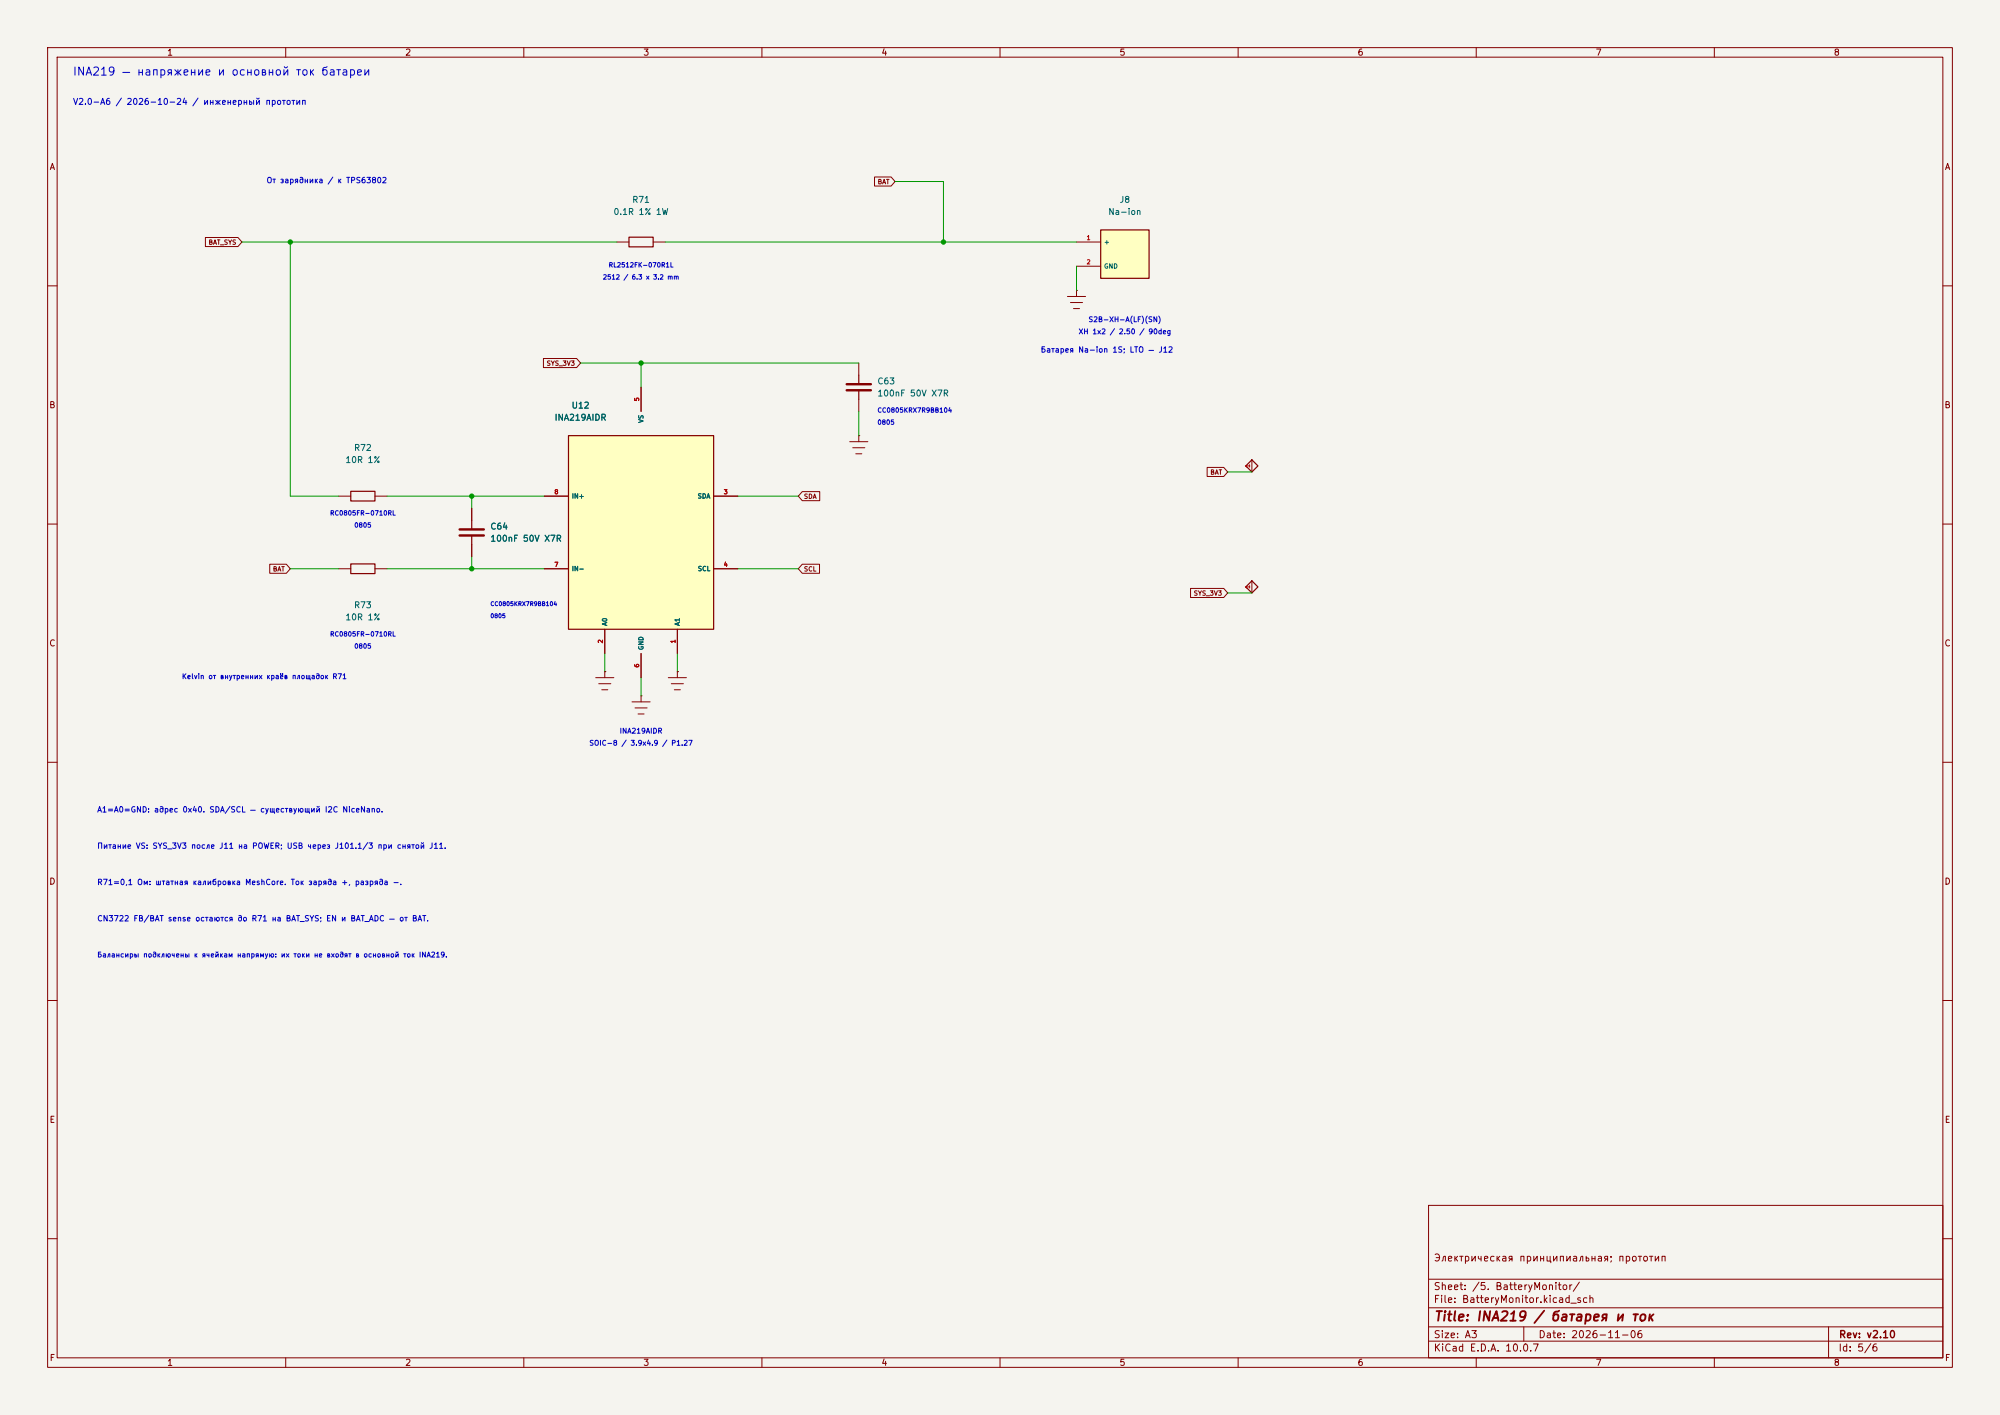
[picture p106: page 5]

INA219 — напряжение и основной ток батареи

Батарея Na-ion 1S; LTO — J12

0805 CC0805KRX7R9BB104 SOIC-8 / 3.9x4.9 / P1.27 R71=0,1 Ом: штатная калибровка MeshCore. Ток заряда +, разряда −. RC0805FR-0710RL Kelvin от внутренних краёв площадок R71

0805 RC0805FR-0710RL Питание VS: SYS_3V3 после J11 на POWER; USB через J101.1/3 при снятой J11. A1=A0=GND: адрес 0x40. SDA/SCL — существующий I2C NiceNano. Балансиры подключены к ячейкам напрямую: их токи не входят в основной ток INA219.

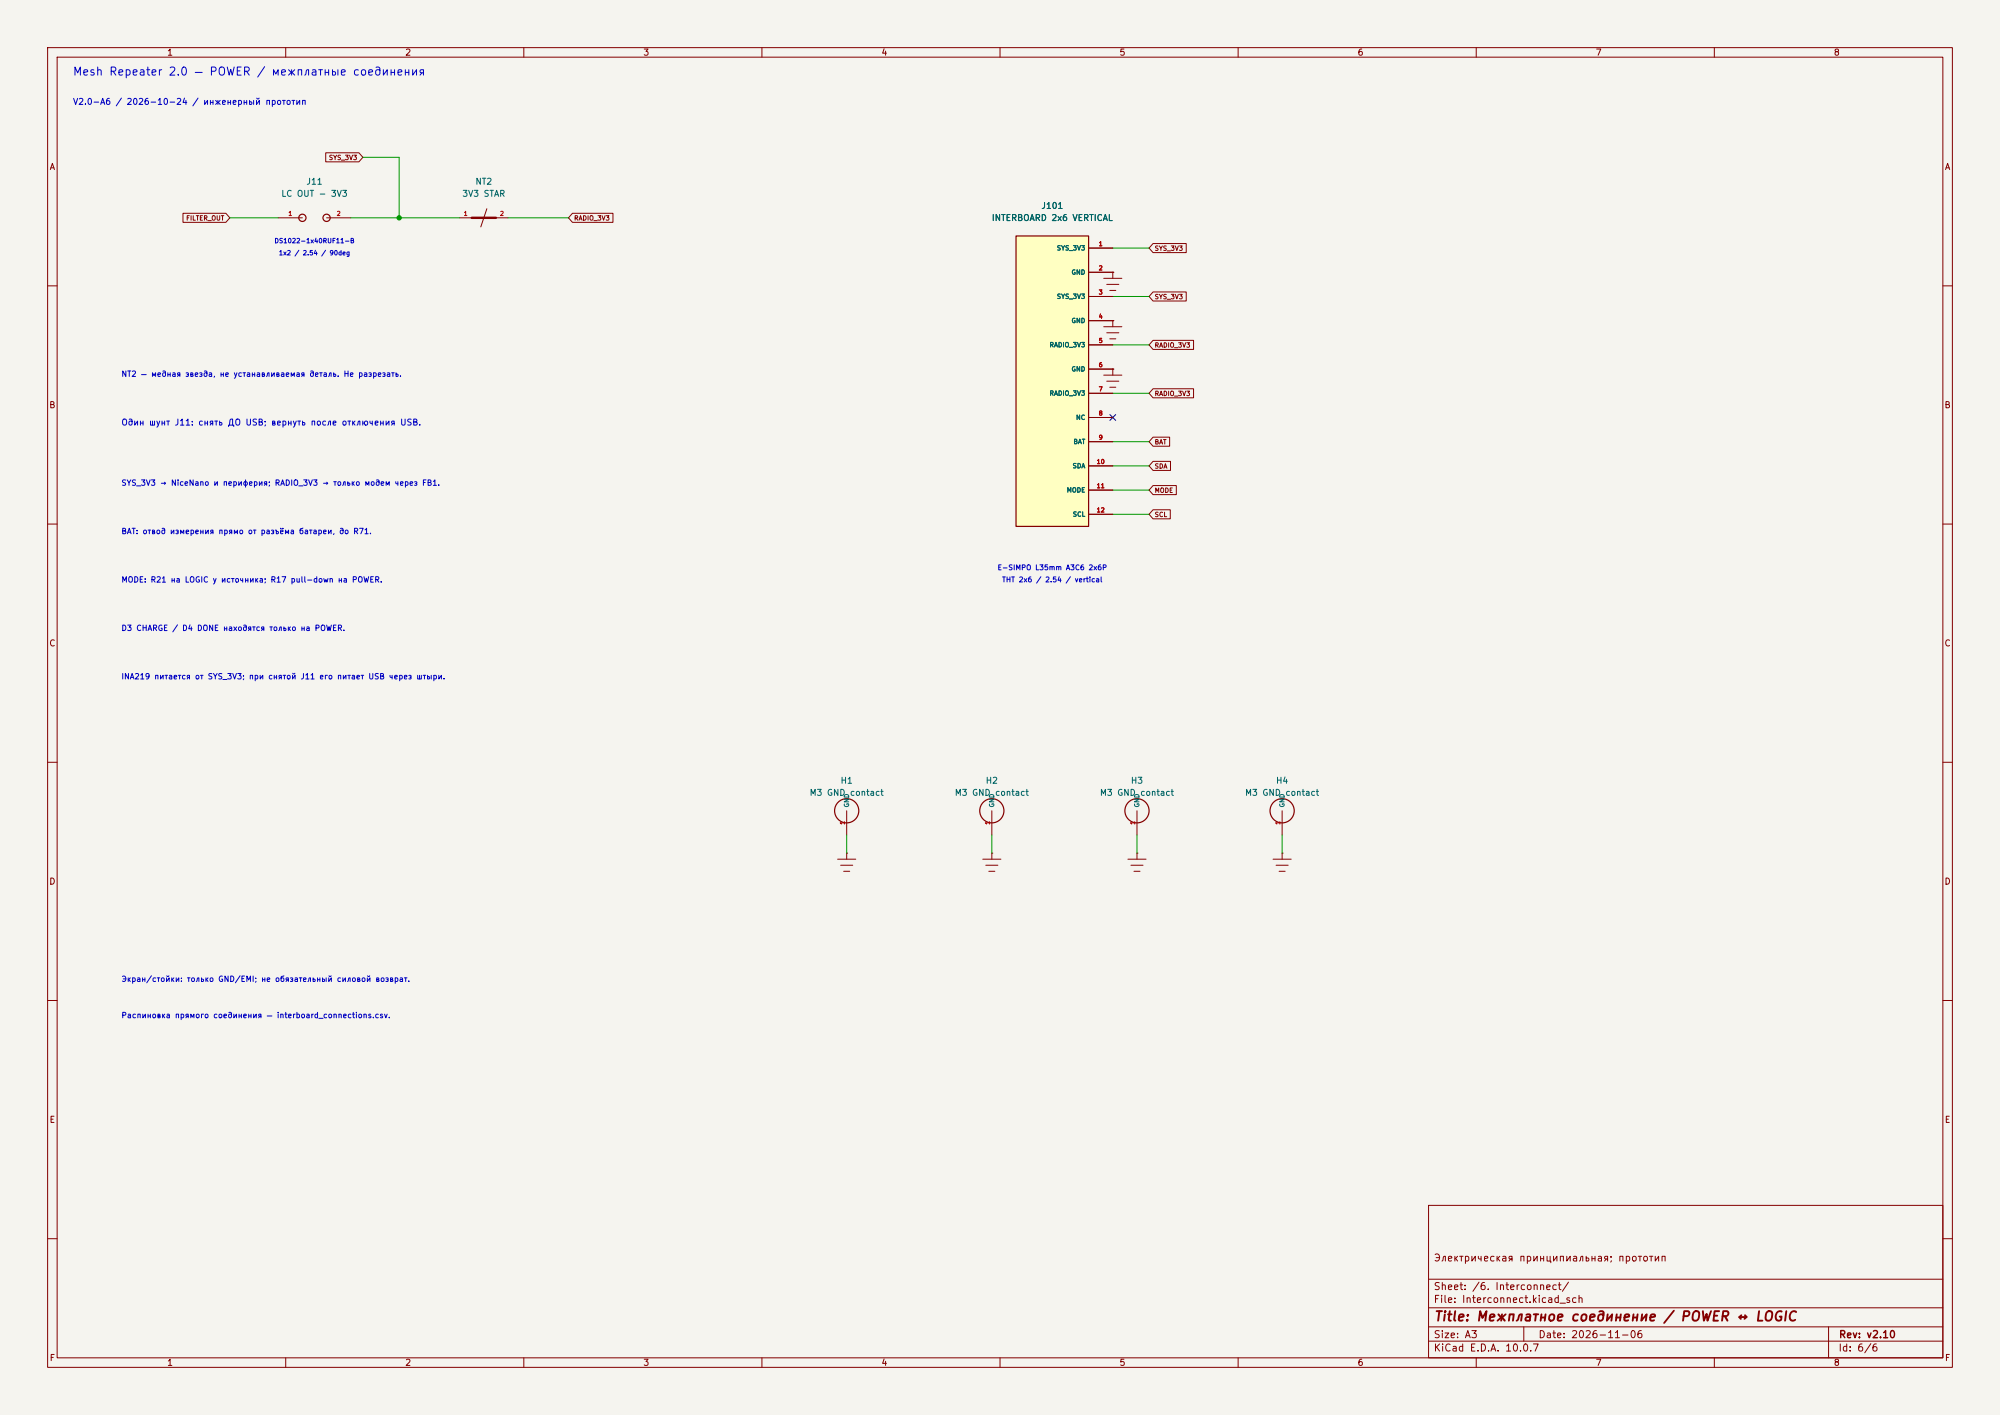
[picture p107: page 6]

1x2 / 2.54 / 90deg Mesh Repeater 2.0 — POWER / межплатные соединения

SYS_3V3 → NiceNano и периферия; RADIO_3V3 → только модем через FB1. DS1022-1x40RUF11-B V2.0-A6 / 2026-10-24 / инженерный прототип

SDA MODE SCL BAT SYS_3V3 RADIO_3V3 RADIO_3V3 RADIO_3V3

BAT: отвод измерения прямо от разъёма батареи, до R71.

INA219 питается от SYS_3V3; при снятой J11 его питает USB через штыри. D3 CHARGE / D4 DONE находятся только на POWER. Экран/стойки: только GND/EMI; не обязательный силовой возврат. MODE: R21 на LOGIC у источника; R17 pull-down на POWER. Распиновка прямого соединения — interboard_connections.csv.

Электрическая принципиальная; прототип GND

Sheet: /6. Interconnect/
File: Interconnect.kicad_sch
Title: Межплатное соединение / POWER ↔ LOGIC
