Alksndr55/mesh-repeater-2.0/(list of files, drawings)

Other design files:
audit/V2_ENGINEERING_AUDIT_A3_2026_10_13/SCHEMATIC_EQUIVALENCE_FRESH.json
design/MeshRepeater2_Logic/schematic_manifest.json
design/MeshRepeater2_Power/schematic_manifest.json
