Alksndr55/mesh-repeater-2.0/v2/design/MeshRepeater2_Power/MeshRepeater2_Power.kicad_pcb

## KiCad design v2/design/MeshRepeater2_Power/MeshRepeater2_Power.kicad_pcb (2026-11-06)

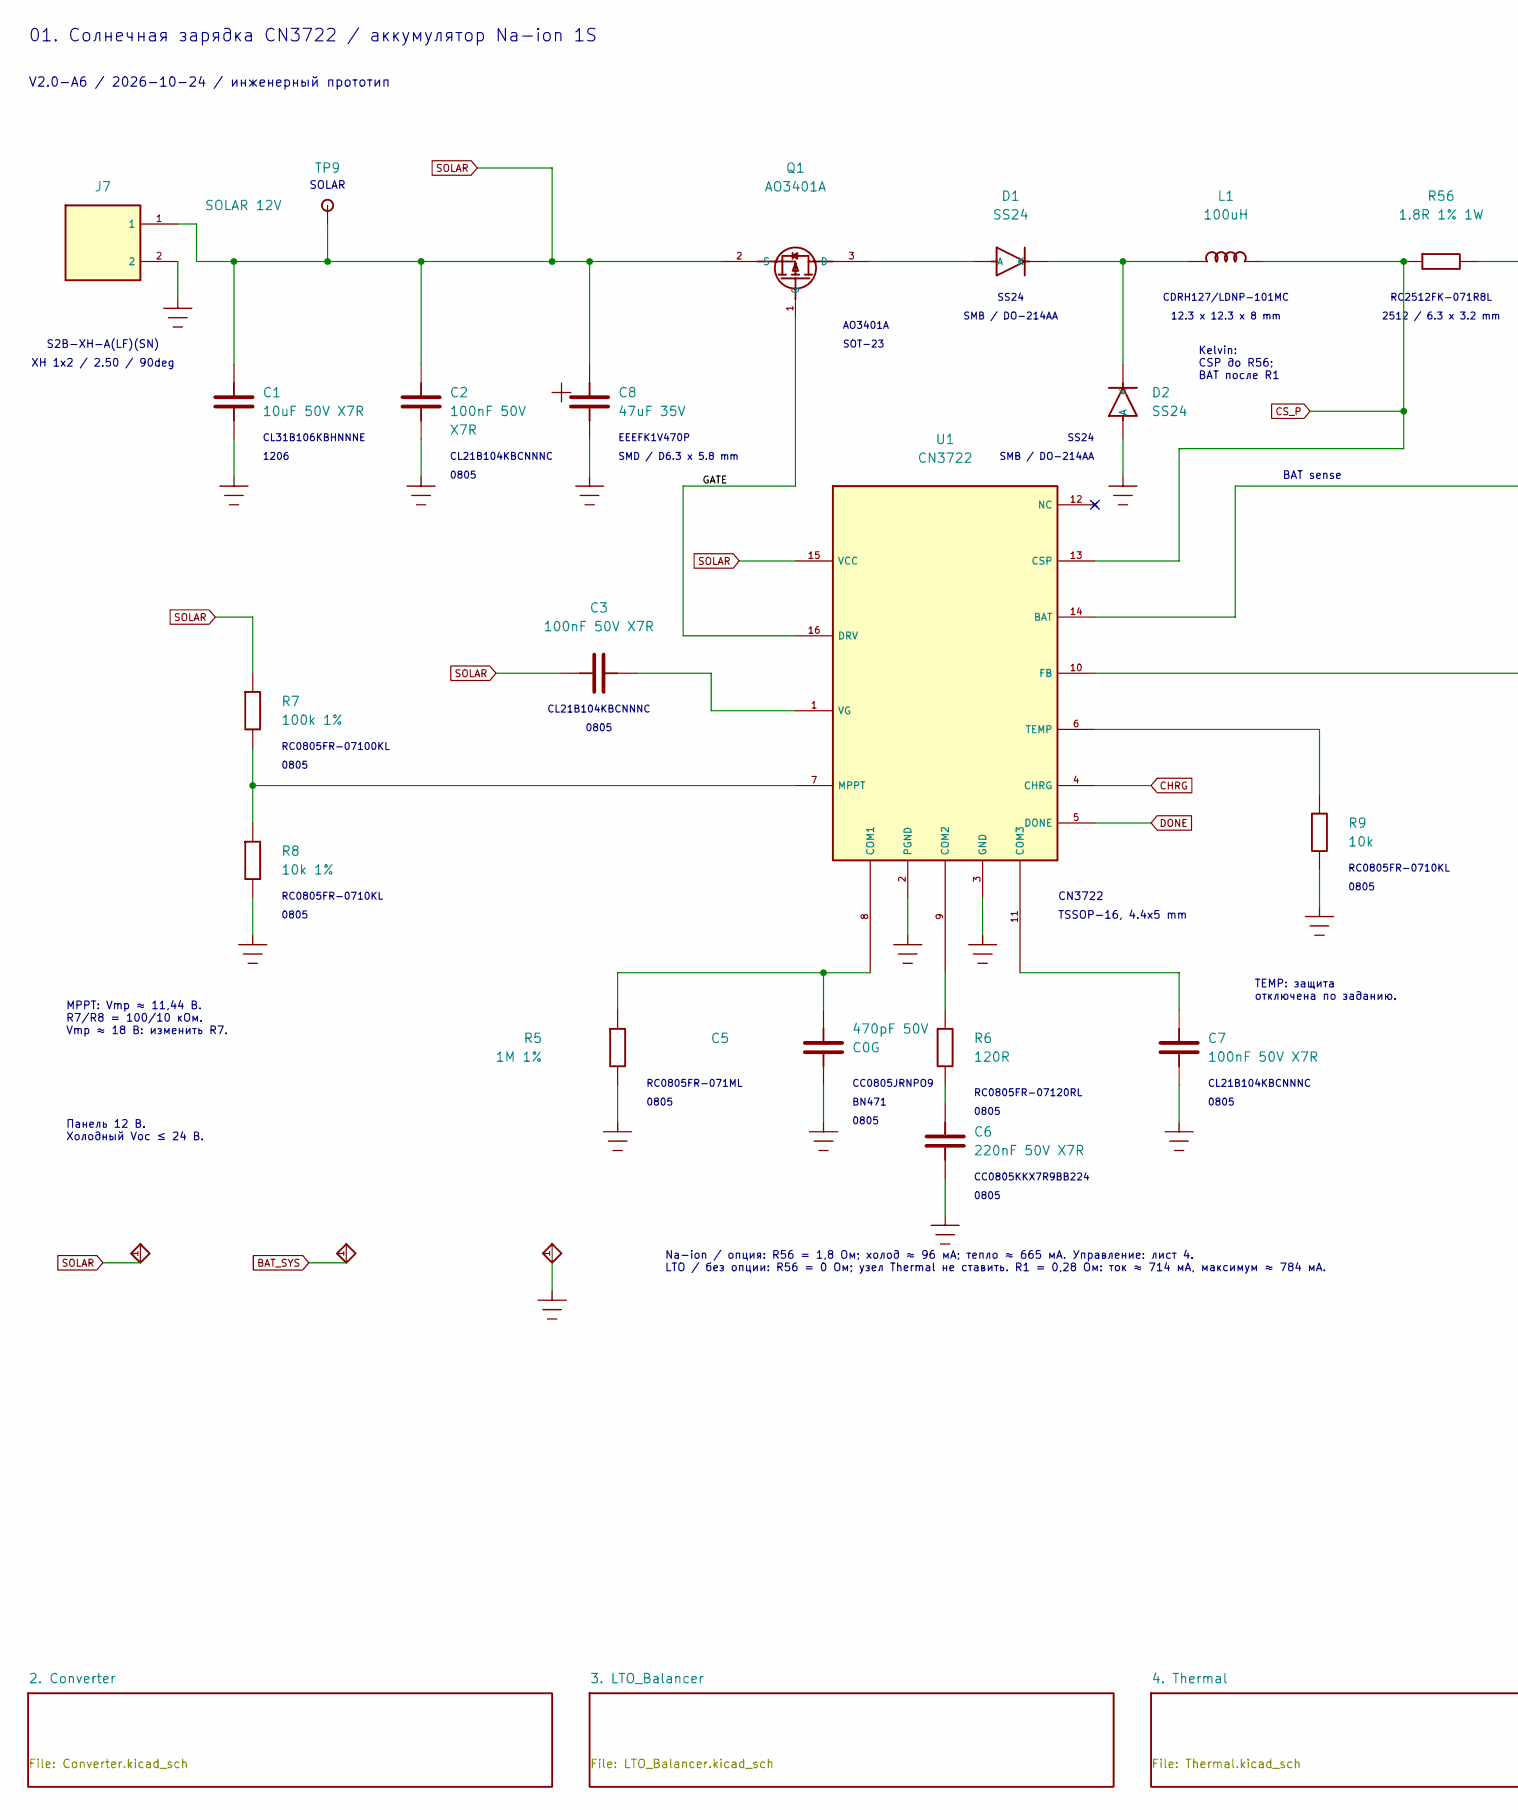
[picture p110: schematic MeshRepeater2_Power.kicad_sch, CN3722 / зарядка Na-ion и LTO, part in row 1, column 1]

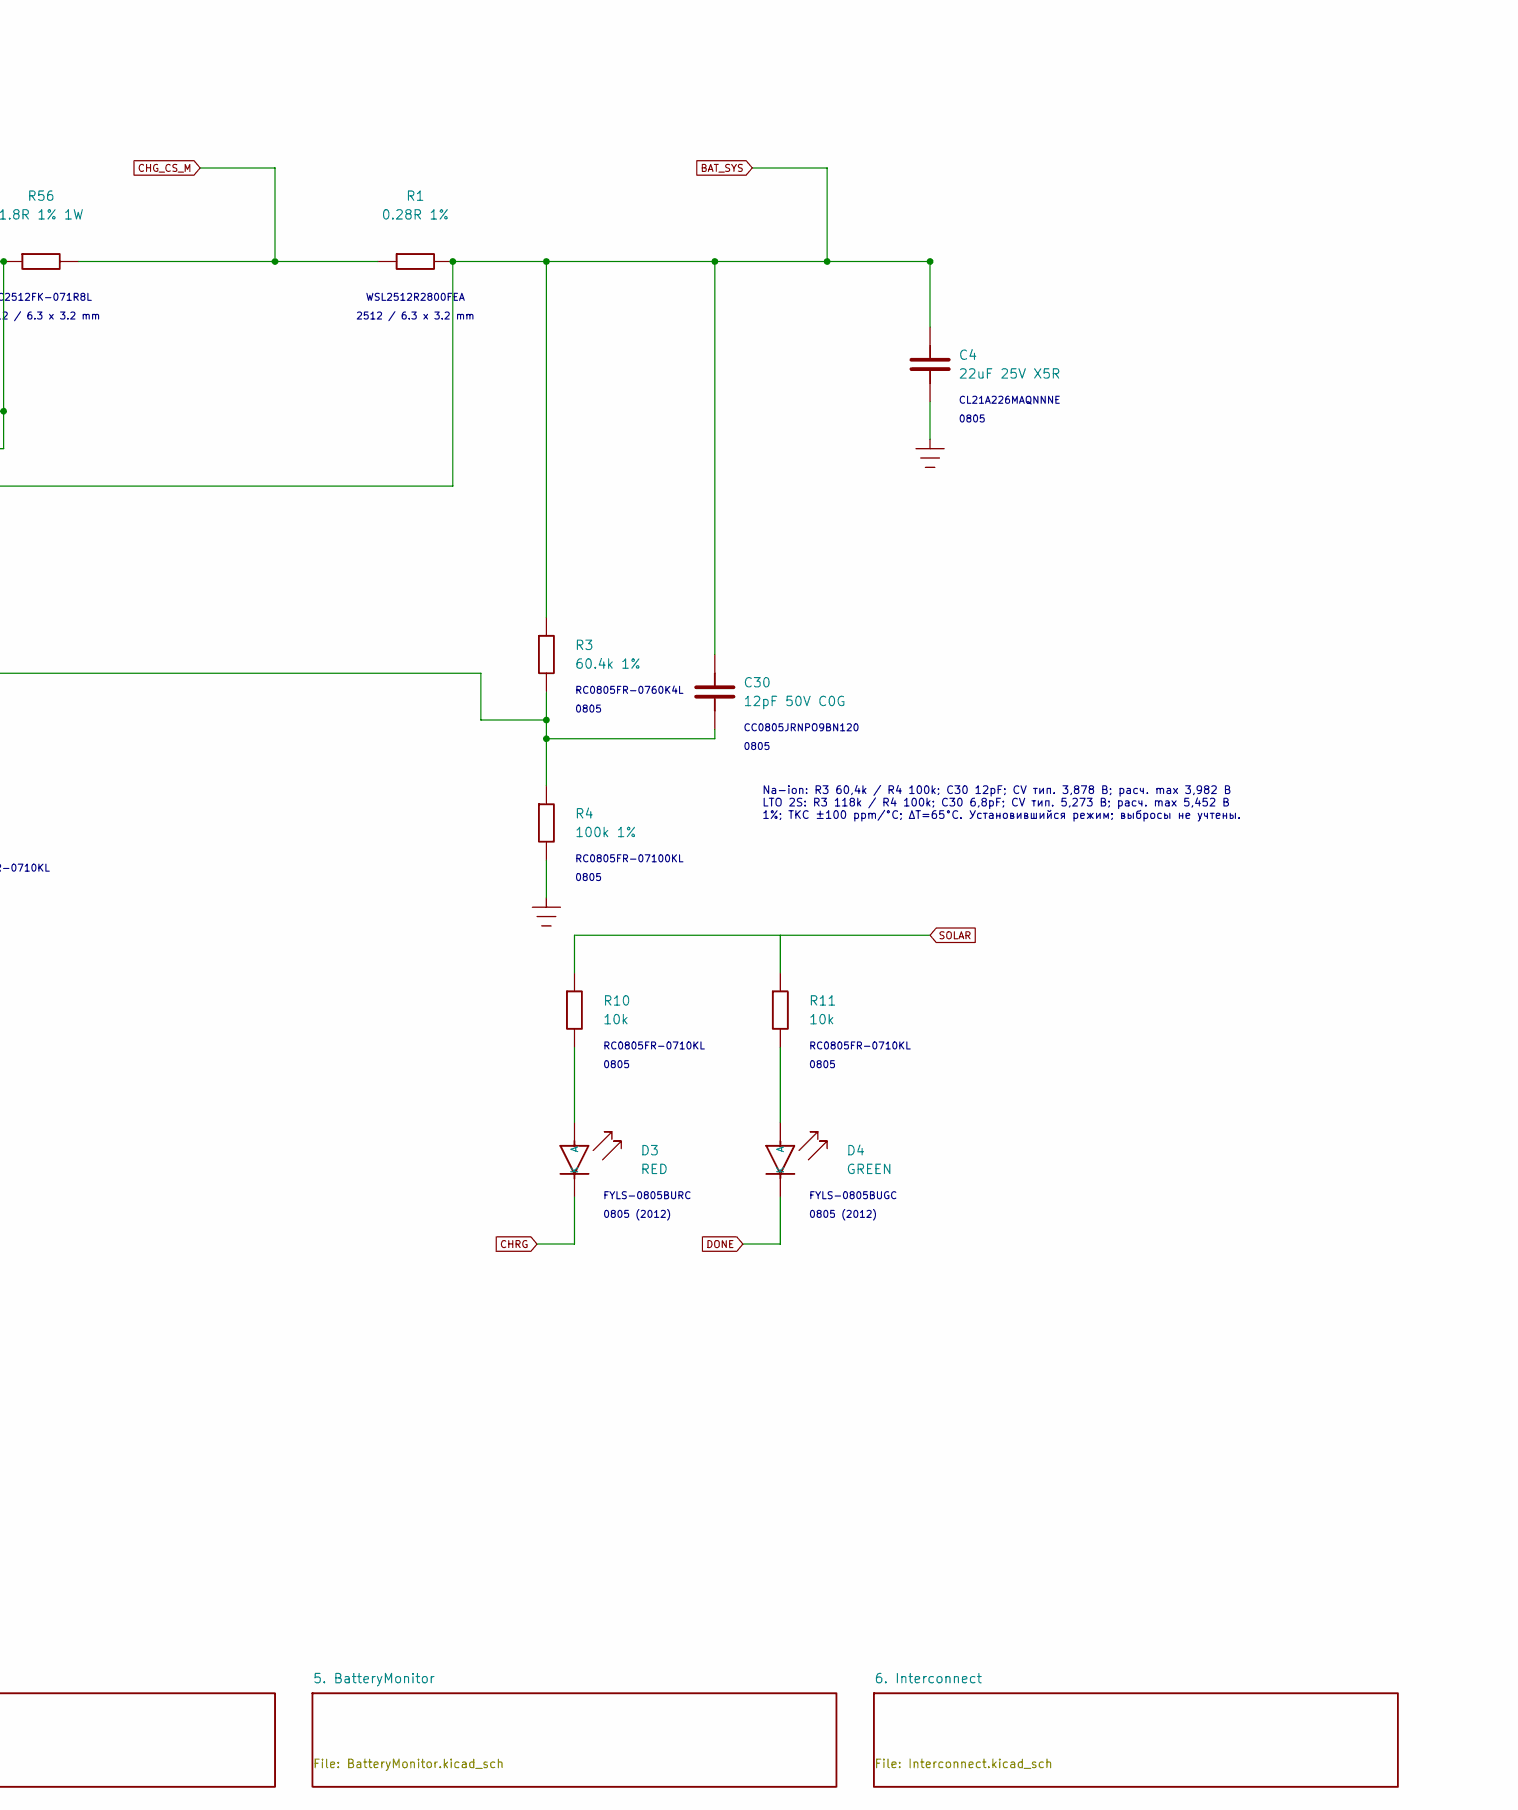
[picture p111: schematic MeshRepeater2_Power.kicad_sch, CN3722 / зарядка Na-ion и LTO, part in row 1, column 2]

Parts:
C1: 10uF 50V X7R; C_1206_3216Metric__V2_C1; MPN CL31B106KBHNNNE
C2: 100nF 50V X7R; C_0805_2012Metric__V2_C2; MPN CL21B104KBCNNNC
C3: 100nF 50V X7R; C_0805_2012Metric__V2_C3; MPN CL21B104KBCNNNC
C4: 22uF 25V X5R; C_0805_2012Metric__V2_C4; MPN CL21A226MAQNNNE
C5: 470pF 50V C0G; C_0805_2012Metric__V2_C5; MPN CC0805JRNPO9BN471
C6: 220nF 50V X7R; C_0805_2012Metric__V2_C6; MPN CC0805KKX7R9BB224
C7: 100nF 50V X7R; C_0805_2012Metric__V2_C7; MPN CL21B104KBCNNNC
C8: 47uF 35V; CP_Elec_Panasonic_FK_D_6.3x5.8__V2_C8; MPN EEEFK1V470P
C30: 12pF 50V C0G; C_0805_2012Metric__V2_C30; MPN CC0805JRNPO9BN120
D1: SS24; D_SMB__V2_D1; MPN SS24
D2: SS24; D_SMB__V2_D2; MPN SS24
D3: RED; LED_0805_2012Metric__V2_D3; MPN FYLS-0805BURC
D4: GREEN; LED_0805_2012Metric__V2_D4; MPN FYLS-0805BUGC
J7: SOLAR 12V; JST_XH_S2B-XH-A_1x02_P2.50mm_Horizontal__V2_J7; MPN JST S2B-XH-A(LF)(SN)
L1: 100uH; L_Sumida_CDRH127_LDNP_101MC__V2_L1; MPN CDRH127/LDNP-101MC
Q1: AO3401A; SOT-23__V2_Q1; MPN AO3401A
R1: 0.28R 1%; R_Vishay_WSL2512_A3__A3_R1; MPN WSL2512R2800FEA; LCSC C5710536
R3: 60.4k 1%; R_0805_2012Metric__V2_R3; MPN RC0805FR-0760K4L; LCSC C2084414
R4: 100k 1%; R_0805_2012Metric__V2_R4; MPN RC0805FR-07100KL; LCSC C110775
R5: 1M 1%; R_0805_2012Metric__V2_R5; MPN RC0805FR-071ML
R6: 120R; R_0805_2012Metric__V2_R6; MPN RC0805FR-07120RL
R7: 100k 1%; R_0805_2012Metric__V2_R7; MPN RC0805FR-07100KL; LCSC C856623
R8: 10k 1%; R_0805_2012Metric__V2_R8; MPN RC0805FR-0710KL
R9: 10k; R_0805_2012Metric__V2_R9; MPN RC0805FR-0710KL
R10: 10k; R_0805_2012Metric__V2_R10; MPN RC0805FR-0710KL
R11: 10k; R_0805_2012Metric__V2_R11; MPN RC0805FR-0710KL
R56: 1.8R 1% 1W; R_2512_6332Metric__A3_R56; MPN RC2512FK-071R8L
TP9: SOLAR; TestPoint_Pad_D1p5mm_A3_Edge_R0p9; MPN PCB test pad / not purchased
U1: CN3722; TSSOP-16_4.4x5mm_P0.65mm__V2_U1; MPN CN3722; LCSC C77905

Connections:
/GATE: Q1.1 (G), U1.16 (DRV)
BAT_SYS: C4.1, C30.1, R1.2, R3.1, U1.14 (BAT); also elsewhere on the board
CHG_CS_M: R1.1, R56.2; also elsewhere on the board
CHRG: D3.1 (K), U1.4 (CHRG)
CS_P: L1.2, R56.1, U1.13 (CSP); also elsewhere on the board
DONE: D4.1 (K), U1.5 (DONE)
GND: C1.2, C2.2, C4.2, C5.2, C6.2, C7.2, C8.2, D2.2 (A), J7.2, R4.2, R5.2, R8.2, R9.2, U1.2 (PGND), U1.3 (GND); also elsewhere on the board
unnamed: C6.1, R6.2
unnamed: D1.2 (A), Q1.3 (D)
unnamed: D1.1 (K), D2.1 (K), L1.1
unnamed: D3.2 (A), R10.2
unnamed: D4.2 (A), R11.2
unnamed: C5.1, R5.1, U1.8 (COM1)
unnamed: R6.1, U1.9 (COM2)
unnamed: C7.1, U1.11 (COM3)
unnamed: C30.2, R3.2, R4.1, U1.10 (FB)
unnamed: R7.2, R8.1, U1.7 (MPPT)
unnamed: R9.1, U1.6 (TEMP)
unnamed: C3.2, U1.1 (VG)
SOLAR: C1.1, C2.1, C3.1, C8.1, J7.1, Q1.2 (S), R7.1, R10.1, R11.1, TP9.1, U1.15 (VCC); also elsewhere on the board

Notes on the sheet:
0805
0805 (2012)
2512 / 6.3 x 3.2 mm
XH 1x2 / 2.50 / 90deg
Kelvin: CSP до R56; BAT после R1
CL21B104KBCNNNC
EEEFK1V470P
RC0805FR-0710KL
Панель 12 В. Холодный Voc ≤ 24 В.
RC0805FR-07100KL
FYLS-0805BUGC
MPPT: Vmp ≈ 11,44 В. R7/R8 = 100/10 кОм. Vmp ≈ 18 В: изменить R7.
RC0805FR-071ML
CDRH127/LDNP-101MC
CL31B106KBHNNNE
SS24
01. Солнечная зарядка CN3722 / аккумулятор Na-ion 1S
FYLS-0805BURC
S2B-XH-A(LF)(SN)
CC0805JRNPO9
RC2512FK-071R8L
1206
CN3722
WSL2512R2800FEA
V2.0-A6 / 2026-10-24 / инженерный прототип
Na-ion: R3 60,4k / R4 100k; C30 12pF; CV тип. 3,878 В; расч. max 3,982 В LTO 2S: R3 118k / R4 100k; C30 6,8pF; CV тип. 5,273 В; расч. max 5,452 В 1%; ТКС ±100 ppm/°C; ΔT=65°C. Установившийся режим; выбросы не учтены.
Na-ion / опция: R56 = 1,8 Ом; холод ≈ 96 мА; тепло ≈ 665 мА. Управление: лист 4. LTO / без опции: R56 = 0 Ом; узел Thermal не ставить. R1 = 0,28 Ом: ток ≈ 714 мА, максимум ≈ 784 мА.
BAT sense
SOT-23
CL21A226MAQNNNE
RC0805FR-0760K4L
RC0805FR-07120RL
TEMP: защита отключена по заданию.
SOLAR
TSSOP-16, 4.4x5 mm
SMD / D6.3 x 5.8 mm
SMB / DO-214AA
CC0805KKX7R9BB224
BN471
AO3401A
CC0805JRNPO9BN120
12.3 x 12.3 x 8 mm

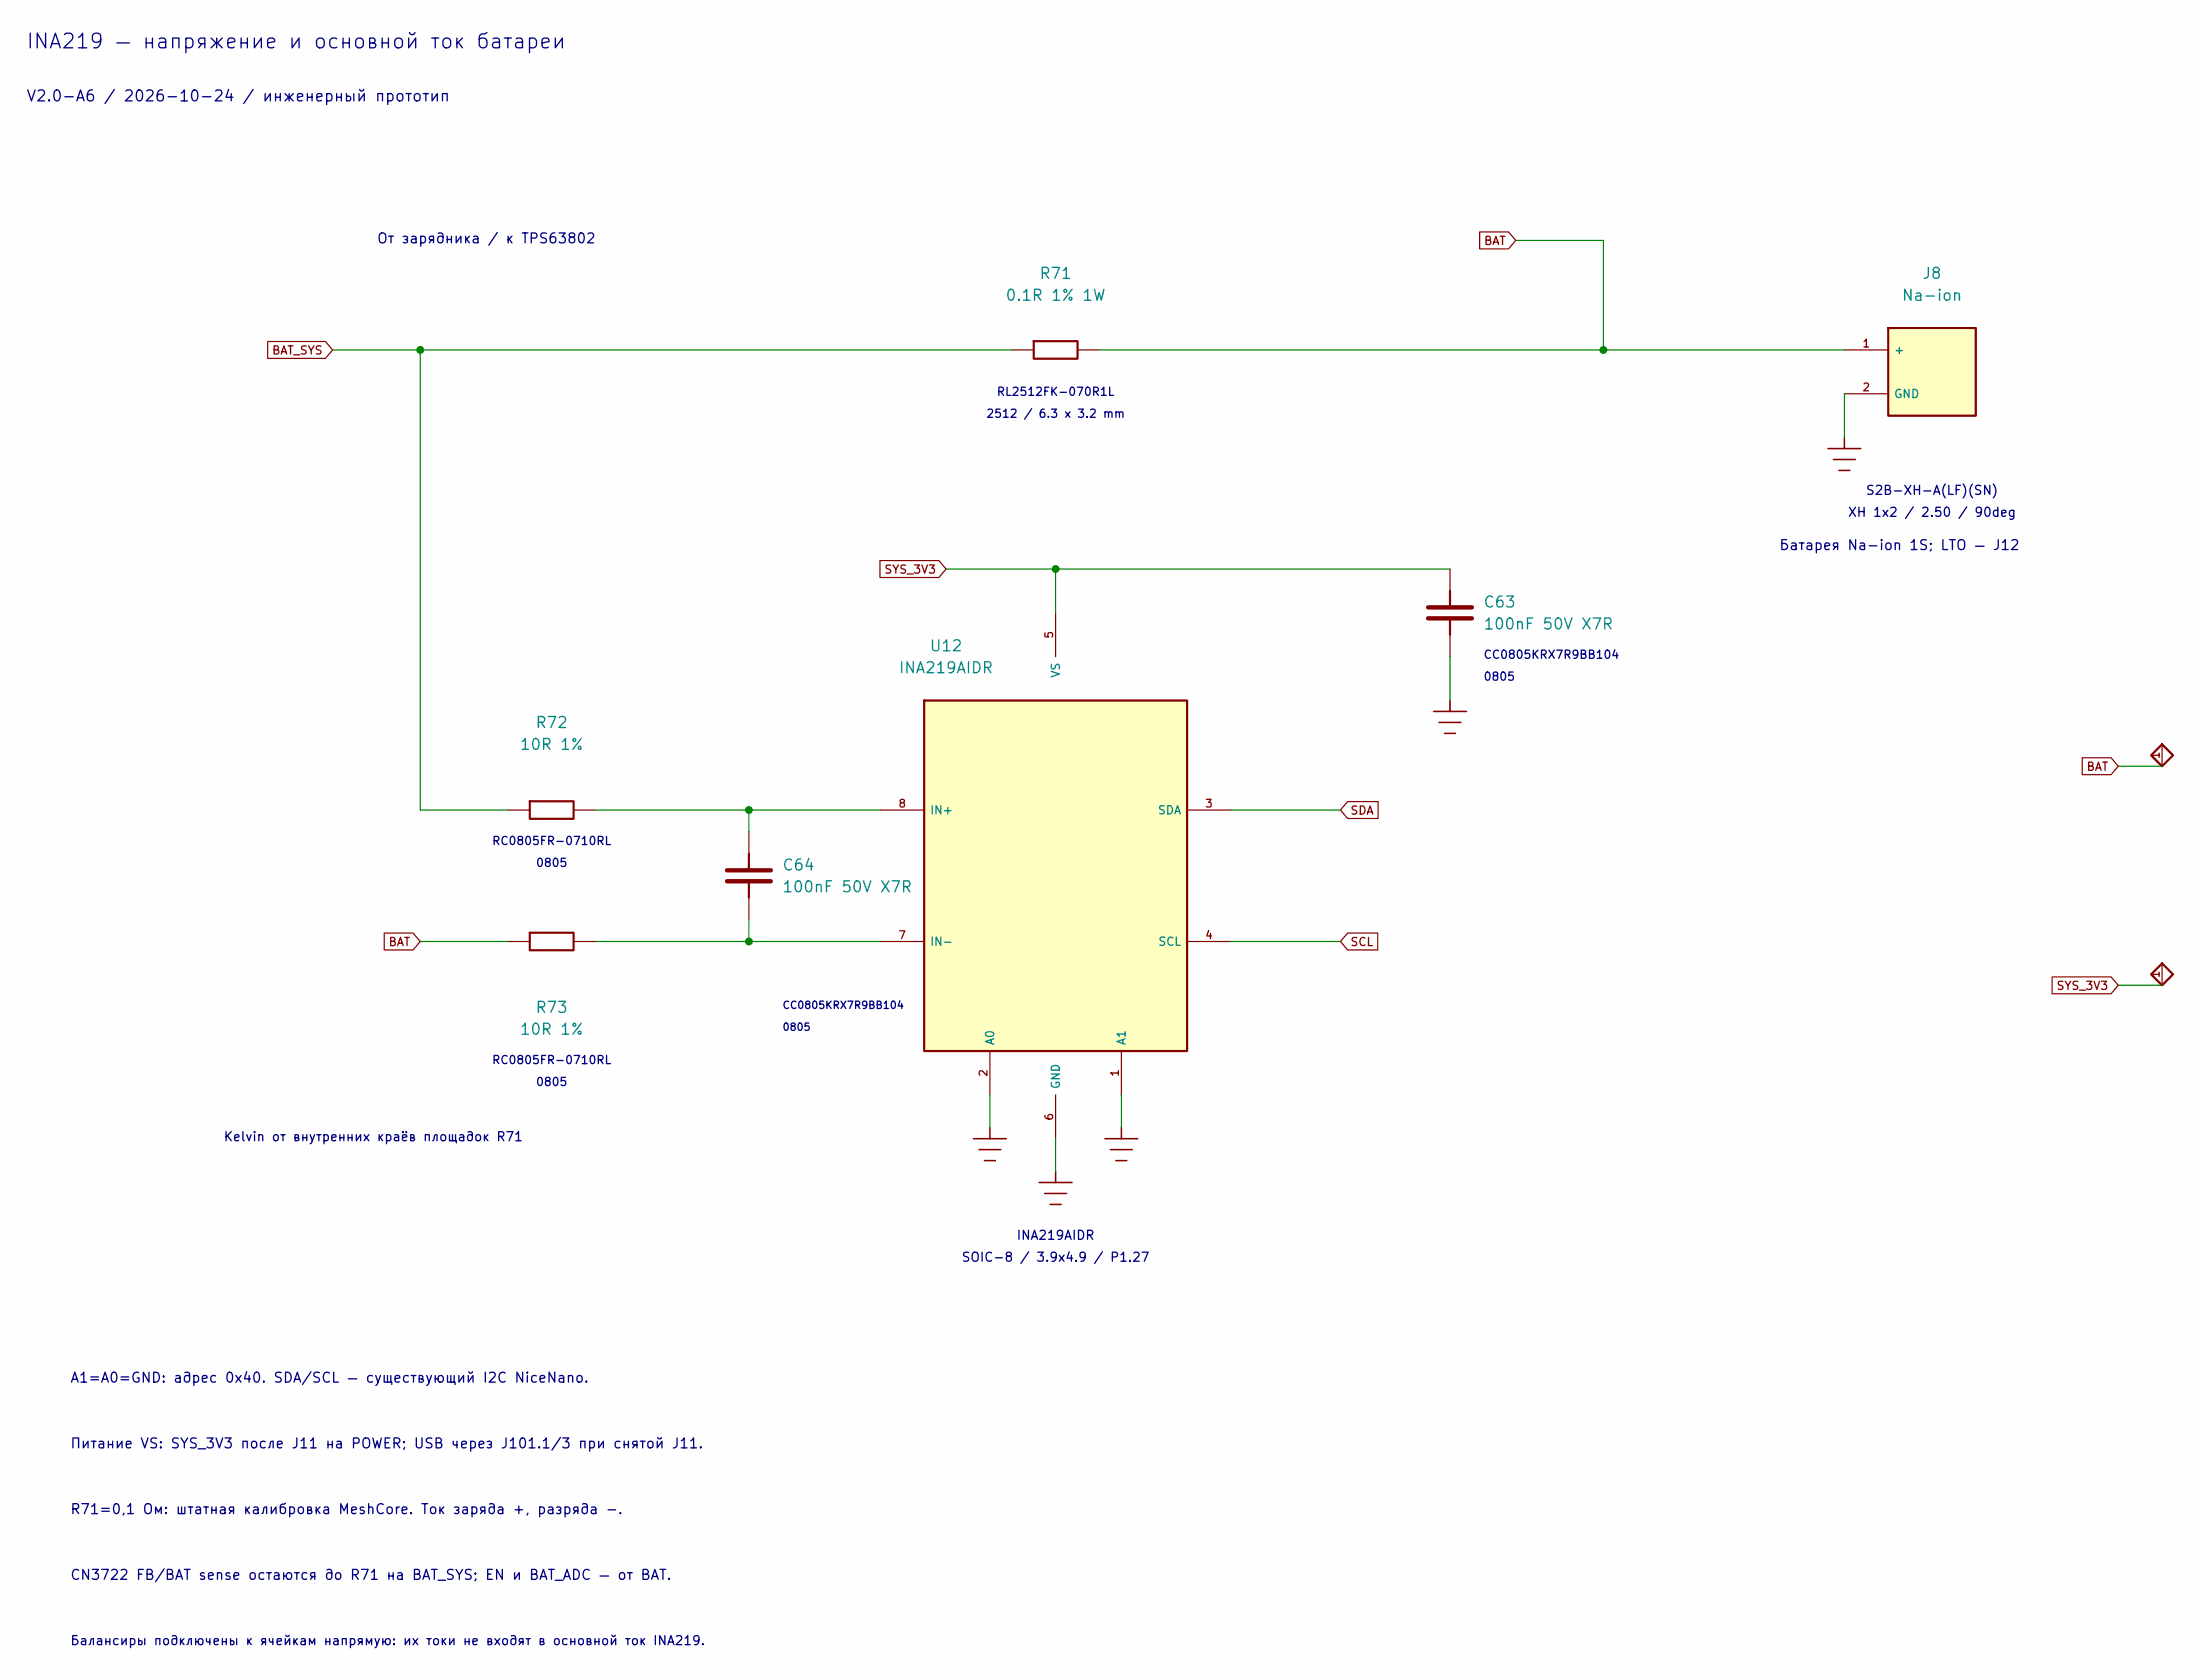
[picture p112: schematic BatteryMonitor.kicad_sch, INA219 / батарея и ток]

Parts:
C63: 100nF 50V X7R; C_0805_2012Metric__V2_C63; MPN CC0805KRX7R9BB104
C64: 100nF 50V X7R; C_0805_2012Metric__V2_C64; MPN CC0805KRX7R9BB104
J8: Na-ion; JST_XH_S2B-XH-A_1x02_P2.50mm_Horizontal__V2_J8; MPN JST S2B-XH-A(LF)(SN)
R71: 0.1R 1% 1W; R_2512_6332Metric__A3_R71; MPN RL2512FK-070R1L
R72: 10R 1%; R_0805_2012Metric__V2_R72; MPN RC0805FR-0710RL
R73: 10R 1%; R_0805_2012Metric__V2_R73; MPN RC0805FR-0710RL
U12: INA219AIDR; SOIC-8_3.9x4.9mm_P1.27mm__V2_U12; MPN INA219AIDR

Connections:
BAT: J8.1 (+), R71.2, R73.1; also elsewhere on the board
BAT_SYS: R71.1, R72.1; also elsewhere on the board
GND: C63.2, J8.2 (GND), U12.1 (A1), U12.2 (A0), U12.6 (GND); also elsewhere on the board
unnamed: C64.1, R72.2, U12.8 (IN+)
unnamed: C64.2, R73.2, U12.7 (IN-)
SCL: U12.4 (SCL); also elsewhere on the board
SDA: U12.3 (SDA); also elsewhere on the board
SYS_3V3: C63.1, U12.5 (VS); also elsewhere on the board

Notes on the sheet:
CC0805KRX7R9BB104
От зарядника / к TPS63802
R71=0,1 Ом: штатная калибровка MeshCore. Ток заряда +, разряда −.
RC0805FR-0710RL
XH 1x2 / 2.50 / 90deg
0805
CN3722 FB/BAT sense остаются до R71 на BAT_SYS; EN и BAT_ADC — от BAT.
SOIC-8 / 3.9x4.9 / P1.27
Балансиры подключены к ячейкам напрямую: их токи не входят в основной ток INA219.
A1=A0=GND: адрес 0x40. SDA/SCL — существующий I2C NiceNano.
RL2512FK-070R1L
V2.0-A6 / 2026-10-24 / инженерный прототип
INA219 — напряжение и основной ток батареи
Питание VS: SYS_3V3 после J11 на POWER; USB через J101.1/3 при снятой J11.
INA219AIDR
Kelvin от внутренних краёв площадок R71
S2B-XH-A(LF)(SN)
Батарея Na-ion 1S; LTO — J12
2512 / 6.3 x 3.2 mm

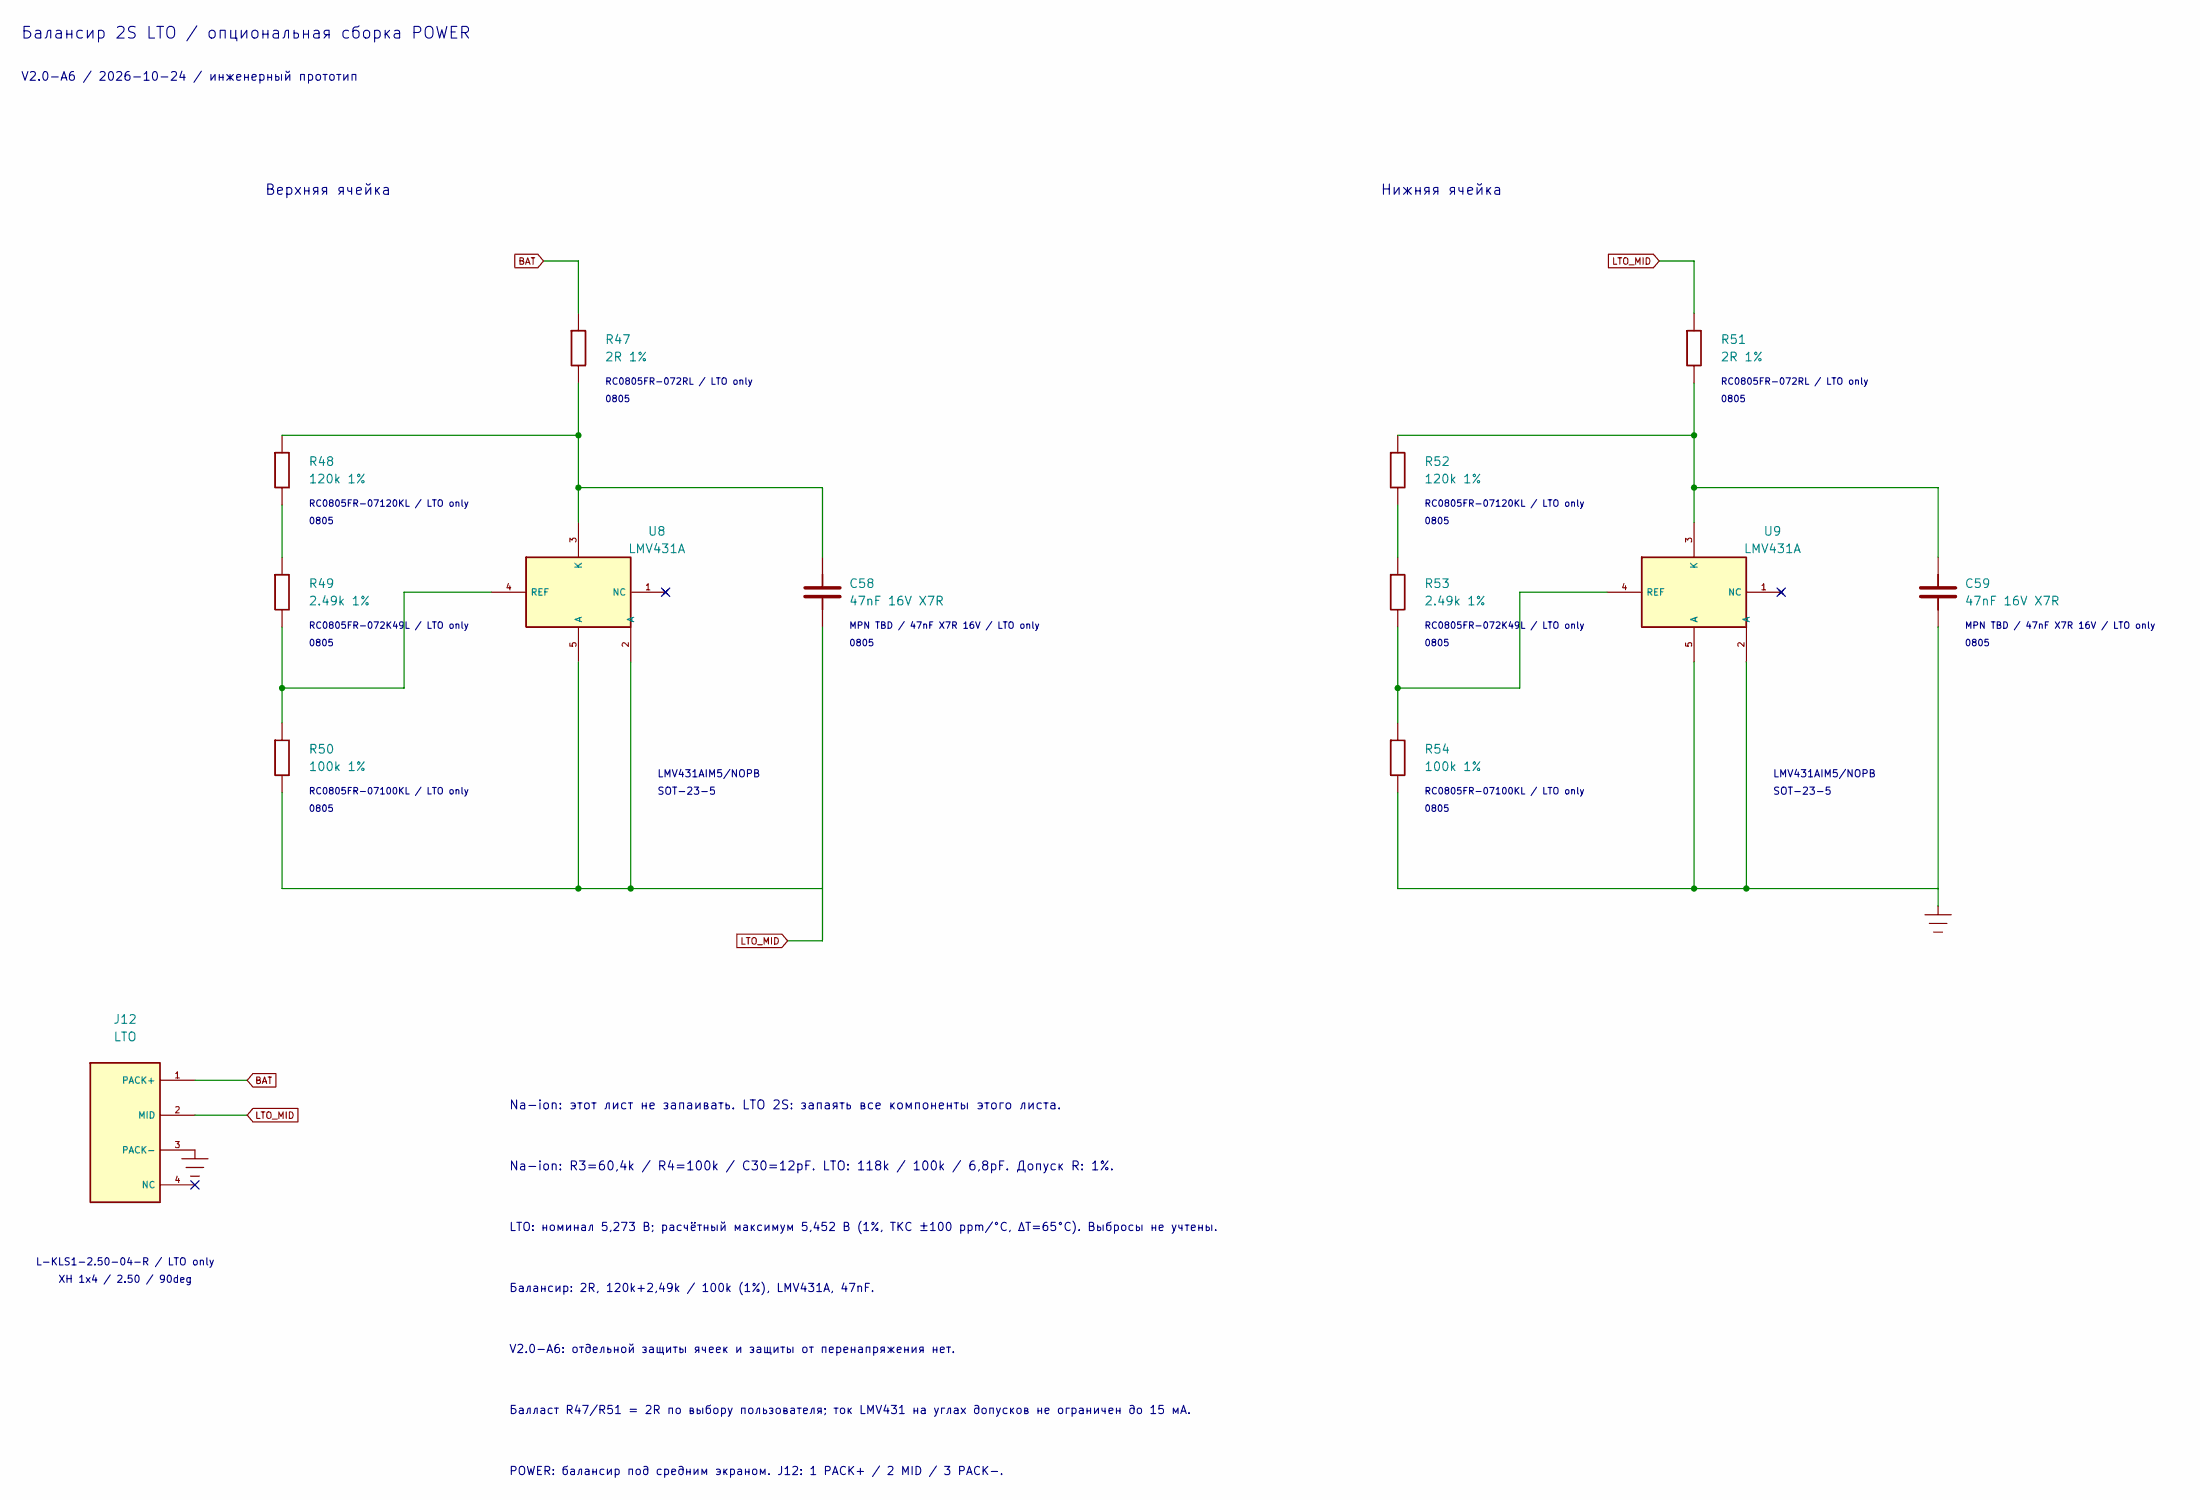
[picture p113: schematic LTO_Balancer.kicad_sch, LMV431A / LTO 2S опция]

Parts:
C58: 47nF 16V X7R; C_0805_2012Metric__V2_C58; MPN MPN TBD / 47nF X7R 16V
C59: 47nF 16V X7R; C_0805_2012Metric__V2_C59; MPN MPN TBD / 47nF X7R 16V
J12: LTO; KLS_XH_L_KLS1_2_50_04_R_Horizontal__V2_J12; MPN KLS L-KLS1-2.50-04-R
R47: 2R 1%; R_0805_2012Metric__V2_R47; MPN RC0805FR-072RL; LCSC C110775
R48: 120k 1%; R_0805_2012Metric__V2_R48; MPN RC0805FR-07120KL; LCSC C110775
R49: 2.49k 1%; R_0805_2012Metric__V2_R49; MPN RC0805FR-072K49L; LCSC C110775
R50: 100k 1%; R_0805_2012Metric__V2_R50; MPN RC0805FR-07100KL; LCSC C110775
R51: 2R 1%; R_0805_2012Metric__V2_R51; MPN RC0805FR-072RL; LCSC C110775
R52: 120k 1%; R_0805_2012Metric__V2_R52; MPN RC0805FR-07120KL; LCSC C110775
R53: 2.49k 1%; R_0805_2012Metric__V2_R53; MPN RC0805FR-072K49L; LCSC C110775
R54: 100k 1%; R_0805_2012Metric__V2_R54; MPN RC0805FR-07100KL; LCSC C110775
U8: LMV431A; SOT-23-5__V2_U8; MPN LMV431AIM5/NOPB
U9: LMV431A; SOT-23-5__V2_U9; MPN LMV431AIM5/NOPB

Connections:
BAT: J12.1 (PACK+), R47.1; also elsewhere on the board
GND: C59.2, J12.3 (PACK-), R54.2, U9.2 (A), U9.5 (A); also elsewhere on the board
LTO_MID: C58.2, J12.2 (MID), R50.2, R51.1, U8.2 (A), U8.5 (A)
unnamed: R48.2, R49.1
unnamed: R52.2, R53.1
unnamed: C58.1, R47.2, R48.1, U8.3 (K)
unnamed: R49.2, R50.1, U8.4 (REF)
unnamed: C59.1, R51.2, R52.1, U9.3 (K)
unnamed: R53.2, R54.1, U9.4 (REF)

Notes on the sheet:
POWER: балансир под средним экраном. J12: 1 PACK+ / 2 MID / 3 PACK-.
V2.0-A6: отдельной защиты ячеек и защиты от перенапряжения нет.
MPN TBD / 47nF X7R 16V / LTO only
Балансир: 2R, 120k+2,49k / 100k (1%), LMV431A, 47nF.
Нижняя ячейка
Балласт R47/R51 = 2R по выбору пользователя; ток LMV431 на углах допусков не ограничен до 15 мА.
0805
Na-ion: этот лист не запаивать. LTO 2S: запаять все компоненты этого листа.
RC0805FR-072RL / LTO only
SOT-23-5
LMV431AIM5/NOPB
RC0805FR-07100KL / LTO only
RC0805FR-07120KL / LTO only
RC0805FR-072K49L / LTO only
Верхняя ячейка
Na-ion: R3=60,4k / R4=100k / C30=12pF. LTO: 118k / 100k / 6,8pF. Допуск R: 1%.
XH 1x4 / 2.50 / 90deg
L-KLS1-2.50-04-R / LTO only
Балансир 2S LTO / опциональная сборка POWER
V2.0-A6 / 2026-10-24 / инженерный прототип
LTO: номинал 5,273 В; расчётный максимум 5,452 В (1%, ТКС ±100 ppm/°C, ΔT=65°C). Выбросы не учтены.

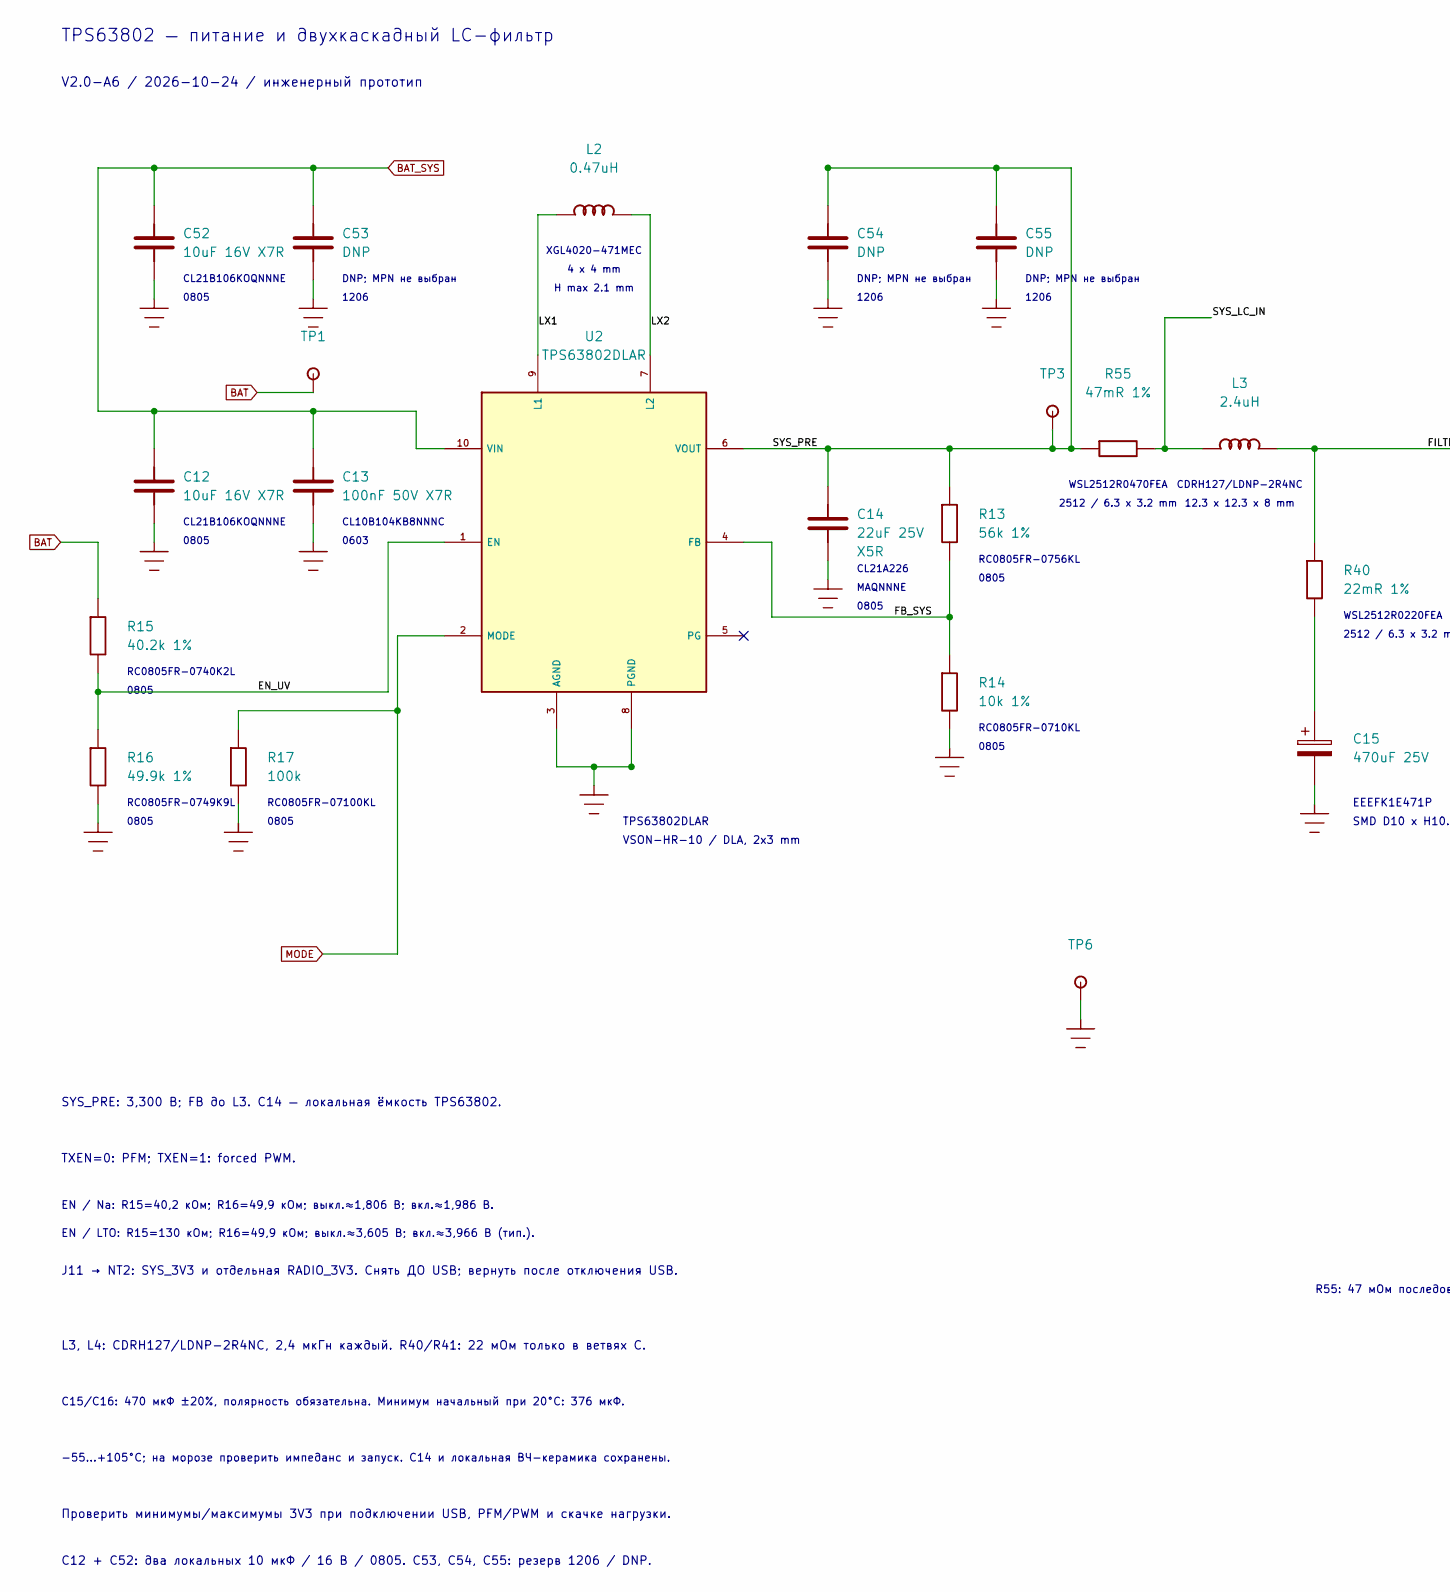
[picture p114: schematic Converter.kicad_sch, TPS63802 / питание и фильтр, part in row 1, column 1]

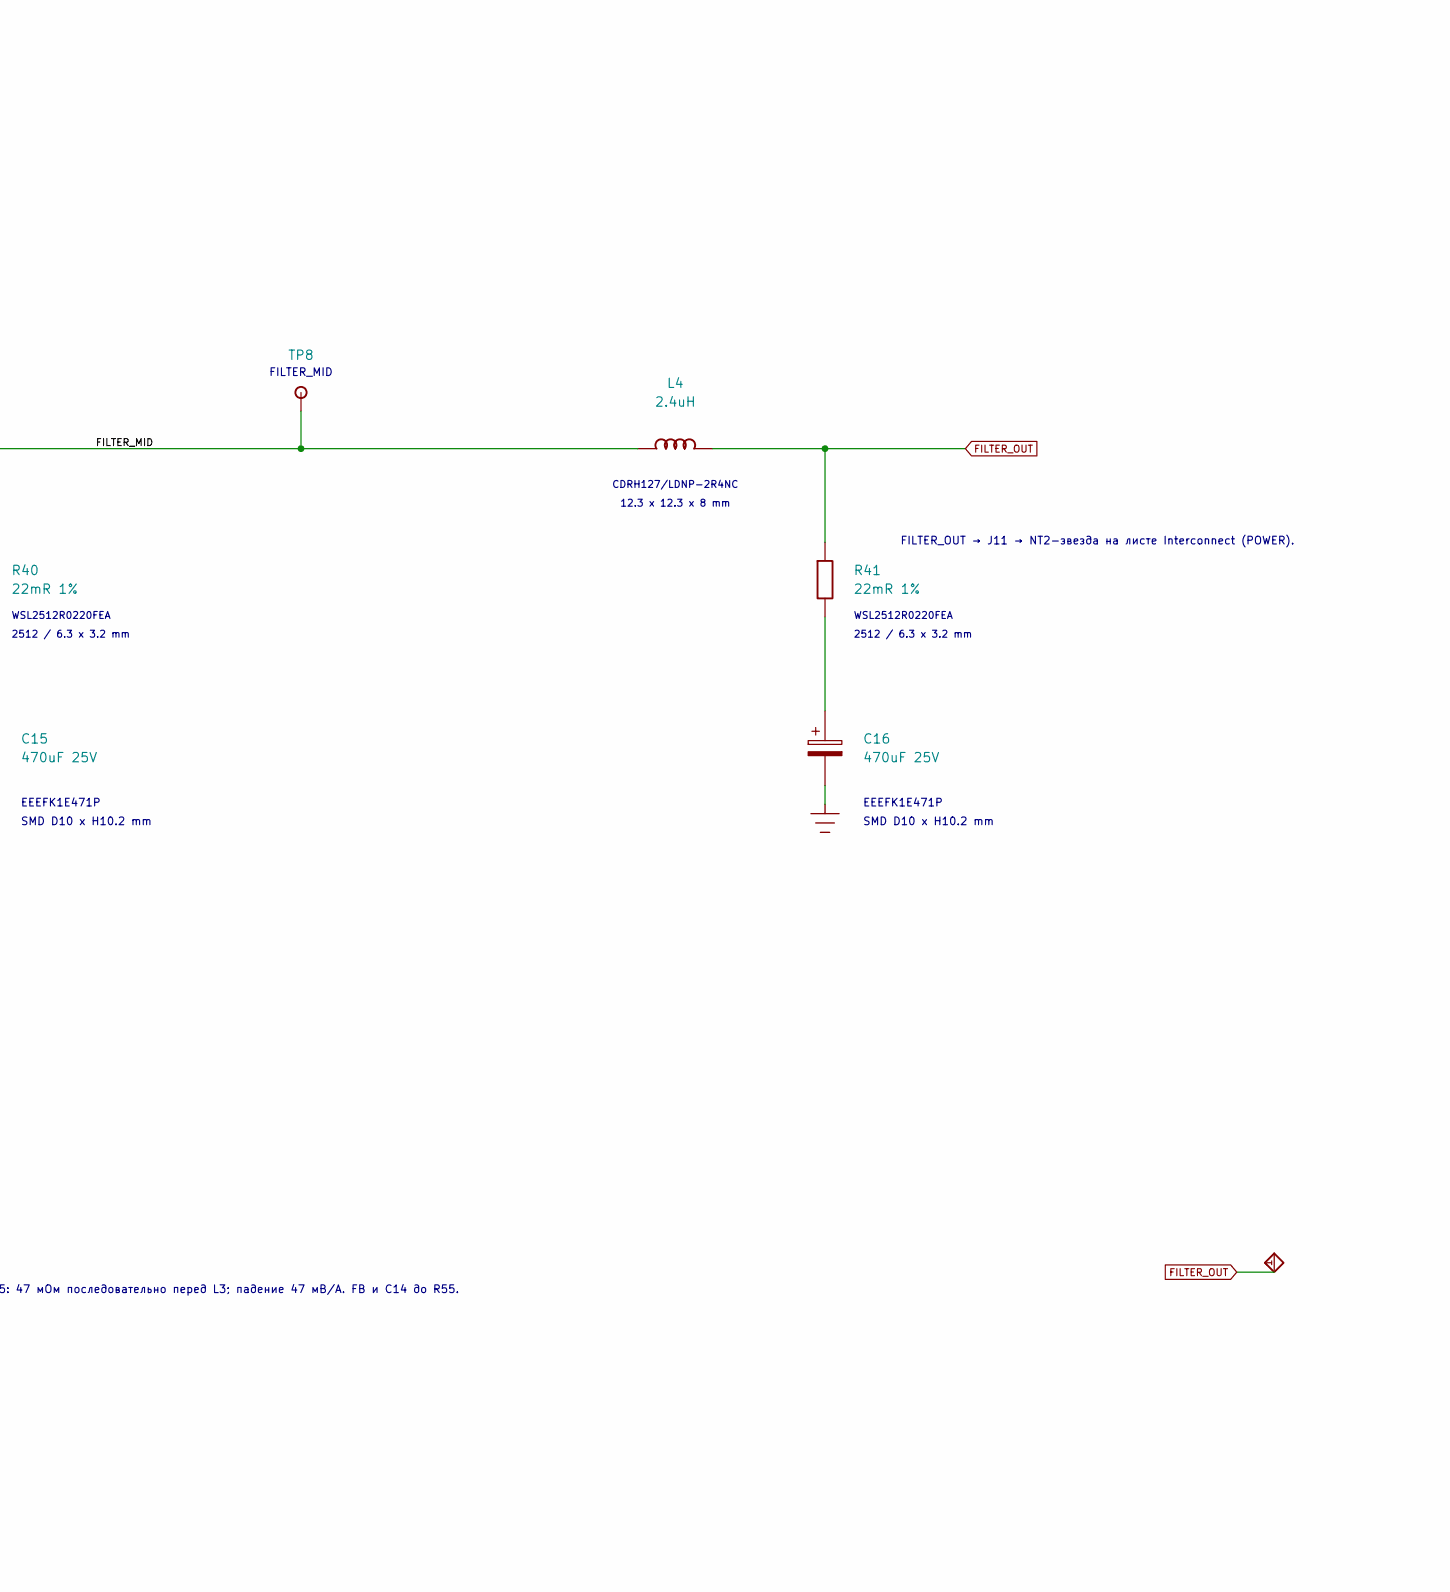
[picture p115: schematic Converter.kicad_sch, TPS63802 / питание и фильтр, part in row 1, column 2]

Parts:
C12: 10uF 16V X7R; C_0805_2012Metric__V2_C12; MPN CL21B106KOQNNNE
C13: 100nF 50V X7R; C_0805_2012Metric; MPN CL21B104KBCNNNC
C14: 22uF 25V X5R; C_0805_2012Metric__V2_C14; MPN CL21A226MAQNNNE
C15, C16: 470uF 25V; CP_Elec_10x10.2; MPN EEEFK1E471P
C52: 10uF 16V X7R; C_0805_2012Metric__V2_C52; MPN CL21B106KOQNNNE
C53: DNP; C_1206_3216Metric__V2_C53
C54: DNP; C_1206_3216Metric__V2_C54
C55: DNP; C_1206_3216Metric__V2_C55
L2: 0.47uH; L_Coilcraft_XGL4020_471MEC_HandSolderUniversal; MPN XGL4020-471MEC; LCSC C5837785
L3: 2.4uH; L_Sumida_CDRH127_LD__V2_L3; MPN CDRH127/LDNP-2R4NC
L4: 2.4uH; L_Sumida_CDRH127_LD__V2_L4; MPN CDRH127/LDNP-2R4NC
R13: 56k 1%; R_0805_2012Metric__V2_R13; MPN RC0805FR-0756KL; LCSC C2523584
R14: 10k 1%; R_0805_2012Metric__V2_R14; MPN RC0805FR-0710KL
R15: 40.2k 1%; R_0805_2012Metric__V2_R15; MPN RC0805FR-0740K2L; LCSC C865475
R16: 49.9k 1%; R_0805_2012Metric__V2_R16; MPN RC0805FR-0749K9L; LCSC C469661
R17: 100k; R_0805_2012Metric__V2_R17; MPN RC0805FR-07100KL
R40: 22mR 1%; R_Vishay_WSL2512_A3__A3_R40; MPN WSL2512R0220FEA; LCSC C4041551
R41: 22mR 1%; R_Vishay_WSL2512_A3__A3_R41; MPN WSL2512R0220FEA; LCSC C4041551
R55: 47mR 1%; R_Vishay_WSL2512_A3__A3_R55; MPN WSL2512R0470FEA
TP1: BAT; TestPoint_Pad_D1p5mm_A3_Edge_R0p9
TP3: SYS_PRE; TestPoint_Pad_D1.5mm__V2_TP3
TP6: GND; TestPoint_Pad_D1p5mm_A3_Edge_R0p9
TP8: FILTER_MID; TestPoint_Pad_D1.5mm__V2_TP8; MPN PCB test pad / not purchased
U2: TPS63802DLAR; TPS63802_DLA0010A__V2_U2; MPN TPS63802DLAR; LCSC C2845237

Connections:
/2. Converter/EN_UV: R15.2, R16.1, U2.1 (EN)
/2. Converter/FB_SYS: R13.2, R14.1, U2.4 (FB)
/2. Converter/FILTER_MID: L3.2, L4.1, R40.1, TP8.1
/2. Converter/LX1: L2.1, U2.9 (L1)
/2. Converter/LX2: L2.2, U2.7 (L2)
/2. Converter/SYS_LC_IN: L3.1, R55.2
/2. Converter/SYS_PRE: C14.1, C54.1, C55.1, R13.1, R55.1, TP3.1, U2.6 (VOUT)
BAT: R15.1, TP1.1; also elsewhere on the board
BAT_SYS: C12.1, C13.1, C52.1, C53.1, U2.10 (VIN); also elsewhere on the board
FILTER_OUT: L4.2, R41.1; also elsewhere on the board
GND: C12.2, C13.2, C14.2, C15.2, C16.2, C52.2, C53.2, C54.2, C55.2, R14.2, R16.2, R17.2, TP6.1, U2.3 (AGND), U2.8 (PGND); also elsewhere on the board
MODE: R17.1, U2.2 (MODE); also elsewhere on the board
unnamed: C15.1, R40.2
unnamed: C16.1, R41.2

Notes on the sheet:
EN / Na: R15=40,2 кОм; R16=49,9 кОм; выкл.≈1,806 В; вкл.≈1,986 В.
Проверить минимумы/максимумы 3V3 при подключении USB, PFM/PWM и скачке нагрузки.
DNP; MPN не выбран
CDRH127/LDNP-2R4NC
L3, L4: CDRH127/LDNP-2R4NC, 2,4 мкГн каждый. R40/R41: 22 мОм только в ветвях C.
CL21A226
0805
RC0805FR-0756KL
C12 + C52: два локальных 10 мкФ / 16 В / 0805. C53, C54, C55: резерв 1206 / DNP.
VSON-HR-10 / DLA, 2x3 mm
1206
12.3 x 12.3 x 8 mm
CL10B104KB8NNNC
TPS63802 — питание и двухкаскадный LC-фильтр
R55: 47 мОм последовательно перед L3; падение 47 мВ/А. FB и C14 до R55.
H max 2.1 mm
J11 → NT2: SYS_3V3 и отдельная RADIO_3V3. Снять ДО USB; вернуть после отключения USB.
WSL2512R0470FEA
CL21B106KOQNNNE
4 x 4 mm
RC0805FR-0710KL
2512 / 6.3 x 3.2 mm
RC0805FR-0740K2L
SYS_PRE: 3,300 В; FB до L3. C14 — локальная ёмкость TPS63802.
FILTER_OUT → J11 → NT2-звезда на листе Interconnect (POWER).
TPS63802DLAR
TXEN=0: PFM; TXEN=1: forced PWM.
V2.0-A6 / 2026-10-24 / инженерный прототип
WSL2512R0220FEA
EN / LTO: R15=130 кОм; R16=49,9 кОм; выкл.≈3,605 В; вкл.≈3,966 В (тип.).
0603
RC0805FR-07100KL
XGL4020-471MEC
MAQNNNE
RC0805FR-0749K9L
FILTER_MID
EEEFK1E471P
SMD D10 x H10.2 mm
C15/C16: 470 мкФ ±20%, полярность обязательна. Минимум начальный при 20°C: 376 мкФ.
−55…+105°C; на морозе проверить импеданс и запуск. C14 и локальная ВЧ-керамика сохранены.
