Alksndr55/mesh-repeater-2.0/v2/design/MeshRepeater2_Power/MeshRepeater2_Power.kicad_pcb

## KiCad design v2/design/MeshRepeater2_Power/MeshRepeater2_Power.kicad_pcb (continued)

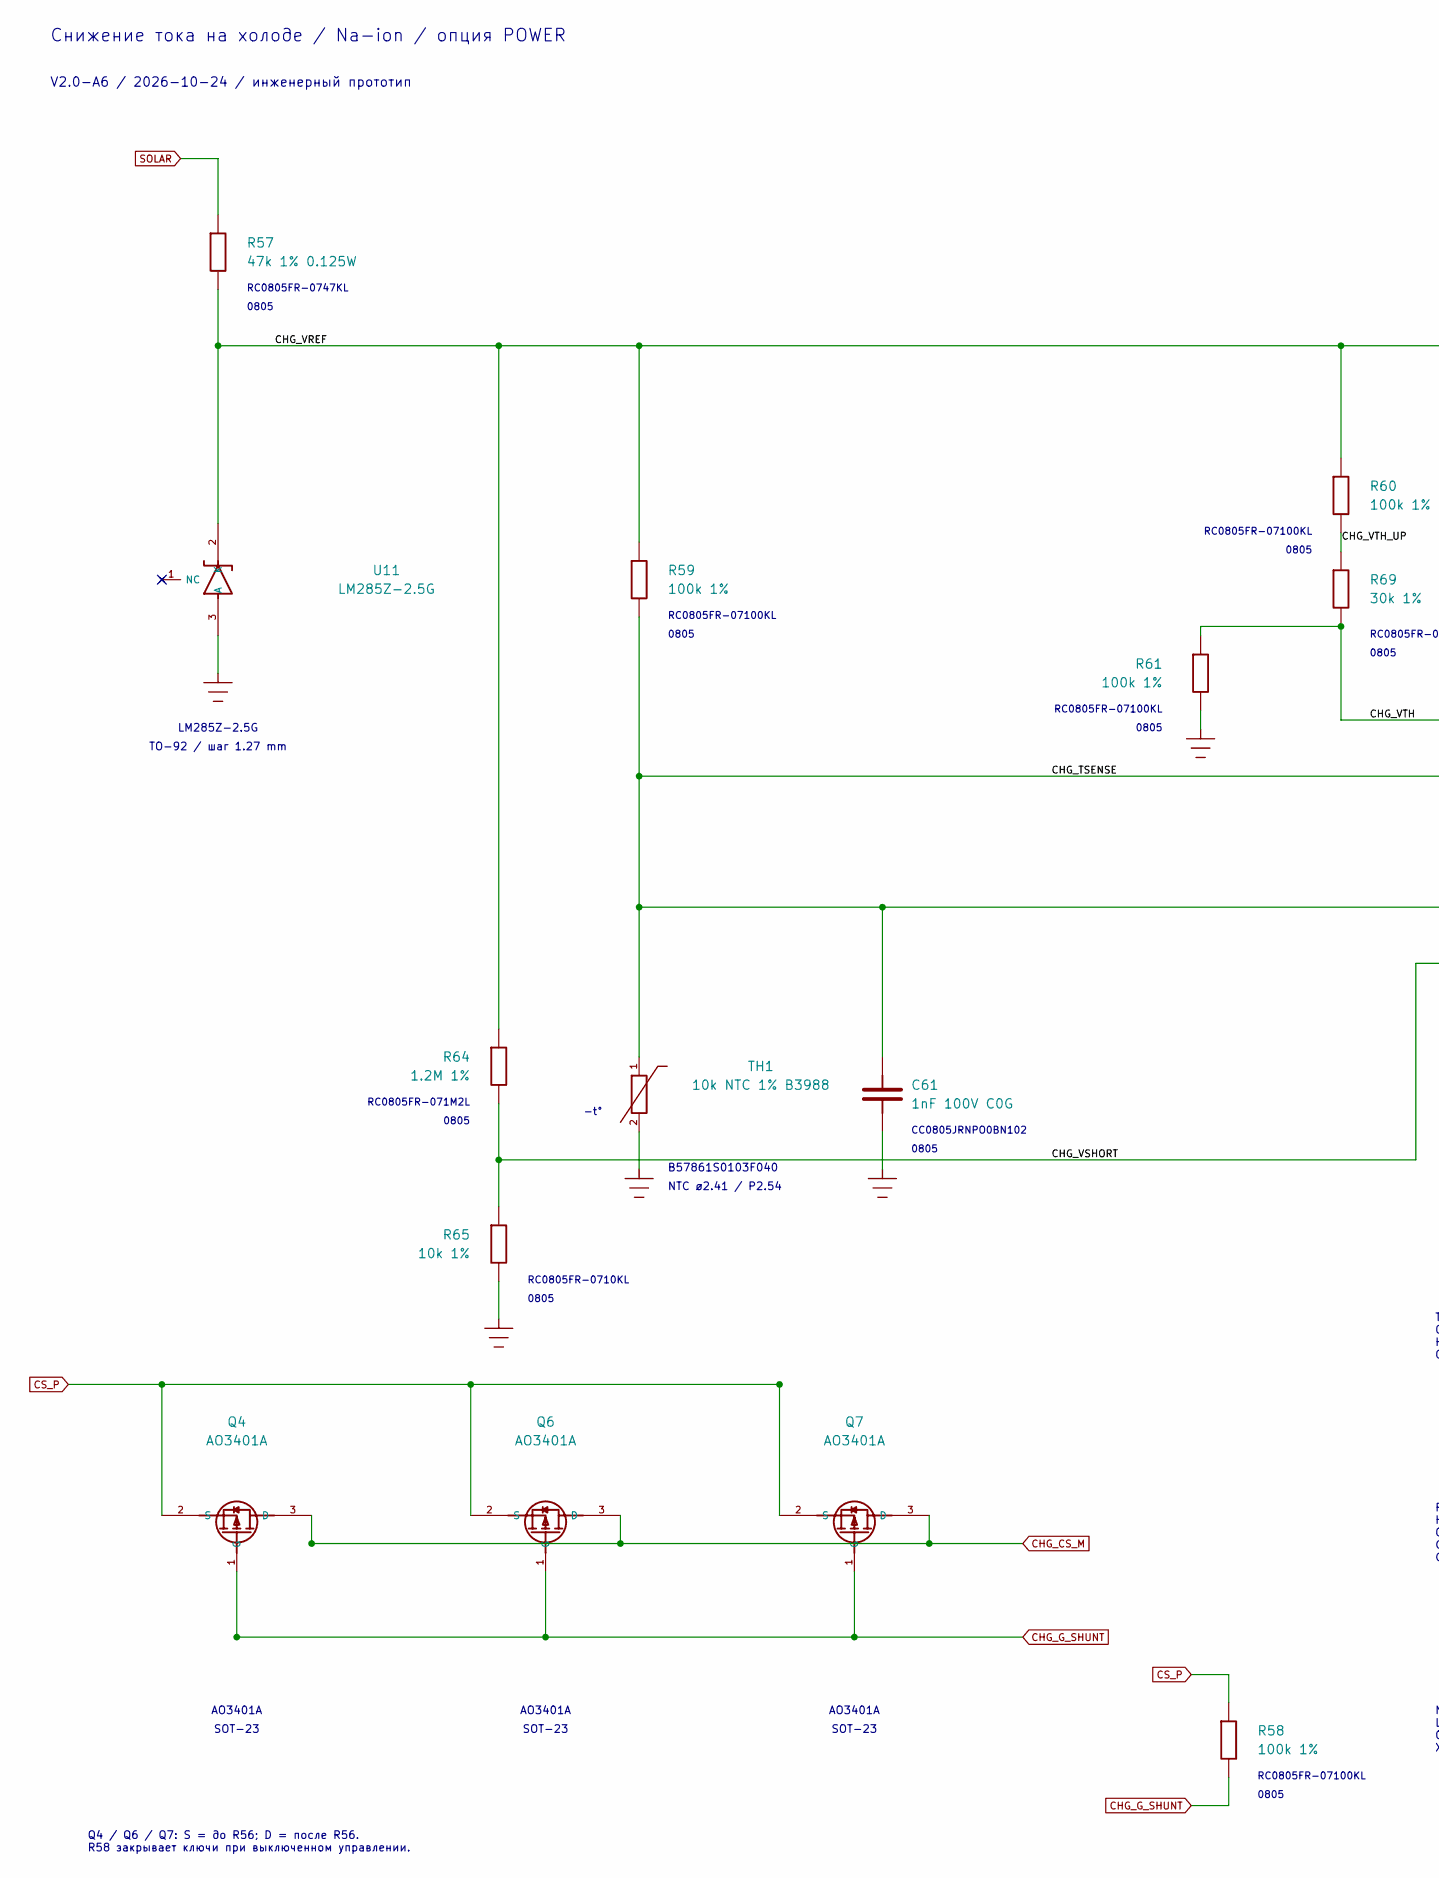
[picture p116: schematic Thermal.kicad_sch, LM393XK / холодный заряд Na-ion, part in row 1, column 1]

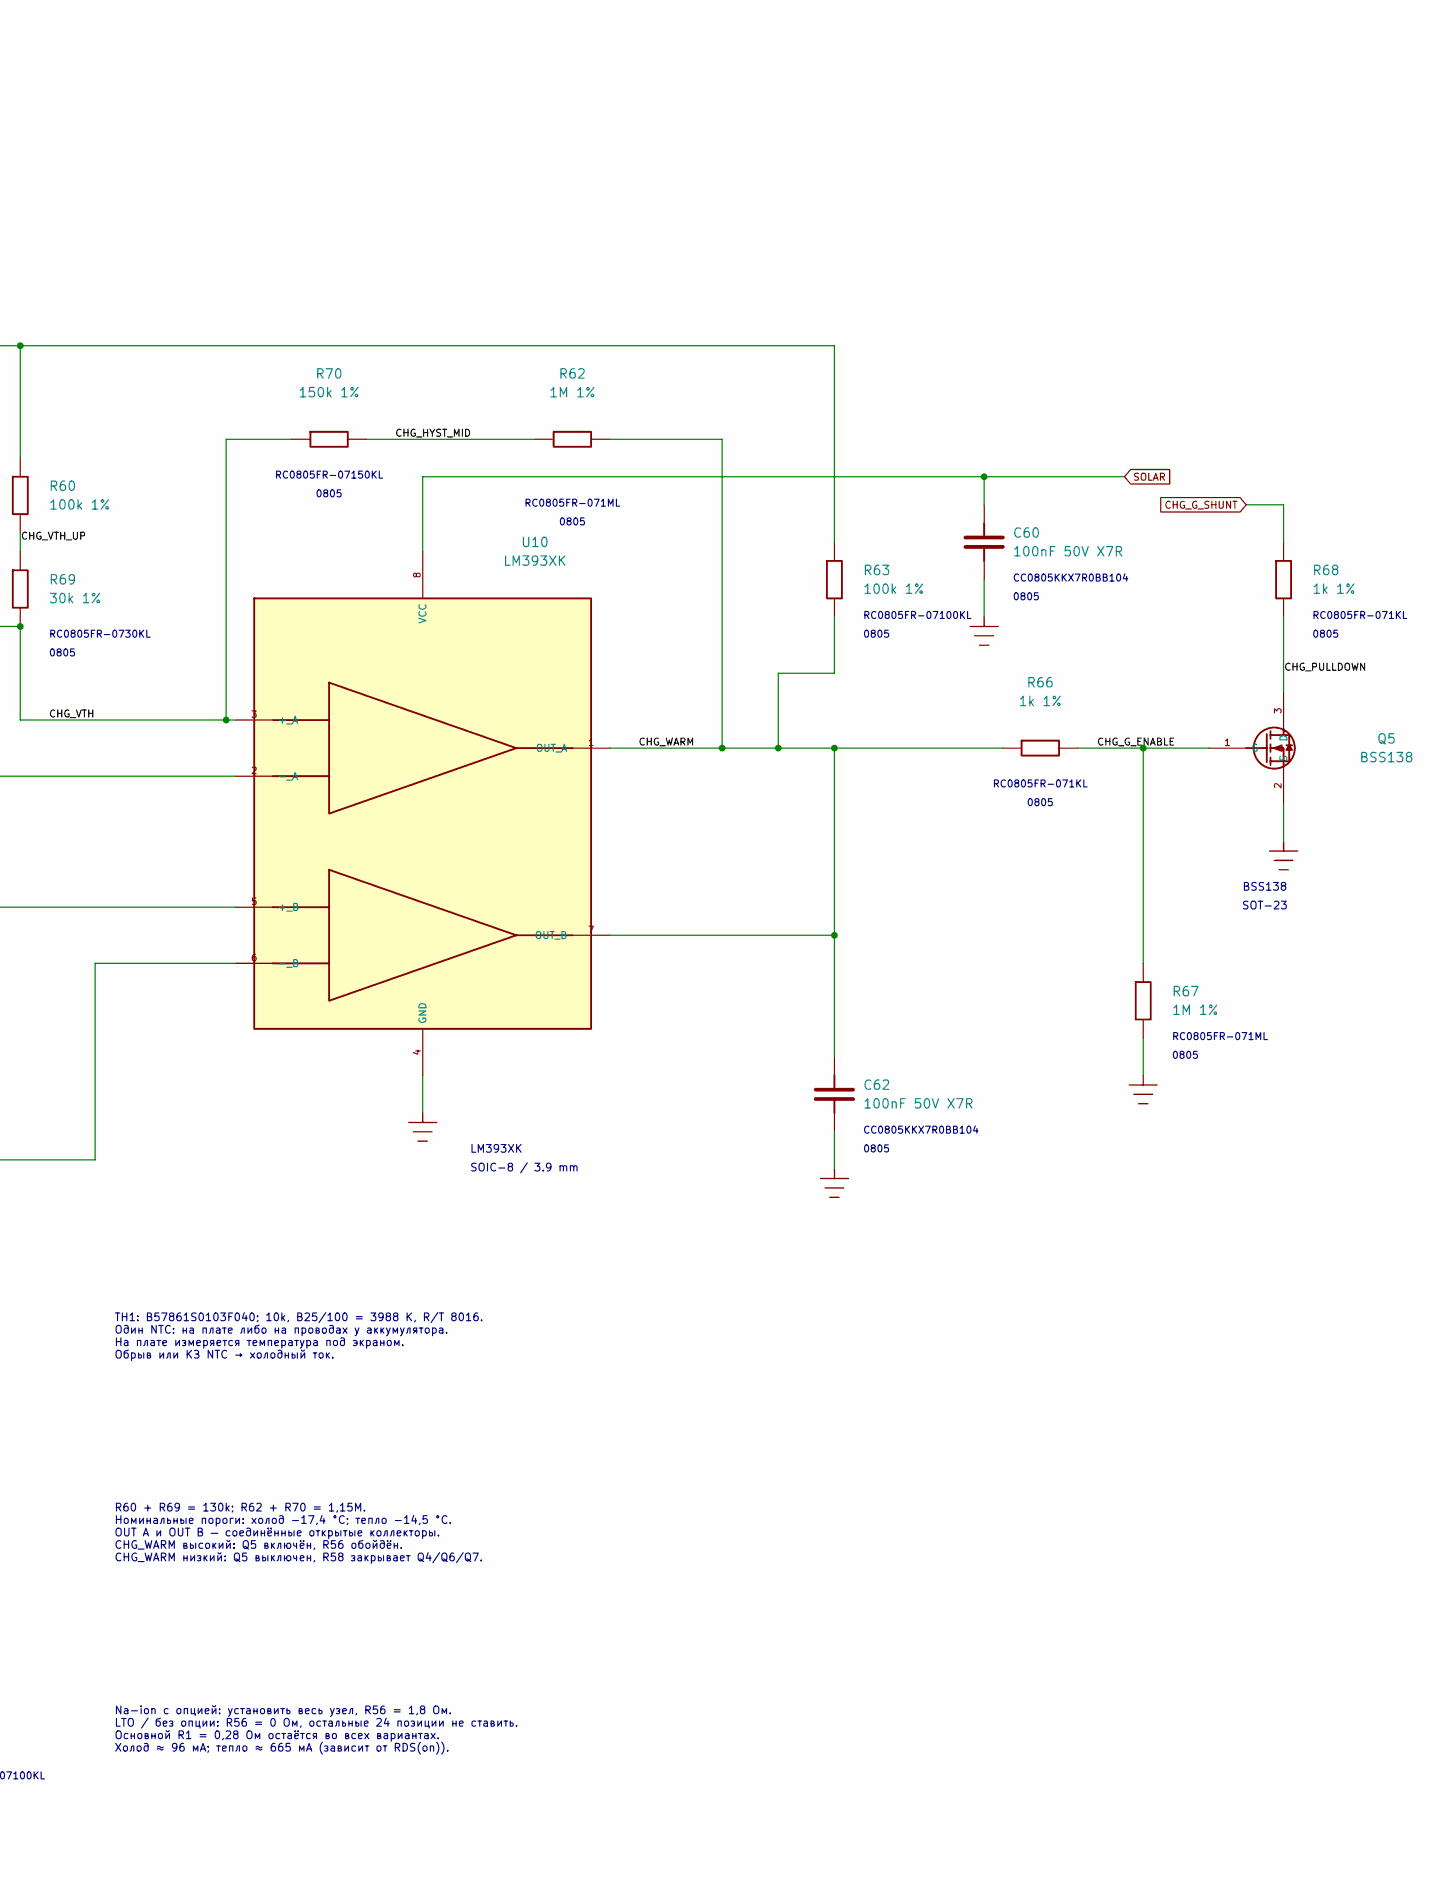
[picture p117: schematic Thermal.kicad_sch, LM393XK / холодный заряд Na-ion, part in row 1, column 2]

Parts:
C60: 100nF 50V X7R; C_0805_2012Metric__V2_C60; MPN CL21B104KBCNNNC
C61: 1nF 100V C0G; C_0805_2012Metric__V2_C61; MPN CC0805JRNPO0BN102
C62: 100nF 50V X7R; C_0805_2012Metric__V2_C62; MPN CL21B104KBCNNNC
Q4: AO3401A; SOT-23__V2_Q4; MPN AO3401A
Q5: BSS138; SOT-23__V2_Q5; MPN BSS138
Q6: AO3401A; SOT-23__V2_Q6; MPN AO3401A
Q7: AO3401A; SOT-23__V2_Q7; MPN AO3401A
R57: 47k 1% 0.125W; R_0805_2012Metric__V2_R57; MPN RC0805FR-0747KL
R58: 100k 1%; R_0805_2012Metric__V2_R58; MPN RC0805FR-07100KL
R59: 100k 1%; R_0805_2012Metric__V2_R59; MPN RC0805FR-07100KL
R60: 100k 1%; R_0805_2012Metric__V2_R60; MPN RC0805FR-07100KL
R61: 100k 1%; R_0805_2012Metric__V2_R61; MPN RC0805FR-07100KL
R62: 1M 1%; R_0805_2012Metric__V2_R62; MPN RC0805FR-071ML
R63: 100k 1%; R_0805_2012Metric__V2_R63; MPN RC0805FR-07100KL
R64: 1.2M 1%; R_0805_2012Metric__V2_R64; MPN RC0805FR-071M2L
R65: 10k 1%; R_0805_2012Metric__V2_R65; MPN RC0805FR-0710KL
R66: 1k 1%; R_0805_2012Metric__V2_R66; MPN RC0805FR-071KL
R67: 1M 1%; R_0805_2012Metric__V2_R67; MPN RC0805FR-071ML
R68: 1k 1%; R_0805_2012Metric__V2_R68; MPN RC0805FR-071KL
R69: 30k 1%; R_0805_2012Metric__V2_R69; MPN RC0805FR-0730KL
R70: 150k 1%; R_0805_2012Metric__V2_R70; MPN RC0805FR-07150KL
TH1: 10k NTC 1% B3988; NTC_TDK_B57861S_Onboard_or_Remote_P2.54mm__V2_TH1; MPN B57861S0103F040
U10: LM393XK; SOIC-8_3.9x4.9mm_P1.27mm__V2_U10; MPN LM393XK
U11: LM285Z-2.5G; TO-92_Inline__V2_U11; MPN LM285Z-2.5G

Connections:
/4. Thermal/CHG_G_ENABLE: Q5.1, R66.2, R67.1
/4. Thermal/CHG_HYST_MID: R62.2, R70.1
/4. Thermal/CHG_PULLDOWN: Q5.3, R68.2
/4. Thermal/CHG_TSENSE: C61.1, R59.2, TH1.1, U10.2, U10.5
/4. Thermal/CHG_VREF: R57.2, R59.1, R60.1, R63.1, R64.1, U11.2
/4. Thermal/CHG_VSHORT: R64.2, R65.1, U10.6
/4. Thermal/CHG_VTH: R61.1, R69.2, R70.2, U10.3
/4. Thermal/CHG_VTH_UP: R60.2, R69.1
/4. Thermal/CHG_WARM: C62.1, R62.1, R63.2, R66.1, U10.1, U10.7
CHG_CS_M: Q4.3, Q6.3, Q7.3; also elsewhere on the board
CHG_G_SHUNT: Q4.1, Q6.1, Q7.1, R58.2, R68.1
CS_P: Q4.2, Q6.2, Q7.2, R58.1; also elsewhere on the board
GND: C60.2, C61.2, C62.2, Q5.2, R61.2, R65.2, R67.2, TH1.2, U10.4, U11.3; also elsewhere on the board
SOLAR: C60.1, R57.1, U10.8; also elsewhere on the board

Notes on the sheet:
0805
RC0805FR-071ML
Na-ion с опцией: установить весь узел, R56 = 1,8 Ом. LTO / без опции: R56 = 0 Ом, остальные 24 позиции не ставить. Основной R1 = 0,28 Ом остаётся во всех вариантах. Холод ≈ 96 мА; тепло ≈ 665 мА (зависит от RDS(on)).
CC0805KKX7R0BB104
Снижение тока на холоде / Na-ion / опция POWER
RC0805FR-07100KL
AO3401A
V2.0-A6 / 2026-10-24 / инженерный прототип
Q4 / Q6 / Q7: S = до R56; D = после R56. R58 закрывает ключи при выключенном управлении.
SOT-23
RC0805FR-0710KL
TO-92 / шаг 1.27 mm
LM285Z-2.5G
SOIC-8 / 3.9 mm
TH1: B57861S0103F040; 10k, B25/100 = 3988 K, R/T 8016. Один NTC: на плате либо на проводах у аккумулятора. На плате измеряется температура под экраном. Обрыв или КЗ NTC → холодный ток.
LM393XK
BSS138
R60 + R69 = 130k; R62 + R70 = 1,15M. Номинальные пороги: холод −17,4 °C; тепло −14,5 °C. OUT A и OUT B — соединённые открытые коллекторы. CHG_WARM высокий: Q5 включён, R56 обойдён. CHG_WARM низкий: Q5 выключен, R58 закрывает Q4/Q6/Q7.
RC0805FR-071KL
RC0805FR-0730KL
NTC ø2.41 / P2.54
-t°
RC0805FR-0747KL
CC0805JRNPO0BN102
RC0805FR-07150KL
B57861S0103F040
RC0805FR-071M2L

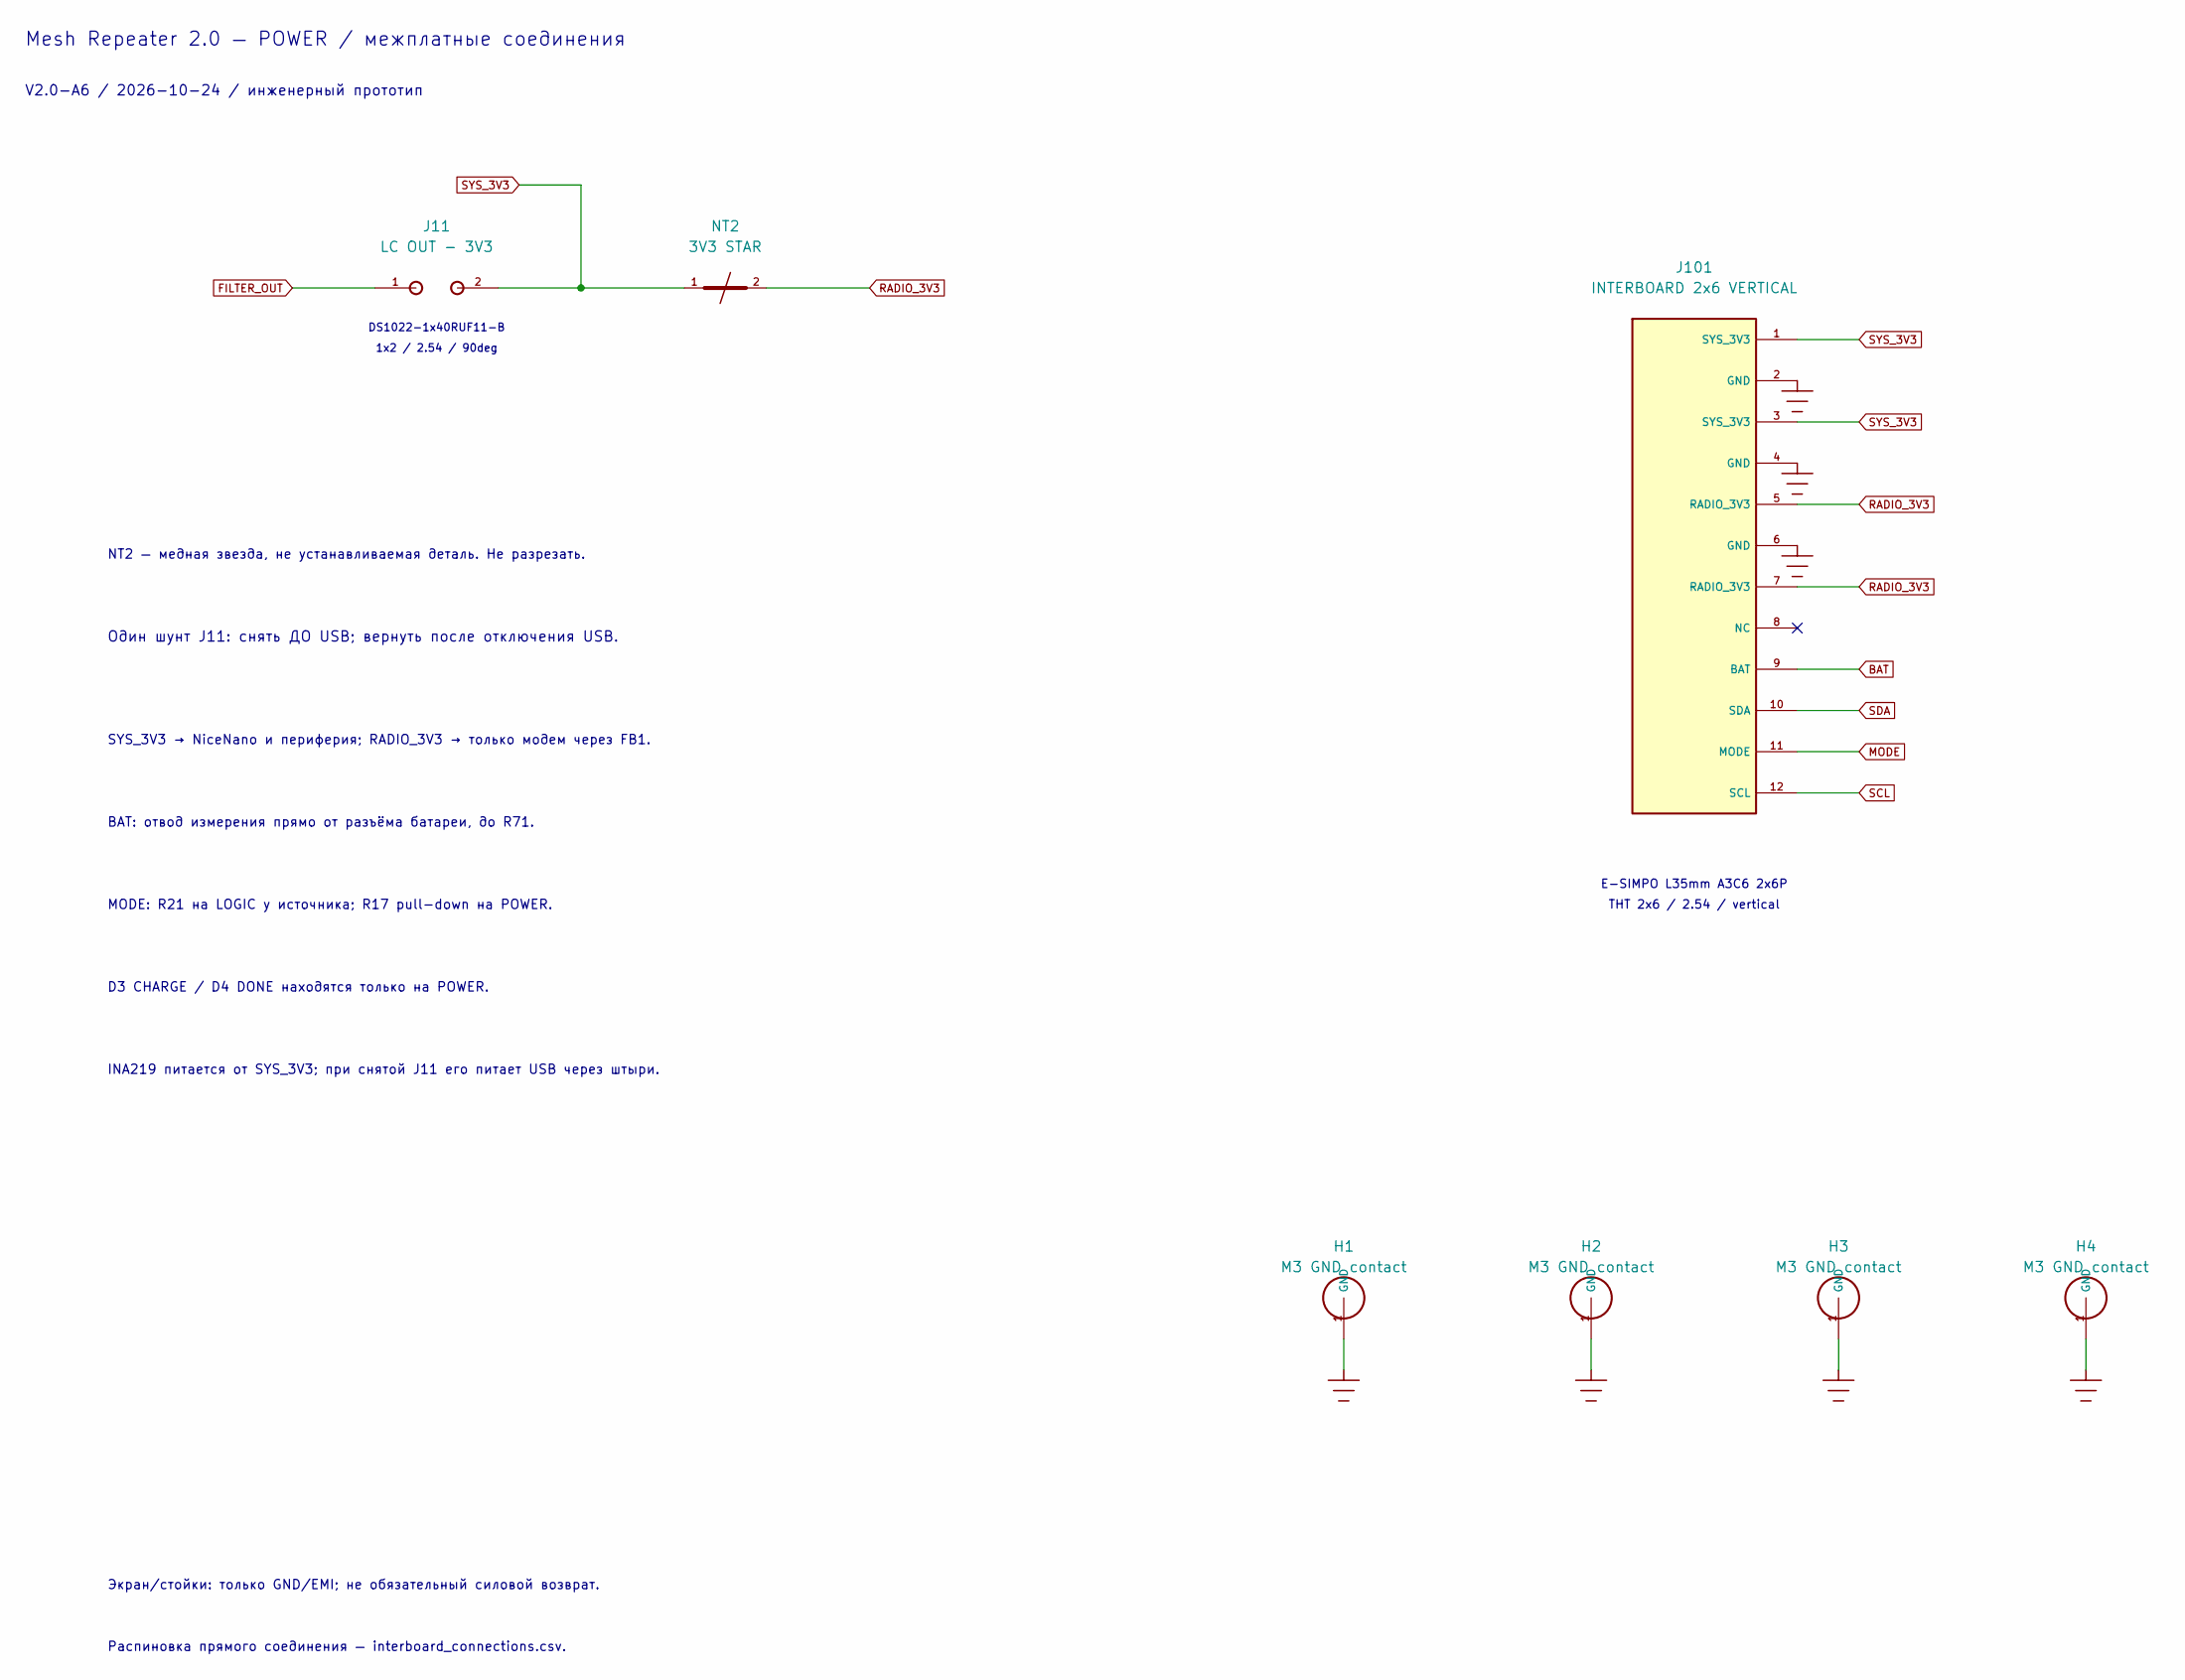
[picture p118: schematic Interconnect.kicad_sch, Межплатное соединение / POWER ↔ LOGIC]

Parts:
H1: M3 GND contact; GND_M3_D3.2_OD6__V2_H1; MPN PCB land M3 GND OD6 drill3.2
H2: M3 GND contact; GND_M3_D3.2_OD6__V2_H2; MPN PCB land M3 GND OD6 drill3.2
H3: M3 GND contact; GND_M3_D3.2_OD6__V2_H3; MPN PCB land M3 GND OD6 drill3.2
H4: M3 GND contact; GND_M3_D3.2_OD6__V2_H4; MPN PCB land M3 GND OD6 drill3.2
J11: LC OUT - 3V3; Connfly_DS1022_1x02RUF11_B_Horizontal; MPN Connfly DS1022-1x40RUF11-B cut to2pins
J101: INTERBOARD 2x6 VERTICAL; Ali_PinHeader_2x06_P2.54_L35_A3C6__V2_J101; MPN E-SIMPO L35mm A3C6 2x6P
NT2: 3V3 STAR; NetTie_2_SMD_Power_Star_A3

Connections:
BAT: J101.9 (BAT); also elsewhere on the board
FILTER_OUT: J11.1; also elsewhere on the board
GND: H1.1, H2.1, H3.1, H4.1, J101.2 (GND), J101.4 (GND), J101.6 (GND); also elsewhere on the board
MODE: J101.11 (MODE); also elsewhere on the board
RADIO_3V3: J101.5 (RADIO_3V3), J101.7 (RADIO_3V3), NT2.2
SCL: J101.12 (SCL); also elsewhere on the board
SDA: J101.10 (SDA); also elsewhere on the board
SYS_3V3: J11.2, J101.1 (SYS_3V3), J101.3 (SYS_3V3), NT2.1; also elsewhere on the board

Notes on the sheet:
E-SIMPO L35mm A3C6 2x6P
NT2 — медная звезда, не устанавливаемая деталь. Не разрезать.
BAT: отвод измерения прямо от разъёма батареи, до R71.
INA219 питается от SYS_3V3; при снятой J11 его питает USB через штыри.
D3 CHARGE / D4 DONE находятся только на POWER.
1x2 / 2.54 / 90deg
DS1022-1x40RUF11-B
V2.0-A6 / 2026-10-24 / инженерный прототип
THT 2x6 / 2.54 / vertical
Экран/стойки: только GND/EMI; не обязательный силовой возврат.
Mesh Repeater 2.0 — POWER / межплатные соединения
MODE: R21 на LOGIC у источника; R17 pull-down на POWER.
Один шунт J11: снять ДО USB; вернуть после отключения USB.
Распиновка прямого соединения — interboard_connections.csv.
SYS_3V3 → NiceNano и периферия; RADIO_3V3 → только модем через FB1.

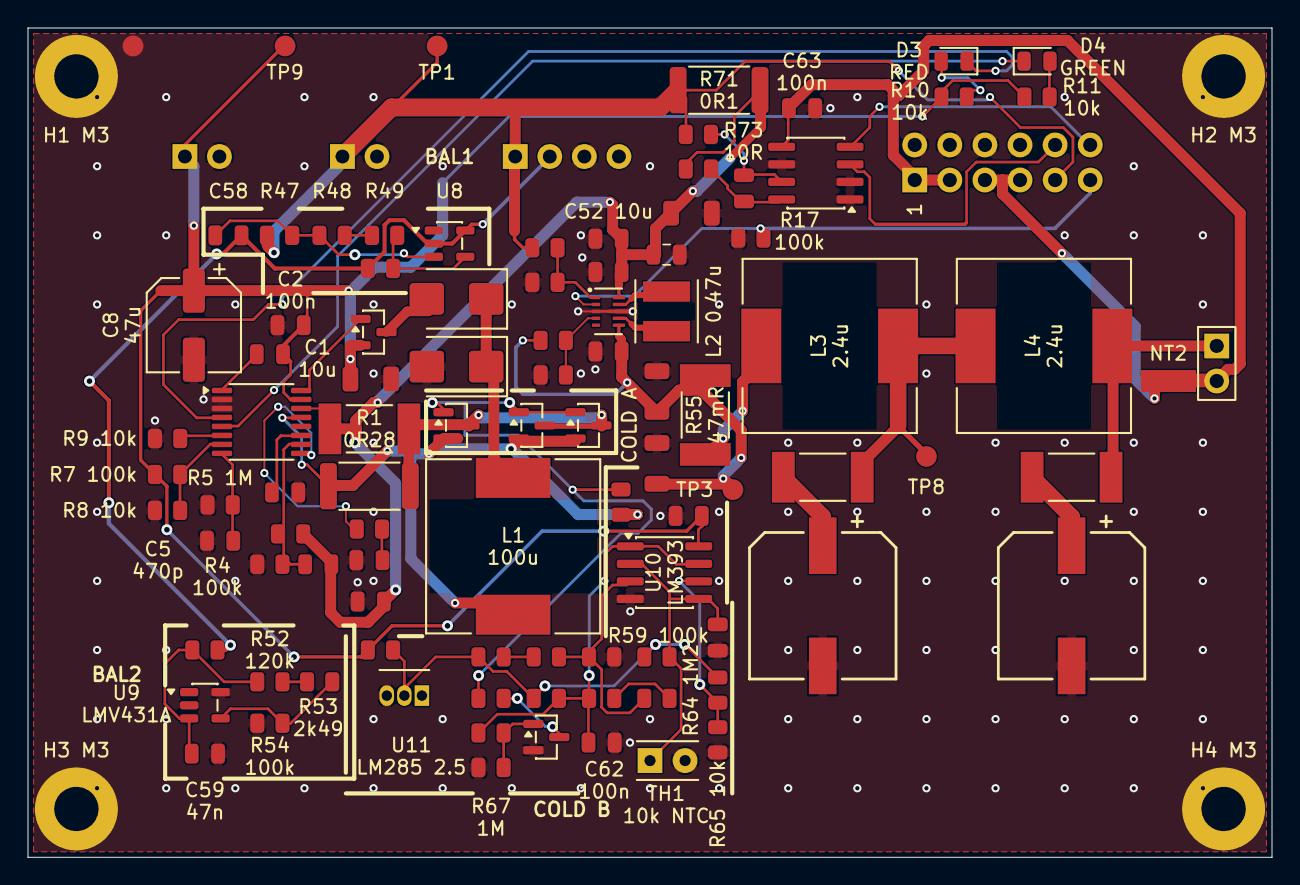
[picture p119: board MeshRepeater2_Power.kicad_pcb from above]

Board: 2 copper layers, 90.0 x 60.0 mm, 105 parts (0 on the bottom side), 55 nets.
