Alksndr55/mesh-repeater-2.0/v2/design/MeshRepeater2_Logic/MeshRepeater2_Logic.kicad_pcb

## KiCad design v2/design/MeshRepeater2_Logic/MeshRepeater2_Logic.kicad_pcb (2026-11-06)

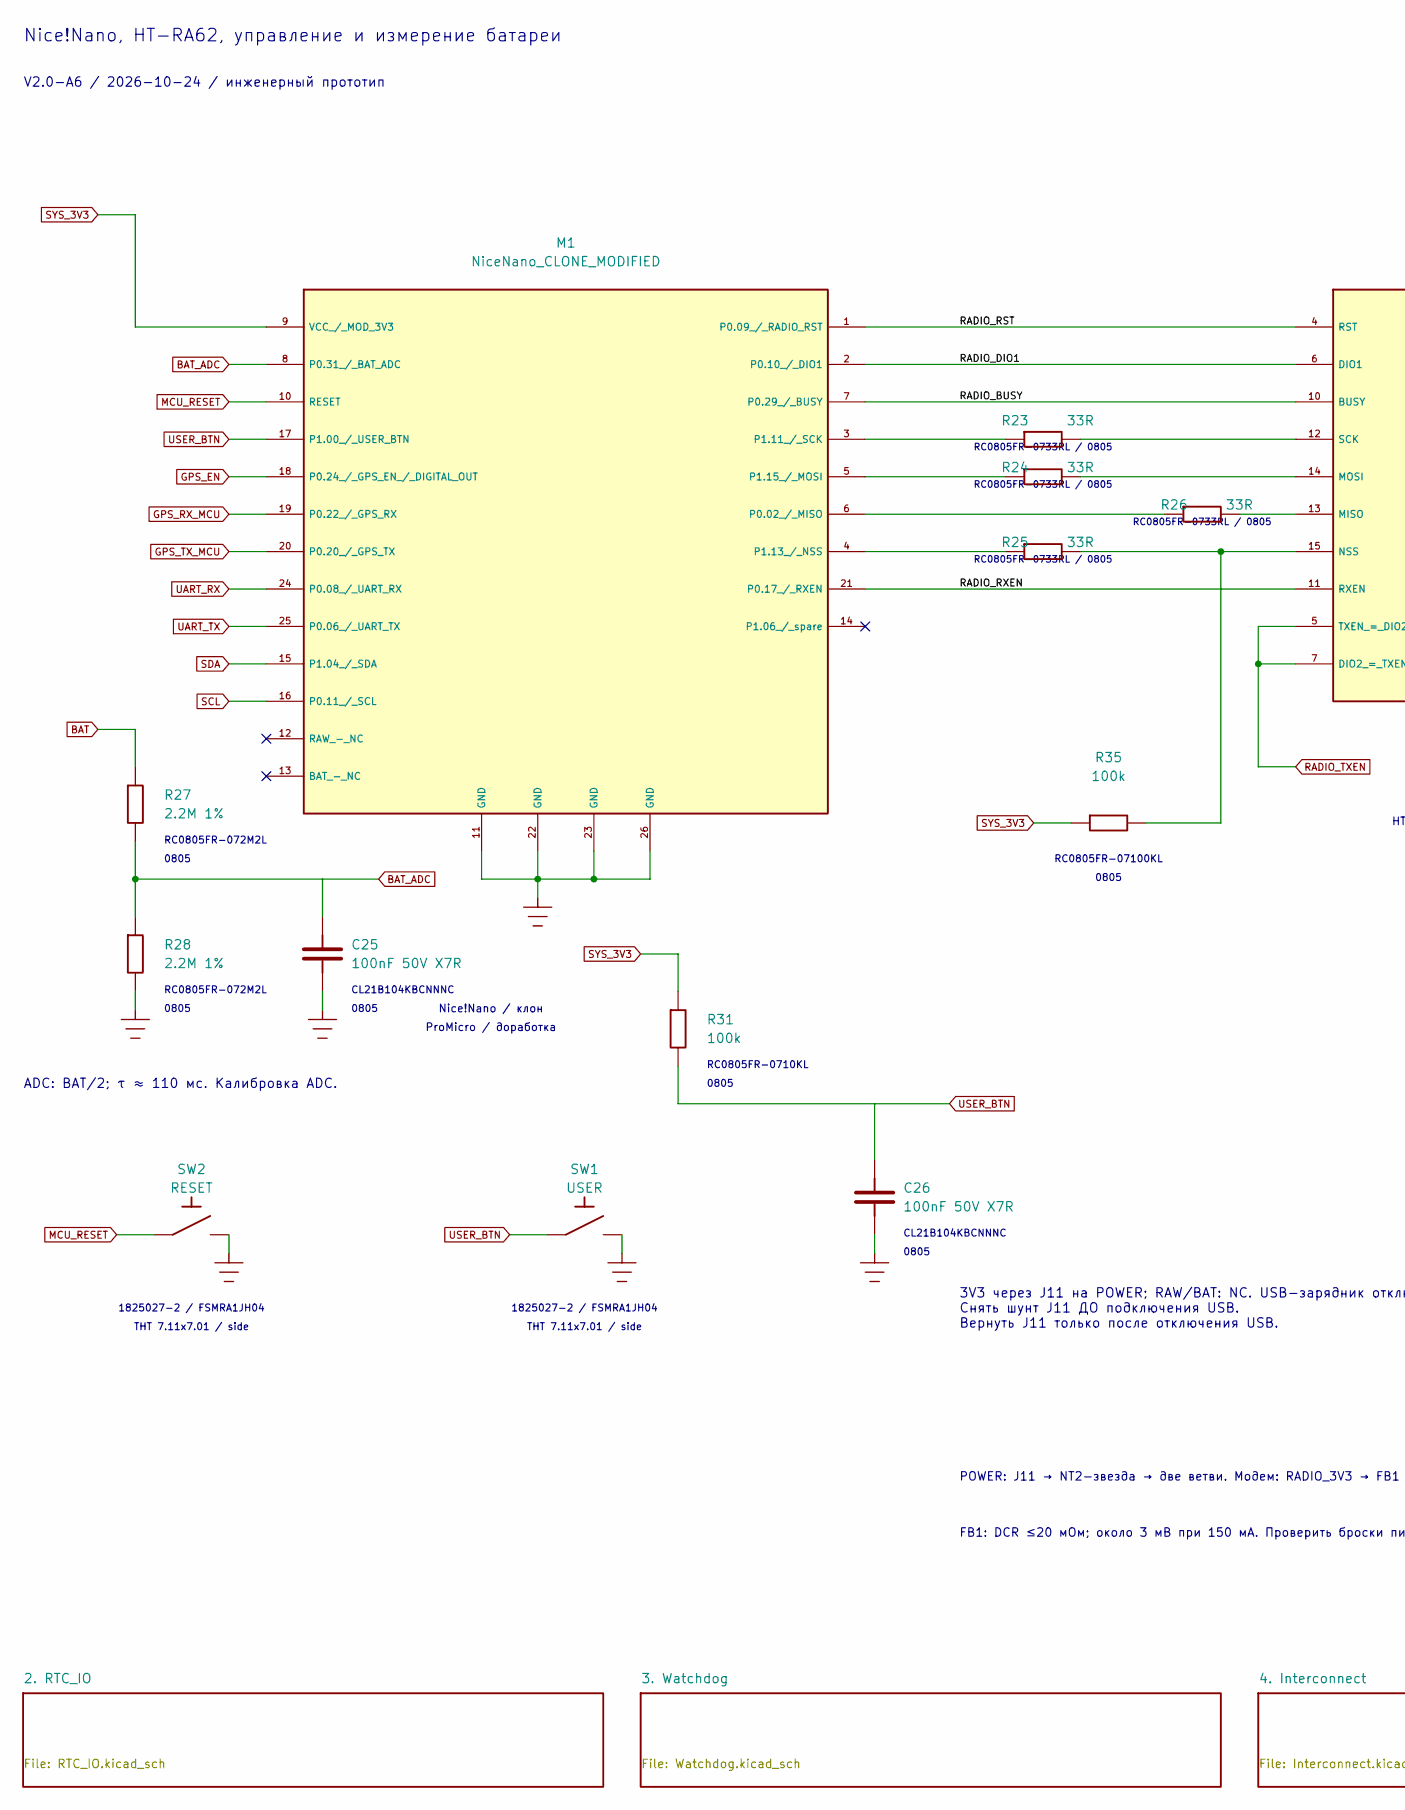
[picture p120: schematic MeshRepeater2_Logic.kicad_sch, Nice!Nano / HT-RA62, part in row 1, column 1]

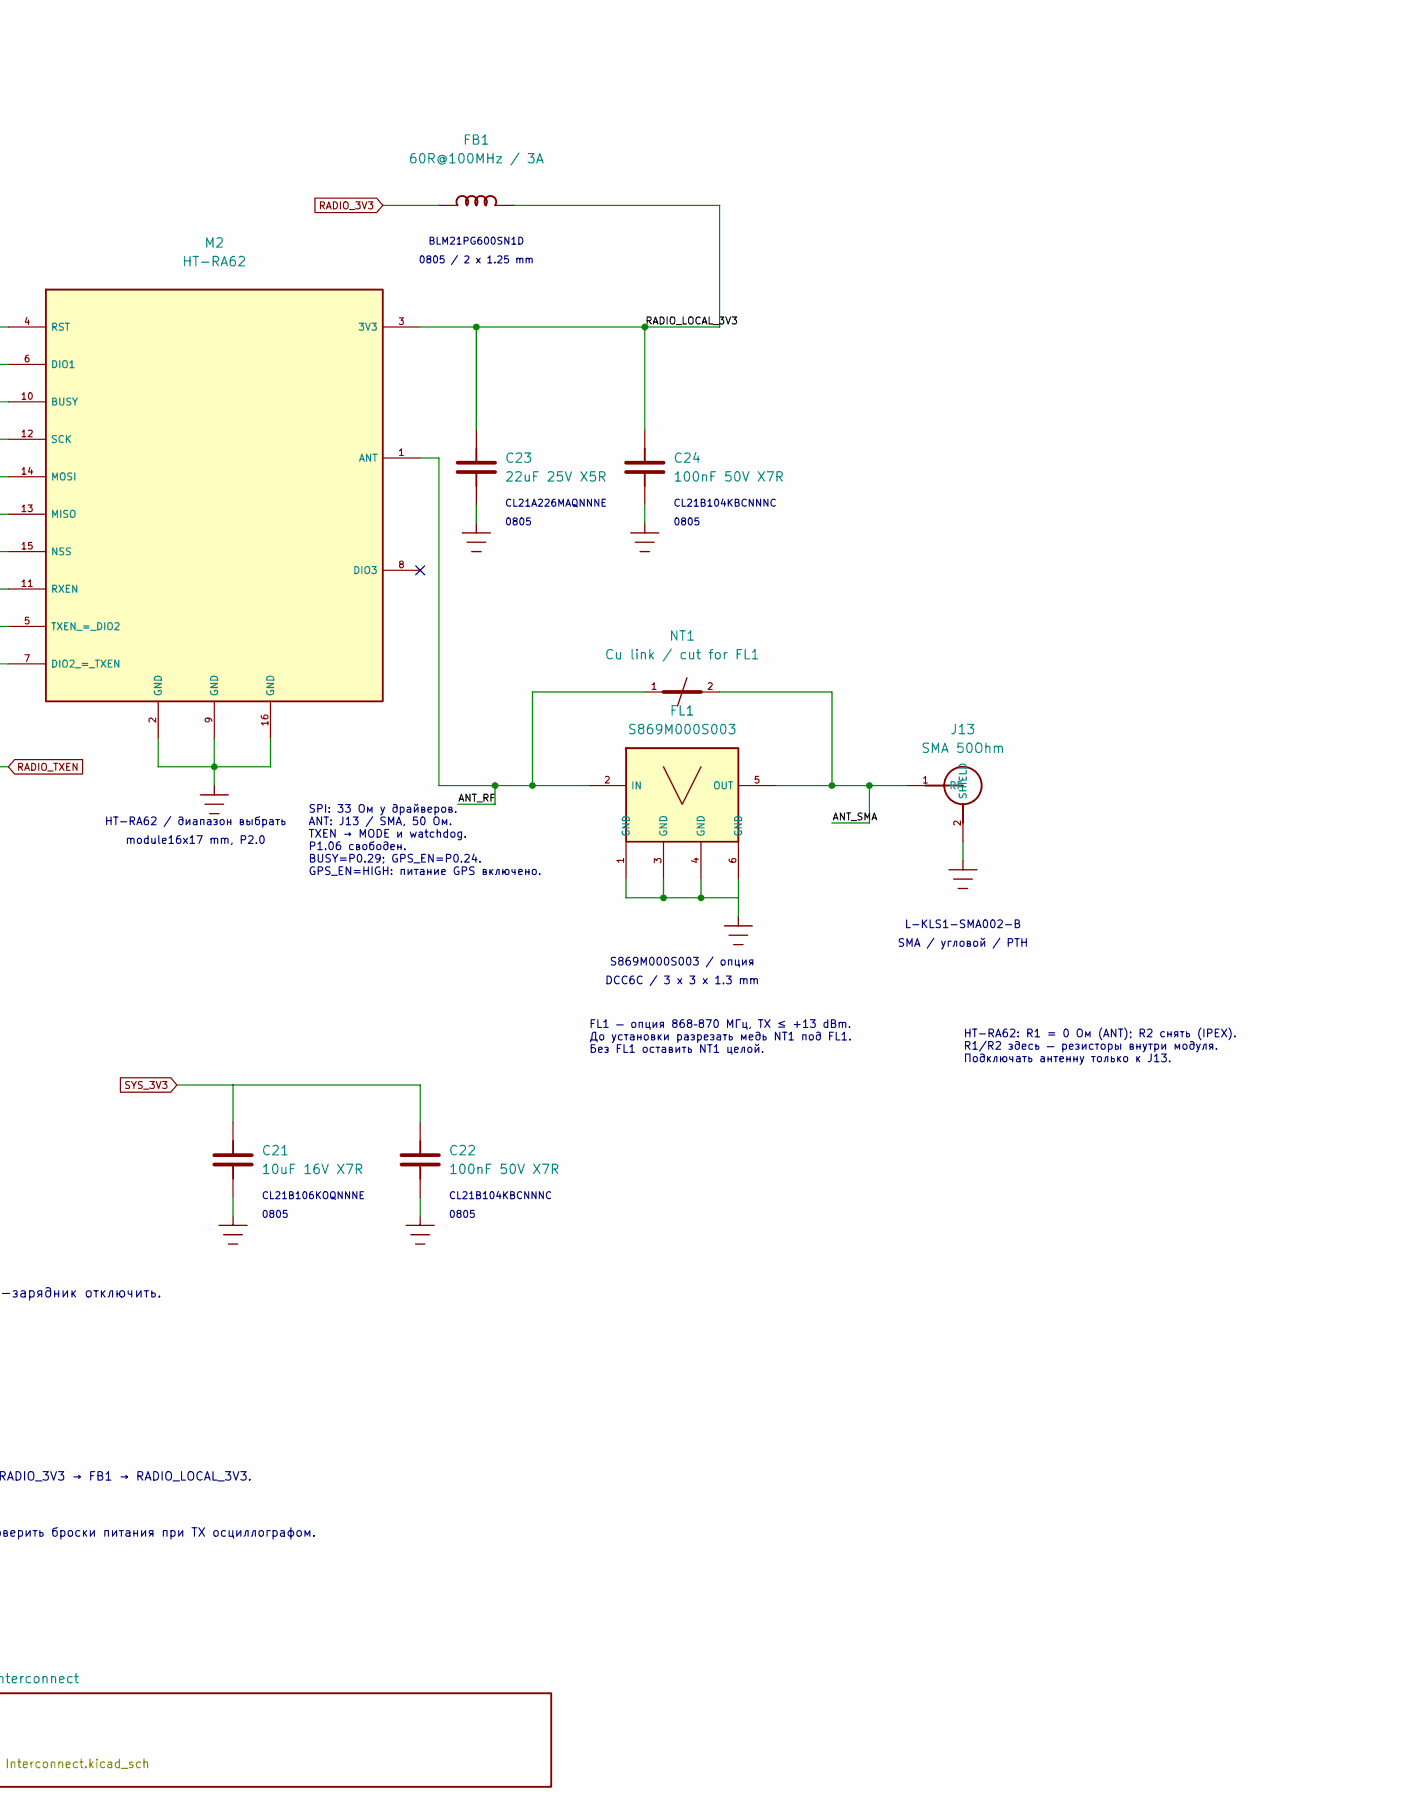
[picture p121: schematic MeshRepeater2_Logic.kicad_sch, Nice!Nano / HT-RA62, part in row 1, column 2]

Parts:
C21: 10uF 16V X7R; C_0805_2012Metric__V2_C21; MPN CL21B106KOQNNNE
C22: 100nF 50V X7R; C_0805_2012Metric__V2_C22; MPN CL21B104KBCNNNC
C23: 22uF 25V X5R; C_0805_2012Metric__V2_C23; MPN CL21A226MAQNNNE
C24: 100nF 50V X7R; C_0805_2012Metric__V2_C24; MPN CL21B104KBCNNNC
C25: 100nF 50V X7R; C_0805_2012Metric__V2_C25; MPN CL21B104KBCNNNC
C26: 100nF 50V X7R; C_0805_2012Metric__V2_C26; MPN CL21B104KBCNNNC
FB1: 60R@100MHz / 3A; Ferrite_Murata_BLM21PG__V2_FB1; MPN BLM21PG600SN1D
FL1: S869M000S003; SAW_AEL_DCC6C_S869M000S003__V2_FL1; MPN S869M000S003
J13: SMA 50Ohm; SMA_KLS1_SMA002_B_Horizontal__V2_J13; MPN L-KLS1-SMA002-B
M1: NiceNano_CLONE_MODIFIED; NiceNano_13x2_Socket__V2_M1; MPN User supplied NiceNano clone
M2: HT-RA62; HT_RA62__V2_M2; MPN HT-RA62 band variant TBD
NT1: Cu link / cut for FL1; RF_Cut_Link_0p6__V2_NT1; MPN PCB copper / not purchased
R23: 33R; R_0805_2012Metric__V2_R23; MPN RC0805FR-0733RL
R24: 33R; R_0805_2012Metric__V2_R24; MPN RC0805FR-0733RL
R25: 33R; R_0805_2012Metric__V2_R25; MPN RC0805FR-0733RL
R26: 33R; R_0805_2012Metric__V2_R26; MPN RC0805FR-0733RL
R27: 2.2M 1%; R_0805_2012Metric__V2_R27; MPN RC0805FR-072M2L
R28: 2.2M 1%; R_0805_2012Metric__V2_R28; MPN RC0805FR-072M2L
R31: 100k; R_0805_2012Metric__V2_R31; MPN RC0805FR-07100KL
R35: 100k; R_0805_2012Metric__V2_R35; MPN RC0805FR-07100KL
SW1: USER; SW_TE_1825027_2_Side__V2_SW1; MPN TE1825027-2 / FSMRA1JH04
SW2: RESET; SW_TE_1825027_2_Side__V2_SW2; MPN TE1825027-2 / FSMRA1JH04

Connections:
/ANT_RF: FL1.2 (IN), M2.1 (ANT), NT1.1 (A)
/ANT_SMA: FL1.5 (OUT), J13.1 (SIGNAL), NT1.2 (B)
/RADIO_BUSY: M1.7 (P0.29_/_BUSY), M2.10 (BUSY_10)
/RADIO_DIO1: M1.2 (P0.10_/_DIO1), M2.6 (DIO1_6)
/RADIO_LOCAL_3V3: C23.1, C24.1, FB1.2, M2.3 (3V3_3)
/RADIO_RST: M1.1 (P0.09_/_RADIO_RST), M2.4 (RST_4)
/RADIO_RXEN: M1.21 (P0.17_/_RXEN), M2.11 (RXEN_11)
BAT: R27.1; also elsewhere on the board
BAT_ADC: C25.1, M1.8 (P0.31_/_BAT_ADC), R27.2, R28.1
GND: C21.2, C22.2, C23.2, C24.2, C25.2, C26.2, FL1.1 (GND), FL1.3 (GND), FL1.4 (GND), FL1.6 (GND), J13.2 (GND), M1.11 (GND), M1.22 (GND), M1.23 (GND), M1.26 (GND), M2.2 (GND_2), M2.9 (GND_9), M2.16 (GND_16), R28.2, SW1.2, SW2.2; also elsewhere on the board
GPS_EN: M1.18 (P0.24_/_GPS_EN_/_DIGITAL_OUT); also elsewhere on the board
GPS_RX_MCU: M1.19 (P0.22_/_GPS_RX); also elsewhere on the board
GPS_TX_MCU: M1.20 (P0.20_/_GPS_TX); also elsewhere on the board
MCU_RESET: M1.10 (RESET), SW2.1; also elsewhere on the board
unnamed: M1.6 (P0.02_/_MISO), R26.2
unnamed: M1.3 (P1.11_/_SCK), R23.1
unnamed: M1.4 (P1.13_/_NSS), R25.1
unnamed: M1.5 (P1.15_/_MOSI), R24.1
unnamed: M2.13 (MISO_13), R26.1
unnamed: M2.14 (MOSI_14), R24.2
unnamed: M2.15 (NSS_15), R25.2, R35.2
unnamed: M2.12 (SCK_12), R23.2
RADIO_3V3: FB1.1; also elsewhere on the board
RADIO_TXEN: M2.5 (TXEN_=_DIO2_5), M2.7 (DIO2_=_TXEN_7); also elsewhere on the board
SCL: M1.16 (P0.11_/_SCL); also elsewhere on the board
SDA: M1.15 (P1.04_/_SDA); also elsewhere on the board
SYS_3V3: C21.1, C22.1, M1.9 (VCC_/_MOD_3V3), R31.1, R35.1; also elsewhere on the board
UART_RX: M1.24 (P0.08_/_UART_RX); also elsewhere on the board
UART_TX: M1.25 (P0.06_/_UART_TX); also elsewhere on the board
USER_BTN: C26.1, M1.17 (P1.00_/_USER_BTN), R31.2, SW1.1

Notes on the sheet:
RC0805FR-0733RL / 0805
CL21B104KBCNNNC
RC0805FR-072M2L
HT-RA62 / диапазон выбрать
0805
CL21B106KOQNNNE
L-KLS1-SMA002-B
DCC6C / 3 x 3 x 1.3 mm
module16x17 mm, P2.0
ADC: BAT/2; τ ≈ 110 мс. Калибровка ADC.
1825027-2 / FSMRA1JH04
HT-RA62: R1 = 0 Ом (ANT); R2 снять (IPEX). R1/R2 здесь — резисторы внутри модуля. Подключать антенну только к J13.
V2.0-A6 / 2026-10-24 / инженерный прототип
FB1: DCR ≤20 мОм; около 3 мВ при 150 мА. Проверить броски питания при TX осциллографом.
0805 / 2 x 1.25 mm
CL21A226MAQNNNE
FL1 — опция 868–870 МГц, TX ≤ +13 dBm. До установки разрезать медь NT1 под FL1. Без FL1 оставить NT1 целой.
POWER: J11 → NT2-звезда → две ветви. Модем: RADIO_3V3 → FB1 → RADIO_LOCAL_3V3.
RC0805FR-0710KL
Nice!Nano, HT-RA62, управление и измерение батареи
ProMicro / доработка
3V3 через J11 на POWER; RAW/BAT: NC. USB-зарядник отключить. Снять шунт J11 ДО подключения USB. Вернуть J11 только после отключения USB.
THT 7.11x7.01 / side
BLM21PG600SN1D
RC0805FR-07100KL
Nice!Nano / клон
SPI: 33 Ом у драйверов. ANT: J13 / SMA, 50 Ом. TXEN → MODE и watchdog. P1.06 свободен. BUSY=P0.29; GPS_EN=P0.24. GPS_EN=HIGH: питание GPS включено.
SMA / угловой / PTH
S869M000S003 / опция
