Alksndr55/mesh-repeater-2.0/v2/design/MeshRepeater2_Logic/MeshRepeater2_Logic.kicad_pcb

## KiCad design v2/design/MeshRepeater2_Logic/MeshRepeater2_Logic.kicad_pcb (continued)

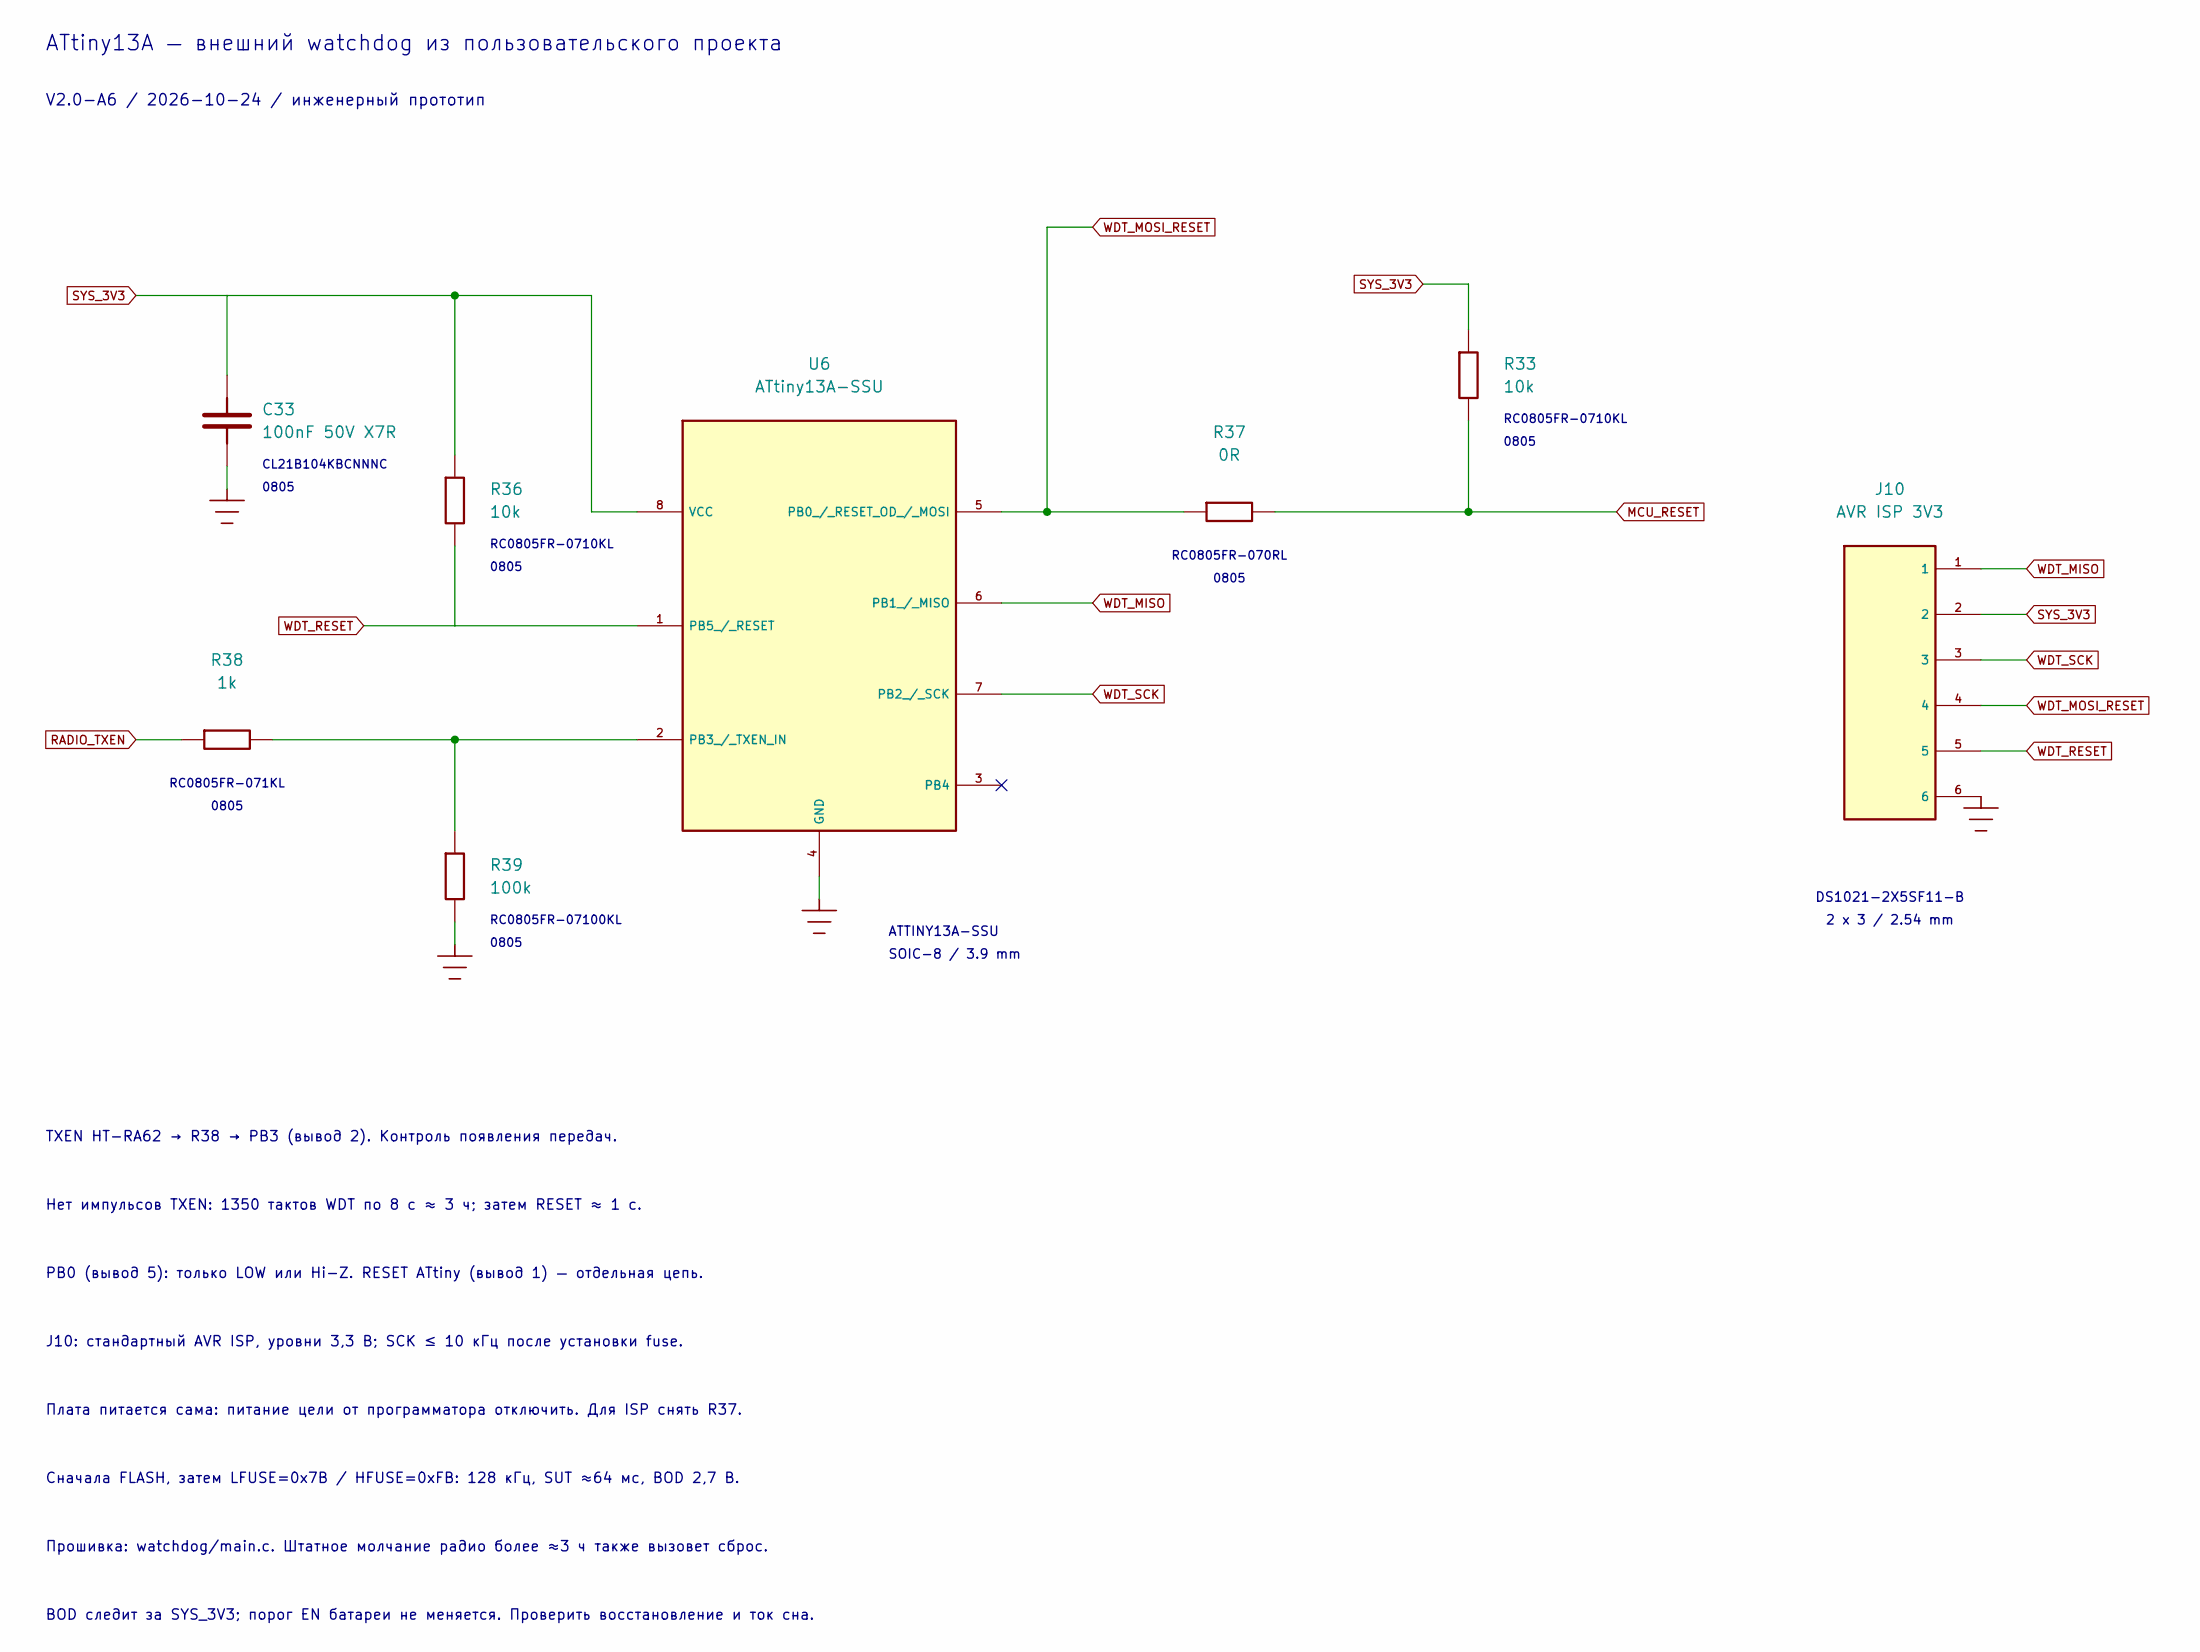
[picture p122: schematic Watchdog.kicad_sch, ATtiny13A / watchdog]

Parts:
C33: 100nF 50V X7R; C_0805_2012Metric__V2_C33; MPN CL21B104KBCNNNC
J10: AVR ISP 3V3; PinHeader_2x03_P2.54mm_Vertical__V2_J10; MPN DS1021-2X5SF11-B
R33: 10k; R_0805_2012Metric__V2_R33; MPN RC0805FR-0710KL
R36: 10k; R_0805_2012Metric__V2_R36; MPN RC0805FR-0710KL
R37: 0R; R_0805_2012Metric__V2_R37; MPN RC0805FR-070RL
R38: 1k; R_0805_2012Metric__V2_R38; MPN RC0805FR-071KL
R39: 100k; R_0805_2012Metric__V2_R39; MPN RC0805FR-07100KL
U6: ATtiny13A-SSU; SOIC-8_3.9x4.9mm_P1.27mm__V2_U6; MPN ATTINY13A-SSU

Connections:
GND: C33.2, J10.6, R39.2, U6.4 (GND); also elsewhere on the board
MCU_RESET: R33.2, R37.2; also elsewhere on the board
unnamed: R38.2, R39.1, U6.2 (PB3_/_TXEN_IN)
RADIO_TXEN: R38.1; also elsewhere on the board
SYS_3V3: C33.1, J10.2, R33.1, R36.1, U6.8 (VCC); also elsewhere on the board
WDT_MISO: J10.1, U6.6 (PB1_/_MISO)
WDT_MOSI_RESET: J10.4, R37.1, U6.5 (PB0_/_RESET_OD_/_MOSI)
WDT_RESET: J10.5, R36.2, U6.1 (PB5_/_RESET)
WDT_SCK: J10.3, U6.7 (PB2_/_SCK)

Notes on the sheet:
RC0805FR-070RL
J10: стандартный AVR ISP, уровни 3,3 В; SCK ≤ 10 кГц после установки fuse.
0805
RC0805FR-071KL
ATTINY13A-SSU
TXEN HT-RA62 → R38 → PB3 (вывод 2). Контроль появления передач.
2 x 3 / 2.54 mm
SOIC-8 / 3.9 mm
Плата питается сама: питание цели от программатора отключить. Для ISP снять R37.
RC0805FR-0710KL
Сначала FLASH, затем LFUSE=0x7B / HFUSE=0xFB: 128 кГц, SUT ≈64 мс, BOD 2,7 В.
PB0 (вывод 5): только LOW или Hi-Z. RESET ATtiny (вывод 1) — отдельная цепь.
CL21B104KBCNNNC
DS1021-2X5SF11-B
V2.0-A6 / 2026-10-24 / инженерный прототип
BOD следит за SYS_3V3; порог EN батареи не меняется. Проверить восстановление и ток сна.
Прошивка: watchdog/main.c. Штатное молчание радио более ≈3 ч также вызовет сброс.
ATtiny13A — внешний watchdog из пользовательского проекта
RC0805FR-07100KL
Нет импульсов TXEN: 1350 тактов WDT по 8 с ≈ 3 ч; затем RESET ≈ 1 с.

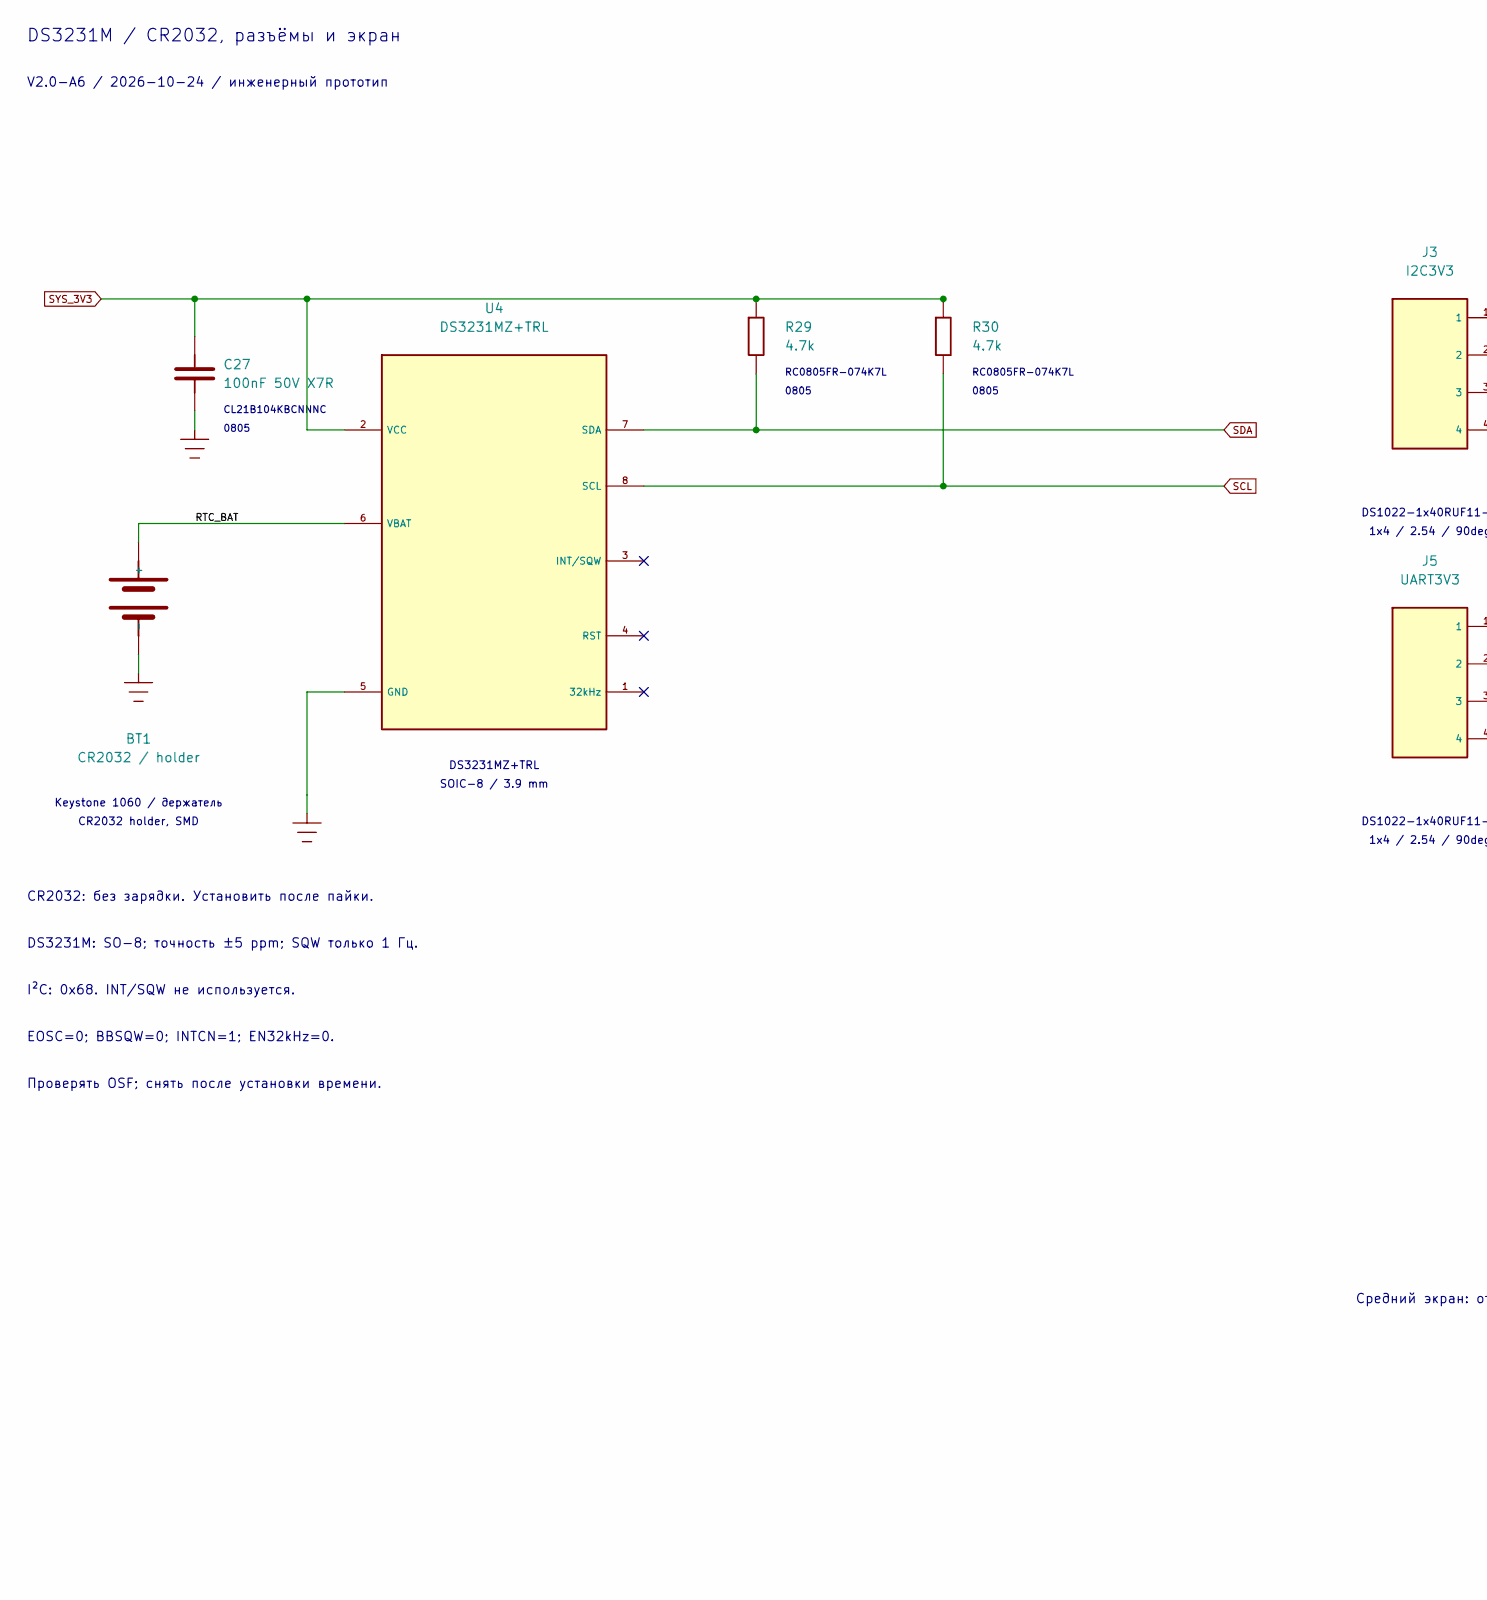
[picture p123: schematic RTC_IO.kicad_sch, DS3231M / разъёмы, part in row 1, column 1]

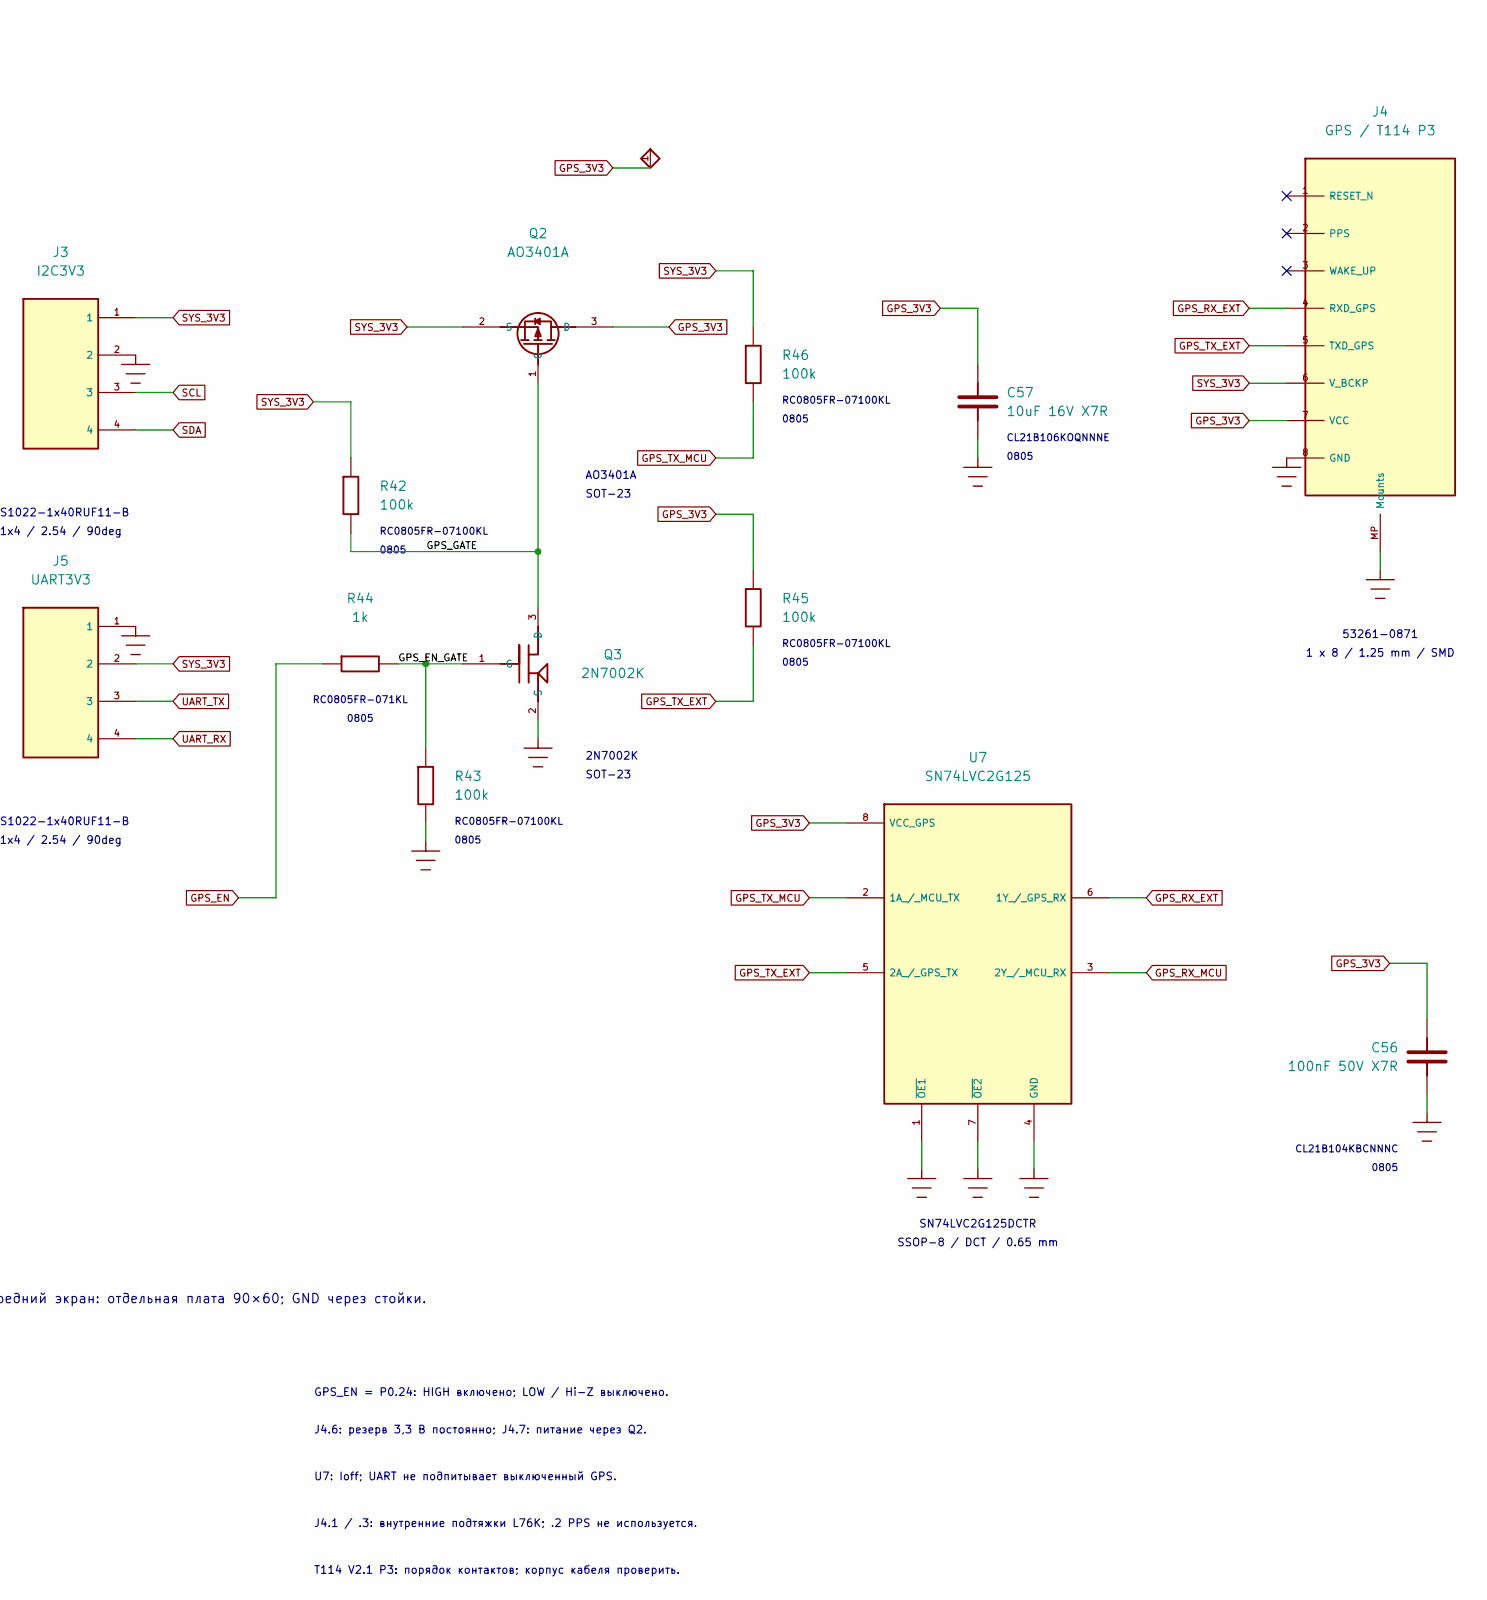
[picture p124: schematic RTC_IO.kicad_sch, DS3231M / разъёмы, part in row 1, column 2]

Parts:
BT1: CR2032 / holder; BatteryHolder_Keystone_1060_1x2032__V2_BT1; MPN 1060; LCSC C5370859
C27: 100nF 50V X7R; C_0805_2012Metric__V2_C27; MPN CL21B104KBCNNNC
C56: 100nF 50V X7R; C_0805_2012Metric__V2_C56; MPN CL21B104KBCNNNC
C57: 10uF 16V X7R; C_0805_2012Metric__V2_C57; MPN CL21B106KOQNNNE
J3: I2C3V3; Connfly_DS1022_1x04RUF11_B_Horizontal__V2_J3; MPN DS1022-1x40RUF11-B cut to4pins
J4: GPS / T114 P3; Molex_PicoBlade_53261-0871_1x08-1MP_P1.25mm_Horizontal__V2_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; MPN 53261-0871
J5: UART3V3; Connfly_DS1022_1x04RUF11_B_Horizontal__V2_J5; MPN DS1022-1x40RUF11-B cut to4pins
Q2: AO3401A; SOT-23__V2_Q2; MPN AO3401A
Q3: 2N7002K; SOT-23__V2_Q3; MPN 2N7002K
R29: 4.7k; R_0805_2012Metric__V2_R29; MPN RC0805FR-074K7L
R30: 4.7k; R_0805_2012Metric__V2_R30; MPN RC0805FR-074K7L
R42: 100k; R_0805_2012Metric__V2_R42; MPN RC0805FR-07100KL
R43: 100k; R_0805_2012Metric__V2_R43; MPN RC0805FR-07100KL
R44: 1k; R_0805_2012Metric__V2_R44; MPN RC0805FR-071KL
R45: 100k; R_0805_2012Metric__V2_R45; MPN RC0805FR-07100KL
R46: 100k; R_0805_2012Metric__V2_R46; MPN RC0805FR-07100KL
U4: DS3231MZ+TRL; SOIC-8_3.9x4.9mm_P1.27mm__V2_U4; MPN DS3231MZ+TRL
U7: SN74LVC2G125; TI_DCT0008A__V2_U7; MPN SN74LVC2G125DCTR

Connections:
/2. RTC_IO/GPS_EN_GATE: Q3.1 (G), R43.1, R44.2
/2. RTC_IO/GPS_GATE: Q2.1 (G), Q3.3 (D), R42.2
/2. RTC_IO/RTC_BAT: BT1.1 (+), U4.6 (VBAT)
GND: BT1.2 (-), C27.2, C56.2, C57.2, J3.2, J4.8 (GND), J4.MP (Mounts), J5.1, Q3.2 (S), R43.2, U4.5 (GND), U7.1 (~OE1), U7.4 (GND), U7.7 (~OE2); also elsewhere on the board
GPS_3V3: C56.1, C57.1, J4.7 (VCC), Q2.3 (D), R45.1, U7.8 (VCC_GPS)
GPS_EN: R44.1; also elsewhere on the board
GPS_RX_EXT: J4.4 (RXD_GPS), U7.6 (1Y_/_GPS_RX)
GPS_RX_MCU: U7.3 (2Y_/_MCU_RX); also elsewhere on the board
GPS_TX_EXT: J4.5 (TXD_GPS), R45.2, U7.5 (2A_/_GPS_TX)
GPS_TX_MCU: R46.2, U7.2 (1A_/_MCU_TX); also elsewhere on the board
SCL: J3.3, R30.2, U4.8 (SCL); also elsewhere on the board
SDA: J3.4, R29.2, U4.7 (SDA); also elsewhere on the board
SYS_3V3: C27.1, J3.1, J4.6 (V_BCKP), J5.2, Q2.2 (S), R29.1, R30.1, R42.1, R46.1, U4.2 (VCC); also elsewhere on the board
UART_RX: J5.4; also elsewhere on the board
UART_TX: J5.3; also elsewhere on the board

Notes on the sheet:
J4.6: резерв 3,3 В постоянно; J4.7: питание через Q2.
2N7002K
1x4 / 2.54 / 90deg
CL21B104KBCNNNC
J4.1 / .3: внутренние подтяжки L76K; .2 PPS не используется.
0805
U7: Ioff; UART не подпитывает выключенный GPS.
V2.0-A6 / 2026-10-24 / инженерный прототип
EOSC=0; BBSQW=0; INTCN=1; EN32kHz=0.
DS3231MZ+TRL
RC0805FR-07100KL
Проверять OSF; снять после установки времени.
Keystone 1060 / держатель
RC0805FR-074K7L
T114 V2.1 P3: порядок контактов; корпус кабеля проверить.
Средний экран: отдельная плата 90×60; GND через стойки.
RC0805FR-071KL
DS1022-1x40RUF11-B
53261-0871
DS3231M: SO-8; точность ±5 ppm; SQW только 1 Гц.
SN74LVC2G125DCTR
SOT-23
I²C: 0x68. INT/SQW не используется.
GPS_EN = P0.24: HIGH включено; LOW / Hi-Z выключено.
CR2032: без зарядки. Установить после пайки.
1 x 8 / 1.25 mm / SMD
CR2032 holder, SMD
AO3401A
CL21B106KOQNNNE
SSOP-8 / DCT / 0.65 mm
SOIC-8 / 3.9 mm
DS3231M / CR2032, разъёмы и экран

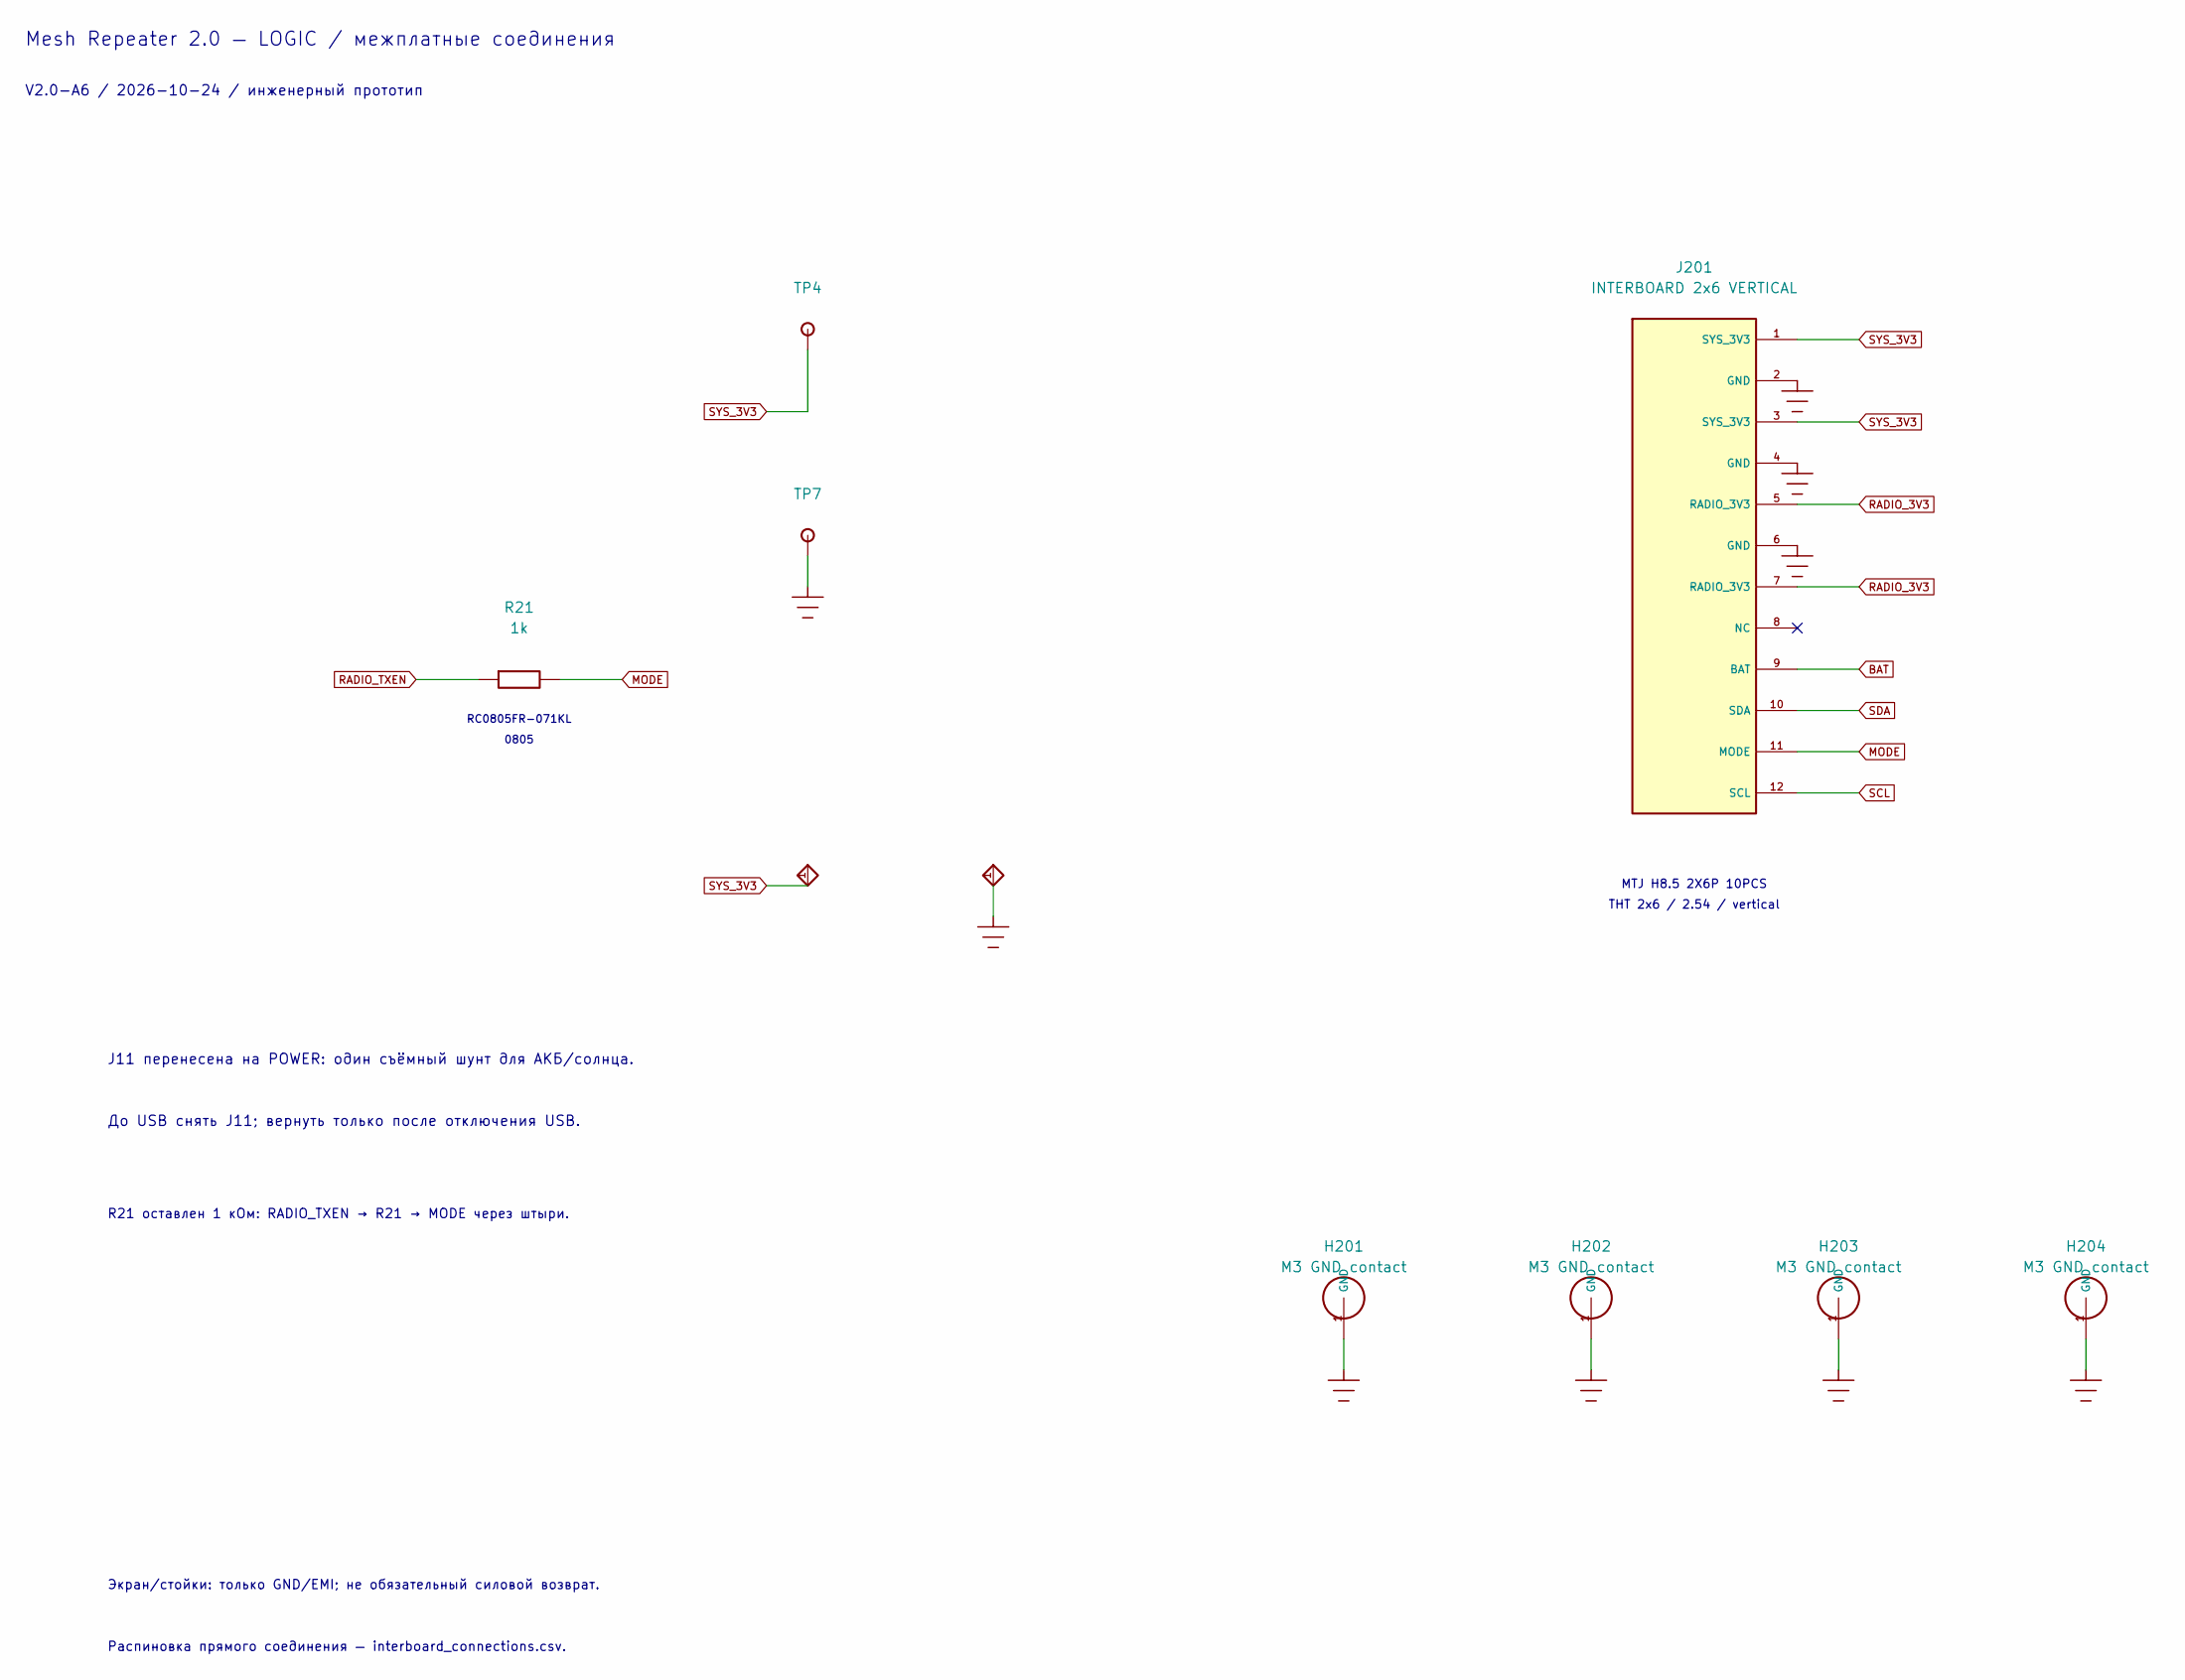
[picture p125: schematic Interconnect.kicad_sch, Межплатное соединение / POWER ↔ LOGIC]

Parts:
H201: M3 GND contact; GND_M3_D3.2_OD6__V2_H201; MPN PCB land M3 GND OD6 drill3.2
H202: M3 GND contact; GND_M3_D3.2_OD6__V2_H202; MPN PCB land M3 GND OD6 drill3.2
H203: M3 GND contact; GND_M3_D3.2_OD6__V2_H203; MPN PCB land M3 GND OD6 drill3.2
H204: M3 GND contact; GND_M3_D3.2_OD6__V2_H204; MPN PCB land M3 GND OD6 drill3.2
J201: INTERBOARD 2x6 VERTICAL; Ali_PinSocket_2x06_P2.54_H8.5_v2_mirror__V2_J201; MPN MTJ H8.5 2X6P 10PCS
R21: 1k; R_0805_2012Metric__V2_R21; MPN RC0805FR-071KL
TP4: SYS_3V3; TestPoint_Pad_D1.5mm__V2_TP4
TP7: GND; TestPoint_Pad_D1.5mm__V2_TP7

Connections:
BAT: J201.9 (BAT); also elsewhere on the board
GND: H201.1, H202.1, H203.1, H204.1, J201.2 (GND), J201.4 (GND), J201.6 (GND), TP7.1; also elsewhere on the board
MODE: J201.11 (MODE), R21.2
RADIO_3V3: J201.5 (RADIO_3V3), J201.7 (RADIO_3V3); also elsewhere on the board
RADIO_TXEN: R21.1; also elsewhere on the board
SCL: J201.12 (SCL); also elsewhere on the board
SDA: J201.10 (SDA); also elsewhere on the board
SYS_3V3: J201.1 (SYS_3V3), J201.3 (SYS_3V3), TP4.1; also elsewhere on the board

Notes on the sheet:
0805
THT 2x6 / 2.54 / vertical
V2.0-A6 / 2026-10-24 / инженерный прототип
R21 оставлен 1 кОм: RADIO_TXEN → R21 → MODE через штыри.
Экран/стойки: только GND/EMI; не обязательный силовой возврат.
J11 перенесена на POWER: один съёмный шунт для АКБ/солнца.
Mesh Repeater 2.0 — LOGIC / межплатные соединения
До USB снять J11; вернуть только после отключения USB.
RC0805FR-071KL
Распиновка прямого соединения — interboard_connections.csv.
MTJ H8.5 2X6P 10PCS

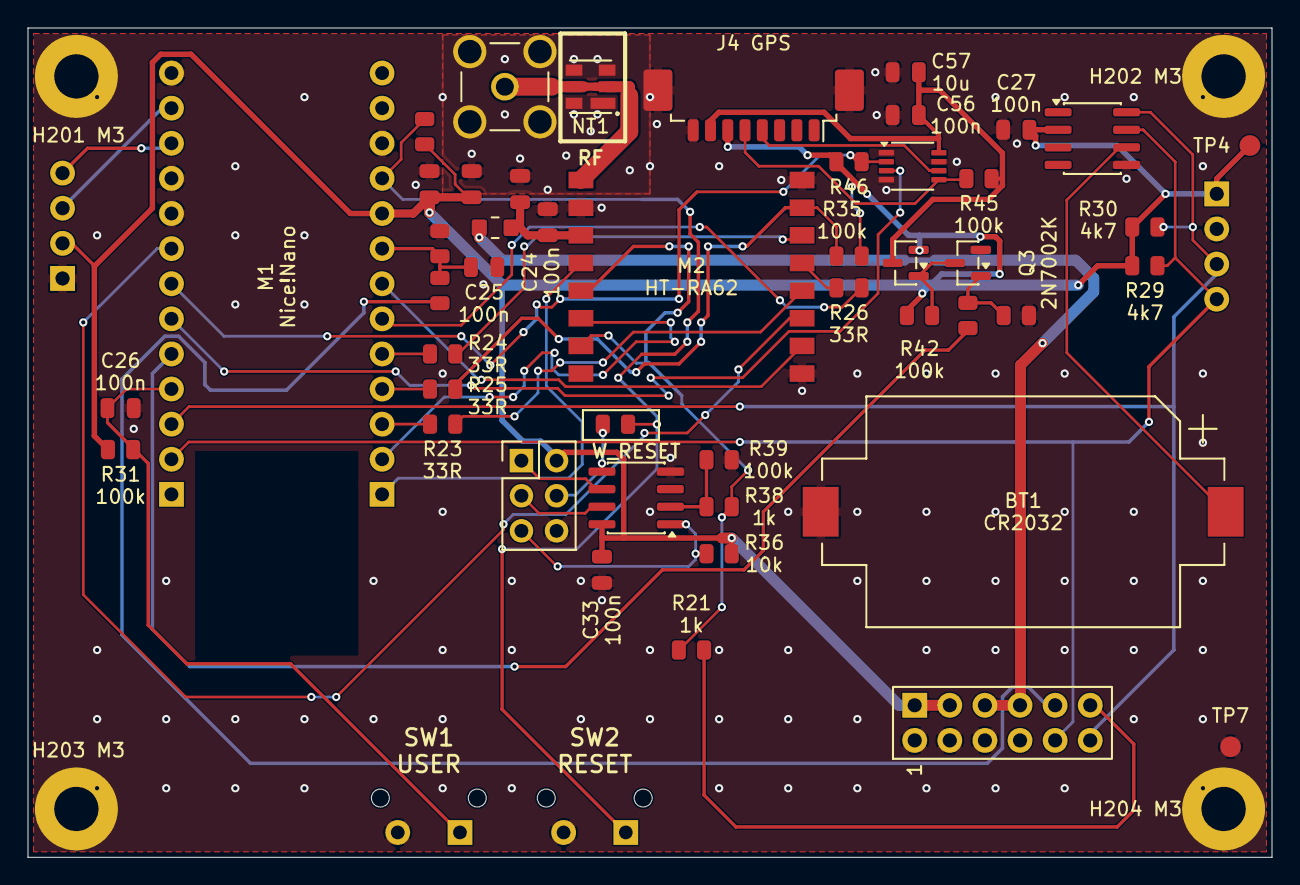
[picture p126: board MeshRepeater2_Logic.kicad_pcb from above]

Board: 2 copper layers, 90.0 x 60.0 mm, 56 parts (0 on the bottom side), 42 nets.
