Alksndr55/mesh-repeater-2.0/tools/cad/verify_v2_a3_schematic_equivalence.py

"""Prove preserved endpoint graph after joining the two cable connectors.

Names of automatic KiCad nets and sheet paths can change. Pin identity and
functional connected-component membership may not. This check compares the
exported native KiCad netlists rather than the schematic generator's manifest.
"""
from pathlib import Path
import argparse, hashlib, json, sys, xml.etree.ElementTree as ET

ROOT=Path(__file__).resolve().parents[2]
sys.path.insert(0, str(ROOT / 'tools'))
from v2_a3_feature_contract import (FEATURE_PATH, PINMAP, NEW_NETS, INA_SOIC_PIN_NAMES, load_feature,
    expected_original_nets, feature_checks, feature_native_checks, legacy_union, A3_FEATURE_PATH, original_board, expected_value_field)

def load_netlist(path,board):
    xml=ET.parse(path).getroot();net_by_pin={};groups={}
    for net in xml.findall('.//nets/net'):
        key=(board,net.get('name'))
        nodes={(n.get('ref'),n.get('pin')) for n in net.findall('node') if not n.get('ref','').startswith('#')}
        groups[key]=nodes
        for node in nodes:
            assert (board,*node) not in net_by_pin,('Duplicate native pin',board,node)
            net_by_pin[(board,*node)]=key
    components={n.get('ref'):n for n in xml.findall('.//components/comp')}
    return net_by_pin,groups,components

class Union:
    def __init__(self):self.parents={}
    def root(self,n):
        self.parents.setdefault(n,n)
        while self.parents[n]!=n:
            self.parents[n]=self.parents[self.parents[n]];n=self.parents[n]
        return n
    def join(self,a,b):self.parents[self.root(a)]=self.root(b)

def symbol_pins(xml, ref):
    comp = next(n for n in xml.findall('./components/comp') if n.get('ref') == ref)
    source = comp.find('libsource')
    libpart = next(n for n in xml.findall('./libparts/libpart') if n.get('lib') == source.get('lib') and n.get('part') == source.get('part'))
    return {n.get('num'): {'name': n.get('name'), 'type': n.get('type')} for n in libpart.findall('./pins/pin')}

def main():
    p=argparse.ArgumentParser()
    p.add_argument('--contract',type=Path,required=True)
    p.add_argument('--power-netlist',type=Path,required=True)
    p.add_argument('--logic-netlist',type=Path,required=True)
    p.add_argument('--power-model',type=Path,required=True)
    p.add_argument('--logic-model',type=Path,required=True)
    p.add_argument('--cable',type=Path,required=True,help='JSON: connections with power.ref/pin, logic.ref/pin, and net')
    p.add_argument('--out',type=Path,required=True)
    a=p.parse_args()
    for name,path in vars(a).items():
        if isinstance(path,Path):
            if not path.resolve().is_relative_to(ROOT):raise ValueError('All v2 proof paths must stay inside v2')
            setattr(a,name,path.resolve())
    contract=json.loads(a.contract.read_text(encoding='utf-8'))
    feature=load_feature(a.contract)
    cable=json.loads(a.cable.read_text(encoding='utf-8'))
    models={n:json.loads(path.read_text(encoding='utf-8')) for n,path in [('POWER',a.power_model),('LOGIC',a.logic_model)]}
    natives={n:load_netlist(path,n) for n,path in [('POWER',a.power_netlist),('LOGIC',a.logic_netlist)]}
    checks=[]
    def check(name,passed,detail=None):checks.append({'name':name,'pass':bool(passed),'detail':detail})
    checks.extend(feature_checks(models, feature))
    if feature:
        power_xml=ET.parse(a.power_netlist).getroot()
        ina_names={pin:fields['name'] for pin,fields in symbol_pins(power_xml,'U12').items()} if 'U12' in natives['POWER'][2] else {}
        check('INA219 native SOIC8 physical pin names match TI',ina_names==INA_SOIC_PIN_NAMES,{'expected':INA_SOIC_PIN_NAMES,'actual':ina_names})
    union=Union()
    for board,model in models.items():
        expected_local={};pin_missing=[];native_local={}
        for part in model['parts']:
            for pin,logical in part['nets'].items():
                endpoint=(part['ref'],str(pin))
                key=natives[board][0].get((board,*endpoint))
                if key is None:pin_missing.append(endpoint);continue
                # Each declared NC is an isolated one-pin native component.
                declared=('NC',*endpoint) if logical is None else ('NET',logical)
                expected_local.setdefault(declared,set()).add(endpoint)
                native_local.setdefault(key,set()).add(endpoint)
        eg={frozenset(nodes) for nodes in expected_local.values()};ng={frozenset(nodes) for nodes in native_local.values()}
        check(board+' native graph equals saved model',not pin_missing and eg==ng,{'missing_pins':pin_missing,'missing_groups':[sorted(v) for v in eg-ng],'extra_groups':[sorted(v) for v in ng-eg]})
    for native in natives.values():
        for group in native[1]:union.root(group)
    contacts=[];cable_nets=set()
    for link in cable['connections']:
        ends=[]
        for board,key in [('POWER','power'),('LOGIC','logic')]:
            endpoint=(board,link[key]['ref'],str(link[key]['pin']))
            ends.append(natives[board][0].get(endpoint))
        check('cable contacts exist: '+str(link),all(ends))
        if all(ends):
            declared=[]
            for board,key in [('POWER','power'),('LOGIC','logic')]:
                cp=next(z for z in models[board]['parts'] if z['ref']==link[key]['ref'])
                declared.append(cp['nets'][str(link[key]['pin'])])
            check('cable same electrical net: '+str(link),declared==[link['net'],link['net']],declared)
            
            if link['net'] is not None:union.join(*ends)
            cable_nets.add(link['net']);contacts.append((ends,link['net']))
    expected_interboard=PINMAP if feature else {str(n): 'FILTER_OUT' if n in (1,3,5,7) else 'BAT' if n==9 else 'MODE' if n==11 else 'GND' for n in range(1,13)}
    links=cable['connections']
    check('exact twelve physical 1:1 interboard contacts',len(links)==12 and {str(x['power']['pin']):x['net'] for x in links}==expected_interboard and all(x['power']['ref']=='J101' and x['logic']['ref']=='J201' and str(x['power']['pin'])==str(x['logic']['pin']) for x in links))
    check('exact declared interboard nets',cable_nets==set(expected_interboard.values()),sorted(cable_nets,key=str))
    source_parts={p['reference']:p for p in contract['parts']}
    # A documented removed SH1 is mechanical. It never removes a functional
    # signal endpoint. Grounded bolt pads are new mechanical GND endpoints.
    actual_parts={board:{p['ref']:p for p in m['parts']} for board,m in models.items()}
    removed=[r for r in source_parts if r not in actual_parts[original_board(r,source_parts[r]['board'])]]
    mechanical_refs={r for r,part in source_parts.items() if part['original_model_part']['kind']=='MountingHole'}|{'SH1'}
    check('all original functional references retained',set(removed).issubset(mechanical_refs),removed)
    if feature:
        allowed_new={'POWER':set(NEW_NETS)|{'J101','NT2'},'LOGIC':{'J201','H201','H202','H203','H204'}}
        for board in models:
            added=set(actual_parts[board])-set(source_parts)
            check(board+' exact authorized additional positions',added==allowed_new[board],sorted(added))
    original_net_fail=[]
    for ref, source in source_parts.items():
        if ref in removed:continue
        board=original_board(ref,source['board']);part=actual_parts[board].get(ref);original=source['original_model_part']
        if original['kind']=='MountingHole':continue
        before=dict(original['nets'],**({'4':None} if ref=='J12' else {}))
        expected_nets=expected_original_nets(board,ref,before,feature)
        if part is None or part['nets']!=expected_nets:original_net_fail.append((board,ref,expected_nets,None if part is None else part['nets']))
    check('original model pins unchanged except authorized INA219 and A3 power split',not original_net_fail,original_net_fail)
    native_pin_net={endpoint:group for native in natives.values() for endpoint,group in native[0].items()}
    checks.extend(feature_native_checks(native_pin_net,feature))
    projected_union=legacy_union(union,native_pin_net,feature)
    expected_groups={};actual_groups={};nc_fail=[];value_fail=[];variant_fail=[];pin_fail=[]
    for logical in contract['nets']:
        nodes=[]
        for n in logical['nodes']:
            if n['reference'] in removed or source_parts[n['reference']]['original_model_part']['kind']=='MountingHole':continue
            endpoint=(original_board(n['reference'],n['board']),n['reference'],str(n['pin']))
            native=natives[endpoint[0]][0].get(endpoint)
            if native is None:pin_fail.append(endpoint);continue
            nodes.append((n['reference'],str(n['pin'])))
            actual_groups.setdefault(projected_union.root(native),set()).add((n['reference'],str(n['pin'])))
        if nodes:expected_groups[logical['logical_net']]=set(nodes)
    expected={frozenset(nodes) for nodes in expected_groups.values()}
    actual={frozenset(nodes) for nodes in actual_groups.values()}
    check('all connected functional pins exist',not pin_fail,pin_fail)
    check('legacy functional pin graph equals S4.16 with declared R71/NT2 projection and J11 moved identity',expected==actual,{'expected_groups':len(expected),'actual_groups':len(actual),'missing_groups':[sorted(v) for v in expected-actual],'extra_groups':[sorted(v) for v in actual-expected]})
    for ref,source in source_parts.items():
        if ref in removed:continue
        board=original_board(ref,source['board']);original=source['original_model_part'];part=actual_parts[board].get(ref)
        if part is None:continue
        if original['kind']=='MountingHole':continue
        for pin,info in source['exact_netpins'].items():
            if not info['no_connect']:continue
            node=(board,ref,pin);net=natives[board][0].get(node)
            if net is None or natives[board][1].get(net,set())!={(ref,pin)}:nc_fail.append(node)
        # Value, fit policy and variant values are preserved even when the
        # connector's MPN/footprint must change to obtain side access.
        expected_value=expected_value_field(ref,'Value_NaIon',source['assembly_variant_row']['Value_NaIon'])
        component=natives[board][2].get(ref)
        mechanical=original['kind'].startswith('Connector') or original['kind']=='Switch'
        if component is None or (not mechanical and component.findtext('value')!=expected_value):value_fail.append((board,ref,expected_value,None if component is None else component.findtext('value')))
        if component is not None:
            props={v.get('name'):v.get('value') for v in component.findall('property')}
            fields=['Fit_NaIon','Fit_LTO_2S','Fit_NaIon_NoCold']+([] if mechanical else ['Value_NaIon','Value_LTO_2S','Value_NaIon_NoCold'])
            for field in fields:
                if props.get(field)!=expected_value_field(ref,field,source['assembly_variant_row'][field]):variant_fail.append((board,ref,field,expected_value_field(ref,field,source['assembly_variant_row'][field]),props.get(field)))
    check('original NC pins remain isolated',not nc_fail,nc_fail)
    check('component values preserved; R56 rated-power display updated to 1W',not value_fail,value_fail)
    check('all three assembly fit/value variants preserved apart from exact R56 rating display',not variant_fail,variant_fail)
    filter_native=native_pin_net.get(('POWER','J11','1'))
    sys_native=native_pin_net.get(('POWER','J11','2'))
    filter_group=union.root(filter_native) if filter_native is not None else None
    sys_group=union.root(sys_native) if sys_native is not None else None
    check('J11 removed keeps LC OUT separate from SYS_3V3',filter_group is not None and sys_group is not None and filter_group!=sys_group)
    check('D3/D4 remain local to POWER',all(ref in actual_parts['POWER'] and ref not in actual_parts['LOGIC'] for ref in ['D3','D4','R10','R11']))
    original_xml_path=ROOT/'audit'/'source_s4_16'/'native_netlist.xml'
    check('original native XML matches frozen hash',hashlib.sha256(original_xml_path.read_bytes()).hexdigest()==contract['source_inputs']['native_netlist']['sha256'])
    original_xml=ET.parse(original_xml_path).getroot();logic_xml=ET.parse(a.logic_netlist).getroot()
    for ref in ['M1','M2']:
        baseline_names=symbol_pins(original_xml,ref);current_names=symbol_pins(logic_xml,ref)
        check('FakeTec unchanged physical pin/GPIO names '+ref,baseline_names==current_names,{'baseline':baseline_names,'V2_native_XML':current_names})
    input_paths=[a.contract,a.power_netlist,a.logic_netlist,a.power_model,a.logic_model,a.cable,original_xml_path]
    if feature:input_paths.extend([FEATURE_PATH,A3_FEATURE_PATH,ROOT/'tools'/'v2_feature_contract.py',ROOT/'tools'/'v2_a3_feature_contract.py'])
    for model_path in [a.power_model,a.logic_model]:
        for pattern in ['*.kicad_sch','*.kicad_sym','*.kicad_pro']:
            input_paths.extend(sorted(model_path.parent.glob(pattern)))
    report={'scope':'A3 native local graphs, INA219, relocated J11, split SYS/RADIO supply and 2512 shunts; immutable S4.16 legacy graph projects R71 and copper NT2 only; no board/bench/mechanical claim','baseline_pcb_sha256':contract['source_inputs']['pcb']['sha256'],'ok':all(c['pass'] for c in checks),'checks':checks,'inputs':{str(path.relative_to(ROOT)):hashlib.sha256(path.read_bytes()).hexdigest() for path in input_paths}}
    a.out.parent.mkdir(parents=True,exist_ok=True);a.out.write_text(json.dumps(report,ensure_ascii=False,indent=2),encoding='utf-8')
    print(json.dumps({'ok':report['ok'],'checks':len(checks),'failed':[c for c in checks if not c['pass']],'report':str(a.out.relative_to(ROOT))},ensure_ascii=True))
    if not report['ok']:raise SystemExit(1)
if __name__=='__main__':main()
