Alksndr55/mesh-repeater-2.0/tools/cad/schematic_battery_monitor_a3.py

"""True battery-voltage / bidirectional-current sensing with stock calibration."""
from schematic_core import Sheet,MODEL

def build():
 s=Sheet('BatteryMonitor','INA219 — напряжение и основной ток батареи',5)
 s.sym('R71',134.62,50.8,'R_H')
 s.sym('J8',236.22,53.34,'BAT_HEADER_LEFT')
 s.wire(('R71',1),(60.96,50.8));s.global_stub('BAT_SYS',(60.96,50.8),(50.8,50.8))
 s.wire(('R71',2),('J8',1));s.ground(('J8',2),5.08)
 s.global_stub('BAT',(198.12,50.8),(198.12,38.1),(187.96,38.1));s.dot((198.12,50.8))
 s.text('От зарядника / к TPS63802',55.88,38.1,1.15)
 s.text('Батарея Na-ion 1S; LTO — J12',218.44,73.66,1.15)
 s.sym('U12',134.62,111.76,label=(121.92,85.09,121.92,87.63))
 s.sym('R72',76.2,104.14,'R_H',label=(76.2,93.98,76.2,96.52))
 s.sym('R73',76.2,119.38,'R_H',label=(76.2,127.0,76.2,129.54))
 s.sym('C64',99.06,111.76,'C_V',label=(102.87,110.49,102.87,113.03))
 s.wire(('R72',1),(60.96,104.14),(60.96,50.8));s.dot((60.96,50.8))
 s.wire(('R72',2),('U12',8));s.wire(('R73',2),('U12',7))
 s.net('R73',1,10.16)
 s.wire(('C64',1),(99.06,104.14));s.dot((99.06,104.14))
 s.wire(('C64',2),(99.06,119.38));s.dot((99.06,119.38))
 s.text('Kelvin от внутренних краёв площадок R71',38.1,142.24,1.05)
 s.sym('C63',180.34,81.28,'C_V',label=(184.15,80.01,184.15,82.55))
 s.wire(('U12',5),(134.62,76.2),(180.34,76.2),('C63',1))
 s.global_stub('SYS_3V3',(134.62,76.2),(121.92,76.2));s.dot((134.62,76.2));s.ground(('C63',2))
 for pin in [1,2,6]:s.ground(('U12',pin),3.81)
 s.net('U12',3,12.7);s.net('U12',4,12.7)
 s.flag('BAT',262.89,96.52,521)
 s.flag('SYS_3V3',262.89,121.92,522)
 s.text('A1=A0=GND: адрес 0x40. SDA/SCL — существующий I2C NiceNano.',20.32,170.18,1.15)
 s.text('Питание VS: SYS_3V3 после J11 на POWER; USB через J101.1/3 при снятой J11.',20.32,177.8,1.15)
 s.text('R71=0,1 Ом: штатная калибровка MeshCore. Ток заряда +, разряда −.',20.32,185.42,1.15)
 s.text('CN3722 FB/BAT sense остаются до R71 на BAT_SYS; EN и BAT_ADC — от BAT.',20.32,193.04,1.15)
 s.text('Балансиры подключены к ячейкам напрямую: их токи не входят в основной ток INA219.',20.32,200.66,1.05)
 return s
