Alksndr55/mesh-repeater-2.0/(commit log)

2026-10-13 Publish Mesh Repeater 2.0 A3 prototype and engineering audit
2026-10-13 Publish Mesh Repeater 2.0 A4 with consistent silkscreen and clean current CAD
2026-10-24 Release v2.06: unified circuit and verified portable KiCad sources
2026-11-06 Release v2.10: assembly improvements, standardized parts and portable NexusBV
