Alksndr55/mesh-repeater-2.0/(notices)

Notices in the files:
audit/V2_ENGINEERING_AUDIT_A3_2026_10_13/SOFTWARE_BOM_Microchip_ATtiny13A.txt:
© 2021, Microchip Technology Incorporated, All Rights Reserved.
feature may be a violation of the Digital Millennium Copyright Act. If such acts allow unauthorized access to your software or
